barkinvar/sugerCANe/current/hardware/artwork/README.md

# sugarCANe underside artwork

[sugarCANe.svg](sugarCANe.svg) is the original vector master, 52 × 74 mm, viewed from the underside. White artwork spans approximately 45.6 × 43.2 mm between the connector fields. Three jointed pixel stalks and stair-step leaves stand on a floating island with a raised, convex top and a stepped, tapering underside. The large **sugarCANe** name uses bold pixel lettering. There are no corner decorations, borders or additional text on the underside.

The lettering is drawn specifically for this wordmark in [build_brand_artwork.py](../../scripts/build_brand_artwork.py), without an external font. Most stems are two cells thick; the lowercase bodies are seven rows high and CAN is nine rows high. The g has a descending tail, and the final lowercase e has a clear crossbar and an open right side. A 0.616 mm letter grid and 0.924 mm inter-letter spacing keep the shapes separated at PCB scale. No Minecraft texture, logo or font is included. SC12 Rev H remains the hardware identity on the component side and in the engineering files.

Rebuild the vector source with `python scripts/build_brand_artwork.py` from `current/`. The illustration uses a 0.8 mm pixel grid; the original letter patterns are defined directly in the generator. Apply it with `kicad-python scripts/apply_bottom_artwork.py`. The importer mirrors the artwork once into native PCB coordinates and uses KiCad's filled cut-contour polygons to preserve letter and stalk holes without a font dependency or raster image. `finish_markings.py` also reapplies this artwork after refreshing the top labels.

All artwork lives on B.Silkscreen, in the **sugarCANe artwork** group. It changes no copper, solder mask, holes, pads, components or top markings. Refresh the bottom silkscreen Gerber, bottom drawing, interactive BOM and render after editing; check the actual exported mask clearances and final image. Small via holes remain visible through the artwork in the CAD render. Electrical qualification status is unchanged.
