barkinvar/sugerCANe/reports/electrical/capacitor_derating.pdf

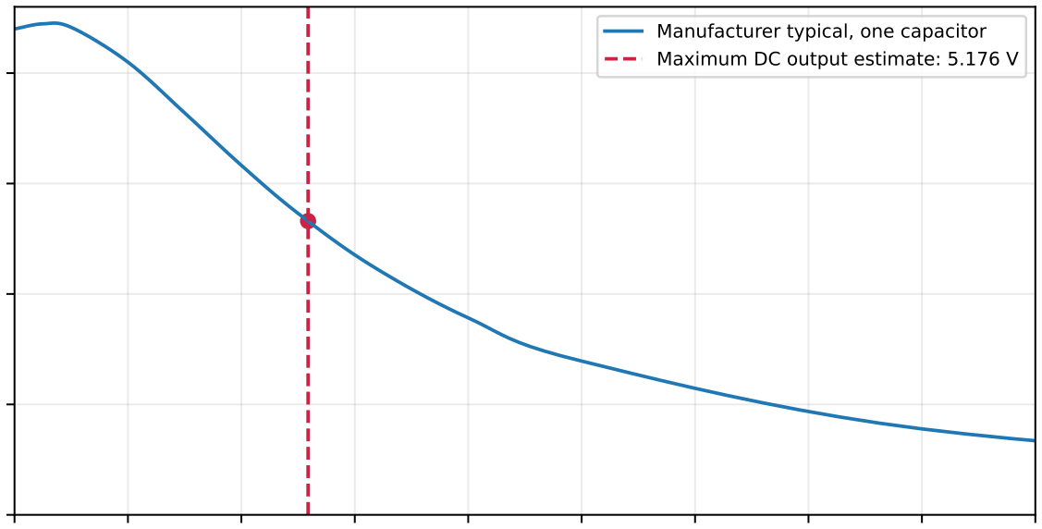
[picture p11: figure]
Manufacturer typical, one capacitor Maximum DC output estimate: 5.176 V

0 | 2 | 4 | 6 | 8 | 10 | 12 | 14 | 16 | 18

### DC bias (V)

0

5

10

15

20

### Typical capacitance (µF)

## 22 µF / 25 V X5R capacitance under DC bias
