barkinvar/sugerCANe/reports/spice/input_filtering.pdf

0 | 2 | 4 | 6 | 8 | 10 | 12
| | | Time (ms)

0.0

0.2

0.4

0.6

0.8

1.0
Normalized level

### logic 3v3

0 | 2 | 4 | 6 | 8 | 10 | 12
| | | Time (ms)

0.0

0.2

0.4

0.6

0.8

1.0
Normalized level

### logic 5v

0 | 2 | 4 | 6 | 8 | 10 | 12
| | | Time (ms)

0.0

0.2

0.4

0.6

0.8

1.0
Normalized level

### industrial 12v

0 | 2 | 4 | 6 | 8 | 10 | 12
| | | Time (ms)

0.0

0.2

0.4

0.6

0.8

1.0
Normalized level

### industrial 30v at 6v battery

0 | 2 | 4 | 6 | 8 | 10 | 12
| | | Time (ms)

0.0

0.2

0.4

0.6

0.8

1.0
Normalized level

### npn 10v 500uA leak

0 | 2 | 4 | 6 | 8 | 10 | 12
| | | Time (ms)

0.0

0.2

0.4

0.6

0.8

1.0
Normalized level

### pnp 12v 500uA leak

0 | 2 | 4 | 6 | 8 | 10 | 12
| | | Time (ms)

0.0

0.2

0.4

0.6

0.8

1.0
Normalized level

### open drain 3v3 50uA leak

Signal / nominal high
Comparator / 3.3 V
Firmware logical state

### Input filtering and 2 ms firmware debounce — simulated, not bench measured
