barkinvar/sugerCANe/reports/spice/inrush.pdf

input_I2t_A2s: Vin=18 V, source=0.02 Ω, wire=0.1 µH, ESR=0.02 Ω

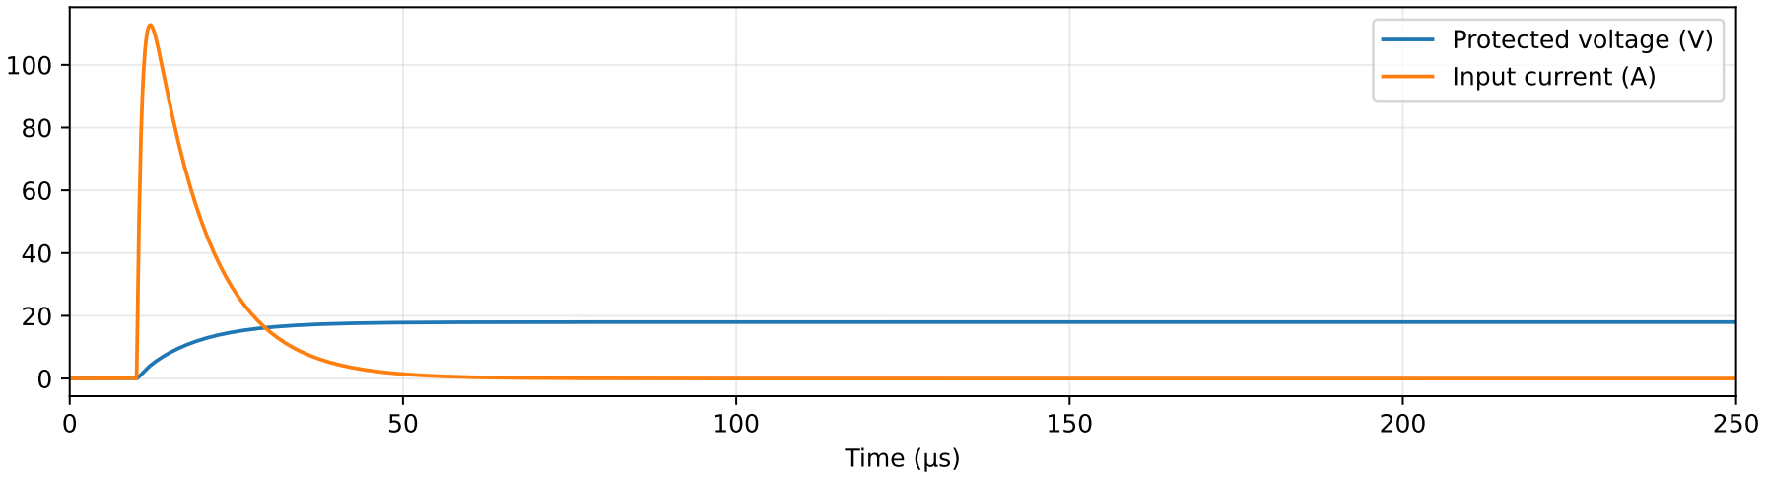
[picture p12: figure]
Time (µs); Protected voltage (V); Input current (A)

peak_protected_V: Vin=18 V, source=0.02 Ω, wire=10 µH, ESR=0.02 Ω

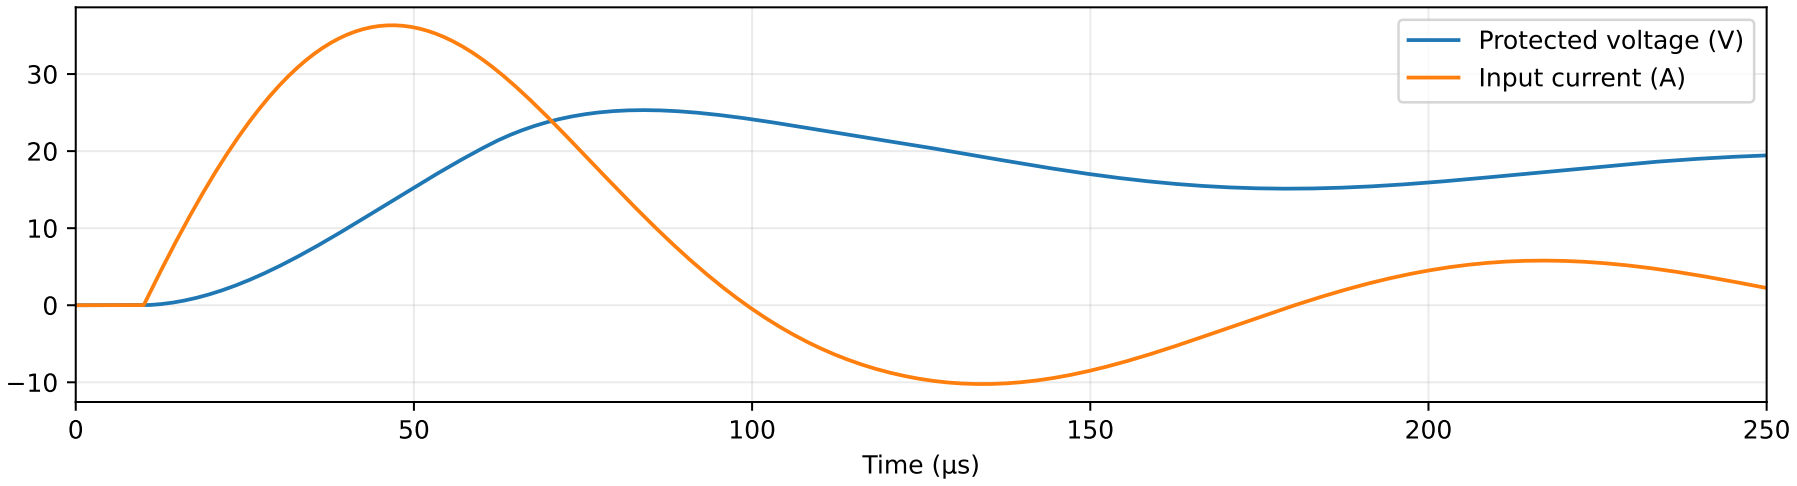
[picture p13: figure]
Time (µs); Protected voltage (V); Input current (A)

peak_input_A: Vin=18 V, source=0.02 Ω, wire=0.1 µH, ESR=0.02 Ω

Input hot-plug sensitivity — passive approximation, not hardware qualification

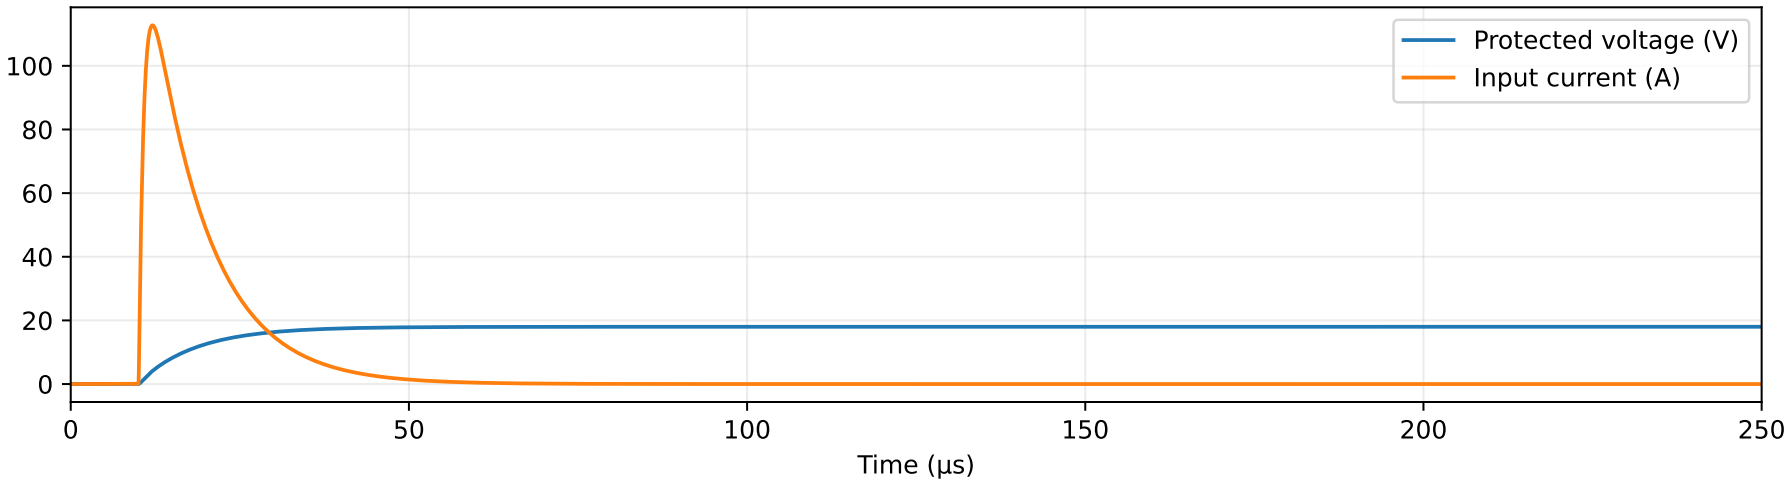
[picture p14: figure]
Time (µs); Protected voltage (V); Input current (A)
