barkinvar/sugerCANe/reports/spice/pulse_response.pdf

## Input pulse width (ms)

logic 3v3 high pulses

logic 3v3 low pulses

logic 5v high pulses

logic 5v low pulses

industrial 12v high pulses

industrial 12v low pulses

industrial 30v at 6v battery high pulses

industrial 30v at 6v battery low pulses

npn 10v 500uA leak high pulses

npn 10v 500uA leak low pulses

pnp 12v 500uA leak high pulses

pnp 12v 500uA leak low pulses

open drain 3v3 50uA leak high pulses

open drain 3v3 50uA leak low pulses

# Debounce 1 ms

## Input pulse width (ms)

# Debounce 2 ms

2 | 4 | 6 | 8 | 10 | 12 | 14

## Input pulse width (ms)

logic 3v3 high pulses

logic 3v3 low pulses

logic 5v high pulses

logic 5v low pulses

industrial 12v high pulses

industrial 12v low pulses

industrial 30v at 6v battery high pulses

industrial 30v at 6v battery low pulses

npn 10v 500uA leak high pulses

npn 10v 500uA leak low pulses

pnp 12v 500uA leak high pulses

pnp 12v 500uA leak low pulses

open drain 3v3 50uA leak high pulses

open drain 3v3 50uA leak low pulses

# Debounce 5 ms

2 | 4 | 6 | 8 | 10 | 12 | 14

## Input pulse width (ms)

# Debounce 10 ms

0.0

0.2

0.4

0.6

0.8

1.0

## Fraction of the 100 tested sample phases capturing one pulse

Simulated pulse capture · 1 kHz sampling · typical analog model, no hardware qualification
