barkinvar/sugerCANe/output/documentation/mounting_template.pdf

# FRC Sensor CAN · mounting template

Print at 100% / actual size. Verify the 50 mm ruler before drilling.

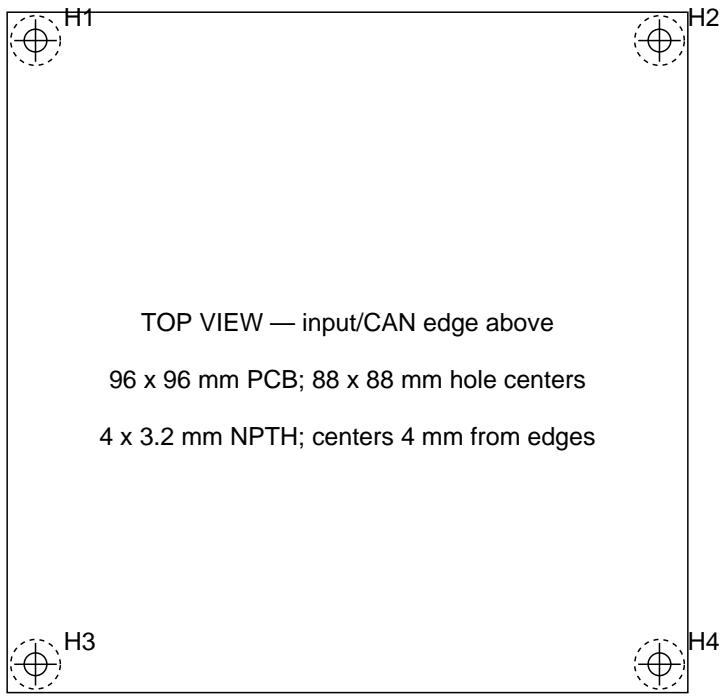
[picture p17: figure]
TOP VIEW — input/CAN edge above; 96 x 96 mm PCB; 88 x 88 mm hole centers

4 x 3.2 mm NPTH; centers 4 mm from edges

This line must measure 50 mm

Use M3 nylon hardware and at least 10 mm standoffs.
Dashed circles show 3.5 mm nominal copper-clearance radius.
Allow room beyond the board for terminal wiring and screwdriver access. Check the actual PCB, hardware and enclosure before making final holes.

Revision A prototype. Nominal geometry; not a measured or certified part.
