barkinvar/sugerCANe/sources/models/lmr51420x_ti/LMR51420X_PSPICE_TRANS/LMR51420X_PSPICETransientModel_FeaturesandLimitations.pdf

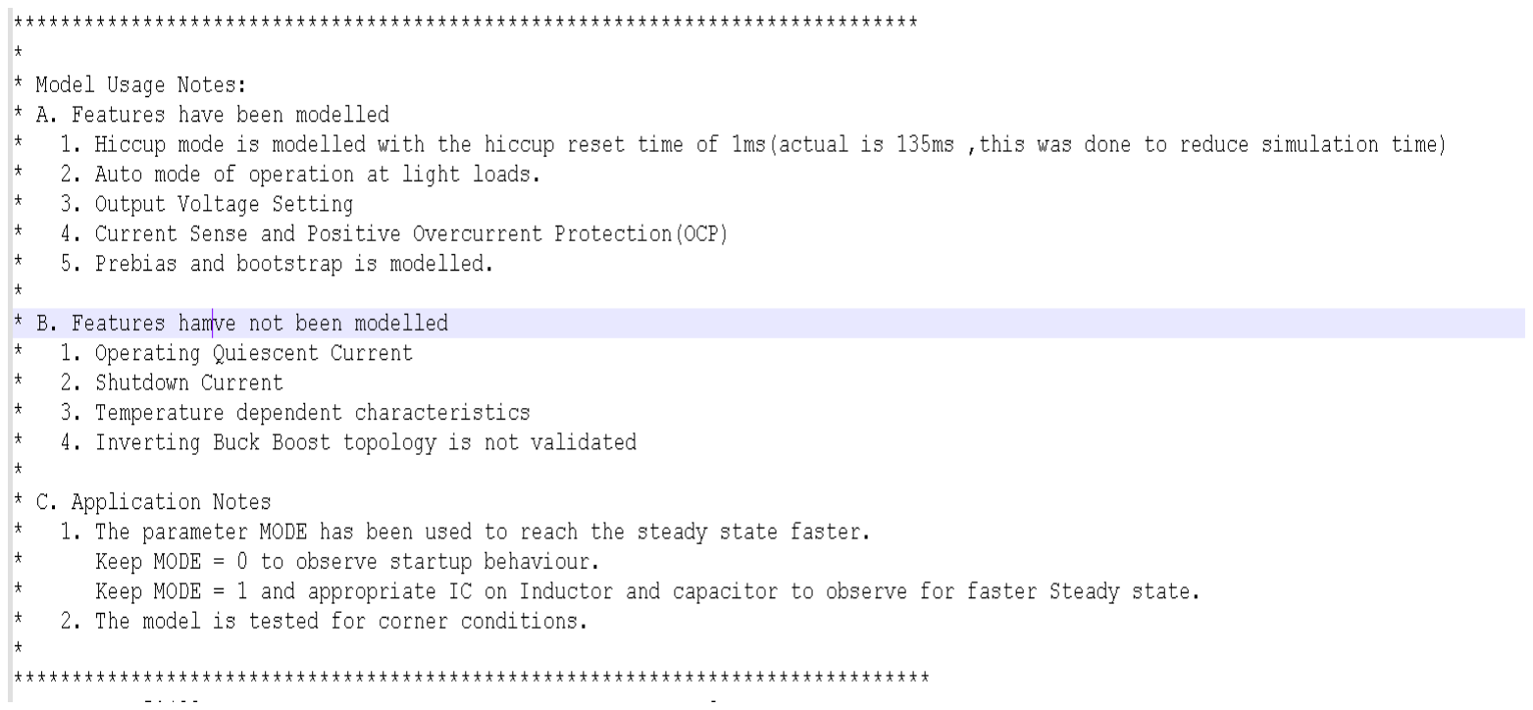
[picture p20: figure]
