barkinvar/sugerCANe/archive/README.md

# Historical packages

Use **[current Rev H](../current/README.md)** for new work. These ZIPs preserve older releases exactly as published; their internal instructions and test records apply only to that revision.

| Revision | Download |
|---|---|
| A | [Source/prototype](release/FRC_Sensor_CAN_RevA_Prototype.zip) · [fabrication](release/FRC_Sensor_CAN_RevA_Fabrication.zip) |
| B, early angled terminals | [Historical prototype](rev_b/history/before_horizontal_connectors/release/FRC_Sensor_CAN_RevB_Prototype.zip) |
| B, horizontal terminals | [Prototype](rev_b/release/FRC_Sensor_CAN_RevB_Prototype.zip) |
| B2 | [Prototype](rev_b2/release/FRC_Sensor_CAN_RevB2_Prototype.zip) · [factory packet](rev_b2/order/RevB2_Factory_Upload.zip) |
| C Lite | [Prototype](rev_c/release/FRC_Sensor_CAN_RevC_Lite_Prototype.zip) · [factory packet](rev_c/order/RevC_Lite_Factory_Upload.zip) |
| D SC12 | [Prototype](rev_d/release/FRC_Sensor_CAN_RevD_SC12_Prototype.zip) · [factory packet](rev_d/order/RevD_SC12_Factory_Upload.zip) |
| D2 SC12 | [Prototype](rev_d2/release/FRC_Sensor_CAN_RevD2_SC12_Prototype.zip) · [factory packet](rev_d2/order/RevD2_SC12_Factory_Upload.zip) |
| E SC12 | [Prototype](rev_e/release/FRC_Sensor_CAN_RevE_SC12_Prototype.zip) · [factory packet](rev_e/order/RevE_SC12_Factory_Upload.zip) |
| F SC12 | [Prototype](rev_f/release/FRC_Sensor_CAN_RevF_SC12_Prototype.zip) · [factory packet](rev_f/order/RevF_SC12_Factory_Upload.zip) |
| G SC12 | [Prototype](rev_g/release/FRC_Sensor_CAN_RevG_SC12_Prototype.zip) · [factory packet](rev_g/order/RevG_SC12_Factory_Upload.zip) |

[Why the revisions differ](../REVISIONS.md). All are unbuilt engineering prototypes. Do not combine firmware, connectors or wiring instructions across packages.

Original SHA-256 files remain alongside their archives. [manifest.json](manifest.json) records original paths, byte sizes and SHA-256 hashes for every preserved release/order archive and checksum. The complete expanded source tree before consolidation is available at [commit 9ccb4b7](https://github.com/barkinvar/candi-clone/tree/9ccb4b7). No Git history was rewritten.
