barkinvar/sugerCANe/rev_d/output/mechanical/mechanical_drawing.pdf

# SC12 - nominal mechanical drawing

Rev D / component-side view / 1:1 at 100% print / dimensions in mm

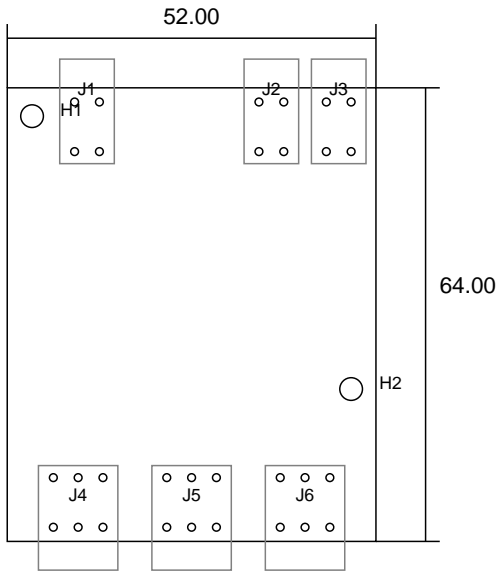
[picture p26: figure]

PCB: 52 x 64 x 1.6 mm. Four layers, nominal 1 oz copper.
Mounts: H1 (3.5, 4.0), H2 (48.5, 42.5); diameter 3.2 NPTH.
Keep hardware contact diameter <=6.4 mm; use insulating supports as needed. Conservative terminal envelope: 52 x 72.1 mm, before wires/button clearance. Terminal height: 8.5 above mounting face; pin tips 3.5 below that face.
On a 1.6 mm PCB, pin tips project nominally 1.9 mm beyond the bottom. Housing geometry is manufacturer nominal CAD. Physical fit untested. Origin: top-left PCB corner. X right; Y down in this drawing.

# Service contacts and solder selectors

Component-side view / enlarged, not 1:1 / no stencil paste on these contacts

### J8: custom TC2050-IDC-NL mapping; use a mapped adapter

1 | 2 | 3 | 4 | 5
10 | 9 | 8 | 7 | 6

1 NRST
2 UART RX
3 UART TX
4 SWCLK
5 SWDIO
6 +3V3 VTref sense only
7 GND
8 GND
9 BOOT0
10 GND

Power through J1; adapter/probe power disconnected. Lower row 1-5; upper row 10-6.

### JP101 POWER

1 | 2 | 3

### JP103 BIAS

1 | 2 | 3
1-2 = 5V; 2-3 = 12V; open = off | 1-2 = NPN; 2-3 = PNP; open = push-pull

### JP201 POWER

1 | 2 | 3

### JP203 BIAS

1 | 2 | 3
1-2 = 5V; 2-3 = 12V; open = off | 1-2 = NPN; 2-3 = PNP; open = push-pull

### JP301 POWER

1 | 2 | 3

### JP303 BIAS

1 | 2 | 3
1-2 = 5V; 2-3 = 12V; open = off | 1-2 = NPN; 2-3 = PNP; open = push-pull

ONE BRIDGE PER SELECTOR. Both power bridges short 12V to 5V.

JP2: bridge for 120 ohm CAN end termination; open at intermediate nodes.

All selectors open by default. Change settings only with input power disconnected.
