barkinvar/sugerCANe/.playwright-cli/page-2026-09-07T21-32-00-759Z.png

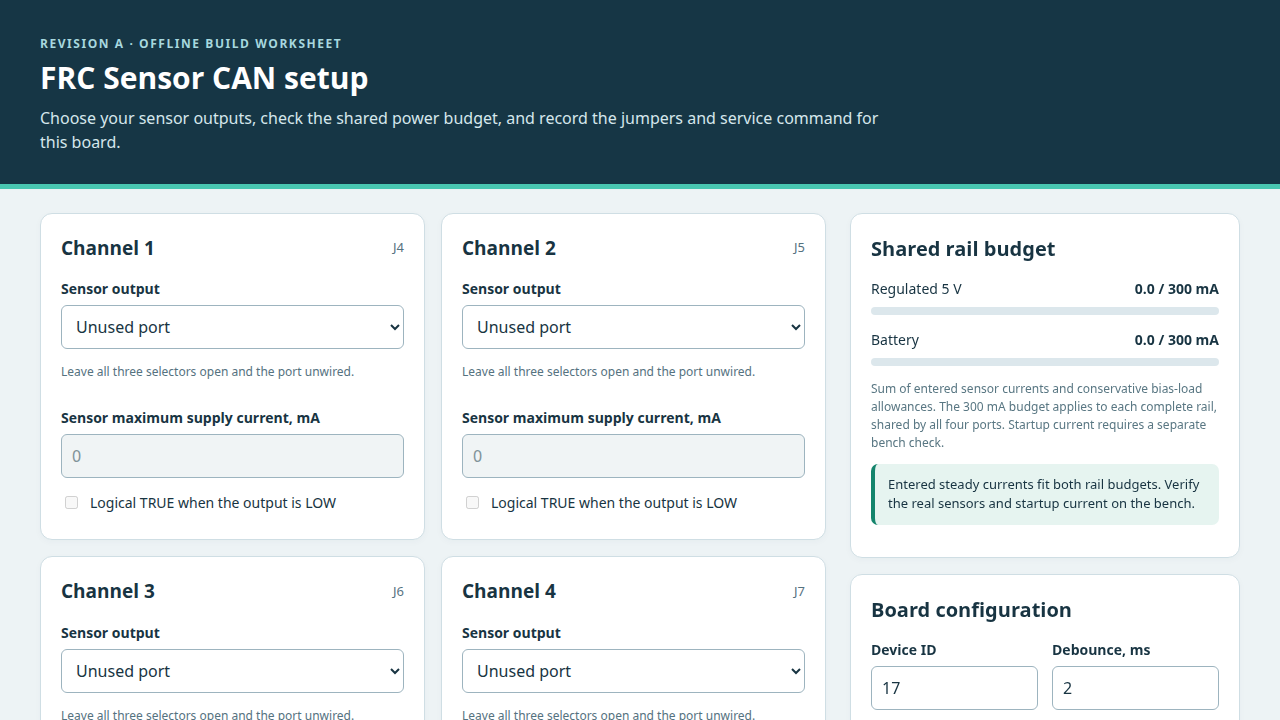
.playwright-cli/page-2026-09-07T21-32-00-759Z.png
