barkinvar/sugerCANe/.playwright-cli/page-2026-09-07T21-32-58-149Z.png

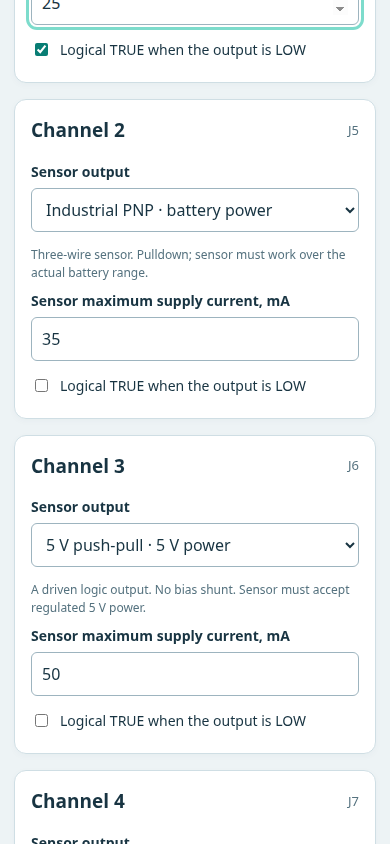
.playwright-cli/page-2026-09-07T21-32-58-149Z.png
