barkinvar/sugerCANe/current/output/review/board_bottom.png

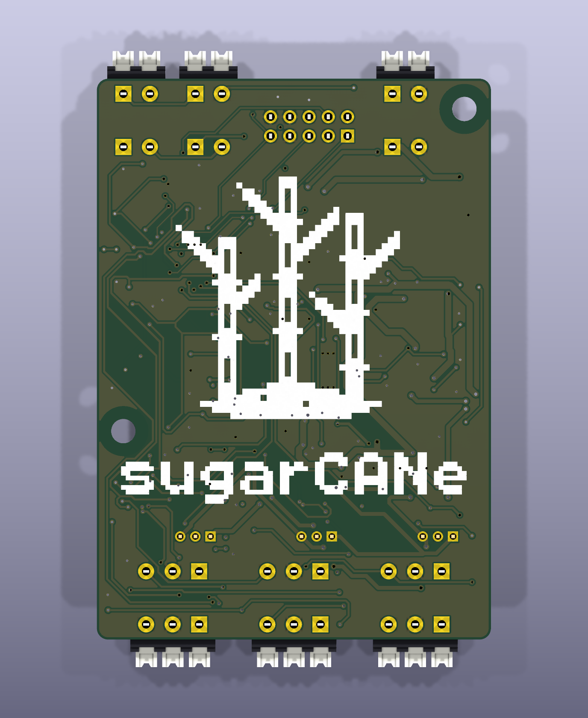
current/output/review/board_bottom.png
