barkinvar/sugerCANe/current/output/review/board_connectors.png

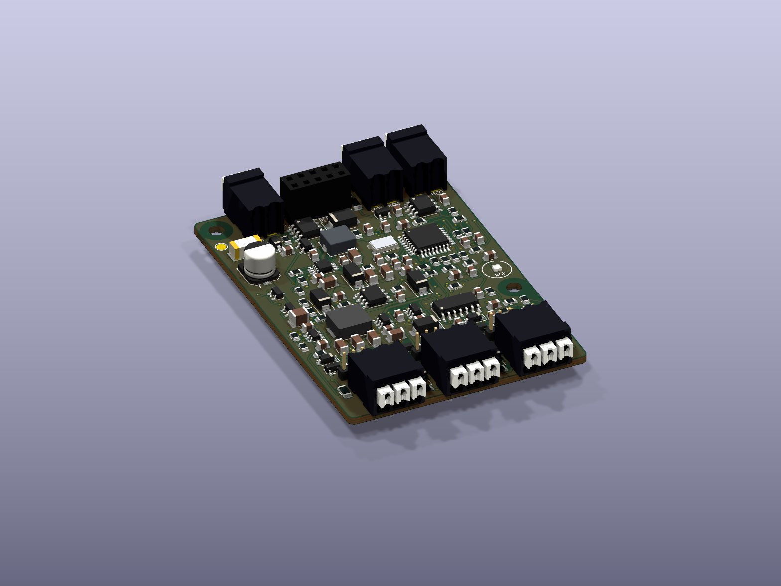
current/output/review/board_connectors.png
