barkinvar/sugerCANe/current/output/review/board_top.png

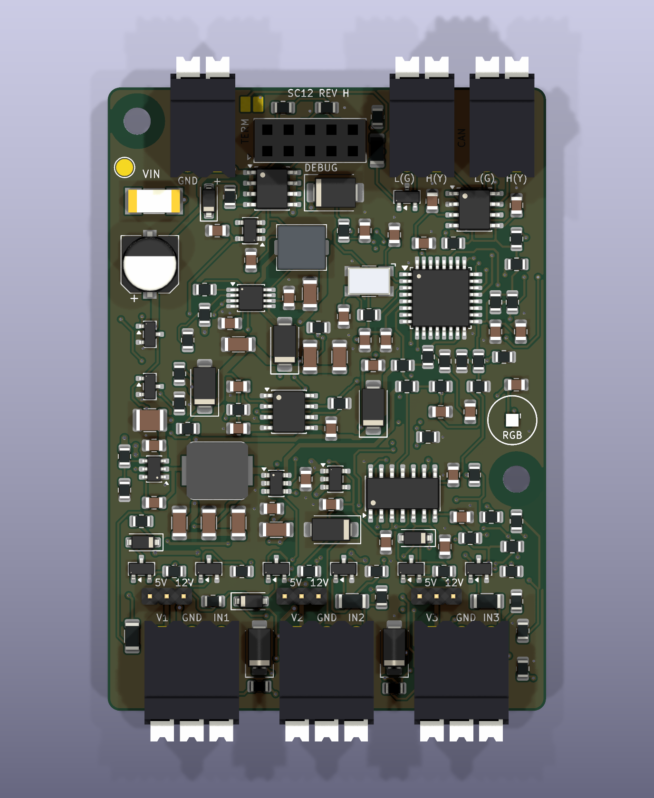
current/output/review/board_top.png
