barkinvar/sugerCANe/current/output/review/gerber_bottom_copper.png

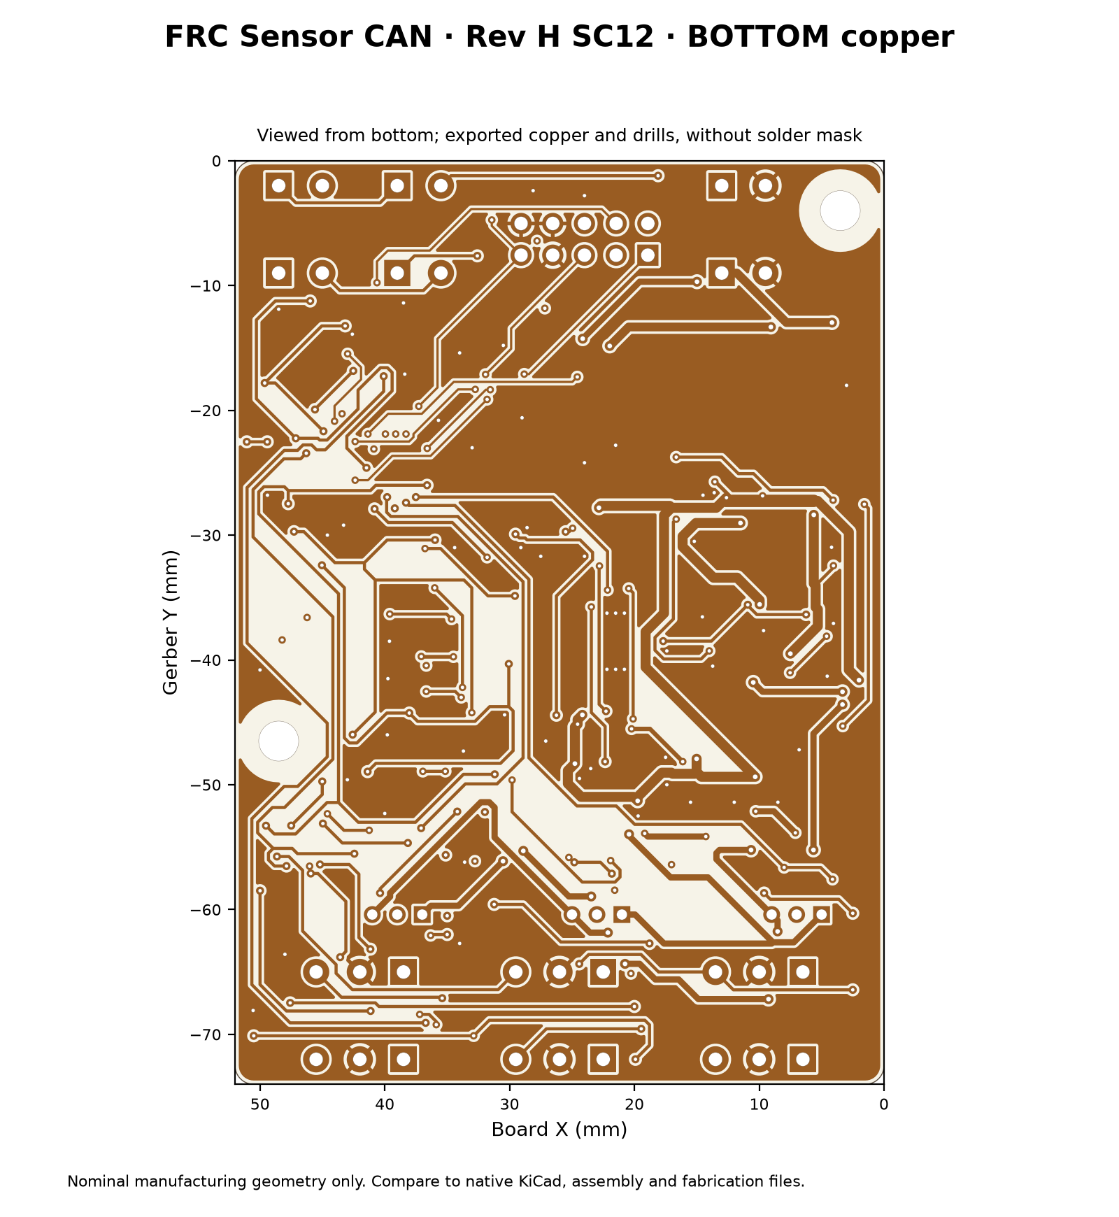
current/output/review/gerber_bottom_copper.png
