barkinvar/sugerCANe/current/output/review/gerber_inner_1_copper.png

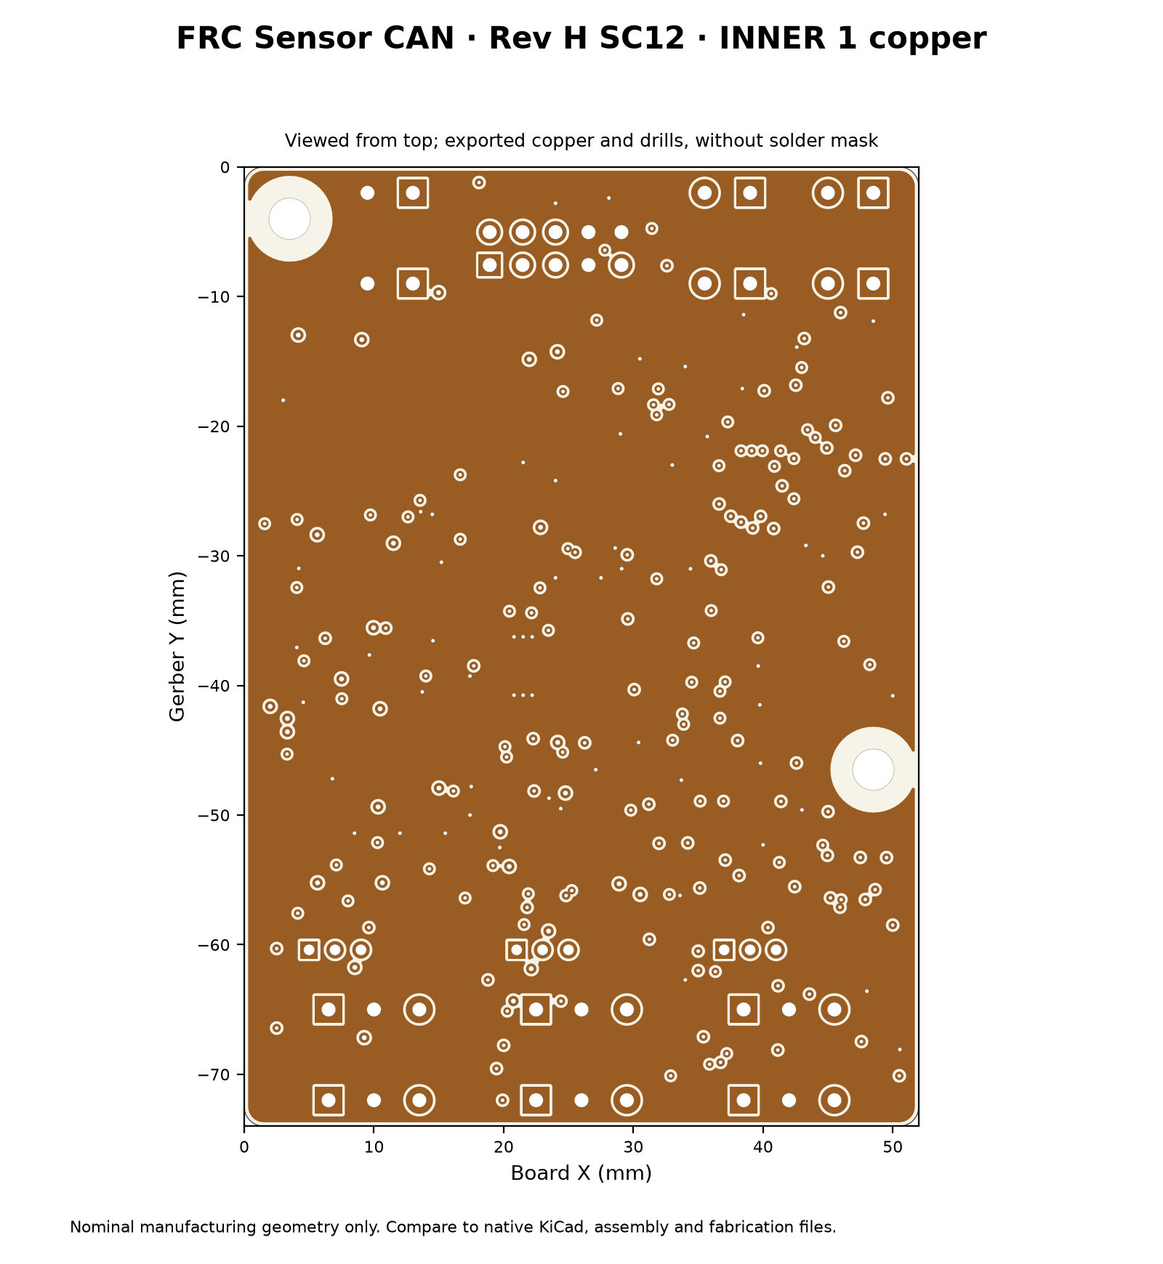
current/output/review/gerber_inner_1_copper.png
