barkinvar/sugerCANe/current/output/review/gerber_inner_2_copper.png

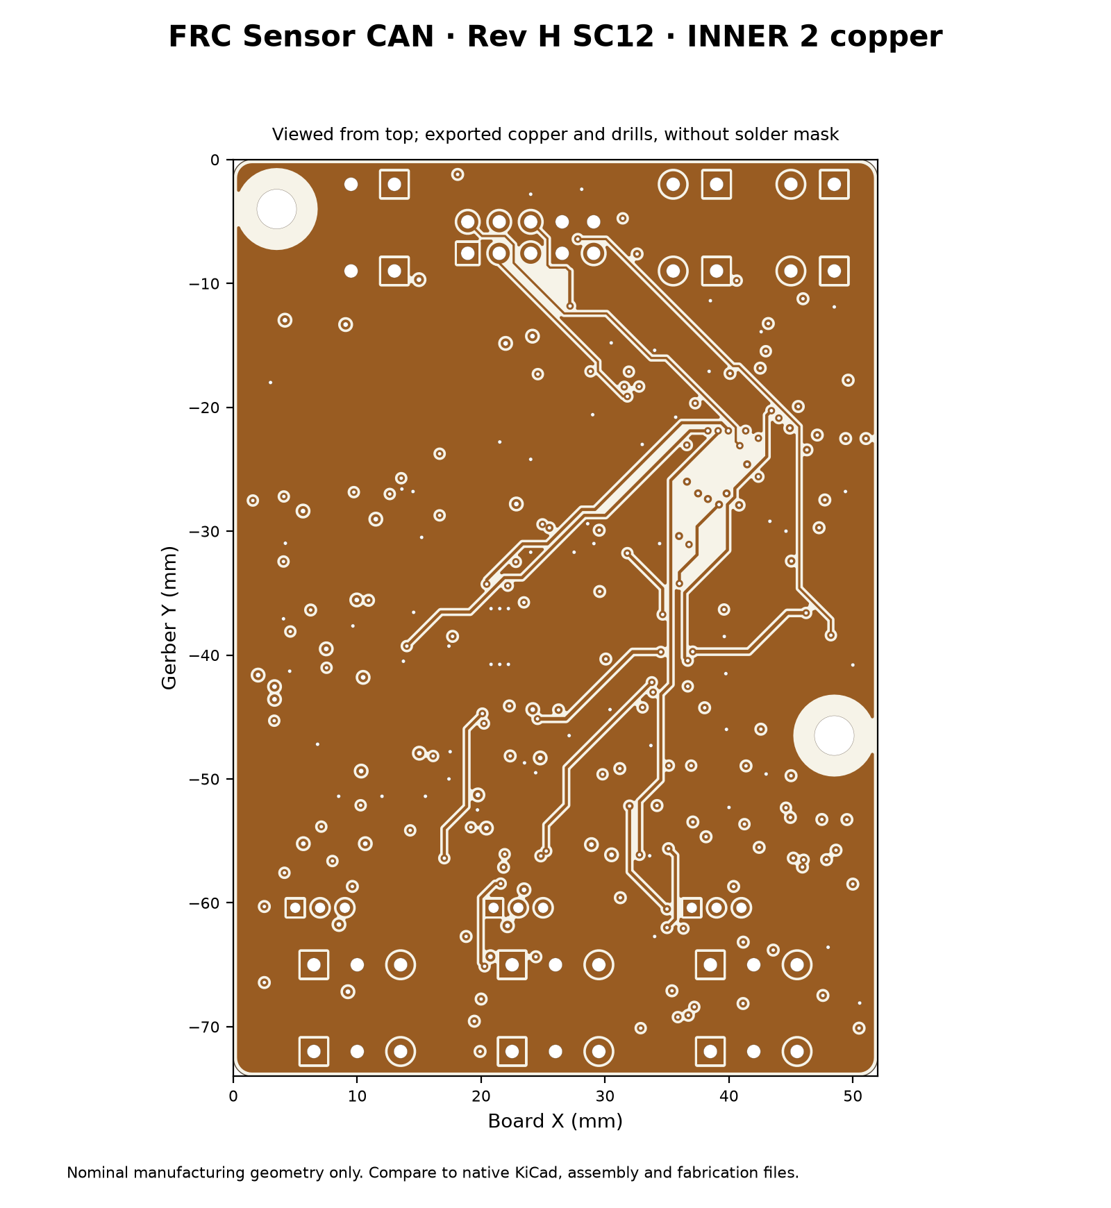
current/output/review/gerber_inner_2_copper.png
