barkinvar/sugerCANe/current/output/review/gerber_top_copper.png

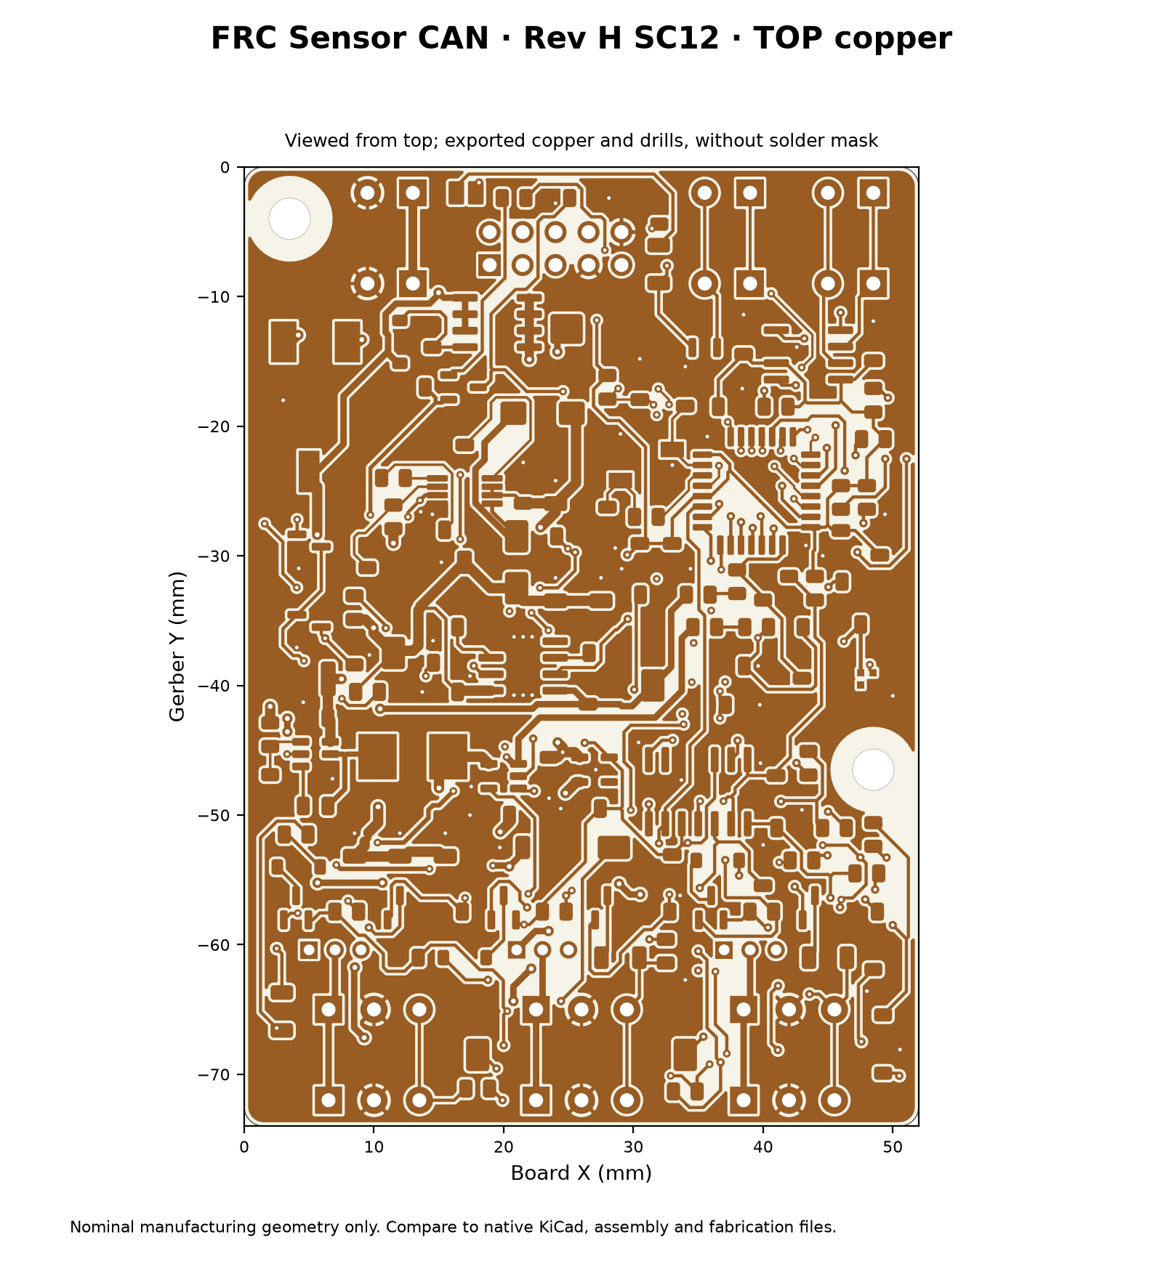
current/output/review/gerber_top_copper.png
