barkinvar/sugerCANe/current/output/review/ground_pours.png

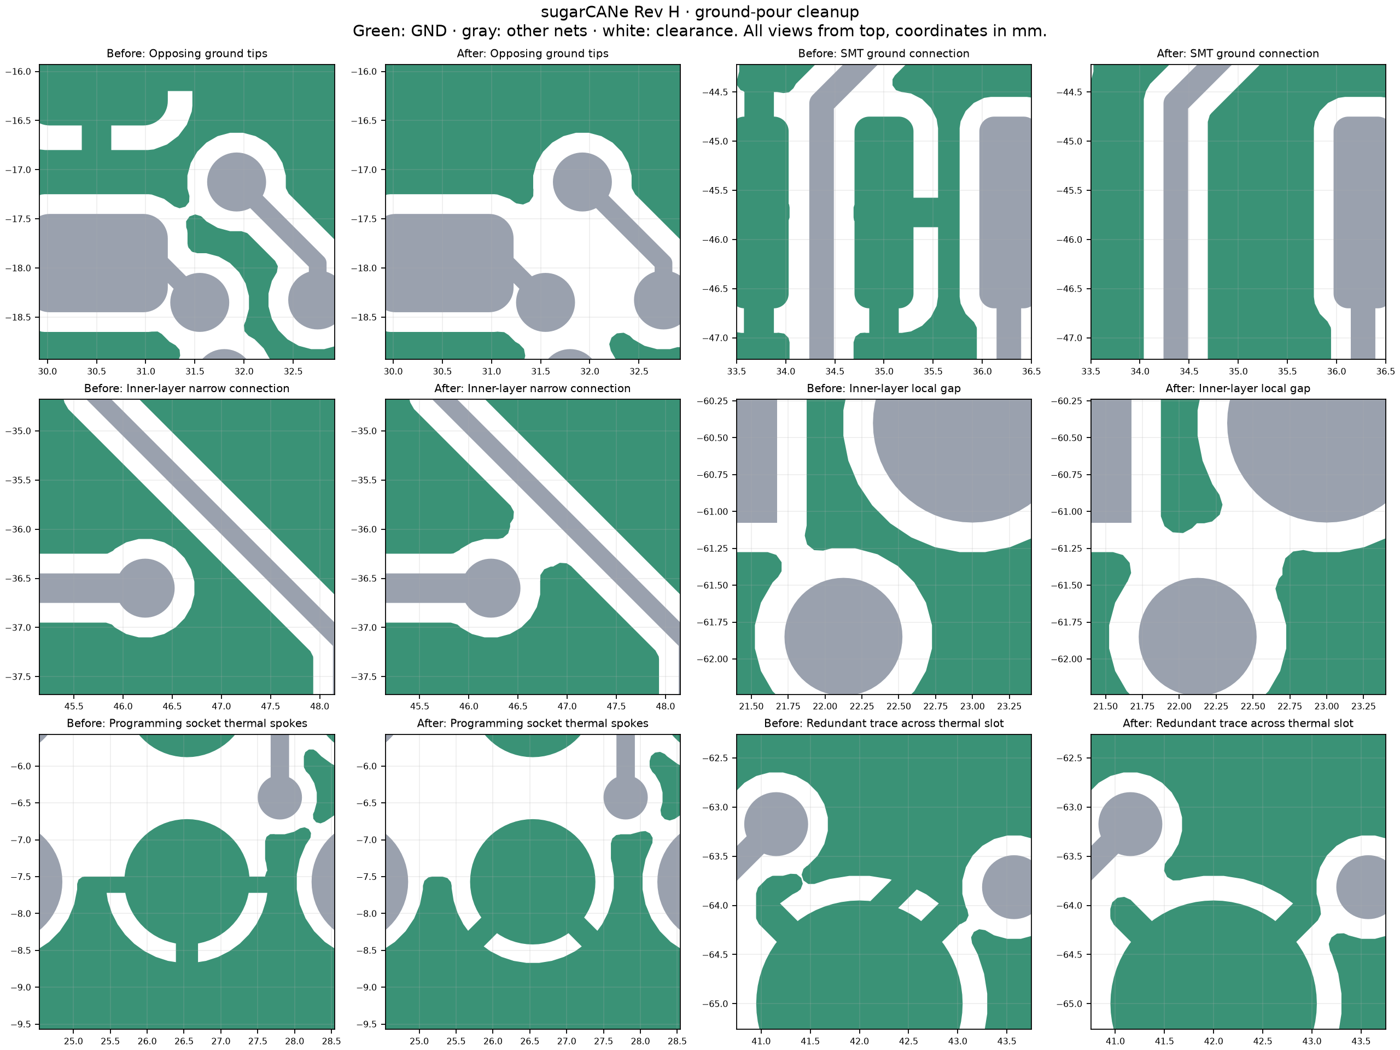
current/output/review/ground_pours.png
