barkinvar/sugerCANe/current/output/review/routing_contacts.png

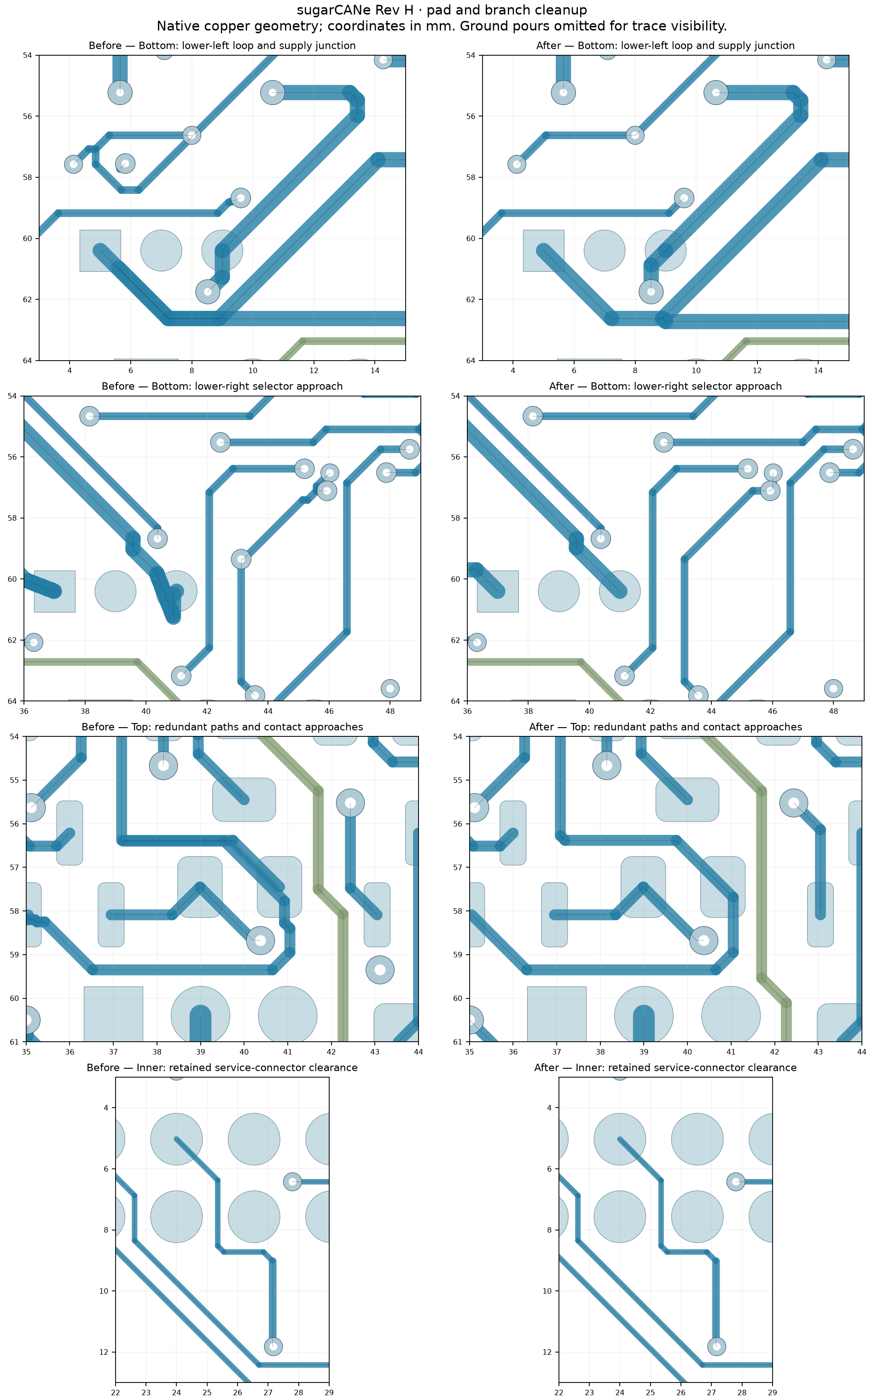
current/output/review/routing_contacts.png
