barkinvar/sugerCANe/current/output/review/routing_junctions.png

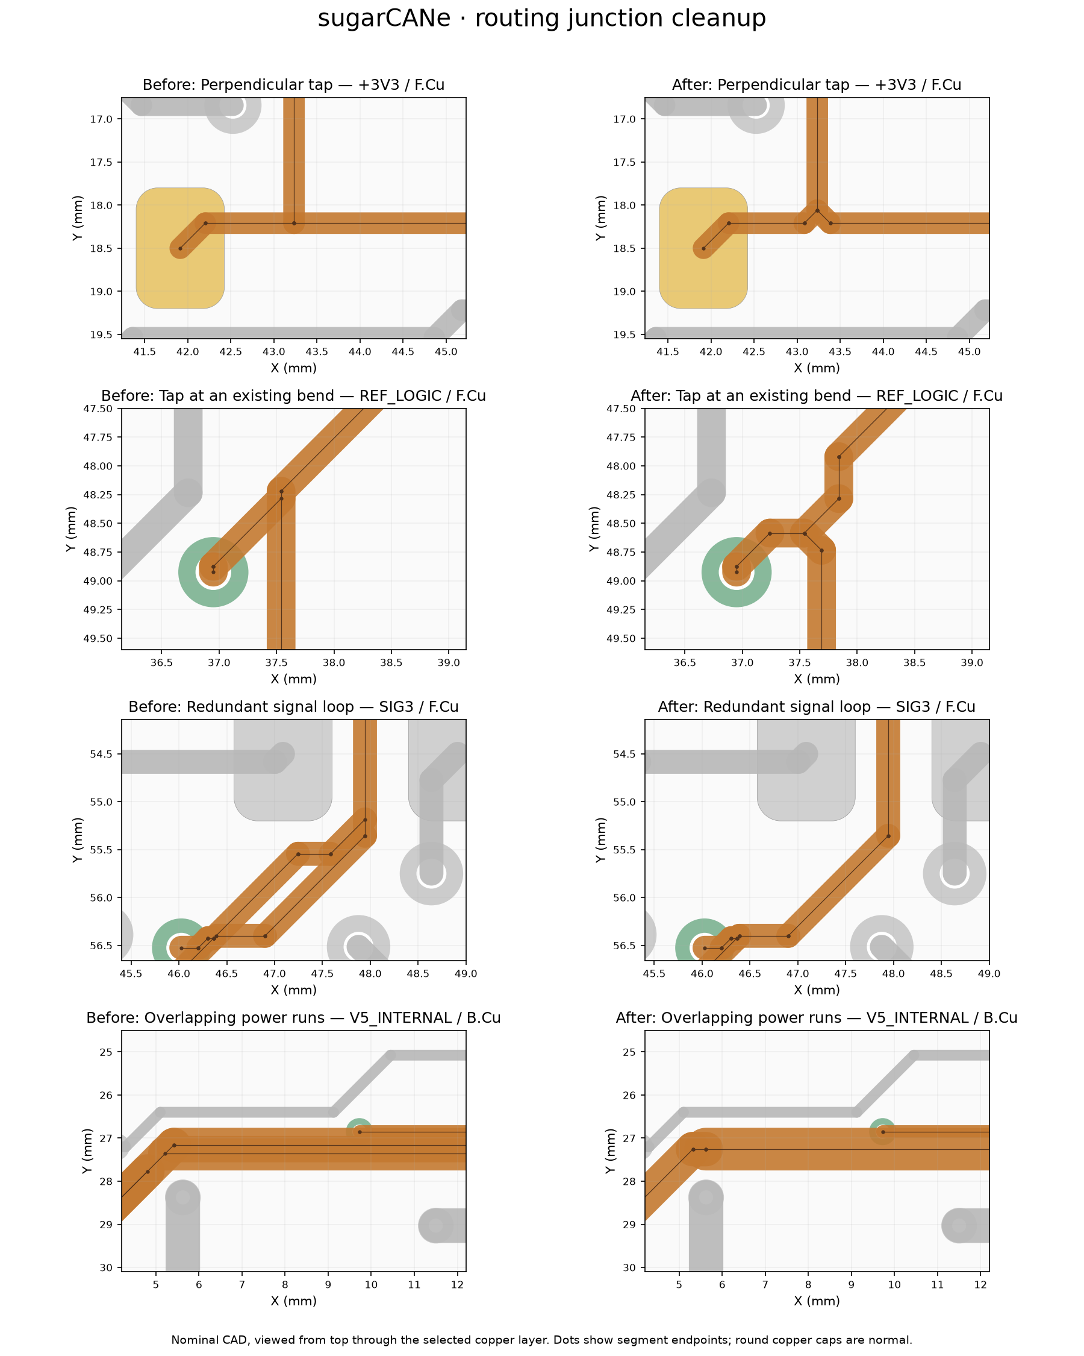
current/output/review/routing_junctions.png
