barkinvar/sugerCANe/current/output/review/routing_widths.png

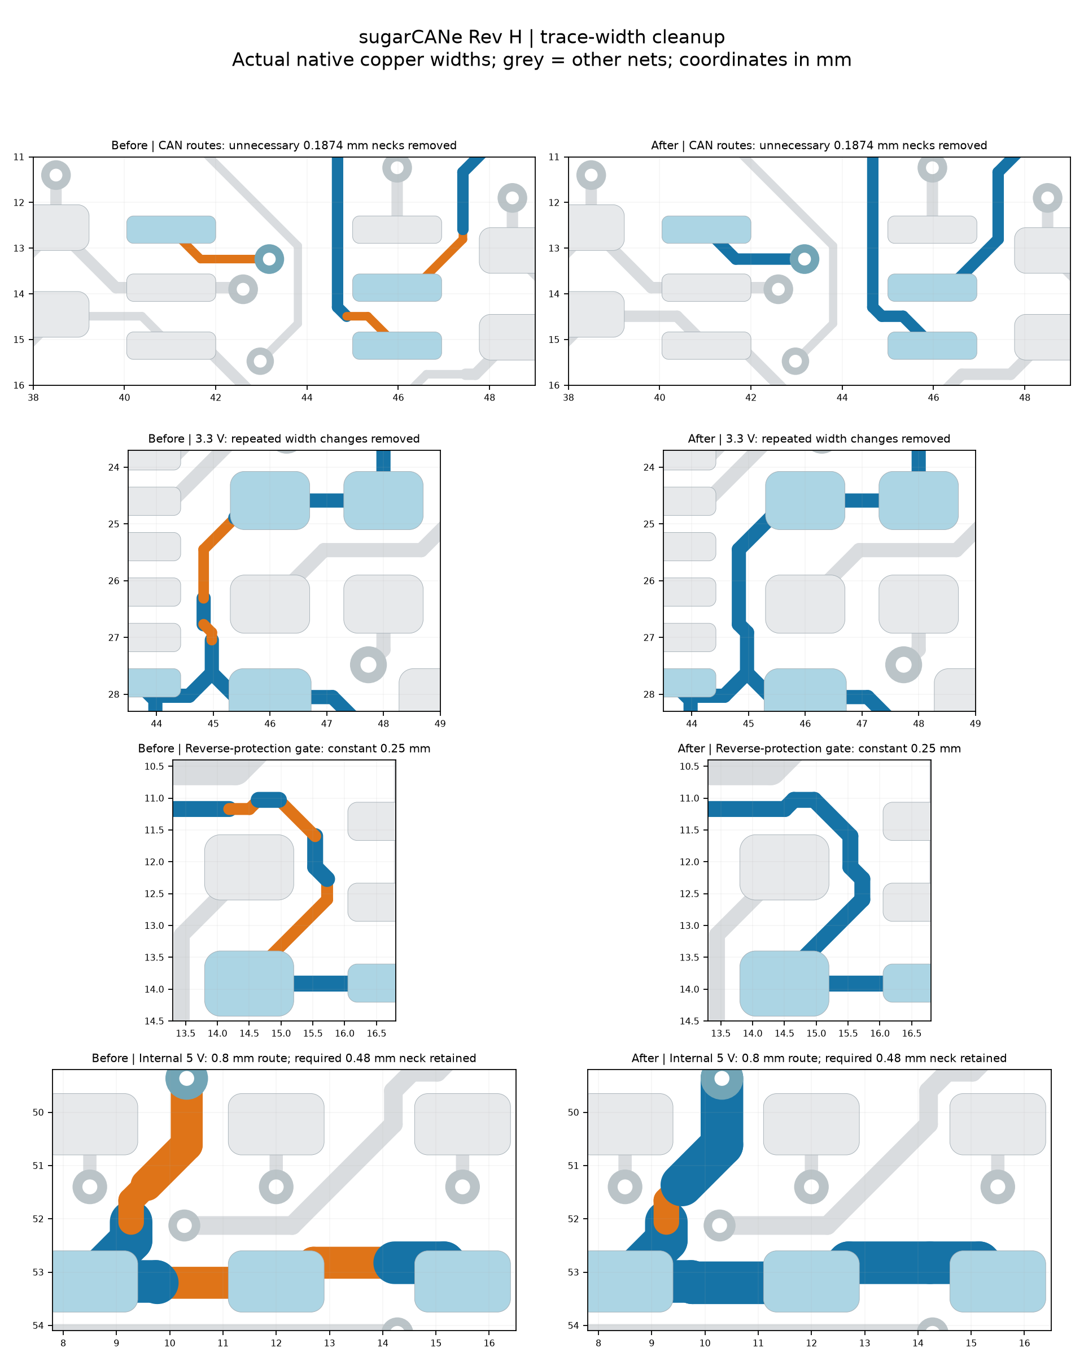
current/output/review/routing_widths.png
