barkinvar/sugerCANe/current/output/review/service_gui.png

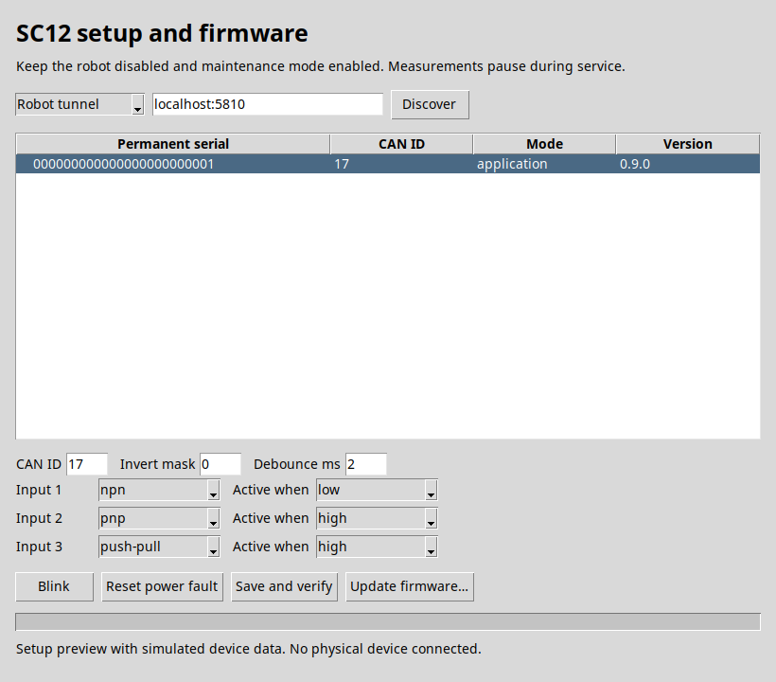
current/output/review/service_gui.png
