barkinvar/sugerCANe/current/reports/electrical/boost_spice.png

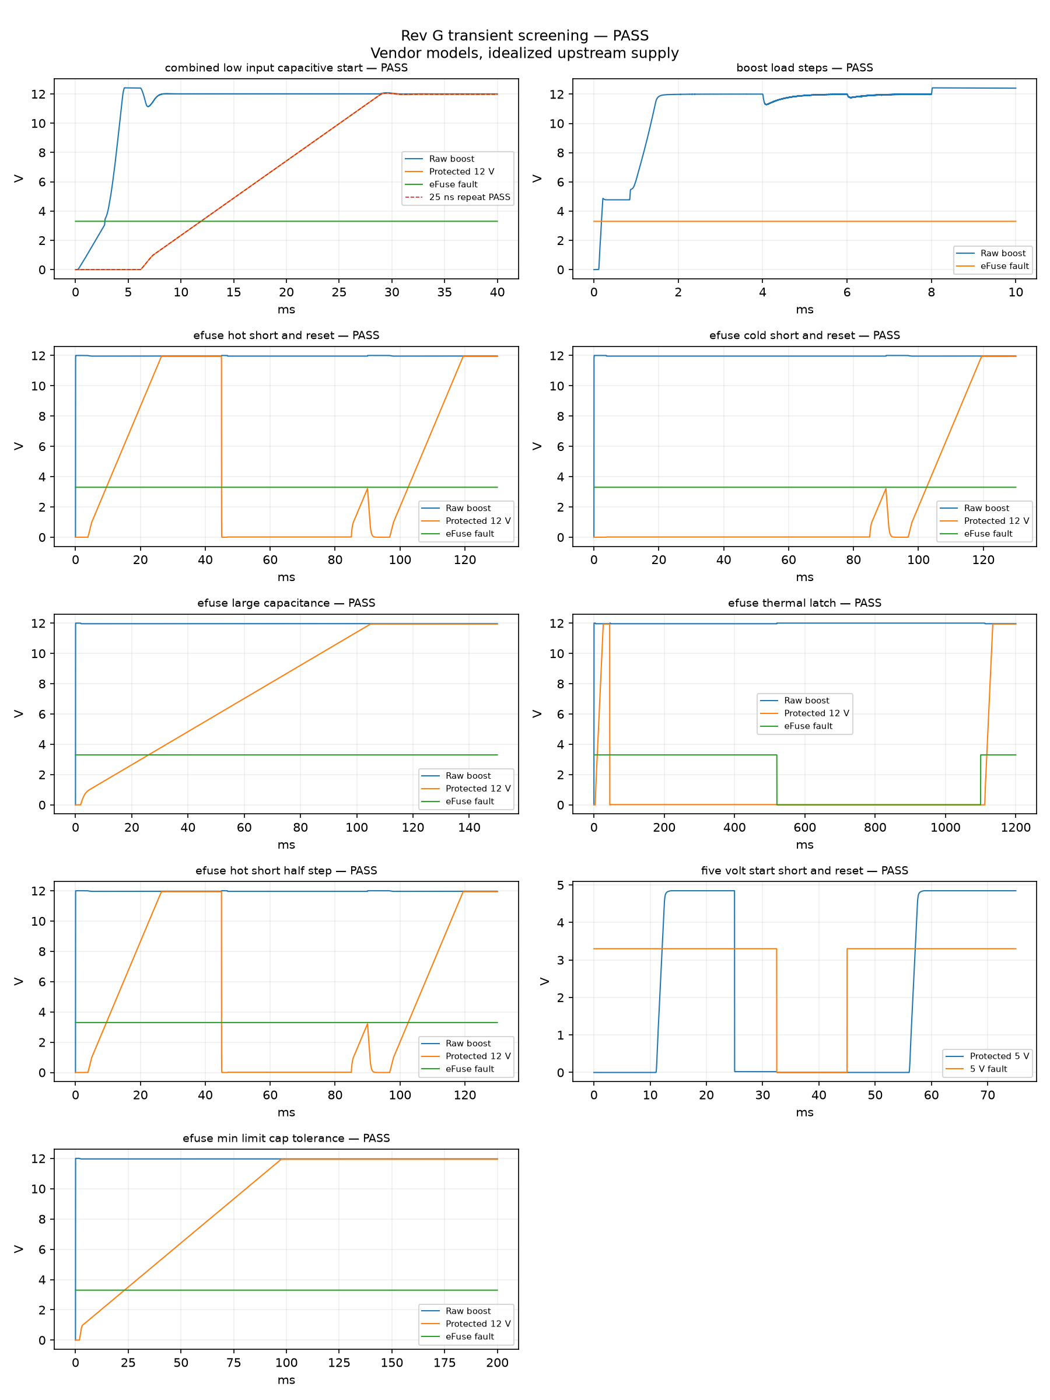
current/reports/electrical/boost_spice.png
