barkinvar/sugerCANe/current/reports/electrical/boost_spice_partial.png

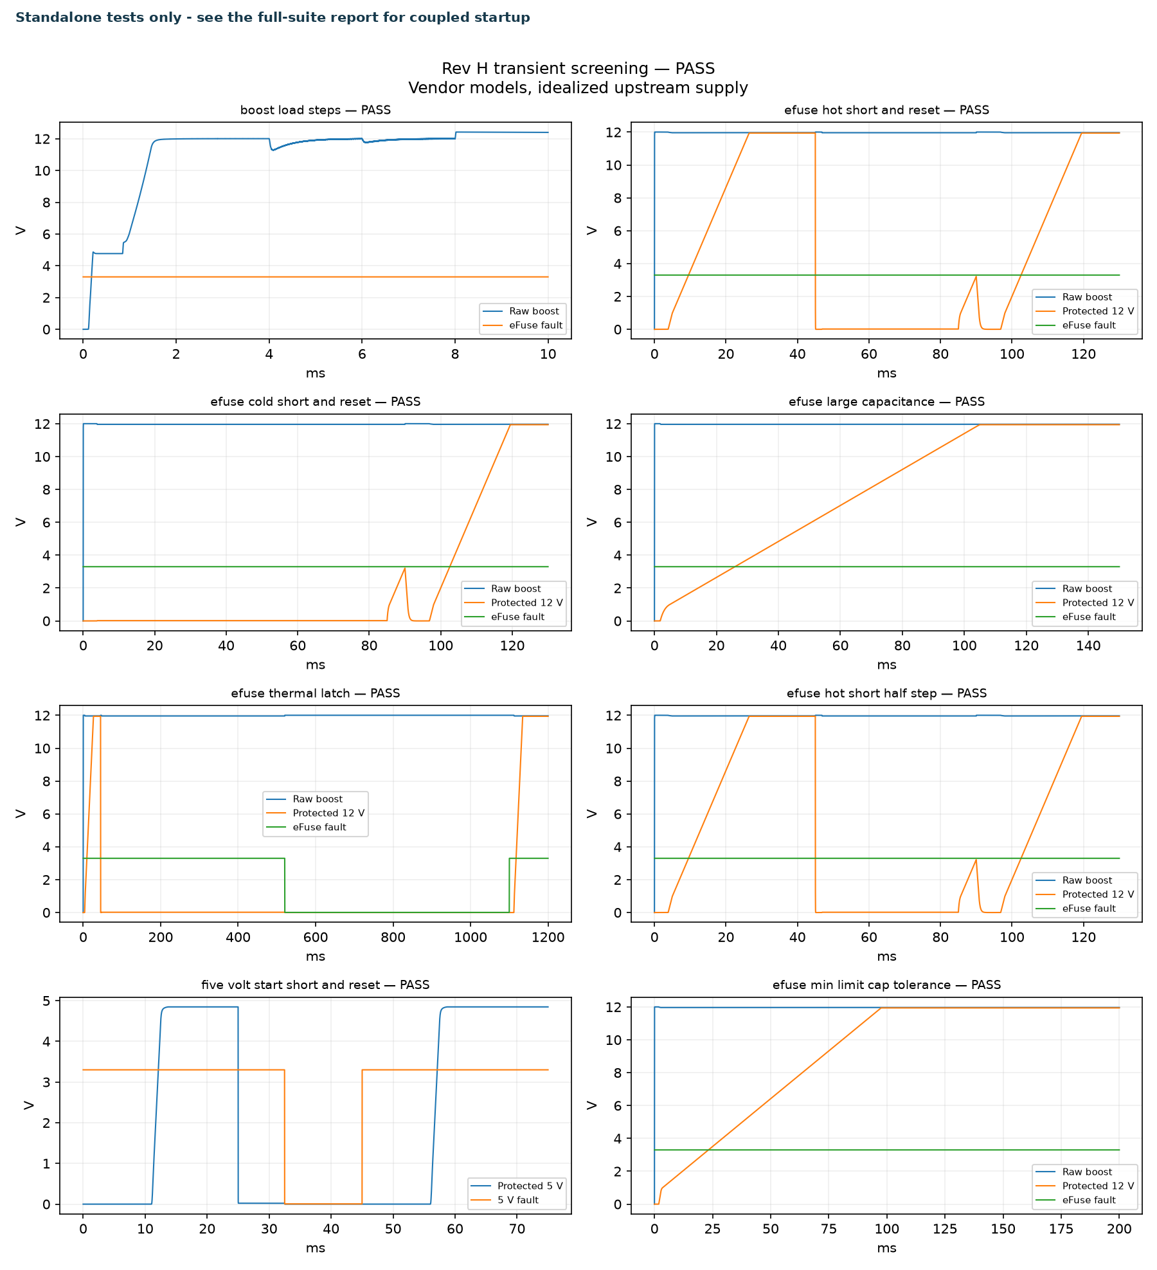
current/reports/electrical/boost_spice_partial.png
