barkinvar/sugerCANe/current/reports/electrical/converter_loop.png

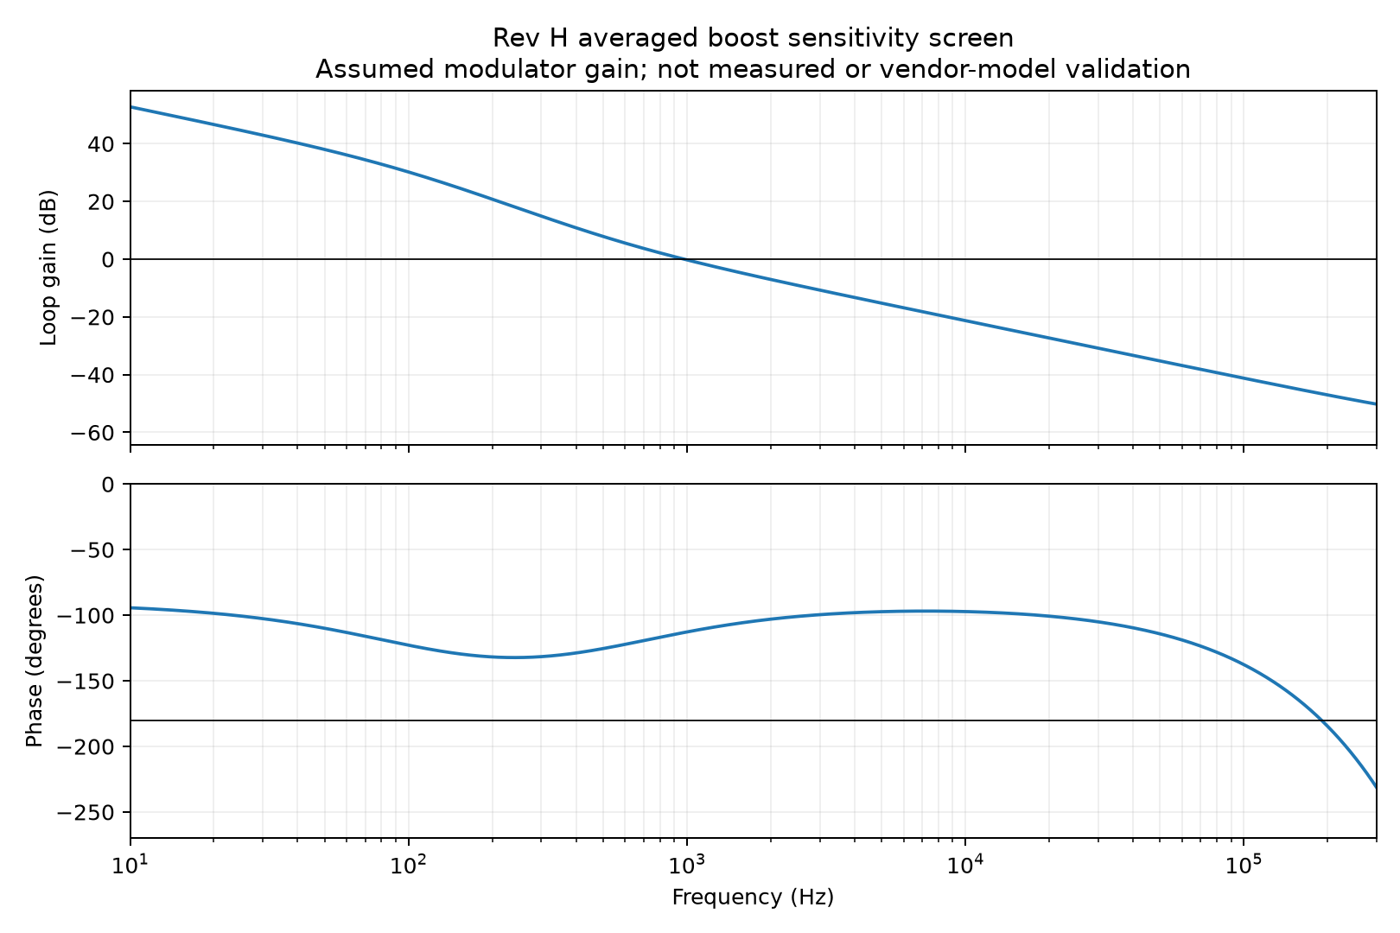
current/reports/electrical/converter_loop.png
