barkinvar/sugerCANe/current/reports/electrical/input_spice.png

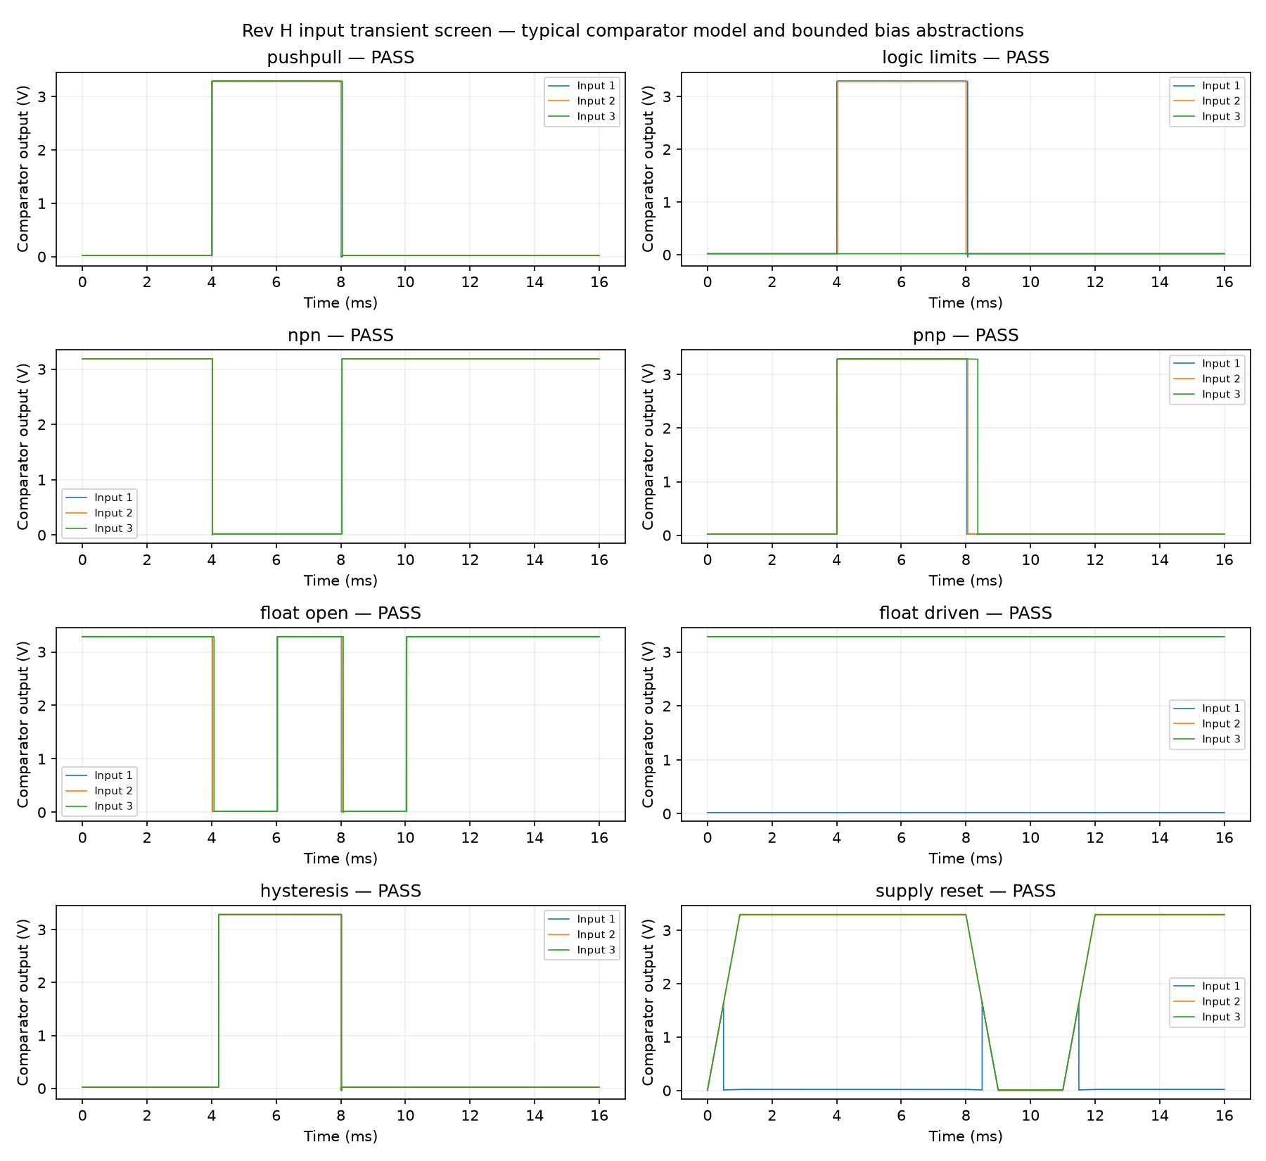
current/reports/electrical/input_spice.png
