barkinvar/sugerCANe/output/documentation/connector_map.png

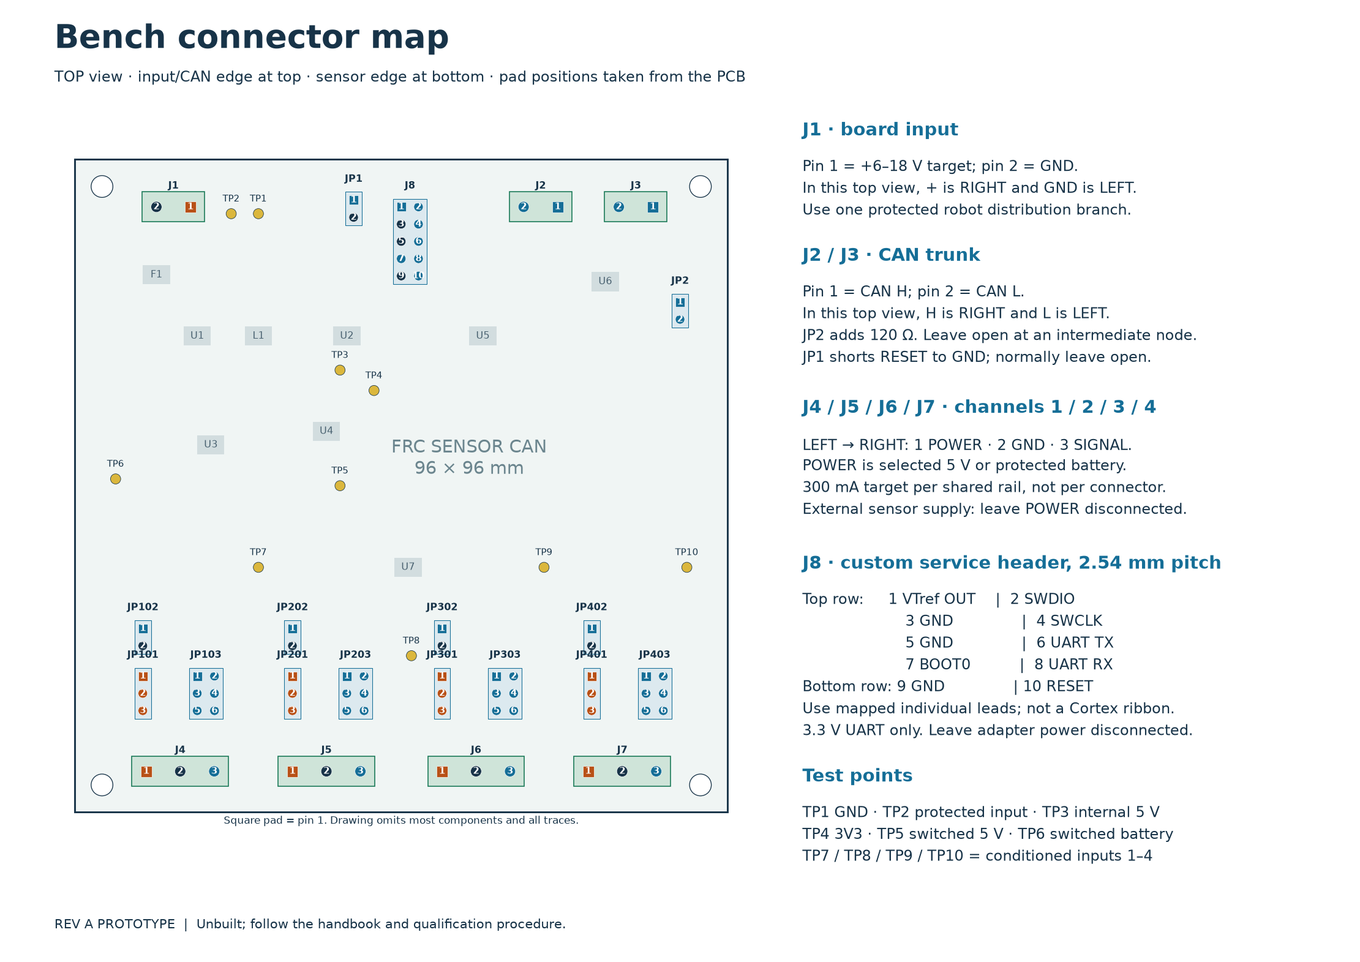
output/documentation/connector_map.png
