barkinvar/sugerCANe/output/documentation/jumper_examples.png

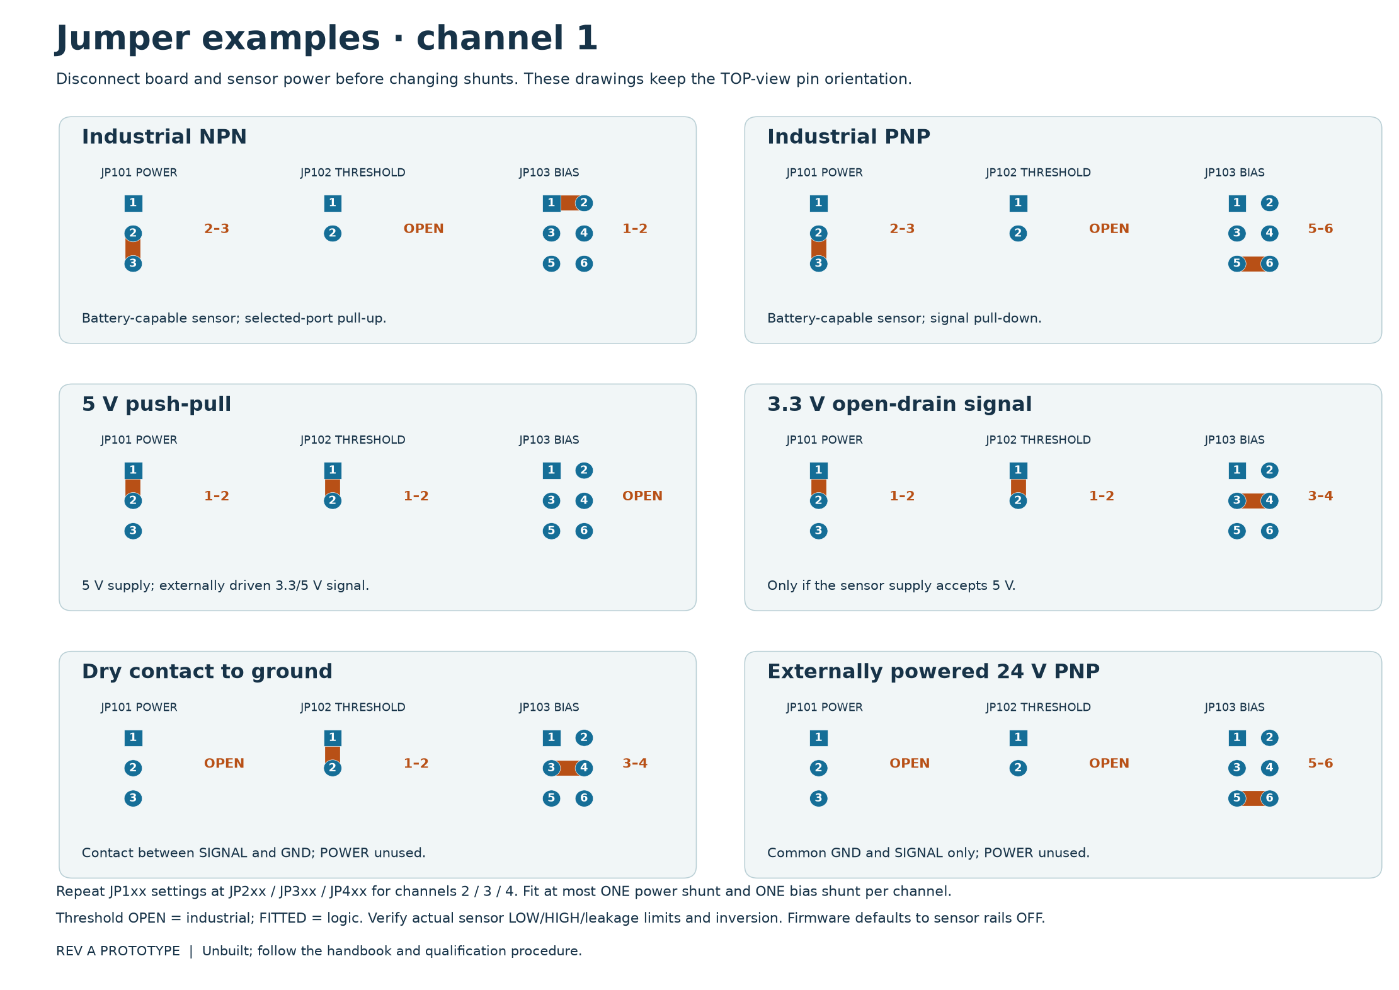
output/documentation/jumper_examples.png
