barkinvar/sugerCANe/output/playwright/worksheet_desktop.png

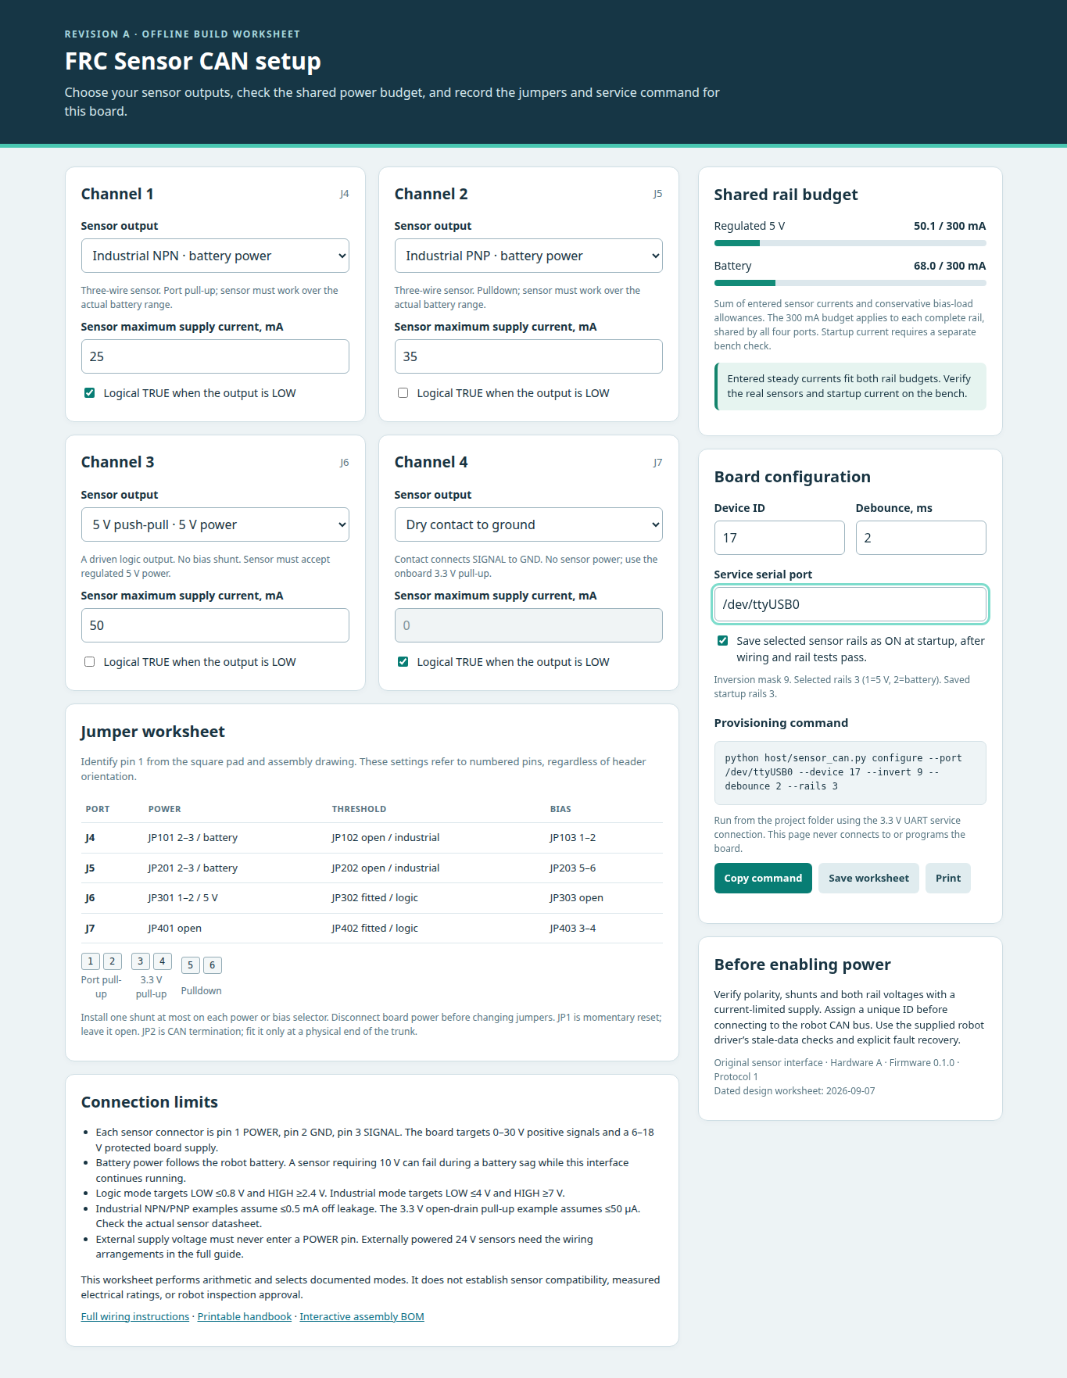
output/playwright/worksheet_desktop.png
