barkinvar/sugerCANe/output/playwright/worksheet_mobile.png

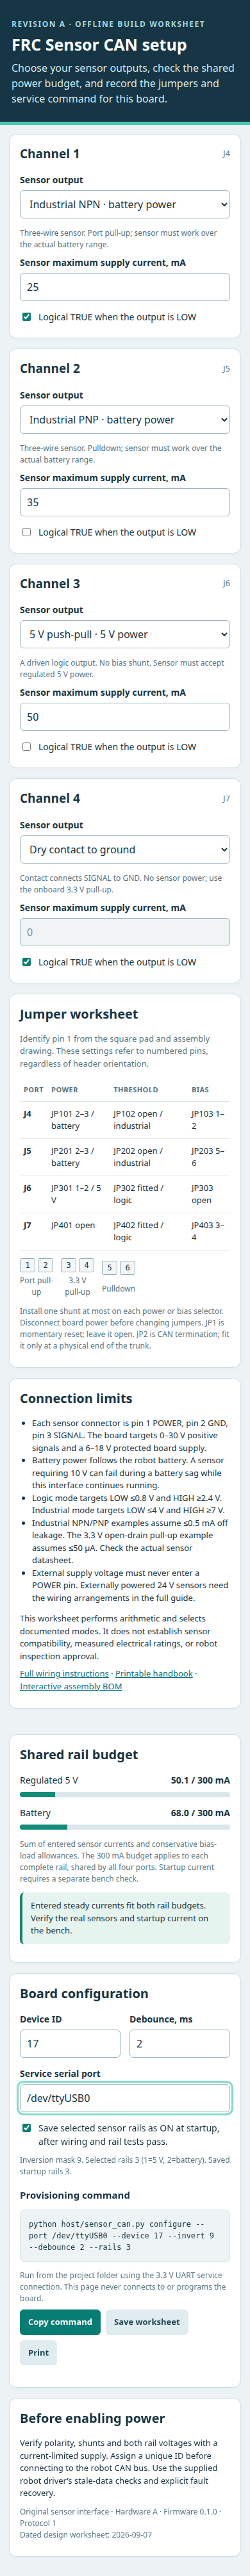
output/playwright/worksheet_mobile.png
