barkinvar/sugerCANe/output/review/abm3b_pin_check.png

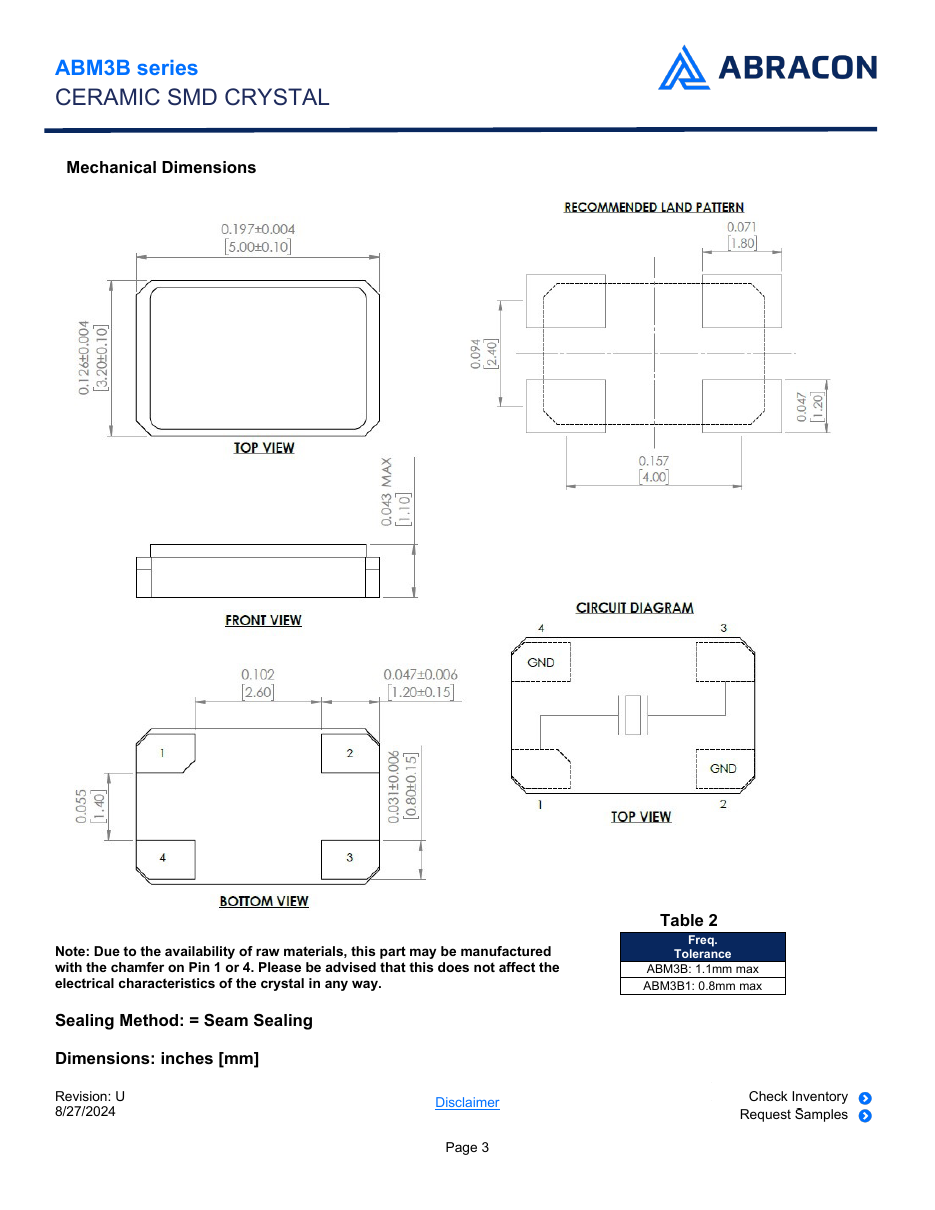
output/review/abm3b_pin_check.png
