barkinvar/sugerCANe/output/review/ao4485_pin_check.png

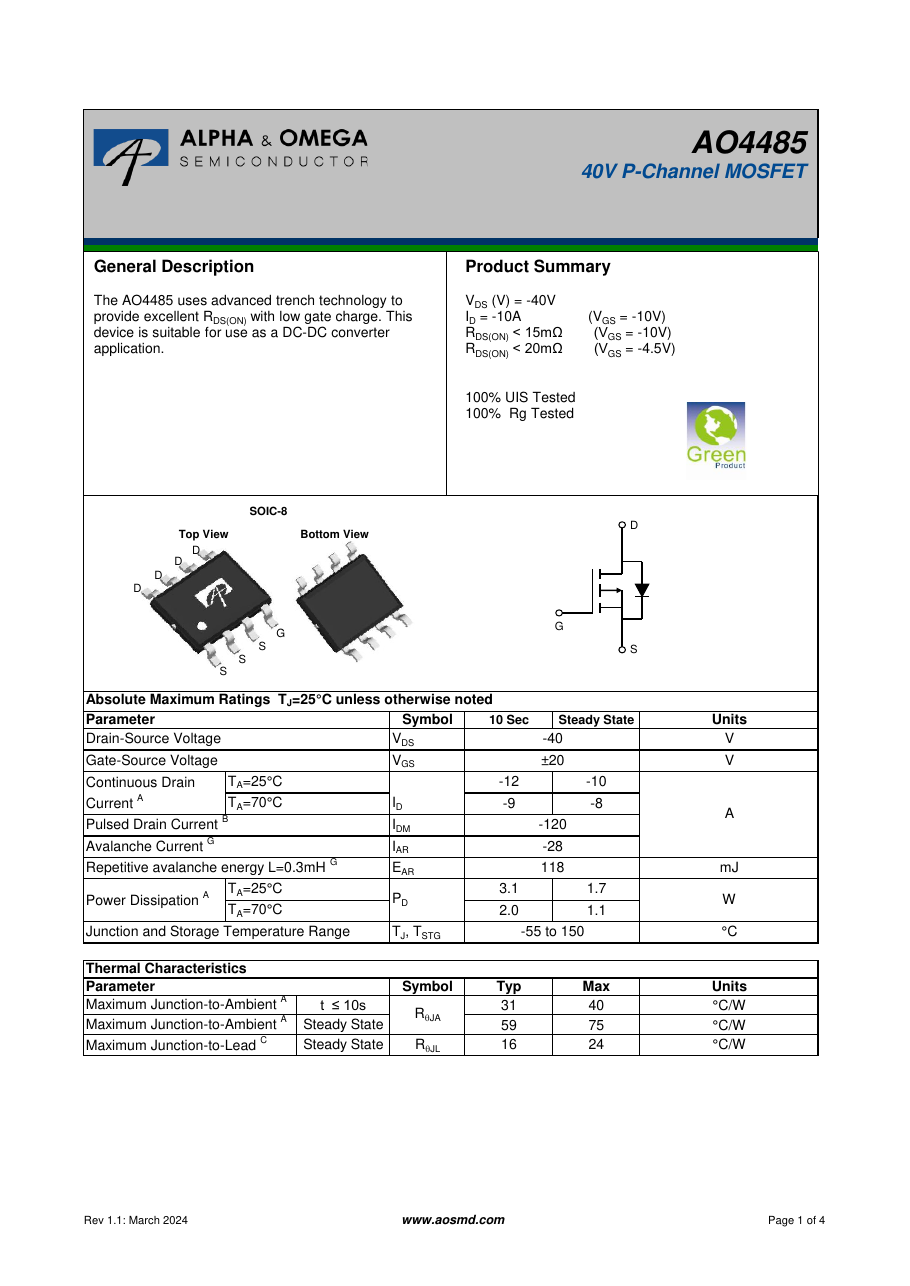
output/review/ao4485_pin_check.png
