barkinvar/sugerCANe/output/review/board_3d_first.png

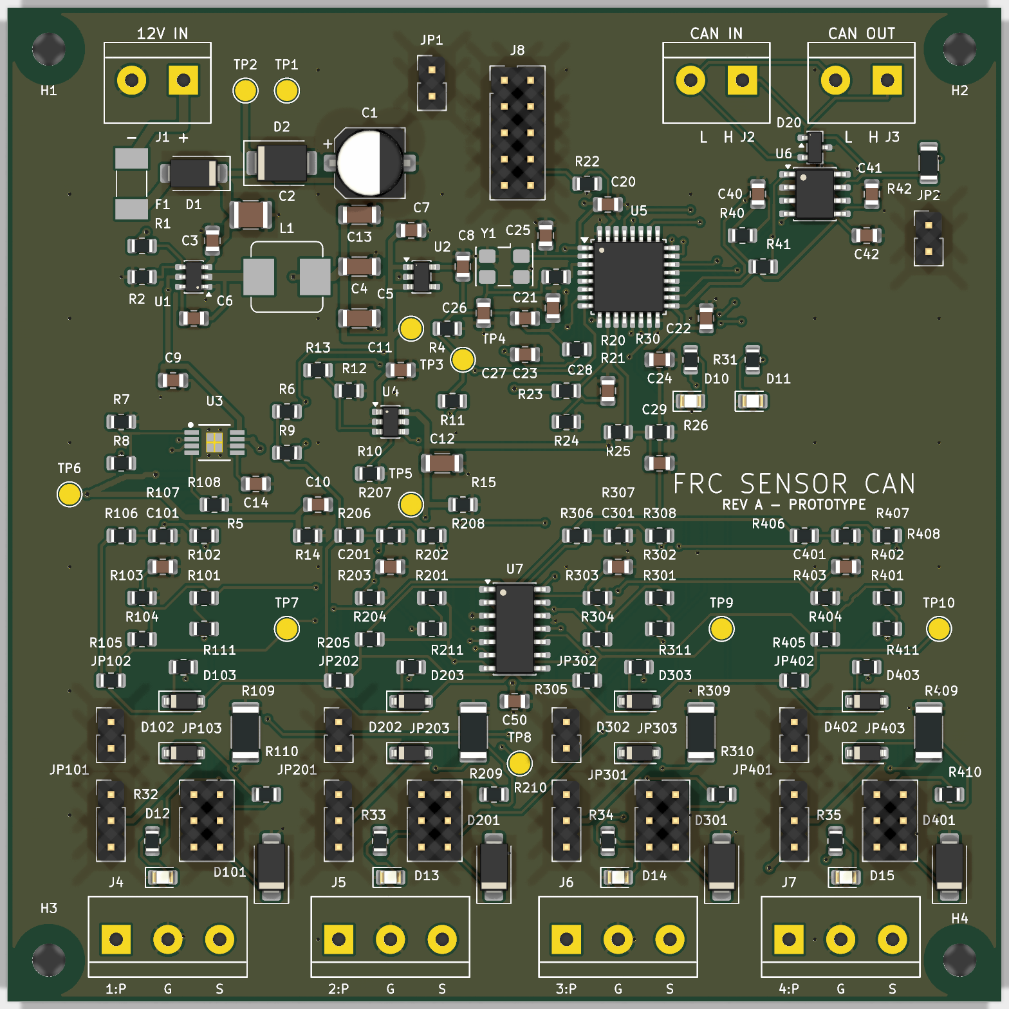
output/review/board_3d_first.png
