barkinvar/sugerCANe/output/review/board_bottom_final.png

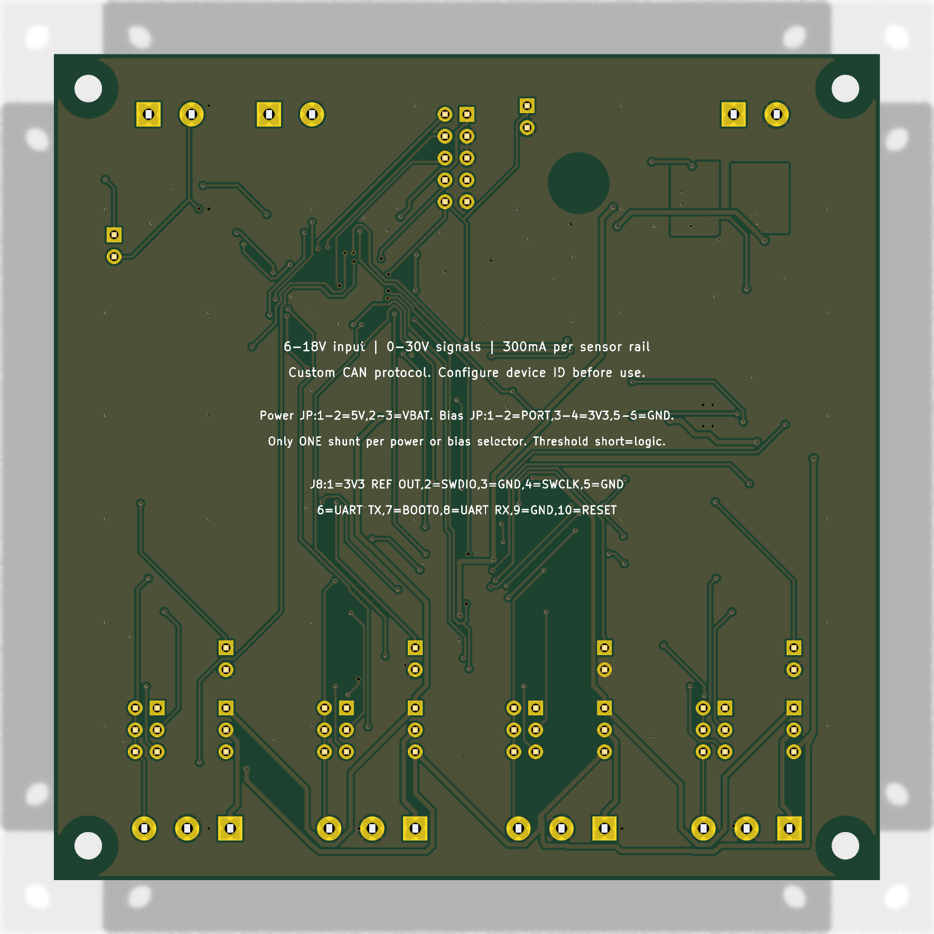
output/review/board_bottom_final.png
