barkinvar/sugerCANe/output/review/controller_final.png

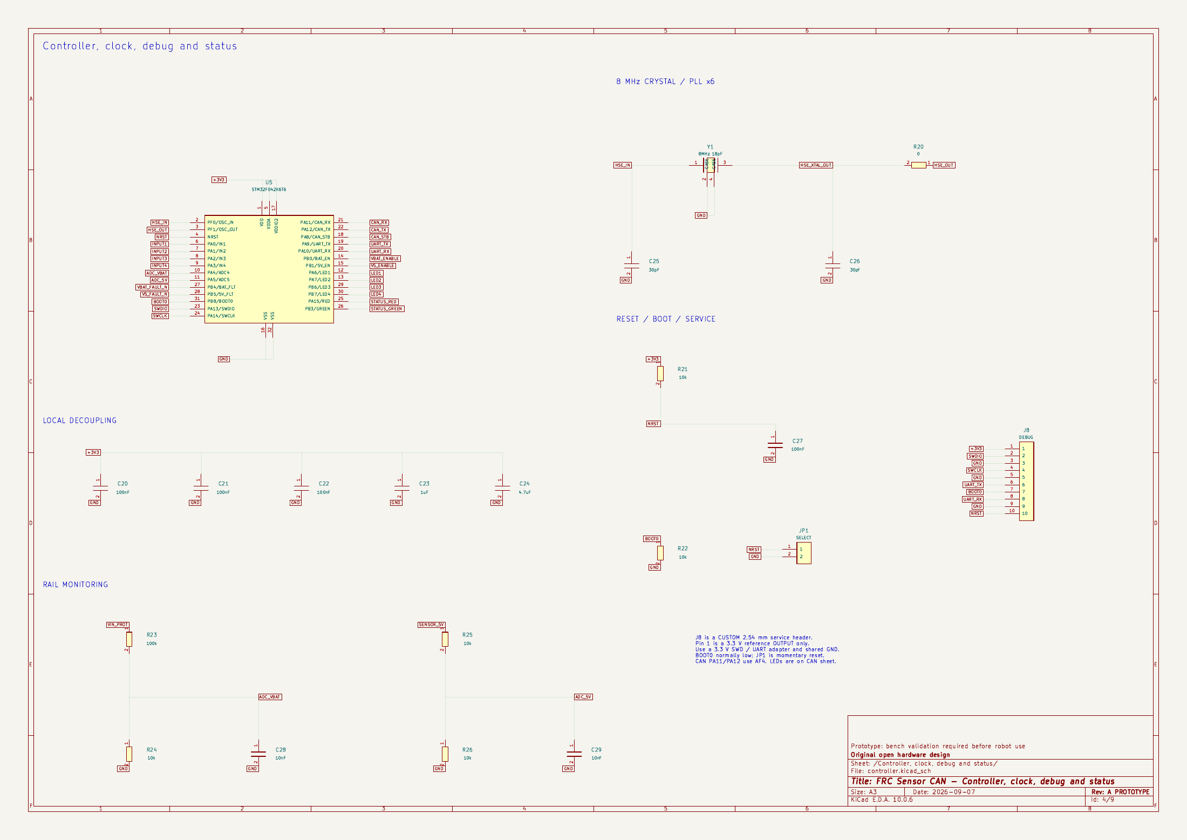
output/review/controller_final.png
