barkinvar/sugerCANe/output/review/current_board.png

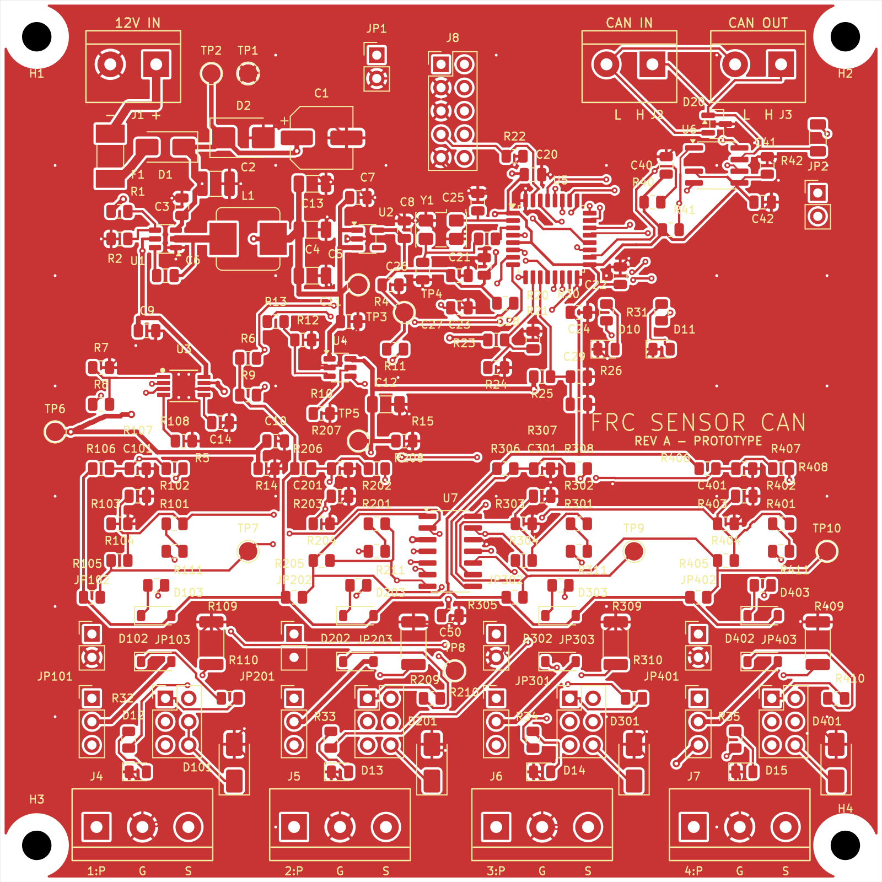
output/review/current_board.png
