barkinvar/sugerCANe/output/review/final_handbook_contact_1.png

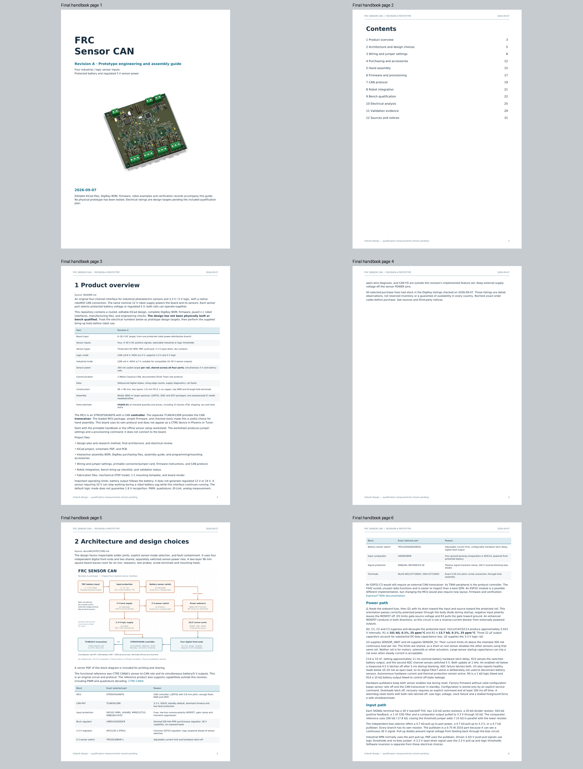
output/review/final_handbook_contact_1.png
