barkinvar/sugerCANe/output/review/final_handbook_contact_3.png

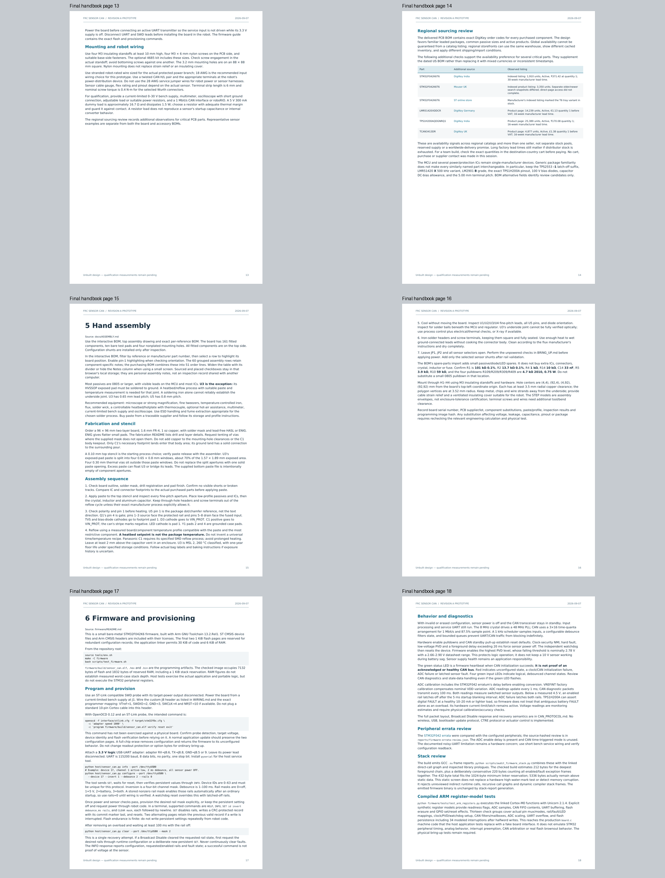
output/review/final_handbook_contact_3.png
