barkinvar/sugerCANe/output/review/final_handbook_contact_6.png

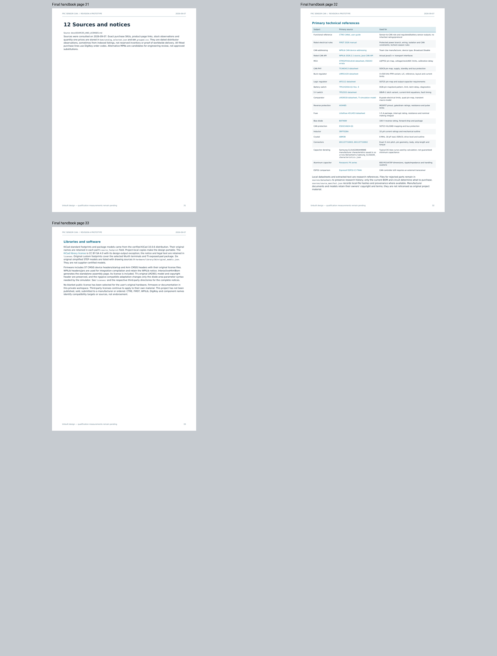
output/review/final_handbook_contact_6.png
