barkinvar/sugerCANe/output/review/final_handbook_page-01.png

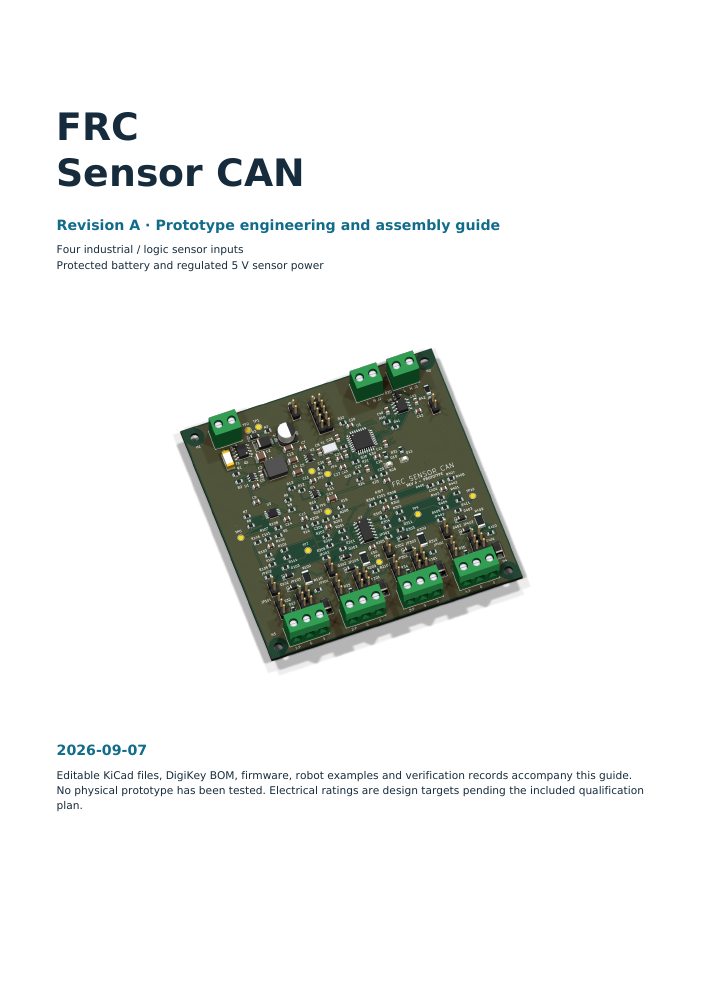
output/review/final_handbook_page-01.png
