barkinvar/sugerCANe/output/review/final_handbook_page-02.png

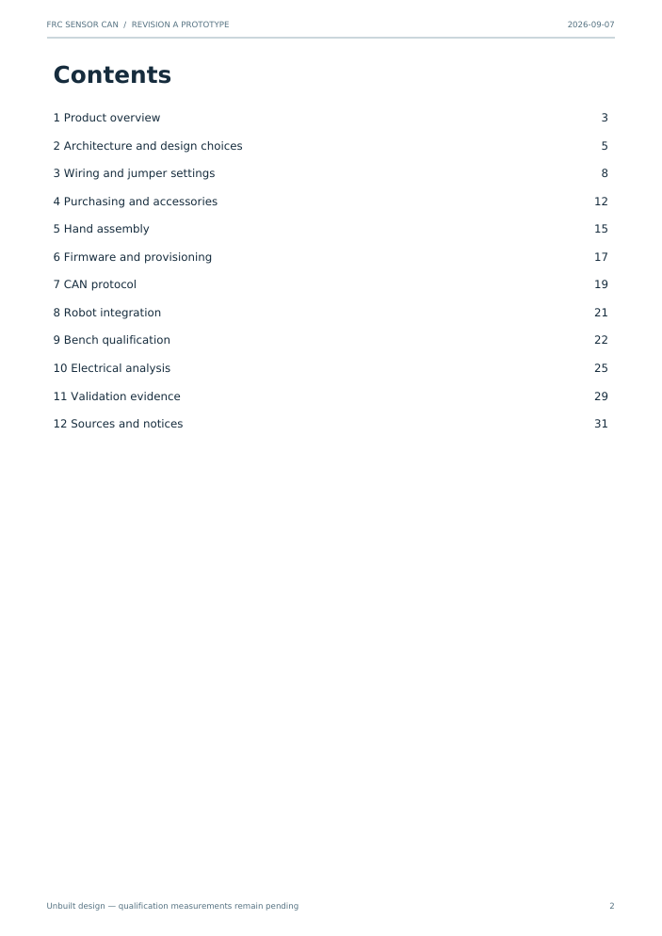
output/review/final_handbook_page-02.png
