barkinvar/sugerCANe/output/review/final_handbook_page-03.png

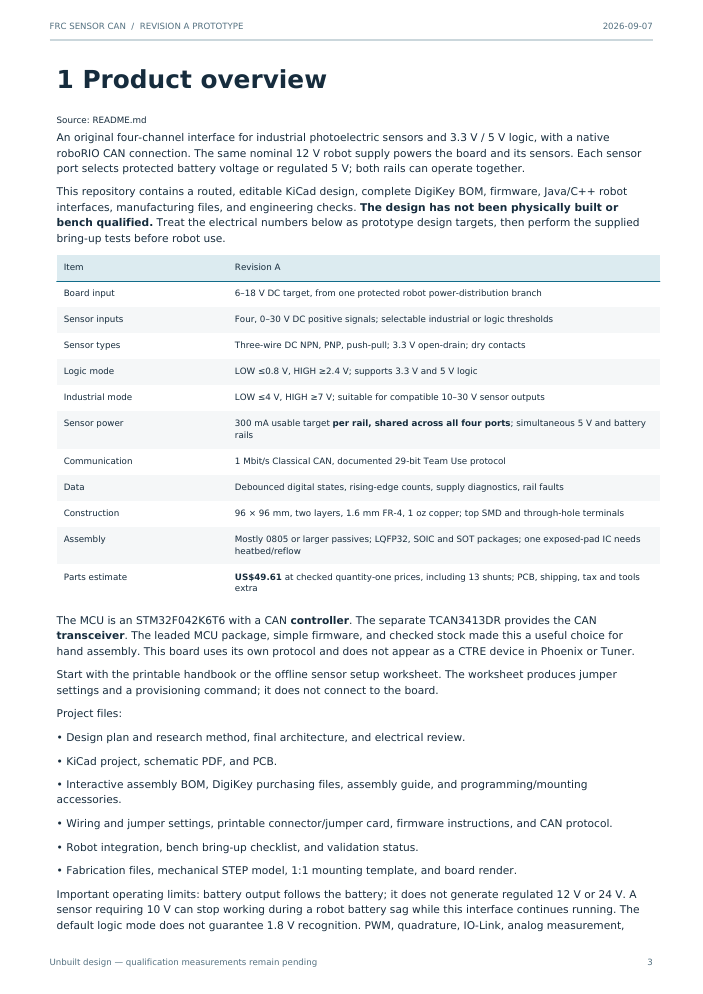
output/review/final_handbook_page-03.png
