barkinvar/sugerCANe/output/review/final_handbook_page-04.png

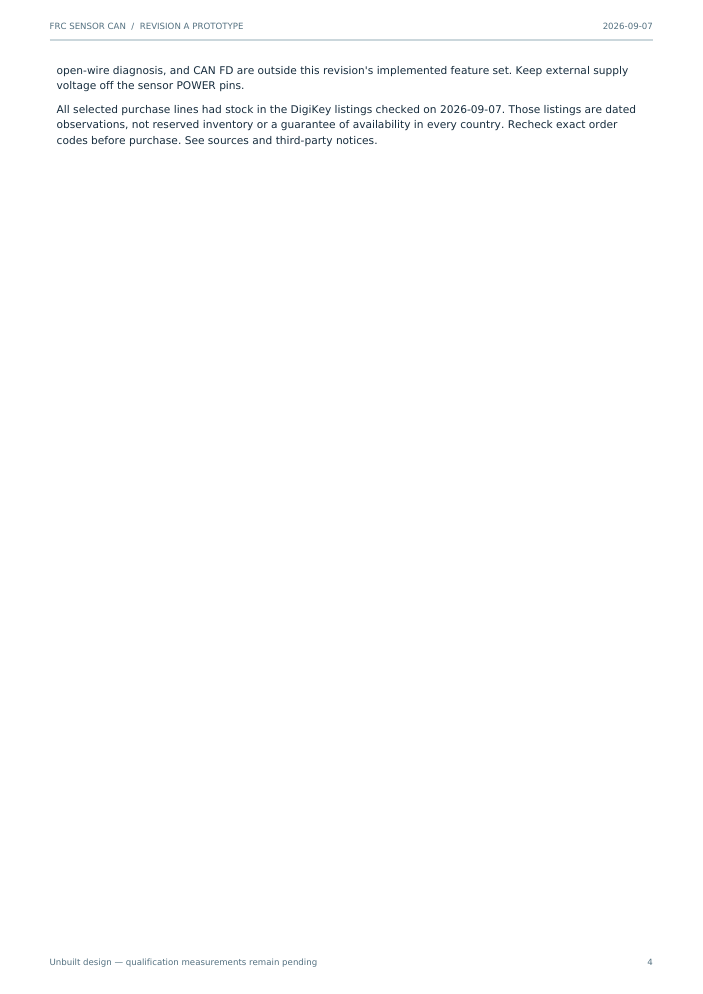
output/review/final_handbook_page-04.png
