barkinvar/sugerCANe/output/review/final_handbook_page-05.png

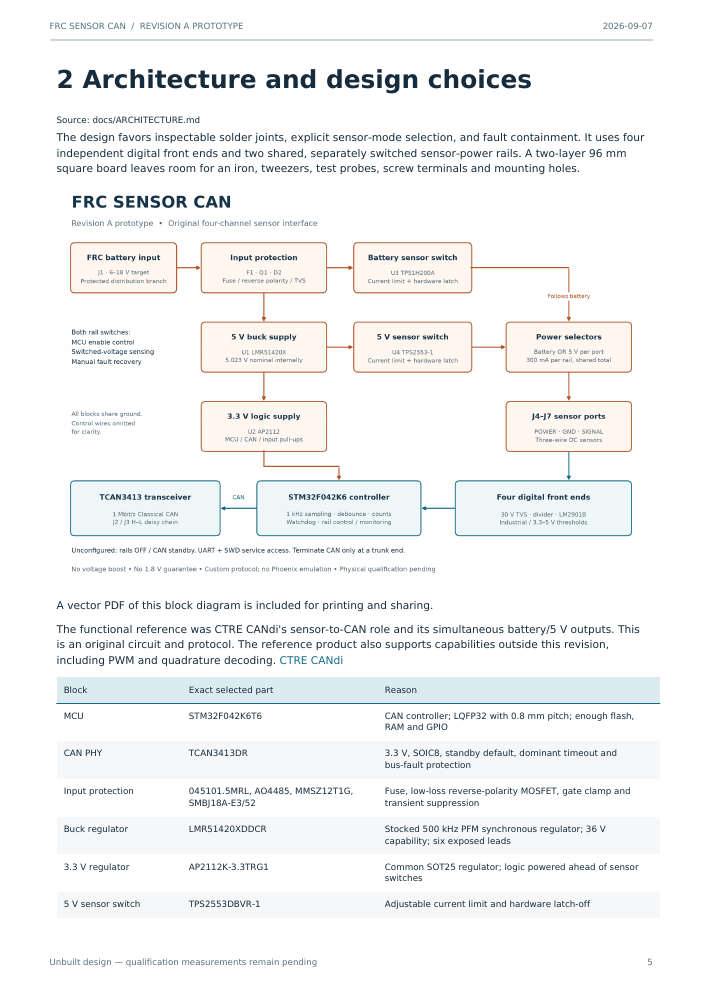
output/review/final_handbook_page-05.png
