barkinvar/sugerCANe/output/review/final_handbook_page-06.png

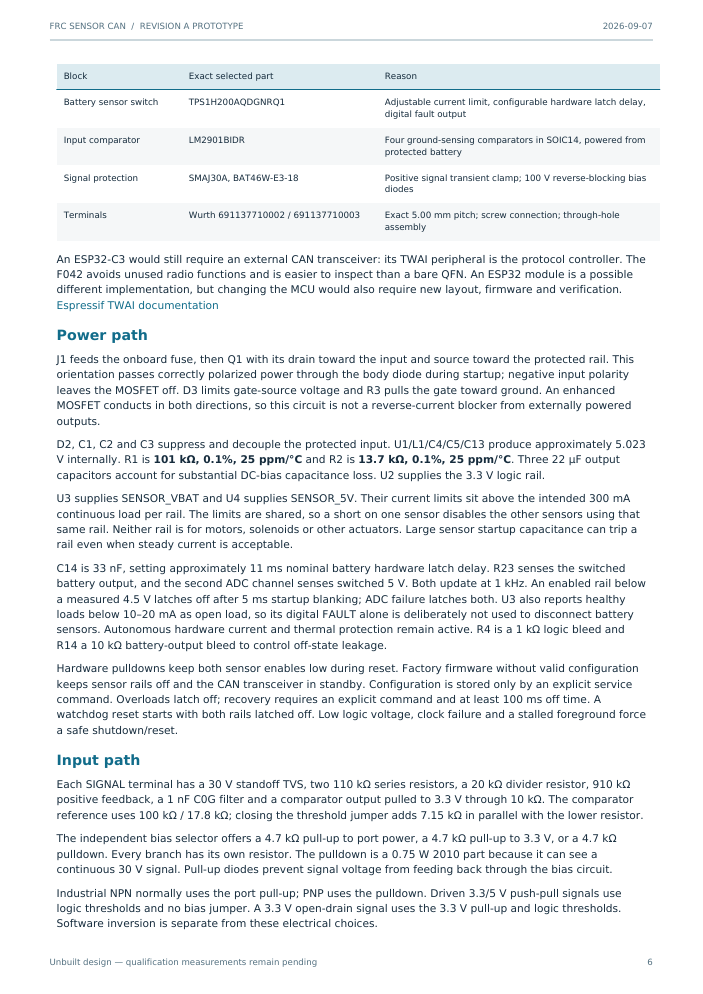
output/review/final_handbook_page-06.png
