barkinvar/sugerCANe/output/review/final_handbook_page-08.png

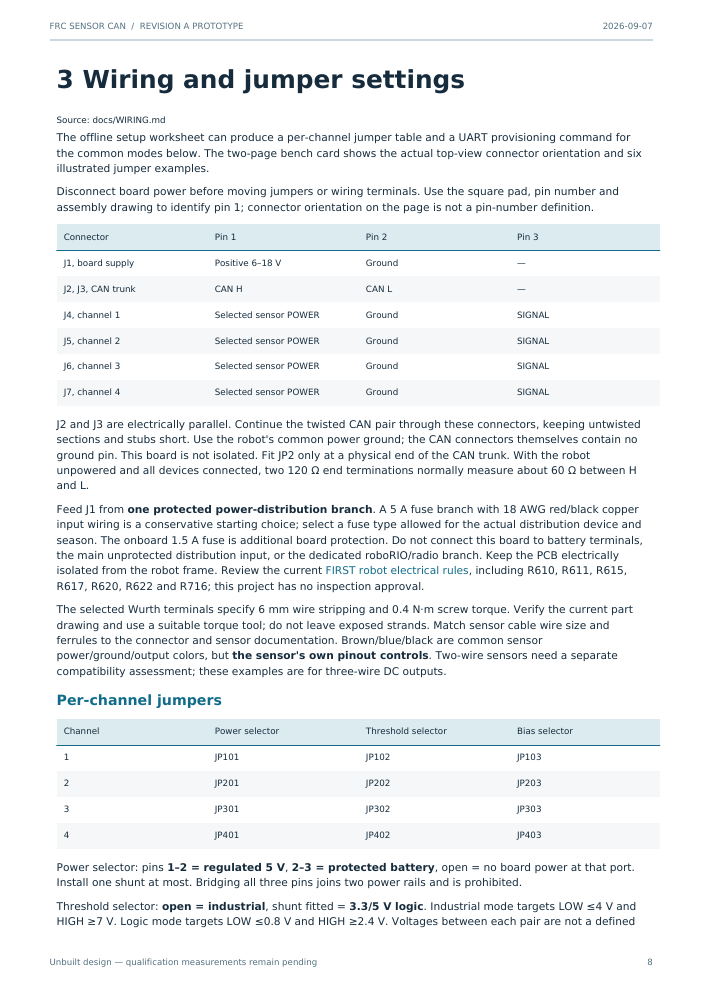
output/review/final_handbook_page-08.png
