barkinvar/sugerCANe/output/review/final_handbook_page-10.png

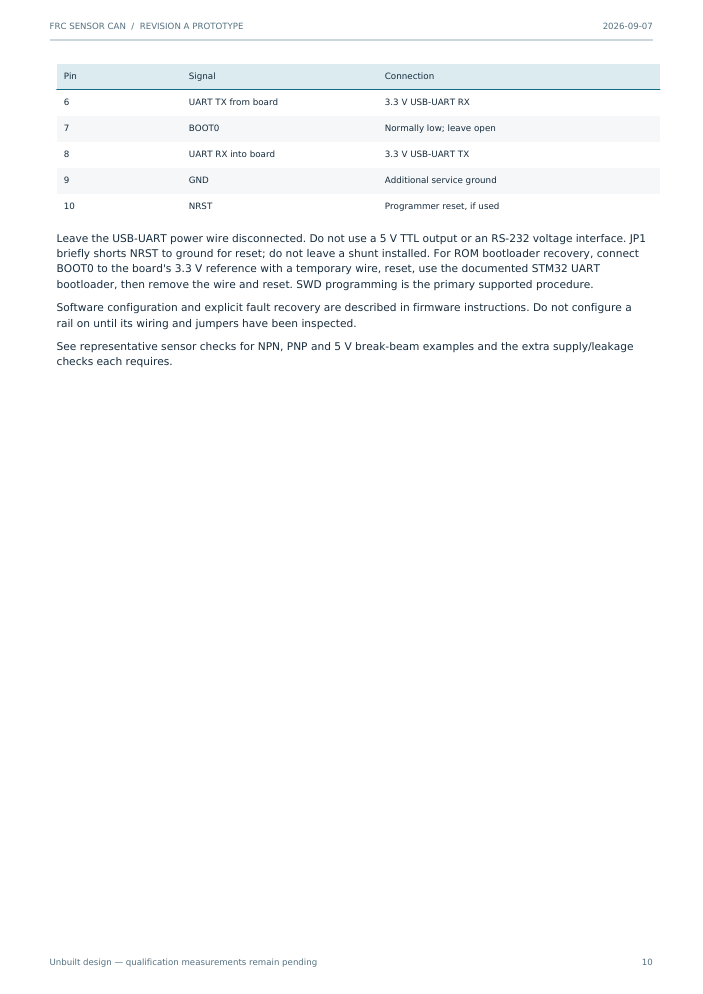
output/review/final_handbook_page-10.png
