barkinvar/sugerCANe/output/review/final_handbook_page-13.png

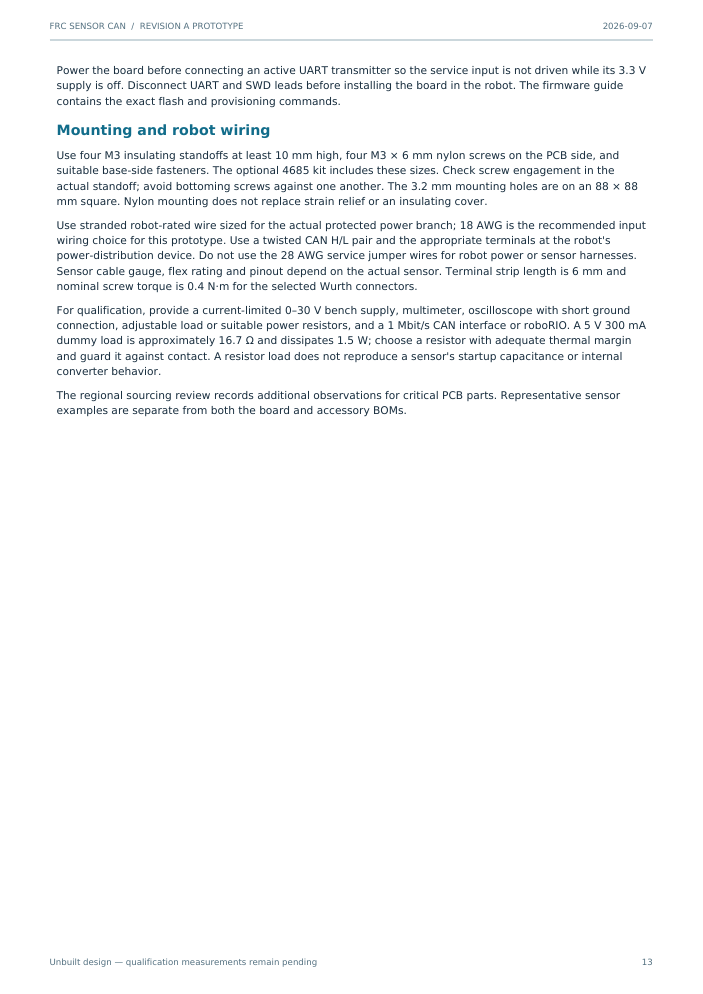
output/review/final_handbook_page-13.png
