barkinvar/sugerCANe/output/review/final_handbook_page-15.png

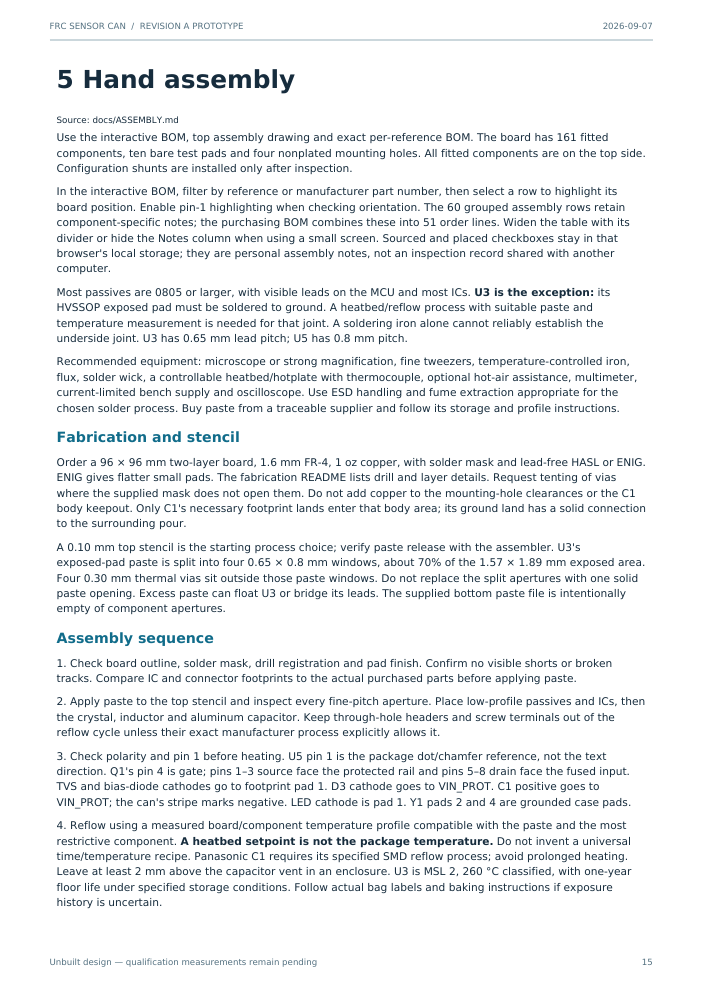
output/review/final_handbook_page-15.png
