barkinvar/sugerCANe/output/review/final_handbook_page-16.png

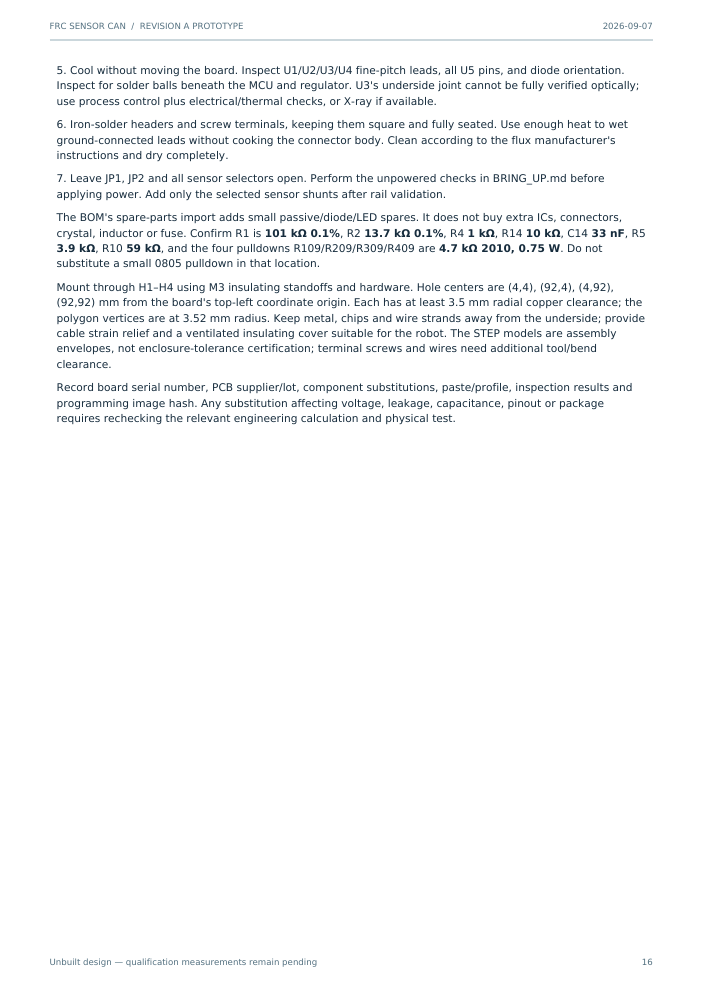
output/review/final_handbook_page-16.png
