barkinvar/sugerCANe/output/review/final_handbook_page-20.png

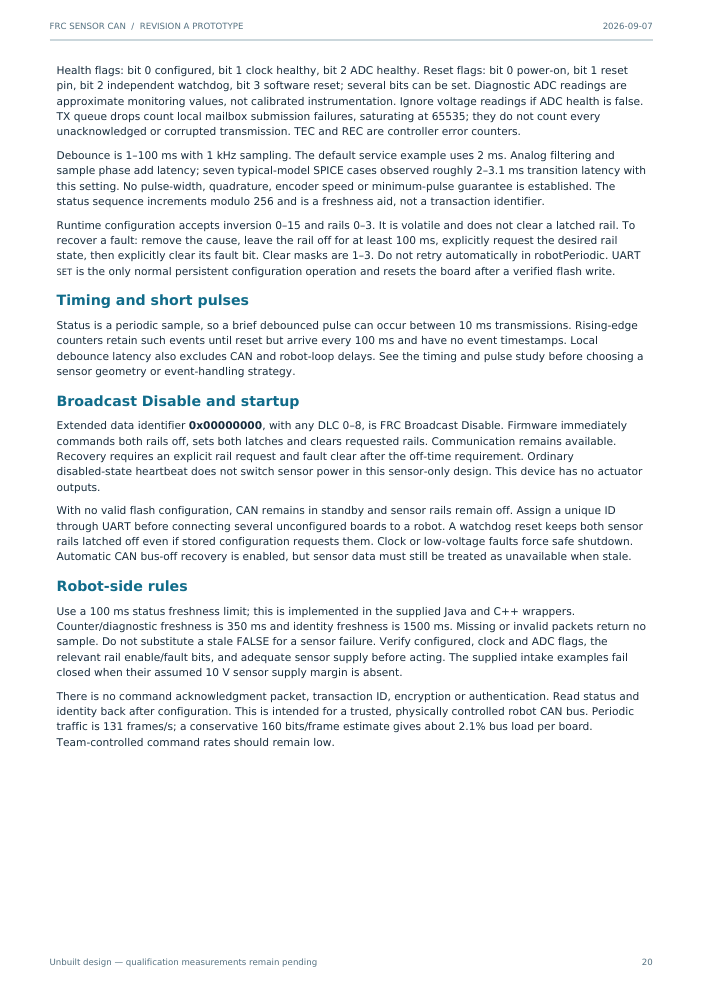
output/review/final_handbook_page-20.png
