barkinvar/sugerCANe/output/review/final_handbook_page-22.png

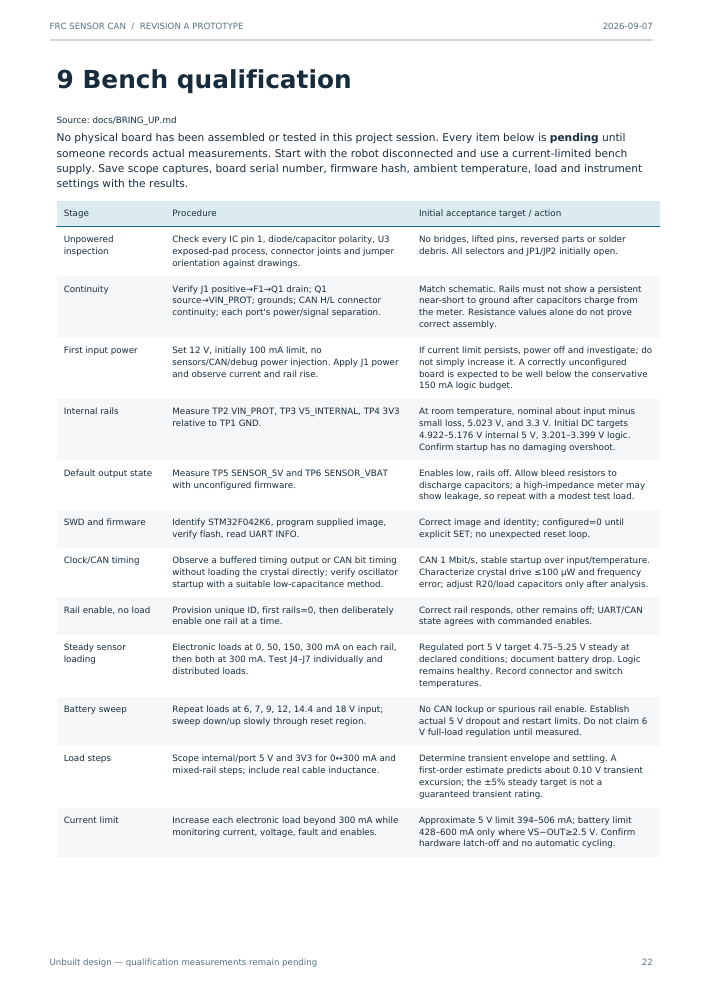
output/review/final_handbook_page-22.png
