barkinvar/sugerCANe/output/review/final_handbook_page-23.png

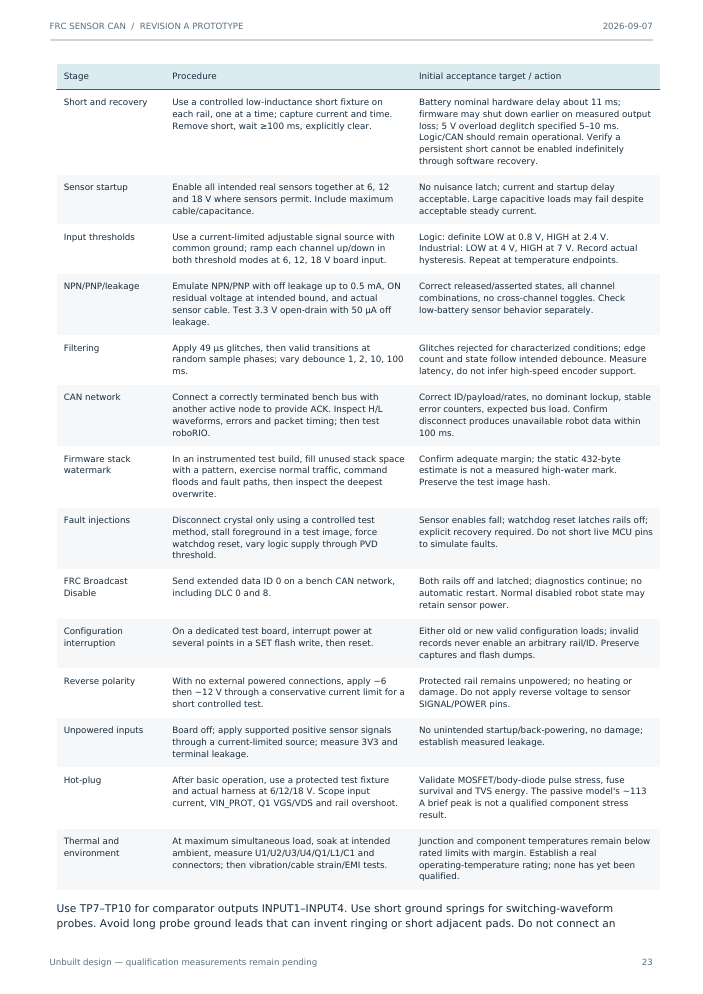
output/review/final_handbook_page-23.png
