barkinvar/sugerCANe/output/review/final_handbook_page-24.png

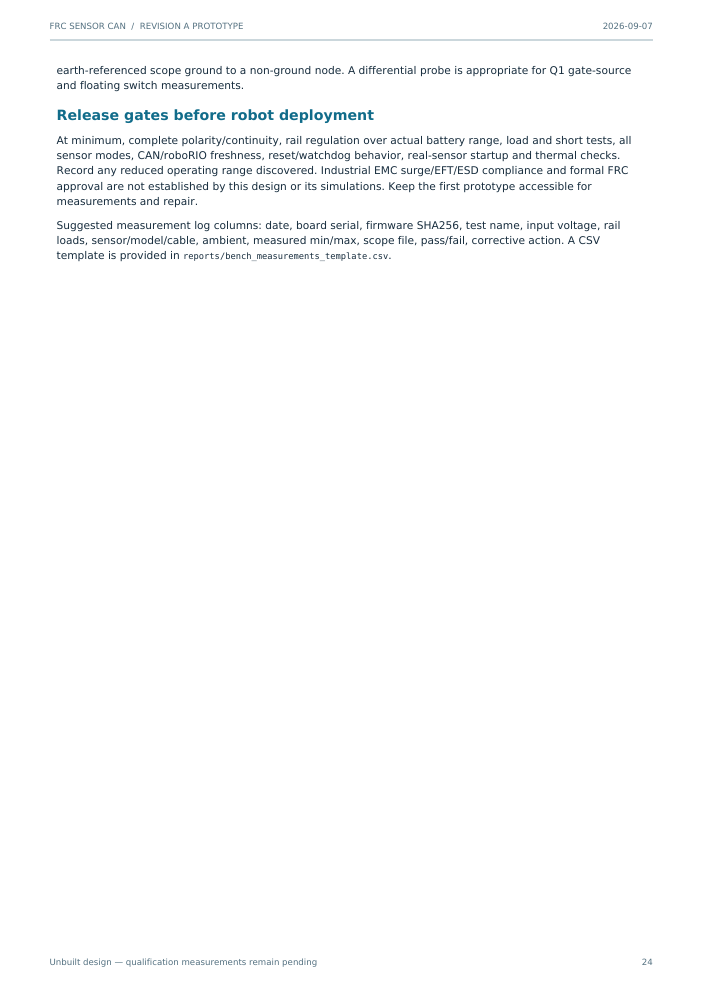
output/review/final_handbook_page-24.png
