barkinvar/sugerCANe/output/review/final_handbook_page-29.png

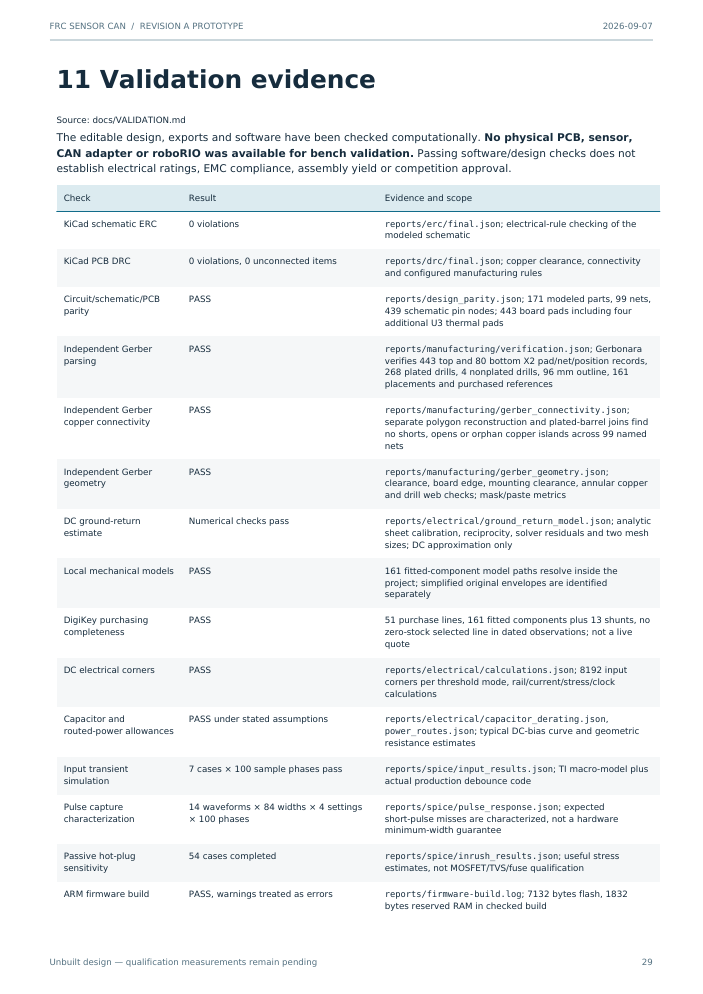
output/review/final_handbook_page-29.png
