barkinvar/sugerCANe/output/review/final_handbook_page-30.png

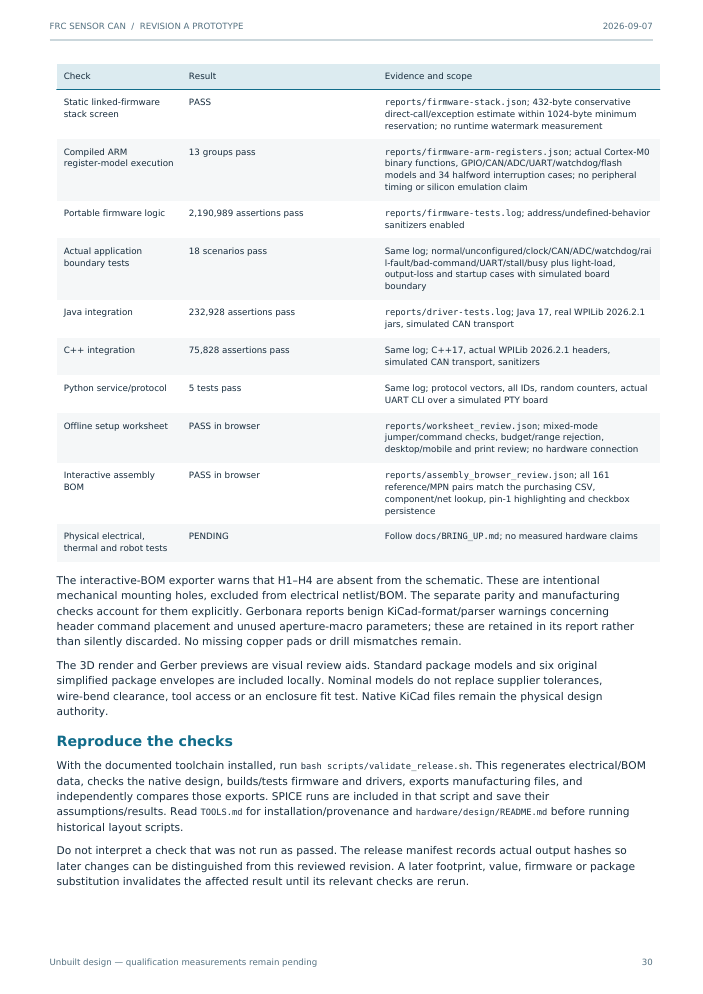
output/review/final_handbook_page-30.png
