barkinvar/sugerCANe/output/review/final_handbook_page-31.png

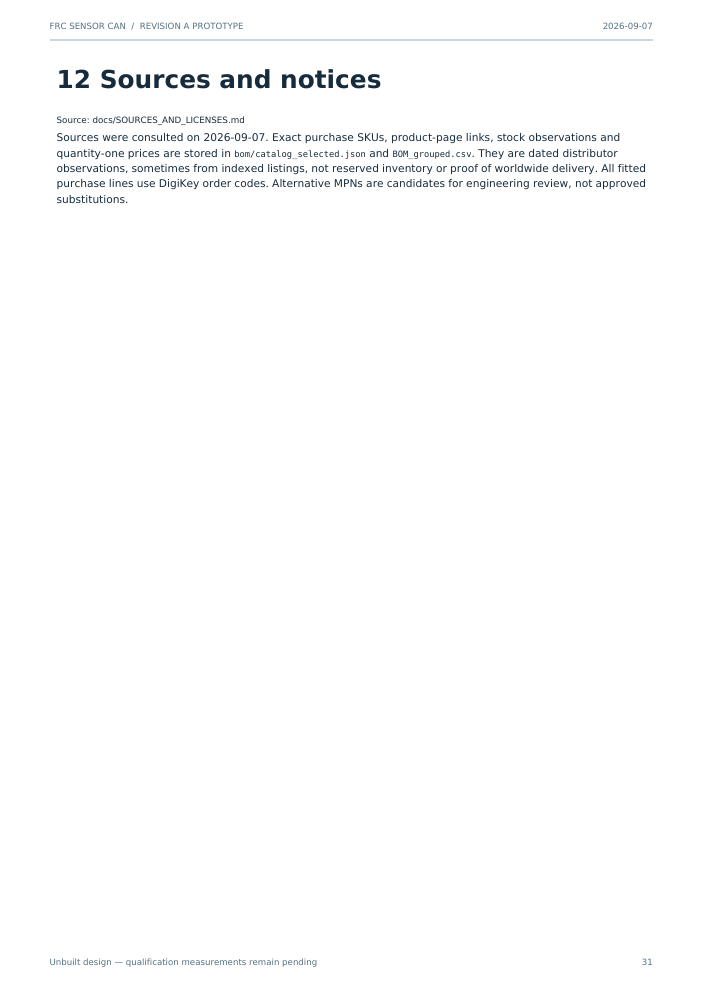
output/review/final_handbook_page-31.png
