barkinvar/sugerCANe/output/review/final_handbook_page-32.png

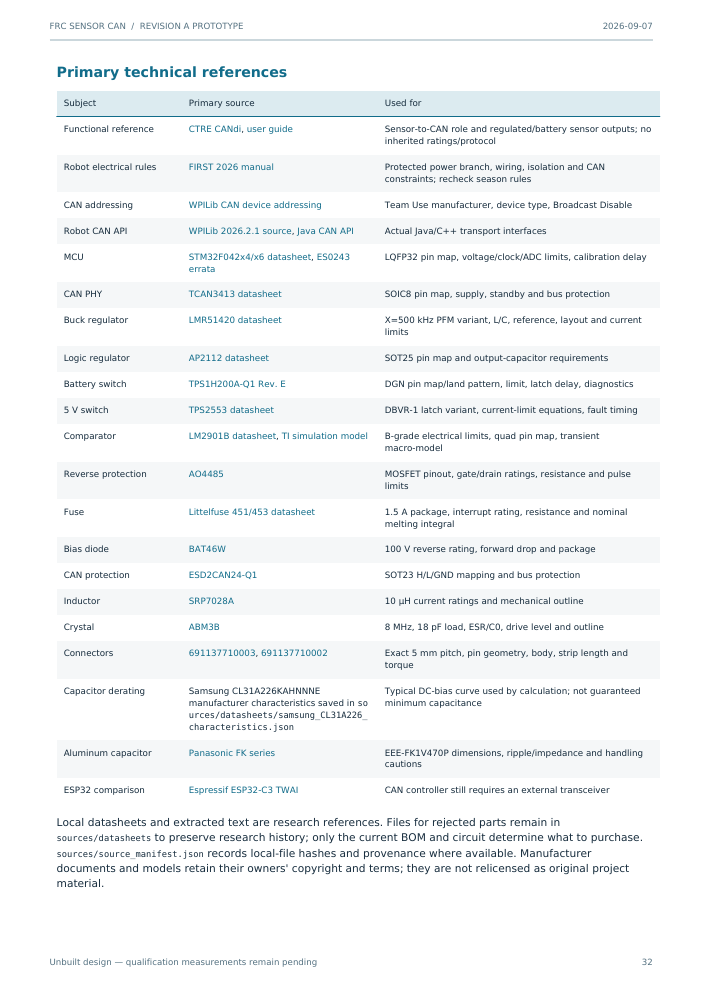
output/review/final_handbook_page-32.png
