barkinvar/sugerCANe/output/review/final_handbook_page-33.png

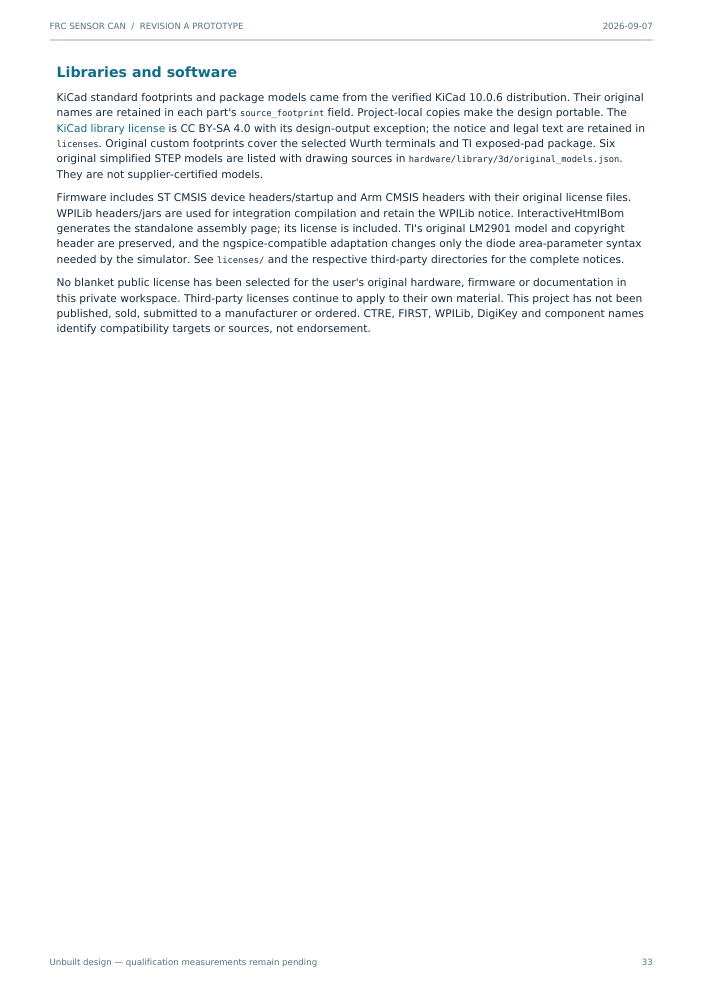
output/review/final_handbook_page-33.png
