barkinvar/sugerCANe/output/review/final_schematic-1.png

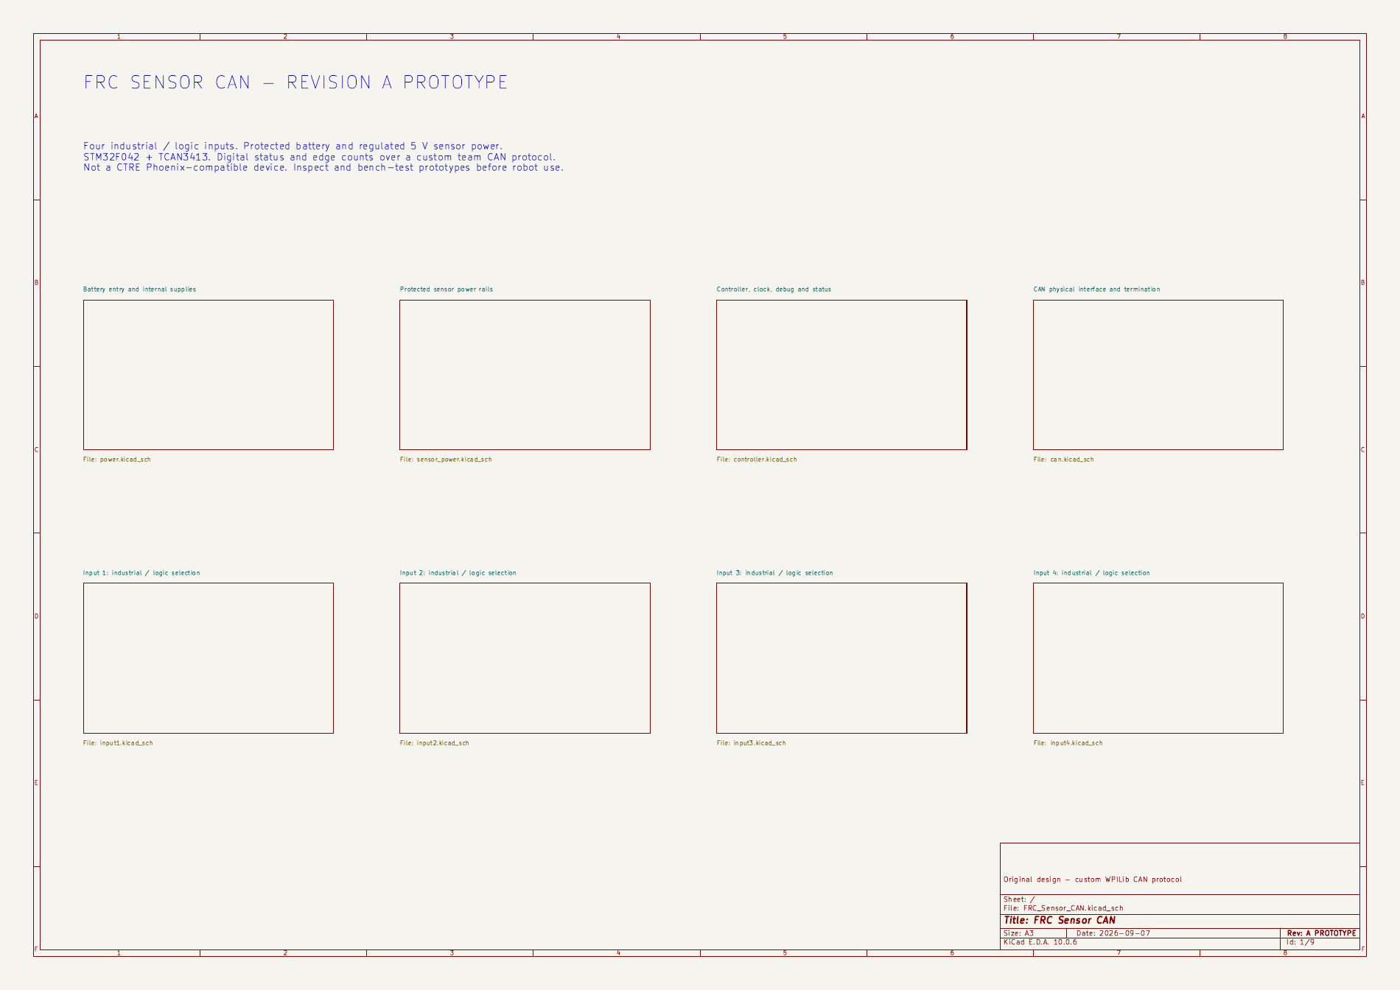
output/review/final_schematic-1.png
