barkinvar/sugerCANe/output/review/final_schematic-2.png

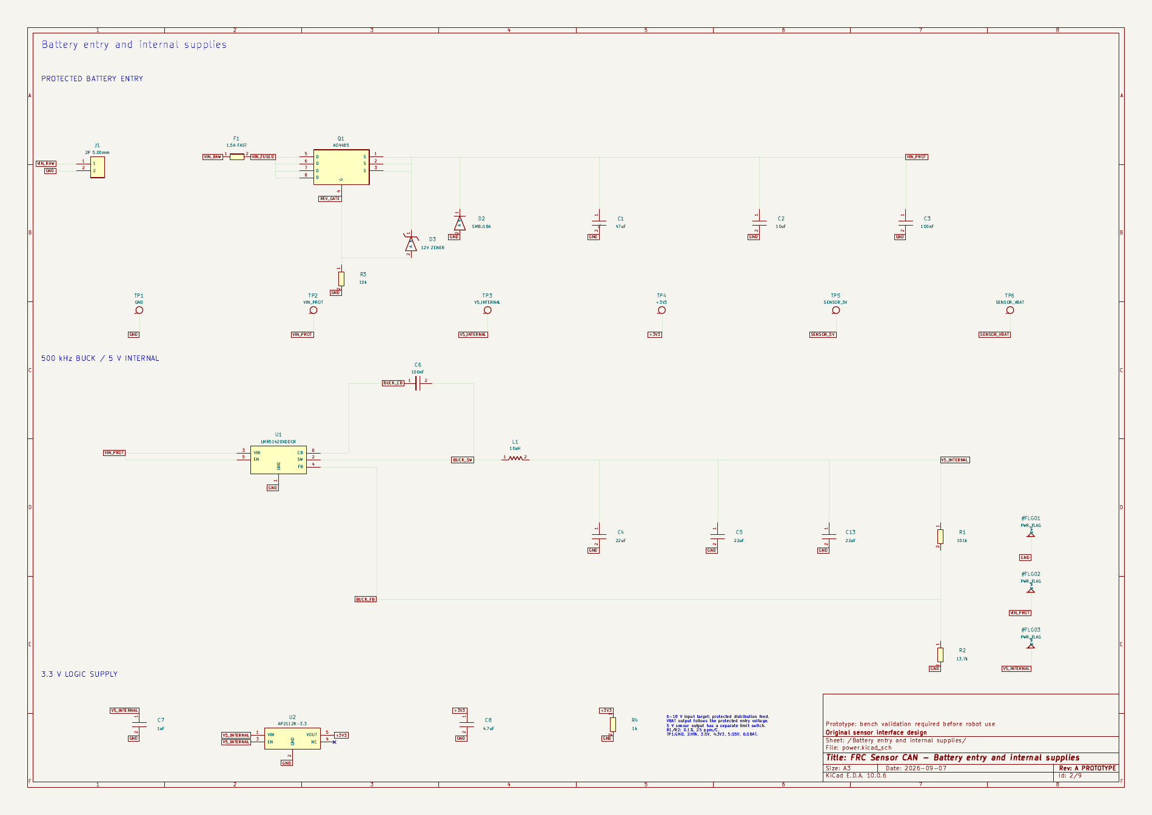
output/review/final_schematic-2.png
