barkinvar/sugerCANe/output/review/final_schematic-3.png

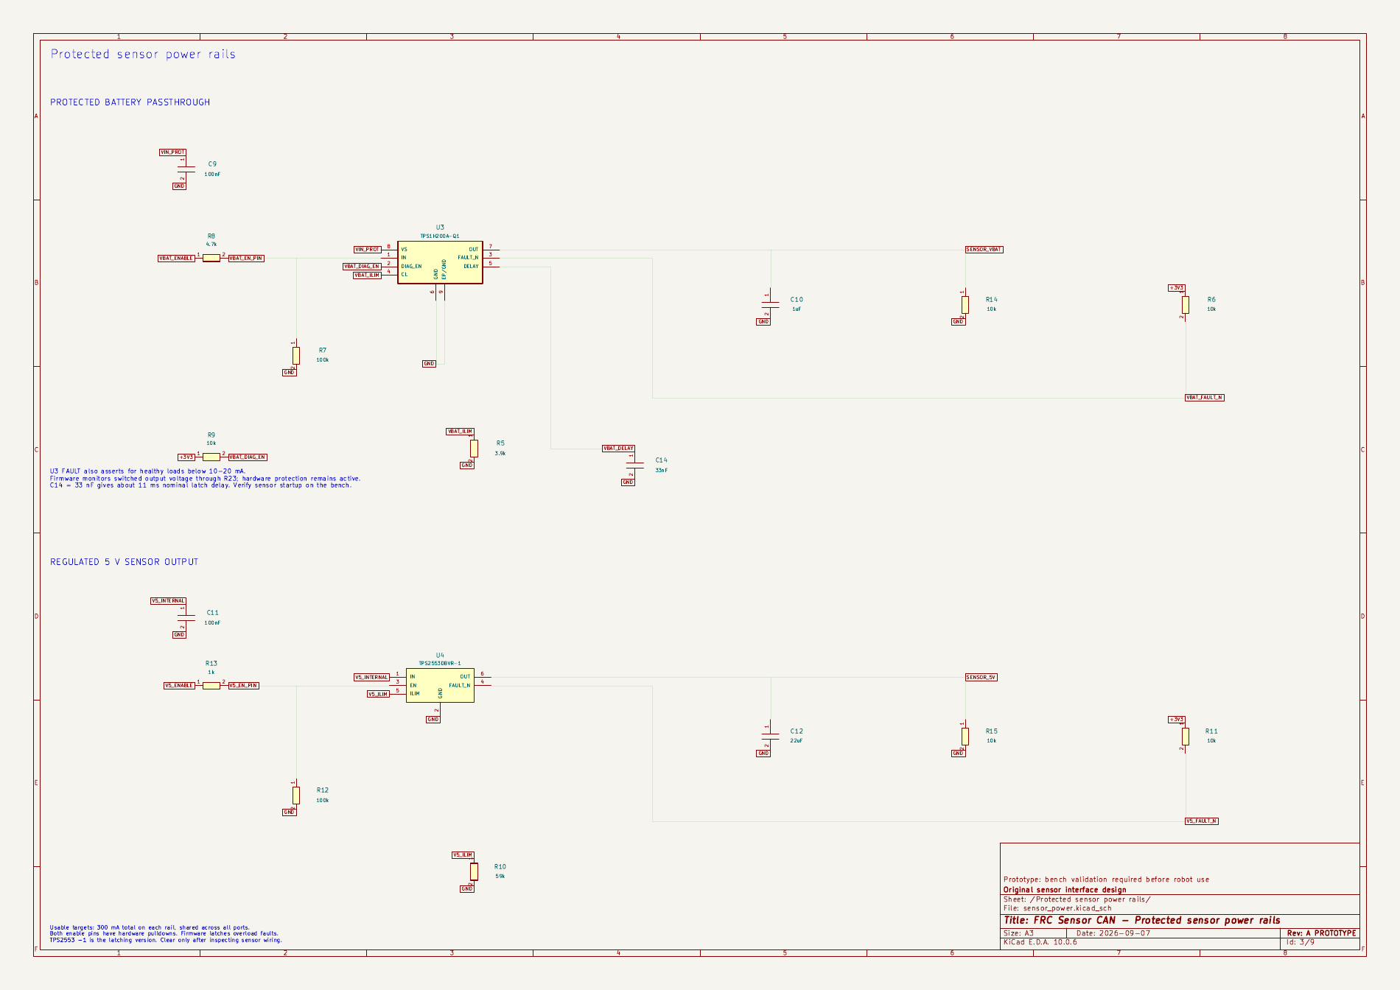
output/review/final_schematic-3.png
