barkinvar/sugerCANe/output/review/final_schematic-5.png

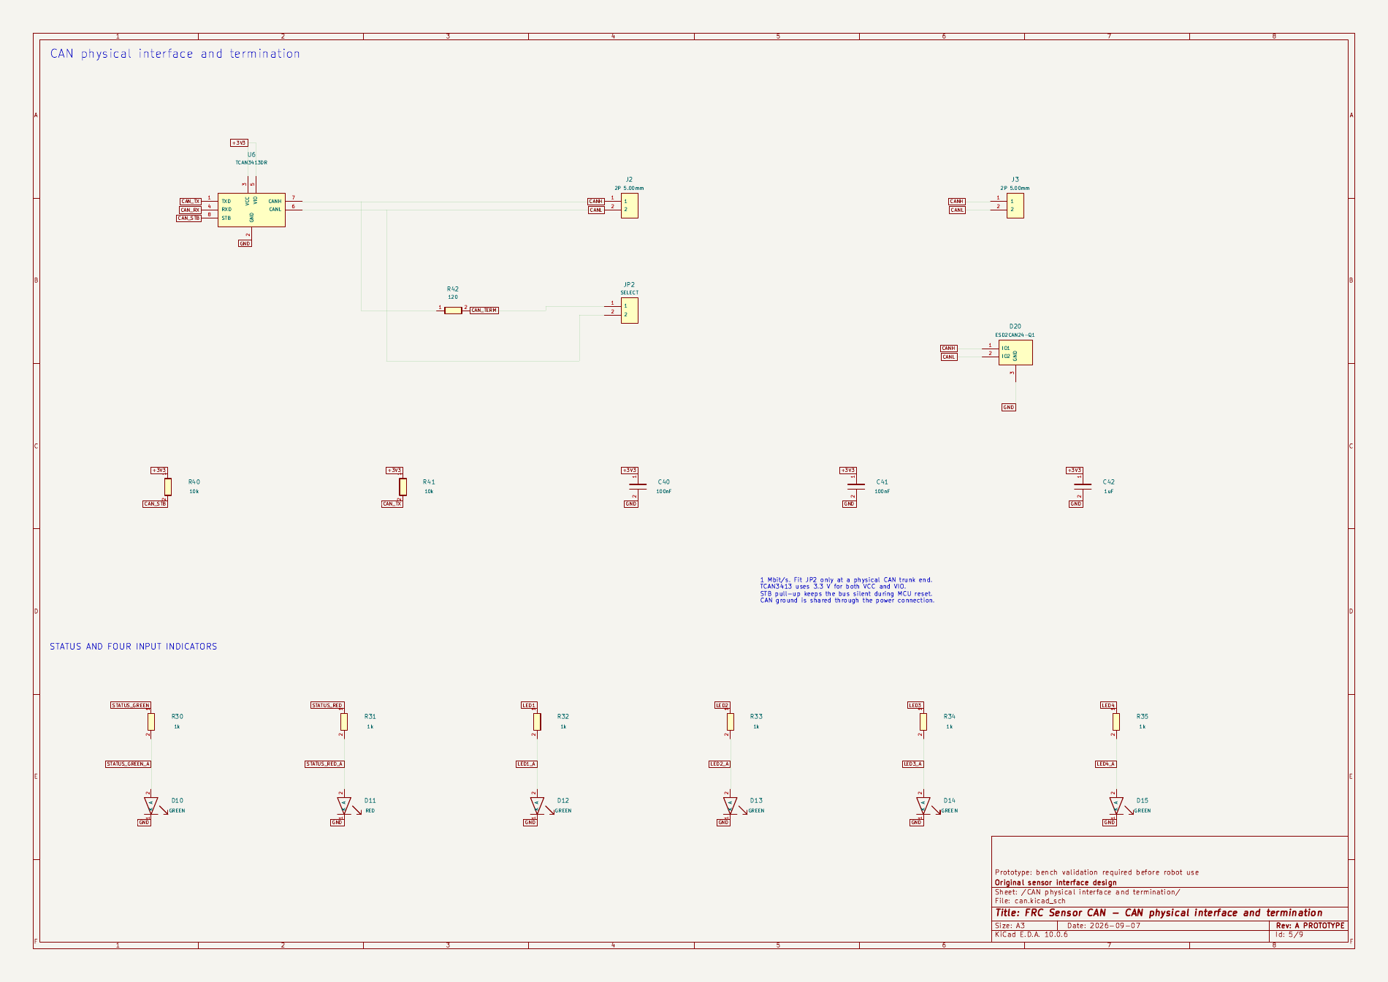
output/review/final_schematic-5.png
