barkinvar/sugerCANe/output/review/final_schematic-6.png

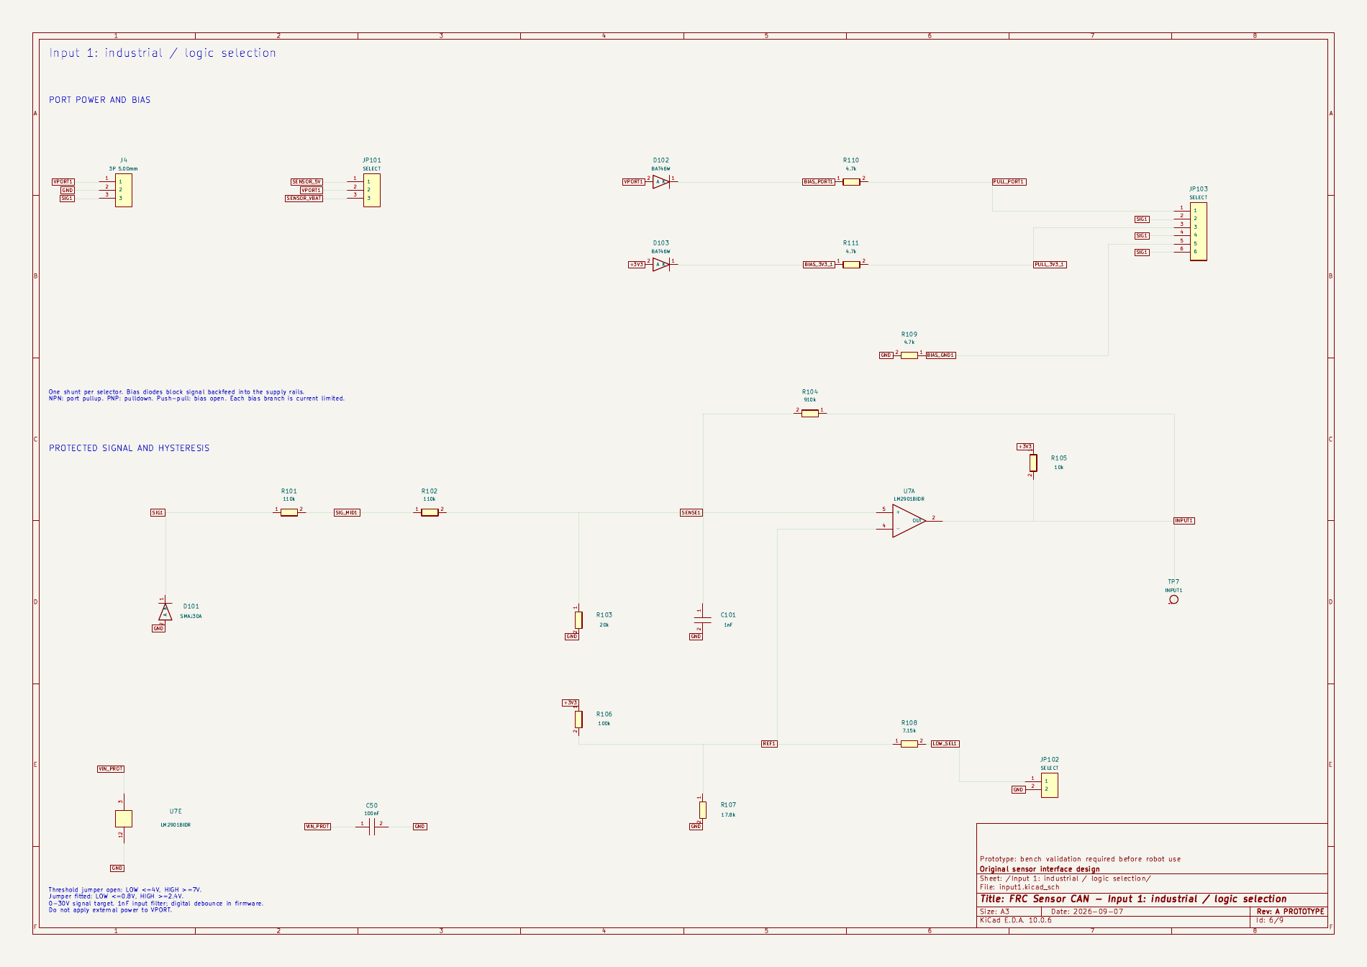
output/review/final_schematic-6.png
