barkinvar/sugerCANe/output/review/gerber_bottom.png

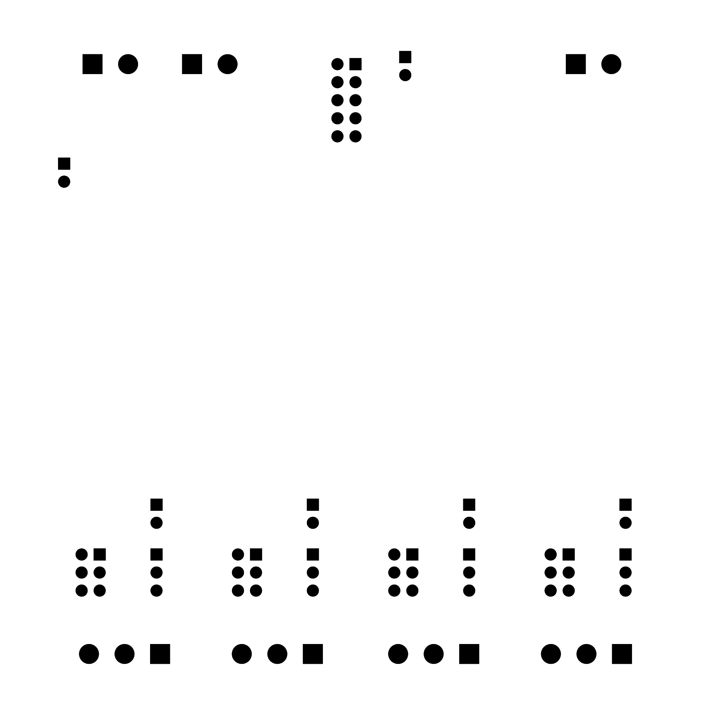
output/review/gerber_bottom.png
