barkinvar/sugerCANe/output/review/gerber_bottom_copper.png

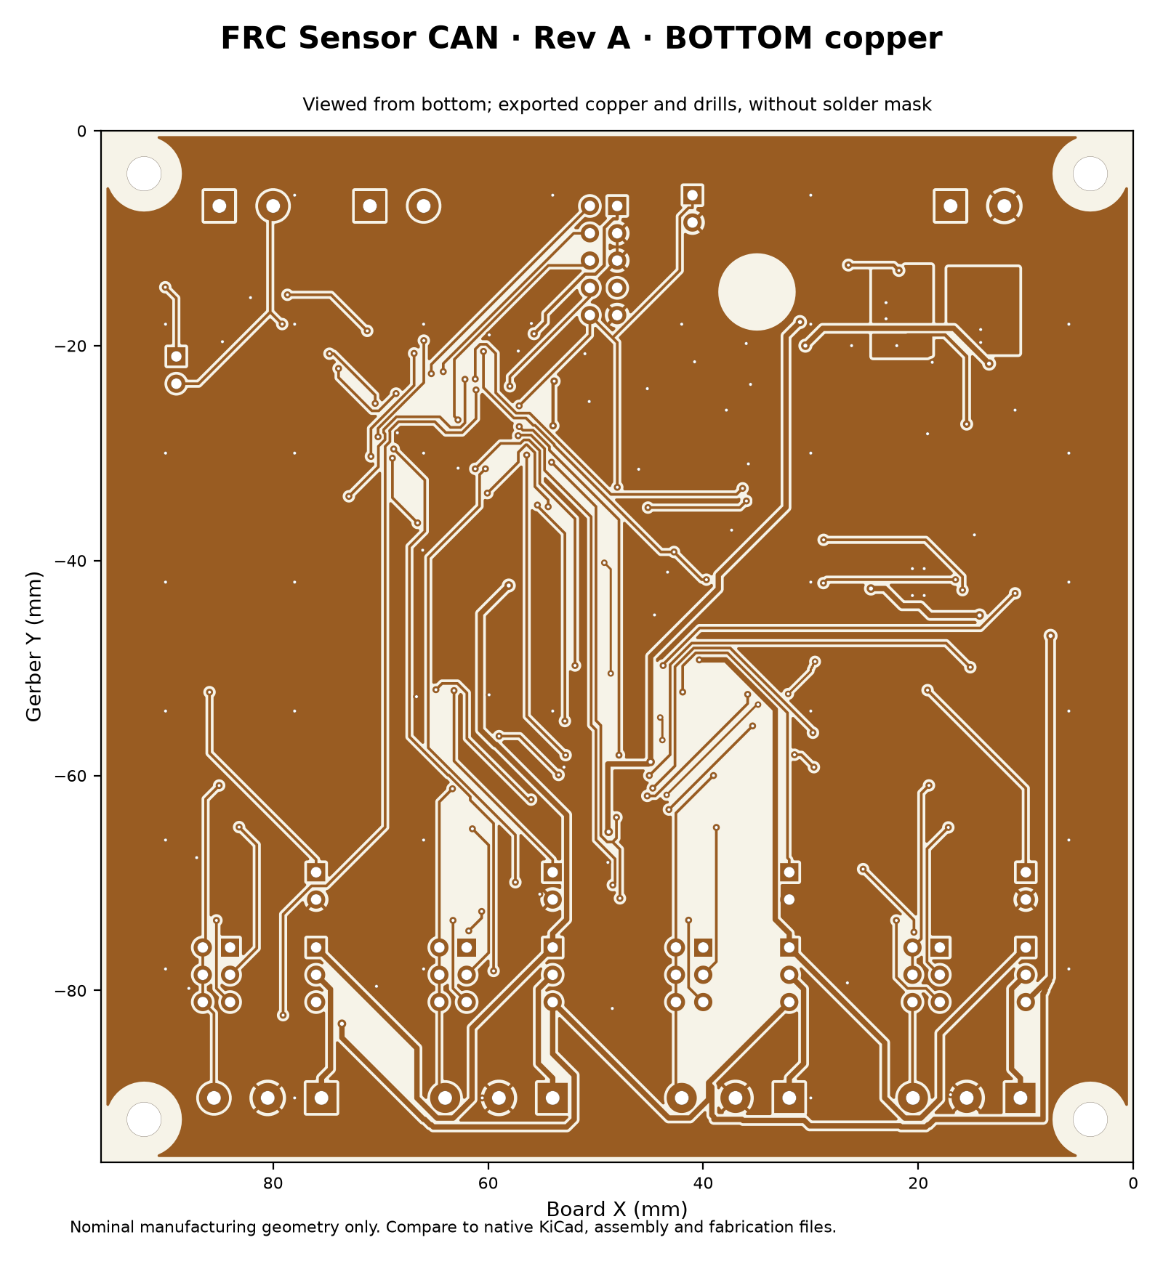
output/review/gerber_bottom_copper.png
