barkinvar/sugerCANe/output/review/gerber_top.png

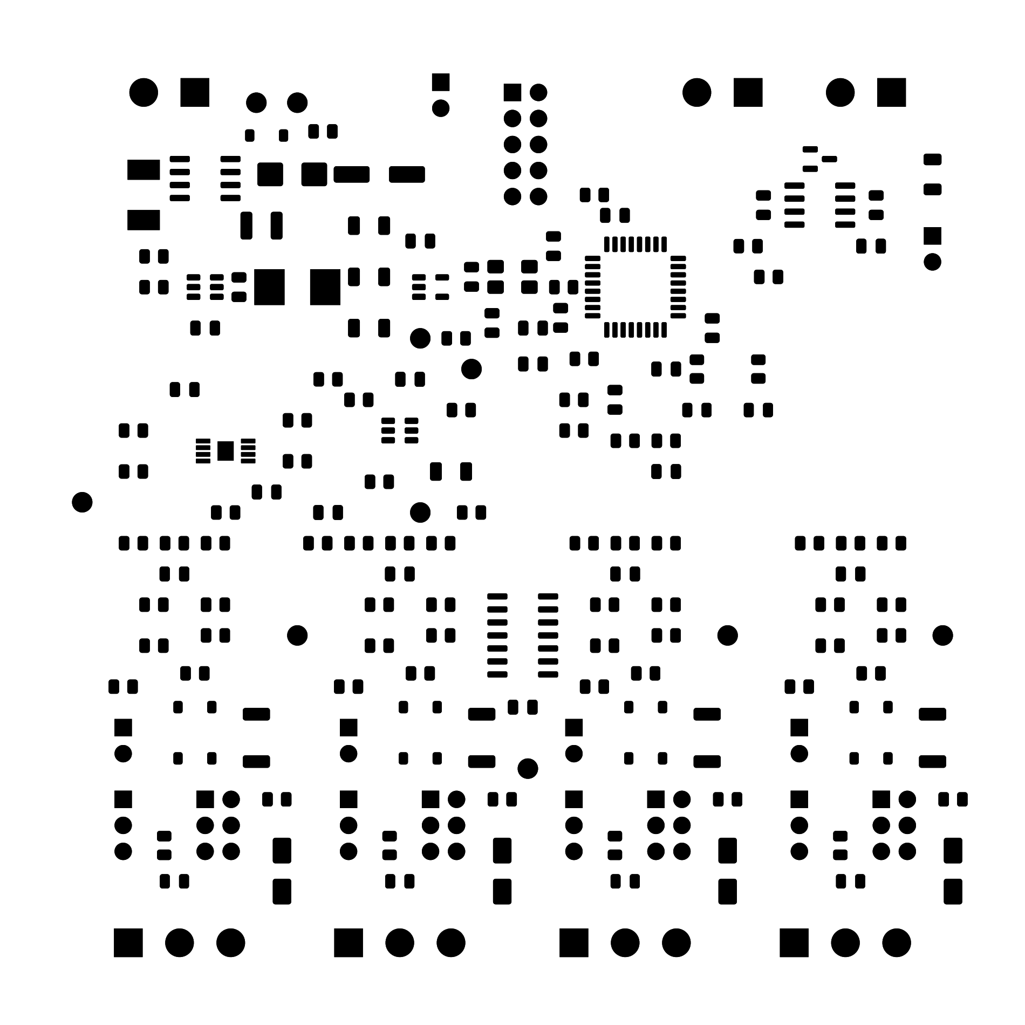
output/review/gerber_top.png
