barkinvar/sugerCANe/output/review/gerber_top_copper.png

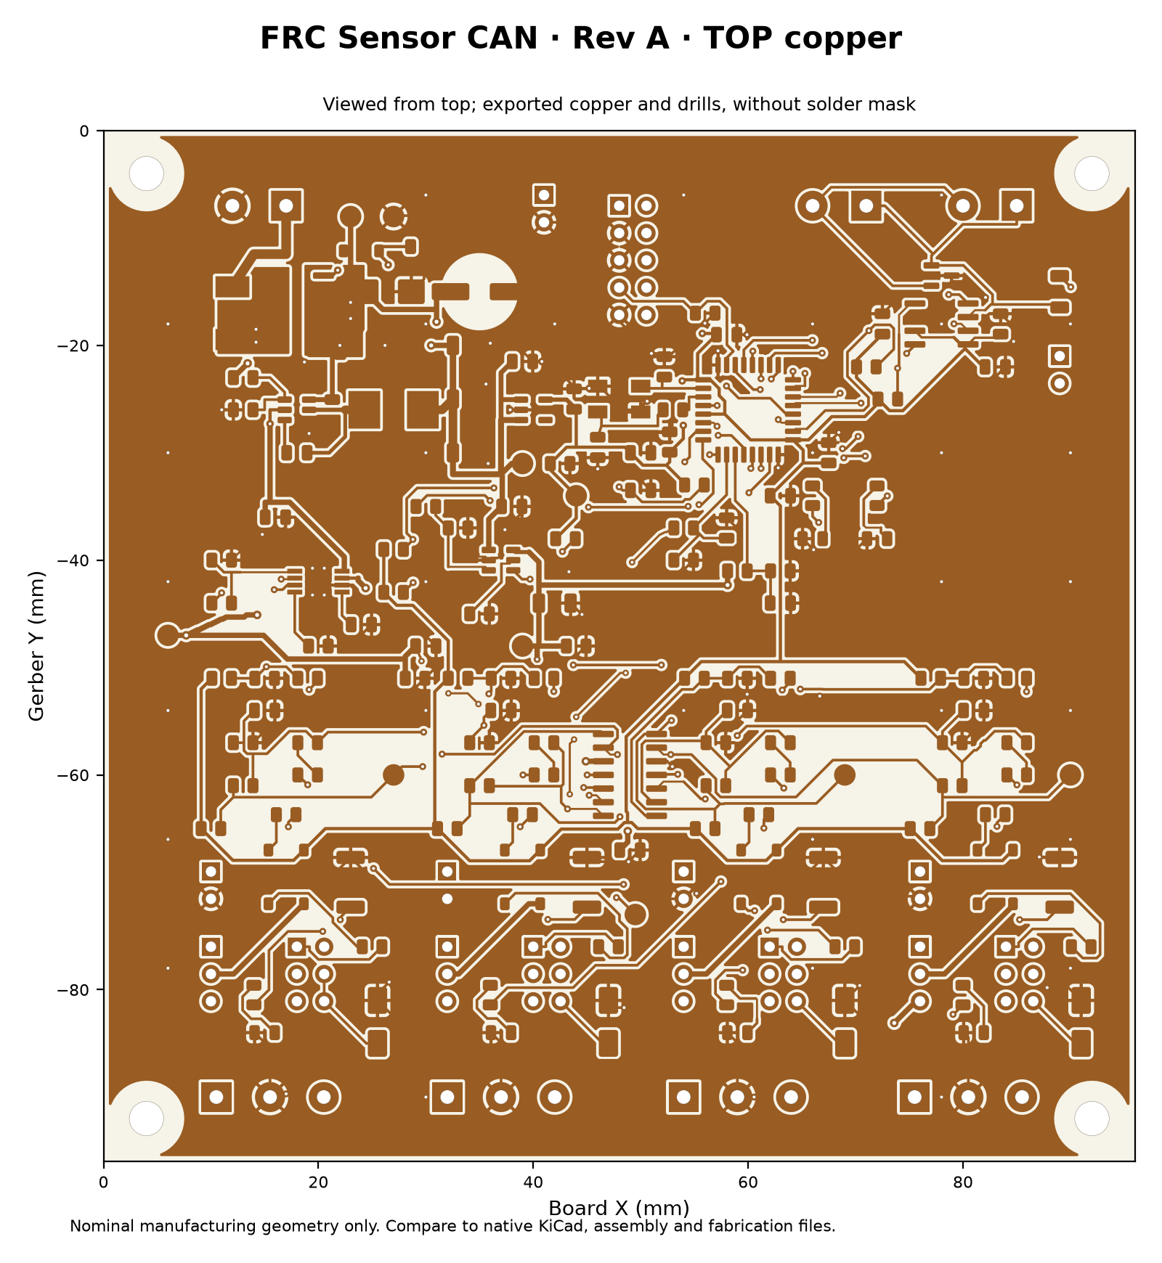
output/review/gerber_top_copper.png
