barkinvar/sugerCANe/output/review/grounded.png

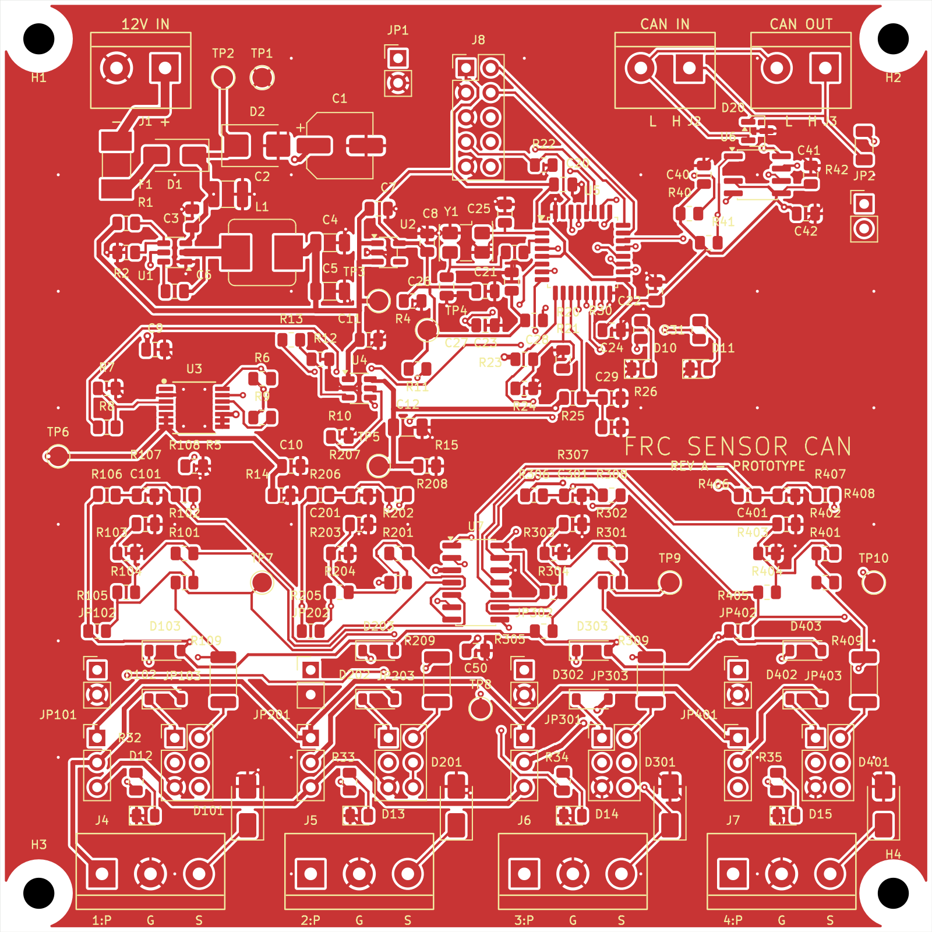
output/review/grounded.png
