barkinvar/sugerCANe/output/review/handbook-01.png

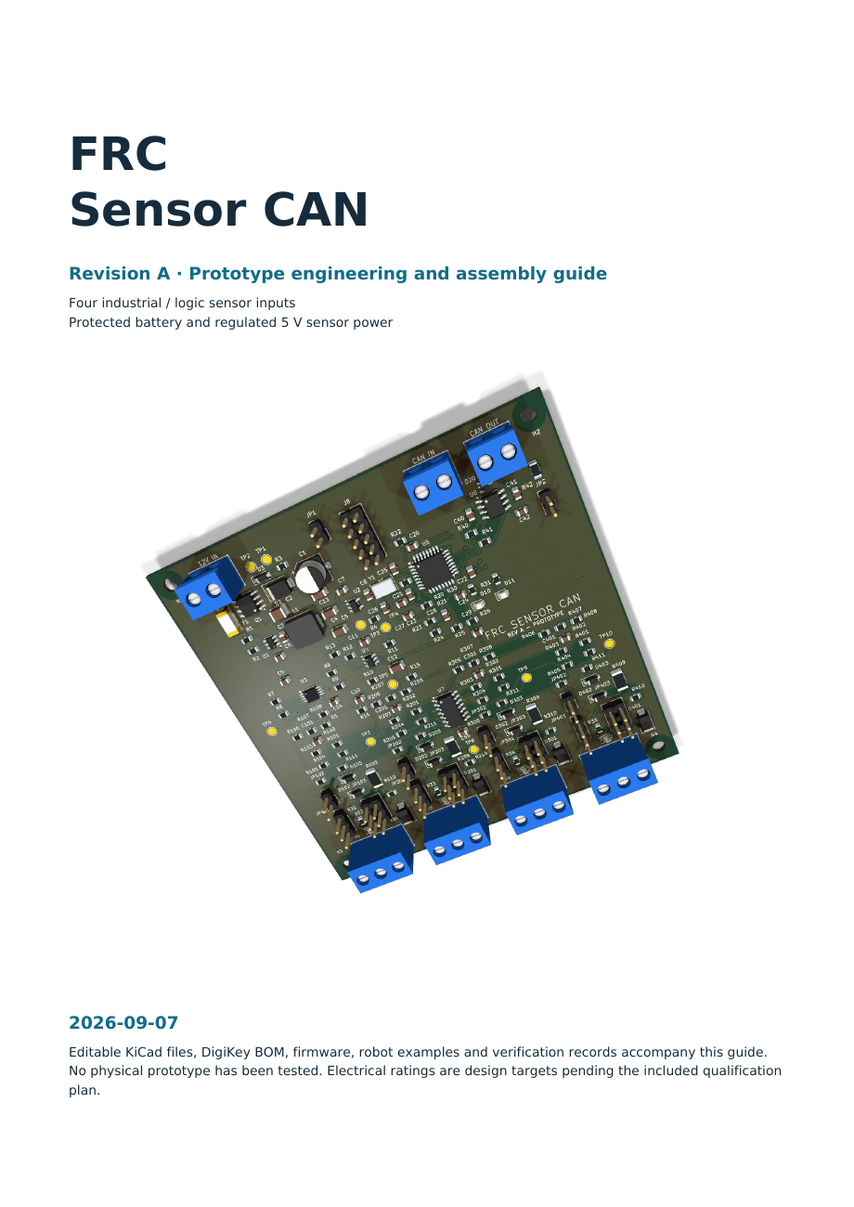
output/review/handbook-01.png
