barkinvar/sugerCANe/output/review/handbook-03.png

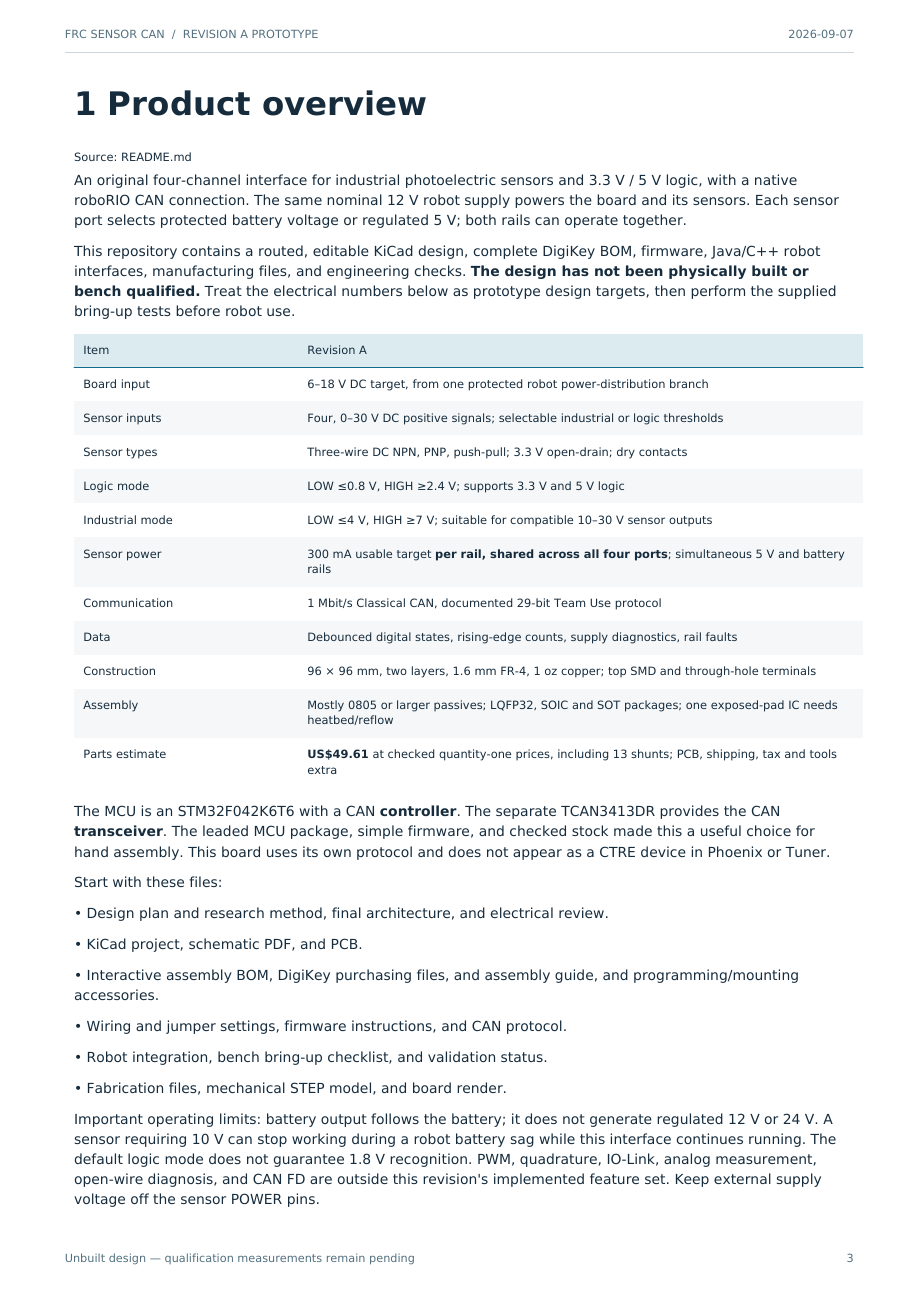
output/review/handbook-03.png
