barkinvar/sugerCANe/output/review/handbook_contact_1.png

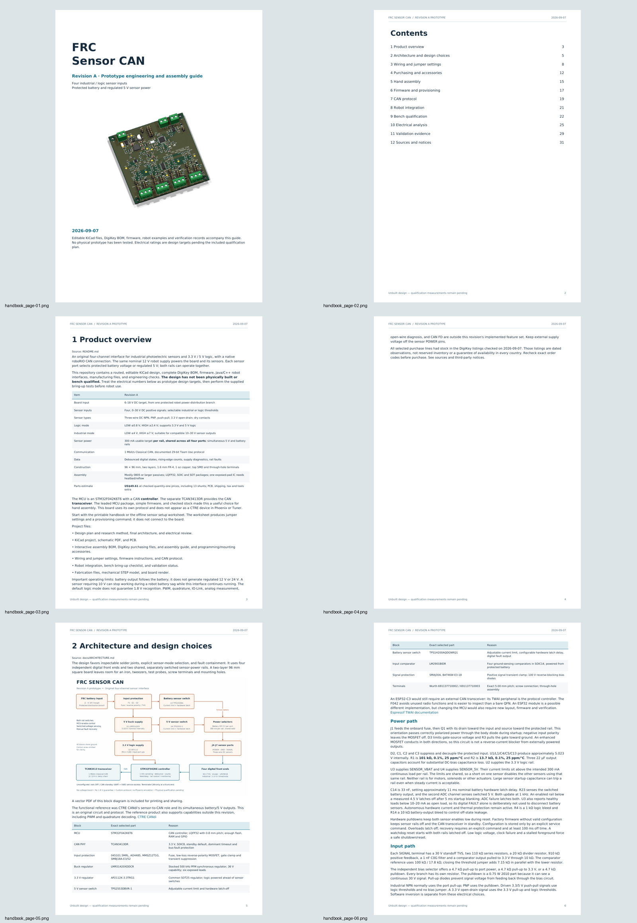
output/review/handbook_contact_1.png
