barkinvar/sugerCANe/output/review/handbook_contact_2.png

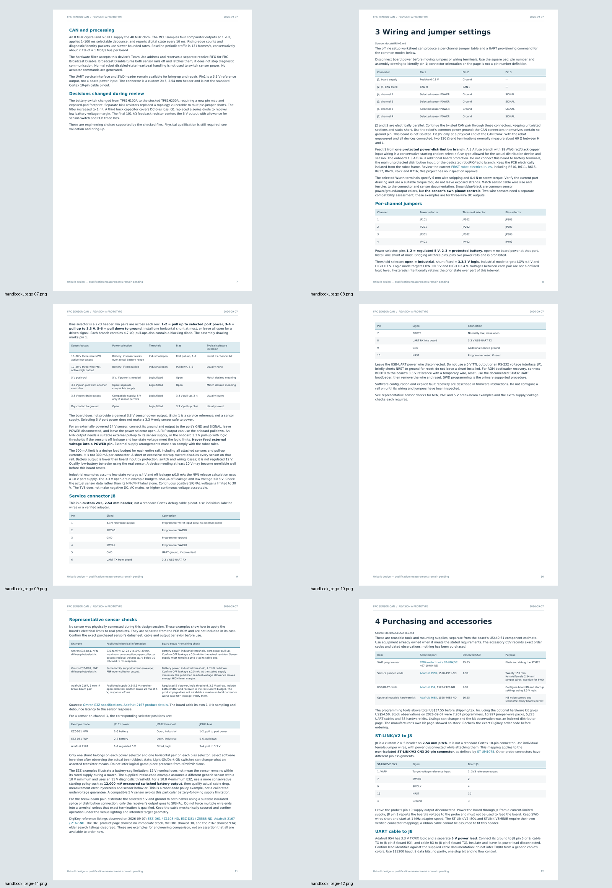
output/review/handbook_contact_2.png
