barkinvar/sugerCANe/output/review/handbook_contact_3.png

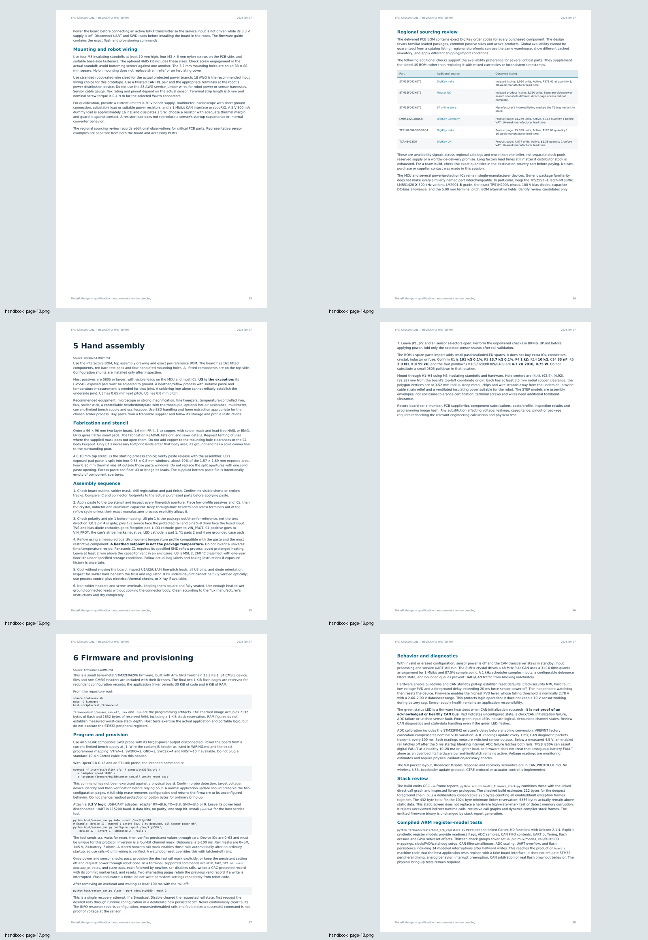
output/review/handbook_contact_3.png
