barkinvar/sugerCANe/output/review/handbook_contact_4.png

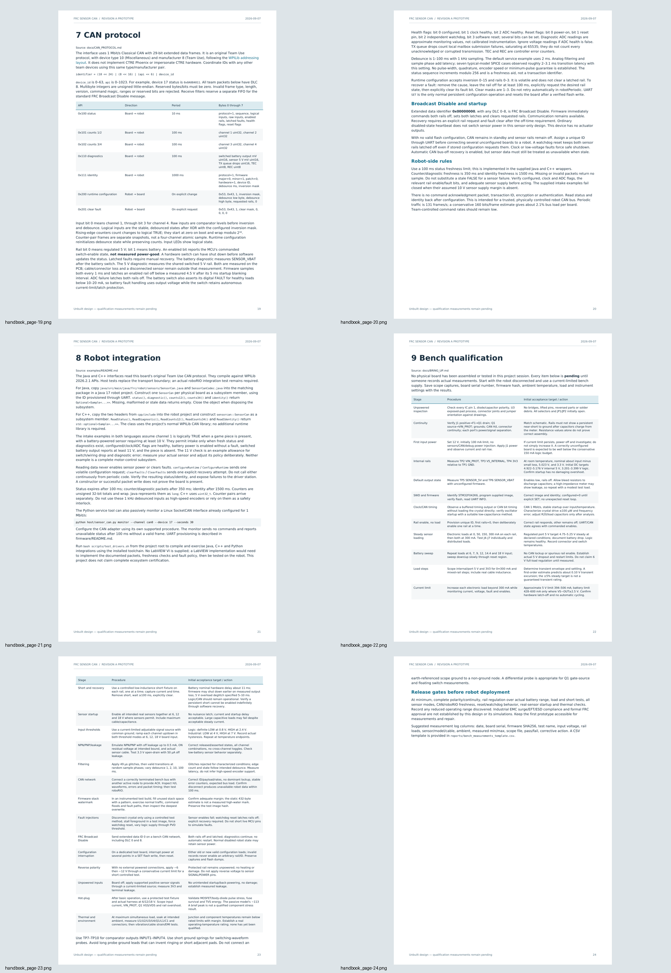
output/review/handbook_contact_4.png
