barkinvar/sugerCANe/output/review/handbook_contact_5.png

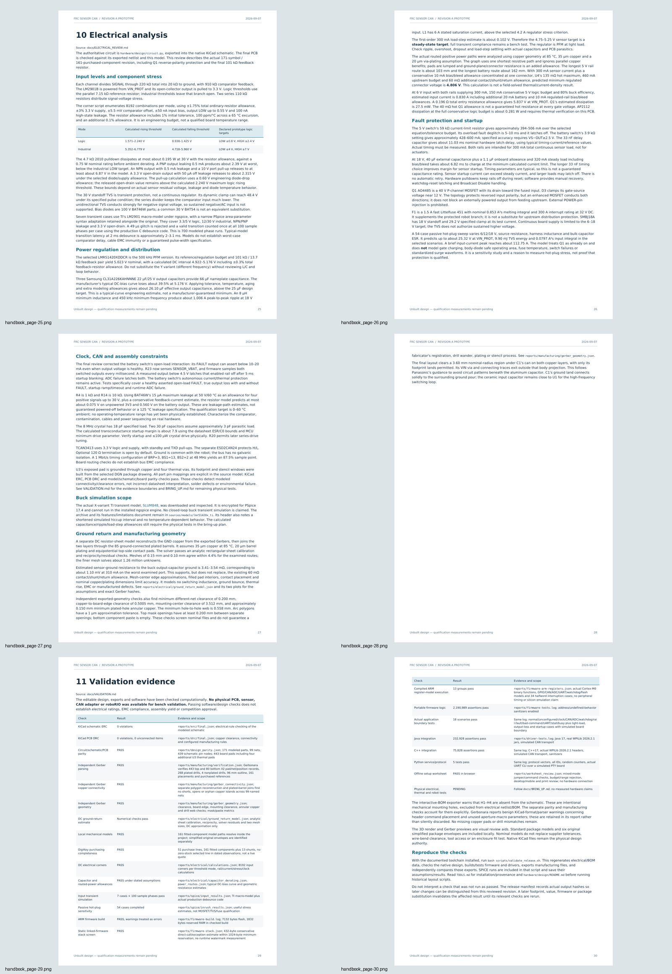
output/review/handbook_contact_5.png
