barkinvar/sugerCANe/output/review/handbook_page-07.png

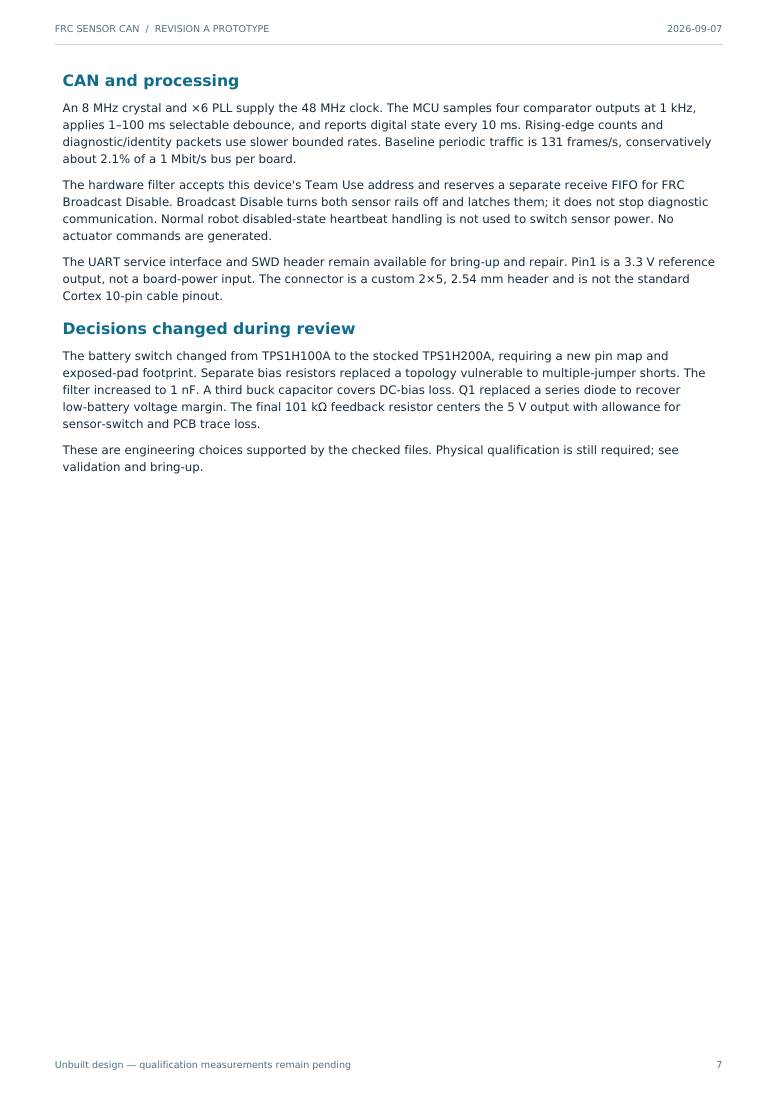
output/review/handbook_page-07.png
