barkinvar/sugerCANe/output/review/handbook_page-09.png

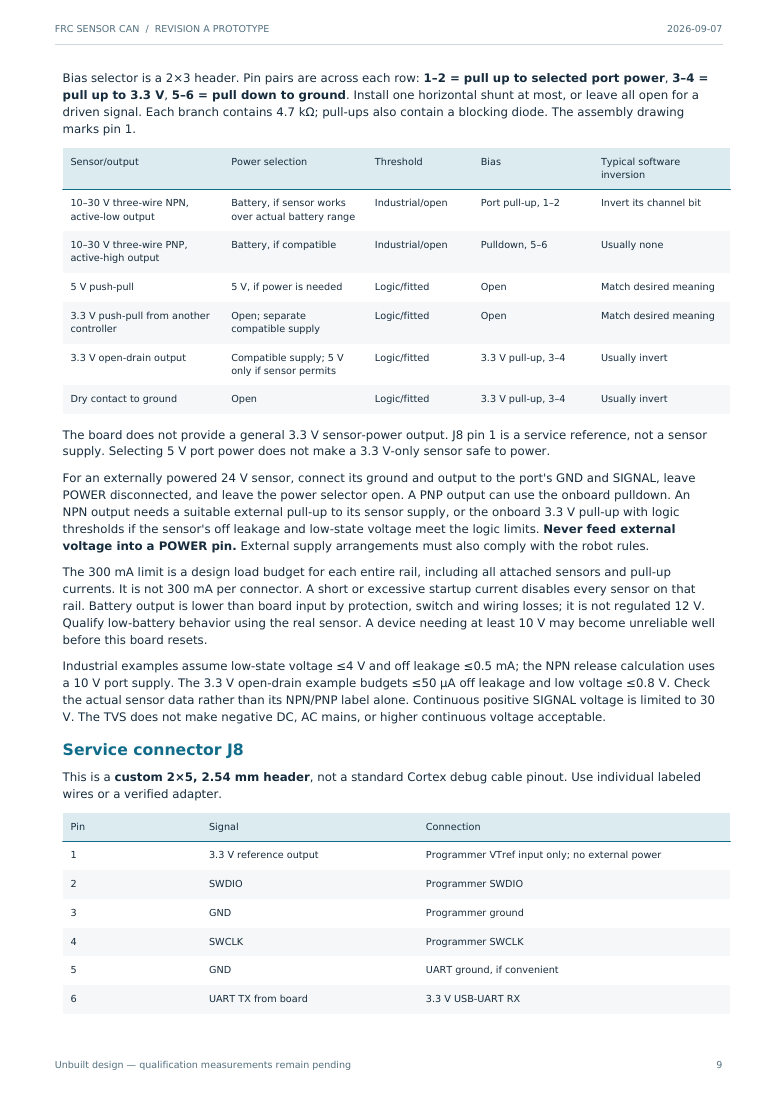
output/review/handbook_page-09.png
