barkinvar/sugerCANe/output/review/handbook_page-11.png

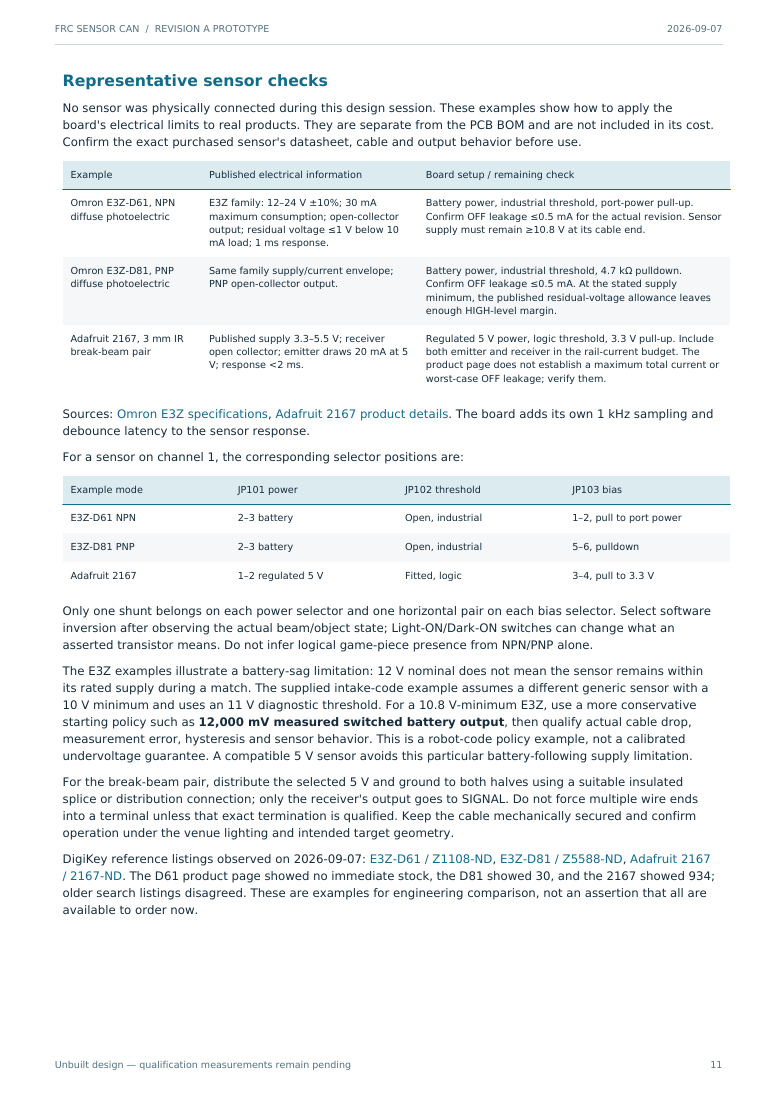
output/review/handbook_page-11.png
