barkinvar/sugerCANe/output/review/handbook_page-12.png

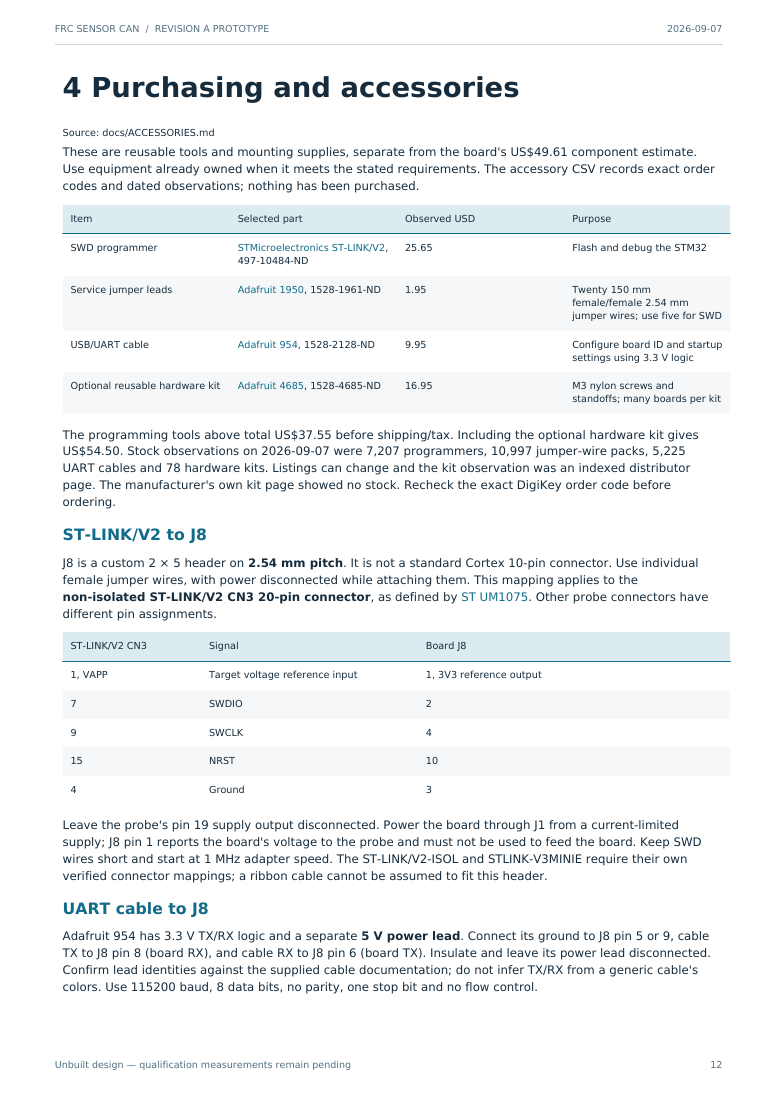
output/review/handbook_page-12.png
