barkinvar/sugerCANe/output/review/handbook_page-14.png

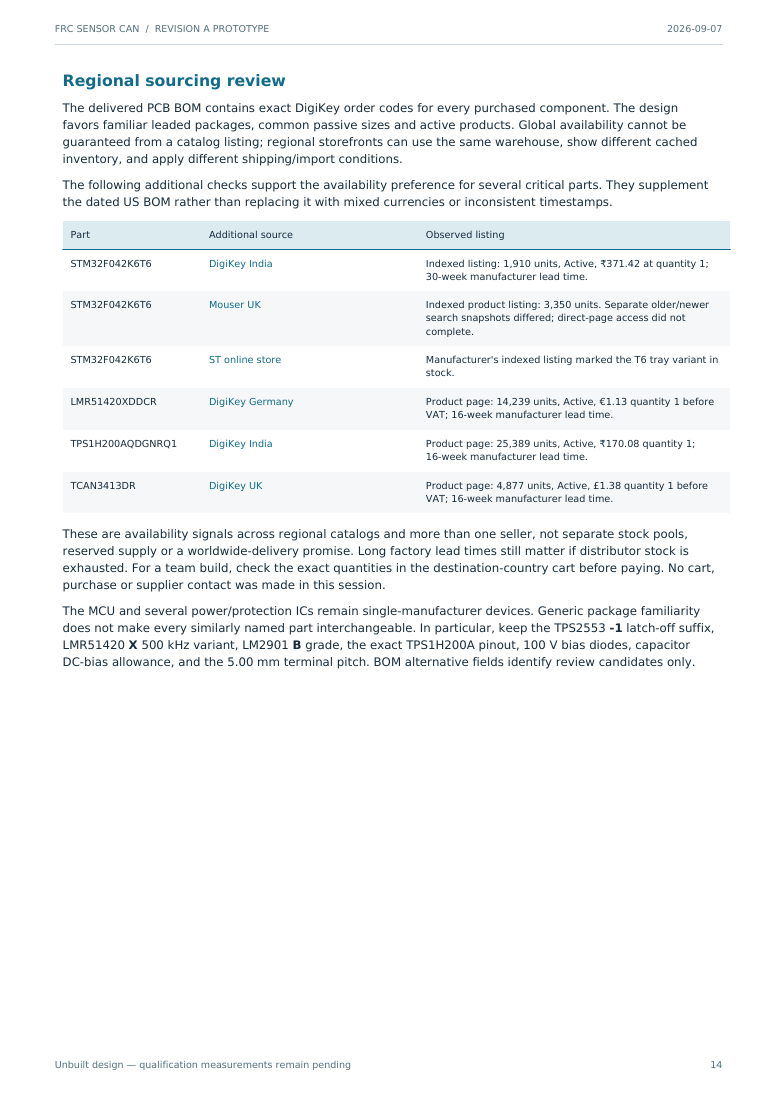
output/review/handbook_page-14.png
