barkinvar/sugerCANe/output/review/handbook_page-15.png

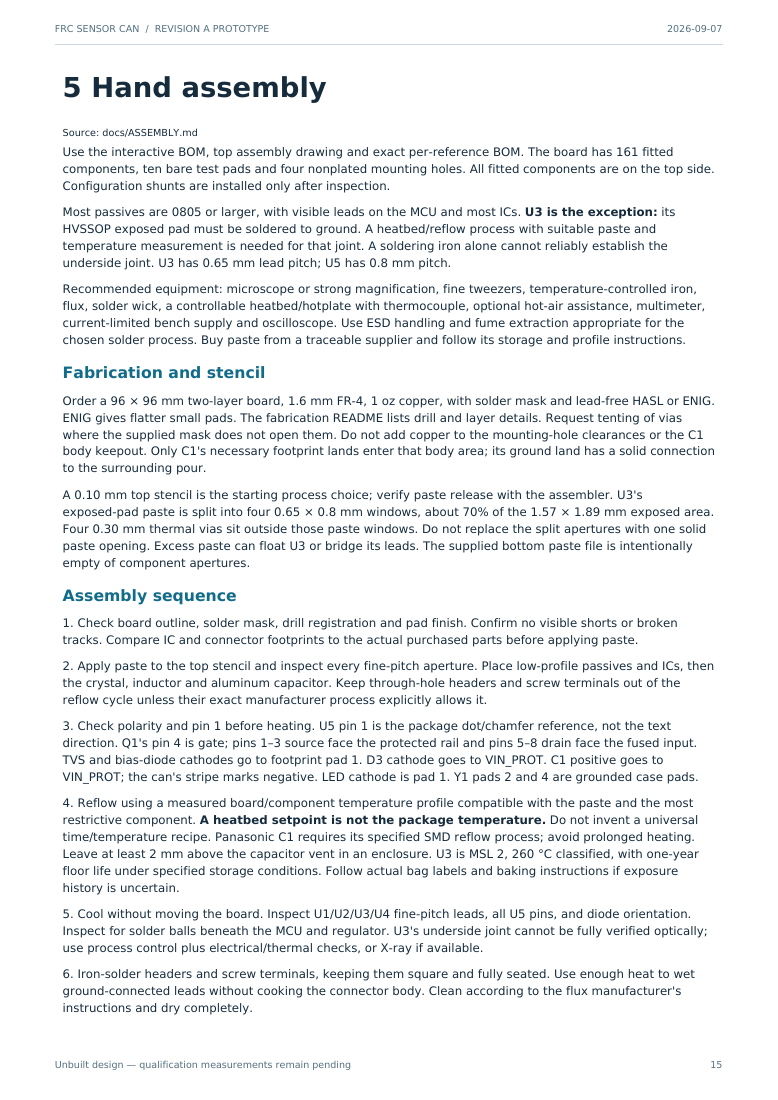
output/review/handbook_page-15.png
