barkinvar/sugerCANe/output/review/handbook_page-16.png

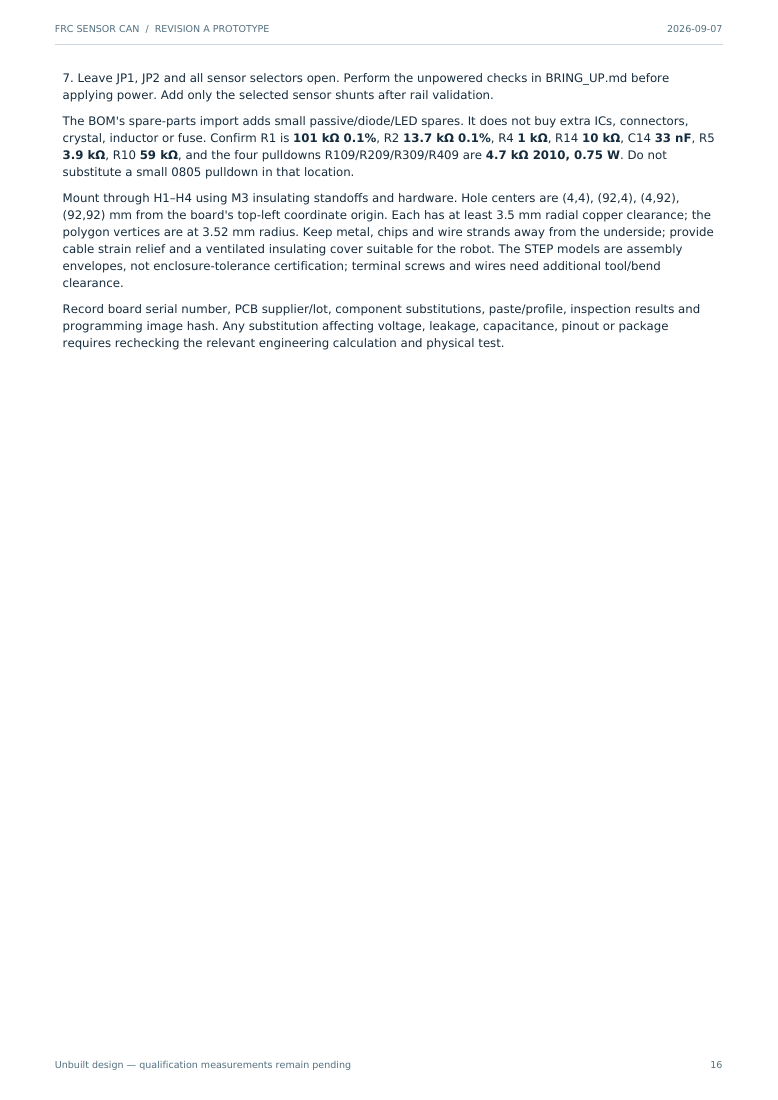
output/review/handbook_page-16.png
