barkinvar/sugerCANe/output/review/handbook_page-17.png

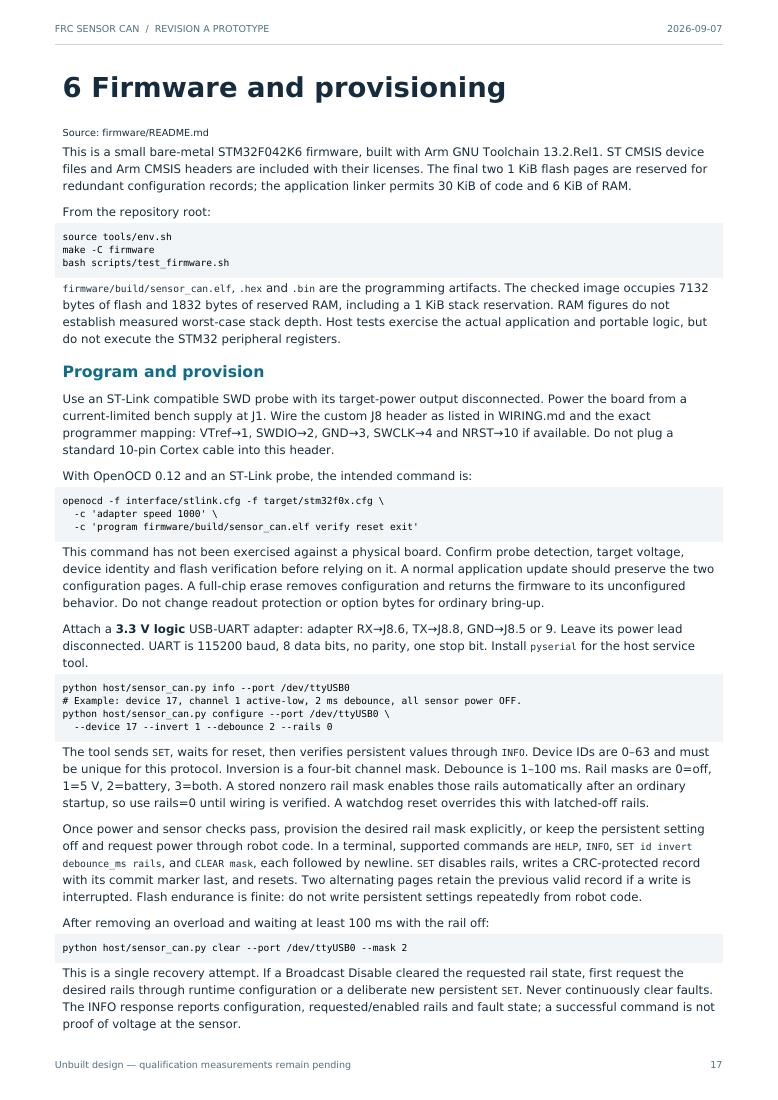
output/review/handbook_page-17.png
