barkinvar/sugerCANe/output/review/handbook_page-18.png

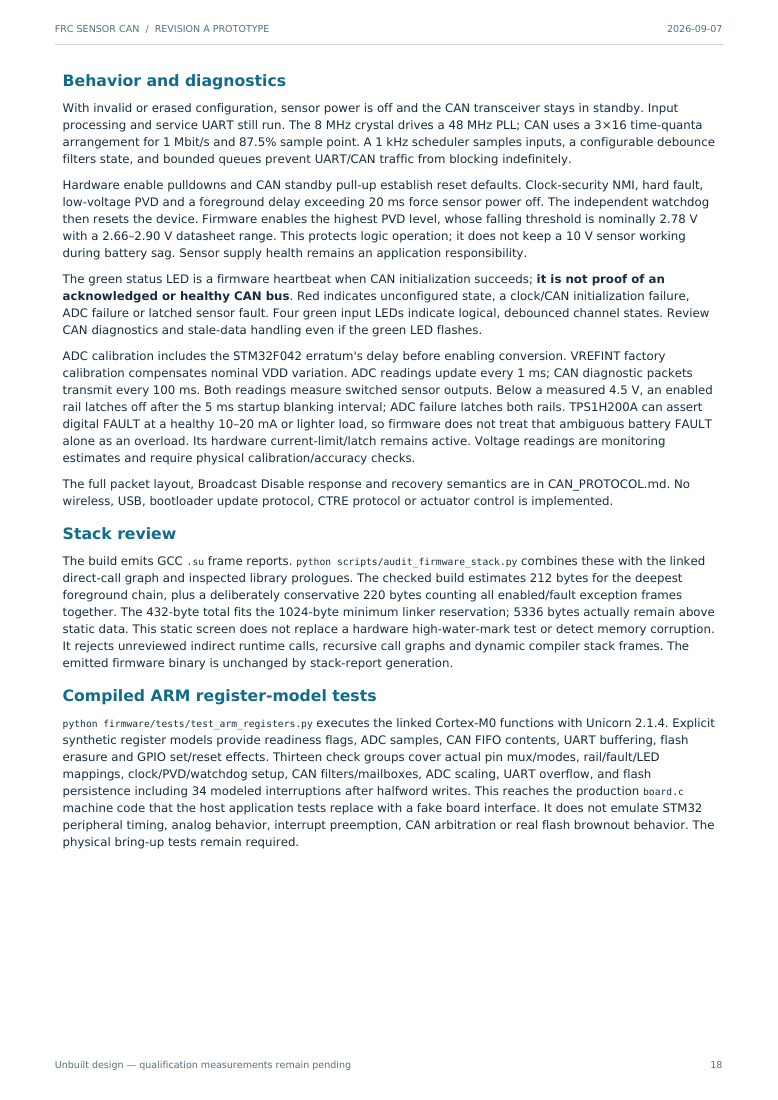
output/review/handbook_page-18.png
