barkinvar/sugerCANe/output/review/handbook_page-19.png

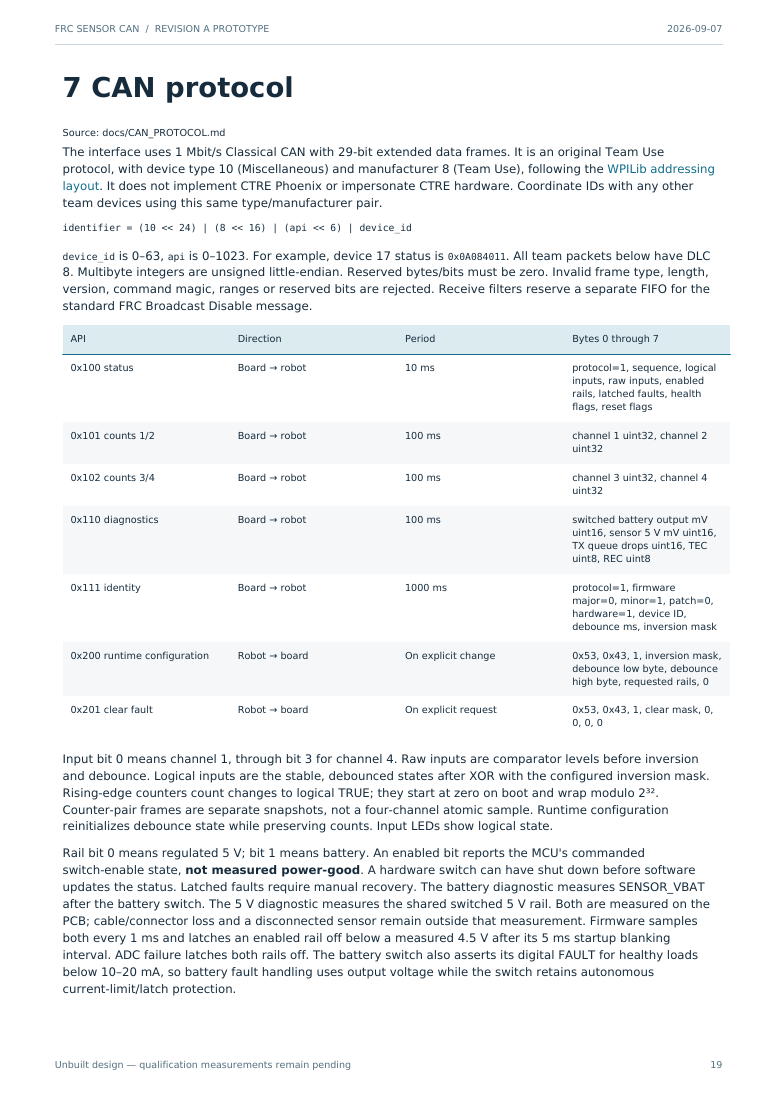
output/review/handbook_page-19.png
