barkinvar/sugerCANe/output/review/handbook_page-20.png

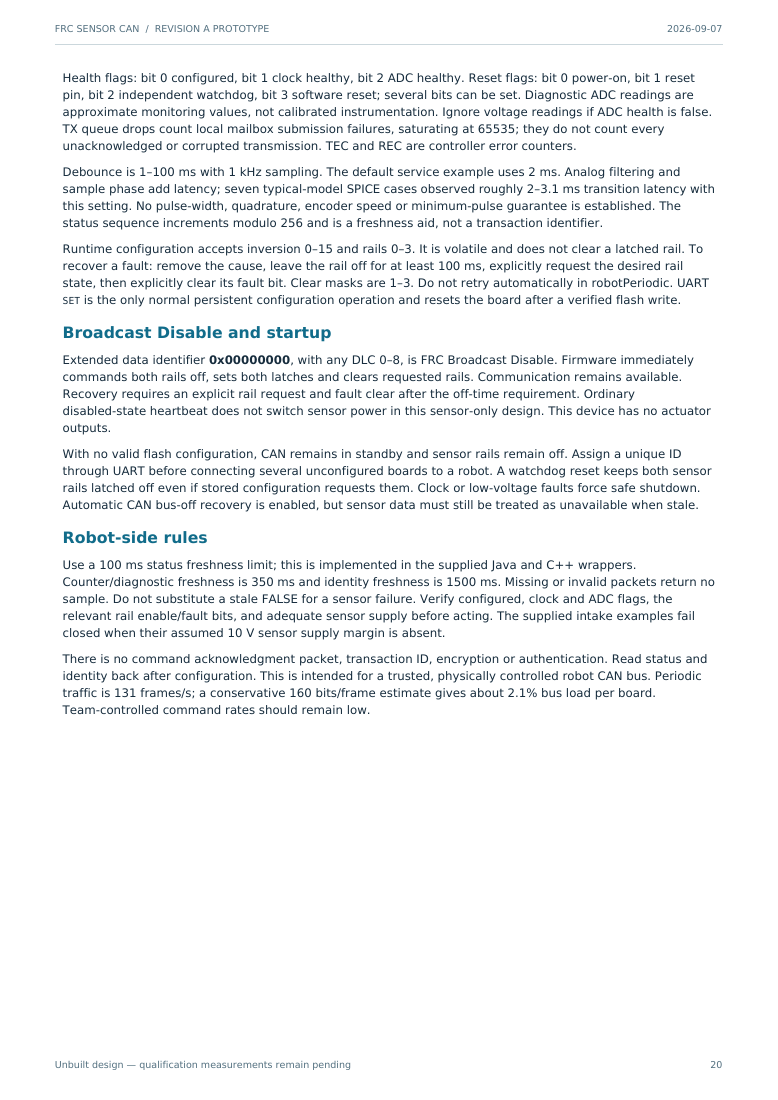
output/review/handbook_page-20.png
