barkinvar/sugerCANe/output/review/handbook_page-21.png

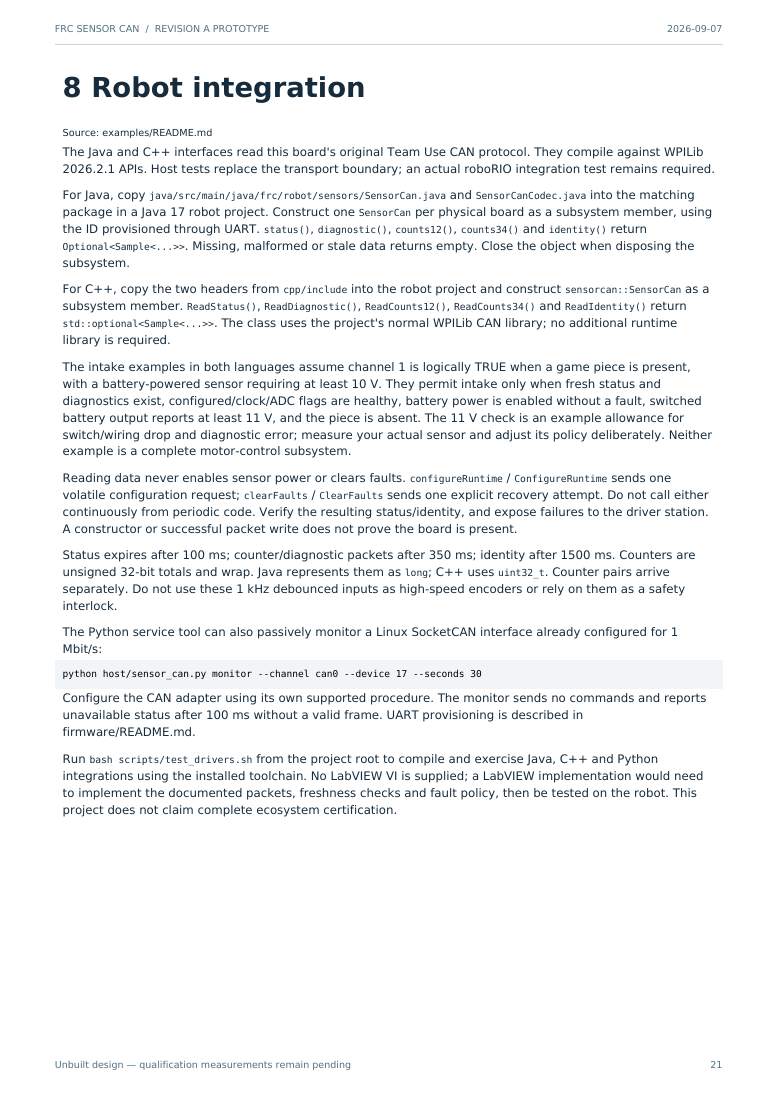
output/review/handbook_page-21.png
