barkinvar/sugerCANe/output/review/handbook_page-25.png

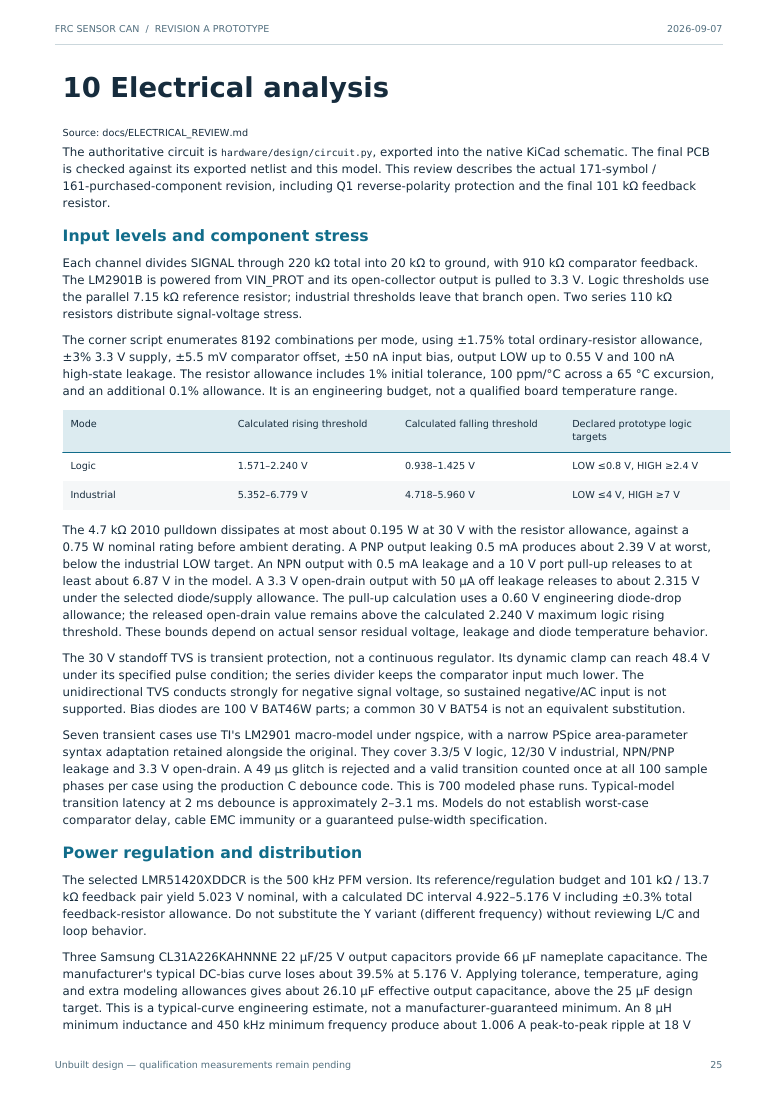
output/review/handbook_page-25.png
