barkinvar/sugerCANe/output/review/handbook_page-26.png

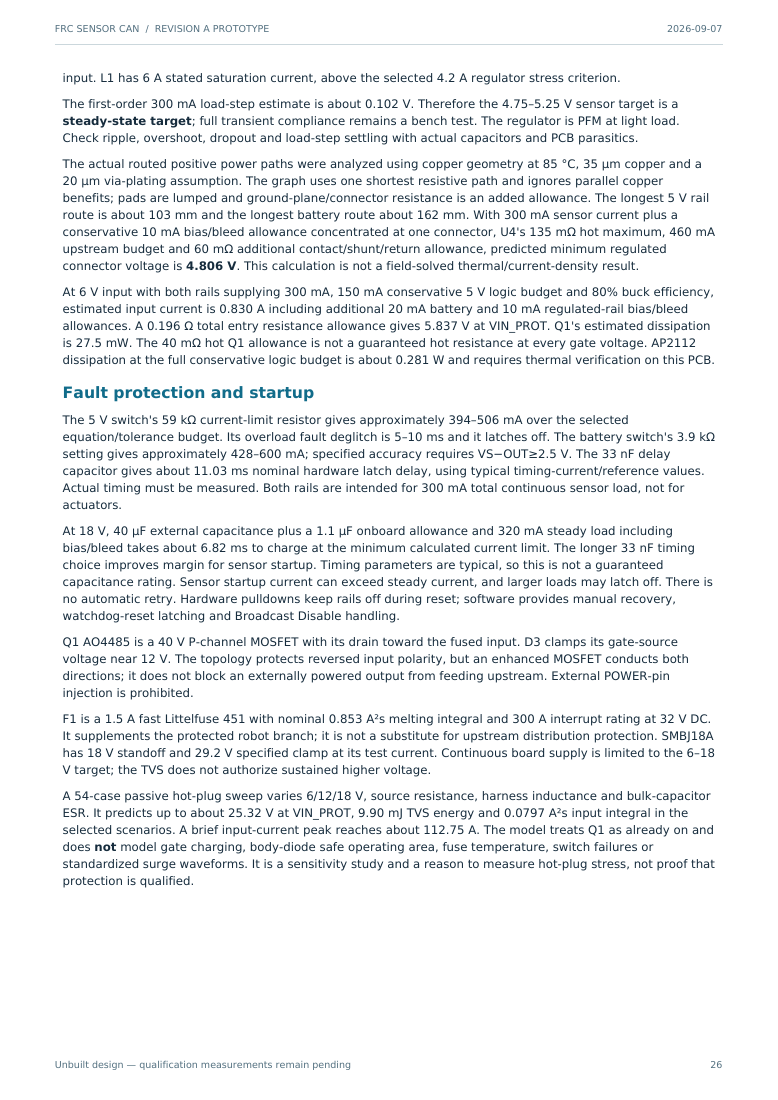
output/review/handbook_page-26.png
