barkinvar/sugerCANe/output/review/handbook_page-27.png

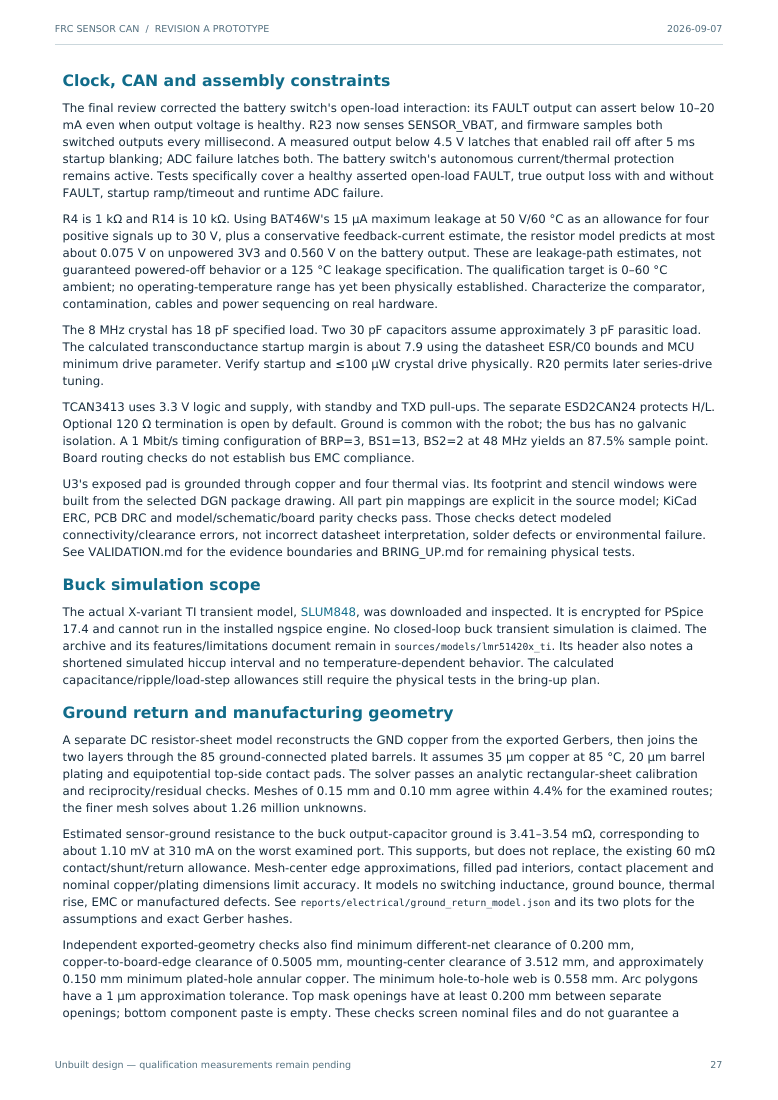
output/review/handbook_page-27.png
