barkinvar/sugerCANe/output/review/handbook_page-28.png

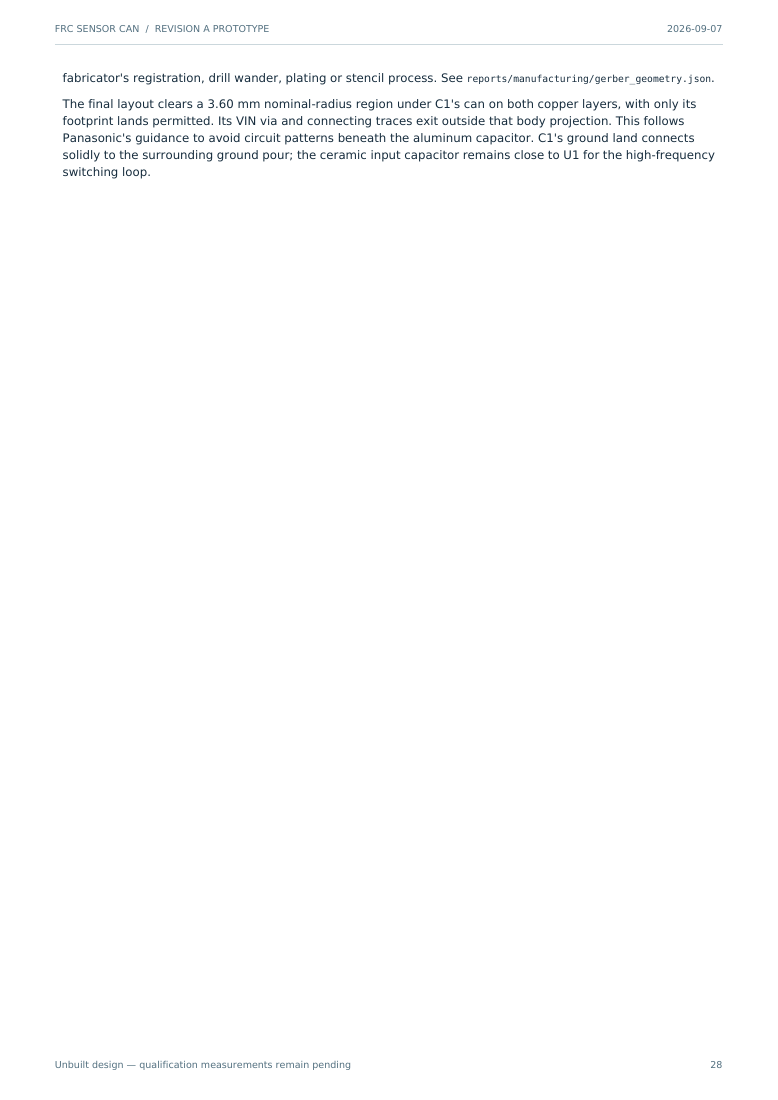
output/review/handbook_page-28.png
