barkinvar/sugerCANe/output/review/handbook_page-29.png

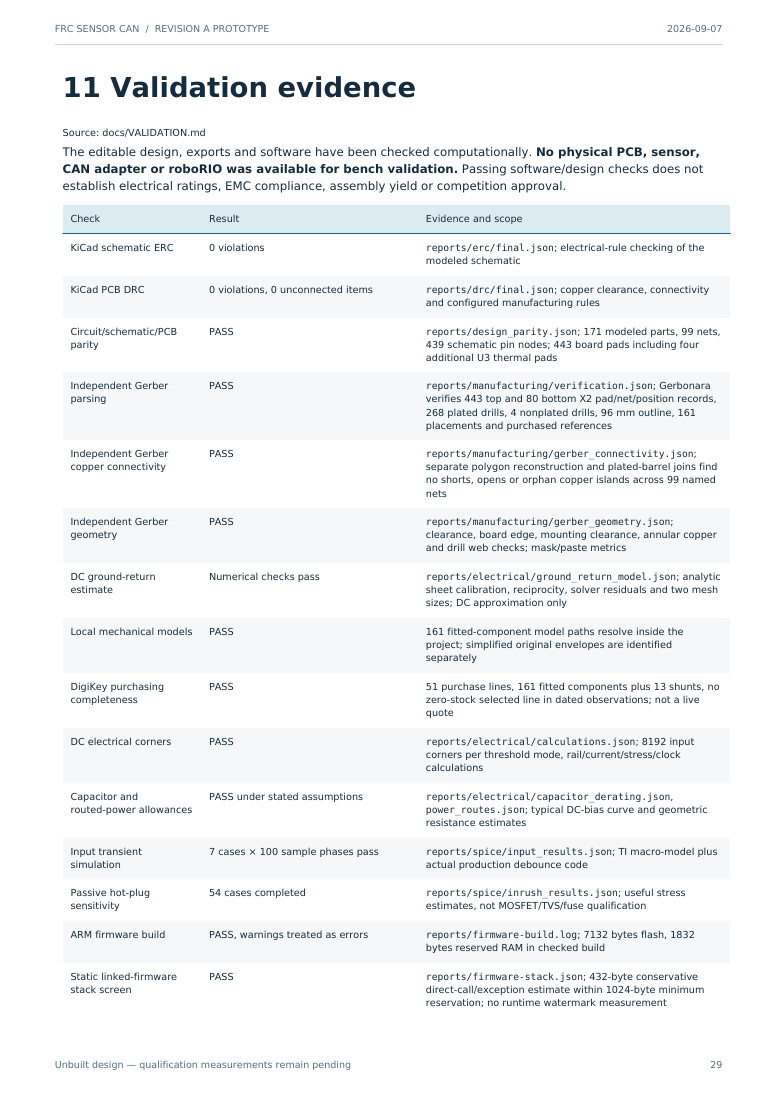
output/review/handbook_page-29.png
