barkinvar/sugerCANe/output/review/handbook_page-30.png

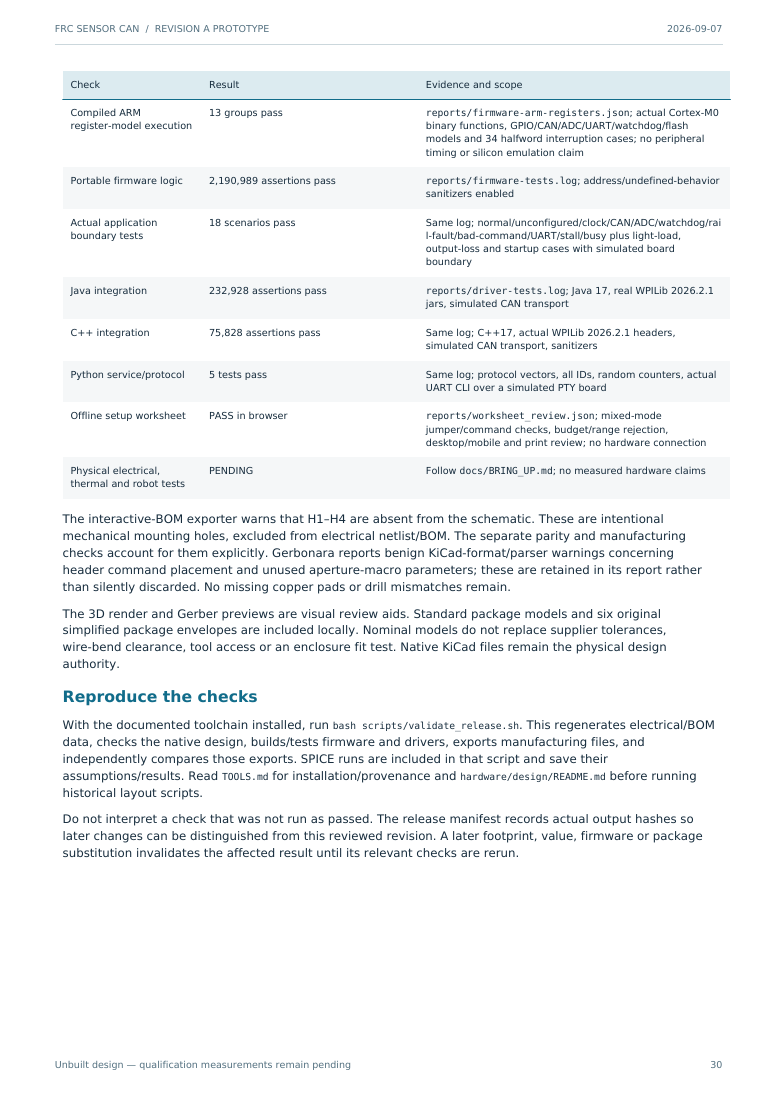
output/review/handbook_page-30.png
