barkinvar/sugerCANe/output/review/input_final.png

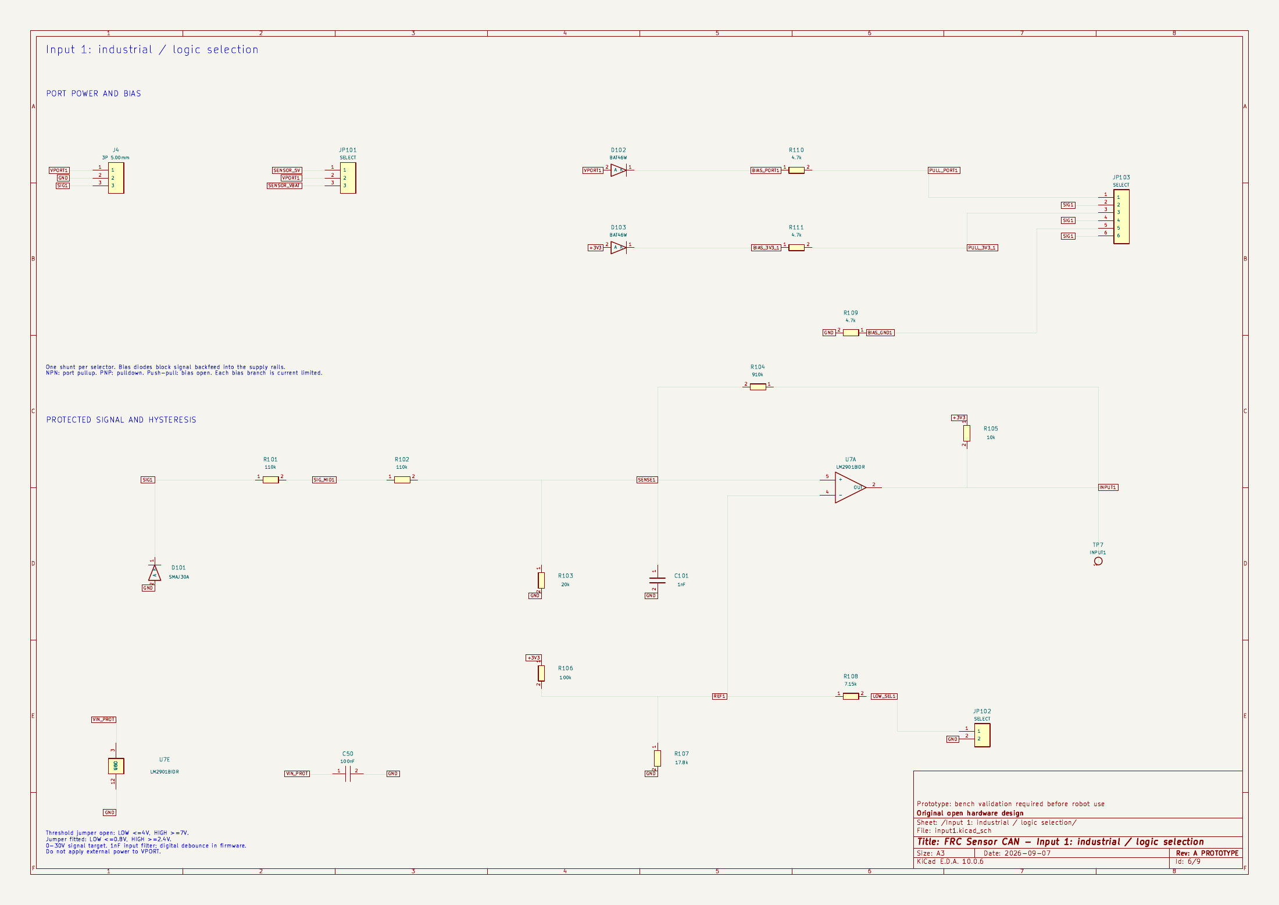
output/review/input_final.png
