barkinvar/sugerCANe/output/review/kicad_gui_initial.png

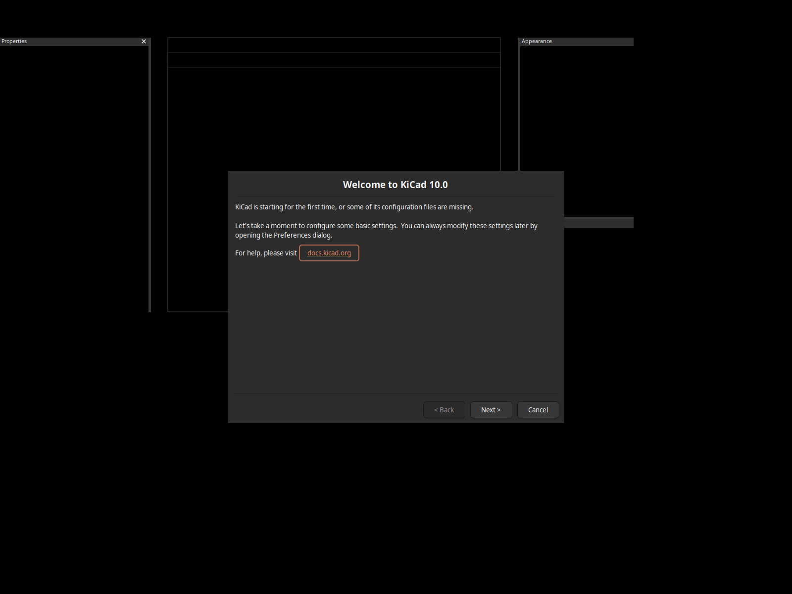
output/review/kicad_gui_initial.png
