barkinvar/sugerCANe/output/review/kicad_gui_open.png

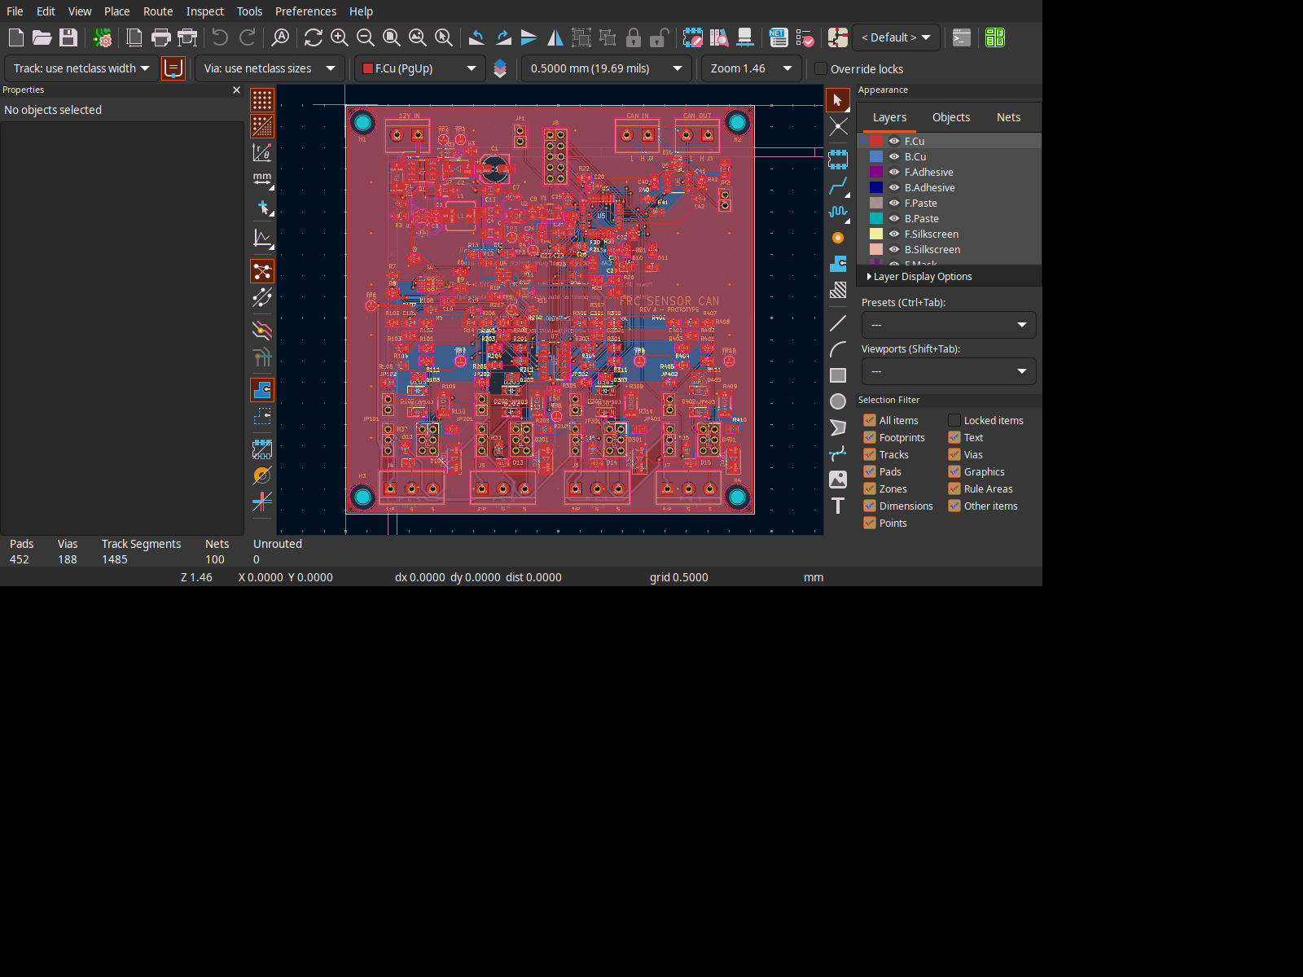
output/review/kicad_gui_open.png
