barkinvar/sugerCANe/output/review/mounting_template.png

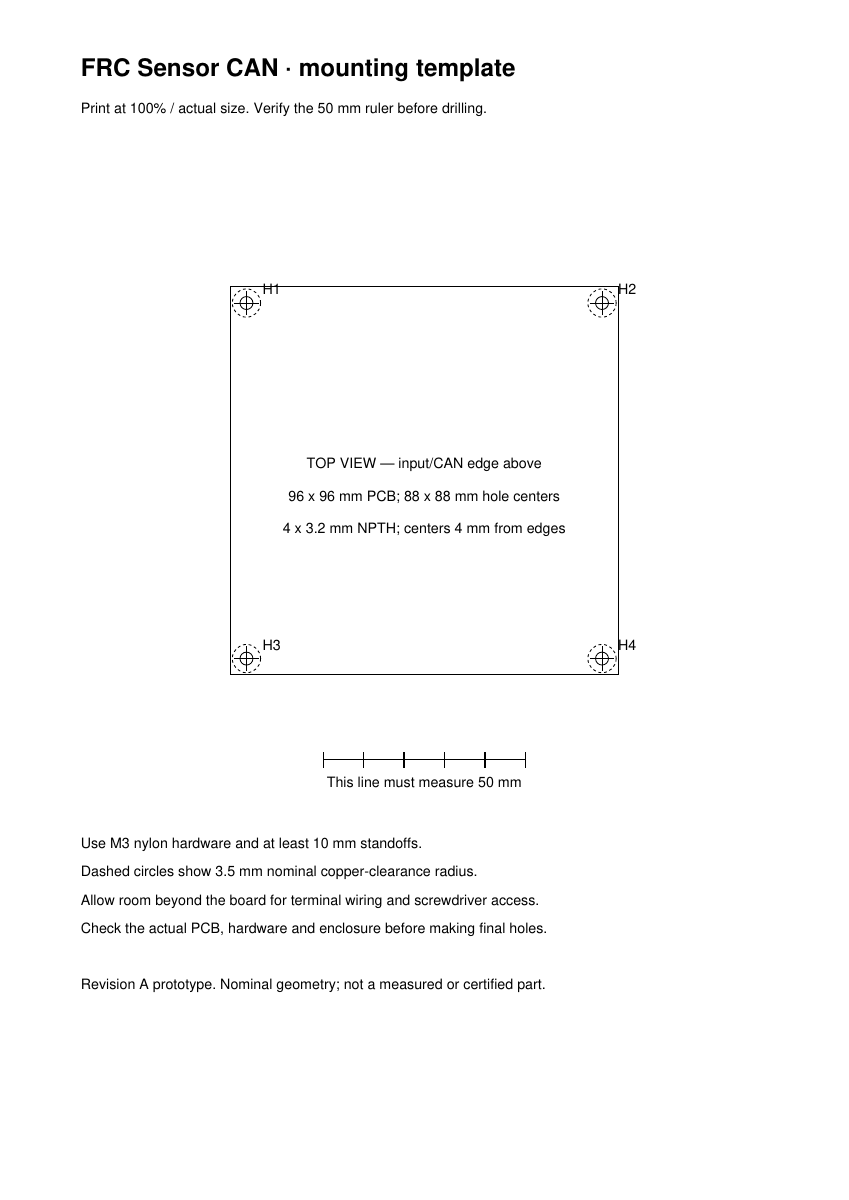
output/review/mounting_template.png
