barkinvar/sugerCANe/output/review/power.png

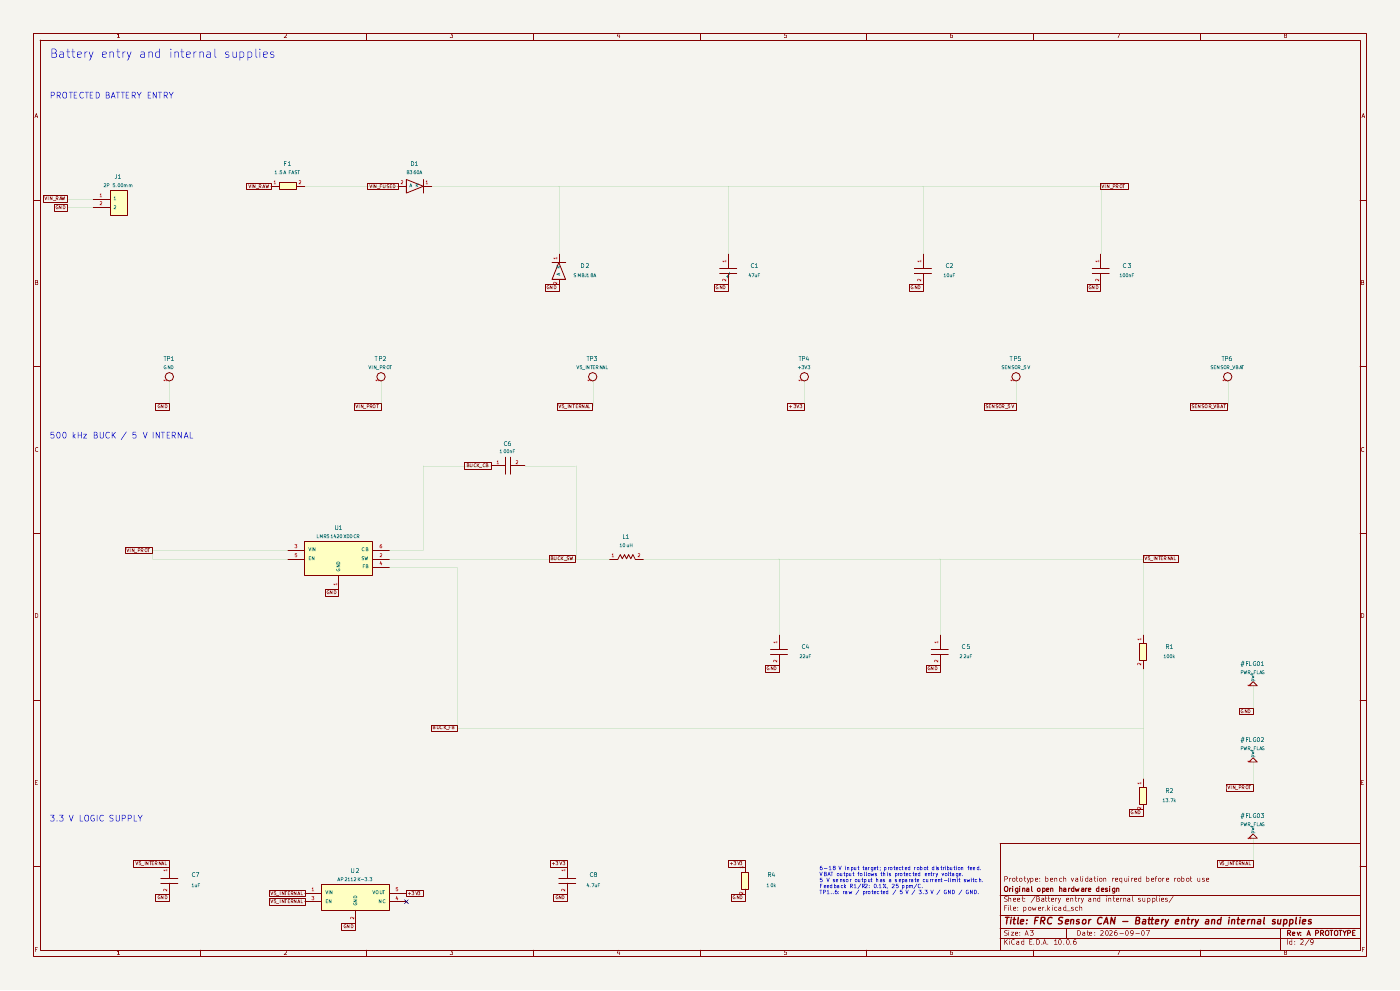
output/review/power.png
