barkinvar/sugerCANe/output/review/release_handbook_contact_3.png

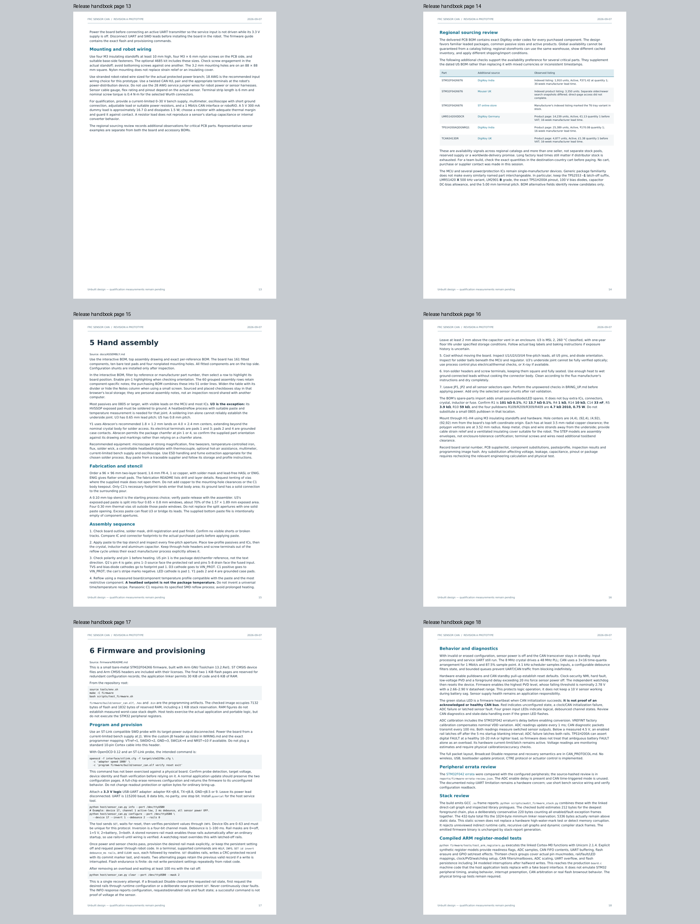
output/review/release_handbook_contact_3.png
