barkinvar/sugerCANe/output/review/release_handbook_contact_6.png

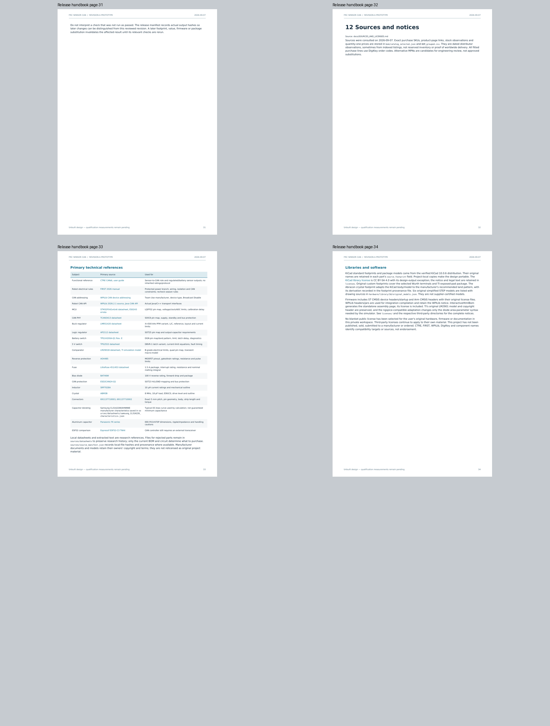
output/review/release_handbook_contact_6.png
