barkinvar/sugerCANe/output/review/release_handbook_page-09.png

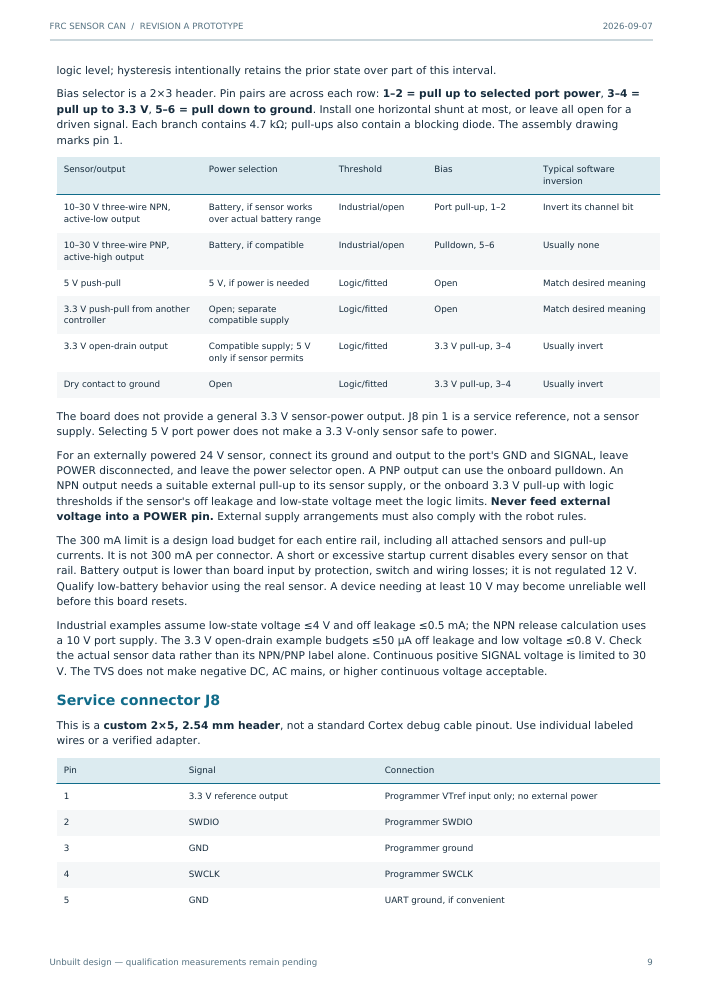
output/review/release_handbook_page-09.png
