barkinvar/sugerCANe/output/review/release_handbook_page-15.png

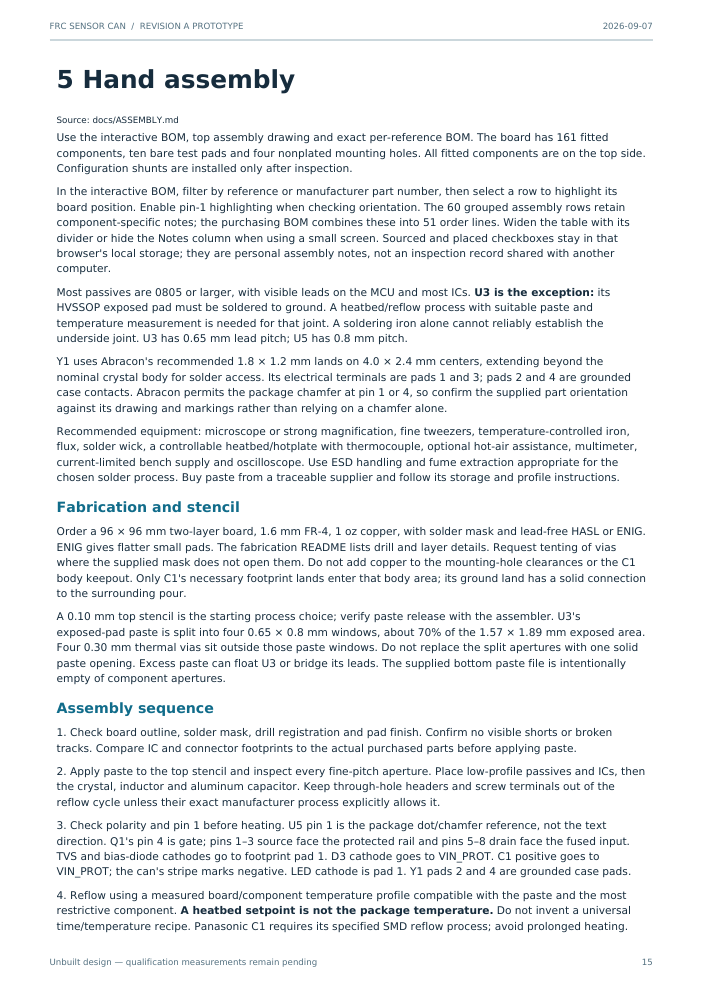
output/review/release_handbook_page-15.png
