barkinvar/sugerCANe/output/review/release_handbook_page-16.png

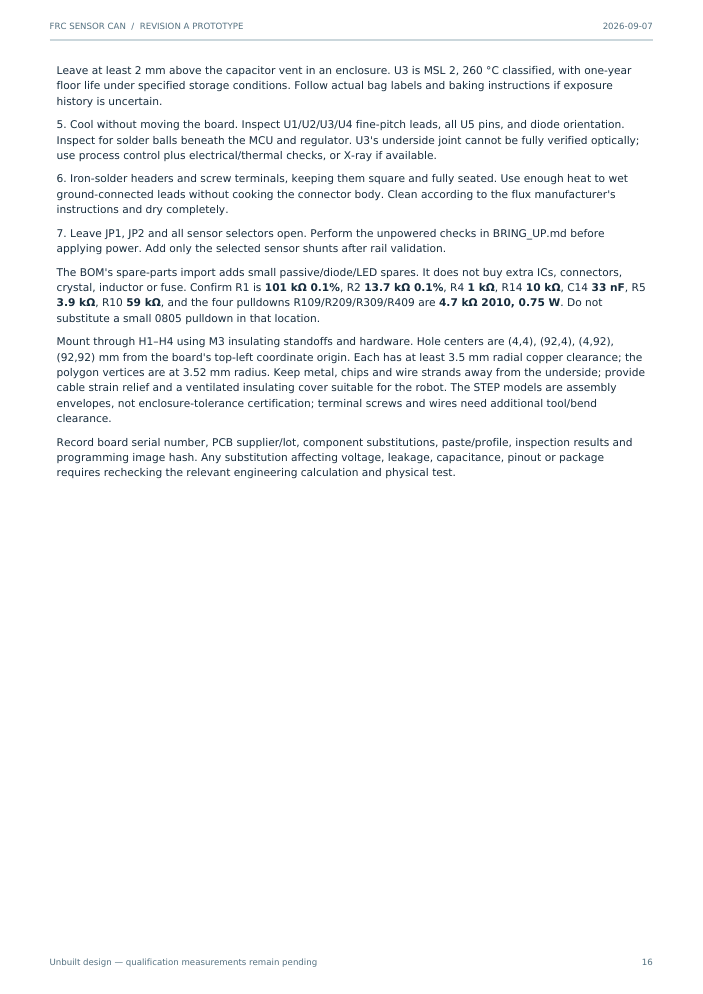
output/review/release_handbook_page-16.png
