barkinvar/sugerCANe/output/review/release_handbook_page-18.png

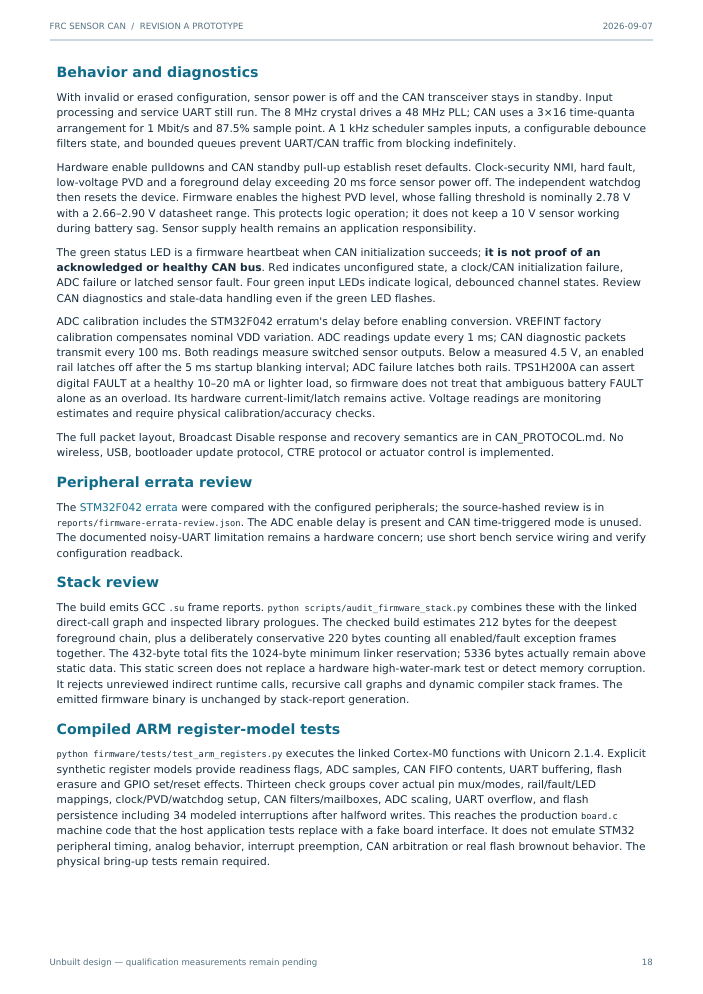
output/review/release_handbook_page-18.png
