barkinvar/sugerCANe/output/review/release_handbook_page-26.png

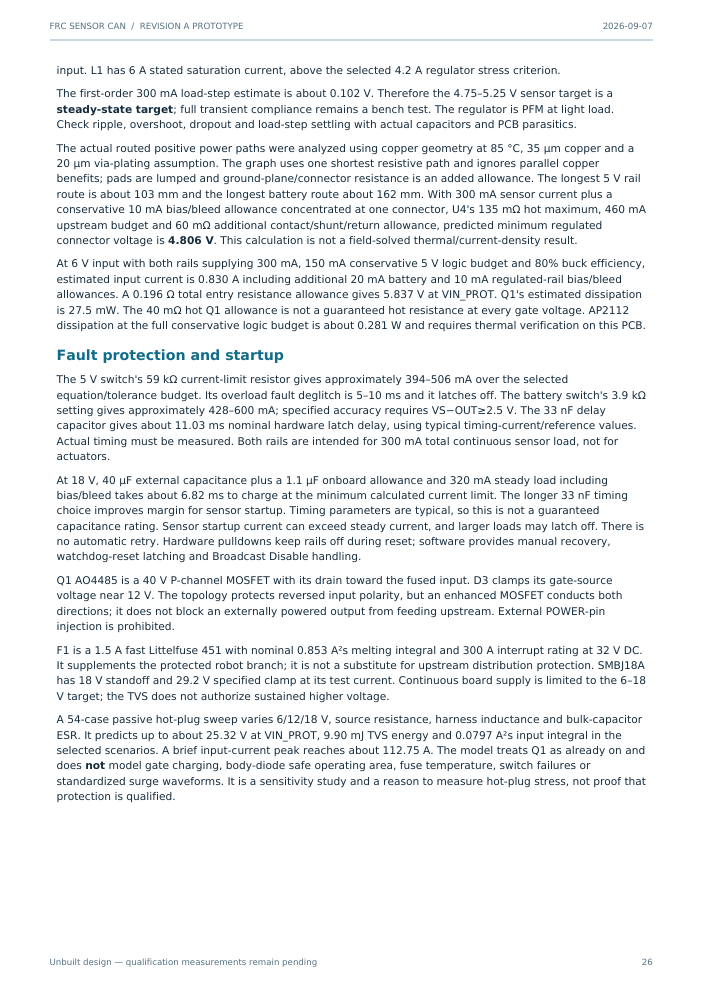
output/review/release_handbook_page-26.png
