barkinvar/sugerCANe/output/review/release_handbook_page-27.png

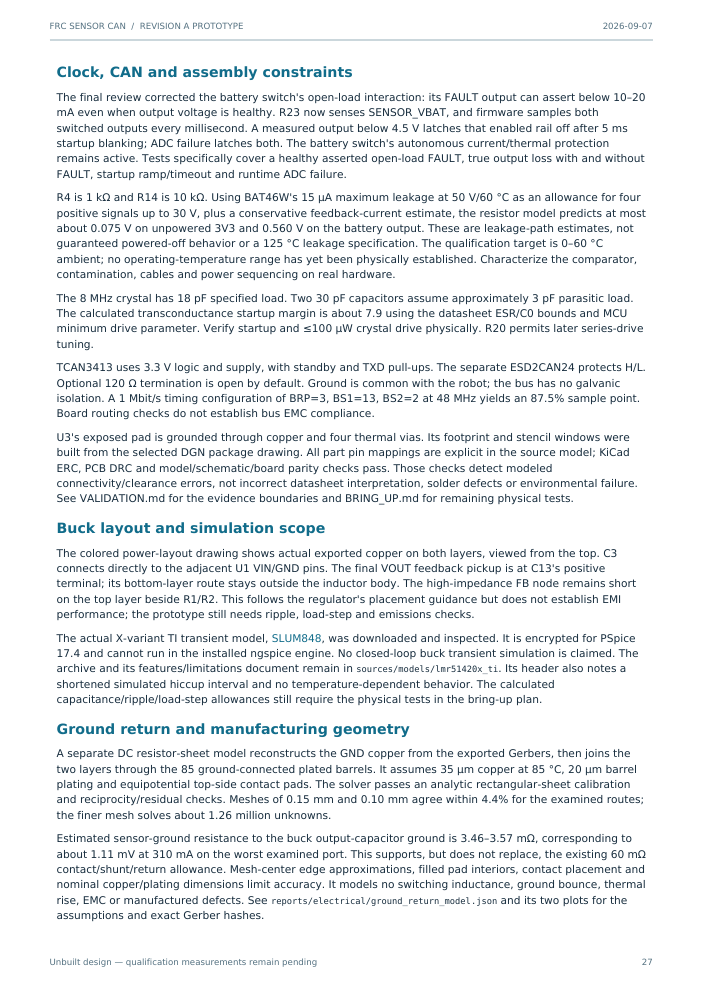
output/review/release_handbook_page-27.png
