barkinvar/sugerCANe/output/review/release_handbook_page-28.png

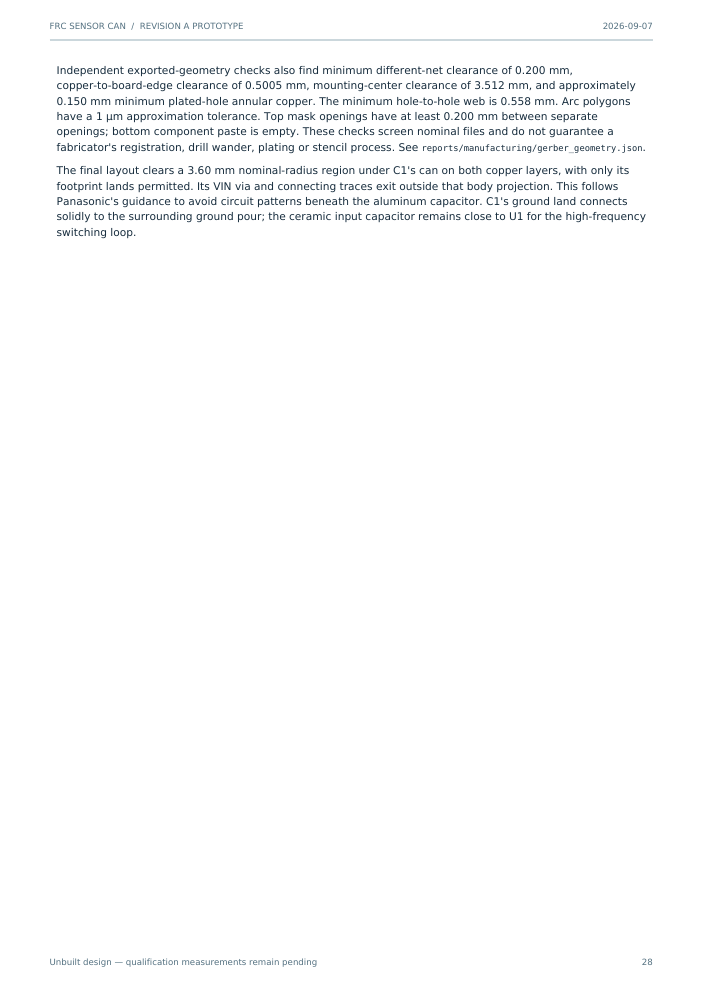
output/review/release_handbook_page-28.png
