barkinvar/sugerCANe/output/review/release_handbook_page-29.png

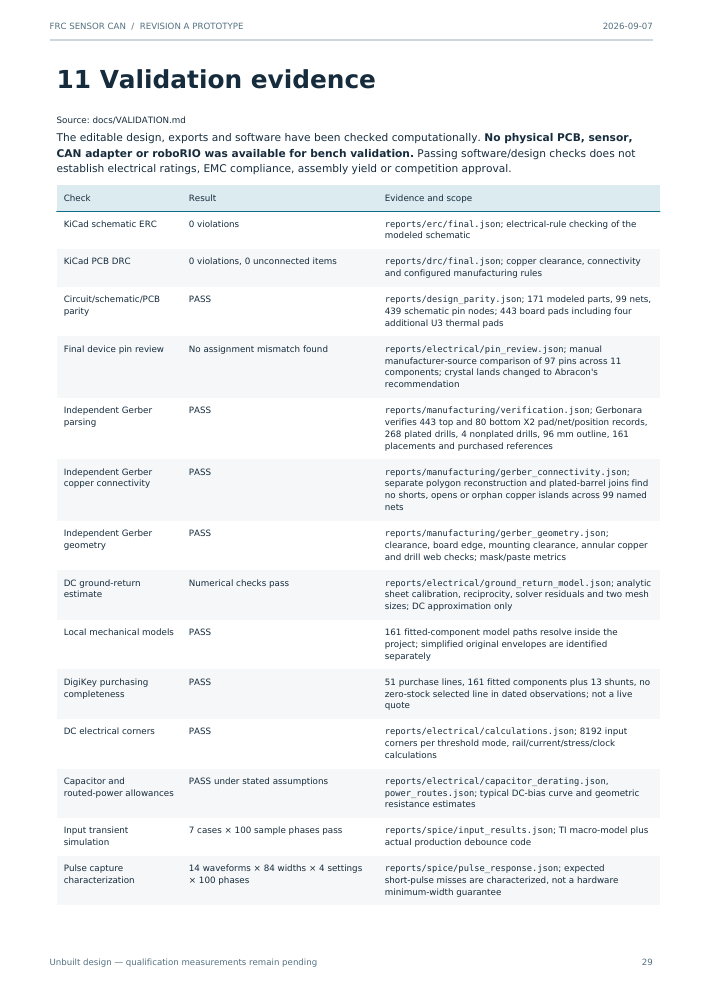
output/review/release_handbook_page-29.png
