barkinvar/sugerCANe/output/review/release_handbook_page-30.png

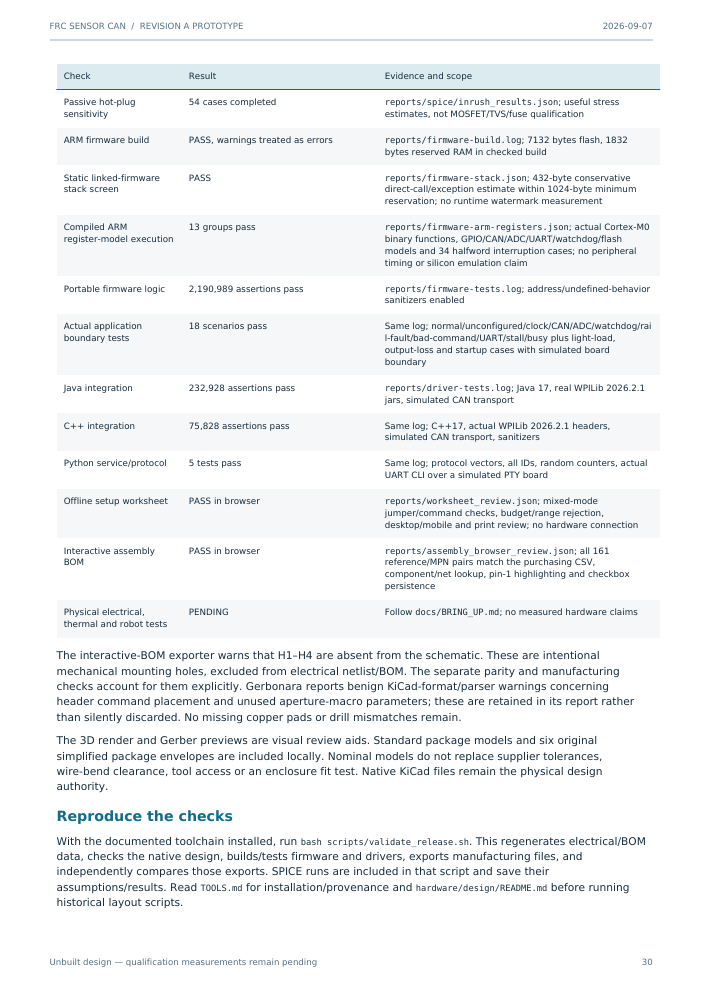
output/review/release_handbook_page-30.png
