barkinvar/sugerCANe/output/review/release_handbook_page-31.png

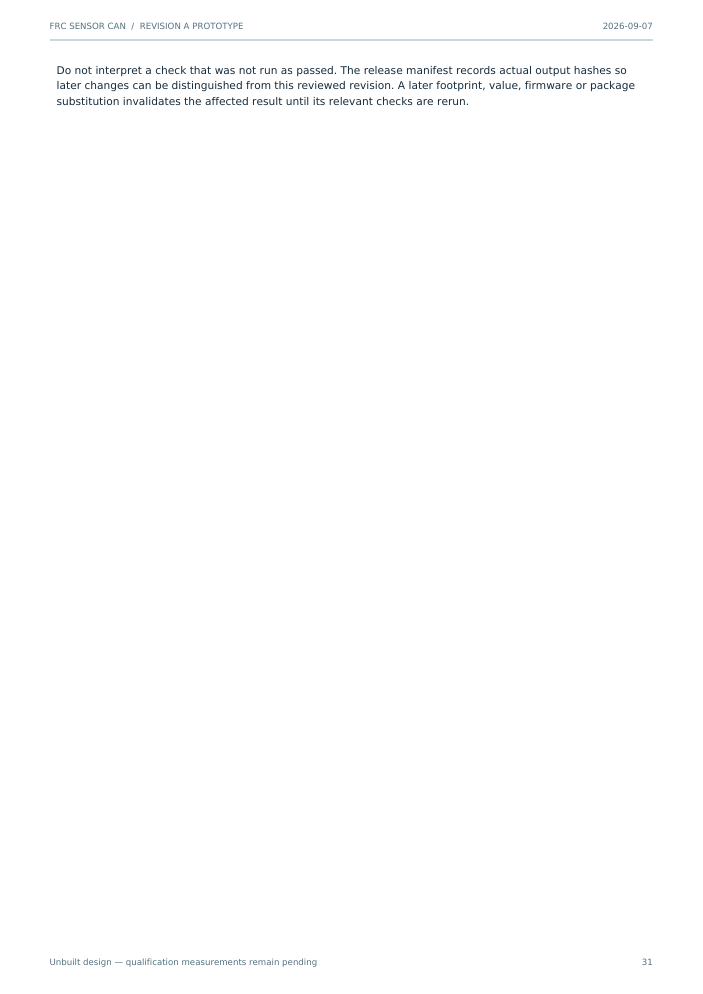
output/review/release_handbook_page-31.png
