barkinvar/sugerCANe/output/review/release_handbook_page-34.png

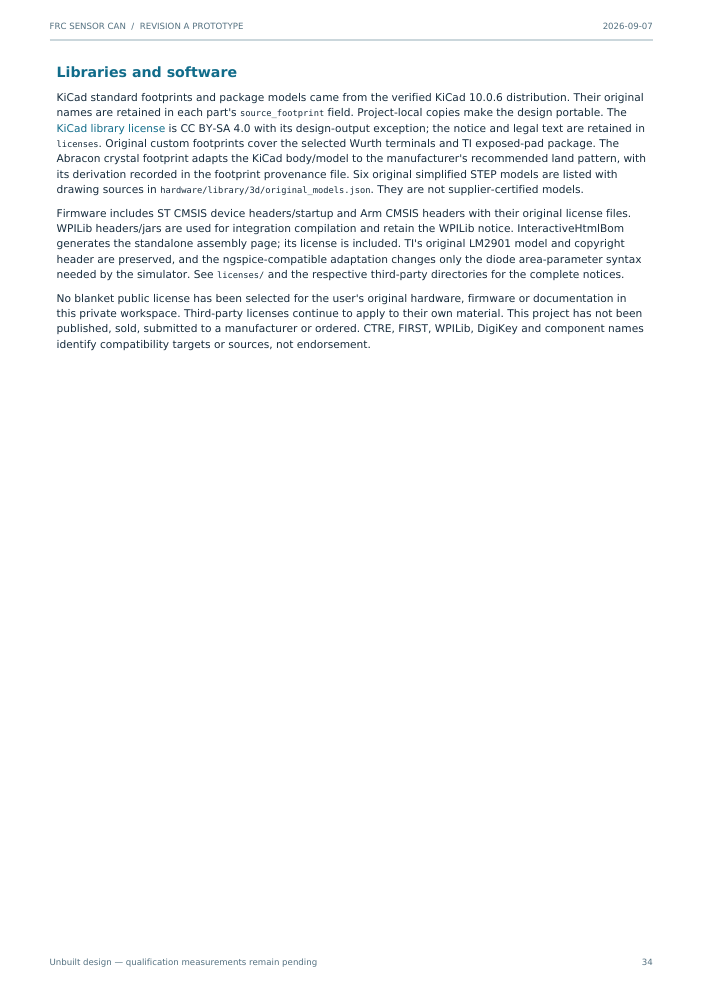
output/review/release_handbook_page-34.png
