barkinvar/sugerCANe/output/review/routed.png

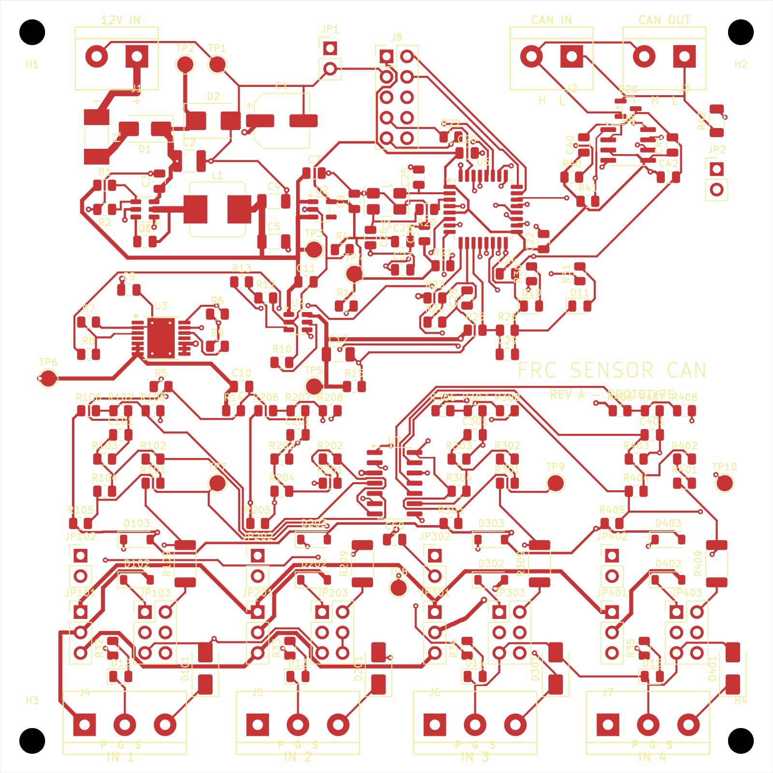
output/review/routed.png
