barkinvar/sugerCANe/output/review/schematic_contact_sheet.png

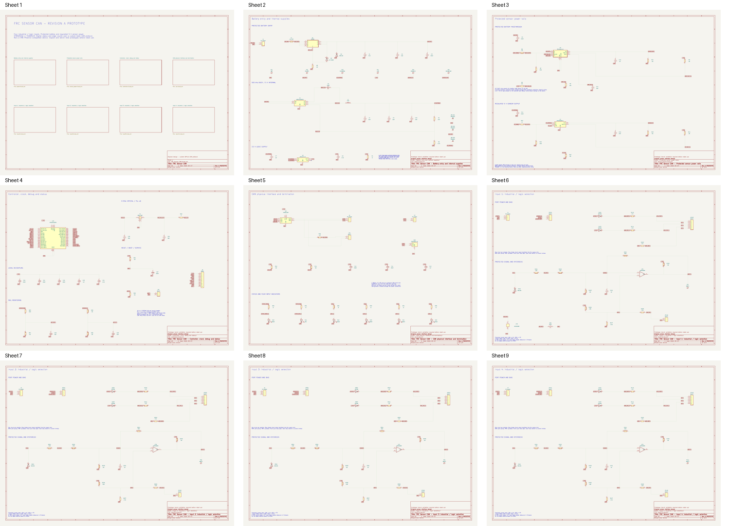
output/review/schematic_contact_sheet.png
