barkinvar/sugerCANe/output/review/schematic_page-7.png

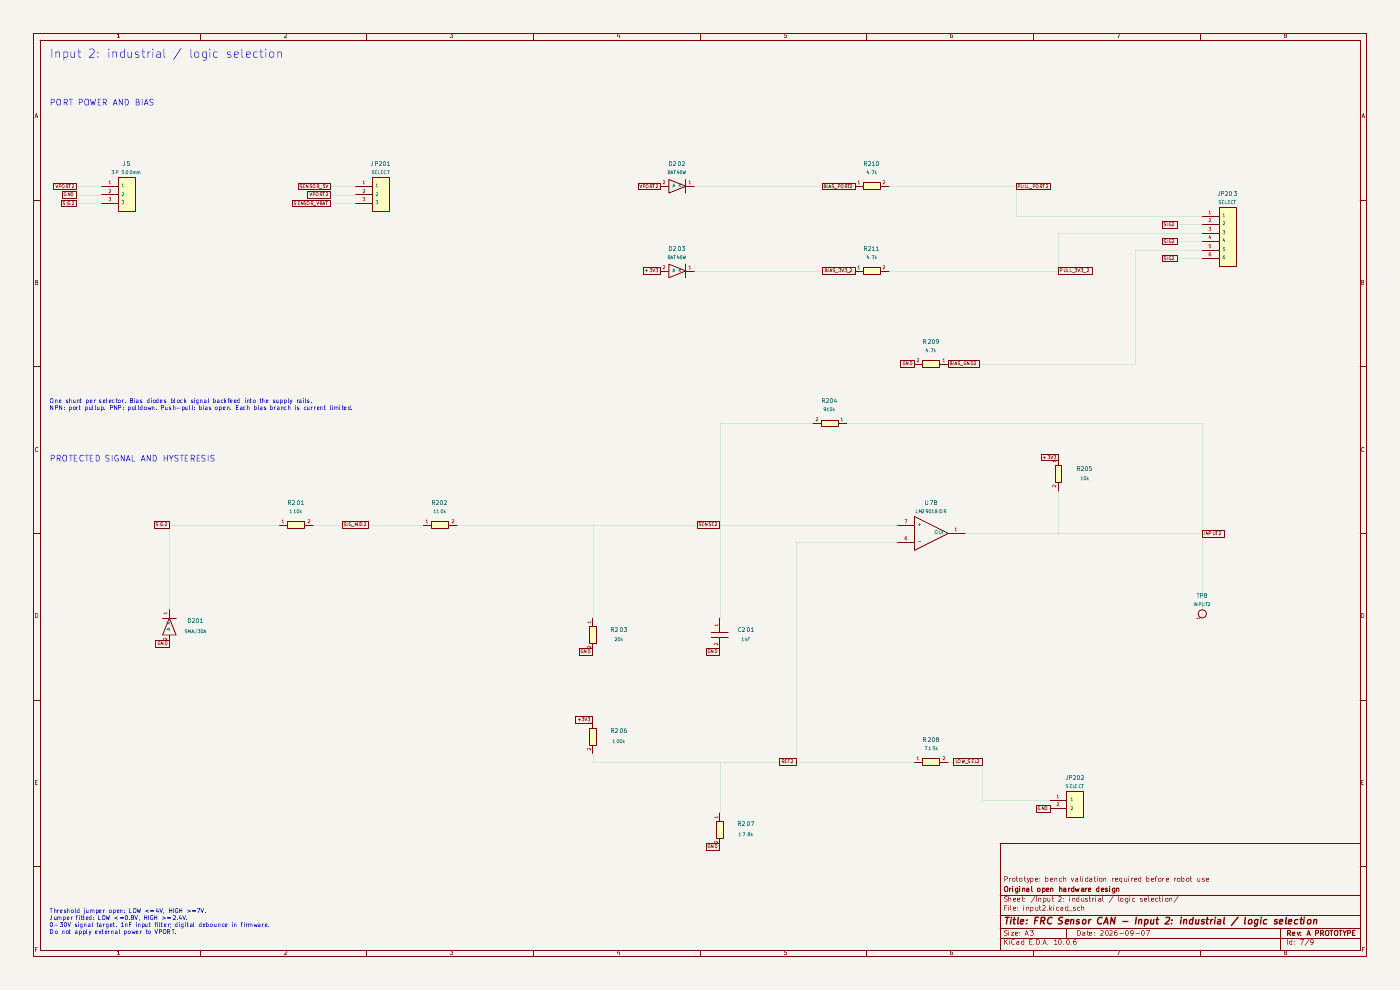
output/review/schematic_page-7.png
