barkinvar/sugerCANe/output/review/sensor_power.png

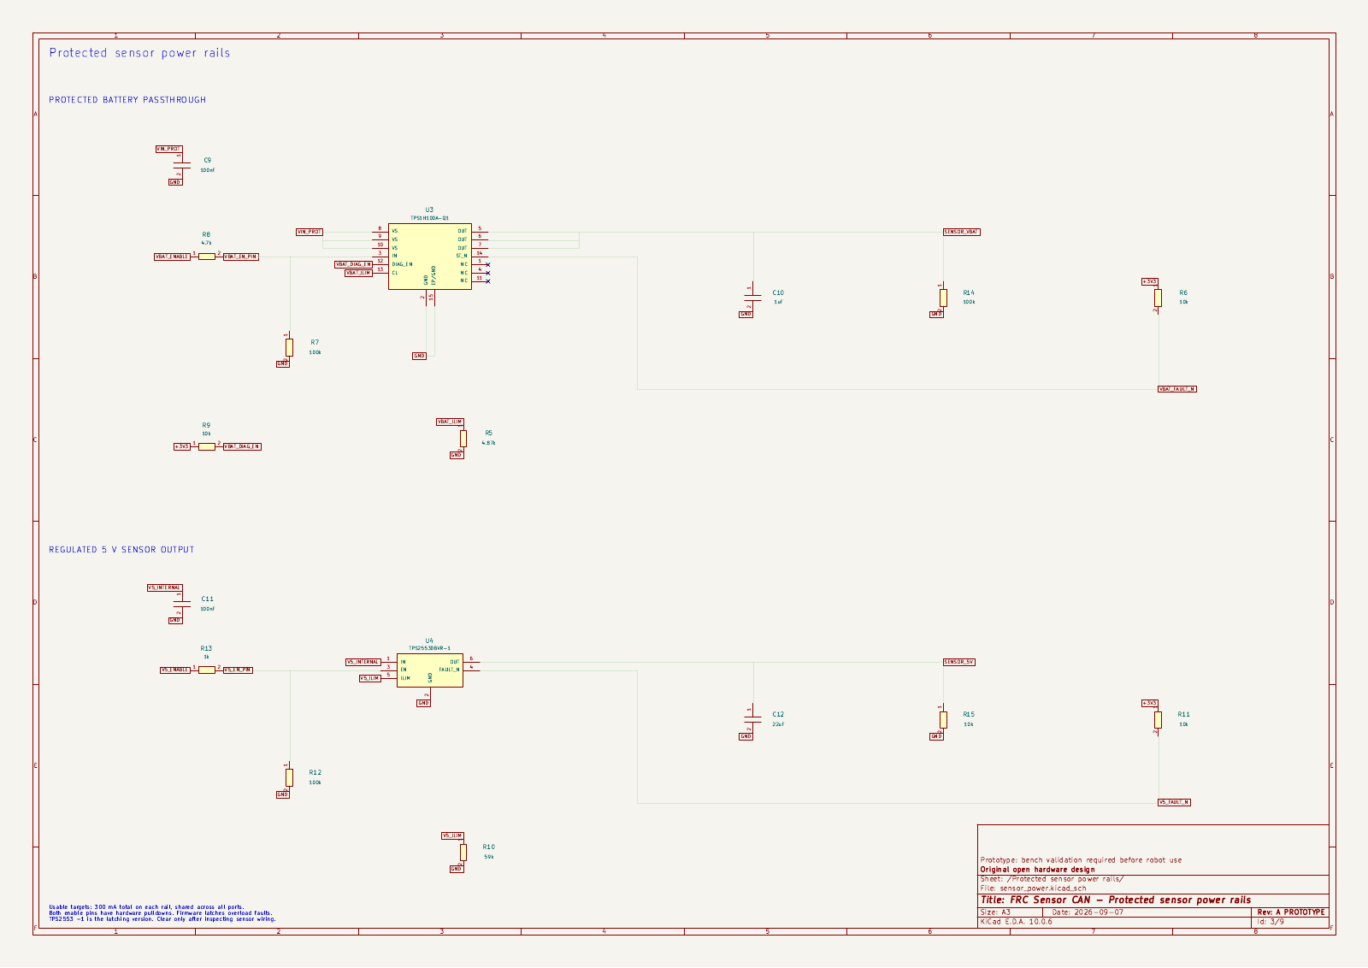
output/review/sensor_power.png
