barkinvar/sugerCANe/output/review/sheet-5.png

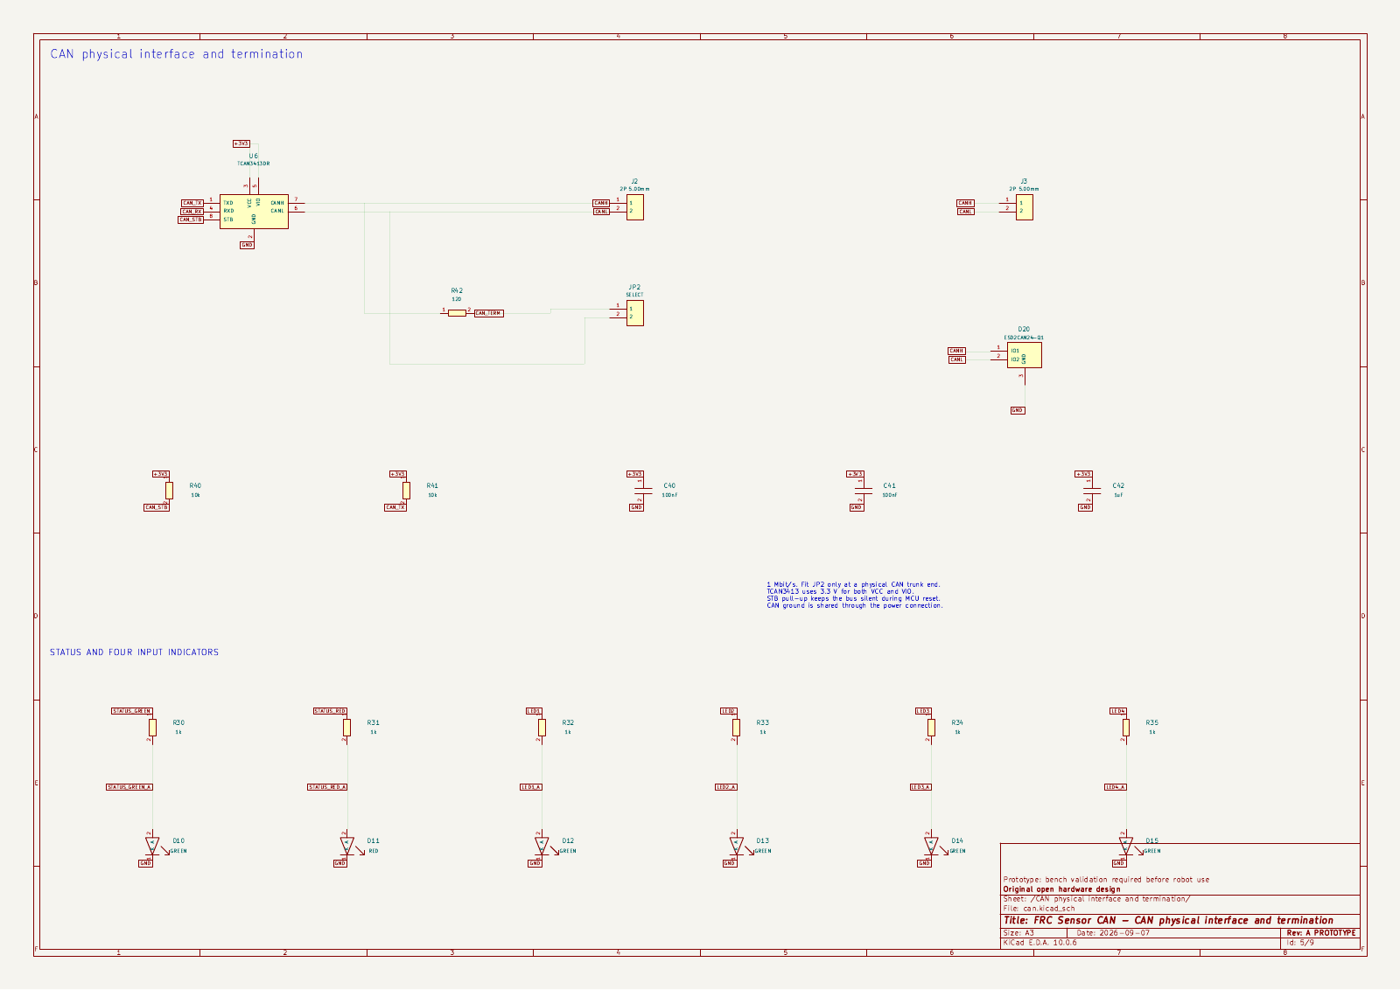
output/review/sheet-5.png
