barkinvar/sugerCANe/output/review/sheet-6.png

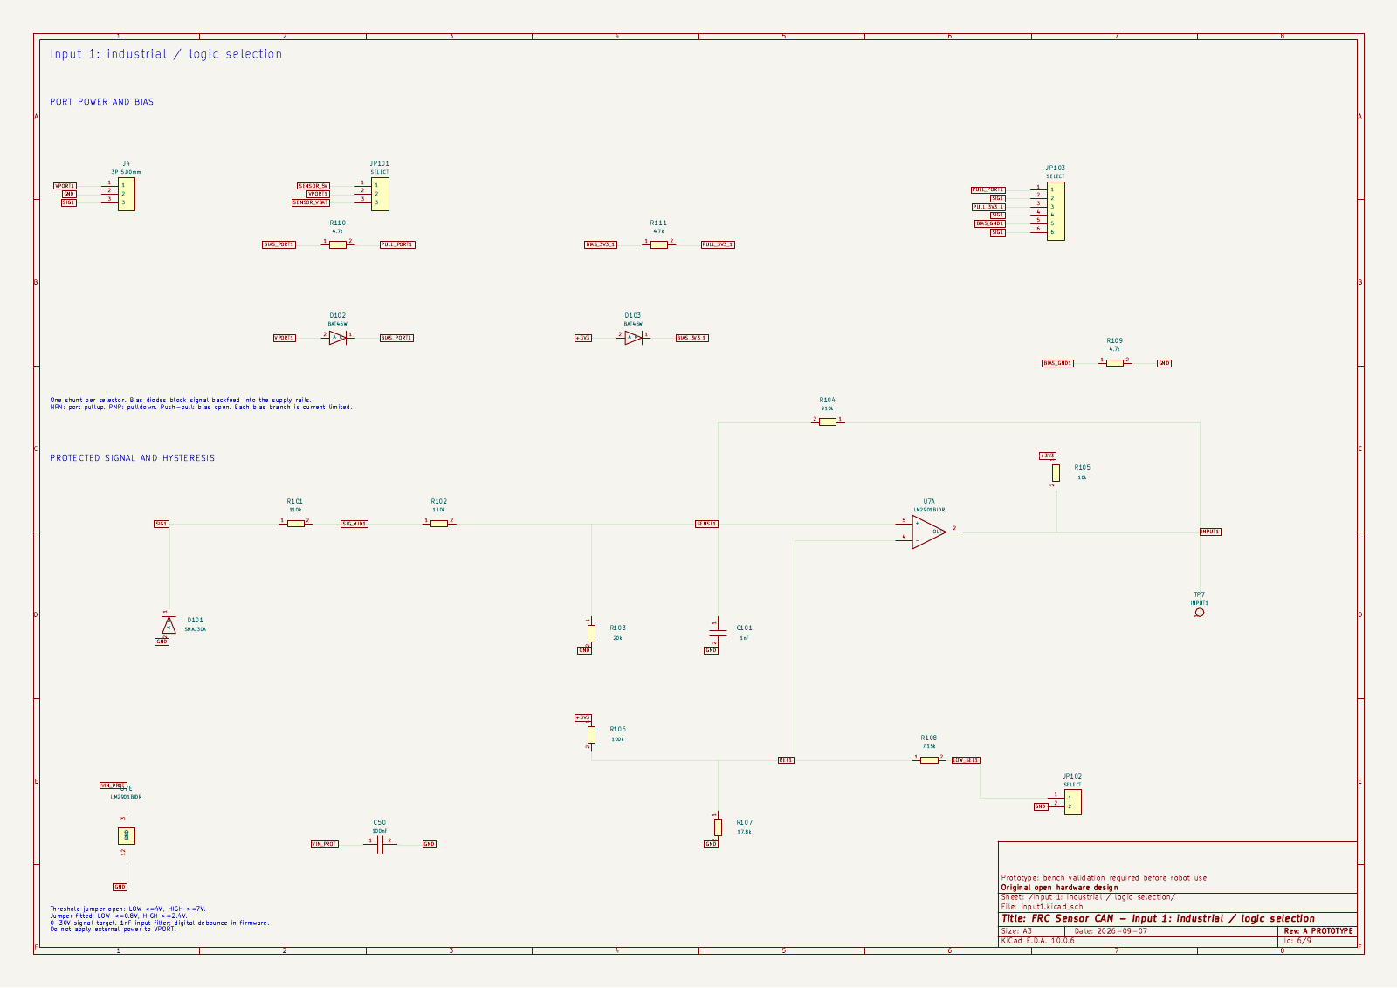
output/review/sheet-6.png
