barkinvar/sugerCANe/reports/electrical/capacitor_derating.png

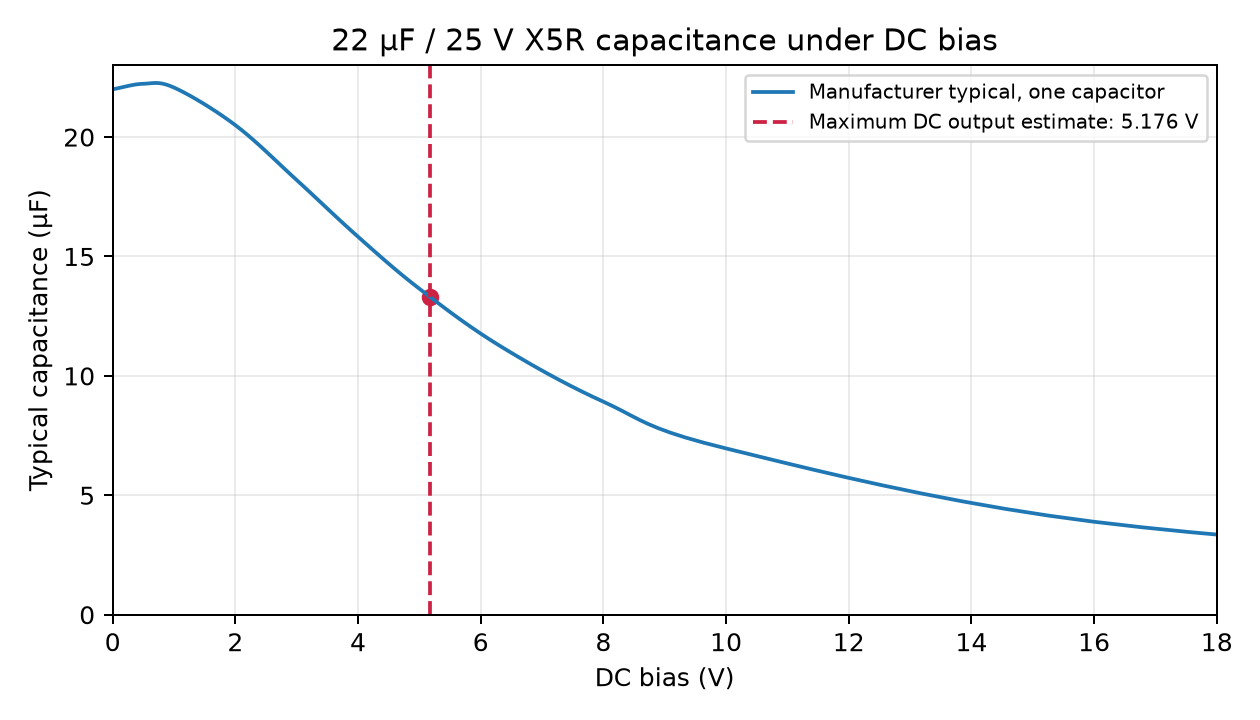
reports/electrical/capacitor_derating.png
