barkinvar/sugerCANe/reports/electrical/ground_return_0.1mm.png

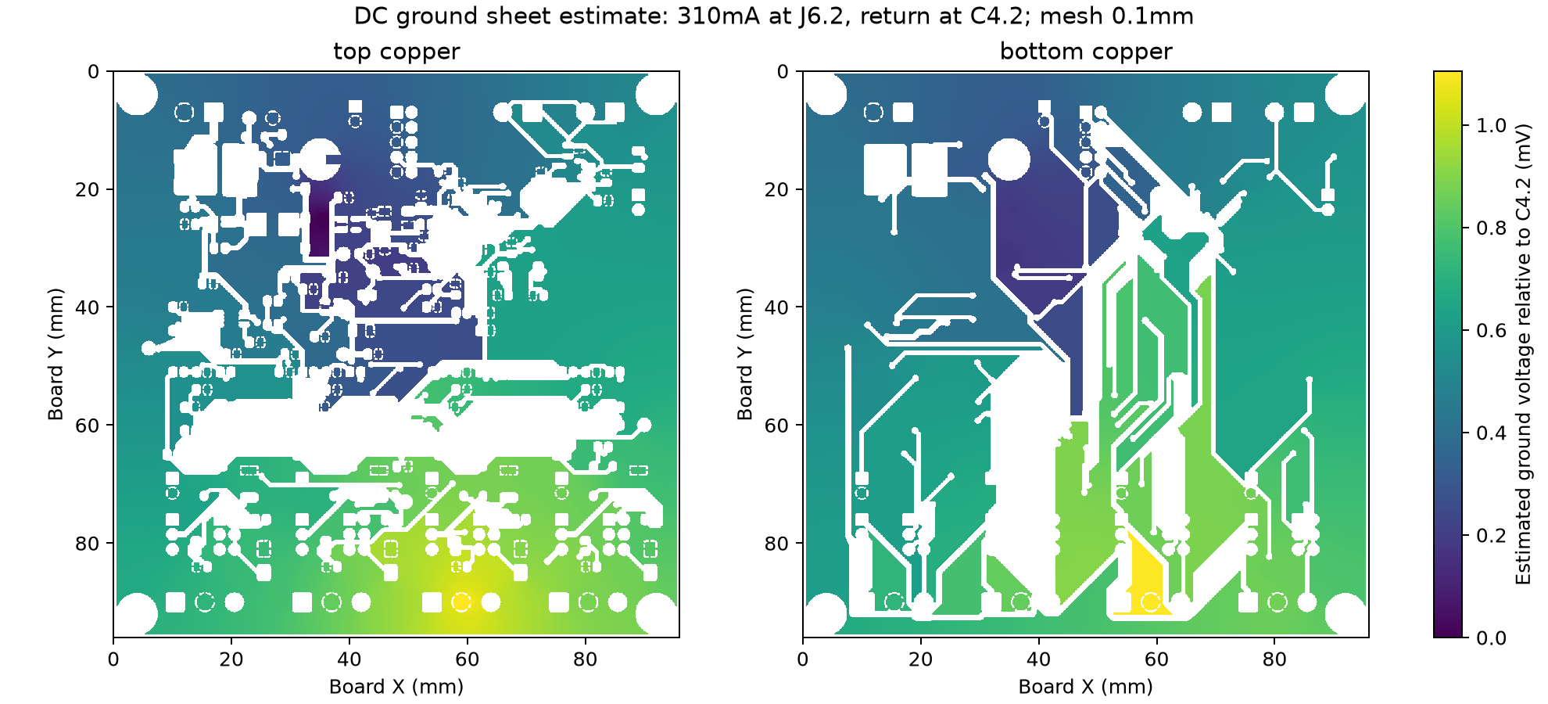
reports/electrical/ground_return_0.1mm.png
