barkinvar/sugerCANe/reports/spice/input_filtering.png

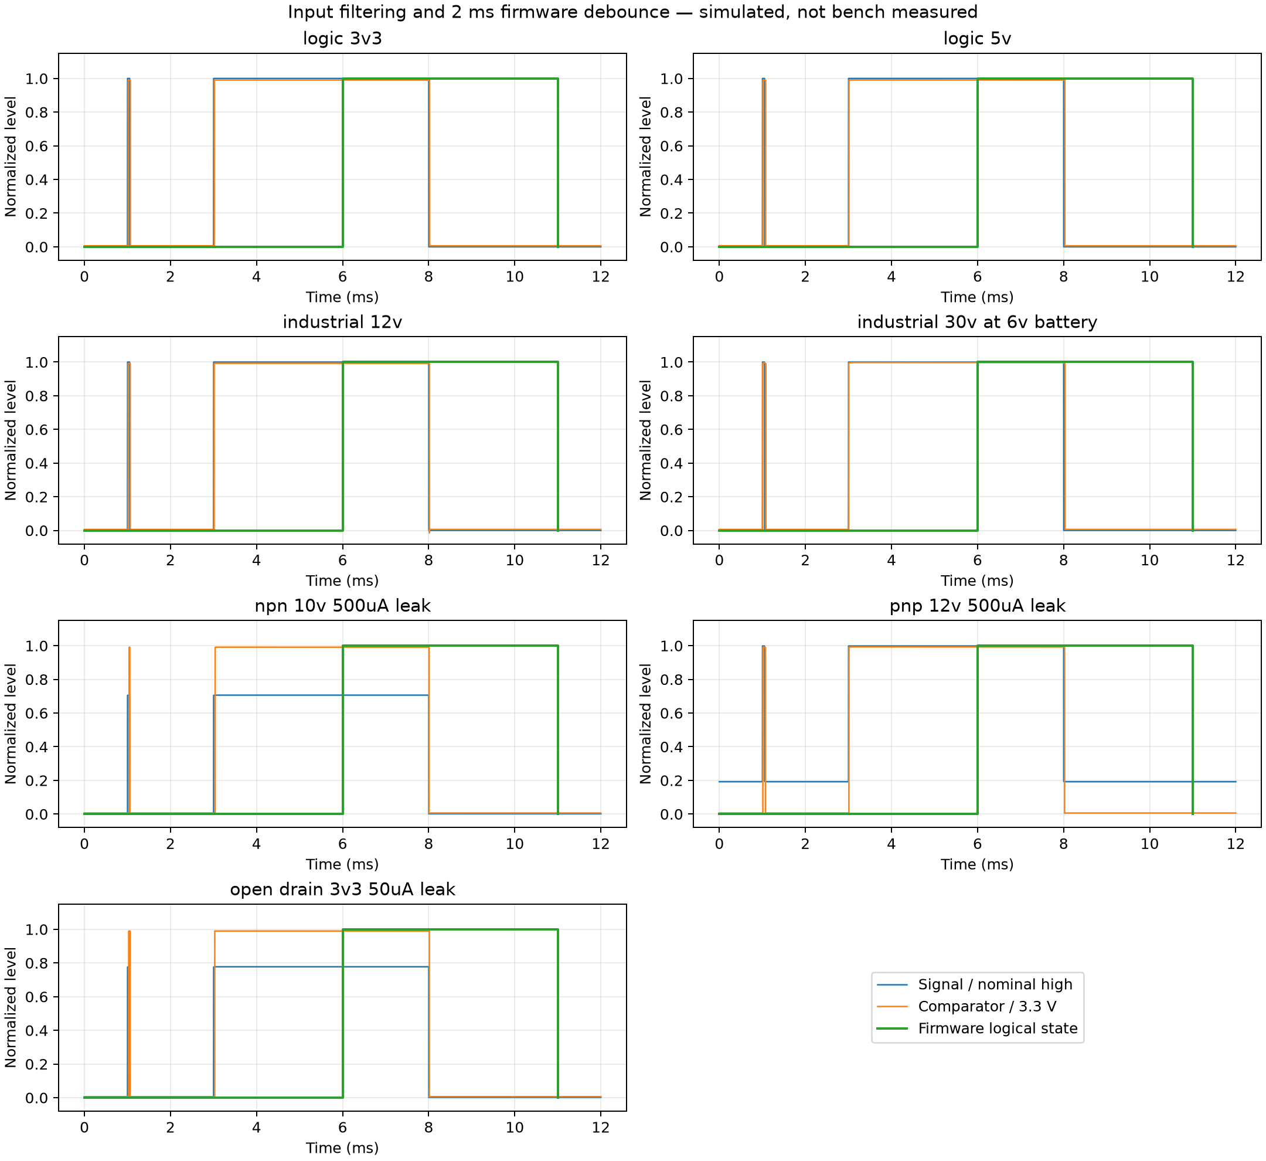
reports/spice/input_filtering.png
