barkinvar/sugerCANe/reports/spice/inrush.png

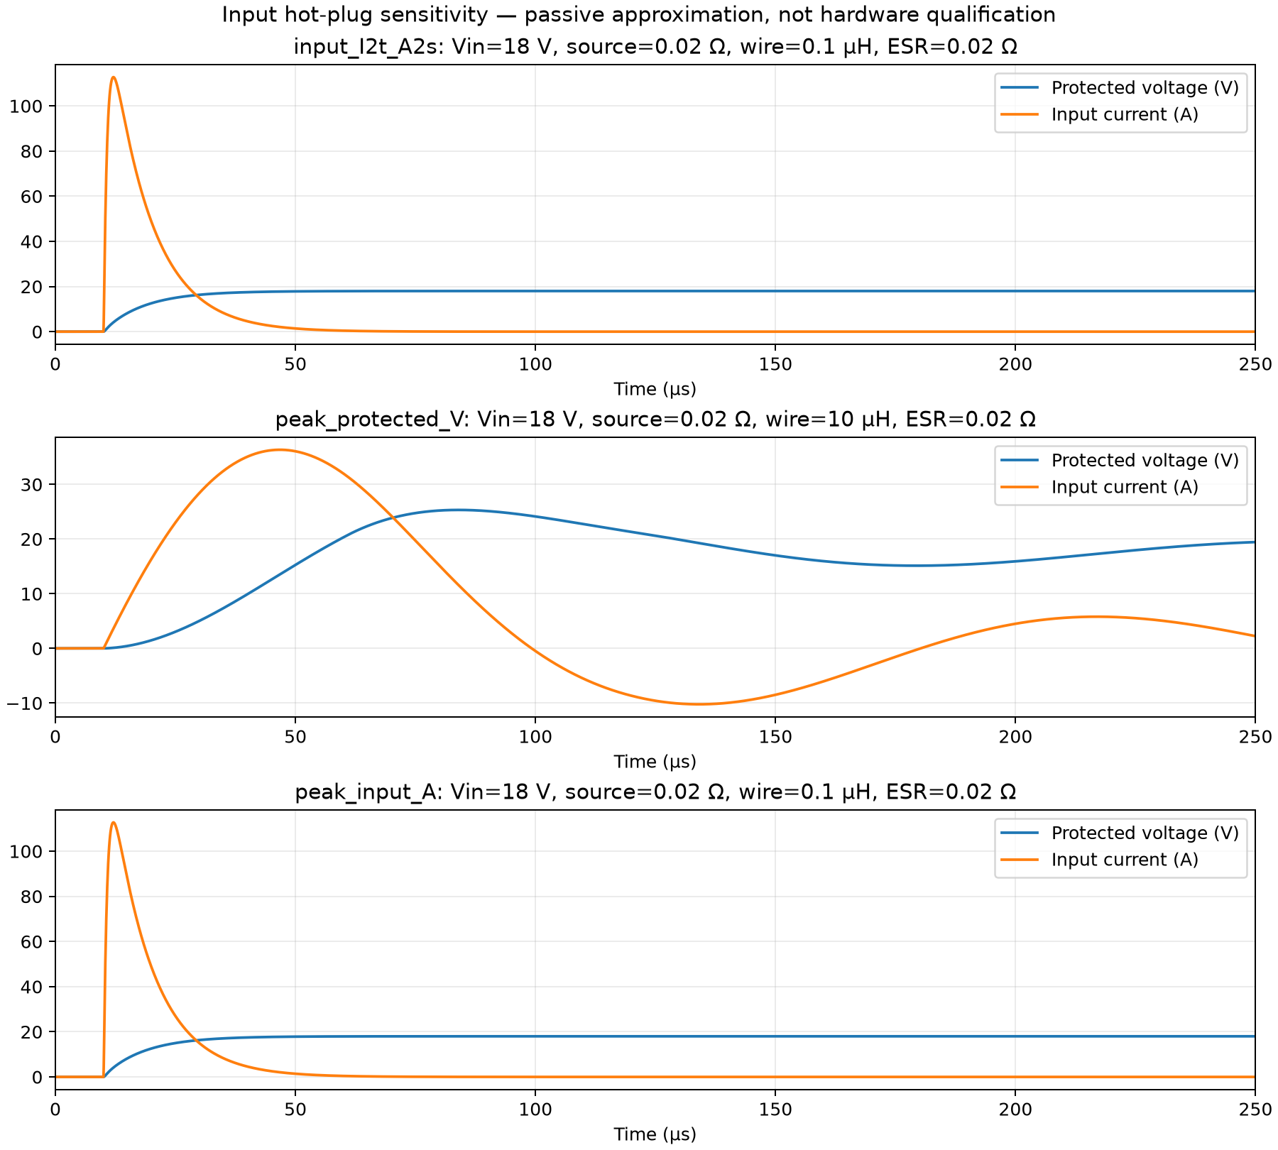
reports/spice/inrush.png
