barkinvar/sugerCANe/reports/spice/pulse_response.png

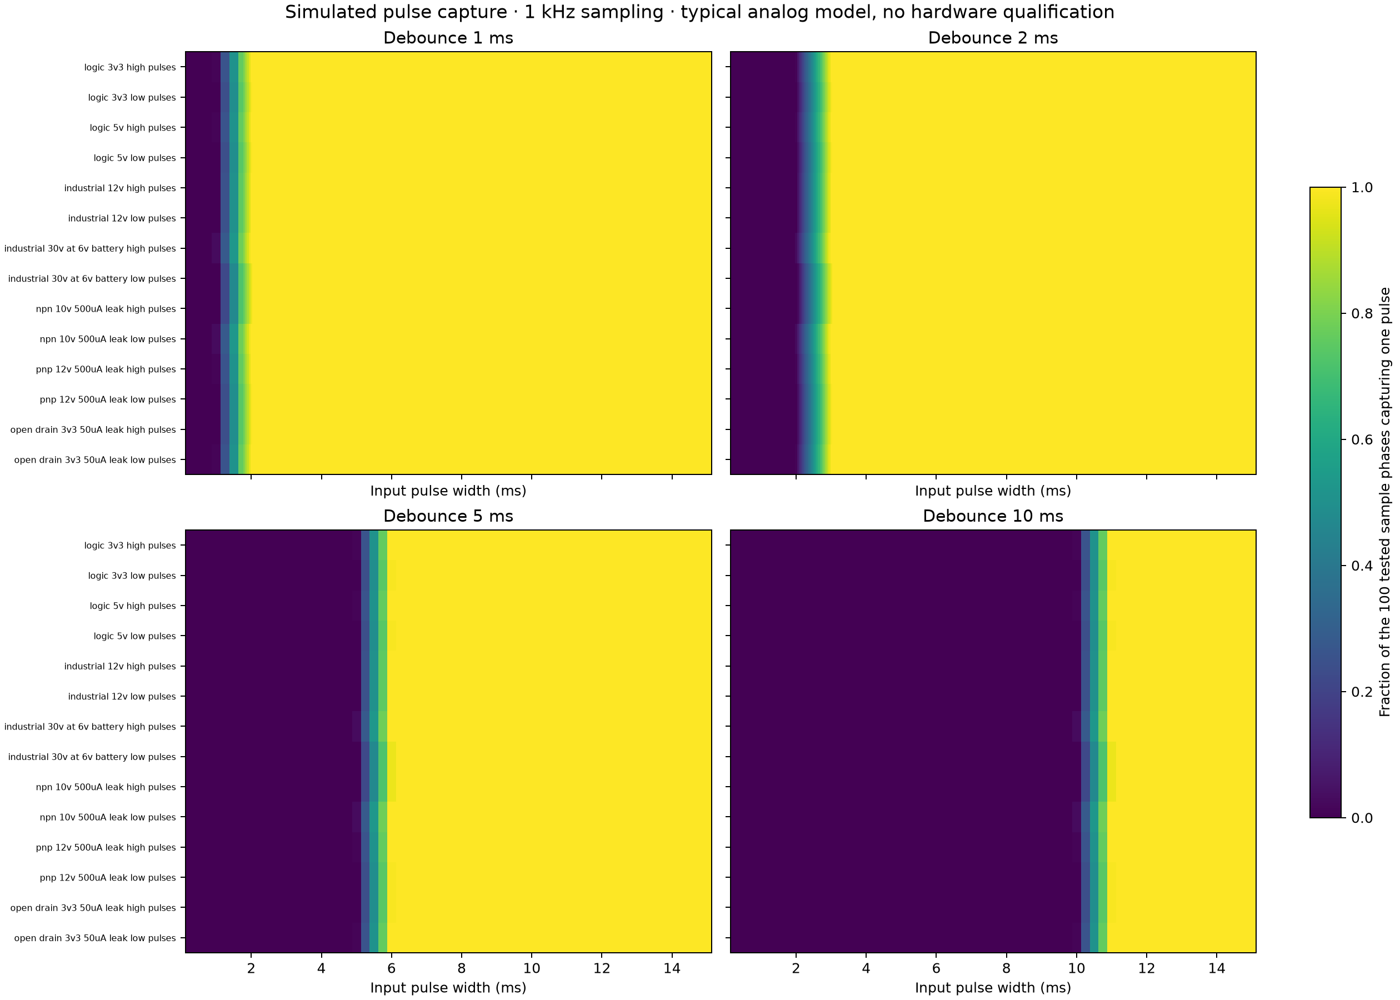
reports/spice/pulse_response.png
