barkinvar/sugerCANe/rev_b2/output/boost_simulation.png

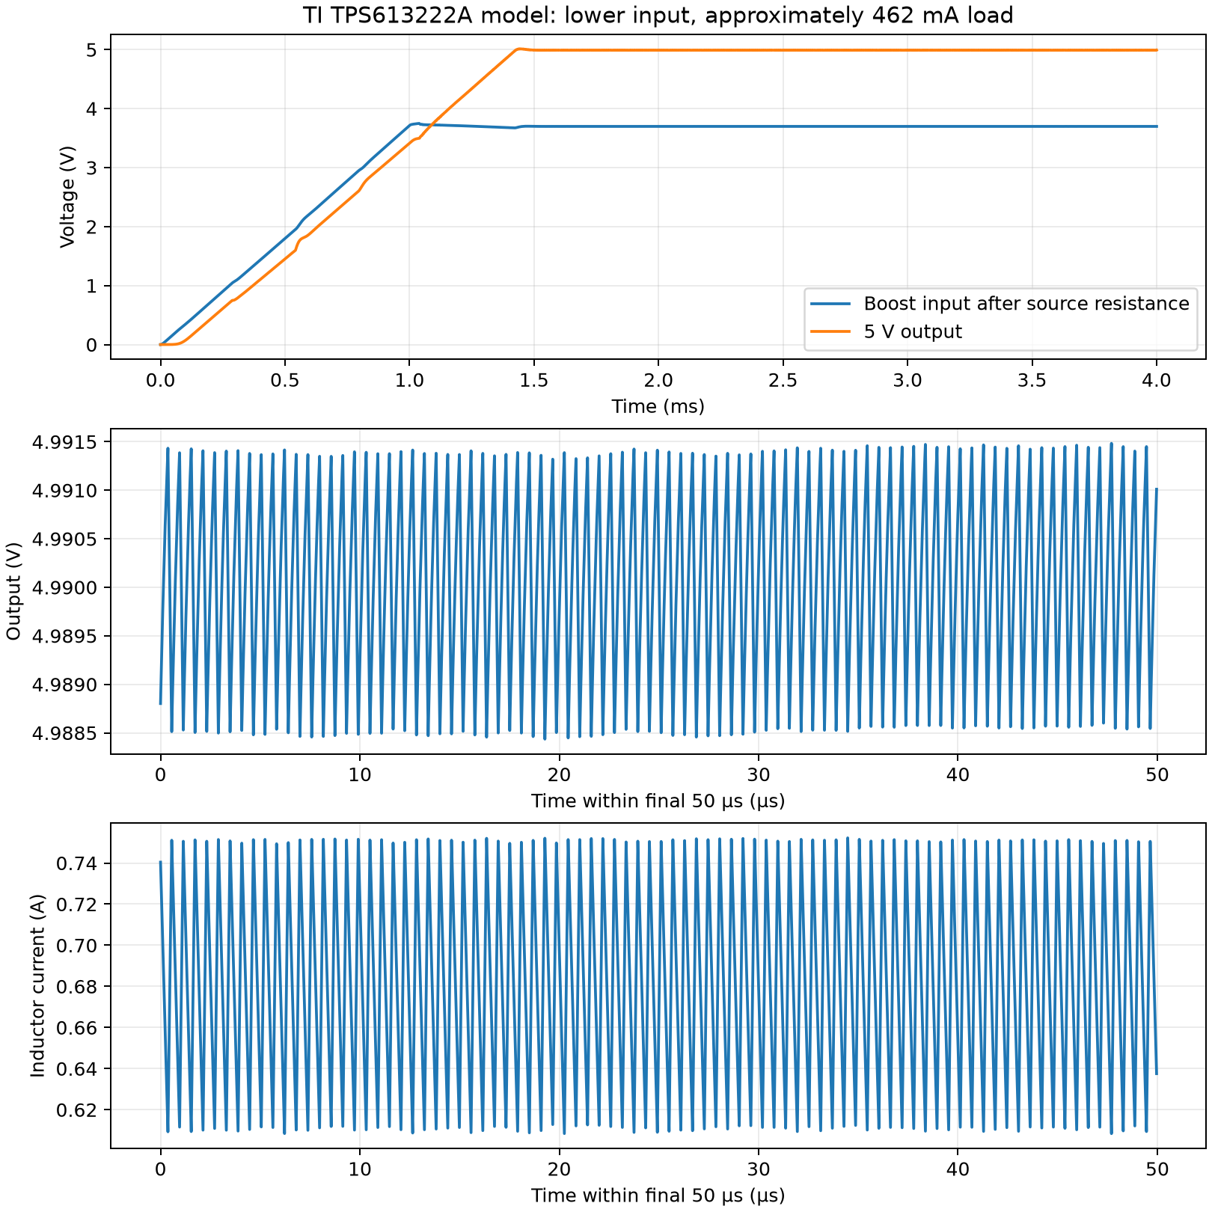
rev_b2/output/boost_simulation.png
