barkinvar/sugerCANe/rev_b2/output/review/size_comparison.png

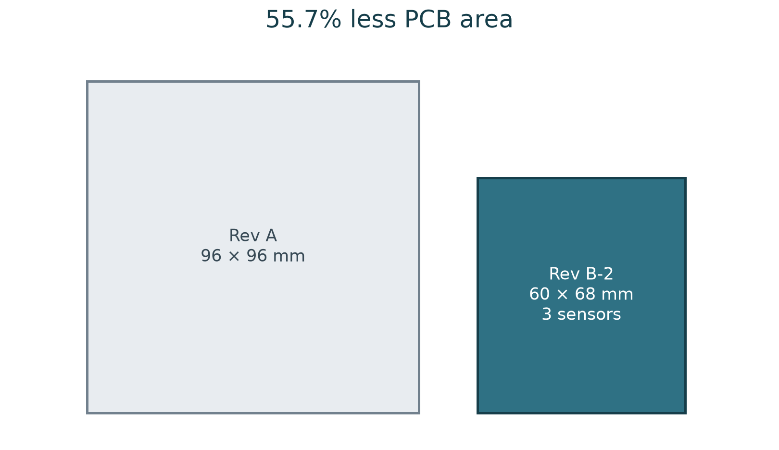
rev_b2/output/review/size_comparison.png
