barkinvar/sugerCANe/rev_b2/reports/electrical/ground_return_0.075mm.png

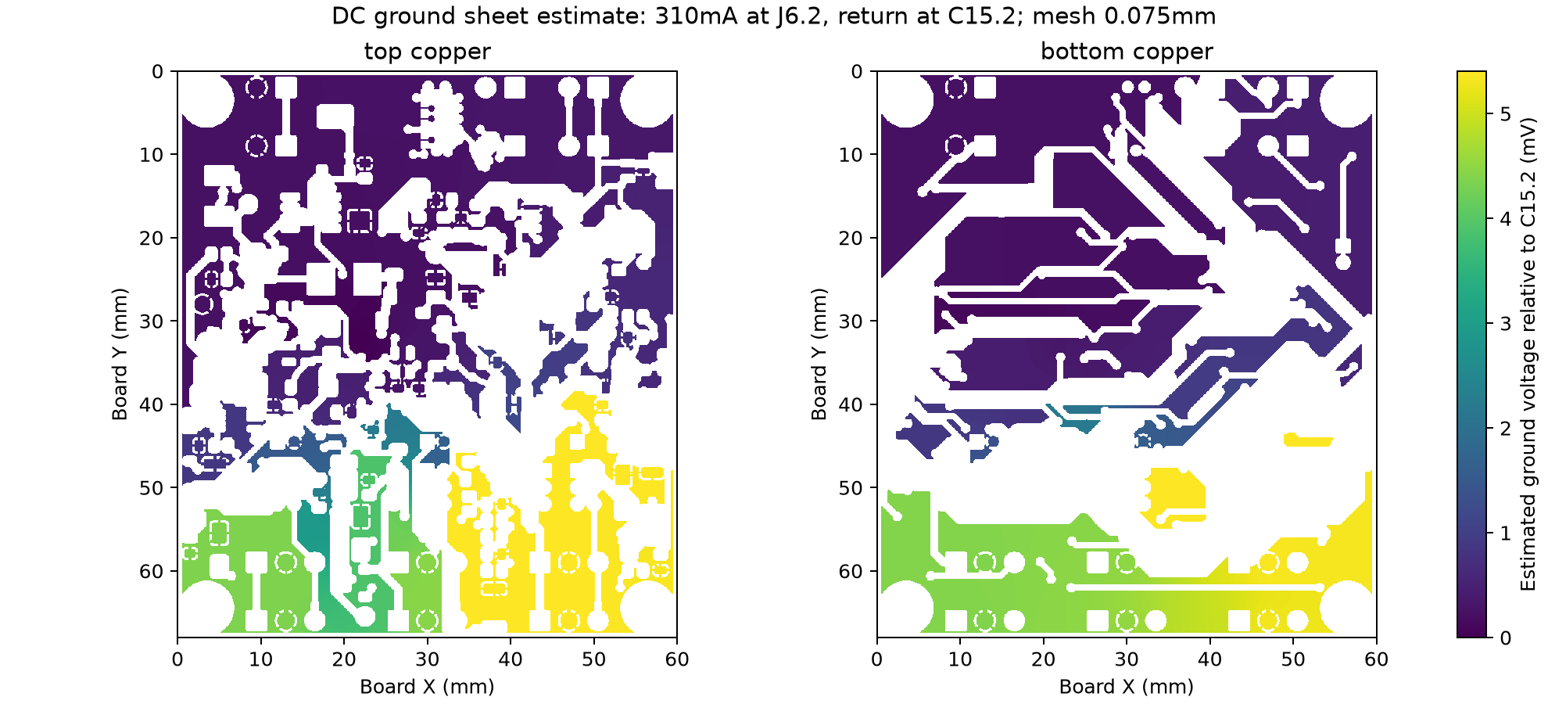
rev_b2/reports/electrical/ground_return_0.075mm.png
