barkinvar/sugerCANe/rev_b2/output/documentation/BOM_RevB2.pdf

Revision B-2 prototype · Reconfirm parts and stock · No physical build qualification | 1

# FRC Sensor CAN · Revision B-2 purchasing BOM

51 order lines · 144 fitted components + 10 shunts · Consumed component estimate US$46.35

Dated observations: 2026-09-07/08. *First observed price tier per consumed part, excluding MOQ leftovers. Full order budgets including fabrication, assembly, procurement and freight are in COST.md and cost_estimate.csv. No stock is reserved; LCSC inventory is not JLCPCB inventory.

Use BOM_turnkey.csv for a full factory quotation. Match every MPN and placement; blank JLCPCB catalog codes require global sourcing. Ten shunts are bagged accessories. See FACTORY_ORDER.md for panelization, reflow, polarity and programming requirements.

References | Qty | Value / rating | Manufacturer part number | Preferred source | Observed stock | Unit USD* | Used USD*
F1 | 1 | 1.5A FAST | 045101.5MRL Littelfuse | DigiKey F2579CT-ND (https://www.digikey.com/en/products/detail/littelfuse-inc/045101-5MRL/700820) | 7,870 | 2.4700 | 2.47

R4, R13, R30, R31, R32, R33,
R34
7 | 1k / 1% / 0.125 W | 0805W8F1001T5E
UNI-ROYAL
LCSC C17513 (https://www.lcsc.com/product-detail/C17513.html) | 26,345,600 | 0.0042 | 0.03

R3, R6, R9, R11, R14, R15, R21, R22, R24, R25, R26,
R40, R41, R105, R205, R305
16 | 10k / 1% / 0.125 W | 0805W8F1002T5E
UNI-ROYAL
LCSC C17414 (https://www.lcsc.com/product-detail/C17414.html) | 47,196,100 | 0.0039 | 0.06

R1, R7, R12, R23, R106,
R206, R306
7 | 100k / 1% / 0.125 W | 0805W8F1003T5E
UNI-ROYAL
LCSC C149504 (https://www.lcsc.com/product-detail/C149504.html) | 3,765,700 | 0.0060 | 0.04

R8, R110, R111, R210, R211, R310, R311

7 | 4.7k / 1% / 0.125 W | 0805W8F4701T5E
UNI-ROYAL
LCSC C17673 (https://www.lcsc.com/product-detail/C17673.html) | 3,907,600 | 0.0051 | 0.04
J1, J2, J3 | 3 | 2P PUSH 3.5mm | 1824420000
Weidmuller
DigiKey 281-2020-ND (https://www.digikey.com/en/products/detail/weidm%C3%BCller/1824420000/1094358) | 12,805 | 1.5400 | 4.62
J4, J5, J6 | 3 | 3P PUSH 3.5mm | 1824430000
Weidmuller
DigiKey 281-2021-ND (https://www.digikey.com/en/products/detail/weidm%C3%BCller/1824430000/1094359) | 1,698 | 2.2100 | 6.63
Y1 | 1 | 8MHz 18pF | ABM3B-8.000MHZ-B2-T
Abracon
DigiKey 535-9720-1-ND (https://www.digikey.com/en/products/detail/abracon-llc/ABM3B-8-000MHZ-B2-T/1873166) | 70,541 | 0.7600 | 0.76
Q1 | 1 | AO4485 | AO4485
Alpha & Omega Semiconductor
LCSC C51499 (https://www.lcsc.com/product-detail/C51499.html) | 88,125 | 0.3171 | 0.32
U2 | 1 | AP2112K-3.3 | AP2112K-3.3TRG1 Diodes Incorporated

DigiKey
AP2112K-3.3TRG1DICT-ND (https://www.digikey.com/en/products/detail/diodes-incorporated/AP2112K-3-3TRG1/4470746)
159,040 | 0.2800 | 0.28

D102, D103, D202, D203,
D302, D303
6 | BAT46W | BAT46W-E3-18
Vishay
LCSC C5557780 (https://www.lcsc.com/product-detail/C5557780.html) | 4,735 | 0.1307 | 0.78
C25, C26 | 2 | 30pF / 50V / 5% | C0805C300J5GACTU KEMET

DigiKey
399-C0805C300J5GACTUCT-ND (https://www.digikey.com/en/products/detail/kemet/C0805C300J5GACTU/2209733)
9,211 | 0.3300 | 0.66

Revision B-2 prototype · Reconfirm parts and stock · No physical build qualification | 2
References | Qty | Value / rating | Manufacturer part number | Preferred source | Observed stock | Unit USD* | Used USD*
C101, C201, C301 | 3 | 1nF / 50V / 5% | CC0805JRNPO9BN102 YAGEO | DigiKey 311-1122-1-ND (https://www.digikey.com/en/products/detail/yageo/CC0805JRNPO9BN102/302856) | 105,431 | 0.1500 | 0.45
C7, C10, C23, C42 | 4 | 1uF / 50V / 10% | CC0805KKX7R9BB105
YAGEO
DigiKey 311-1886-1-ND (https://www.digikey.com/en/products/detail/yageo/CC0805KKX7R9BB105/5195292) | 112,870 | 0.3200 | 1.28
C28, C29 | 2 | 10nF / 50V / 10% | CC0805KRX7R9BB103
YAGEO
DigiKey 311-1136-1-ND (https://www.digikey.com/en/products/detail/yageo/CC0805KRX7R9BB103/302870) | 360,198 | 0.1100 | 0.22
C14 | 1 | 33nF / 50V / 10% | CC0805KRX7R9BB333
YAGEO
DigiKey 311-1374-1-ND (https://www.digikey.com/en/products/detail/yageo/CC0805KRX7R9BB333/2103112) | 24,641 | 0.1400 | 0.14

C3, C6, C9, C11, C20, C21,
C22, C27, C40, C41, C50, C17
12 | 100nF / 100V / 10% | CL21B104KCFNNNE
Samsung Electro-Mechanics
LCSC C28233 (https://www.lcsc.com/product-detail/C28233.html) | 605,350 | 0.0411 | 0.49
C4, C5, C13, C12, C15, C16 | 6 | 22uF / 25V / 10% | CL31A226KAHNNNE
Samsung Electro-Mechanics
LCSC C12891 (https://www.lcsc.com/product-detail/C12891.html) | 211,520 | 0.1709 | 1.03
C2 | 1 | 10uF / 50V / 10% | CL32B106KBJNNWE
Samsung Electro-Mechanics
DigiKey 1276-3388-1-ND (https://www.digikey.com/en/products/detail/samsung-electro-mechanics/CL32B106KBJNNWE/3891474) | 149,003 | 0.6200 | 0.62
C1 | 1 | 47uF / 50V / 20% | EEE-FK1H470P
Panasonic
DigiKey PCE3815CT-ND (https://www.digikey.com/en/products/detail/panasonic-industry/EEE-FK1H470P/765984) | 10,108 | 0.9300 | 0.93
R2, R107, R207, R307 | 4 | 17.8k / 1% / 0.125 W | ERJ-6ENF1782V
Panasonic Industry
DigiKey P17.8KCCT-ND (https://www.digikey.com/en/products/detail/panasonic-industry/ERJ-6ENF1782V/6403) | 33,381 | 0.1200 | 0.48
D20 | 1 | ESD2CAN24-Q1 | ESD2CAN24DBZRQ1 Texas Instruments

DigiKey
296-ESD2CAN24DBZRQ1CT-ND (https://www.digikey.com/en/products/detail/texas-instruments/ESD2CAN24DBZRQ1/16982262)
255,809 | 0.8700 | 0.87
U7 | 1 | LM339LV | LM339LVDR
Texas Instruments
DigiKey 296-LM339LVDRCT-ND (https://www.digikey.com/en/products/detail/texas-instruments/LM339LVDR/21598795) | 1,085 | 0.4200 | 0.42
U1 | 1 | LMR51420XDDCR | LMR51420XDDCR
Texas Instruments
LCSC C5246146 (https://www.lcsc.com/product-detail/C5246146.html) | 109 | 1.0292 | 1.03
D10, D12, D13, D14 | 4 | GREEN | LTST-C170KGKT
Lite-On
DigiKey 160-1414-1-ND (https://www.digikey.com/en/products/detail/lite-on-inc/LTST-C170KGKT/386777) | 498,450 | 0.1900 | 0.76
D11 | 1 | RED | LTST-C170KRKT
Lite-On
DigiKey 160-1415-1-ND (https://www.digikey.com/en/products/detail/lite-on-inc/LTST-C170KRKT/386779) | 489,805 | 0.1800 | 0.18
10 loose configuration shunts | 10 | 2 mm shunt | M22-1900005
Harwin
DigiKey 952-1305-ND (https://www.digikey.com/en/products/detail/harwin-inc/M22-1900005/2264286) | 31,908 | 0.3500 | 3.50
JP2, JP102, JP202, JP302 | 4 | SELECT | M22-2010205
Harwin
DigiKey 952-2273-ND (https://www.digikey.com/en/products/detail/harwin-inc/M22-2010205/3728237) | 7,644 | 0.1600 | 0.64

Revision B-2 prototype · Reconfirm parts and stock · No physical build qualification | 3
JP101, JP201, JP301 | 3 | SELECT | M22-2010305
Harwin
DigiKey 952-2274-ND (https://www.digikey.com/en/products/detail/harwin-inc/M22-2010305/3728238) | 35,632 | 0.2200 | 0.66
JP103, JP203, JP303 | 3 | SELECT | M22-2020305
Harwin
DigiKey 952-2133-ND (https://www.digikey.com/en/products/detail/harwin-inc/M22-2020305/3728097) | 838 | 0.4100 | 1.23
D3 | 1 | 12V ZENER | MMSZ12T1G
onsemi
DigiKey MMSZ12T1GOSCT-ND (https://www.digikey.com/en/products/detail/onsemi/MMSZ12T1G/1139870) | 34,429 | 0.1700 | 0.17

R101, R102, R201, R202,
R301, R302
6 | 110k / 1% / 0.125 W | RC0805FR-07110KL
YAGEO
DigiKey 311-110KCRCT-ND (https://www.digikey.com/en/products/detail/yageo/RC0805FR-07110KL/727560) | 5,943 | 0.1000 | 0.60
R103, R203, R303 | 3 | 20k / 1% / 0.125 W | RC0805FR-0720KL
YAGEO
DigiKey 311-20.0KCRCT-ND (https://www.digikey.com/en/products/detail/yageo/RC0805FR-0720KL/730667) | 27,443 | 0.1000 | 0.30
R5 | 1 | 3.9k / 1% / 0.125 W | RC0805FR-073K9L
YAGEO
DigiKey 311-3.90KCRCT-ND (https://www.digikey.com/en/products/detail/yageo/RC0805FR-073K9L/727838) | 131,203 | 0.1000 | 0.10
R10 | 1 | 59k / 1% / 0.125 W | RC0805FR-0759KL
YAGEO
DigiKey 311-59.0KCRCT-ND (https://www.digikey.com/en/products/detail/yageo/RC0805FR-0759KL/728045) | 29,786 | 0.1000 | 0.10
R108, R208, R308 | 3 | 7.15k / 1% / 0.125 W | RC0805FR-077K15L
YAGEO
DigiKey 311-7.15KCRCT-ND (https://www.digikey.com/en/products/detail/yageo/RC0805FR-077K15L/728110) | 48,097 | 0.1000 | 0.30
R104, R204, R304 | 3 | 910k / 1% / 0.125 W | RC0805FR-07910KL
YAGEO
DigiKey YAG3336CT-ND (https://www.digikey.com/en/products/detail/yageo/RC0805FR-07910KL/5281196) | 58,915 | 0.1000 | 0.30
R20 | 1 | 0 / jumper / 0.125 W | RC0805JR-070RL
YAGEO
DigiKey 311-0.0ARCT-ND (https://www.digikey.com/en/products/detail/yageo/RC0805JR-070RL/728216) | 1,733,368 | 0.1000 | 0.10
R42 | 1 | 120 / 1% / 0.25 W | RC1206FR-07120RL
YAGEO
DigiKey 311-120FRCT-ND (https://www.digikey.com/en/products/detail/yageo/RC1206FR-07120RL/728523) | 126,570 | 0.1000 | 0.10
R109, R209, R309 | 3 | 4.7k / 1% / 0.75 W | RC2010FK-074K7L YAGEO

DigiKey
13-RC2010FK-074K7LCT-ND (https://www.digikey.com/en/products/detail/yageo/RC2010FK-074K7L/5921412)
7,566 | 0.2300 | 0.69
D101, D201, D301 | 3 | SMAJ30A | SMAJ30A
Littelfuse
LCSC C148230 (https://www.lcsc.com/product-detail/C148230.html) | 30,185 | 0.1459 | 0.44
D2 | 1 | SMBJ22A | SMBJ22A-E3/52
Vishay
DigiKey SMBJ22A-E3/52GICT-ND (https://www.digikey.com/en/products/detail/vishay-general-semiconductor-diodes-division/SMBJ22A-E3-52/1119260) | 705 | 0.5600 | 0.56
L2 | 1 | 4.7uH | SRP4020TA-4R7M
Bourns
DigiKey SRP4020TA-4R7MCT-ND (https://www.digikey.com/en/products/detail/bourns-inc/SRP4020TA-4R7M/4901006) | 9,132 | 1.0700 | 1.07
L1 | 1 | 10uH | SRP7028A-100M
Bourns
DigiKey SRP7028A-100MCT-ND (https://www.digikey.com/en/products/detail/bourns-inc/SRP7028A-100M/4876733) | 9,366 | 1.1000 | 1.10

Revision B-2 prototype · Reconfirm parts and stock · No physical build qualification | 4
D4 | 1 | SS14 | SS14-E3/61T
Vishay
DigiKey SS14-E3/61TGICT-ND (https://www.digikey.com/en/products/detail/vishay-general-semiconductor-diodes-division/SS14-E3-61T/1091538) | 99,297 | 0.4700 | 0.47
U5 | 1 | STM32F042K6T6 | STM32F042K6T6
STMicroelectronics
DigiKey 497-14647-ND (https://www.digikey.com/en/products/detail/stmicroelectronics/STM32F042K6T6/4815294) | 3,072 | 4.3400 | 4.34
U6 | 1 | TCAN3413DR | TCAN3413DR
Texas Instruments
LCSC C22433320 (https://www.lcsc.com/product-detail/C22433320.html) | 233 | 1.0227 | 1.02
C8, C24 | 2 | 4.7uF / 25V / 10% | TMK212AB7475KG-T
Taiyo Yuden
DigiKey 587-2990-1-ND (https://www.digikey.com/en/products/detail/taiyo-yuden/TMK212AB7475KG-T/2714168) | 718,393 | 0.2600 | 0.52
U3 | 1 | TPS1H200A-Q1 | TPS1H200AQDGNRQ1
Texas Instruments
DigiKey 296-50416-1-ND (https://www.digikey.com/en/products/detail/texas-instruments/TPS1H200AQDGNRQ1/9593381) | 25,656 | 1.7800 | 1.78
U4 | 1 | TPS2553DBVR-1 | TPS2553DBVR-1
Texas Instruments
LCSC C111738 (https://www.lcsc.com/product-detail/C111738.html) | 12,065 | 0.2978 | 0.30
U8 | 1 | TPS613222A | TPS613222ADBVR
Texas Instruments
LCSC C2071163 (https://www.lcsc.com/product-detail/C2071163.html) | 3,545 | 0.3697 | 0.37
