barkinvar/sugerCANe/bom/BOM_per_reference.csv

reference | value | mpn | digikey_sku | footprint | notes
C1 | 47uF | EEE-FK1V470P | PCE3842CT-ND | FRC_Sensor_CAN:CP_Elec_6.3x5.8
C10 | 1uF | CC0805KKX7R9BB105 | 311-1886-1-ND | FRC_Sensor_CAN:C_0805_2012Metric
C101 | 1nF | CC0805JRNPO9BN102 | 311-1122-1-ND | FRC_Sensor_CAN:C_0805_2012Metric
C11 | 100nF | CC0805KRX7R9BB104 | 311-1140-1-ND | FRC_Sensor_CAN:C_0805_2012Metric
C12 | 22uF | CL31A226KAHNNNE | 1276-3047-1-ND | FRC_Sensor_CAN:C_1206_3216Metric
C13 | 22uF | CL31A226KAHNNNE | 1276-3047-1-ND | FRC_Sensor_CAN:C_1206_3216Metric | Third output capacitor budgets for the manufacturer typical DC-bias loss.
C14 | 33nF | CC0805KRX7R9BB333 | 311-1374-1-ND | FRC_Sensor_CAN:C_0805_2012Metric | Hardware latch-off after ~11ms in current limit; allows sensor inrush; no automatic retry.
C2 | 10uF | CL32B106KBJNNWE | 1276-3388-1-ND | FRC_Sensor_CAN:C_1210_3225Metric
C20 | 100nF | CC0805KRX7R9BB104 | 311-1140-1-ND | FRC_Sensor_CAN:C_0805_2012Metric
C201 | 1nF | CC0805JRNPO9BN102 | 311-1122-1-ND | FRC_Sensor_CAN:C_0805_2012Metric
C21 | 100nF | CC0805KRX7R9BB104 | 311-1140-1-ND | FRC_Sensor_CAN:C_0805_2012Metric
C22 | 100nF | CC0805KRX7R9BB104 | 311-1140-1-ND | FRC_Sensor_CAN:C_0805_2012Metric
C23 | 1uF | CC0805KKX7R9BB105 | 311-1886-1-ND | FRC_Sensor_CAN:C_0805_2012Metric | VDDA local capacitor.
C24 | 4.7uF | TMK212AB7475KG-T | 587-2990-1-ND | FRC_Sensor_CAN:C_0805_2012Metric
C25 | 30pF | C0805C300J5GACTU | 399-C0805C300J5GACTUCT-ND | FRC_Sensor_CAN:C_0805_2012Metric
C26 | 30pF | C0805C300J5GACTU | 399-C0805C300J5GACTUCT-ND | FRC_Sensor_CAN:C_0805_2012Metric
C27 | 100nF | CC0805KRX7R9BB104 | 311-1140-1-ND | FRC_Sensor_CAN:C_0805_2012Metric
C28 | 10nF | CC0805KRX7R9BB103 | 311-1136-1-ND | FRC_Sensor_CAN:C_0805_2012Metric
C29 | 10nF | CC0805KRX7R9BB103 | 311-1136-1-ND | FRC_Sensor_CAN:C_0805_2012Metric
C3 | 100nF | CC0805KRX7R9BB104 | 311-1140-1-ND | FRC_Sensor_CAN:C_0805_2012Metric
C301 | 1nF | CC0805JRNPO9BN102 | 311-1122-1-ND | FRC_Sensor_CAN:C_0805_2012Metric
C4 | 22uF | CL31A226KAHNNNE | 1276-3047-1-ND | FRC_Sensor_CAN:C_1206_3216Metric
C40 | 100nF | CC0805KRX7R9BB104 | 311-1140-1-ND | FRC_Sensor_CAN:C_0805_2012Metric
C401 | 1nF | CC0805JRNPO9BN102 | 311-1122-1-ND | FRC_Sensor_CAN:C_0805_2012Metric
C41 | 100nF | CC0805KRX7R9BB104 | 311-1140-1-ND | FRC_Sensor_CAN:C_0805_2012Metric
C42 | 1uF | CC0805KKX7R9BB105 | 311-1886-1-ND | FRC_Sensor_CAN:C_0805_2012Metric
C5 | 22uF | CL31A226KAHNNNE | 1276-3047-1-ND | FRC_Sensor_CAN:C_1206_3216Metric
C50 | 100nF | CC0805KRX7R9BB104 | 311-1140-1-ND | FRC_Sensor_CAN:C_0805_2012Metric
C6 | 100nF | CC0805KRX7R9BB104 | 311-1140-1-ND | FRC_Sensor_CAN:C_0805_2012Metric
C7 | 1uF | CC0805KKX7R9BB105 | 311-1886-1-ND | FRC_Sensor_CAN:C_0805_2012Metric
C8 | 4.7uF | TMK212AB7475KG-T | 587-2990-1-ND | FRC_Sensor_CAN:C_0805_2012Metric
C9 | 100nF | CC0805KRX7R9BB104 | 311-1140-1-ND | FRC_Sensor_CAN:C_0805_2012Metric
D10 | GREEN | LTST-C170KGKT | 160-1414-1-ND | FRC_Sensor_CAN:LED_0805_2012Metric
D101 | SMAJ30A | SMAJ30A | SMAJ30ALFCT-ND | FRC_Sensor_CAN:D_SMA | 30V working standoff; unidirectional transient clamp.
D102 | BAT46W | BAT46W-E3-18 | BAT46W-E3-18GICT-ND | FRC_Sensor_CAN:D_SOD-123
D103 | BAT46W | BAT46W-E3-18 | BAT46W-E3-18GICT-ND | FRC_Sensor_CAN:D_SOD-123
D11 | RED | LTST-C170KRKT | 160-1415-1-ND | FRC_Sensor_CAN:LED_0805_2012Metric
D12 | GREEN | LTST-C170KGKT | 160-1414-1-ND | FRC_Sensor_CAN:LED_0805_2012Metric
D13 | GREEN | LTST-C170KGKT | 160-1414-1-ND | FRC_Sensor_CAN:LED_0805_2012Metric
D14 | GREEN | LTST-C170KGKT | 160-1414-1-ND | FRC_Sensor_CAN:LED_0805_2012Metric
D15 | GREEN | LTST-C170KGKT | 160-1414-1-ND | FRC_Sensor_CAN:LED_0805_2012Metric
D2 | SMBJ18A | SMBJ18A-E3/52 | SMBJ18A-E3/52GICT-ND | FRC_Sensor_CAN:D_SMB | Transient suppression, not sustained overvoltage regulation.
D20 | ESD2CAN24-Q1 | ESD2CAN24DBZRQ1 | 296-ESD2CAN24DBZRQ1CT-ND | FRC_Sensor_CAN:SOT-23
D201 | SMAJ30A | SMAJ30A | SMAJ30ALFCT-ND | FRC_Sensor_CAN:D_SMA | 30V working standoff; unidirectional transient clamp.
D202 | BAT46W | BAT46W-E3-18 | BAT46W-E3-18GICT-ND | FRC_Sensor_CAN:D_SOD-123
D203 | BAT46W | BAT46W-E3-18 | BAT46W-E3-18GICT-ND | FRC_Sensor_CAN:D_SOD-123
D3 | 12V ZENER | MMSZ12T1G | MMSZ12T1GOSCT-ND | FRC_Sensor_CAN:D_SOD-123 | Cathode to Q1 source, anode to gate; protects +/-20V gate rating.
D301 | SMAJ30A | SMAJ30A | SMAJ30ALFCT-ND | FRC_Sensor_CAN:D_SMA | 30V working standoff; unidirectional transient clamp.
D302 | BAT46W | BAT46W-E3-18 | BAT46W-E3-18GICT-ND | FRC_Sensor_CAN:D_SOD-123
D303 | BAT46W | BAT46W-E3-18 | BAT46W-E3-18GICT-ND | FRC_Sensor_CAN:D_SOD-123
D401 | SMAJ30A | SMAJ30A | SMAJ30ALFCT-ND | FRC_Sensor_CAN:D_SMA | 30V working standoff; unidirectional transient clamp.
D402 | BAT46W | BAT46W-E3-18 | BAT46W-E3-18GICT-ND | FRC_Sensor_CAN:D_SOD-123
D403 | BAT46W | BAT46W-E3-18 | BAT46W-E3-18GICT-ND | FRC_Sensor_CAN:D_SOD-123
F1 | 1.5A FAST | 045101.5MRL | F2579CT-ND | FRC_Sensor_CAN:Fuse_Littelfuse-NANO2-451_453 | Secondary protection; feed only from fused robot distribution.
J1 | 2P 5.00mm | 691137710002 | 732-10955-ND | FRC_Sensor_CAN:Wuerth_691137710002
J2 | 2P 5.00mm | 691137710002 | 732-10955-ND | FRC_Sensor_CAN:Wuerth_691137710002
J3 | 2P 5.00mm | 691137710002 | 732-10955-ND | FRC_Sensor_CAN:Wuerth_691137710002
J4 | 3P 5.00mm | 691137710003 | 732-10956-ND | FRC_Sensor_CAN:Wuerth_691137710003
J5 | 3P 5.00mm | 691137710003 | 732-10956-ND | FRC_Sensor_CAN:Wuerth_691137710003
J6 | 3P 5.00mm | 691137710003 | 732-10956-ND | FRC_Sensor_CAN:Wuerth_691137710003
J7 | 3P 5.00mm | 691137710003 | 732-10956-ND | FRC_Sensor_CAN:Wuerth_691137710003
J8 | DEBUG | M20-9980545 | 952-2380-ND | FRC_Sensor_CAN:PinHeader_2x05_P2.54mm_Vertical | Custom 2.54mm service header, NOT standard Cortex pinout. Pin1 voltage reference only; do not feed external power.
JP1 | SELECT | M20-9990245 | 952-2261-ND | FRC_Sensor_CAN:PinHeader_1x02_P2.54mm_Vertical | Momentary reset by shorting pins; no shunt during normal operation.
JP101 | SELECT | M20-9990345 | 952-2263-ND | FRC_Sensor_CAN:PinHeader_1x03_P2.54mm_Vertical | Fit ONE shunt: 1-2=5V, 2-3=VBAT. Never bridge all pins.
JP102 | SELECT | M20-9990245 | 952-2261-ND | FRC_Sensor_CAN:PinHeader_1x02_P2.54mm_Vertical | Open=industrial thresholds; fitted=3.3/5V logic thresholds.
JP103 | SELECT | M20-9980345 | 952-2120-ND | FRC_Sensor_CAN:PinHeader_2x03_P2.54mm_Vertical | ONE horizontal shunt only:1-2=port pullup,3-4=3V3 pullup,5-6=pulldown. Open=driven input.
JP2 | SELECT | M20-9990245 | 952-2261-ND | FRC_Sensor_CAN:PinHeader_1x02_P2.54mm_Vertical | Optional 120-ohm termination: shipped OPEN.
JP201 | SELECT | M20-9990345 | 952-2263-ND | FRC_Sensor_CAN:PinHeader_1x03_P2.54mm_Vertical | Fit ONE shunt: 1-2=5V, 2-3=VBAT. Never bridge all pins.
JP202 | SELECT | M20-9990245 | 952-2261-ND | FRC_Sensor_CAN:PinHeader_1x02_P2.54mm_Vertical | Open=industrial thresholds; fitted=3.3/5V logic thresholds.
JP203 | SELECT | M20-9980345 | 952-2120-ND | FRC_Sensor_CAN:PinHeader_2x03_P2.54mm_Vertical | ONE horizontal shunt only:1-2=port pullup,3-4=3V3 pullup,5-6=pulldown. Open=driven input.
JP301 | SELECT | M20-9990345 | 952-2263-ND | FRC_Sensor_CAN:PinHeader_1x03_P2.54mm_Vertical | Fit ONE shunt: 1-2=5V, 2-3=VBAT. Never bridge all pins.
JP302 | SELECT | M20-9990245 | 952-2261-ND | FRC_Sensor_CAN:PinHeader_1x02_P2.54mm_Vertical | Open=industrial thresholds; fitted=3.3/5V logic thresholds.
JP303 | SELECT | M20-9980345 | 952-2120-ND | FRC_Sensor_CAN:PinHeader_2x03_P2.54mm_Vertical | ONE horizontal shunt only:1-2=port pullup,3-4=3V3 pullup,5-6=pulldown. Open=driven input.
JP401 | SELECT | M20-9990345 | 952-2263-ND | FRC_Sensor_CAN:PinHeader_1x03_P2.54mm_Vertical | Fit ONE shunt: 1-2=5V, 2-3=VBAT. Never bridge all pins.
JP402 | SELECT | M20-9990245 | 952-2261-ND | FRC_Sensor_CAN:PinHeader_1x02_P2.54mm_Vertical | Open=industrial thresholds; fitted=3.3/5V logic thresholds.
JP403 | SELECT | M20-9980345 | 952-2120-ND | FRC_Sensor_CAN:PinHeader_2x03_P2.54mm_Vertical | ONE horizontal shunt only:1-2=port pullup,3-4=3V3 pullup,5-6=pulldown. Open=driven input.
L1 | 10uH | SRP7028A-100M | SRP7028A-100MCT-ND | FRC_Sensor_CAN:L_Bourns_SRP7028A_7.3x6.6mm | 3.5A RMS, 6A saturation; use specified family, not NRND SRP7030.
Q1 | AO4485 | AO4485 | 785-1551-1-ND | FRC_Sensor_CAN:SOIC-8_3.9x4.9mm_P1.27mm | Reverse-polarity PMOS: drain toward input, source toward load. Not a reverse-current blocker when on.
R1 | 101k | RT0805BRD07101KL | 13-RT0805BRD07101KLCT-ND | FRC_Sensor_CAN:R_0805_2012Metric
R10 | 59k | RC0805FR-0759KL | 311-59.0KCRCT-ND | FRC_Sensor_CAN:R_0805_2012Metric
R101 | 110k | RC0805FR-07110KL | 311-110KCRCT-ND | FRC_Sensor_CAN:R_0805_2012Metric
R102 | 110k | RC0805FR-07110KL | 311-110KCRCT-ND | FRC_Sensor_CAN:R_0805_2012Metric
R103 | 20k | RC0805FR-0720KL | 311-20.0KCRCT-ND | FRC_Sensor_CAN:R_0805_2012Metric
R104 | 910k | RC0805FR-07910KL | YAG3336CT-ND | FRC_Sensor_CAN:R_0805_2012Metric
R105 | 10k | RC0805FR-0710KL | 311-10.0KCRCT-ND | FRC_Sensor_CAN:R_0805_2012Metric
R106 | 100k | RC0805FR-07100KL | 311-100KCRCT-ND | FRC_Sensor_CAN:R_0805_2012Metric
R107 | 17.8k | ERJ-6ENF1782V | P17.8KCCT-ND | FRC_Sensor_CAN:R_0805_2012Metric
R108 | 7.15k | RC0805FR-077K15L | 311-7.15KCRCT-ND | FRC_Sensor_CAN:R_0805_2012Metric
R109 | 4.7k | RC2010FK-074K7L | 13-RC2010FK-074K7LCT-ND | FRC_Sensor_CAN:R_2010_5025Metric | Pulldown: >=0.75W; about0.193W at30V. Each bias branch has its own limiting resistor.
R11 | 10k | RC0805FR-0710KL | 311-10.0KCRCT-ND | FRC_Sensor_CAN:R_0805_2012Metric
R110 | 4.7k | RC0805FR-074K7L | 311-4.70KCRCT-ND | FRC_Sensor_CAN:R_0805_2012Metric | Port pullup. Limits current even with multiple bias shunts fitted.
R111 | 4.7k | RC0805FR-074K7L | 311-4.70KCRCT-ND | FRC_Sensor_CAN:R_0805_2012Metric | Logic pullup. Prevents a bias jumper error from shorting the 3.3V rail.
R12 | 100k | RC0805FR-07100KL | 311-100KCRCT-ND | FRC_Sensor_CAN:R_0805_2012Metric
R13 | 1k | RC0805FR-071KL | 311-1.00KCRCT-ND | FRC_Sensor_CAN:R_0805_2012Metric
R14 | 10k | RC0805FR-0710KL | 311-10.0KCRCT-ND | FRC_Sensor_CAN:R_0805_2012Metric | Discharges output and absorbs bias-diode leakage when off; 1.8mA at18V.
R15 | 10k | RC0805FR-0710KL | 311-10.0KCRCT-ND | FRC_Sensor_CAN:R_0805_2012Metric
R2 | 13.7k | RT0805BRD0713K7L | YAG4829CT-ND | FRC_Sensor_CAN:R_0805_2012Metric
R20 | 0 | RC0805JR-070RL | 311-0.0ARCT-ND | FRC_Sensor_CAN:R_0805_2012Metric | Drive-level/startup measurement position. Tune only after oscillator characterization.
R201 | 110k | RC0805FR-07110KL | 311-110KCRCT-ND | FRC_Sensor_CAN:R_0805_2012Metric
R202 | 110k | RC0805FR-07110KL | 311-110KCRCT-ND | FRC_Sensor_CAN:R_0805_2012Metric
R203 | 20k | RC0805FR-0720KL | 311-20.0KCRCT-ND | FRC_Sensor_CAN:R_0805_2012Metric
R204 | 910k | RC0805FR-07910KL | YAG3336CT-ND | FRC_Sensor_CAN:R_0805_2012Metric
R205 | 10k | RC0805FR-0710KL | 311-10.0KCRCT-ND | FRC_Sensor_CAN:R_0805_2012Metric
R206 | 100k | RC0805FR-07100KL | 311-100KCRCT-ND | FRC_Sensor_CAN:R_0805_2012Metric
R207 | 17.8k | ERJ-6ENF1782V | P17.8KCCT-ND | FRC_Sensor_CAN:R_0805_2012Metric
R208 | 7.15k | RC0805FR-077K15L | 311-7.15KCRCT-ND | FRC_Sensor_CAN:R_0805_2012Metric
R209 | 4.7k | RC2010FK-074K7L | 13-RC2010FK-074K7LCT-ND | FRC_Sensor_CAN:R_2010_5025Metric | Pulldown: >=0.75W; about0.193W at30V. Each bias branch has its own limiting resistor.
R21 | 10k | RC0805FR-0710KL | 311-10.0KCRCT-ND | FRC_Sensor_CAN:R_0805_2012Metric
R210 | 4.7k | RC0805FR-074K7L | 311-4.70KCRCT-ND | FRC_Sensor_CAN:R_0805_2012Metric | Port pullup. Limits current even with multiple bias shunts fitted.
R211 | 4.7k | RC0805FR-074K7L | 311-4.70KCRCT-ND | FRC_Sensor_CAN:R_0805_2012Metric | Logic pullup. Prevents a bias jumper error from shorting the 3.3V rail.
R22 | 10k | RC0805FR-0710KL | 311-10.0KCRCT-ND | FRC_Sensor_CAN:R_0805_2012Metric
R23 | 100k | RC0805FR-07100KL | 311-100KCRCT-ND | FRC_Sensor_CAN:R_0805_2012Metric | Measures switched battery output; firmware distinguishes healthy light-load output from U3 open-load FAULT.
R24 | 10k | RC0805FR-0710KL | 311-10.0KCRCT-ND | FRC_Sensor_CAN:R_0805_2012Metric
R25 | 10k | RC0805FR-0710KL | 311-10.0KCRCT-ND | FRC_Sensor_CAN:R_0805_2012Metric
R26 | 10k | RC0805FR-0710KL | 311-10.0KCRCT-ND | FRC_Sensor_CAN:R_0805_2012Metric
R3 | 10k | RC0805FR-0710KL | 311-10.0KCRCT-ND | FRC_Sensor_CAN:R_0805_2012Metric | Q1 gate pull-down; about0.6mA through zener at18V input.
R30 | 1k | RC0805FR-071KL | 311-1.00KCRCT-ND | FRC_Sensor_CAN:R_0805_2012Metric
R301 | 110k | RC0805FR-07110KL | 311-110KCRCT-ND | FRC_Sensor_CAN:R_0805_2012Metric
R302 | 110k | RC0805FR-07110KL | 311-110KCRCT-ND | FRC_Sensor_CAN:R_0805_2012Metric
R303 | 20k | RC0805FR-0720KL | 311-20.0KCRCT-ND | FRC_Sensor_CAN:R_0805_2012Metric
R304 | 910k | RC0805FR-07910KL | YAG3336CT-ND | FRC_Sensor_CAN:R_0805_2012Metric
R305 | 10k | RC0805FR-0710KL | 311-10.0KCRCT-ND | FRC_Sensor_CAN:R_0805_2012Metric
R306 | 100k | RC0805FR-07100KL | 311-100KCRCT-ND | FRC_Sensor_CAN:R_0805_2012Metric
R307 | 17.8k | ERJ-6ENF1782V | P17.8KCCT-ND | FRC_Sensor_CAN:R_0805_2012Metric
R308 | 7.15k | RC0805FR-077K15L | 311-7.15KCRCT-ND | FRC_Sensor_CAN:R_0805_2012Metric
R309 | 4.7k | RC2010FK-074K7L | 13-RC2010FK-074K7LCT-ND | FRC_Sensor_CAN:R_2010_5025Metric | Pulldown: >=0.75W; about0.193W at30V. Each bias branch has its own limiting resistor.
R31 | 1k | RC0805FR-071KL | 311-1.00KCRCT-ND | FRC_Sensor_CAN:R_0805_2012Metric
R310 | 4.7k | RC0805FR-074K7L | 311-4.70KCRCT-ND | FRC_Sensor_CAN:R_0805_2012Metric | Port pullup. Limits current even with multiple bias shunts fitted.
R311 | 4.7k | RC0805FR-074K7L | 311-4.70KCRCT-ND | FRC_Sensor_CAN:R_0805_2012Metric | Logic pullup. Prevents a bias jumper error from shorting the 3.3V rail.
R32 | 1k | RC0805FR-071KL | 311-1.00KCRCT-ND | FRC_Sensor_CAN:R_0805_2012Metric
R33 | 1k | RC0805FR-071KL | 311-1.00KCRCT-ND | FRC_Sensor_CAN:R_0805_2012Metric
R34 | 1k | RC0805FR-071KL | 311-1.00KCRCT-ND | FRC_Sensor_CAN:R_0805_2012Metric
R35 | 1k | RC0805FR-071KL | 311-1.00KCRCT-ND | FRC_Sensor_CAN:R_0805_2012Metric
R4 | 1k | RC0805FR-071KL | 311-1.00KCRCT-ND | FRC_Sensor_CAN:R_0805_2012Metric | Defined bleed for hot bias-diode leakage and input feedback with board supply off; 3.3mA normal load.
R40 | 10k | RC0805FR-0710KL | 311-10.0KCRCT-ND | FRC_Sensor_CAN:R_0805_2012Metric
R401 | 110k | RC0805FR-07110KL | 311-110KCRCT-ND | FRC_Sensor_CAN:R_0805_2012Metric
R402 | 110k | RC0805FR-07110KL | 311-110KCRCT-ND | FRC_Sensor_CAN:R_0805_2012Metric
R403 | 20k | RC0805FR-0720KL | 311-20.0KCRCT-ND | FRC_Sensor_CAN:R_0805_2012Metric
R404 | 910k | RC0805FR-07910KL | YAG3336CT-ND | FRC_Sensor_CAN:R_0805_2012Metric
R405 | 10k | RC0805FR-0710KL | 311-10.0KCRCT-ND | FRC_Sensor_CAN:R_0805_2012Metric
R406 | 100k | RC0805FR-07100KL | 311-100KCRCT-ND | FRC_Sensor_CAN:R_0805_2012Metric
R407 | 17.8k | ERJ-6ENF1782V | P17.8KCCT-ND | FRC_Sensor_CAN:R_0805_2012Metric
R408 | 7.15k | RC0805FR-077K15L | 311-7.15KCRCT-ND | FRC_Sensor_CAN:R_0805_2012Metric
R409 | 4.7k | RC2010FK-074K7L | 13-RC2010FK-074K7LCT-ND | FRC_Sensor_CAN:R_2010_5025Metric | Pulldown: >=0.75W; about0.193W at30V. Each bias branch has its own limiting resistor.
R41 | 10k | RC0805FR-0710KL | 311-10.0KCRCT-ND | FRC_Sensor_CAN:R_0805_2012Metric
R410 | 4.7k | RC0805FR-074K7L | 311-4.70KCRCT-ND | FRC_Sensor_CAN:R_0805_2012Metric | Port pullup. Limits current even with multiple bias shunts fitted.
R411 | 4.7k | RC0805FR-074K7L | 311-4.70KCRCT-ND | FRC_Sensor_CAN:R_0805_2012Metric | Logic pullup. Prevents a bias jumper error from shorting the 3.3V rail.
R42 | 120 | RC1206FR-07120RL | 311-120FRCT-ND | FRC_Sensor_CAN:R_1206_3216Metric | Use termination only if board is the physical end of the CAN trunk.
R5 | 3.9k | RC0805FR-073K9L | 311-3.90KCRCT-ND | FRC_Sensor_CAN:R_0805_2012Metric
R6 | 10k | RC0805FR-0710KL | 311-10.0KCRCT-ND | FRC_Sensor_CAN:R_0805_2012Metric
R7 | 100k | RC0805FR-07100KL | 311-100KCRCT-ND | FRC_Sensor_CAN:R_0805_2012Metric
R8 | 4.7k | RC0805FR-074K7L | 311-4.70KCRCT-ND | FRC_Sensor_CAN:R_0805_2012Metric
R9 | 10k | RC0805FR-0710KL | 311-10.0KCRCT-ND | FRC_Sensor_CAN:R_0805_2012Metric
U1 | LMR51420XDDCR | LMR51420XDDCR | 296-LMR51420XDDCRCT-ND | FRC_Sensor_CAN:TSOT-23-6
U2 | AP2112K-3.3 | AP2112K-3.3TRG1 | AP2112K-3.3TRG1DICT-ND | FRC_Sensor_CAN:SOT-23-5
U3 | TPS1H200A-Q1 | TPS1H200AQDGNRQ1 | 296-50416-1-ND | FRC_Sensor_CAN:TI_DGN0008K_HVSSOP8_EP
U4 | TPS2553DBVR-1 | TPS2553DBVR-1 | 296-39380-1-ND | FRC_Sensor_CAN:SOT-23-6
U5 | STM32F042K6T6 | STM32F042K6T6 | 497-14647-ND | FRC_Sensor_CAN:LQFP-32_7x7mm_P0.8mm
U6 | TCAN3413DR | TCAN3413DR | 296-TCAN3413DRCT-ND | FRC_Sensor_CAN:SOIC-8_3.9x4.9mm_P1.27mm
U7 | LM2901BIDR | LM2901BIDR | 296-LM2901BIDRCT-ND | FRC_Sensor_CAN:SOIC-14_3.9x8.7mm_P1.27mm
Y1 | 8MHz 18pF | ABM3B-8.000MHZ-B2-T | 535-9720-1-ND | FRC_Sensor_CAN:Abracon_ABM3B_5.0x3.2mm | Abracon recommended land pattern: 1.8x1.2mm pads on 4.0x2.4mm centers; pads 2/4 ground.
