barkinvar/sugerCANe/current/bom/BOM_grouped.csv

MPN | Manufacturer | Quantity | References | Value | Footprint | Voltage | Tolerance | Power_W | Dielectric | Assembly | Supplier | Supplier_part | LCSC_part | MOQ | Multiple | Unit_USD_first_tier | Extended_USD_first_tier | Observed_stock | Checked_date | Supplier_URL | DigiKey_SKU | Factory_stock_status | Component_notes
0451003.MRL | Littelfuse | 1 | F1 | 3A FAST | FRC_Sensor_CAN:Fuse_Littelfuse-NANO2-451_453 |  |  |  |  | Factory SMT | JLCPCB | C13982 | C13982 | 1 | 1 | 0.2556 | 0.2556 | 45148 | 2026-09-10 | https://jlcpcb.com/partdetail/C13982 | F2583CT-ND | Public JLC stock sufficient for 10 boards plus allowance; not reserved | Secondary 3 A fast fuse. Feed only from a protected FRC distribution branch; board fuse does not replace the branch fuse.
0805W8F1001T5E | UNI-ROYAL | 4 | R4, R110, R210, R310 | 1k | FRC_Sensor_CAN:R_0805_2012Metric |  | 1% | 0.125 |  | Factory SMT | JLCPCB | C17513 | C17513 | 1 | 1 | 0.0042 | 0.0168 | 29728751 | 2026-09-10 | https://jlcpcb.com/partdetail/C17513 |  | Public JLC stock sufficient for 10 boards plus allowance; not reserved | 3V3 bleed retained for conservative powered-off leakage budget; 3.3 mA load.
0805W8F1002T5E | UNI-ROYAL | 12 | R3, R21, R22, R40, R41, R105, R205, R305, R52, R71, R75, R31 | 10k | FRC_Sensor_CAN:R_0805_2012Metric |  | 1% | 0.125 |  | Factory SMT | JLCPCB | C17414 | C17414 | 1 | 1 | 0.0039 | 0.0468 | 52860584 | 2026-09-10 | https://jlcpcb.com/partdetail/C17414 |  | Public JLC stock sufficient for 10 boards plus allowance; not reserved | Gate pull-down; maximum 1 mA nominal zener current at 22 V input.
0805W8F1003T5E | UNI-ROYAL | 8 | R50, R111, R112, R211, R212, R311, R312, R70 | 100k | FRC_Sensor_CAN:R_0805_2012Metric |  | 1% | 0.125 |  | Factory SMT | JLCPCB | C149504 | C149504 | 1 | 1 | 0.0059 | 0.0472 | 4745764 | 2026-09-10 | https://jlcpcb.com/partdetail/C149504 |  | Public JLC stock sufficient for 10 boards plus allowance; not reserved
0805W8F1152T5E | UNI-ROYAL | 1 | R61 | 11.5k | FRC_Sensor_CAN:R_0805_2012Metric |  | 1% | 0.125 |  | Factory SMT | JLCPCB | C17418 | C17418 | 1 | 1 | 0.0041 | 0.0041 | 3238 | 2026-09-10 | https://jlcpcb.com/partdetail/C17418 |  | Public JLC stock sufficient for 10 boards plus allowance; not reserved | Feedback lower arm, 1%. 12.003V nominal with 1.238V reference.
0805W8F2203T5E | UNI-ROYAL | 3 | R101, R201, R301 | 220k | FRC_Sensor_CAN:R_0805_2012Metric |  | 1% | 0.125 |  | Factory SMT | JLCPCB | C17556 | C17556 | 1 | 1 | 0.005 | 0.015 | 289378 | 2026-09-10 | https://jlcpcb.com/partdetail/C17556 |  | Public JLC stock sufficient for 10 boards plus allowance; not reserved | One series resistor; loses Rev B single-resistor-short tolerance. 150 V working rating; input 0-30 V target.
0805W8F3300T5E | UNI-ROYAL | 1 | R30 | 330 | FRC_Sensor_CAN:R_0805_2012Metric |  | 1% | 0.125 |  | Factory SMT | JLCPCB | C17630 | C17630 | 1 | 1 | 0.0054 | 0.0054 | 2316763 | 2026-09-10 | https://jlcpcb.com/partdetail/C17630 |  | Public JLC stock sufficient for 10 boards plus allowance; not reserved | 330 ohm LED data series resistor; short local route after level buffer.
0805W8F5231T5E | UNI-ROYAL | 1 | R51 | 5.23k | FRC_Sensor_CAN:R_0805_2012Metric |  | 1% | 0.125 |  | Factory SMT | JLCPCB | C17739 | C17739 | 1 | 1 | 0.0023 | 0.0023 | 2225 | 2026-09-10 | https://jlcpcb.com/partdetail/C17739 |  | Public JLC stock sufficient for 10 boards plus allowance; not reserved
0805W8F5902T5E | UNI-ROYAL | 1 | R10 | 59k | FRC_Sensor_CAN:R_0805_2012Metric |  | 1% | 0.125 |  | Factory SMT | JLCPCB | C17763 | C17763 | 1 | 1 | 0.0023 | 0.0023 | 6289 | 2026-09-10 | https://jlcpcb.com/partdetail/C17763 |  | Public JLC stock sufficient for 10 boards plus allowance; not reserved
1206W4F1200T5E | UNI-ROYAL | 1 | R42 | 120 | FRC_Sensor_CAN:R_1206_3216Metric |  | 1% | 0.25 |  | Factory SMT | JLCPCB | C17909 | C17909 | 1 | 1 | 0.0074 | 0.0074 | 706352 | 2026-09-10 | https://jlcpcb.com/partdetail/C17909 |  | Public JLC stock sufficient for 10 boards plus allowance; not reserved | Use termination only if board is the physical end of the CAN trunk.
1824420000 | Weidmuller | 3 | J1, J2, J3 | 2P PUSH 3.5mm | FRC_Sensor_CAN:Weidmuller_LSF_90_2P |  |  |  |  | Hand solder | DigiKey | 281-2020-ND |  | 1 | 1 | 1.63 | 4.89 | 12775 | 2026-09-10 | https://www.digikey.com/en/products/detail/weidm%C3%BCller/1824420000/1094358 | 281-2020-ND | External procurement candidate; JLCPCB stock not confirmed | Horizontal /90 push-in; 8 mm strip, 7 mm pin-row spacing, two solder pins per pole.
1824430000 | Weidmuller | 3 | J4, J5, J6 | 3P PUSH 3.5mm | FRC_Sensor_CAN:Weidmuller_LSF_90_3P |  |  |  |  | Hand solder | DigiKey | 281-2021-ND |  | 1 | 1 | 2.21 | 6.63 | 1698 | 2026-09-10 | https://www.digikey.com/en/products/detail/weidm%C3%BCller/1824430000/1094359 | 281-2021-ND | External procurement candidate; JLCPCB stock not confirmed | Horizontal /90 push-in; 8 mm strip, 7 mm pin-row spacing, two solder pins per pole.
ABM3B-8.000MHZ-B2-T | Abracon | 1 | Y1 | 8MHz 18pF | FRC_Sensor_CAN:Abracon_ABM3B_5.0x3.2mm |  |  |  |  | Factory SMT | JLCPCB | C83312 | C83312 | 1 | 1 | 0.5892 | 0.5892 | 6741 | 2026-09-10 | https://jlcpcb.com/partdetail/C83312 | 535-9720-1-ND | Public JLC stock sufficient for 10 boards plus allowance; not reserved | Abracon recommended land pattern: 1.8x1.2mm pads on 4.0x2.4mm centers; pads 2/4 ground.
AO3401A | Alpha & Omega Semiconductor | 3 | Q101, Q201, Q301 | AO3401A | FRC_Sensor_CAN:SOT-23 |  |  |  |  | Factory SMT | JLCPCB | C15127 | C15127 | 1 | 1 | 0.0943 | 0.2829 | 519549 | 2026-09-10 | https://jlcpcb.com/partdetail/C15127 |  | Public JLC stock sufficient for 10 boards plus allowance; not reserved | 3.3 V bias source, active-low gate. BAT46W isolates positive field voltage.
AO4485 | Alpha & Omega Semiconductor | 1 | Q1 | AO4485 | FRC_Sensor_CAN:SOIC-8_3.9x4.9mm_P1.27mm |  |  |  |  | Factory SMT | JLCPCB | C51499 | C51499 | 1 | 1 | 0.2951 | 0.2951 | 72841 | 2026-09-10 | https://jlcpcb.com/partdetail/C51499 | 785-1551-1-ND | Public JLC stock sufficient for 10 boards plus allowance; not reserved | Reverse-polarity PMOS: drain toward input, source toward load. Not a reverse-current blocker when on.
AP2112K-3.3TRG1 | Diodes Incorporated | 1 | U2 | AP2112K-3.3 | FRC_Sensor_CAN:SOT-23-5 |  |  |  |  | Factory SMT | JLCPCB | C51118 | C51118 | 1 | 1 | 0.1712 | 0.1712 | 60472 | 2026-09-10 | https://jlcpcb.com/partdetail/C51118 | AP2112K-3.3TRG1DICT-ND | Public JLC stock sufficient for 10 boards plus allowance; not reserved
B240A-13-F | Diodes Incorporated | 2 | D4, D5 | B240A | FRC_Sensor_CAN:D_SMA |  |  |  |  | Factory SMT | JLCPCB | C92506 | C92506 | 1 | 1 | 0.0951 | 0.1902 | 163590 | 2026-09-10 | https://jlcpcb.com/partdetail/C92506 |  | Public JLC stock sufficient for 10 boards plus allowance; not reserved | 2A 40V Schottky rectifier; cathode on BOOST_12V, before U9 output protection.
BAT46W-E3-18 | Vishay | 3 | D102, D202, D302 | BAT46W | FRC_Sensor_CAN:D_SOD-123 |  |  |  |  | Factory SMT | JLCPCB | C5557780 | C5557780 | 1 | 1 | 0.1309 | 0.3927 | 4733 | 2026-09-10 | https://jlcpcb.com/partdetail/C5557780 | BAT46W-E3-18GICT-ND | Public JLC stock sufficient for 10 boards plus allowance; not reserved
BSS138BK,215 | Nexperia | 5 | Q102, Q202, Q302, Q2, Q3 | BSS138BK | FRC_Sensor_CAN:SOT-23 |  |  |  |  | Factory SMT | JLCPCB | C282529 | C282529 | 1 | 1 | 0.0669 | 0.3345 | 70842 | 2026-09-10 | https://jlcpcb.com/partdetail/C282529 |  | Public JLC stock sufficient for 10 boards plus allowance; not reserved | 60 V bias sink, active-high gate; 6.5 ohm max at VGS=2.5 V, 25 C.
CC0805JRNPO9BN102 | YAGEO | 3 | C101, C201, C301 | 1nF | FRC_Sensor_CAN:C_0805_2012Metric | 50V | 5% |  | C0G | Factory SMT | JLCPCB | C62774 | C62774 | 1 | 1 | 0.0137 | 0.0411 | 1141135 | 2026-09-10 | https://jlcpcb.com/partdetail/C62774 |  | Public JLC stock sufficient for 10 boards plus allowance; not reserved
CC0805JRNPO9BN200 | YAGEO | 2 | C25, C26 | 20pF | FRC_Sensor_CAN:C_0805_2012Metric | 50V | 5% |  | C0G | Factory SMT | JLCPCB | C105173 | C105173 | 1 | 1 | 0.0114 | 0.0228 | 534289 | 2026-09-10 | https://jlcpcb.com/partdetail/C105173 |  | Public JLC stock sufficient for 10 boards plus allowance; not reserved
CC0805KRX7R9BB333 | YAGEO | 1 | C69 | 33nF | FRC_Sensor_CAN:C_0805_2012Metric | 50V | 10% |  | X7R | Factory SMT | JLCPCB | C107150 | C107150 | 1 | 1 | 0.012 | 0.012 | 1799721 | 2026-09-10 | https://jlcpcb.com/partdetail/C107150 | 311-1374-1-ND | Public JLC stock sufficient for 10 boards plus allowance; not reserved | 13k/33nF Type-II compensation; low crossover analytical screen, physical loop qualification required.
CL21B103KBANNNC | Samsung Electro-Mechanics | 2 | C72, C73 | 10nF | FRC_Sensor_CAN:C_0805_2012Metric | 50V | 5% |  | X7R | Factory SMT | JLCPCB | C1710 | C1710 | 1 | 1 | 0.013 | 0.026 | 2603295 | 2026-09-10 | https://jlcpcb.com/partdetail/C1710 |  | Public JLC stock sufficient for 10 boards plus allowance; not reserved | ADC anti-noise filter. Use long ADC acquisition time; firmware also measures internal VREFINT.
CL21B104KCFNNNE | Samsung Electro-Mechanics | 14 | C3, C6, C11, C20, C21, C22, C27, C40, C41, C50, C51, C66, C74, C75 | 100nF | FRC_Sensor_CAN:C_0805_2012Metric | 100V | 10% |  | X7R | Factory SMT | JLCPCB | C28233 | C28233 | 1 | 1 | 0.0407 | 0.5698 | 1386629 | 2026-09-10 | https://jlcpcb.com/partdetail/C28233 |  | Public JLC stock sufficient for 10 boards plus allowance; not reserved
CL21B105KBFNNNE | Samsung Electro-Mechanics | 5 | C7, C23, C61, C65, C71 | 1uF | FRC_Sensor_CAN:C_0805_2012Metric | 50V | 10% |  | X7R | Factory SMT | JLCPCB | C28323 | C28323 | 1 | 1 | 0.0399 | 0.1995 | 3074976 | 2026-09-10 | https://jlcpcb.com/partdetail/C28323 |  | Public JLC stock sufficient for 10 boards plus allowance; not reserved | Retained sourcing substitution: value, dielectric, voltage, tolerance and footprint retained; assess effective capacitance.
CL21B473KBCNNNC | Samsung Electro-Mechanics | 1 | C70 | 47nF | FRC_Sensor_CAN:C_0805_2012Metric | 50V | 10% |  | X7R | Factory SMT | JLCPCB | C53134 | C53134 | 1 | 1 | 0.0173 | 0.0173 | 215438 | 2026-09-10 | https://jlcpcb.com/partdetail/C53134 |  | Public JLC stock sufficient for 10 boards plus allowance; not reserved | Separate sensor output ramp; approximately 13ms ideal ramp, longer if current limited.
CL21B475KAFNNNE | Samsung Electro-Mechanics | 2 | C8, C24 | 4.7uF | FRC_Sensor_CAN:C_0805_2012Metric | 25V | 10% |  | X7R | Factory SMT | JLCPCB | C98195 | C98195 | 1 | 1 | 0.0608 | 0.1216 | 197514 | 2026-09-10 | https://jlcpcb.com/partdetail/C98195 |  | Public JLC stock sufficient for 10 boards plus allowance; not reserved | Retained sourcing substitution: value, dielectric, voltage, tolerance and footprint retained; assess effective capacitance.
CL31A226KAHNNNE | Samsung Electro-Mechanics | 8 | C4, C5, C13, C12, C60, C62, C63, C64 | 22uF | FRC_Sensor_CAN:C_1206_3216Metric | 25V | 10% |  | X5R | Factory SMT | JLCPCB | C12891 | C12891 | 1 | 1 | 0.1694 | 1.3552 | 775325 | 2026-09-10 | https://jlcpcb.com/partdetail/C12891 | 1276-3047-1-ND | Public JLC stock sufficient for 10 boards plus allowance; not reserved | Three-part 5 V buck output bank; verify effective capacitance, ripple and load transient on prototype.
CL32B106KBJNNWE | Samsung Electro-Mechanics | 1 | C2 | 10uF | FRC_Sensor_CAN:C_1210_3225Metric | 50V | 10% |  | X7R | Factory SMT | JLCPCB | C3844168 | C3844168 | 1 | 1 | 0.7145 | 0.7145 | 626 | 2026-09-10 | https://jlcpcb.com/partdetail/C3844168 | 1276-3388-1-ND | Public JLC stock sufficient for 10 boards plus allowance; not reserved
EEEFT1H470AP | Panasonic | 1 | C1 | 47uF | FRC_Sensor_CAN:CP_Panasonic_FT_6.3x5.8 | 50V | 20% |  |  | Factory SMT | JLCPCB | C92059 | C92059 | 1 | 1 | 0.3573 | 0.3573 | 1695 | 2026-09-10 | https://jlcpcb.com/partdetail/C92059 |  | Public JLC stock sufficient for 10 boards plus allowance; not reserved | Factory fitted. 47uF 50V 20%; 195mA ripple, 0.68ohm max ESR. Panasonic profile (5); respect dwell limits.
ESD2CAN24DBZRQ1 | Texas Instruments | 1 | D20 | ESD2CAN24-Q1 | FRC_Sensor_CAN:SOT-23 |  |  |  |  | Factory SMT | JLCPCB | C5736151 | C5736151 | 1 | 1 | 0.3486 | 0.3486 | 2427 | 2026-09-10 | https://jlcpcb.com/partdetail/C5736151 | 296-ESD2CAN24DBZRQ1CT-ND | Public JLC stock sufficient for 10 boards plus allowance; not reserved
LM339LVDR | Texas Instruments | 1 | U7 | LM339LV | FRC_Sensor_CAN:SOIC-14_3.9x8.7mm_P1.27mm |  |  |  |  | Factory SMT | JLCPCB | C22427665 | C22427665 | 1 | 1 | 0.5859 | 0.5859 | 110 | 2026-09-10 | https://jlcpcb.com/partdetail/C22427665 | 296-LM339LVDRCT-ND | Public JLC stock sufficient for 10 boards plus allowance; not reserved | Three input comparators retained. Fourth comparator inputs tied to defined rails and output unconnected; rail measurements now use MCU ADC.
LMR51430XDDCR | Texas Instruments | 1 | U1 | LMR51430XDDCR | FRC_Sensor_CAN:TSOT-23-6 |  |  |  |  | Factory SMT | JLCPCB | C5185863 | C5185863 | 1 | 1 | 0.8479 | 0.8479 | 8835 | 2026-09-10 | https://jlcpcb.com/partdetail/C5185863 |  | Public JLC stock sufficient for 10 boards plus allowance; not reserved
M22-2010305 | Harwin | 3 | JP101, JP201, JP301 | 5V / 12V | FRC_Sensor_CAN:PinHeader_1x03_P2.00mm_Vertical |  |  |  |  | Hand solder | DigiKey | 952-2274-ND |  | 1 | 1 | 0.22 | 0.66 | 35632 | 2026-09-10 | https://www.digikey.com/en/products/detail/harwin-inc/M22-2010305/3728238 | 952-2274-ND | Hand solder; do not include in SMT BOM | Hand-fit 2 mm header. One removable SPN02SVEN-RC shunt: 1-2=5 V, 2-3=12 V, absent=off. Change only with power off. Ship shunts loose.
MMSZ12T1G | onsemi | 1 | D3 | 12V ZENER | FRC_Sensor_CAN:D_SOD-123 |  |  |  |  | Factory SMT | JLCPCB | C72599 | C72599 | 1 | 1 | 0.0723 | 0.0723 | 6517 | 2026-09-10 | https://jlcpcb.com/partdetail/C72599 | MMSZ12T1GOSCT-ND | Public JLC stock sufficient for 10 boards plus allowance; not reserved | Cathode to Q1 source, anode to gate; protects +/-20V gate rating.
PM254V-12-10P-H85 | XFCN | 1 | J8 | 2x5 SERVICE SOCKET 2.54mm | FRC_Sensor_CAN:Service_2x05_P2.54mm |  |  |  |  | Hand solder | LCSC | C492399 | C492399 | 5 | 5 | 0.1158 | 0.1158 | 34965 | 2026-09-10 | https://www.lcsc.com/product-detail/C492399.html |  | LCSC stock observed; user hand-solders socket. Undiscounted price; not a factory allocation. | Hand-solder recessed female 2x5 2.54mm socket. CUSTOM pinout; see wiring drawing. Pin6 is target VTref sense only, never power from probe. 1.10mm finished holes.
RC0805FR-0713KL | YAGEO | 1 | R63 | 13k | FRC_Sensor_CAN:R_0805_2012Metric |  | 1% | 0.125 |  | Factory SMT | JLCPCB | C137592 | C137592 | 1 | 1 | 0.0055 | 0.0055 | 13478 | 2026-09-10 | https://jlcpcb.com/partdetail/C137592 | 311-13.0KCRCT-ND | Public JLC stock sufficient for 10 boards plus allowance; not reserved | 13k compensation resistor; 33nF lowers compensation zero for derated output bank.
RC0805FR-0720KL | YAGEO | 3 | R103, R203, R303 | 20k | FRC_Sensor_CAN:R_0805_2012Metric |  | 1% | 0.125 |  | Factory SMT | JLCPCB | C114566 | C114566 | 1 | 1 | 0.0079 | 0.0237 | 1908886 | 2026-09-10 | https://jlcpcb.com/partdetail/C114566 | 311-20.0KCRCT-ND | Public JLC stock sufficient for 10 boards plus allowance; not reserved
RC0805FR-072K61L | YAGEO | 1 | R62 | 2.61k | FRC_Sensor_CAN:R_0805_2012Metric |  | 1% | 0.125 |  | Factory SMT | JLCPCB | C273965 | C273965 | 1 | 1 | 0.0075 | 0.0075 | 2680 | 2026-09-10 | https://jlcpcb.com/partdetail/C273965 |  | Public JLC stock sufficient for 10 boards plus allowance; not reserved | Nominal output current limit about 357mA; user load rating remains 300mA shared on 12V.
RC0805FR-072M2L | YAGEO | 3 | R104, R204, R304 | 2.2M | FRC_Sensor_CAN:R_0805_2012Metric |  | 1% | 0.125 |  | Factory SMT | JLCPCB | C137552 | C137552 | 1 | 1 | 0.0073 | 0.0219 | 6844 | 2026-09-10 | https://jlcpcb.com/partdetail/C137552 | 311-2.20MCRCT-ND | Public JLC stock sufficient for 10 boards plus allowance; not reserved | Positive feedback; fixed Schmitt thresholds with shared reference.
RC0805JR-070RL | YAGEO | 1 | R20 | 0 | FRC_Sensor_CAN:R_0805_2012Metric |  | jumper | 0.125 |  | Factory SMT | JLCPCB | C96345 | C96345 | 1 | 1 | 0.0066 | 0.0066 | 2038660 | 2026-09-10 | https://jlcpcb.com/partdetail/C96345 | 311-0.0ARCT-ND | Public JLC stock sufficient for 10 boards plus allowance; not reserved | Drive-level/startup measurement position. Tune only after oscillator characterization.
RC1206FR-0710KL | YAGEO | 3 | R109, R209, R309 | 10k | FRC_Sensor_CAN:R_1206_3216Metric |  | 1% | 0.25 |  | Factory SMT | JLCPCB | C132649 | C132649 | 1 | 1 | 0.0111 | 0.0333 | 1934977 | 2026-09-10 | https://jlcpcb.com/partdetail/C132649 | 311-10.0KFRCT-ND | Public JLC stock sufficient for 10 boards plus allowance; not reserved | Electronically switched 10k pulldown; 0.09 W worst at 30 V, 1206 0.25 W.
RT0805BRD07100KL | YAGEO | 6 | R60, R65, R66, R68, R72, R73 | 100k | FRC_Sensor_CAN:R_0805_2012Metric |  | 0.1% | 0.125 |  | Factory SMT | JLCPCB | C122537 | C122537 | 1 | 1 | 0.0437 | 0.2622 | 533083 | 2026-09-10 | https://jlcpcb.com/partdetail/C122537 | YAG1759CT-ND | Public JLC stock sufficient for 10 boards plus allowance; not reserved | Feedback upper arm, retained 0.1% 100k.
RT0805BRD07102KL | YAGEO | 1 | R1 | 102k | FRC_Sensor_CAN:R_0805_2012Metric |  | 0.1% | 0.125 |  | Factory SMT | JLCPCB | C865126 | C865126 | 1 | 1 | 0.0471 | 0.0471 | 9215 | 2026-09-10 | https://jlcpcb.com/partdetail/C865126 | YAG4817CT-ND | Public JLC stock sufficient for 10 boards plus allowance; not reserved | Precision feedback top resistor; 5.067 V nominal internal rail.
RT0805BRD0712K1L | YAGEO | 1 | R69 | 12.1k | FRC_Sensor_CAN:R_0805_2012Metric |  | 0.1% | 0.125 |  | Factory SMT | JLCPCB | C865169 | C865169 | 1 | 1 | 0.0533 | 0.0533 | 6666 | 2026-09-10 | https://jlcpcb.com/partdetail/C865169 |  | Public JLC stock sufficient for 10 boards plus allowance; not reserved
RT0805BRD0713K7L | YAGEO | 1 | R2 | 13.7k | FRC_Sensor_CAN:R_0805_2012Metric |  | 0.1% | 0.125 |  | Factory SMT | JLCPCB | C865183 | C865183 | 1 | 1 | 0.0468 | 0.0468 | 89 | 2026-09-10 | https://jlcpcb.com/partdetail/C865183 | YAG4829CT-ND | Public JLC stock sufficient for 10 boards plus allowance; not reserved | Precision feedback bottom resistor; sets 5.067 V with R1=102k.
RT0805BRD0720KL | YAGEO | 2 | R67, R74 | 20k | FRC_Sensor_CAN:R_0805_2012Metric |  | 0.1% | 0.125 |  | Factory SMT | JLCPCB | C469660 | C469660 | 1 | 1 | 0.0743 | 0.1486 | 26705 | 2026-09-10 | https://jlcpcb.com/partdetail/C469660 |  | Public JLC stock sufficient for 10 boards plus allowance; not reserved
SK6805-EC15 | OPSCO Optoelectronics | 1 | D10 | SK6805-EC15 | FRC_Sensor_CAN:LED_SK6805_EC15 |  |  |  |  | Factory SMT | JLCPCB | C2890035 | C2890035 | 1 | 1 | 0.0995 | 0.0995 | 233469 | 2026-09-10 | https://jlcpcb.com/partdetail/C2890035 |  | Public JLC stock sufficient for 10 boards plus allowance; not reserved | Single addressable RGB indicator; internal 5V, independent of protected sensor rails. OPSCO A/1 pinout and GRB data. No generic WS2812 substitution; future light pipe clearance above D10.
SMAJ13A-13-F | Diodes Incorporated | 1 | D6 | SMAJ13A | FRC_Sensor_CAN:D_SMA |  |  |  |  | Factory SMT | JLCPCB | C110519 | C110519 | 1 | 1 | 0.1241 | 0.1241 | 12888 | 2026-09-10 | https://jlcpcb.com/partdetail/C110519 |  | Public JLC stock sufficient for 10 boards plus allowance; not reserved | Local eFuse input transient clamp. Review source energy; not a sustained overvoltage regulator.
SMAJ30A | Littelfuse | 3 | D101, D201, D301 | SMAJ30A | FRC_Sensor_CAN:D_SMA |  |  |  |  | Factory SMT | JLCPCB | C148230 | C148230 | 1 | 1 | 0.1454 | 0.4362 | 29233 | 2026-09-10 | https://jlcpcb.com/partdetail/C148230 | SMAJ30ALFCT-ND | Public JLC stock sufficient for 10 boards plus allowance; not reserved | 30V working standoff; unidirectional transient clamp.
SMBJ22A-E3/52 | Vishay | 1 | D2 | SMBJ22A | FRC_Sensor_CAN:D_SMB |  |  |  |  | Factory SMT | JLCPCB | C3698580 | C3698580 | 1 | 1 | 0.4671 | 0.4671 | 177 | 2026-09-10 | https://jlcpcb.com/partdetail/C3698580 | SMBJ22A-E3/52GICT-ND | Public JLC stock sufficient for 10 boards plus allowance; not reserved | 22 V continuous standoff; 35.5 V specified pulse clamp. Bench-check overshoot. Not sustained overvoltage regulation.
SN74AHCT1G125DBVR | Texas Instruments | 1 | U10 | SN74AHCT1G125 | FRC_Sensor_CAN:SOT-23-5 |  |  |  |  | Factory SMT | JLCPCB | C7484 | C7484 | 1 | 1 | 0.1001 | 0.1001 | 16208 | 2026-09-10 | https://jlcpcb.com/partdetail/C7484 |  | Public JLC stock sufficient for 10 boards plus allowance; not reserved | 5V AHCT buffer accepts 3.3V MCU data. OE_N grounded. R31 holds input LOW while MCU reset; LED is a software indicator, not an independent power-good signal.
SRP5030TA-3R3M | Bourns | 1 | L2 | 3.3uH | FRC_Sensor_CAN:L_Bourns_SRP5030T |  |  |  |  | Factory SMT | JLCPCB | C2042118 | C2042118 | 1 | 1 | 2.3956 | 2.3956 | 39 | 2026-09-10 | https://jlcpcb.com/partdetail/C2042118 | SRP5030TA-3R3MCT-ND | Public JLC stock sufficient for 10 boards plus allowance; not reserved | 3.3uH; 5A RMS and 8A at 20% inductance loss. Output eFuse prevents a sensor short directly discharging through this inductor.
SRP7028A-8R2M | BOURNS | 1 | L1 | 8.2uH | FRC_Sensor_CAN:L_Bourns_SRP7028A_7.3x6.6mm |  |  |  |  | Factory SMT | JLCPCB | C2041815 | C2041815 | 1 | 1 | 1.8407 | 1.8407 | 111 | 2026-09-10 | https://jlcpcb.com/partdetail/C2041815 |  | Public JLC stock sufficient for 10 boards plus allowance; not reserved | 4A RMS, 7.5A saturation; paired with 3A LMR51430. Use specified SRP7028A family.
STM32F042K6T6 | STMicroelectronics | 1 | U5 | STM32F042K6T6 | FRC_Sensor_CAN:LQFP-32_7x7mm_P0.8mm |  |  |  |  | Hand solder | DigiKey | 497-14647-ND | C69216 | 1 | 1 | 4.34 | 4.34 | 3071 | 2026-09-10 | https://www.digikey.com/en/products/detail/stmicroelectronics/STM32F042K6T6/4815294 | 497-14647-ND | User buys from DigiKey and hand solders U5; excluded from factory BOM, CPL and paste. Stock is not reserved. | PA0/1/2 digital sensors; PA5/6/7 pull-up gates; PB5/PB6/PB4 pull-down gates. PB0/PB1 measure sensor rails. PA15 enables 5V, PB7 high disables 12V. SWD/UART/CAN retained.
TCAN3413DR | Texas Instruments | 1 | U6 | TCAN3413DR | FRC_Sensor_CAN:SOIC-8_3.9x4.9mm_P1.27mm |  |  |  |  | Factory SMT | JLCPCB | C22433320 | C22433320 | 1 | 1 | 1.1539 | 1.1539 | 2400 | 2026-09-10 | https://jlcpcb.com/partdetail/C22433320 | 296-TCAN3413DRCT-ND | Public JLC stock sufficient for 10 boards plus allowance; not reserved
TPS2553DBVR-1 | Texas Instruments | 1 | U4 | TPS2553DBVR-1 | FRC_Sensor_CAN:SOT-23-6 |  |  |  |  | Factory SMT | JLCPCB | C111738 | C111738 | 1 | 1 | 0.2912 | 0.2912 | 13060 | 2026-09-10 | https://jlcpcb.com/partdetail/C111738 | 296-39380-1-ND | Public JLC stock sufficient for 10 boards plus allowance; not reserved | Independent 5 V hardware current limit; EN is MCU controlled with an external default-off pull-down. Exact TPS2553-1 latch-off variant.
TPS259620DDAR | Texas Instruments | 1 | U9 | TPS259620DDAR | FRC_Sensor_CAN:TPS2596_DDA8 |  |  |  |  | Factory SMT | JLCPCB | C2155773 | C2155773 | 1 | 1 | 0.8154 | 0.8154 | 25 | 2026-09-10 | https://jlcpcb.com/partdetail/C2155773 |  | Public JLC stock sufficient for 10 boards plus allowance; not reserved | Output-side eFuse. Exact latch-off TPS259620; 2.61k current setting, 47nF output slew. OVCSEL intentionally open for 13.8V-class fault clamp. MCU Q2 can disable/reset; no automatic retries or reverse-power support.
TPS61085DGKR | Texas Instruments | 1 | U8 | TPS61085DGKR | FRC_Sensor_CAN:VSSOP-8_3x3mm_P0.65mm |  |  |  |  | Factory SMT | JLCPCB | C113659 | C113659 | 1 | 1 | 0.6006 | 0.6006 | 2041 | 2026-09-10 | https://jlcpcb.com/partdetail/C113659 |  | Public JLC stock sufficient for 10 boards plus allowance; not reserved | 5 V-fed boost, 1.2 MHz. Its output reservoir is isolated from sensor shorts and inrush by U9. No input-side sensor limiter.
