barkinvar/sugerCANe/current/bom/DigiKey_10_boards.csv

Part | Quantity | Reference
281-2020-ND | 30 | J1, J2, J3
281-2021-ND | 30 | J4, J5, J6
952-2274-ND | 30 | JP101, JP201, JP301
497-14647-ND | 12 | U5 + 2 spare MCUs
S9340-ND | 30 | Loose closed-top voltage caps
