barkinvar/sugerCANe/current/bom/DigiKey_5_boards.csv

Part | Quantity | Reference
281-2020-ND | 15 | J1, J2, J3
281-2021-ND | 15 | J4, J5, J6
952-2274-ND | 15 | JP101, JP201, JP301
497-14647-ND | 7 | U5 + 2 spare MCUs
S9340-ND | 15 | Loose closed-top voltage caps
