barkinvar/sugerCANe/rev_e/bom/ACCESSORIES.csv

MPN | Manufacturer | Quantity | References | Value | Supplier | Supplier_part | Supplier_URL | Unit_USD_first_tier
SPN02SVEN-RC | Sullins Connector Solutions | 3 | Three loose voltage-selection caps | Closed-top 2 mm shunt | DigiKey | S9340-ND | https://www.digikey.com/en/products/detail/sullins-connector-solutions/SPN02SVEN-RC/2618265 | 0.1
