barkinvar/sugerCANe/rev_b2/bom/ACCESSORIES.csv

MPN | Manufacturer | Quantity | References | Value | Footprint | Assembly | Side | Voltage | Tolerance | Power_W | Dielectric | Component_notes | Preferred_supplier | Supplier_part | LCSC | DigiKey_SKU | DigiKey_URL | Supplier_URL | Observed_stock | Checked_date | Supplier_MOQ | Supplier_multiple | Unit_USD_first_tier | Extended_USD_consumed | Factory_stock_status
M22-1900005 | Harwin | 10 | 10 loose configuration shunts | 2 mm shunt | Bagged accessory | ACCESSORY | BAG |  |  |  |  |  | DigiKey | 952-1305-ND |  | 952-1305-ND | https://www.digikey.com/en/products/detail/harwin-inc/M22-1900005/2264286 | https://www.digikey.com/en/products/detail/harwin-inc/M22-1900005/2264286 | 31908 | 2026-09-08 | 1 | 1 | 0.35 | 3.5 | Not checked; turnkey procurement required
