barkinvar/sugerCANe/rev_b2/bom/capacitor_audit.csv

reference | value | role | decision | reason | source
C1 | 47uF | Battery/input filtering | Keep | Bulk input energy and local high-frequency input bypass; the remote bulk capacitor does not replace the bypass at U1. | LMR51420 datasheet sections 9.2.2.6, 10 and 11
C2 | 10uF | Battery/input filtering | Keep | Bulk input energy and local high-frequency input bypass; the remote bulk capacitor does not replace the bypass at U1. | LMR51420 datasheet sections 9.2.2.6, 10 and 11
C3 | 100nF | Battery/input filtering | Keep | Bulk input energy and local high-frequency input bypass; the remote bulk capacitor does not replace the bypass at U1. | LMR51420 datasheet sections 9.2.2.6, 10 and 11
C4 | 22uF | Buck output reservoir | Keep; C13 is a bench optimization candidate | Three 22uF capacitors compensate for effective capacitance loss. The nominal 66uF is not a claim of 66uF effective capacitance. Removing C13 requires DC-bias, load-transient and cascaded-regulator stability verification. | LMR51420 datasheet Table 9-1 and section 9.2.2.5
C5 | 22uF | Buck output reservoir | Keep; C13 is a bench optimization candidate | Three 22uF capacitors compensate for effective capacitance loss. The nominal 66uF is not a claim of 66uF effective capacitance. Removing C13 requires DC-bias, load-transient and cascaded-regulator stability verification. | LMR51420 datasheet Table 9-1 and section 9.2.2.5
C13 | 22uF | Buck output reservoir | Keep; C13 is a bench optimization candidate | Three 22uF capacitors compensate for effective capacitance loss. The nominal 66uF is not a claim of 66uF effective capacitance. Removing C13 requires DC-bias, load-transient and cascaded-regulator stability verification. | LMR51420 datasheet Table 9-1 and section 9.2.2.5
C6 | 100nF | Buck bootstrap | Keep | Provides the high-side MOSFET gate-drive supply; it is not an extra rail decoupler. | LMR51420 sections 8.3 and 9.2.2.7
C7 | 1uF | 3.3V regulator input/output | Keep | Local input bypass and output capacitance support the LDO and its transient response. | AP2112 recommended input/output application capacitors
C8 | 4.7uF | 3.3V regulator input/output | Keep | Local input bypass and output capacitance support the LDO and its transient response. | AP2112 recommended input/output application capacitors
C9 | 100nF | Battery sensor switch bypass/output | Keep | Local switch input bypass and controlled sensor-rail output capacitance; included in the inrush budget. | TPS1H200A-Q1 application guidance and Rev B-2 startup budget
C10 | 1uF | Battery sensor switch bypass/output | Keep | Local switch input bypass and controlled sensor-rail output capacitance; included in the inrush budget. | TPS1H200A-Q1 application guidance and Rev B-2 startup budget
C11 | 100nF | 5V sensor switch bypass/output | Keep | Input bypass and output charge reservoir reduce disturbances as sensor loads change. | TPS2553 sections on input/output capacitance and layout
C12 | 22uF | 5V sensor switch bypass/output | Keep | Input bypass and output charge reservoir reduce disturbances as sensor loads change. | TPS2553 sections on input/output capacitance and layout
C14 | 33nF | Hardware fault timing | Keep | Sets the battery-switch current-limit latch delay; deleting it changes fault behavior. | TPS1H200A-Q1 latch-off mode
C15 | 22uF | Boost output reservoir/bypass | Keep | The two 22uF capacitors supply the modeled boost output capacitance; 100nF provides local high-frequency bypass. | TPS61322 output-capacitor selection and supplied startup decks
C16 | 22uF | Boost output reservoir/bypass | Keep | The two 22uF capacitors supply the modeled boost output capacitance; 100nF provides local high-frequency bypass. | TPS61322 output-capacitor selection and supplied startup decks
C17 | 100nF | Boost output reservoir/bypass | Keep | The two 22uF capacitors supply the modeled boost output capacitance; 100nF provides local high-frequency bypass. | TPS61322 output-capacitor selection and supplied startup decks
C20 | 100nF | Microcontroller supply bypass | Keep | Separate local bypass at digital, I/O and analog supply connections. Shared net names do not make physically separated decouplers redundant. | STM32F042 power-supply scheme
C21 | 100nF | Microcontroller supply bypass | Keep | Separate local bypass at digital, I/O and analog supply connections. Shared net names do not make physically separated decouplers redundant. | STM32F042 power-supply scheme
C22 | 100nF | Microcontroller supply bypass | Keep | Separate local bypass at digital, I/O and analog supply connections. Shared net names do not make physically separated decouplers redundant. | STM32F042 power-supply scheme
C23 | 1uF | Microcontroller supply bypass | Keep | Separate local bypass at digital, I/O and analog supply connections. Shared net names do not make physically separated decouplers redundant. | STM32F042 power-supply scheme
C24 | 4.7uF | Microcontroller local bulk | Keep; bench optimization candidate | Provides a local charge reservoir beyond the three small supply bypass capacitors. Possible reduction depends on measured rail transients and layout impedance. | STM32F042 power-supply scheme and board layout
C25 | 30pF | Crystal load | Keep | Set the external crystal load capacitance and affect oscillator startup/frequency. | Abracon ABM3B 18pF load and STM32 oscillator design
C26 | 30pF | Crystal load | Keep | Set the external crystal load capacitance and affect oscillator startup/frequency. | Abracon ABM3B 18pF load and STM32 oscillator design
C27 | 100nF | Reset filtering | Keep | Suppresses short reset-pin disturbances; removal needs reset/noise qualification. | STM32F042 reset application circuit
C28 | 10nF | Supply measurement filtering | Keep | Together with ADC resistor dividers, filter switched-rail measurements used for fault decisions. | Rev B-2 rail diagnostics and ADC sampling implementation
C29 | 10nF | Supply measurement filtering | Keep | Together with ADC resistor dividers, filter switched-rail measurements used for fault decisions. | Rev B-2 rail diagnostics and ADC sampling implementation
C40 | 100nF | CAN supply bypass | Keep | U6 has separate VCC and VIO supply pins. TI calls for local bypass at both even when both use 3.3V. | TCAN3413 datasheet section 8.4
C41 | 100nF | CAN supply bypass | Keep | U6 has separate VCC and VIO supply pins. TI calls for local bypass at both even when both use 3.3V. | TCAN3413 datasheet section 8.4
C42 | 1uF | CAN local bulk | Keep; bench optimization candidate | Extra local energy reservoir. It is not a substitute for C40/C41 and is not independently proven necessary by DC checks. | TCAN3413 power supply/layout guidance
C50 | 100nF | Comparator supply bypass | Keep | Prevents supply disturbances causing false sensor transitions. | LM339LV power-supply recommendations
C101 | 1nF | Sensor input filtering | Keep | Each capacitor filters its own divided input; reducing it changes noise rejection and pulse response. | Rev B-2 front-end timing and hysteresis model
C201 | 1nF | Sensor input filtering | Keep | Each capacitor filters its own divided input; reducing it changes noise rejection and pulse response. | Rev B-2 front-end timing and hysteresis model
C301 | 1nF | Sensor input filtering | Keep | Each capacitor filters its own divided input; reducing it changes noise rejection and pulse response. | Rev B-2 front-end timing and hysteresis model
