barkinvar/sugerCANe/rev_b2/bom/procurement_quantities.csv

boards | MPN | supplier | required | purchased_with_moq | unused | unit_usd | line_usd
1 | 045101.5MRL | DigiKey | 1 | 1 | 0 | 2.47 | 2.47
1 | 0805W8F1001T5E | LCSC | 7 | 100 | 93 | 0.0042 | 0.42
1 | 0805W8F1002T5E | LCSC | 16 | 100 | 84 | 0.0039 | 0.39
1 | 0805W8F1003T5E | LCSC | 7 | 100 | 93 | 0.006 | 0.6
1 | 0805W8F4701T5E | LCSC | 7 | 100 | 93 | 0.0051 | 0.51
1 | 1824420000 | DigiKey | 3 | 3 | 0 | 1.54 | 4.62
1 | 1824430000 | DigiKey | 3 | 3 | 0 | 2.21 | 6.63
1 | ABM3B-8.000MHZ-B2-T | DigiKey | 1 | 1 | 0 | 0.76 | 0.76
1 | AO4485 | LCSC | 1 | 5 | 4 | 0.3171 | 1.5855
1 | AP2112K-3.3TRG1 | DigiKey | 1 | 1 | 0 | 0.28 | 0.28
1 | BAT46W-E3-18 | LCSC | 6 | 10 | 4 | 0.1307 | 1.307
1 | C0805C300J5GACTU | DigiKey | 2 | 2 | 0 | 0.33 | 0.66
1 | CC0805JRNPO9BN102 | DigiKey | 3 | 3 | 0 | 0.15 | 0.45
1 | CC0805KKX7R9BB105 | DigiKey | 4 | 4 | 0 | 0.32 | 1.28
1 | CC0805KRX7R9BB103 | DigiKey | 2 | 2 | 0 | 0.11 | 0.22
1 | CC0805KRX7R9BB333 | DigiKey | 1 | 1 | 0 | 0.14 | 0.14
1 | CL21B104KCFNNNE | LCSC | 12 | 50 | 38 | 0.0411 | 2.055
1 | CL31A226KAHNNNE | LCSC | 6 | 20 | 14 | 0.1709 | 3.418
1 | CL32B106KBJNNWE | DigiKey | 1 | 1 | 0 | 0.62 | 0.62
1 | EEE-FK1H470P | DigiKey | 1 | 1 | 0 | 0.93 | 0.93
1 | ERJ-6ENF1782V | DigiKey | 4 | 4 | 0 | 0.12 | 0.48
1 | ESD2CAN24DBZRQ1 | DigiKey | 1 | 1 | 0 | 0.87 | 0.87
1 | LM339LVDR | DigiKey | 1 | 1 | 0 | 0.42 | 0.42
1 | LMR51420XDDCR | LCSC | 1 | 1 | 0 | 1.0292 | 1.0292
1 | LTST-C170KGKT | DigiKey | 4 | 4 | 0 | 0.19 | 0.76
1 | LTST-C170KRKT | DigiKey | 1 | 1 | 0 | 0.18 | 0.18
1 | M22-1900005 | DigiKey | 10 | 10 | 0 | 0.293 | 2.93
1 | M22-2010205 | DigiKey | 4 | 4 | 0 | 0.16 | 0.64
1 | M22-2010305 | DigiKey | 3 | 3 | 0 | 0.22 | 0.66
1 | M22-2020305 | DigiKey | 3 | 3 | 0 | 0.41 | 1.23
1 | MMSZ12T1G | DigiKey | 1 | 1 | 0 | 0.17 | 0.17
1 | RC0805FR-07110KL | DigiKey | 6 | 6 | 0 | 0.1 | 0.6
1 | RC0805FR-0720KL | DigiKey | 3 | 3 | 0 | 0.1 | 0.3
1 | RC0805FR-073K9L | DigiKey | 1 | 1 | 0 | 0.1 | 0.1
1 | RC0805FR-0759KL | DigiKey | 1 | 1 | 0 | 0.1 | 0.1
1 | RC0805FR-077K15L | DigiKey | 3 | 3 | 0 | 0.1 | 0.3
1 | RC0805FR-07910KL | DigiKey | 3 | 3 | 0 | 0.1 | 0.3
1 | RC0805JR-070RL | DigiKey | 1 | 1 | 0 | 0.1 | 0.1
1 | RC1206FR-07120RL | DigiKey | 1 | 1 | 0 | 0.1 | 0.1
1 | RC2010FK-074K7L | DigiKey | 3 | 3 | 0 | 0.23 | 0.69
1 | SMAJ30A | LCSC | 3 | 5 | 2 | 0.1459 | 0.7295
1 | SMBJ22A-E3/52 | DigiKey | 1 | 1 | 0 | 0.56 | 0.56
1 | SRP4020TA-4R7M | DigiKey | 1 | 1 | 0 | 1.07 | 1.07
1 | SRP7028A-100M | DigiKey | 1 | 1 | 0 | 1.1 | 1.1
1 | SS14-E3/61T | DigiKey | 1 | 1 | 0 | 0.47 | 0.47
1 | STM32F042K6T6 | DigiKey | 1 | 1 | 0 | 4.34 | 4.34
1 | TCAN3413DR | LCSC | 1 | 1 | 0 | 1.0227 | 1.0227
1 | TMK212AB7475KG-T | DigiKey | 2 | 2 | 0 | 0.26 | 0.52
1 | TPS1H200AQDGNRQ1 | DigiKey | 1 | 1 | 0 | 1.78 | 1.78
1 | TPS2553DBVR-1 | LCSC | 1 | 5 | 4 | 0.2978 | 1.489
1 | TPS613222ADBVR | LCSC | 1 | 5 | 4 | 0.3697 | 1.8485
2 | 045101.5MRL | DigiKey | 2 | 2 | 0 | 2.47 | 4.94
2 | 0805W8F1001T5E | LCSC | 14 | 100 | 86 | 0.0042 | 0.42
2 | 0805W8F1002T5E | LCSC | 32 | 100 | 68 | 0.0039 | 0.39
2 | 0805W8F1003T5E | LCSC | 14 | 100 | 86 | 0.006 | 0.6
2 | 0805W8F4701T5E | LCSC | 14 | 100 | 86 | 0.0051 | 0.51
2 | 1824420000 | DigiKey | 6 | 6 | 0 | 1.54 | 9.24
2 | 1824430000 | DigiKey | 6 | 6 | 0 | 2.21 | 13.26
2 | ABM3B-8.000MHZ-B2-T | DigiKey | 2 | 2 | 0 | 0.76 | 1.52
2 | AO4485 | LCSC | 2 | 5 | 3 | 0.3171 | 1.5855
2 | AP2112K-3.3TRG1 | DigiKey | 2 | 2 | 0 | 0.28 | 0.56
2 | BAT46W-E3-18 | LCSC | 12 | 15 | 3 | 0.1307 | 1.9605
2 | C0805C300J5GACTU | DigiKey | 4 | 4 | 0 | 0.33 | 1.32
2 | CC0805JRNPO9BN102 | DigiKey | 6 | 6 | 0 | 0.15 | 0.9
2 | CC0805KKX7R9BB105 | DigiKey | 8 | 8 | 0 | 0.32 | 2.56
2 | CC0805KRX7R9BB103 | DigiKey | 4 | 4 | 0 | 0.11 | 0.44
2 | CC0805KRX7R9BB333 | DigiKey | 2 | 2 | 0 | 0.14 | 0.28
2 | CL21B104KCFNNNE | LCSC | 24 | 50 | 26 | 0.0411 | 2.055
2 | CL31A226KAHNNNE | LCSC | 12 | 20 | 8 | 0.1709 | 3.418
2 | CL32B106KBJNNWE | DigiKey | 2 | 2 | 0 | 0.62 | 1.24
2 | EEE-FK1H470P | DigiKey | 2 | 2 | 0 | 0.93 | 1.86
2 | ERJ-6ENF1782V | DigiKey | 8 | 8 | 0 | 0.12 | 0.96
2 | ESD2CAN24DBZRQ1 | DigiKey | 2 | 2 | 0 | 0.87 | 1.74
2 | LM339LVDR | DigiKey | 2 | 2 | 0 | 0.42 | 0.84
2 | LMR51420XDDCR | LCSC | 2 | 2 | 0 | 1.0292 | 2.0584
2 | LTST-C170KGKT | DigiKey | 8 | 8 | 0 | 0.19 | 1.52
2 | LTST-C170KRKT | DigiKey | 2 | 2 | 0 | 0.18 | 0.36
2 | M22-1900005 | DigiKey | 20 | 20 | 0 | 0.293 | 5.86
2 | M22-2010205 | DigiKey | 8 | 8 | 0 | 0.16 | 1.28
2 | M22-2010305 | DigiKey | 6 | 6 | 0 | 0.22 | 1.32
2 | M22-2020305 | DigiKey | 6 | 6 | 0 | 0.41 | 2.46
2 | MMSZ12T1G | DigiKey | 2 | 2 | 0 | 0.17 | 0.34
2 | RC0805FR-07110KL | DigiKey | 12 | 12 | 0 | 0.1 | 1.2
2 | RC0805FR-0720KL | DigiKey | 6 | 6 | 0 | 0.1 | 0.6
2 | RC0805FR-073K9L | DigiKey | 2 | 2 | 0 | 0.1 | 0.2
2 | RC0805FR-0759KL | DigiKey | 2 | 2 | 0 | 0.1 | 0.2
2 | RC0805FR-077K15L | DigiKey | 6 | 6 | 0 | 0.1 | 0.6
2 | RC0805FR-07910KL | DigiKey | 6 | 6 | 0 | 0.1 | 0.6
2 | RC0805JR-070RL | DigiKey | 2 | 2 | 0 | 0.1 | 0.2
2 | RC1206FR-07120RL | DigiKey | 2 | 2 | 0 | 0.1 | 0.2
2 | RC2010FK-074K7L | DigiKey | 6 | 6 | 0 | 0.23 | 1.38
2 | SMAJ30A | LCSC | 6 | 10 | 4 | 0.1459 | 1.459
2 | SMBJ22A-E3/52 | DigiKey | 2 | 2 | 0 | 0.56 | 1.12
2 | SRP4020TA-4R7M | DigiKey | 2 | 2 | 0 | 1.07 | 2.14
2 | SRP7028A-100M | DigiKey | 2 | 2 | 0 | 1.1 | 2.2
2 | SS14-E3/61T | DigiKey | 2 | 2 | 0 | 0.47 | 0.94
2 | STM32F042K6T6 | DigiKey | 2 | 2 | 0 | 4.34 | 8.68
2 | TCAN3413DR | LCSC | 2 | 2 | 0 | 1.0227 | 2.0454
2 | TMK212AB7475KG-T | DigiKey | 4 | 4 | 0 | 0.26 | 1.04
2 | TPS1H200AQDGNRQ1 | DigiKey | 2 | 2 | 0 | 1.78 | 3.56
2 | TPS2553DBVR-1 | LCSC | 2 | 5 | 3 | 0.2978 | 1.489
2 | TPS613222ADBVR | LCSC | 2 | 5 | 3 | 0.3697 | 1.8485
5 | 045101.5MRL | DigiKey | 5 | 5 | 0 | 2.47 | 12.35
5 | 0805W8F1001T5E | LCSC | 35 | 100 | 65 | 0.0042 | 0.42
5 | 0805W8F1002T5E | LCSC | 80 | 100 | 20 | 0.0039 | 0.39
5 | 0805W8F1003T5E | LCSC | 35 | 100 | 65 | 0.006 | 0.6
5 | 0805W8F4701T5E | LCSC | 35 | 100 | 65 | 0.0051 | 0.51
5 | 1824420000 | DigiKey | 15 | 15 | 0 | 1.113 | 16.695
5 | 1824430000 | DigiKey | 15 | 15 | 0 | 1.591 | 23.865
5 | ABM3B-8.000MHZ-B2-T | DigiKey | 5 | 5 | 0 | 0.76 | 3.8
5 | AO4485 | LCSC | 5 | 5 | 0 | 0.3171 | 1.5855
5 | AP2112K-3.3TRG1 | DigiKey | 5 | 5 | 0 | 0.28 | 1.4
5 | BAT46W-E3-18 | LCSC | 30 | 30 | 0 | 0.1307 | 3.921
5 | C0805C300J5GACTU | DigiKey | 10 | 10 | 0 | 0.33 | 3.3
5 | CC0805JRNPO9BN102 | DigiKey | 15 | 15 | 0 | 0.15 | 2.25
5 | CC0805KKX7R9BB105 | DigiKey | 20 | 20 | 0 | 0.32 | 6.4
5 | CC0805KRX7R9BB103 | DigiKey | 10 | 10 | 0 | 0.11 | 1.1
5 | CC0805KRX7R9BB333 | DigiKey | 5 | 5 | 0 | 0.14 | 0.7
5 | CL21B104KCFNNNE | LCSC | 60 | 100 | 40 | 0.0411 | 4.11
5 | CL31A226KAHNNNE | LCSC | 30 | 40 | 10 | 0.1709 | 6.836
5 | CL32B106KBJNNWE | DigiKey | 5 | 5 | 0 | 0.62 | 3.1
5 | EEE-FK1H470P | DigiKey | 5 | 5 | 0 | 0.93 | 4.65
5 | ERJ-6ENF1782V | DigiKey | 20 | 20 | 0 | 0.12 | 2.4
5 | ESD2CAN24DBZRQ1 | DigiKey | 5 | 5 | 0 | 0.87 | 4.35
5 | LM339LVDR | DigiKey | 5 | 5 | 0 | 0.42 | 2.1
5 | LMR51420XDDCR | LCSC | 5 | 5 | 0 | 1.0292 | 5.146
5 | LTST-C170KGKT | DigiKey | 20 | 20 | 0 | 0.19 | 3.8
5 | LTST-C170KRKT | DigiKey | 5 | 5 | 0 | 0.18 | 0.9
5 | M22-1900005 | DigiKey | 50 | 50 | 0 | 0.293 | 14.65
5 | M22-2010205 | DigiKey | 20 | 20 | 0 | 0.134 | 2.68
5 | M22-2010305 | DigiKey | 15 | 15 | 0 | 0.188 | 2.82
5 | M22-2020305 | DigiKey | 15 | 15 | 0 | 0.35 | 5.25
5 | MMSZ12T1G | DigiKey | 5 | 5 | 0 | 0.17 | 0.85
5 | RC0805FR-07110KL | DigiKey | 30 | 30 | 0 | 0.1 | 3.0
5 | RC0805FR-0720KL | DigiKey | 15 | 15 | 0 | 0.1 | 1.5
5 | RC0805FR-073K9L | DigiKey | 5 | 5 | 0 | 0.1 | 0.5
5 | RC0805FR-0759KL | DigiKey | 5 | 5 | 0 | 0.1 | 0.5
5 | RC0805FR-077K15L | DigiKey | 15 | 15 | 0 | 0.1 | 1.5
5 | RC0805FR-07910KL | DigiKey | 15 | 15 | 0 | 0.1 | 1.5
5 | RC0805JR-070RL | DigiKey | 5 | 5 | 0 | 0.1 | 0.5
5 | RC1206FR-07120RL | DigiKey | 5 | 5 | 0 | 0.1 | 0.5
5 | RC2010FK-074K7L | DigiKey | 15 | 15 | 0 | 0.23 | 3.45
5 | SMAJ30A | LCSC | 15 | 15 | 0 | 0.1459 | 2.1885
5 | SMBJ22A-E3/52 | DigiKey | 5 | 5 | 0 | 0.56 | 2.8
5 | SRP4020TA-4R7M | DigiKey | 5 | 5 | 0 | 1.07 | 5.35
5 | SRP7028A-100M | DigiKey | 5 | 5 | 0 | 1.1 | 5.5
5 | SS14-E3/61T | DigiKey | 5 | 5 | 0 | 0.47 | 2.35
5 | STM32F042K6T6 | DigiKey | 5 | 5 | 0 | 4.34 | 21.7
5 | TCAN3413DR | LCSC | 5 | 5 | 0 | 1.0227 | 5.1135
5 | TMK212AB7475KG-T | DigiKey | 10 | 10 | 0 | 0.26 | 2.6
5 | TPS1H200AQDGNRQ1 | DigiKey | 5 | 5 | 0 | 1.78 | 8.9
5 | TPS2553DBVR-1 | LCSC | 5 | 5 | 0 | 0.2978 | 1.489
5 | TPS613222ADBVR | LCSC | 5 | 5 | 0 | 0.3697 | 1.8485
10 | 045101.5MRL | DigiKey | 10 | 10 | 0 | 2.47 | 24.7
10 | 0805W8F1001T5E | LCSC | 70 | 100 | 30 | 0.0042 | 0.42
10 | 0805W8F1002T5E | LCSC | 160 | 200 | 40 | 0.0039 | 0.78
10 | 0805W8F1003T5E | LCSC | 70 | 100 | 30 | 0.006 | 0.6
10 | 0805W8F4701T5E | LCSC | 70 | 100 | 30 | 0.0051 | 0.51
10 | 1824420000 | DigiKey | 30 | 30 | 0 | 1.113 | 33.39
10 | 1824430000 | DigiKey | 30 | 30 | 0 | 1.591 | 47.73
10 | ABM3B-8.000MHZ-B2-T | DigiKey | 10 | 10 | 0 | 0.76 | 7.6
10 | AO4485 | LCSC | 10 | 10 | 0 | 0.3171 | 3.171
10 | AP2112K-3.3TRG1 | DigiKey | 10 | 10 | 0 | 0.28 | 2.8
10 | BAT46W-E3-18 | LCSC | 60 | 60 | 0 | 0.1084 | 6.504
10 | C0805C300J5GACTU | DigiKey | 20 | 20 | 0 | 0.33 | 6.6
10 | CC0805JRNPO9BN102 | DigiKey | 30 | 30 | 0 | 0.15 | 4.5
10 | CC0805KKX7R9BB105 | DigiKey | 40 | 40 | 0 | 0.32 | 12.8
10 | CC0805KRX7R9BB103 | DigiKey | 20 | 20 | 0 | 0.11 | 2.2
10 | CC0805KRX7R9BB333 | DigiKey | 10 | 10 | 0 | 0.078 | 0.78
10 | CL21B104KCFNNNE | LCSC | 120 | 150 | 30 | 0.0411 | 6.165
10 | CL31A226KAHNNNE | LCSC | 60 | 60 | 0 | 0.1709 | 10.254
10 | CL32B106KBJNNWE | DigiKey | 10 | 10 | 0 | 0.62 | 6.2
10 | EEE-FK1H470P | DigiKey | 10 | 10 | 0 | 0.589 | 5.89
10 | ERJ-6ENF1782V | DigiKey | 40 | 40 | 0 | 0.12 | 4.8
10 | ESD2CAN24DBZRQ1 | DigiKey | 10 | 10 | 0 | 0.87 | 8.7
10 | LM339LVDR | DigiKey | 10 | 10 | 0 | 0.293 | 2.93
10 | LMR51420XDDCR | LCSC | 10 | 10 | 0 | 0.8604 | 8.604
10 | LTST-C170KGKT | DigiKey | 40 | 40 | 0 | 0.19 | 7.6
10 | LTST-C170KRKT | DigiKey | 10 | 10 | 0 | 0.18 | 1.8
10 | M22-1900005 | DigiKey | 100 | 100 | 0 | 0.293 | 29.3
10 | M22-2010205 | DigiKey | 40 | 40 | 0 | 0.134 | 5.36
10 | M22-2010305 | DigiKey | 30 | 30 | 0 | 0.188 | 5.64
10 | M22-2020305 | DigiKey | 30 | 30 | 0 | 0.35 | 10.5
10 | MMSZ12T1G | DigiKey | 10 | 10 | 0 | 0.102 | 1.02
10 | RC0805FR-07110KL | DigiKey | 60 | 60 | 0 | 0.1 | 6.0
10 | RC0805FR-0720KL | DigiKey | 30 | 30 | 0 | 0.1 | 3.0
10 | RC0805FR-073K9L | DigiKey | 10 | 10 | 0 | 0.1 | 1.0
10 | RC0805FR-0759KL | DigiKey | 10 | 10 | 0 | 0.1 | 1.0
10 | RC0805FR-077K15L | DigiKey | 30 | 30 | 0 | 0.1 | 3.0
10 | RC0805FR-07910KL | DigiKey | 30 | 30 | 0 | 0.1 | 3.0
10 | RC0805JR-070RL | DigiKey | 10 | 10 | 0 | 0.1 | 1.0
10 | RC1206FR-07120RL | DigiKey | 10 | 10 | 0 | 0.1 | 1.0
10 | RC2010FK-074K7L | DigiKey | 30 | 30 | 0 | 0.23 | 6.9
10 | SMAJ30A | LCSC | 30 | 30 | 0 | 0.1459 | 4.377
10 | SMBJ22A-E3/52 | DigiKey | 10 | 10 | 0 | 0.348 | 3.48
10 | SRP4020TA-4R7M | DigiKey | 10 | 10 | 0 | 0.88 | 8.8
10 | SRP7028A-100M | DigiKey | 10 | 10 | 0 | 1.1 | 11.0
10 | SS14-E3/61T | DigiKey | 10 | 10 | 0 | 0.286 | 2.86
10 | STM32F042K6T6 | DigiKey | 10 | 10 | 0 | 4.34 | 43.4
10 | TCAN3413DR | LCSC | 10 | 10 | 0 | 0.8391 | 8.391
10 | TMK212AB7475KG-T | DigiKey | 20 | 20 | 0 | 0.26 | 5.2
10 | TPS1H200AQDGNRQ1 | DigiKey | 10 | 10 | 0 | 1.78 | 17.8
10 | TPS2553DBVR-1 | LCSC | 10 | 10 | 0 | 0.2978 | 2.978
10 | TPS613222ADBVR | LCSC | 10 | 10 | 0 | 0.3697 | 3.697
25 | 045101.5MRL | DigiKey | 25 | 25 | 0 | 2.47 | 61.75
25 | 0805W8F1001T5E | LCSC | 175 | 200 | 25 | 0.0042 | 0.84
25 | 0805W8F1002T5E | LCSC | 400 | 400 | 0 | 0.0039 | 1.56
25 | 0805W8F1003T5E | LCSC | 175 | 200 | 25 | 0.006 | 1.2
25 | 0805W8F4701T5E | LCSC | 175 | 200 | 25 | 0.0051 | 1.02
25 | 1824420000 | DigiKey | 75 | 75 | 0 | 1.113 | 83.475
25 | 1824430000 | DigiKey | 75 | 75 | 0 | 1.591 | 119.325
25 | ABM3B-8.000MHZ-B2-T | DigiKey | 25 | 25 | 0 | 0.76 | 19.0
25 | AO4485 | LCSC | 25 | 25 | 0 | 0.3171 | 7.9275
25 | AP2112K-3.3TRG1 | DigiKey | 25 | 25 | 0 | 0.28 | 7.0
25 | BAT46W-E3-18 | LCSC | 150 | 150 | 0 | 0.0973 | 14.595
25 | C0805C300J5GACTU | DigiKey | 50 | 50 | 0 | 0.33 | 16.5
25 | CC0805JRNPO9BN102 | DigiKey | 75 | 75 | 0 | 0.15 | 11.25
25 | CC0805KKX7R9BB105 | DigiKey | 100 | 100 | 0 | 0.32 | 32.0
25 | CC0805KRX7R9BB103 | DigiKey | 50 | 50 | 0 | 0.11 | 5.5
25 | CC0805KRX7R9BB333 | DigiKey | 25 | 25 | 0 | 0.078 | 1.95
25 | CL21B104KCFNNNE | LCSC | 300 | 300 | 0 | 0.0411 | 12.33
25 | CL31A226KAHNNNE | LCSC | 150 | 160 | 10 | 0.1709 | 27.344
25 | CL32B106KBJNNWE | DigiKey | 25 | 25 | 0 | 0.62 | 15.5
25 | EEE-FK1H470P | DigiKey | 25 | 25 | 0 | 0.589 | 14.725
25 | ERJ-6ENF1782V | DigiKey | 100 | 100 | 0 | 0.12 | 12.0
25 | ESD2CAN24DBZRQ1 | DigiKey | 25 | 25 | 0 | 0.87 | 21.75
25 | LM339LVDR | DigiKey | 25 | 25 | 0 | 0.293 | 7.325
25 | LMR51420XDDCR | LCSC | 25 | 25 | 0 | 0.8604 | 21.51
25 | LTST-C170KGKT | DigiKey | 100 | 100 | 0 | 0.19 | 19.0
25 | LTST-C170KRKT | DigiKey | 25 | 25 | 0 | 0.18 | 4.5
25 | M22-1900005 | DigiKey | 250 | 250 | 0 | 0.293 | 73.25
25 | M22-2010205 | DigiKey | 100 | 100 | 0 | 0.134 | 13.4
25 | M22-2010305 | DigiKey | 75 | 75 | 0 | 0.188 | 14.1
25 | M22-2020305 | DigiKey | 75 | 75 | 0 | 0.35 | 26.25
25 | MMSZ12T1G | DigiKey | 25 | 25 | 0 | 0.102 | 2.55
25 | RC0805FR-07110KL | DigiKey | 150 | 150 | 0 | 0.1 | 15.0
25 | RC0805FR-0720KL | DigiKey | 75 | 75 | 0 | 0.1 | 7.5
25 | RC0805FR-073K9L | DigiKey | 25 | 25 | 0 | 0.1 | 2.5
25 | RC0805FR-0759KL | DigiKey | 25 | 25 | 0 | 0.1 | 2.5
25 | RC0805FR-077K15L | DigiKey | 75 | 75 | 0 | 0.1 | 7.5
25 | RC0805FR-07910KL | DigiKey | 75 | 75 | 0 | 0.1 | 7.5
25 | RC0805JR-070RL | DigiKey | 25 | 25 | 0 | 0.1 | 2.5
25 | RC1206FR-07120RL | DigiKey | 25 | 25 | 0 | 0.1 | 2.5
25 | RC2010FK-074K7L | DigiKey | 75 | 75 | 0 | 0.23 | 17.25
25 | SMAJ30A | LCSC | 75 | 75 | 0 | 0.1169 | 8.7675
25 | SMBJ22A-E3/52 | DigiKey | 25 | 25 | 0 | 0.348 | 8.7
25 | SRP4020TA-4R7M | DigiKey | 25 | 25 | 0 | 0.88 | 22.0
25 | SRP7028A-100M | DigiKey | 25 | 25 | 0 | 1.1 | 27.5
25 | SS14-E3/61T | DigiKey | 25 | 25 | 0 | 0.286 | 7.15
25 | STM32F042K6T6 | DigiKey | 25 | 25 | 0 | 4.34 | 108.5
25 | TCAN3413DR | LCSC | 25 | 25 | 0 | 0.8391 | 20.9775
25 | TMK212AB7475KG-T | DigiKey | 50 | 50 | 0 | 0.26 | 13.0
25 | TPS1H200AQDGNRQ1 | DigiKey | 25 | 25 | 0 | 1.78 | 44.5
25 | TPS2553DBVR-1 | LCSC | 25 | 25 | 0 | 0.2978 | 7.445
25 | TPS613222ADBVR | LCSC | 25 | 25 | 0 | 0.3697 | 9.2425
