barkinvar/sugerCANe/rev_c/output/documentation/BOM_RevC_Lite.pdf

# SC Lite - Revision C purchasing BOM

89 fitted parts / 42 MPNs / dated qty-one estimate $43.90. Unbuilt prototype. Reprice before ordering; PCB, assembly, attrition, freight and tax excluded.

Qty | MPN / DigiKey | References | Value / package | USD ext.
1 | 045101.5MRL / F2579CT-ND | F1 | 1.5A FAST / Fuse_Littelfuse-NANO2-451_453 | 2.47
3 | 1824420000 / 281-2020-ND | J1, J2, J3 | 2P PUSH 3.5mm / Weidmuller_LSF_90_2P | 4.62
3 | 1824430000 / 281-2021-ND | J4, J5, J6 | 3P PUSH 3.5mm / Weidmuller_LSF_90_3P | 6.63
1 | ABM3B-8.000MHZ-B2-T / 535-9720-1-ND | Y1 | 8MHz 18pF / Abracon_ABM3B_5.0x3.2mm | 0.76
1 | AO4485 / 785-1551-1-ND | Q1 | AO4485 / SOIC-8_3.9x4.9mm_P1.27mm | 1.51
1 | AP2112K-3.3TRG1 / AP2112K-3.3TRG1DICT-ND | U2 | AP2112K-3.3 / SOT-23-5 | 0.28
3 | BAT46W-E3-18 / BAT46W-E3-18GICT-ND | D102, D202, D302 | BAT46W / D_SOD-123 | 1.56
2 | C0805C300J5GACTU / 399-C0805C300J5GACTUCT-ND | C25, C26 | 30pF / C_0805_2012Metric | 0.66
3 | CC0805JRNPO9BN102 / 311-1122-1-ND | C101, C201, C301 | 1nF / C_0805_2012Metric | 0.45
3 | CC0805KKX7R9BB105 / 311-1886-1-ND | C7, C10, C23 | 1uF / C_0805_2012Metric | 0.96
12 | CC0805KRX7R9BB104 / 311-1140-1-ND | C3, C6, C9, C11, C20, C21, C22, C27, C40, C41, C50, C51 | 100nF / C_0805_2012Metric | 1.32
1 | CC0805KRX7R9BB333 / 311-1374-1-ND | C14 | 33nF / C_0805_2012Metric | 0.14
4 | CL31A226KAHNNNE / 1276-3047-1-ND | C4, C5, C13, C12 | 22uF / C_1206_3216Metric | 1.92
1 | CL32B106KBJNNWE / 1276-3388-1-ND | C2 | 10uF / C_1210_3225Metric | 0.62
1 | EEE-FK1H470P / PCE3815CT-ND | C1 | 47uF / CP_Elec_8x6.5 | 0.93
1 | ESD2CAN24DBZRQ1 / 296-ESD2CAN24DBZRQ1CT-ND | D20 | ESD2CAN24-Q1 / SOT-23 | 0.87
1 | LM339LVDR / 296-LM339LVDRCT-ND | U7 | LM339LV / SOIC-14_3.9x8.7mm_P1.27mm | 0.42
1 | LMR51420XDDCR / 296-LMR51420XDDCRCT-ND | U1 | LMR51420XDDCR / TSOT-23-6 | 1.32
1 | LTST-C170KGKT / 160-1414-1-ND | D10 | GREEN / LED_0805_2012Metric | 0.19
1 | MMSZ12T1G / MMSZ12T1GOSCT-ND | D3 | 12V ZENER / D_SOD-123 | 0.17

Qty | MPN / DigiKey | References | Value / package | USD ext.
1 | RC0805FR-07100KL / 311-100KCRCT-ND | R50 | 100k / R_0805_2012Metric | 0.11
11 | RC0805FR-0710KL / 311-10.0KCRCT-ND | R3, R21, R22, R40, R41, R105, R110, R205, R210, R305, R310 | 10k / R_0805_2012Metric | 1.1
2 | RC0805FR-071KL / 311-1.00KCRCT-ND | R4, R30 | 1k / R_0805_2012Metric | 0.2
3 | RC0805FR-0720KL / 311-20.0KCRCT-ND | R103, R203, R303 | 20k / R_0805_2012Metric | 0.3
3 | RC0805FR-07220KL / 311-220KCRCT-ND | R101, R201, R301 | 220k / R_0805_2012Metric | 0.33
3 | RC0805FR-072M2L / 311-2.20MCRCT-ND | R104, R204, R304 | 2.2M / R_0805_2012Metric | 0.3
1 | RC0805FR-073K9L / 311-3.90KCRCT-ND | R5 | 3.9k / R_0805_2012Metric | 0.1
1 | RC0805FR-0759KL / 311-59.0KCRCT-ND | R10 | 59k / R_0805_2012Metric | 0.1
1 | RC0805FR-075K23L / 311-5.23KCRCT-ND | R51 | 5.23k / R_0805_2012Metric | 0.1
1 | RC0805JR-070RL / 311-0.0ARCT-ND | R20 | 0 / R_0805_2012Metric | 0.1
3 | RC1206FR-0710KL / 311-10.0KFRCT-ND | R109, R209, R309 | 10k / R_1206_3216Metric | 0.33
1 | RC1206FR-07120RL / 311-120FRCT-ND | R42 | 120 / R_1206_3216Metric | 0.1
1 | RT0805BRD07102KL / YAG4817CT-ND | R1 | 102k / R_0805_2012Metric | 0.1
1 | RT0805BRD0713K7L / YAG4829CT-ND | R2 | 13.7k / R_0805_2012Metric | 0.1
3 | SMAJ30A / SMAJ30ALFCT-ND | D101, D201, D301 | SMAJ30A / D_SMA | 1.5
1 | SMBJ22A-E3/52 / SMBJ22A-E3/52GICT-ND | D2 | SMBJ22A / D_SMB | 0.56
1 | SRP7028A-100M / SRP7028A-100MCT-ND | L1 | 10uH / L_Bourns_SRP7028A_7.3x6.6mm | 1.1
1 | STM32F042K6T6 / 497-14647-ND | U5 | STM32F042K6T6 / LQFP-32_7x7mm_P0.8mm | 4.34
1 | TCAN3413DR / 296-TCAN3413DRCT-ND | U6 | TCAN3413DR / SOIC-8_3.9x4.9mm_P1.27mm | 1.87
2 | TMK212AB7475KG-T / 587-2990-1-ND | C8, C24 | 4.7uF / C_0805_2012Metric | 0.52
1 | TPS1H200AQDGNRQ1 / 296-50416-1-ND | U3 | TPS1H200A-Q1 / TI_DGN0008K_HVSSOP8_EP | 1.78
1 | TPS2553DBVR-1 / 296-39380-1-ND | U4 | TPS2553DBVR-1 / SOT-23-6 | 1.06
