barkinvar/sugerCANe/output/playwright/assembly_bom_overview.png

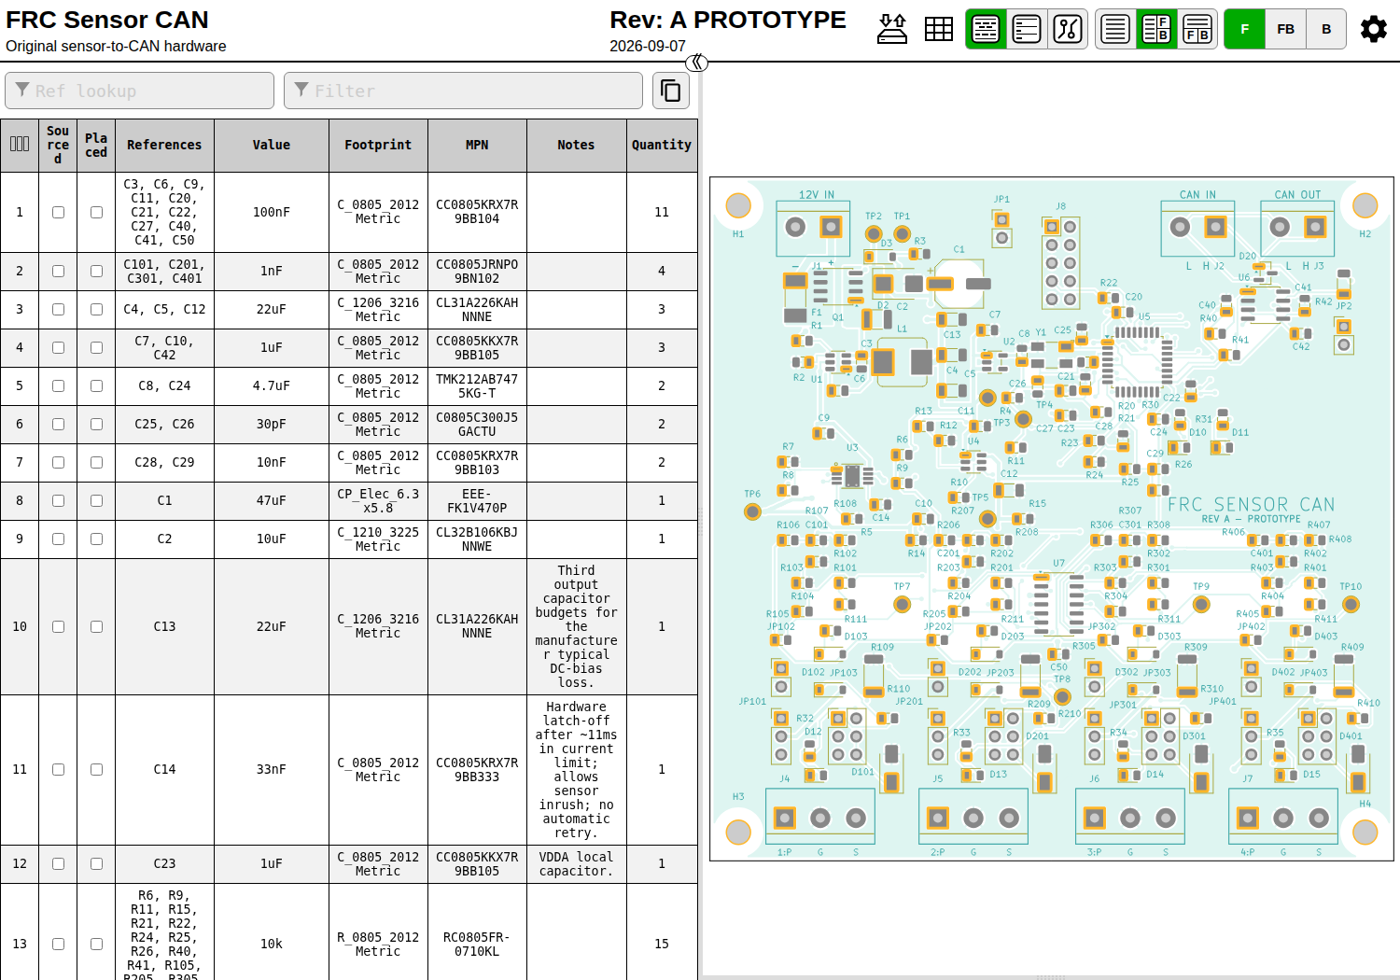
output/playwright/assembly_bom_overview.png
