barkinvar/sugerCANe/output/review/bom_page-1.png

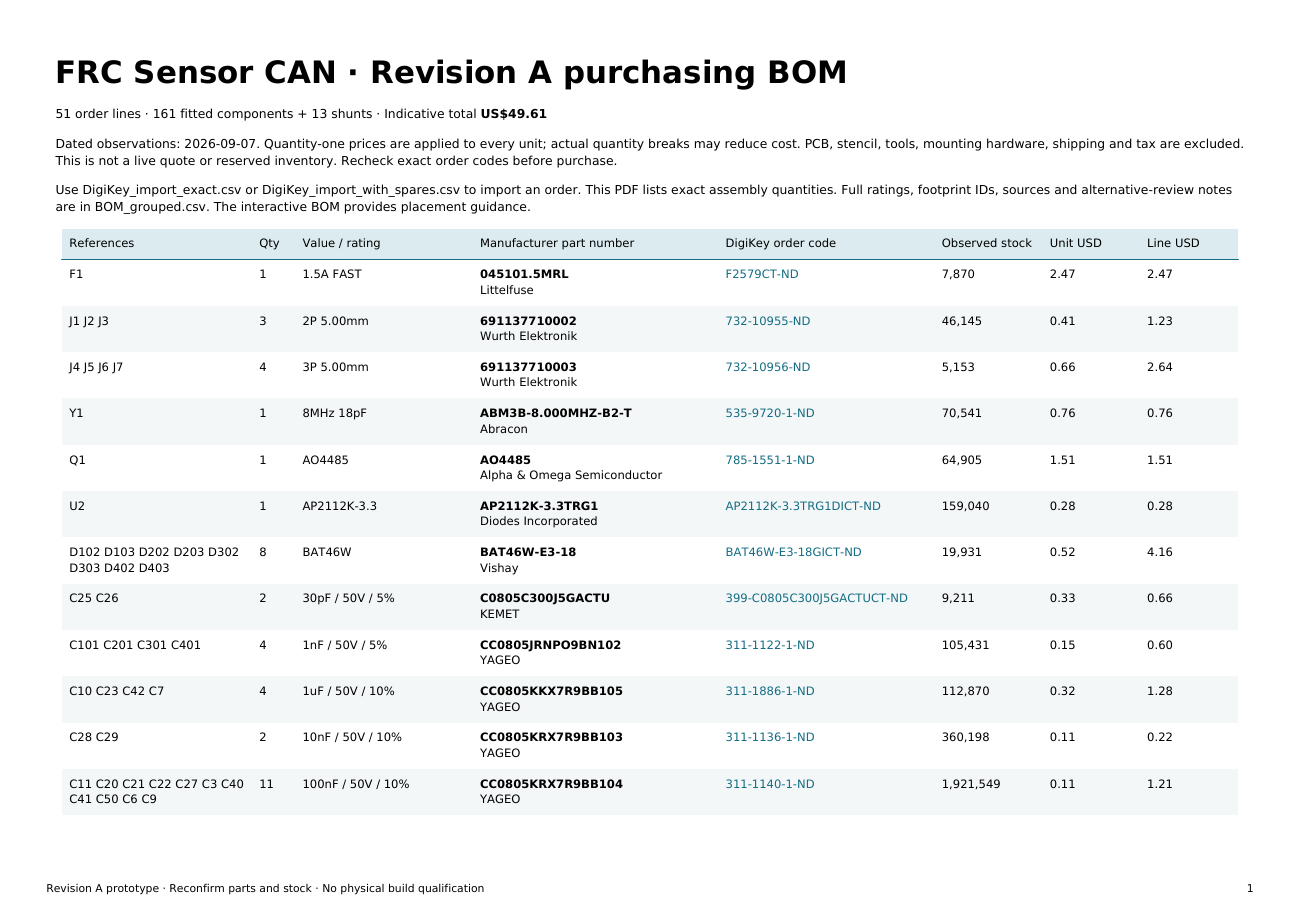
output/review/bom_page-1.png
