barkinvar/sugerCANe/output/review/bom_page-2.png

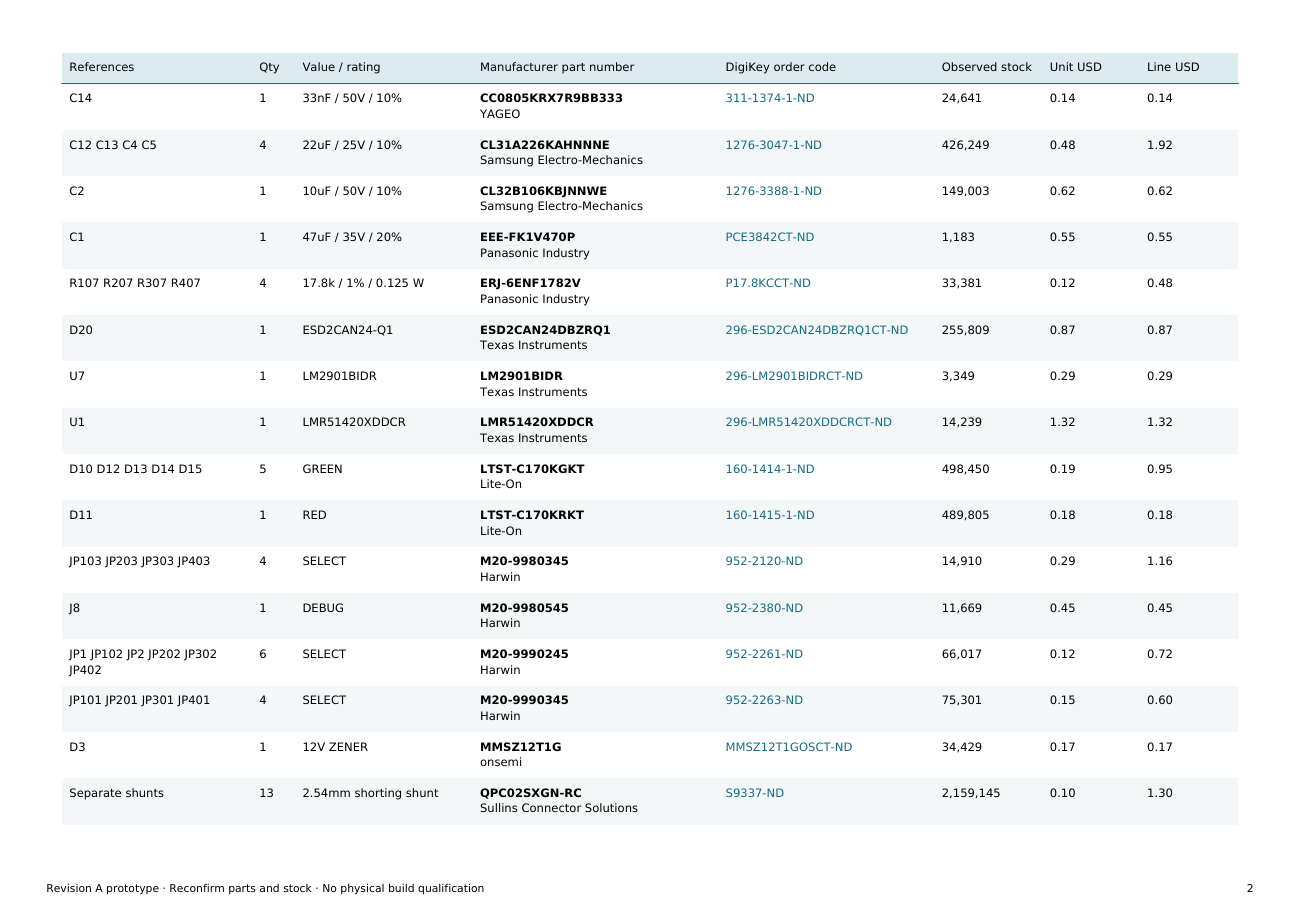
output/review/bom_page-2.png
