barkinvar/sugerCANe/output/review/bom_page-3.png

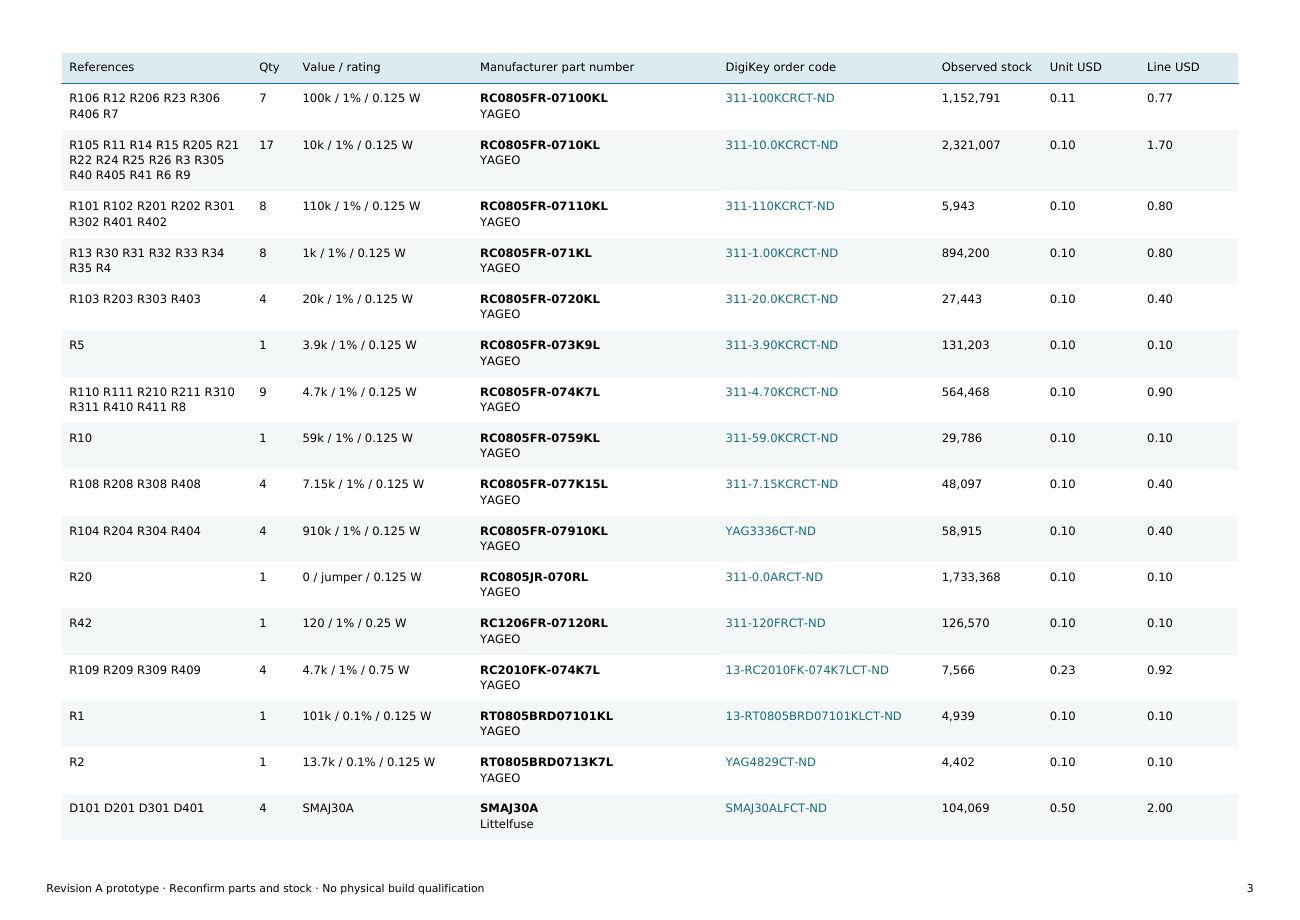
output/review/bom_page-3.png
