barkinvar/sugerCANe/output/review/bom_page-4.png

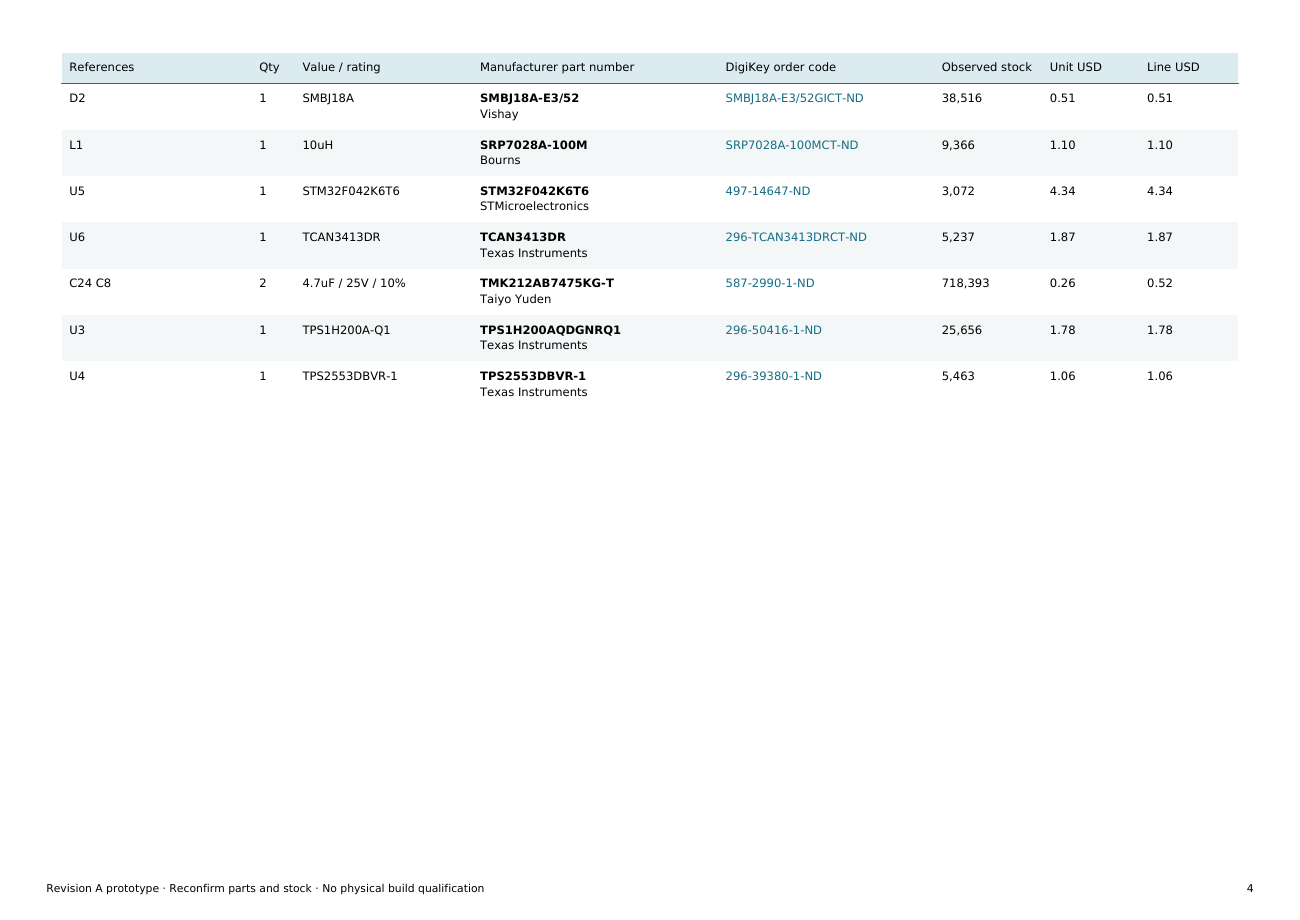
output/review/bom_page-4.png
