barkinvar/sugerCANe/output/review/release_bom_contact.png

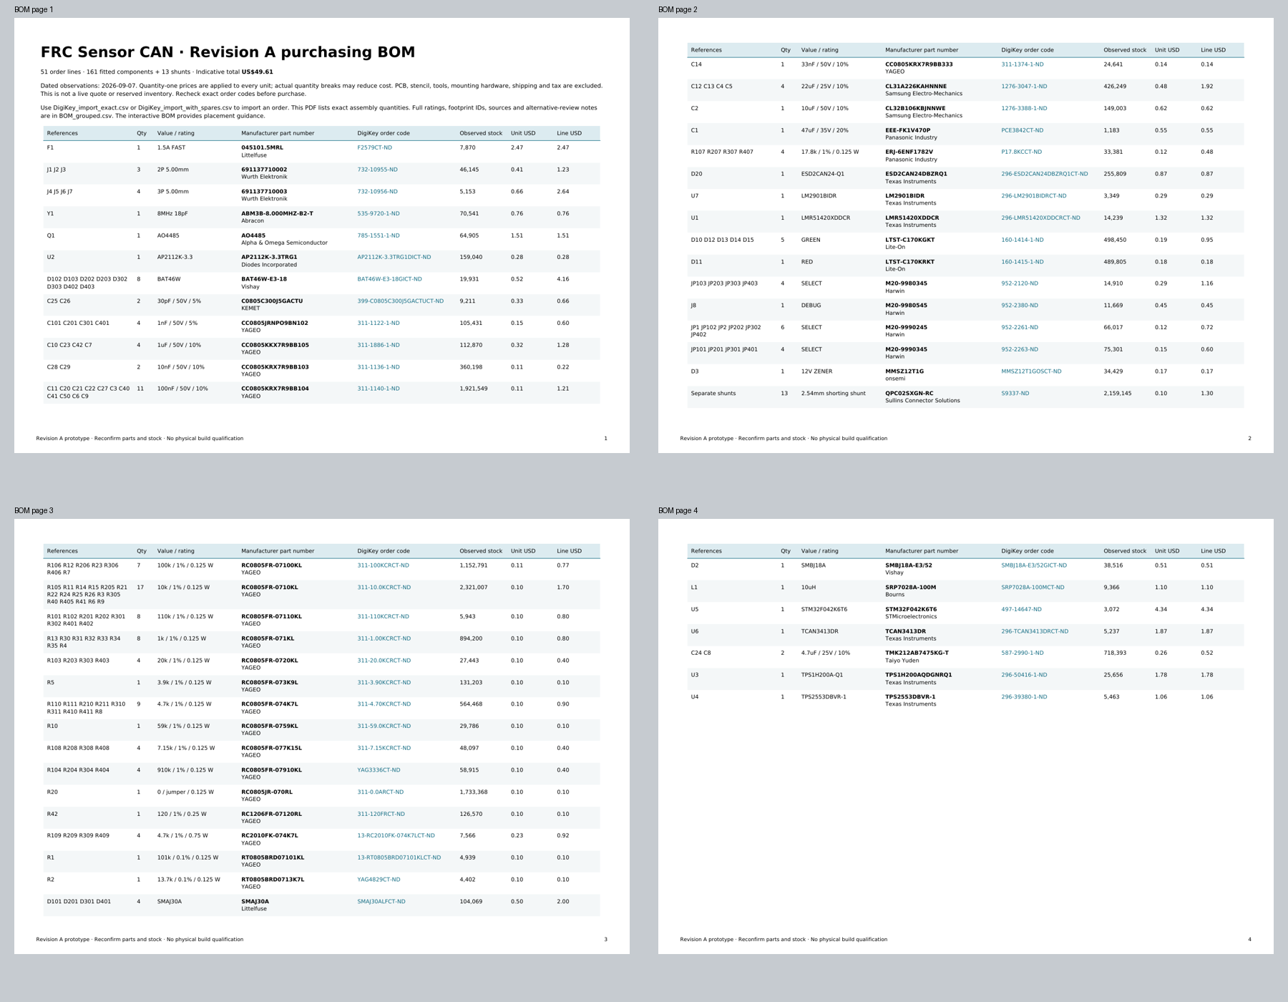
output/review/release_bom_contact.png
