barkinvar/sugerCANe/current/output/mechanical/FRC_Sensor_CAN.step

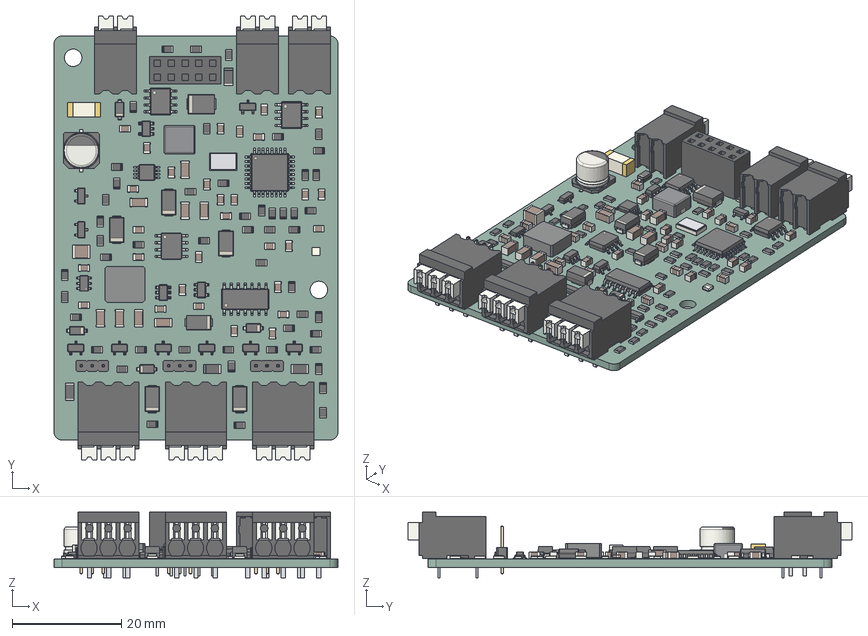
[picture p151: CAD file, 2026-09-10]
current/output/mechanical/FRC_Sensor_CAN.step
52.0 x 81.3 x 12.0 mm
C_0805_2012Metric x 30
SOIC-14_3.9x8.7mm_P1.27mm
R_0805_2012Metric x 51
C_1206_3216Metric x 8
SOT-23 x 9
ceramic x 2
cap_0
cap_1
D_SOD-123 x 4
SOT-23-5 x 2
D_SMA x 6
SOIC-8_3.9x4.9mm_P1.27mm x 2
housing_0 x 6
button_1 x 6
button_2 x 6
pin_3 x 3
pin_4 x 6
pin_5 x 6
pin_6 x 6
TSOT-23-6
SOT-23-6
LQFP-32_7x7mm_P0.8mm
CP_Elec_63x58
lid
L_Bourns_SRP5030T
VSSOP-8_3x3mm_P0.65mm
button_3 x 3
pin_7 x 3
pin_8 x 3
pin_9 x 3
shielded_core
terminal_0
terminal_1
substrate
optical_encapsulation
SOIC-8-1EP_3.9x4.9mm_P1.27mm_EP2.29x3mm
PinHeader_1x03_P200mm_Vertical x 3
R_1206_3216Metric x 4
tail_0_0
tail_0_1
tail_1_0
tail_1_1
tail_2_0
tail_2_1
tail_3_0
tail_3_1
tail_4_0
tail_4_1
insulator
D_SMB
C_1210_3225Metric
FRC_Sensor_CAN_PCB
