barkinvar/sugerCANe/output/mechanical/FRC_Sensor_CAN.step

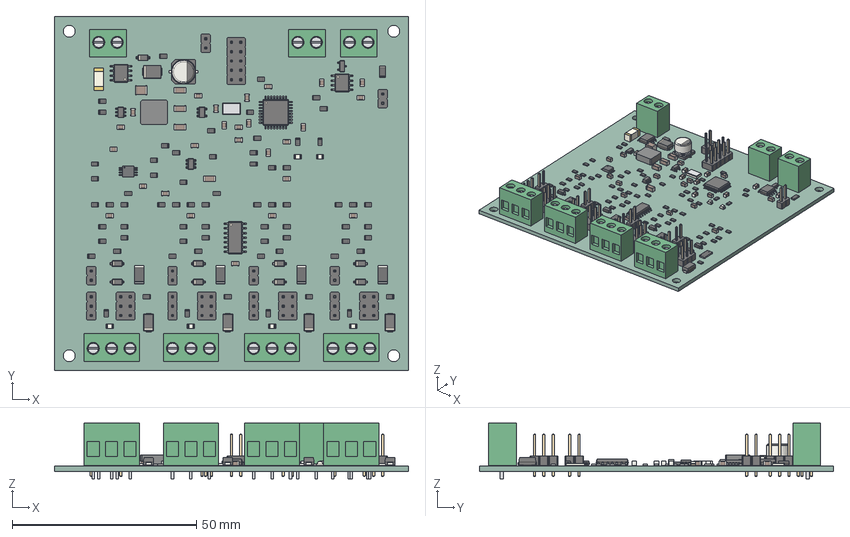
[picture p152: CAD file, 2026-09-08]
output/mechanical/FRC_Sensor_CAN.step
96.0 x 96.0 x 15.1 mm
CP_Elec_63x58
PinHeader_1x02_P254mm_Vertical x 6
R_0805_2012Metric x 70
LQFP-32_7x7mm_P0.8mm
C_1206_3216Metric x 4
R_1206_3216Metric
PinHeader_1x03_P254mm_Vertical x 4
C_0805_2012Metric x 26
shielded_core
terminal_0
terminal_1
D_SOD-123 x 9
D_SMB
PinHeader_2x03_P254mm_Vertical x 4
insulator x 7
pin_1 x 7
screw_1 x 7
pin_2 x 7
screw_2 x 7
D_SMA x 4
R_2010_5025Metric x 4
SOIC-8_3.9x4.9mm_P1.27mm x 2
ceramic x 2
cap_0
cap_1
LED_0805_2012Metric x 6
pin_3 x 4
screw_3 x 4
SOT-23
TSOT-23-6
C_1210_3225Metric
PinHeader_2x05_P254mm_Vertical
lid
SOIC-14_3.9x8.7mm_P1.27mm
lead_-1_0
lead_1_0
lead_-1_1
lead_1_1
lead_-1_2
lead_1_2
lead_-1_3
lead_1_3
exposed_pad
pin_one_dot
SOT-23-6
SOT-23-5
FRC_Sensor_CAN_PCB
