barkinvar/sugerCANe/rev_b2/output/mechanical/FRC_Sensor_CAN.step

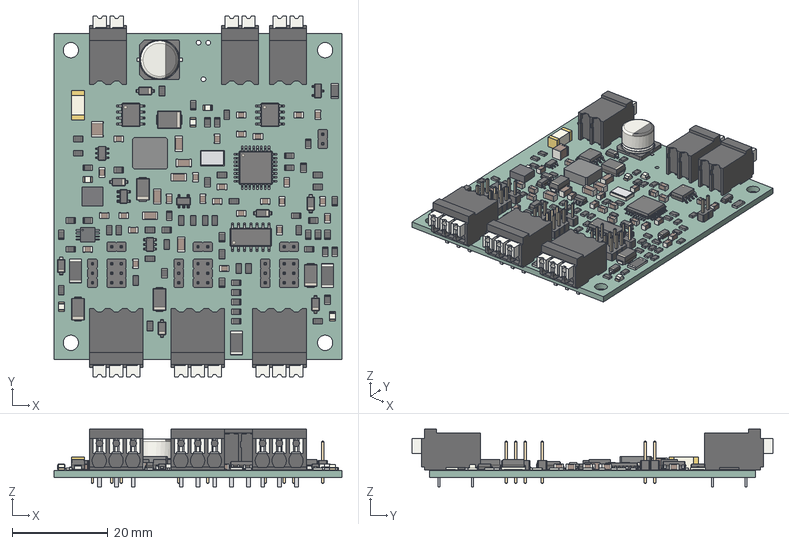
[picture p153: CAD file, 2026-09-08]
rev_b2/output/mechanical/FRC_Sensor_CAN.step
60.0 x 75.3 x 12.0 mm
R_0805_2012Metric x 59
C_1206_3216Metric x 6
TSOT-23-6
LED_0805_2012Metric x 5
D_SOD-123 x 7
C_0805_2012Metric x 26
SOT-23-5 x 2
shielded_core
terminal_0 x 2
terminal_1 x 2
D_SMA x 4
housing_0 x 6
button_1 x 6
button_2 x 6
pin_3 x 3
pin_4 x 6
pin_5 x 6
pin_6 x 6
PinHeader_1x02_P200mm_Vertical x 4
ceramic x 2
lid
SOT-23
PinHeader_1x03_P200mm_Vertical x 3
lead_-1_0
lead_1_0
lead_-1_1
lead_1_1
lead_-1_2
lead_1_2
lead_-1_3
lead_1_3
exposed_pad
pin_one_dot
button_3 x 3
pin_7 x 3
pin_8 x 3
pin_9 x 3
PinHeader_2x03_P200mm_Vertical x 3
R_2010_5025Metric x 3
cap_0
cap_1
SOT-23-6
SOIC-8_3.9x4.9mm_P1.27mm x 2
D_SMB
R_1206_3216Metric
C_1210_3225Metric
CP_Elec_8x65
LQFP-32_7x7mm_P0.8mm
SOIC-14_3.9x8.7mm_P1.27mm
FRC_Sensor_CAN_PCB
