barkinvar/sugerCANe/rev_c/output/mechanical/FRC_Sensor_CAN.step

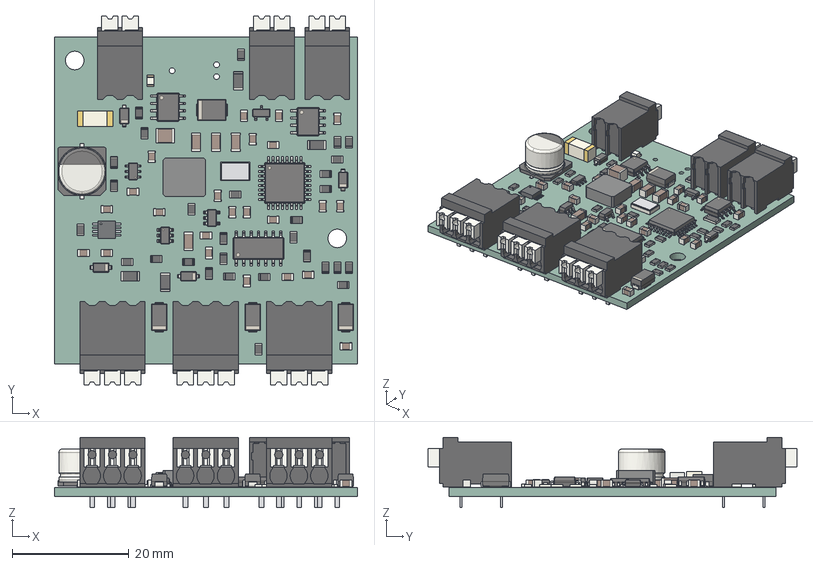
[picture p154: CAD file, 2026-09-08, an earlier design]
rev_c/output/mechanical/FRC_Sensor_CAN.step
52.0 x 63.3 x 12.0 mm
R_0805_2012Metric x 29
C_0805_2012Metric x 23
LED_0805_2012Metric
R_1206_3216Metric x 4
D_SMB
housing_0 x 6
button_1 x 6
button_2 x 6
pin_3 x 3
pin_4 x 6
pin_5 x 6
pin_6 x 6
LQFP-32_7x7mm_P0.8mm
lead_-1_0
lead_1_0
lead_-1_1
lead_1_1
lead_-1_2
lead_1_2
lead_-1_3
lead_1_3
exposed_pad
pin_one_dot
button_3 x 3
pin_7 x 3
pin_8 x 3
pin_9 x 3
C_1206_3216Metric x 4
C_1210_3225Metric
SOT-23-6
D_SMA x 3
TSOT-23-6
ceramic x 2
cap_0
cap_1
D_SOD-123 x 4
lid
SOIC-14_3.9x8.7mm_P1.27mm
SOIC-8_3.9x4.9mm_P1.27mm x 2
SOT-23
CP_Elec_8x65
shielded_core
terminal_0
terminal_1
SOT-23-5
FRC_Sensor_CAN_PCB
