barkinvar/sugerCANe/rev_d/output/mechanical/FRC_Sensor_CAN.step

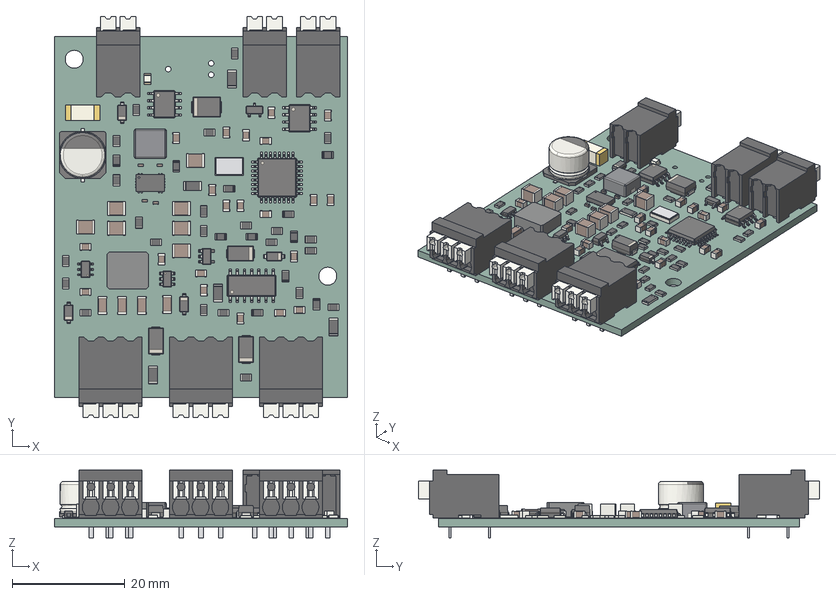
[picture p155: CAD file, 2026-09-08, an earlier design]
rev_d/output/mechanical/FRC_Sensor_CAN.step
52.0 x 71.3 x 12.0 mm
R_0805_2012Metric x 34
shielded_core
terminal_0
terminal_1
C_0805_2012Metric x 21
SOIC-8_3.9x4.9mm_P1.27mm x 2
C_1206_3216Metric x 4
D_SMA x 3
housing_0 x 6
button_1 x 6
button_2 x 6
pin_3 x 4
pin_4 x 7
pin_5 x 7
pin_6 x 7
D_SOD-123 x 4
C_1210_3225Metric x 7
SOT-23-6
button_3 x 3
pin_7 x 4
pin_8 x 4
pin_9 x 4
C_0402_1005Metric x 4
R_1206_3216Metric x 5
SOT-23-5
CP_Elec_8x65
D_SMB
TSOT-23-6
LQFP-32_7x7mm_P0.8mm
SOT-23
L_Bourns_SRP5030T
ceramic x 2
cap_0
cap_1
SOIC-14_3.9x8.7mm_P1.27mm
lid
mold
pin_1
pin_2
pin_14
pin_15
pin_16
pin_17
pin_12
pin_13
pin_18
pin_19
pin_20
pin_21
pin_10
pin_11
pin1mark
LED_0805_2012Metric
FRC_Sensor_CAN_PCB
