barkinvar/sugerCANe/(list of files, cad)

Other CAD files:
rev_b/output/mechanical/FRC_Sensor_CAN.step
rev_d2/output/mechanical/FRC_Sensor_CAN.step
