barkinvar/sugerCANe/reports/firmware-disassembly.txt

/home/neuro/candi-clone/firmware/build/sensor_can.elf:     file format elf32-littlearm

Disassembly of section .text:

080000c0 <parse_numbers>:
 80000c0:	b5f0      	push	{r4, r5, r6, r7, lr}
 80000c2:	250a      	movs	r5, #10
 80000c4:	0092      	lsls	r2, r2, #2
 80000c6:	4c12      	ldr	r4, [pc, #72]	@ (8000110 <parse_numbers+0x50>)
 80000c8:	188a      	adds	r2, r1, r2
 80000ca:	7803      	ldrb	r3, [r0, #0]
 80000cc:	2b20      	cmp	r3, #32
 80000ce:	d012      	beq.n	80000f6 <parse_numbers+0x36>
 80000d0:	3b30      	subs	r3, #48	@ 0x30
 80000d2:	2b09      	cmp	r3, #9
 80000d4:	d81a      	bhi.n	800010c <parse_numbers+0x4c>
 80000d6:	2300      	movs	r3, #0
 80000d8:	7806      	ldrb	r6, [r0, #0]
 80000da:	0037      	movs	r7, r6
 80000dc:	3f30      	subs	r7, #48	@ 0x30
 80000de:	2f09      	cmp	r7, #9
 80000e0:	d90b      	bls.n	80000fa <parse_numbers+0x3a>
 80000e2:	c108      	stmia	r1!, {r3}
 80000e4:	4291      	cmp	r1, r2
 80000e6:	d1f0      	bne.n	80000ca <parse_numbers+0xa>
 80000e8:	7803      	ldrb	r3, [r0, #0]
 80000ea:	2b20      	cmp	r3, #32
 80000ec:	d00c      	beq.n	8000108 <parse_numbers+0x48>
 80000ee:	425a      	negs	r2, r3
 80000f0:	4153      	adcs	r3, r2
 80000f2:	b2d8      	uxtb	r0, r3
 80000f4:	bdf0      	pop	{r4, r5, r6, r7, pc}
 80000f6:	3001      	adds	r0, #1
 80000f8:	e7e7      	b.n	80000ca <parse_numbers+0xa>
 80000fa:	42a3      	cmp	r3, r4
 80000fc:	d806      	bhi.n	800010c <parse_numbers+0x4c>
 80000fe:	436b      	muls	r3, r5
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
 8001bb8:	00205241 	.word	0x00205241
 8001bbc:	20544553 	.word	0x20544553
 8001bc0:	52524500 	.word	0x52524500
 8001bc4:	4548203a 	.word	0x4548203a
 8001bc8:	6620504c 	.word	0x6620504c
 8001bcc:	7320726f 	.word	0x7320726f
 8001bd0:	61746e79 	.word	0x61746e79
 8001bd4:	000a0d78 	.word	0x000a0d78
