barkinvar/sugerCANe/output/documentation/setup_worksheet.html

REVISION A · OFFLINE BUILD WORKSHEET

# FRC Sensor CAN setup

Choose your sensor outputs, check the shared power budget, and record the jumpers and service command for this board.

## Jumper worksheet

Identify pin 1 from the square pad and assembly drawing. These settings refer to numbered pins, regardless of header orientation.

Port | Power | Threshold | Bias

12Port pull-up

343.3 V pull-up

56Pulldown

Install one shunt at most on each power or bias selector. Disconnect board power before changing jumpers. JP1 is momentary reset; leave it open. JP2 is CAN termination; fit it only at a physical end of the trunk.

## Connection limits

- Each sensor connector is pin 1 POWER, pin 2 GND, pin 3 SIGNAL. The board targets 0–30 V positive signals and a 6–18 V protected board supply.
- Battery power follows the robot battery. A sensor requiring 10 V can fail during a battery sag while this interface continues running.
- Logic mode targets LOW ≤0.8 V and HIGH ≥2.4 V. Industrial mode targets LOW ≤4 V and HIGH ≥7 V.
- Industrial NPN/PNP examples assume ≤0.5 mA off leakage. The 3.3 V open-drain pull-up example assumes ≤50 µA. Check the actual sensor datasheet.
- External supply voltage must never enter a POWER pin. Externally powered 24 V sensors need the wiring arrangements in the full guide.

This worksheet performs arithmetic and selects documented modes. It does not establish sensor compatibility, measured electrical ratings, or robot inspection approval.

Full wiring instructions · Printable handbook · Interactive assembly BOM

## Shared rail budget

Regulated 5 V0 / 300 mA

Battery0 / 300 mA

Sum of entered sensor currents and conservative bias-load allowances. The 300 mA budget applies to each complete rail, shared by all four ports. Startup current requires a separate bench check.

## Board configuration

Device ID

Debounce, ms

Service serial port

Save selected sensor rails as ON at startup, after wiring and rail tests pass.

### Provisioning command

Run from the project folder using the 3.3 V UART service connection. This page never connects to or programs the board.

Copy commandSave worksheetPrint

## Before enabling power

Verify polarity, shunts and both rail voltages with a current-limited supply. Assign a unique ID before connecting to the robot CAN bus. Use the supplied robot driver’s stale-data checks and explicit fault recovery.

Original sensor interface · Hardware A · Firmware 0.1.0 · Protocol 1
Dated design worksheet: 2026-09-07
