barkinvar/sugerCANe/output/assembly/crystal_land_review.pdf

Y1 · Abracon ABM3B recommended lands

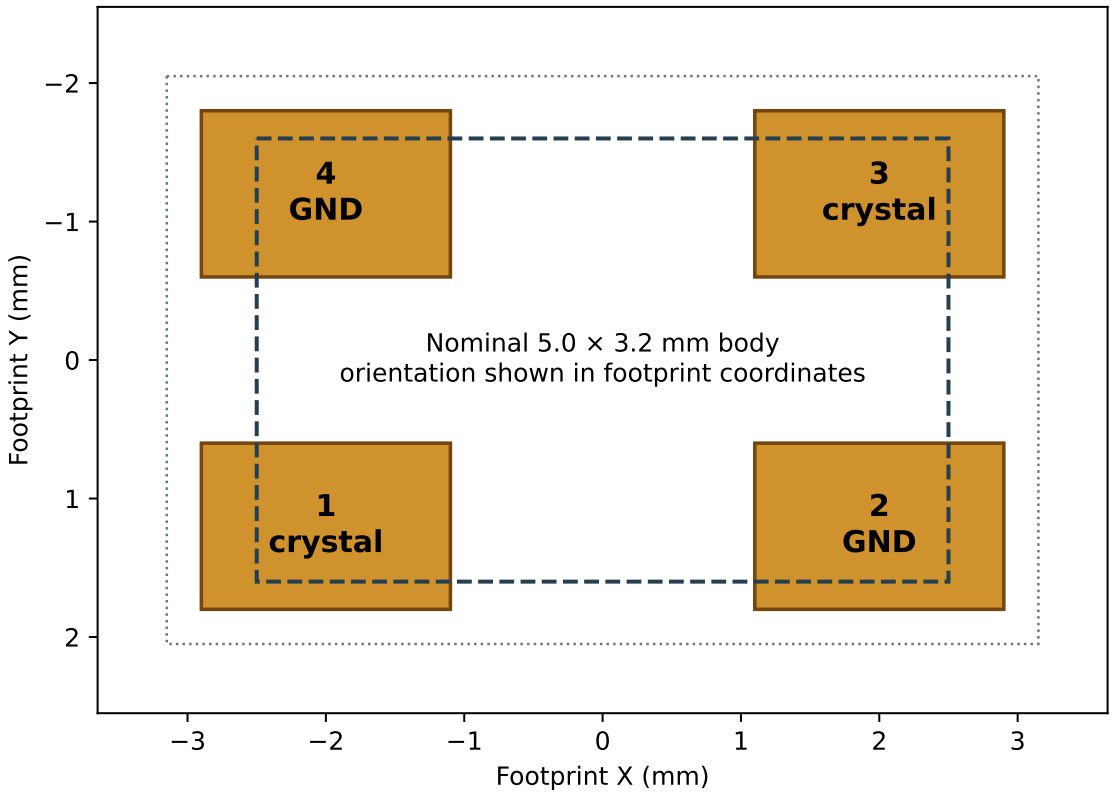
[picture p157: figure]
Footprint X (mm); Footprint Y (mm); 1 crystal; 2 GND; 3 crystal; 4 GND; Nominal 5.0 × 3.2 mm body orientation shown in footprint coordinates

Copper: 1.8 × 1.2 mm pads · center spacing 4.0 × 2.4 mm Dashed: nominal body · dotted: courtyard · PCB placement rotates this footprint 180°
