barkinvar/sugerCANe/current/output/documentation/MCU_hand_solder_map.pdf

# U5: hand-solder the original MCU

STM32F042K6T6 / LQFP32 / DigiKey 497-14647-ND Component-side view. Board top edge is up. Do not mirror this diagram.

U5
7 x 7 mm body

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
9 | 10 | 11 | 12 | 13 | 14 | 15 | 16

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
32 | 31 | 30 | 29 | 28 | 27 | 26 | 25

## PIN 1 - match the package pin-one mark

1. Leave the board unpowered. Install U5 before tall terminals and headers.
2. Align the pin-one mark and all four rows. Tack two opposite corner leads.
3. Recheck alignment, add flux and solder the remaining leads with an iron.
4. Wick bridges, clean as specified for the flux, and inspect all 32 leads.
5. Check supply shorts and adjacent leads against the schematic before power. No central exposed pad: all solder joints are on visible perimeter leads. Factory U5 pads must arrive unpasted. A QFN / K6U6TR will not fit.
Use the full ordering guide for current-limited bring-up and SWD programming.

U5 center: X=39.5, Y=25 mm from board top-left.
Pad 1 center: X=35.325, Y=22.2 mm from board top-left.

Pad centers and numbering from the native board manifest; drawing is enlarged, not 1:1.
