barkinvar/sugerCANe/output/assembly/crystal_land_review.png

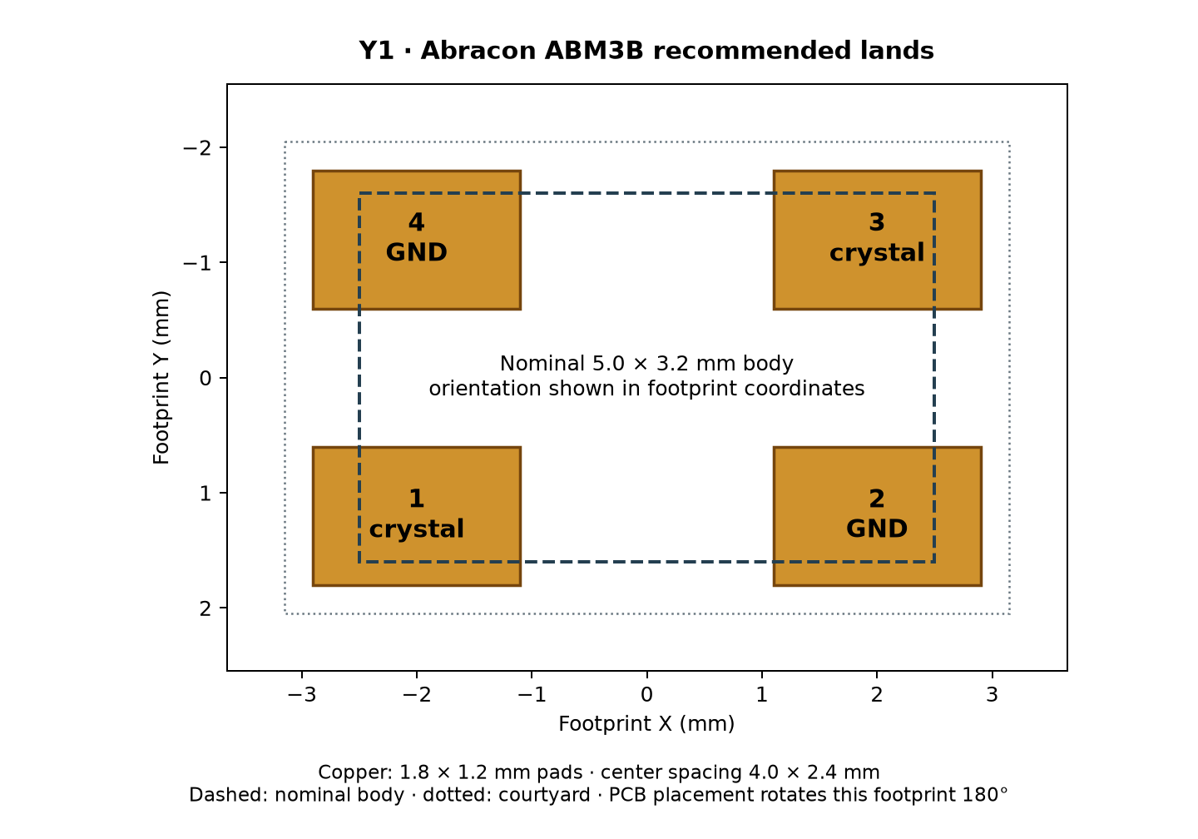
output/assembly/crystal_land_review.png
