barkinvar/sugerCANe/output/playwright/assembly_u3_highlight.png

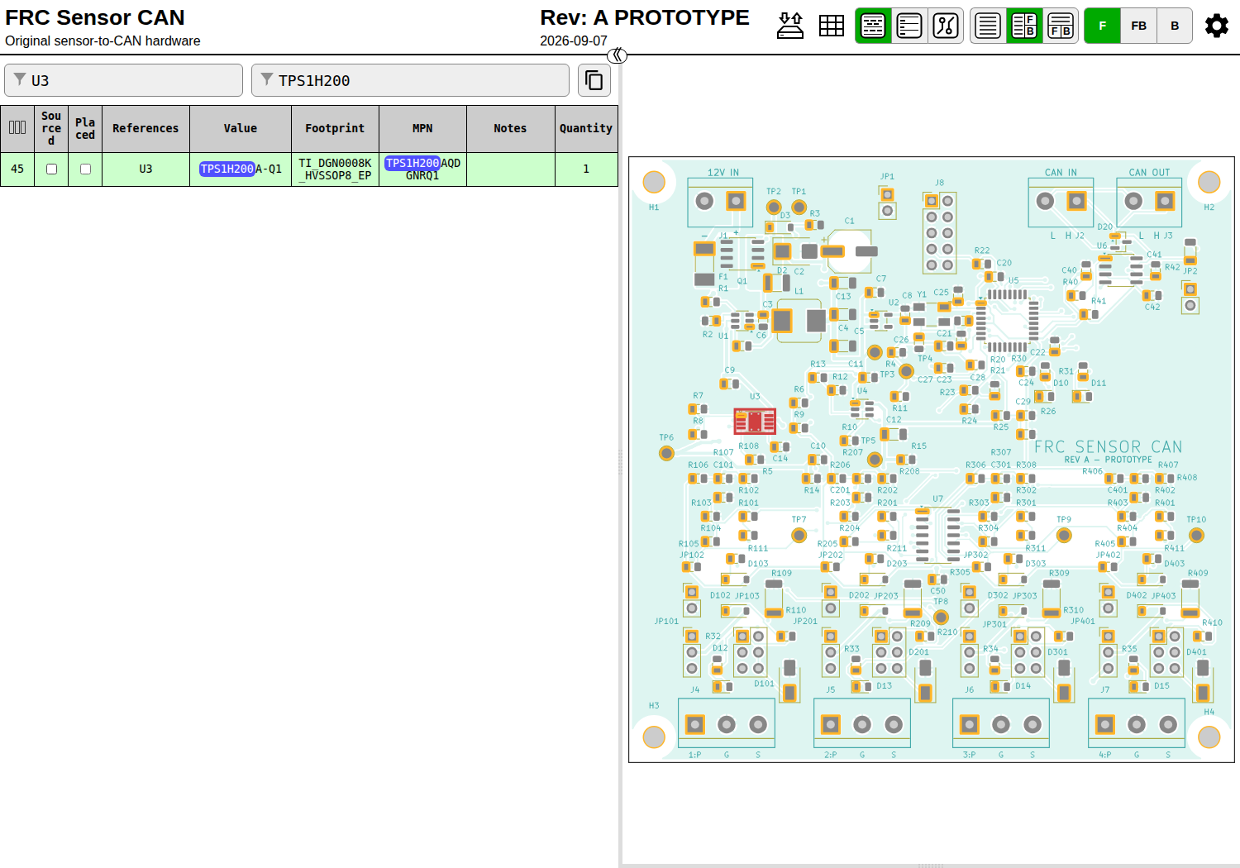
output/playwright/assembly_u3_highlight.png
