barkinvar/sugerCANe/output/playwright/worksheet_print_page1.png

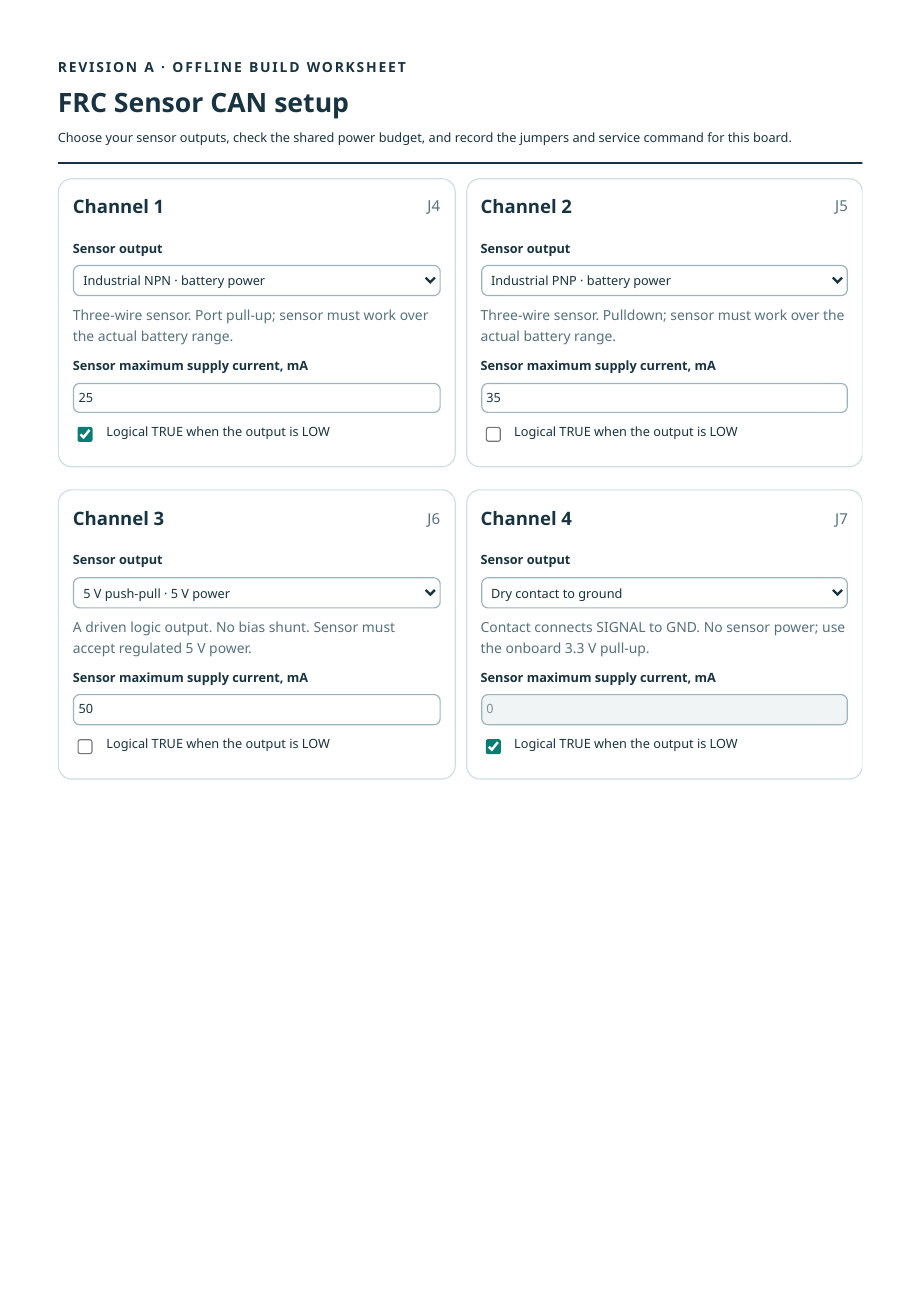
output/playwright/worksheet_print_page1.png
