barkinvar/sugerCANe/output/review/board_3d_assembled.png

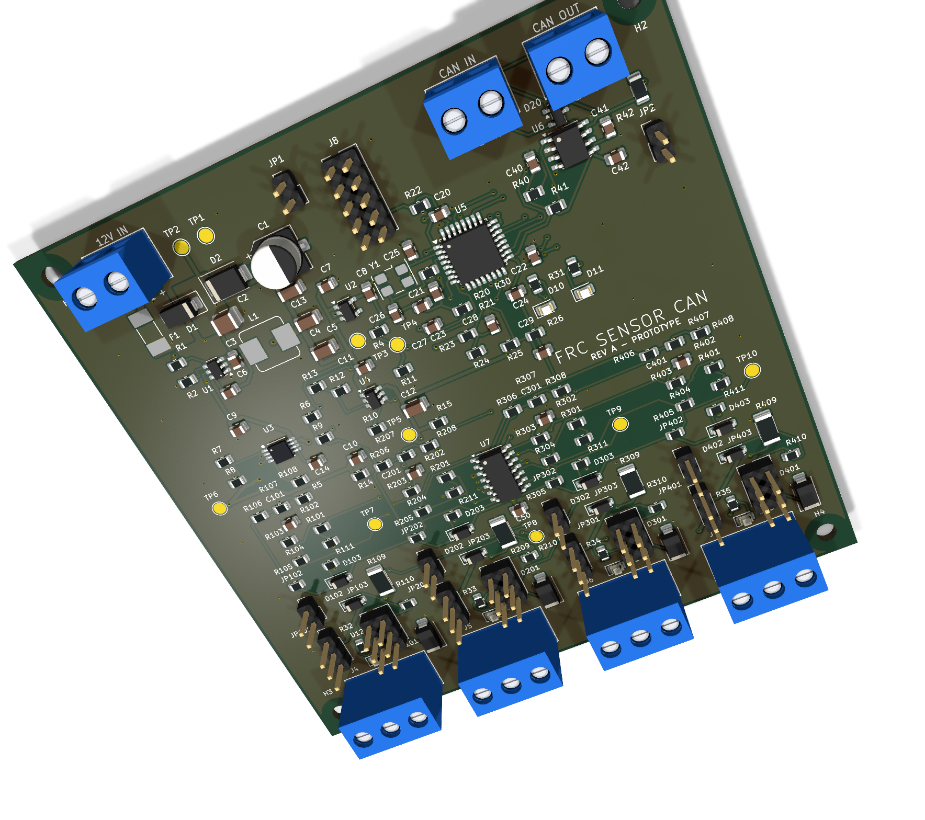
output/review/board_3d_assembled.png
