barkinvar/sugerCANe/output/review/top_assembly.png

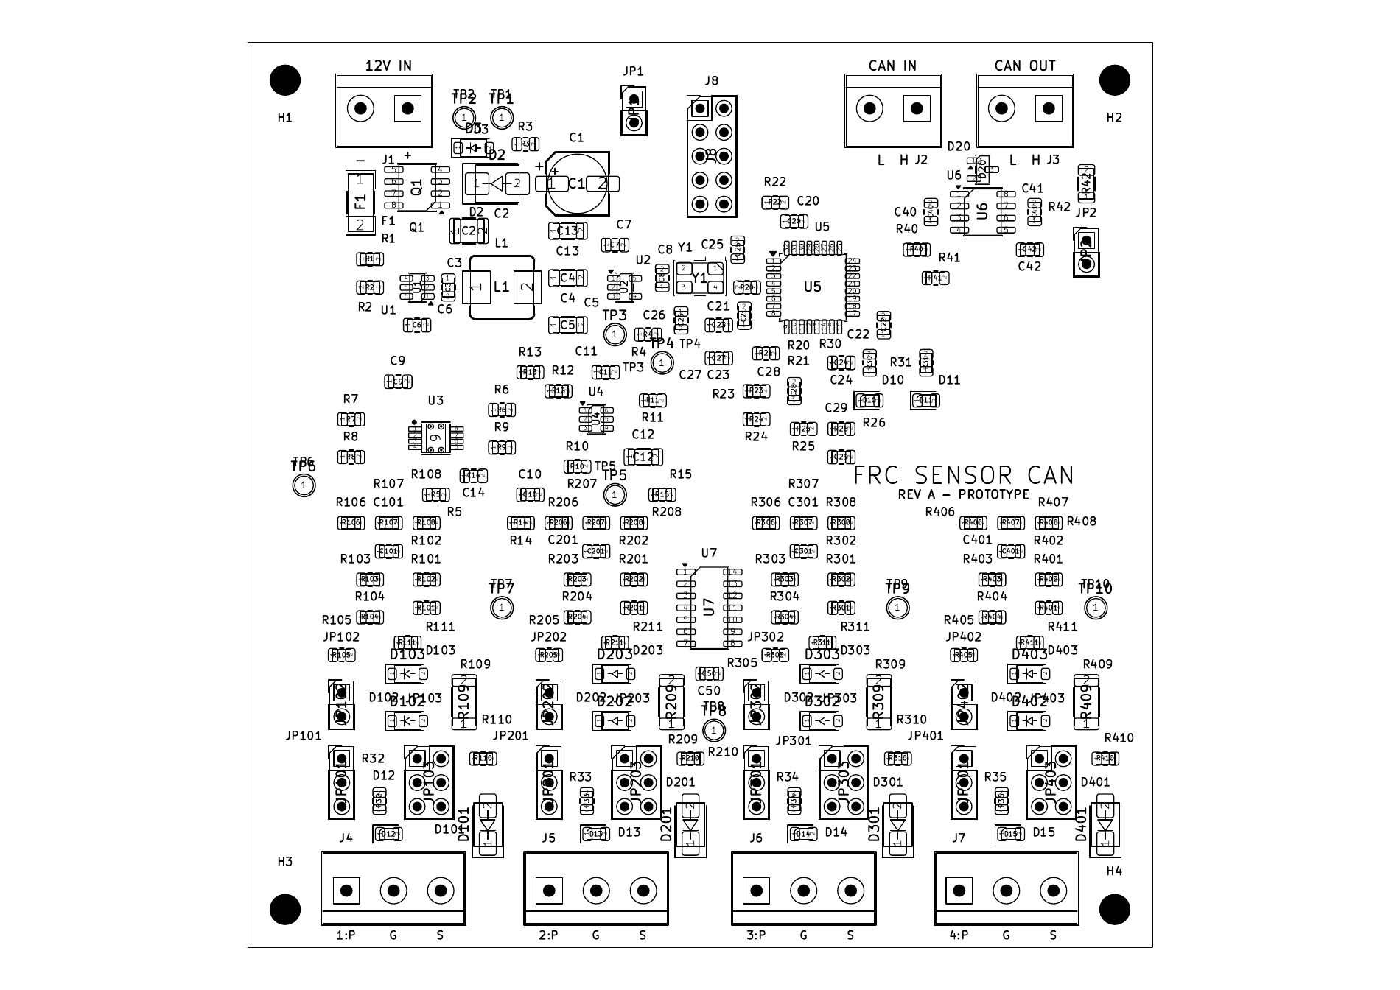
output/review/top_assembly.png
