barkinvar/sugerCANe/current/reports/electrical/boost_spice_experiments.png

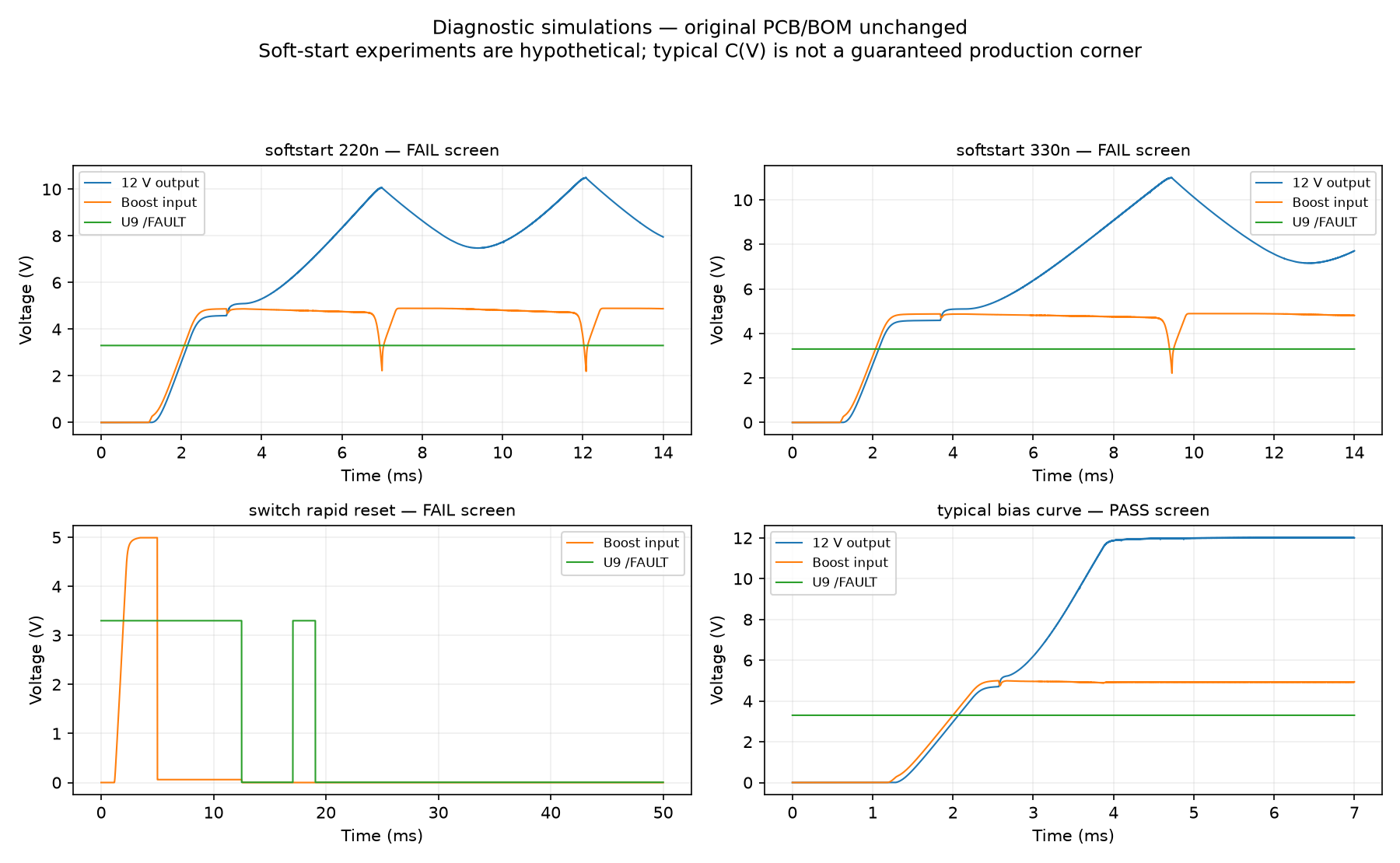
current/reports/electrical/boost_spice_experiments.png
