barkinvar/sugerCANe/output/assembly/power_layout_review.pdf

## Buck regulator layout review · actual Gerber copper

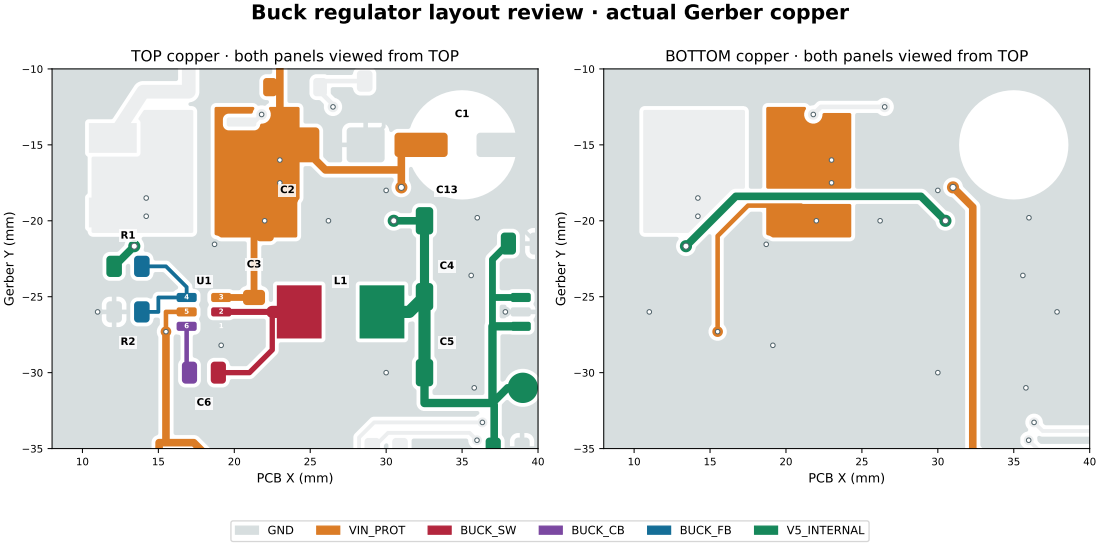
[picture p165: page 1]

TOP copper · both panels viewed from TOP

BOTTOM copper · both panels viewed from TOP
