barkinvar/sugerCANe/output/documentation/architecture.pdf

# FRC SENSOR CAN

## Revision A prototype • Original four-channel sensor interface

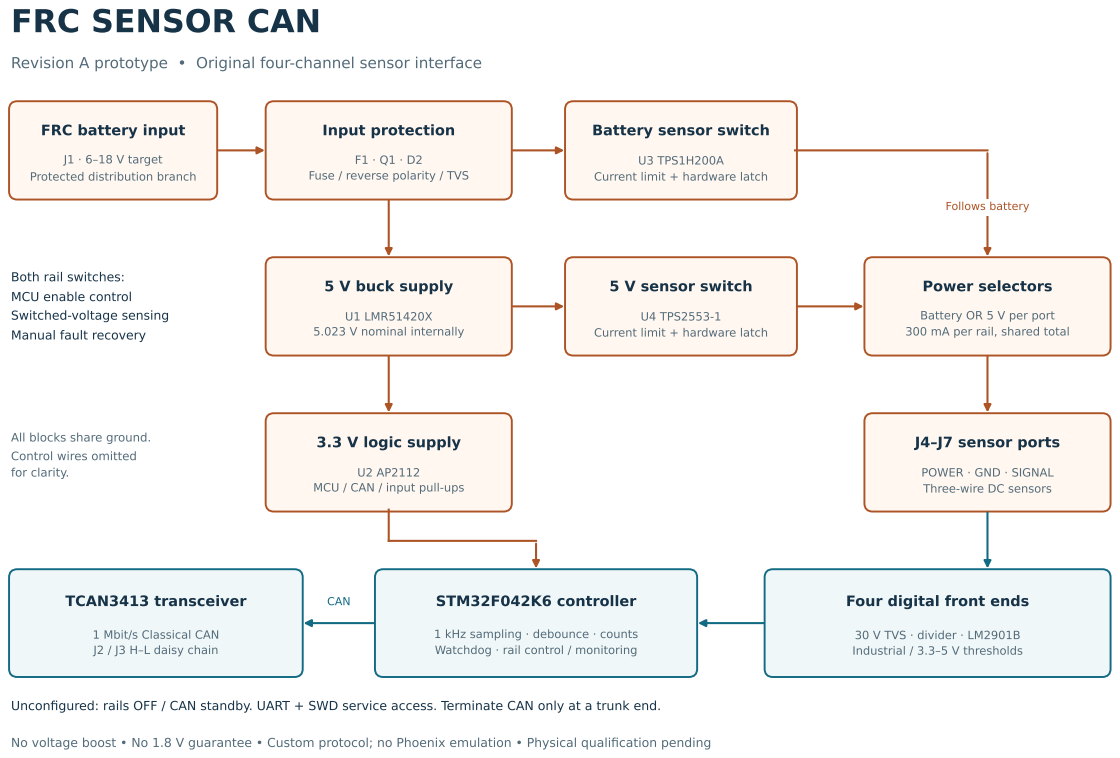
[picture p166: page 1]

Fuse / reverse polarity / TVS

Current limit + hardware latch

Battery OR 5 V per port
300 mA per rail, shared total

All blocks share ground.
Control wires omitted
for clarity.

POWER · GND · SIGNAL
Three-wire DC sensors

MCU / CAN / input pull-ups

Four digital front ends

1 kHz sampling · debounce · counts
Watchdog · rail control / monitoring

Unconfigured: rails OFF / CAN standby. UART + SWD service access. Terminate CAN only at a trunk end.

No voltage boost • No 1.8 V guarantee • Custom protocol; no Phoenix emulation • Physical qualification pending
