barkinvar/sugerCANe/output/documentation/wiring_card.pdf

# Bench connector map

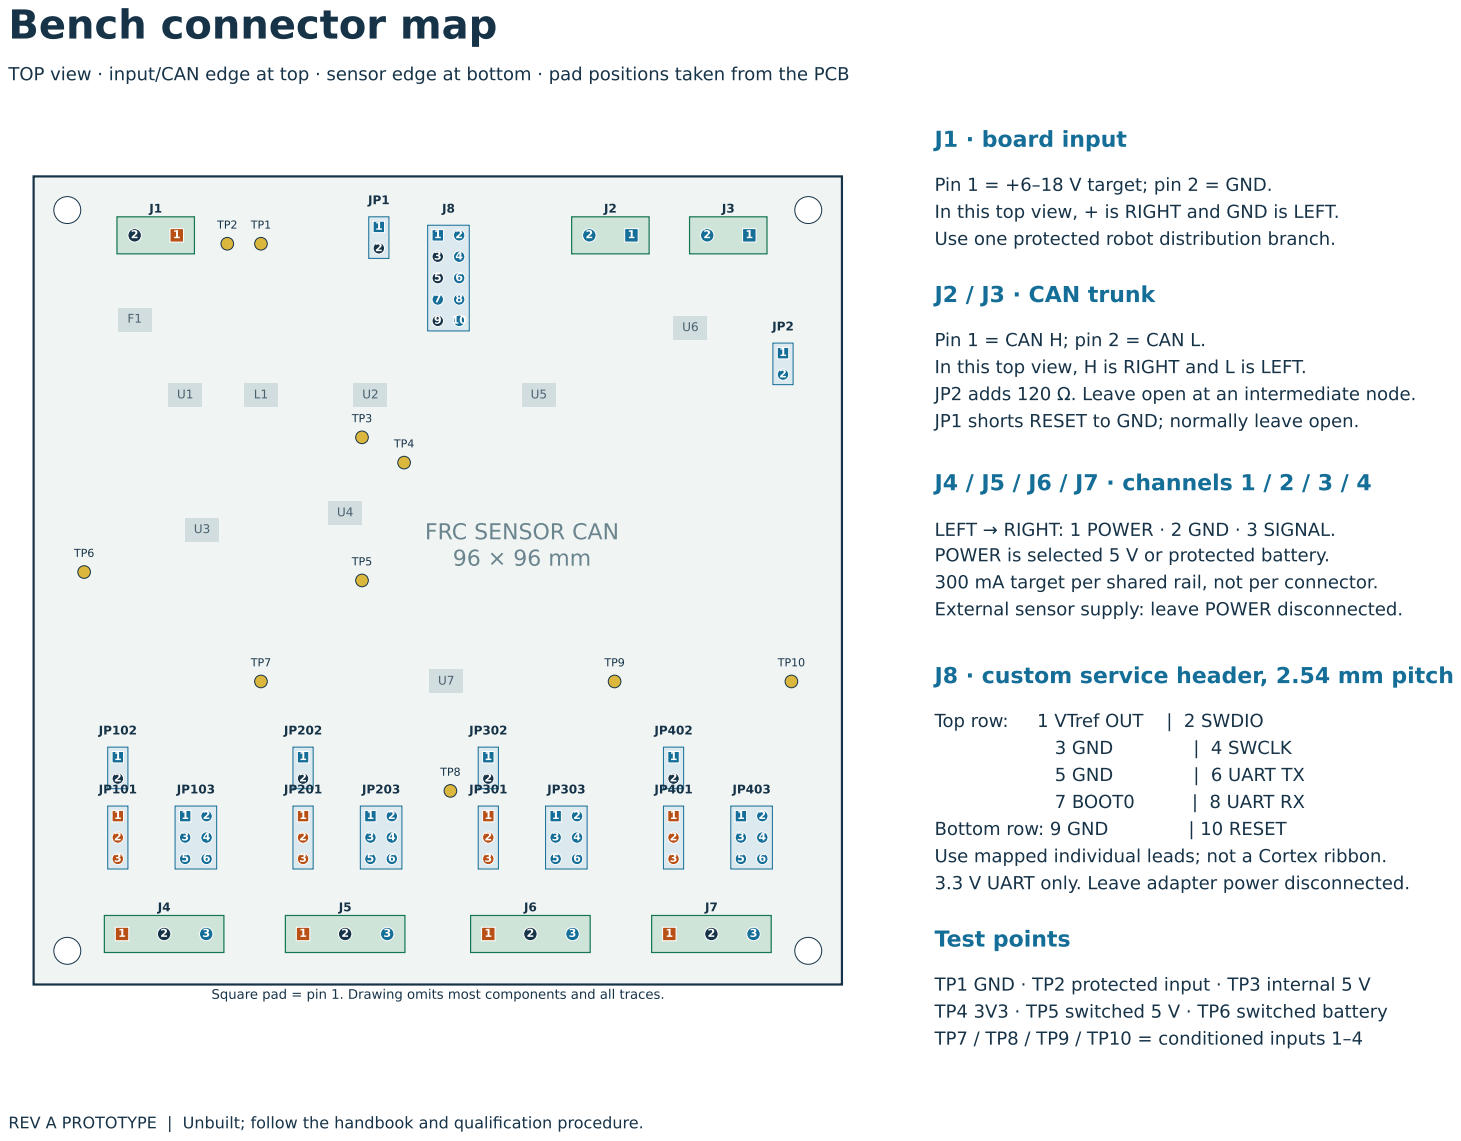
[picture p167: page 1]

TOP view · input/CAN edge at top · sensor edge at bottom · pad positions taken from the PCB

Pin 1 = +6–18 V target; pin 2 = GND.

In this top view, + is RIGHT and GND is LEFT.
Use one protected robot distribution branch.

Pin 1 = CAN H; pin 2 = CAN L.
In this top view, H is RIGHT and L is LEFT.
JP2 adds 120 Ω. Leave open at an intermediate node.

JP1 shorts RESET to GND; normally leave open.

LEFT → RIGHT: 1 POWER · 2 GND · 3 SIGNAL.

POWER is selected 5 V or protected battery.
300 mA target per shared rail, not per connector.
External sensor supply: leave POWER disconnected.

J8 · custom service header, 2.54 mm pitch

Use mapped individual leads; not a Cortex ribbon.
3.3 V UART only. Leave adapter power disconnected.

TP1 GND · TP2 protected input · TP3 internal 5 V
TP4 3V3 · TP5 switched 5 V · TP6 switched battery
TP7 / TP8 / TP9 / TP10 = conditioned inputs 1–4

Square pad = pin 1. Drawing omits most components and all traces.

REV A PROTOTYPE | Unbuilt; follow the handbook and qualification procedure.

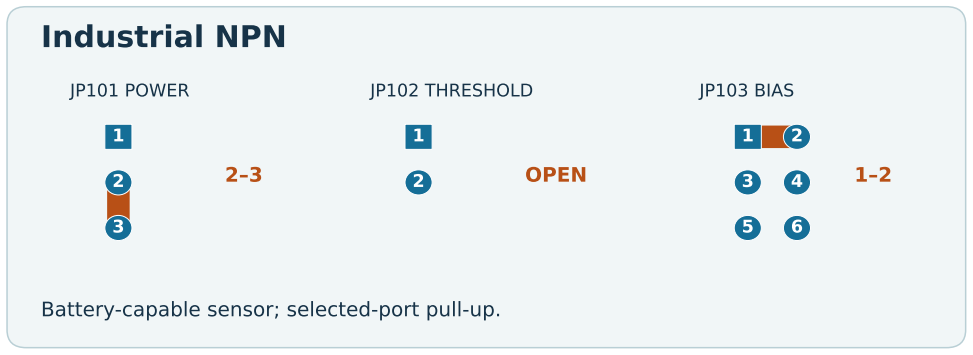
[picture p168: figure]
Industrial NPN; JP101 POWER; JP102 THRESHOLD; OPEN; JP103 BIAS; Battery-capable sensor; selected-port pull-up.
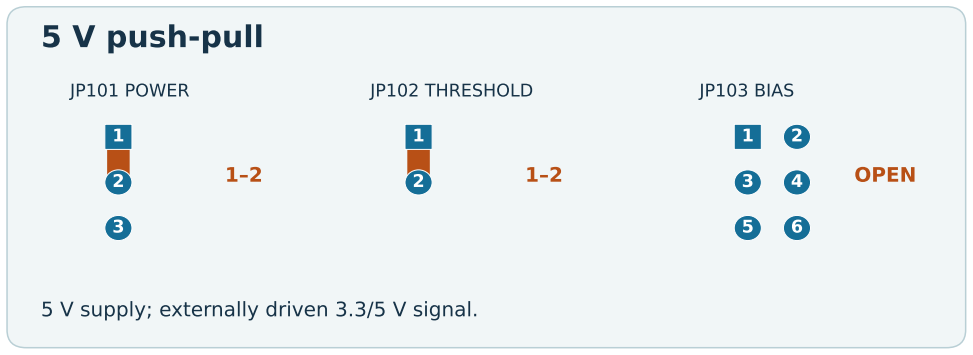
[picture p169: figure]
5 V push-pull; JP101 POWER; JP102 THRESHOLD; JP103 BIAS; OPEN
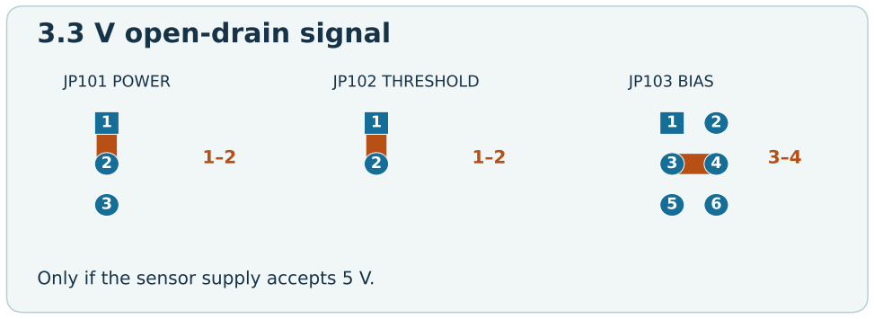
[picture p170: figure]
3.3 V open-drain signal; JP101 POWER; JP102 THRESHOLD; JP103 BIAS; Only if the sensor supply accepts 5 V.

5 V supply; externally driven 3.3/5 V signal.

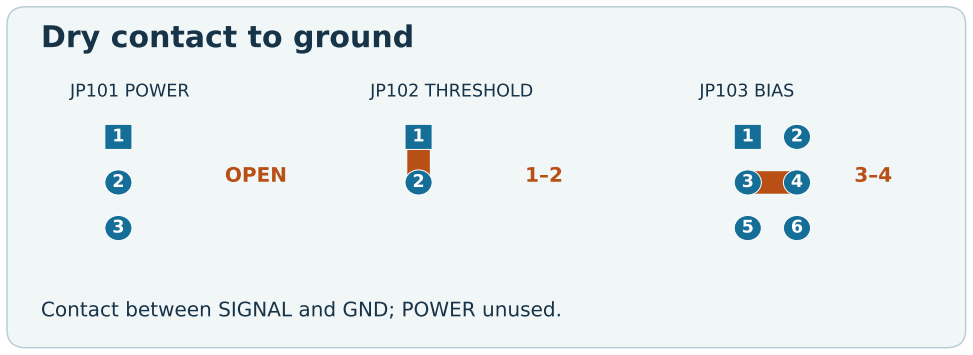
[picture p171: figure]
Dry contact to ground; JP101 POWER; OPEN; JP102 THRESHOLD; JP103 BIAS

Contact between SIGNAL and GND; POWER unused.

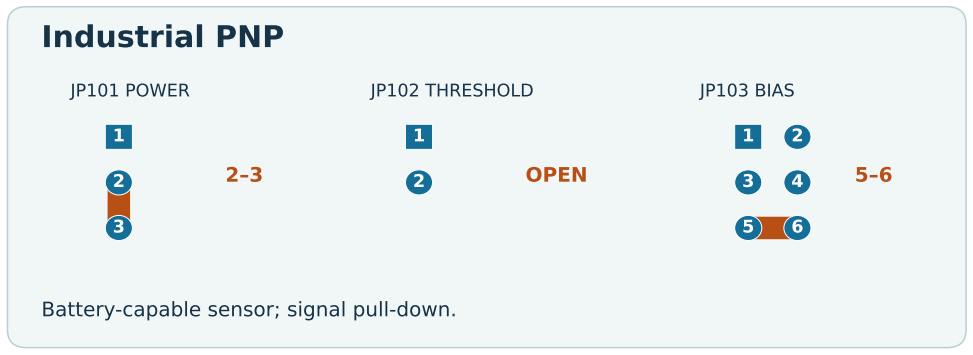
[picture p172: figure]
Industrial PNP; JP101 POWER; JP102 THRESHOLD; OPEN; JP103 BIAS; Battery-capable sensor; signal pull-down.
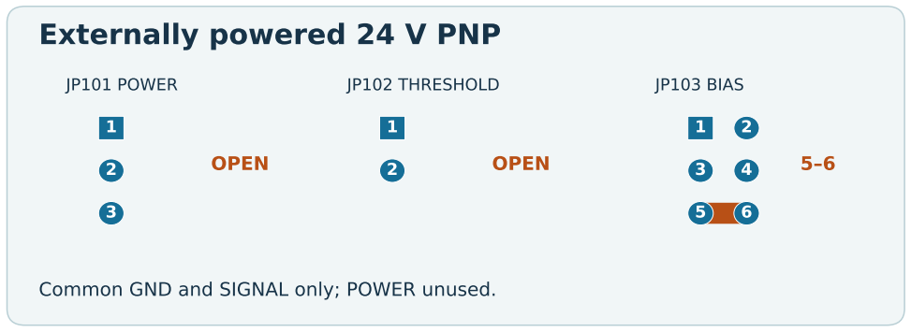
[picture p173: figure]
Externally powered 24 V PNP; JP101 POWER; OPEN; JP102 THRESHOLD; JP103 BIAS

Common GND and SIGNAL only; POWER unused.

# Jumper examples · channel 1

Disconnect board and sensor power before changing shunts. These drawings keep the TOP-view pin orientation.

REV A PROTOTYPE | Unbuilt; follow the handbook and qualification procedure.

Repeat JP1xx settings at JP2xx / JP3xx / JP4xx for channels 2 / 3 / 4. Fit at most ONE power shunt and ONE bias shunt per channel.

Threshold OPEN = industrial; FITTED = logic. Verify actual sensor LOW/HIGH/leakage limits and inversion. Firmware defaults to sensor rails OFF.
