barkinvar/sugerCANe/output/review/schematic.pdf

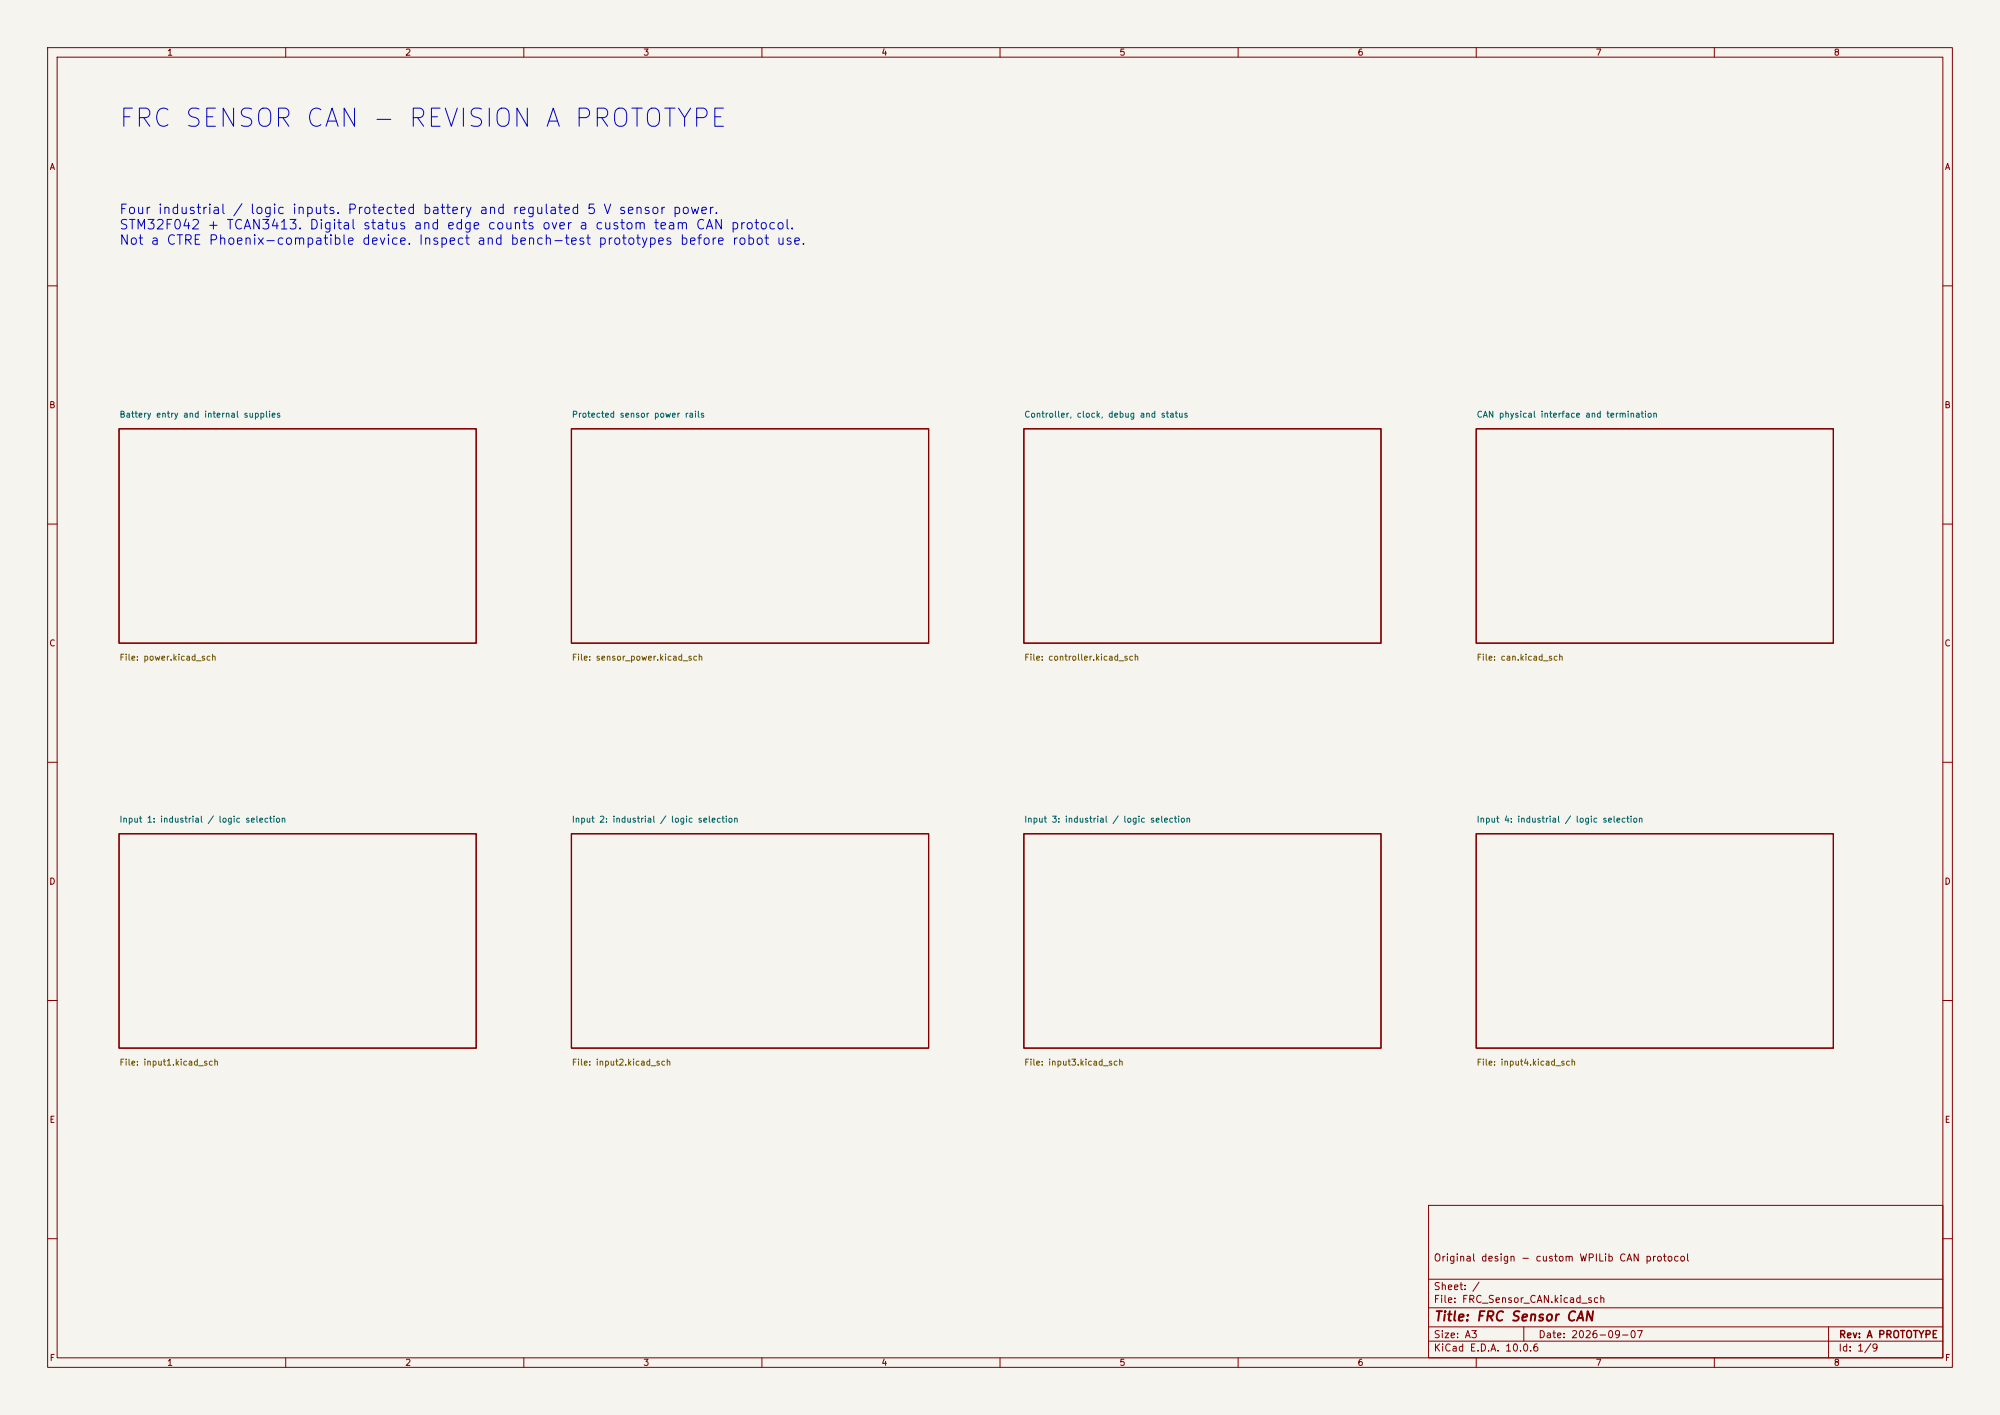
[picture p174: page 1]

FRC SENSOR CAN - REVISION A PROTOTYPE

Four industrial / logic inputs. Protected battery and regulated 5 V sensor power.
STM32F042 + TCAN3413. Digital status and edge counts over a custom team CAN protocol.
Not a CTRE Phoenix-compatible device. Inspect and bench-test prototypes before robot use.

Input 1: industrial / logic selection

Input 2: industrial / logic selection

Input 3: industrial / logic selection

Input 4: industrial / logic selection

Original design - custom WPILib CAN protocol

Sheet: /
File: FRC_Sensor_CAN.kicad_sch
Title: FRC Sensor CAN

Size: A3 | Rev: A PROTOTYPE | F Date: 2026-09-07
KiCad E.D.A. 10.0.6 | Id: 1/9

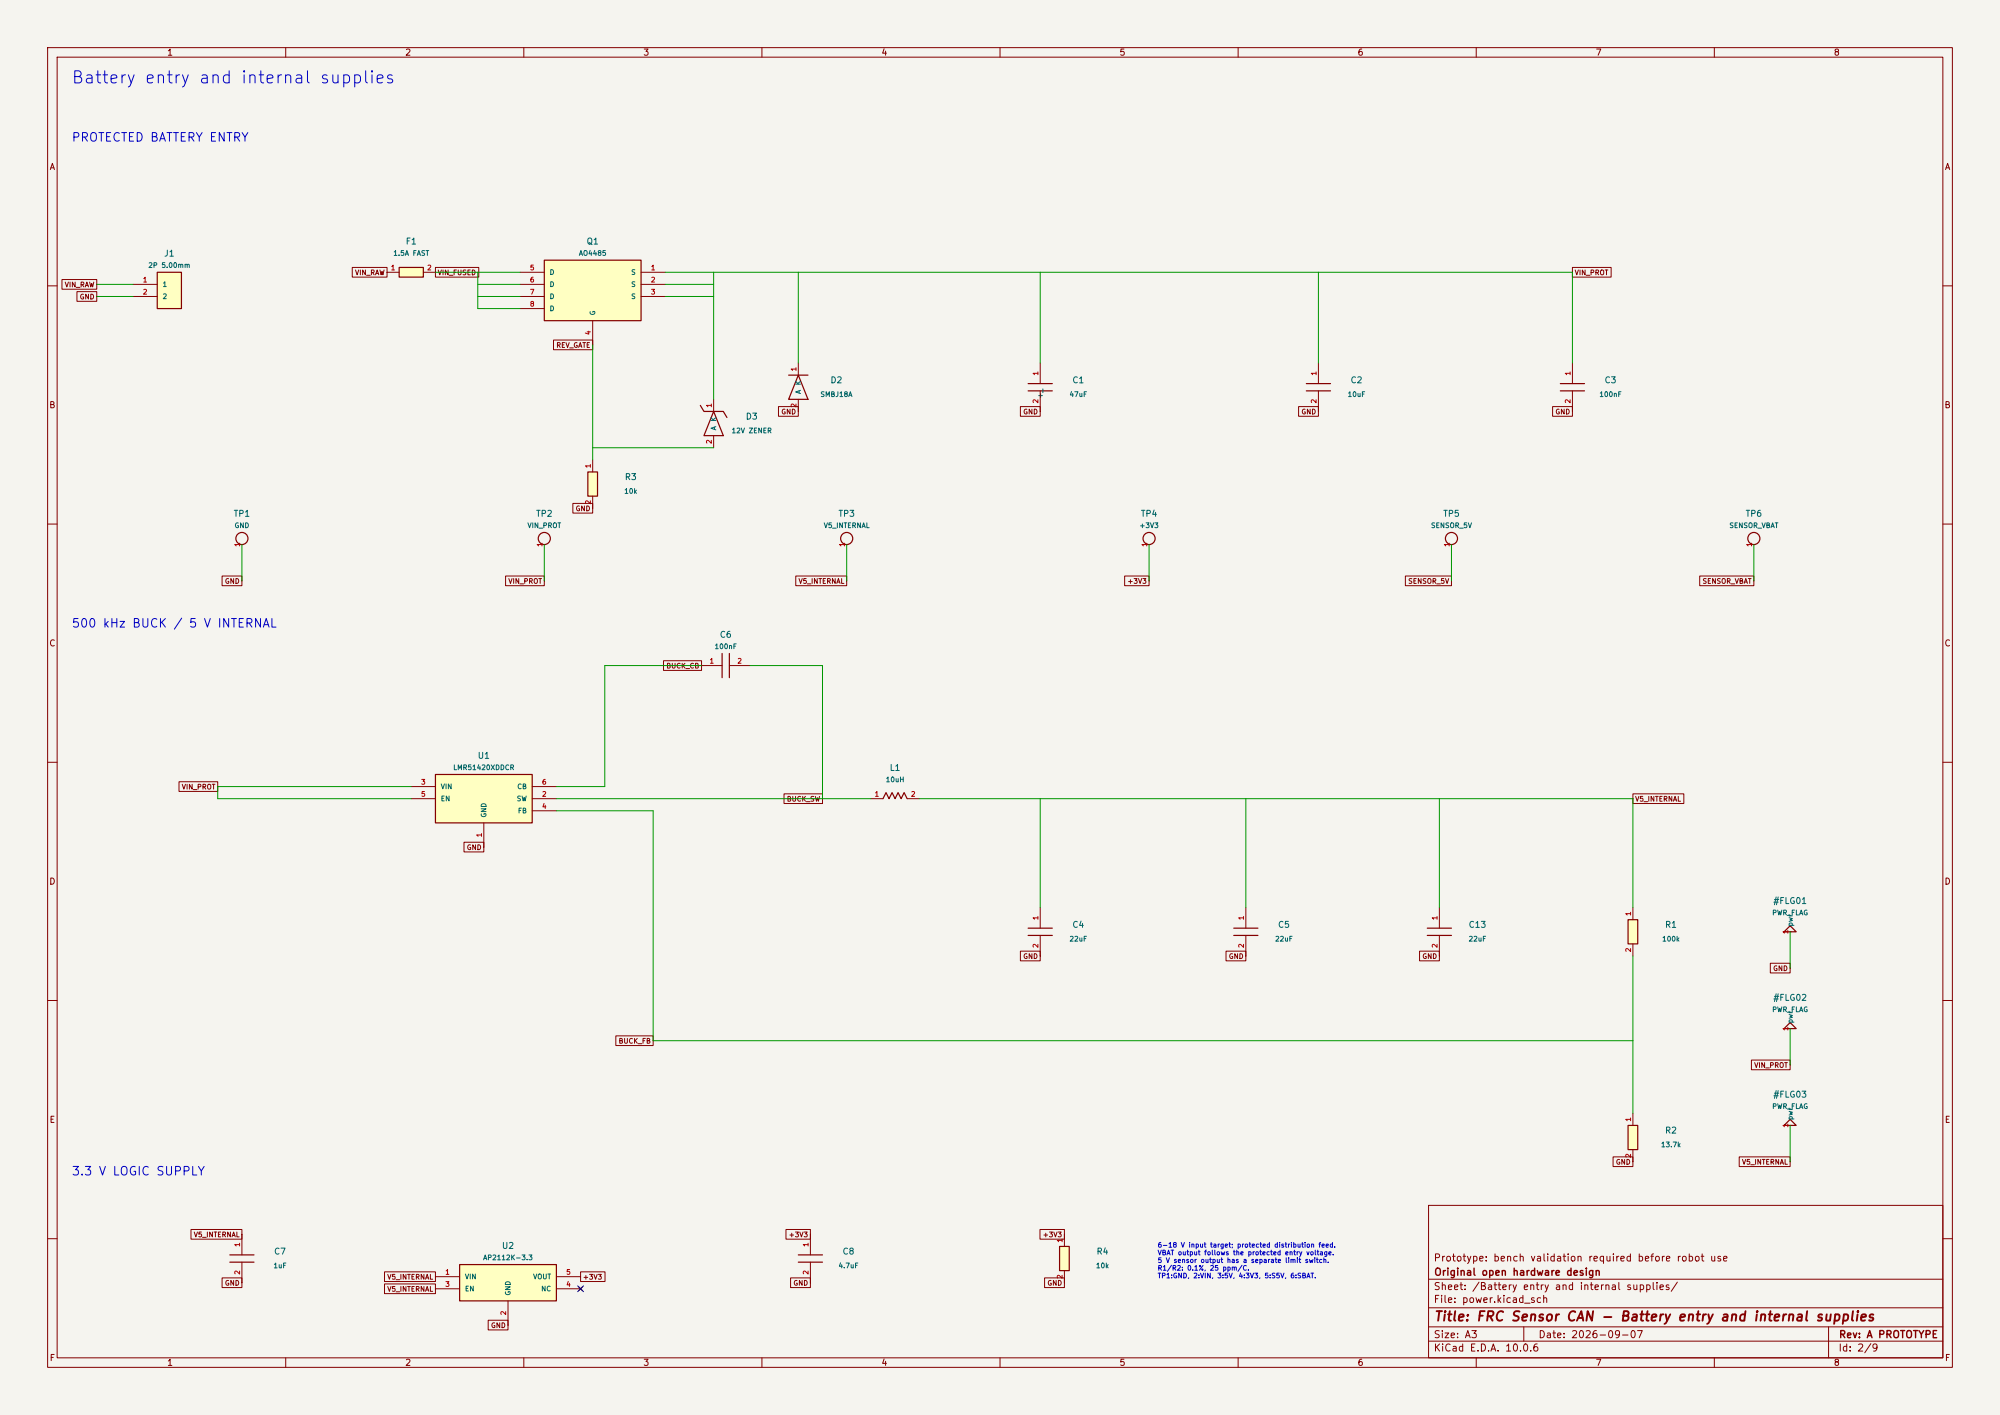
[picture p175: page 2]

GND Battery entry and internal supplies

6-18 V input target; protected distribution feed. VBAT output follows the protected entry voltage. 5 V sensor output has a separate limit switch. R1/R2: 0.1%, 25 ppm/C. TP1:GND, 2:VIN, 3:5V, 4:3V3, 5:S5V, 6:SBAT.

Prototype: bench validation required before robot use
Original open hardware design
Sheet: /Battery entry and internal supplies/
File: power.kicad_sch
Title: FRC Sensor CAN - Battery entry and internal supplies

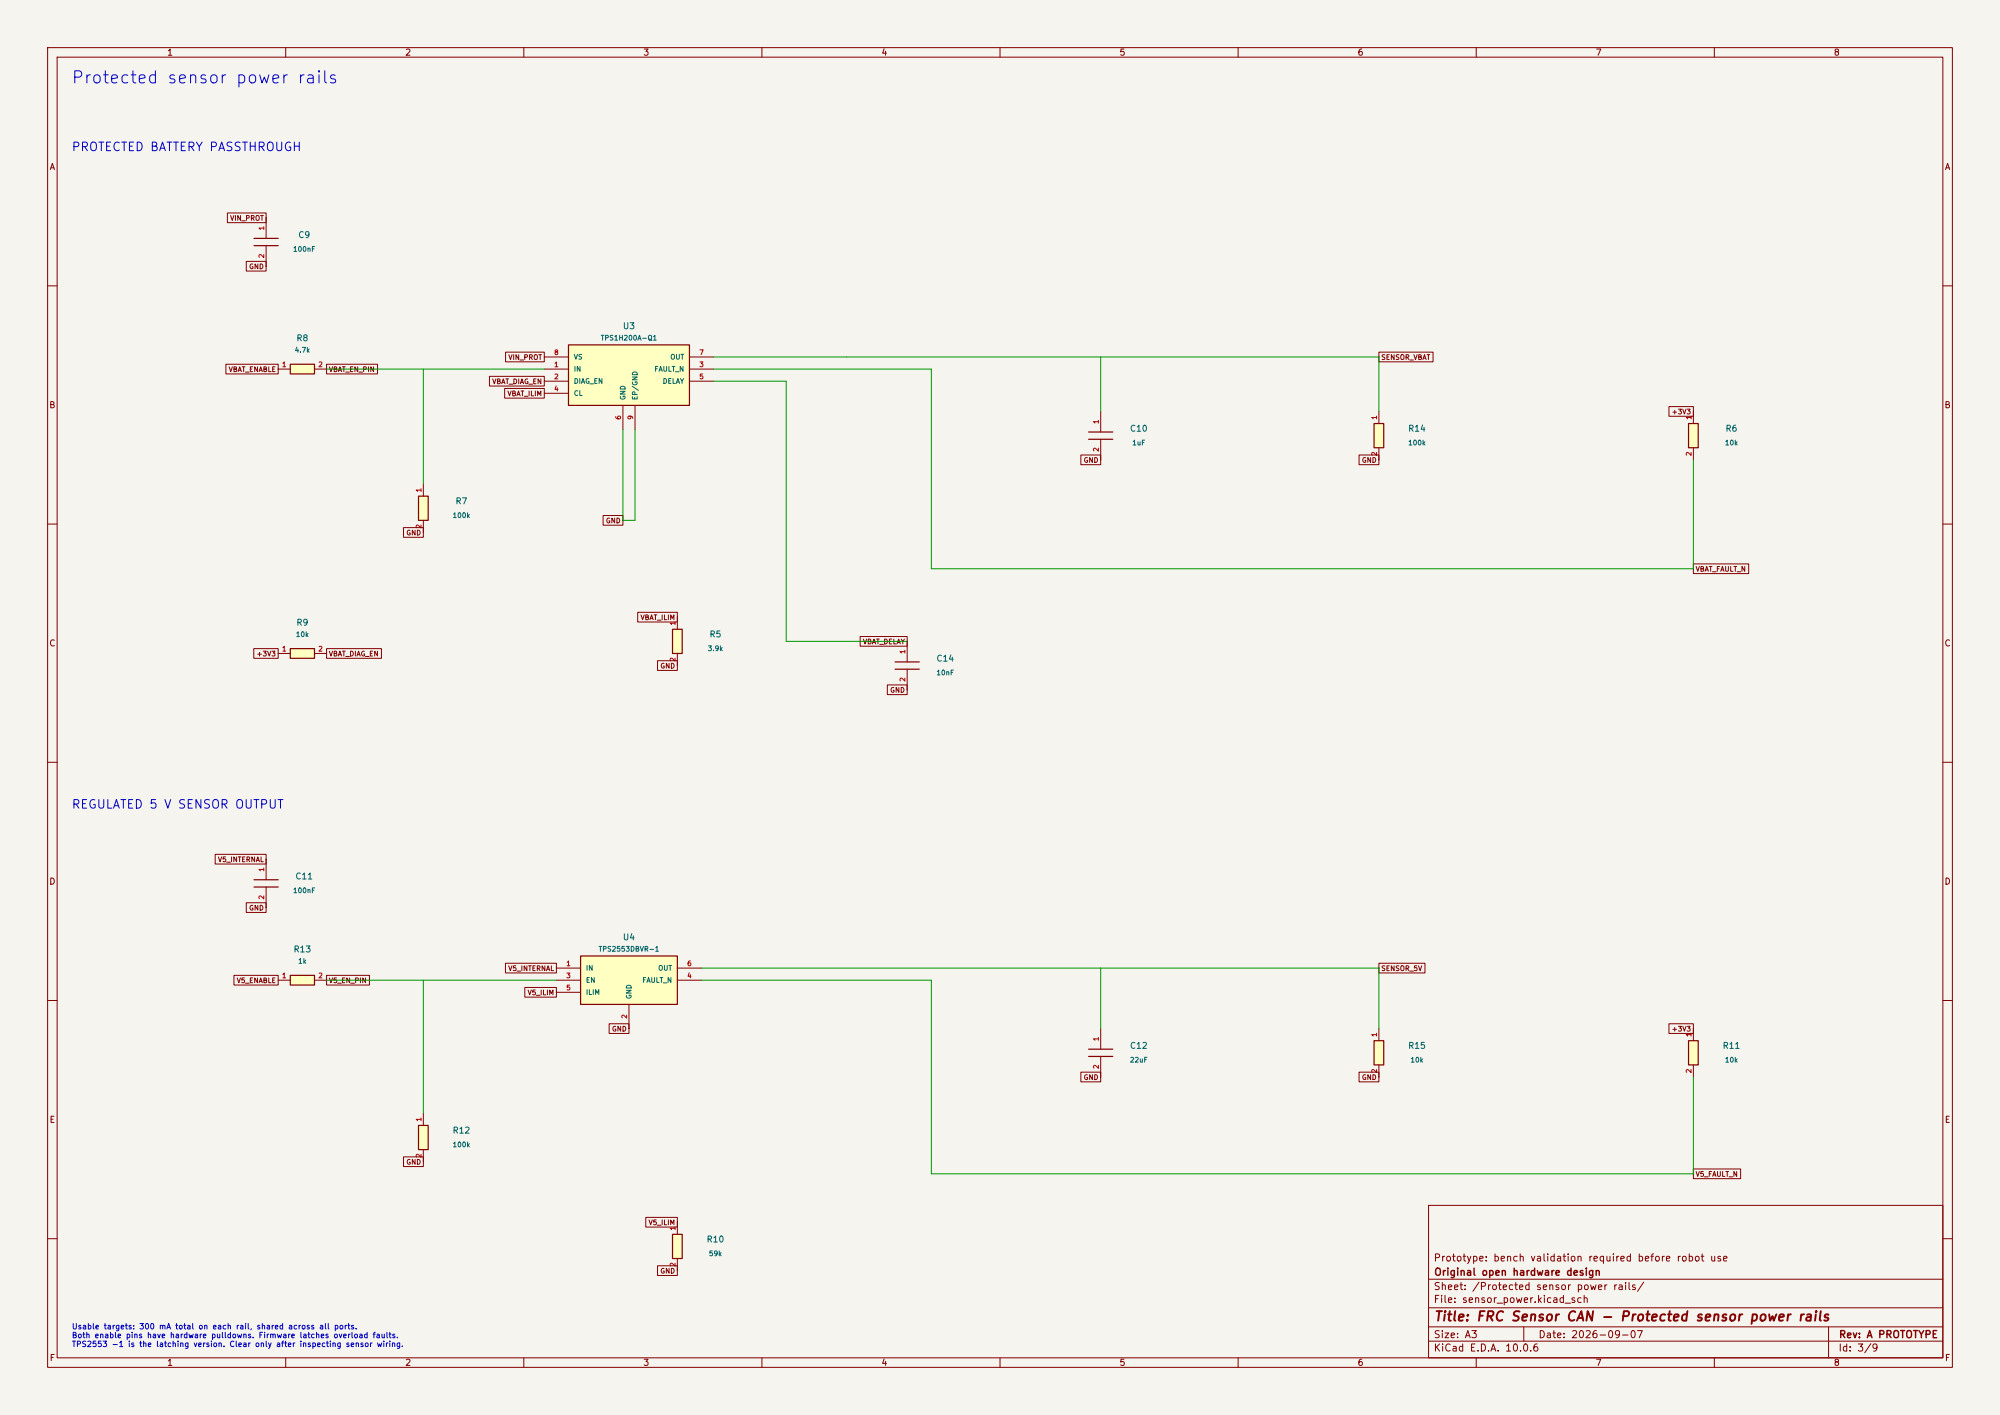
[picture p176: page 3]

V5_INTERNAL +3V3 Protected sensor power rails

Prototype: bench validation required before robot use
Original open hardware design
Sheet: /Protected sensor power rails/
File: sensor_power.kicad_sch
Title: FRC Sensor CAN - Protected sensor power rails

Usable targets: 300 mA total on each rail, shared across all ports. Both enable pins have hardware pulldowns. Firmware latches overload faults. TPS2553 -1 is the latching version. Clear only after inspecting sensor wiring.

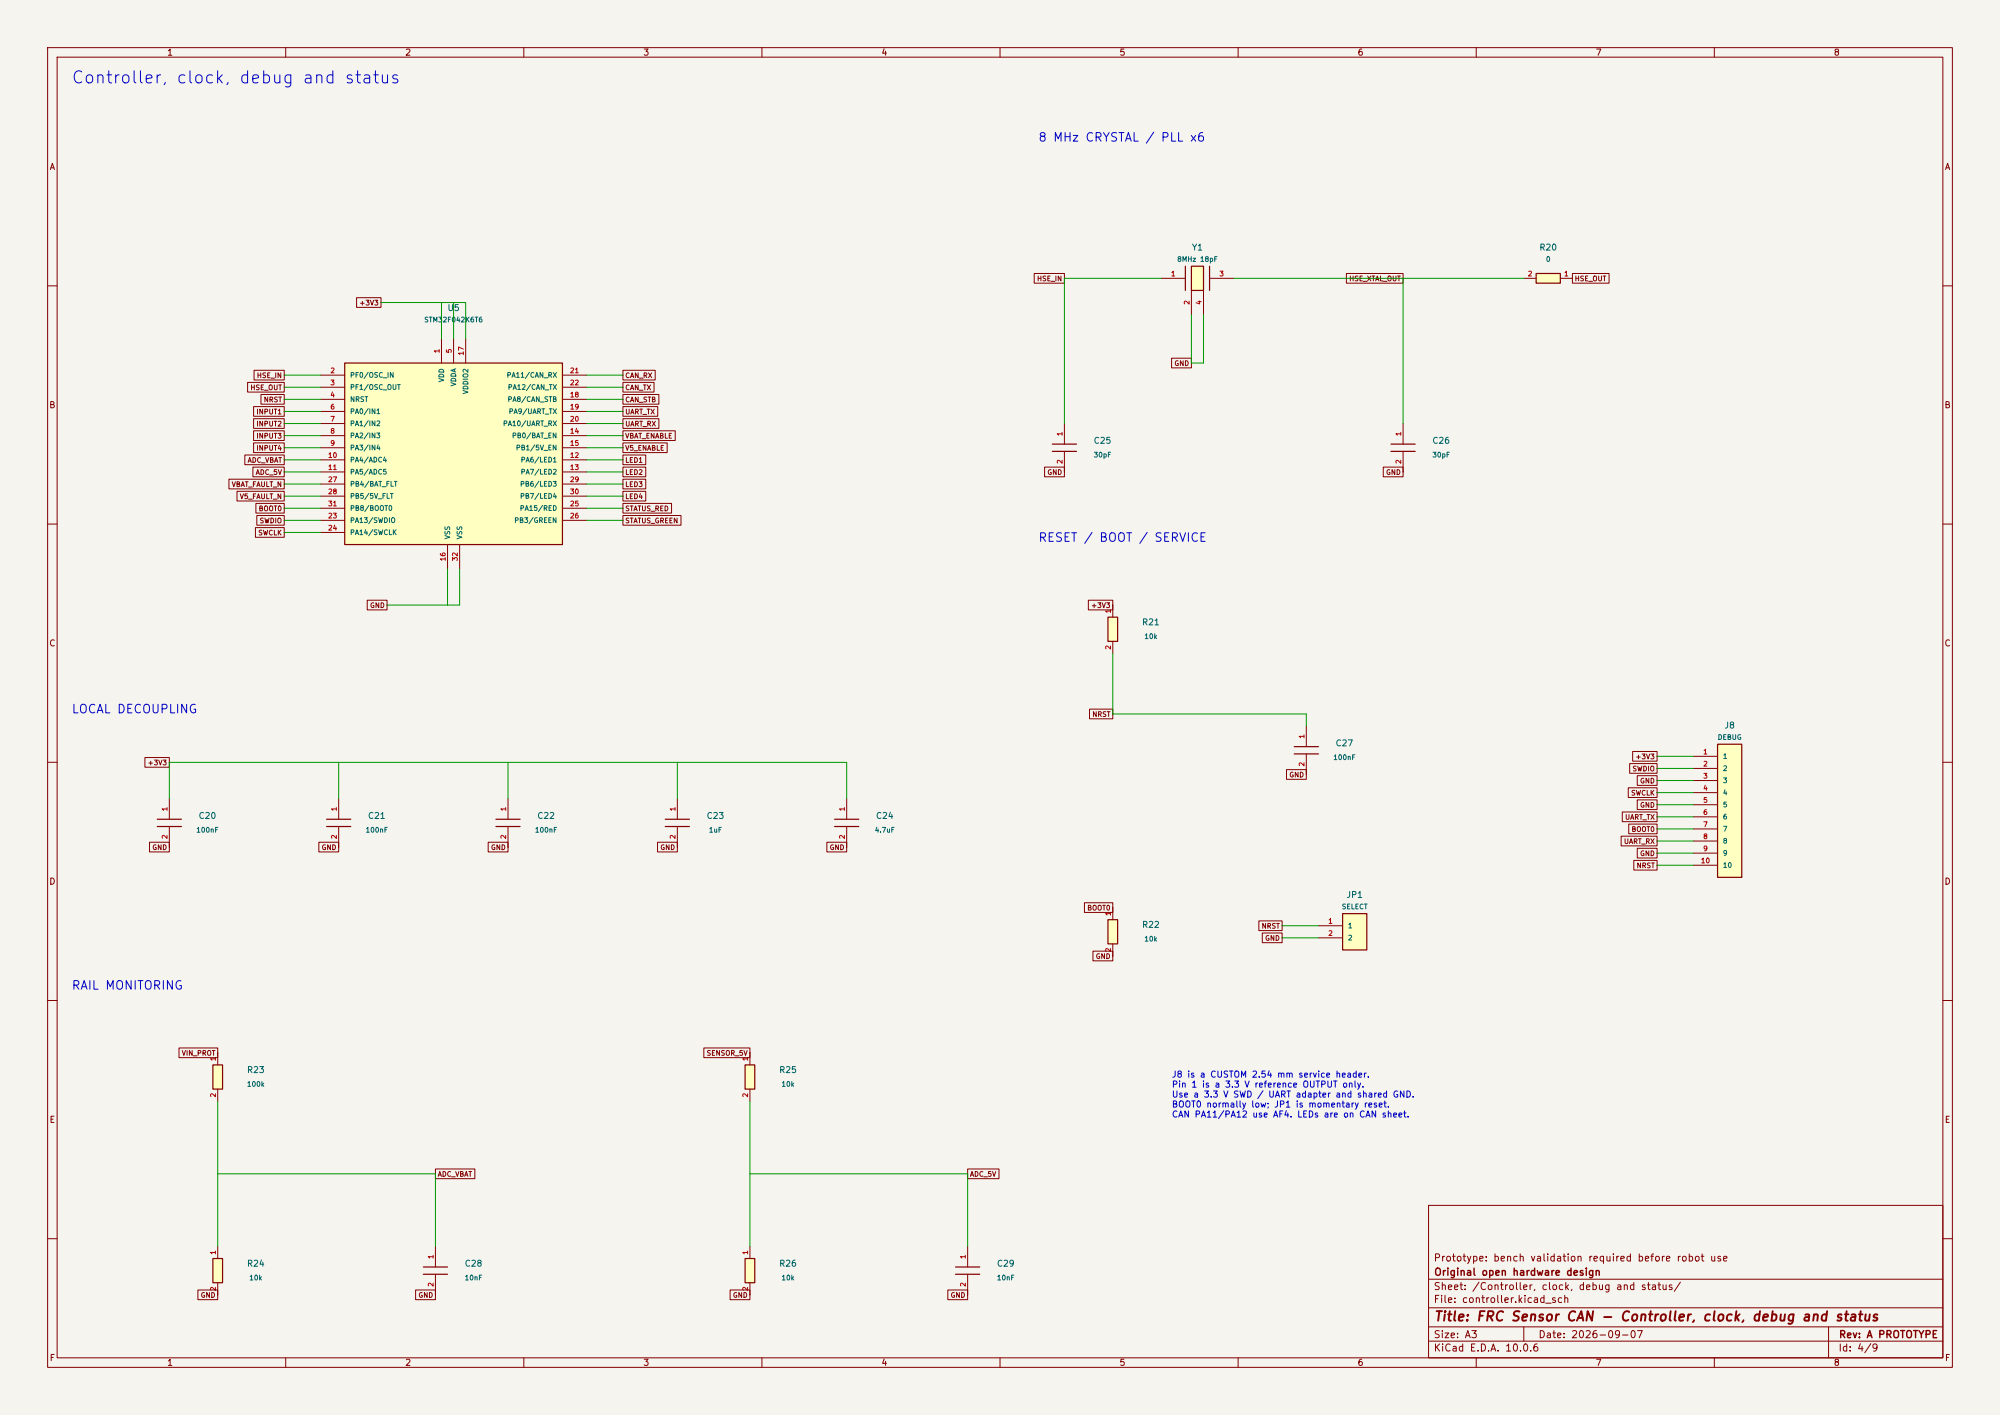
[picture p177: page 4]

Controller, clock, debug and status
HSE_IN
INPUT2 HSE_OUT GND +3V3

1 PF0/OSC_IN 2 PF1/OSC_OUT 3 NRST 4 VDDA 5 PA0/IN1 6 PA1/IN2 7 PA2/IN3 8 PA3/IN4 9 PA4/ADC4 10 PA5/ADC5 11 PA6/LED1 12 PA7/LED2 13 PB0/BAT_EN 14 PB1/5V_EN 15 VSS 16 VDDIO2 17 PA8/CAN_STB 18 PA9/UART_TX 19 PA10/UART_RX 20 PA11/CAN_RX 21 PA12/CAN_TX 22 PA13/SWDIO 23 PA14/SWCLK 24 PA15/RED 25 PB3/GREEN 26 PB4/BAT_FLT 27 PB5/5V_FLT 28 PB6/LED3 29 PB7/LED4 30 PB8/BOOT0 31 VSS 32 U5

J8 is a CUSTOM 2.54 mm service header. Pin 1 is a 3.3 V reference OUTPUT only. Use a 3.3 V SWD / UART adapter and shared GND. BOOT0 normally low; JP1 is momentary reset. CAN PA11/PA12 use AF4. LEDs are on CAN sheet.

Prototype: bench validation required before robot use
Original open hardware design
Sheet: /Controller, clock, debug and status/
File: controller.kicad_sch
Title: FRC Sensor CAN - Controller, clock, debug and status

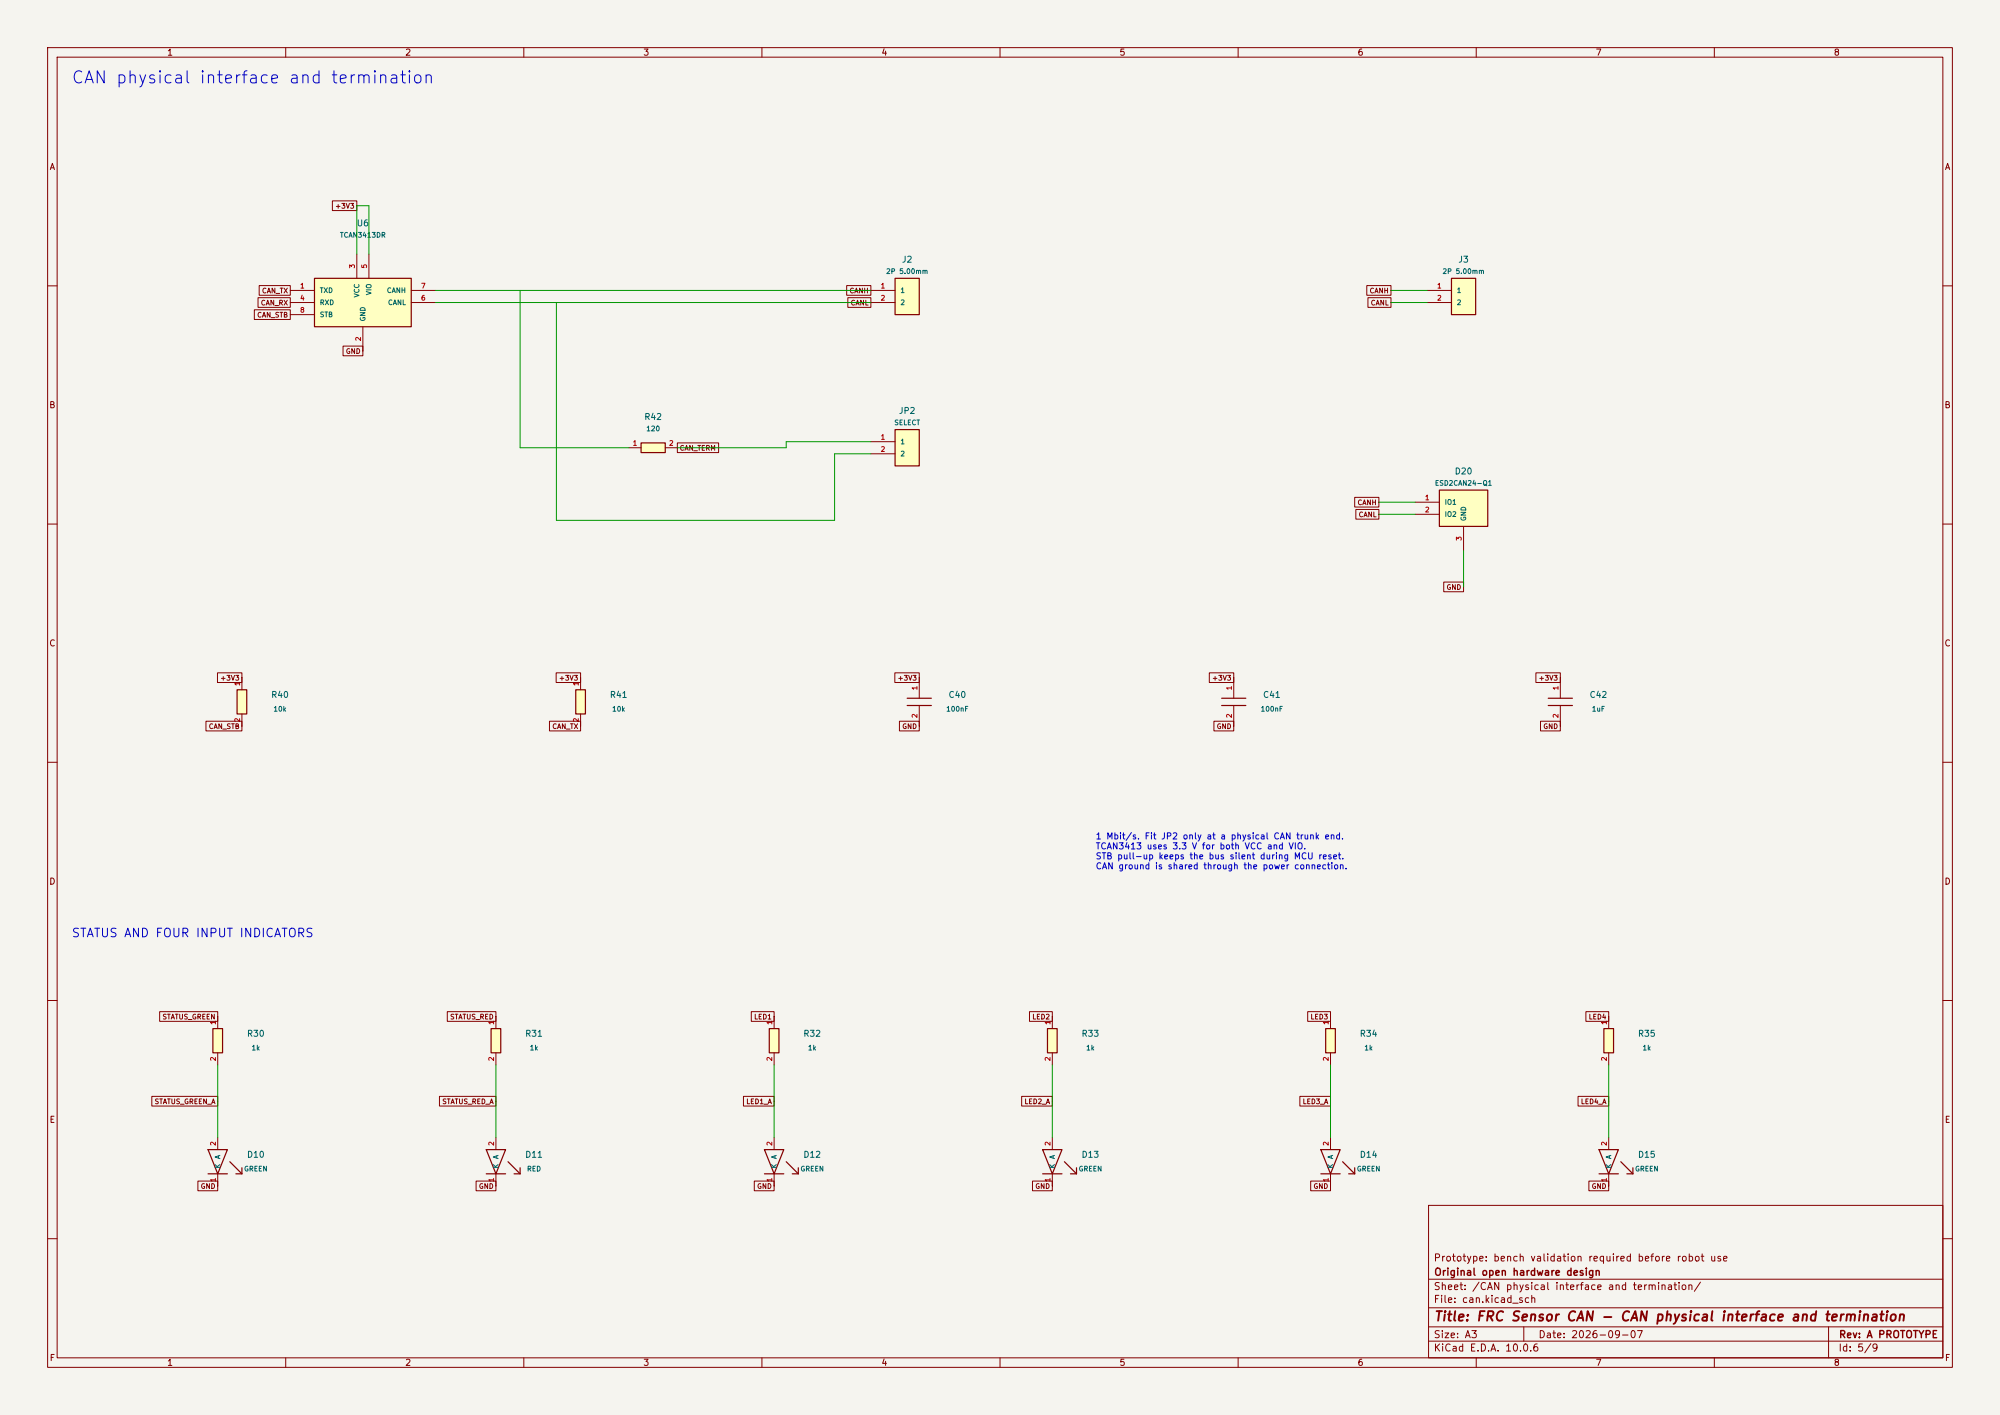
[picture p178: page 5]

1 Mbit/s. Fit JP2 only at a physical CAN trunk end. TCAN3413 uses 3.3 V for both VCC and VIO. STB pull-up keeps the bus silent during MCU reset. CAN ground is shared through the power connection. CAN physical interface and termination

LED2_A STATUS AND FOUR INPUT INDICATORS

Prototype: bench validation required before robot use
Original open hardware design
Sheet: /CAN physical interface and termination/
File: can.kicad_sch
Title: FRC Sensor CAN - CAN physical interface and termination

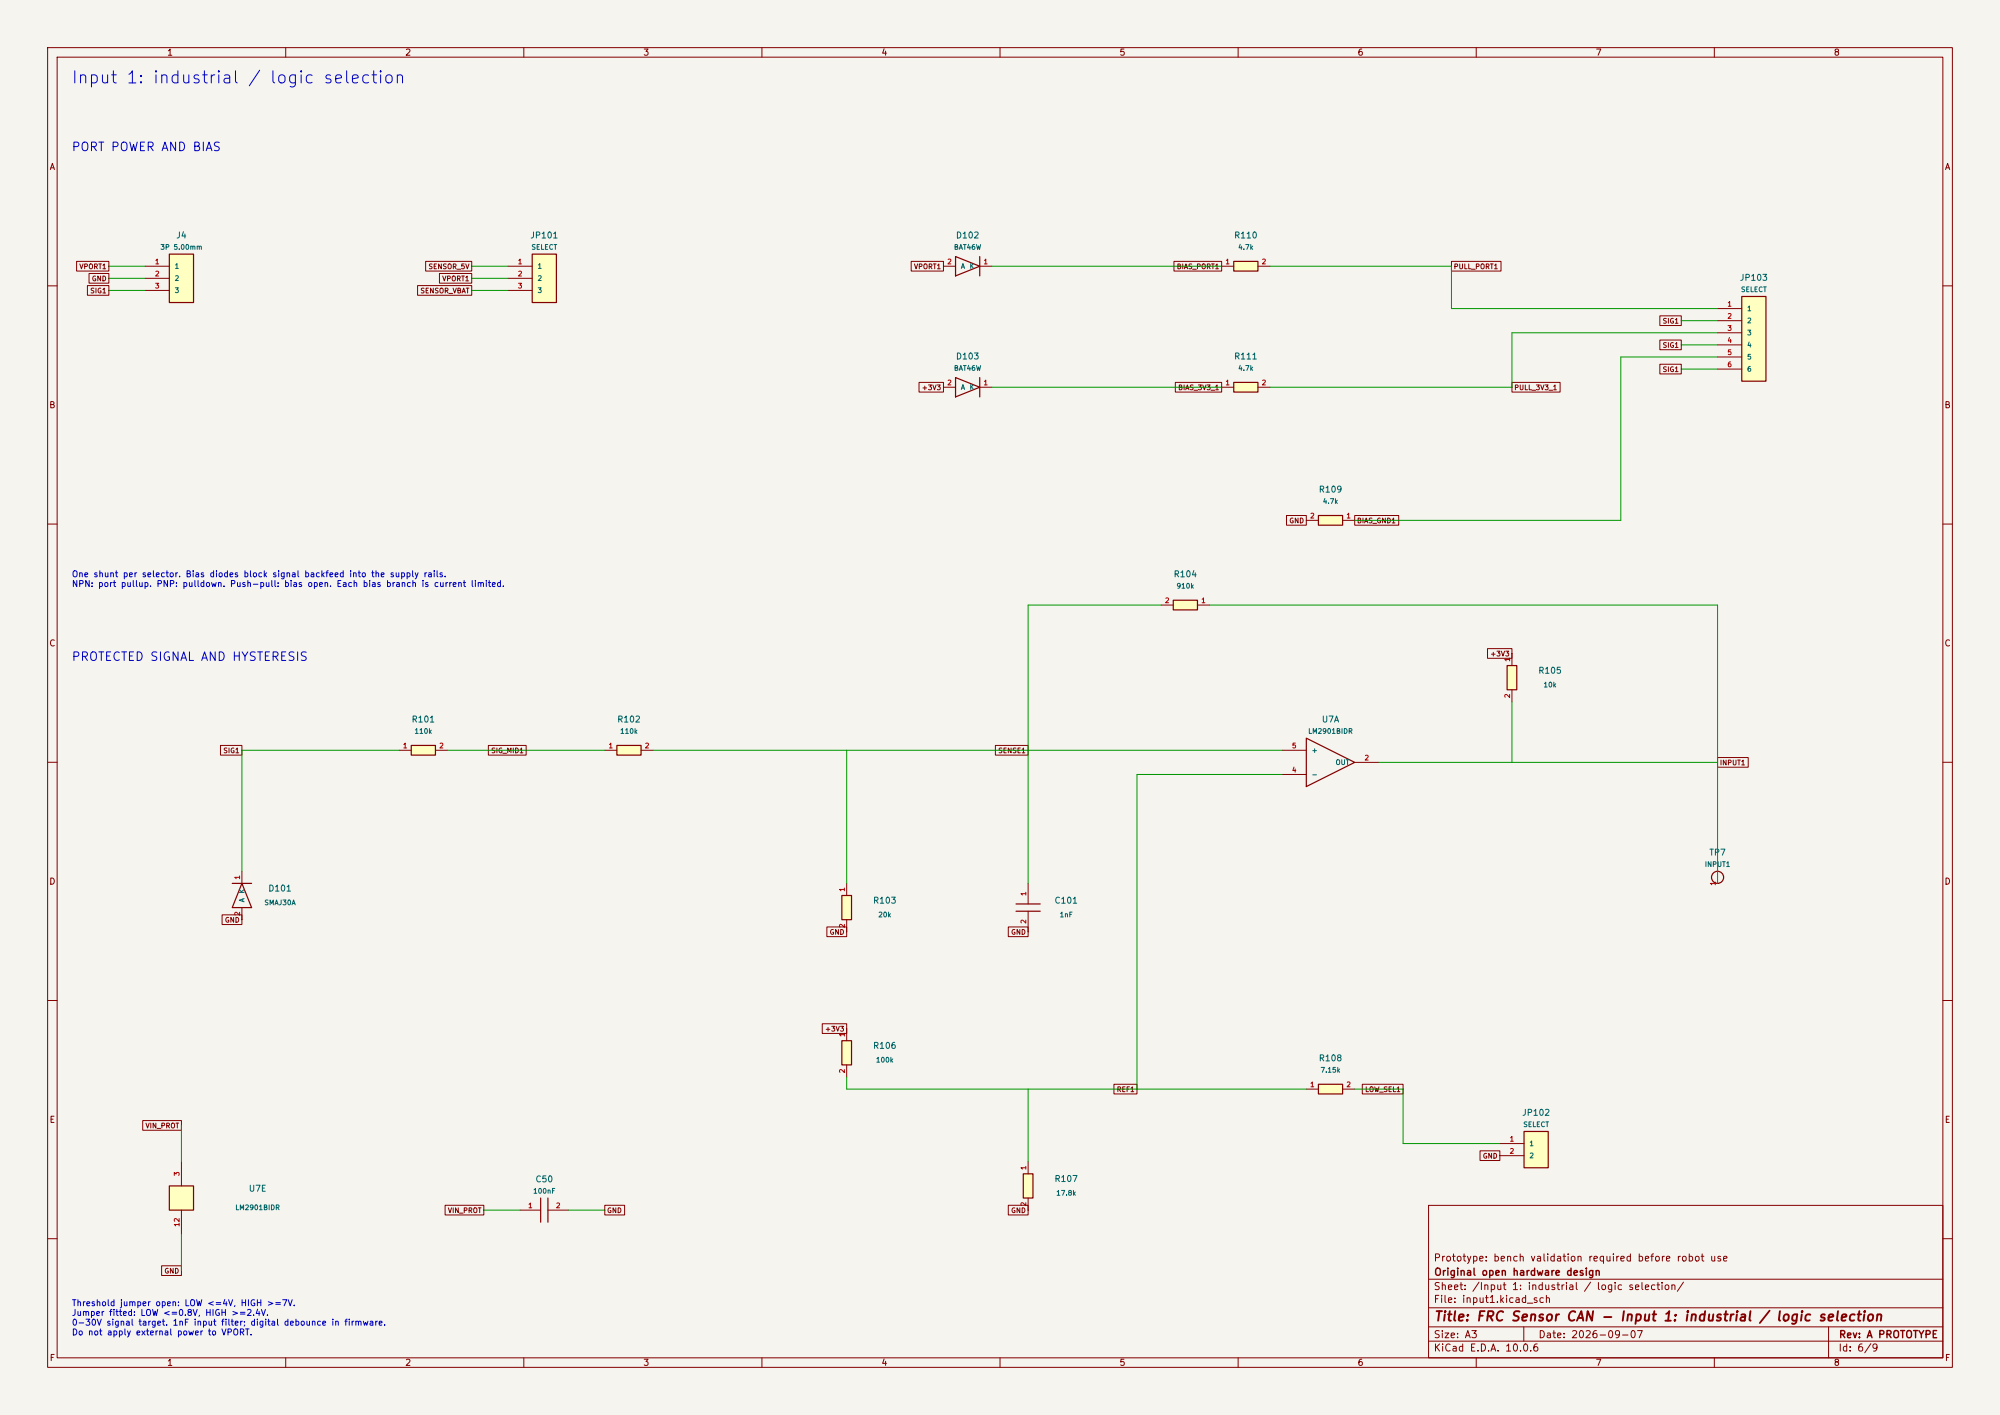
[picture p179: page 6]

Input 1: industrial / logic selection

One shunt per selector. Bias diodes block signal backfeed into the supply rails. NPN: port pullup. PNP: pulldown. Push-pull: bias open. Each bias branch is current limited. PORT POWER AND BIAS

PROTECTED SIGNAL AND HYSTERESIS

VIN_PROT Threshold jumper open: LOW <=4V, HIGH >=7V. Jumper fitted: LOW <=0.8V, HIGH >=2.4V. 0-30V signal target. 1nF input filter; digital debounce in firmware. Do not apply external power to VPORT.

Prototype: bench validation required before robot use
Original open hardware design
Sheet: /Input 1: industrial / logic selection/
File: input1.kicad_sch
Title: FRC Sensor CAN - Input 1: industrial / logic selection

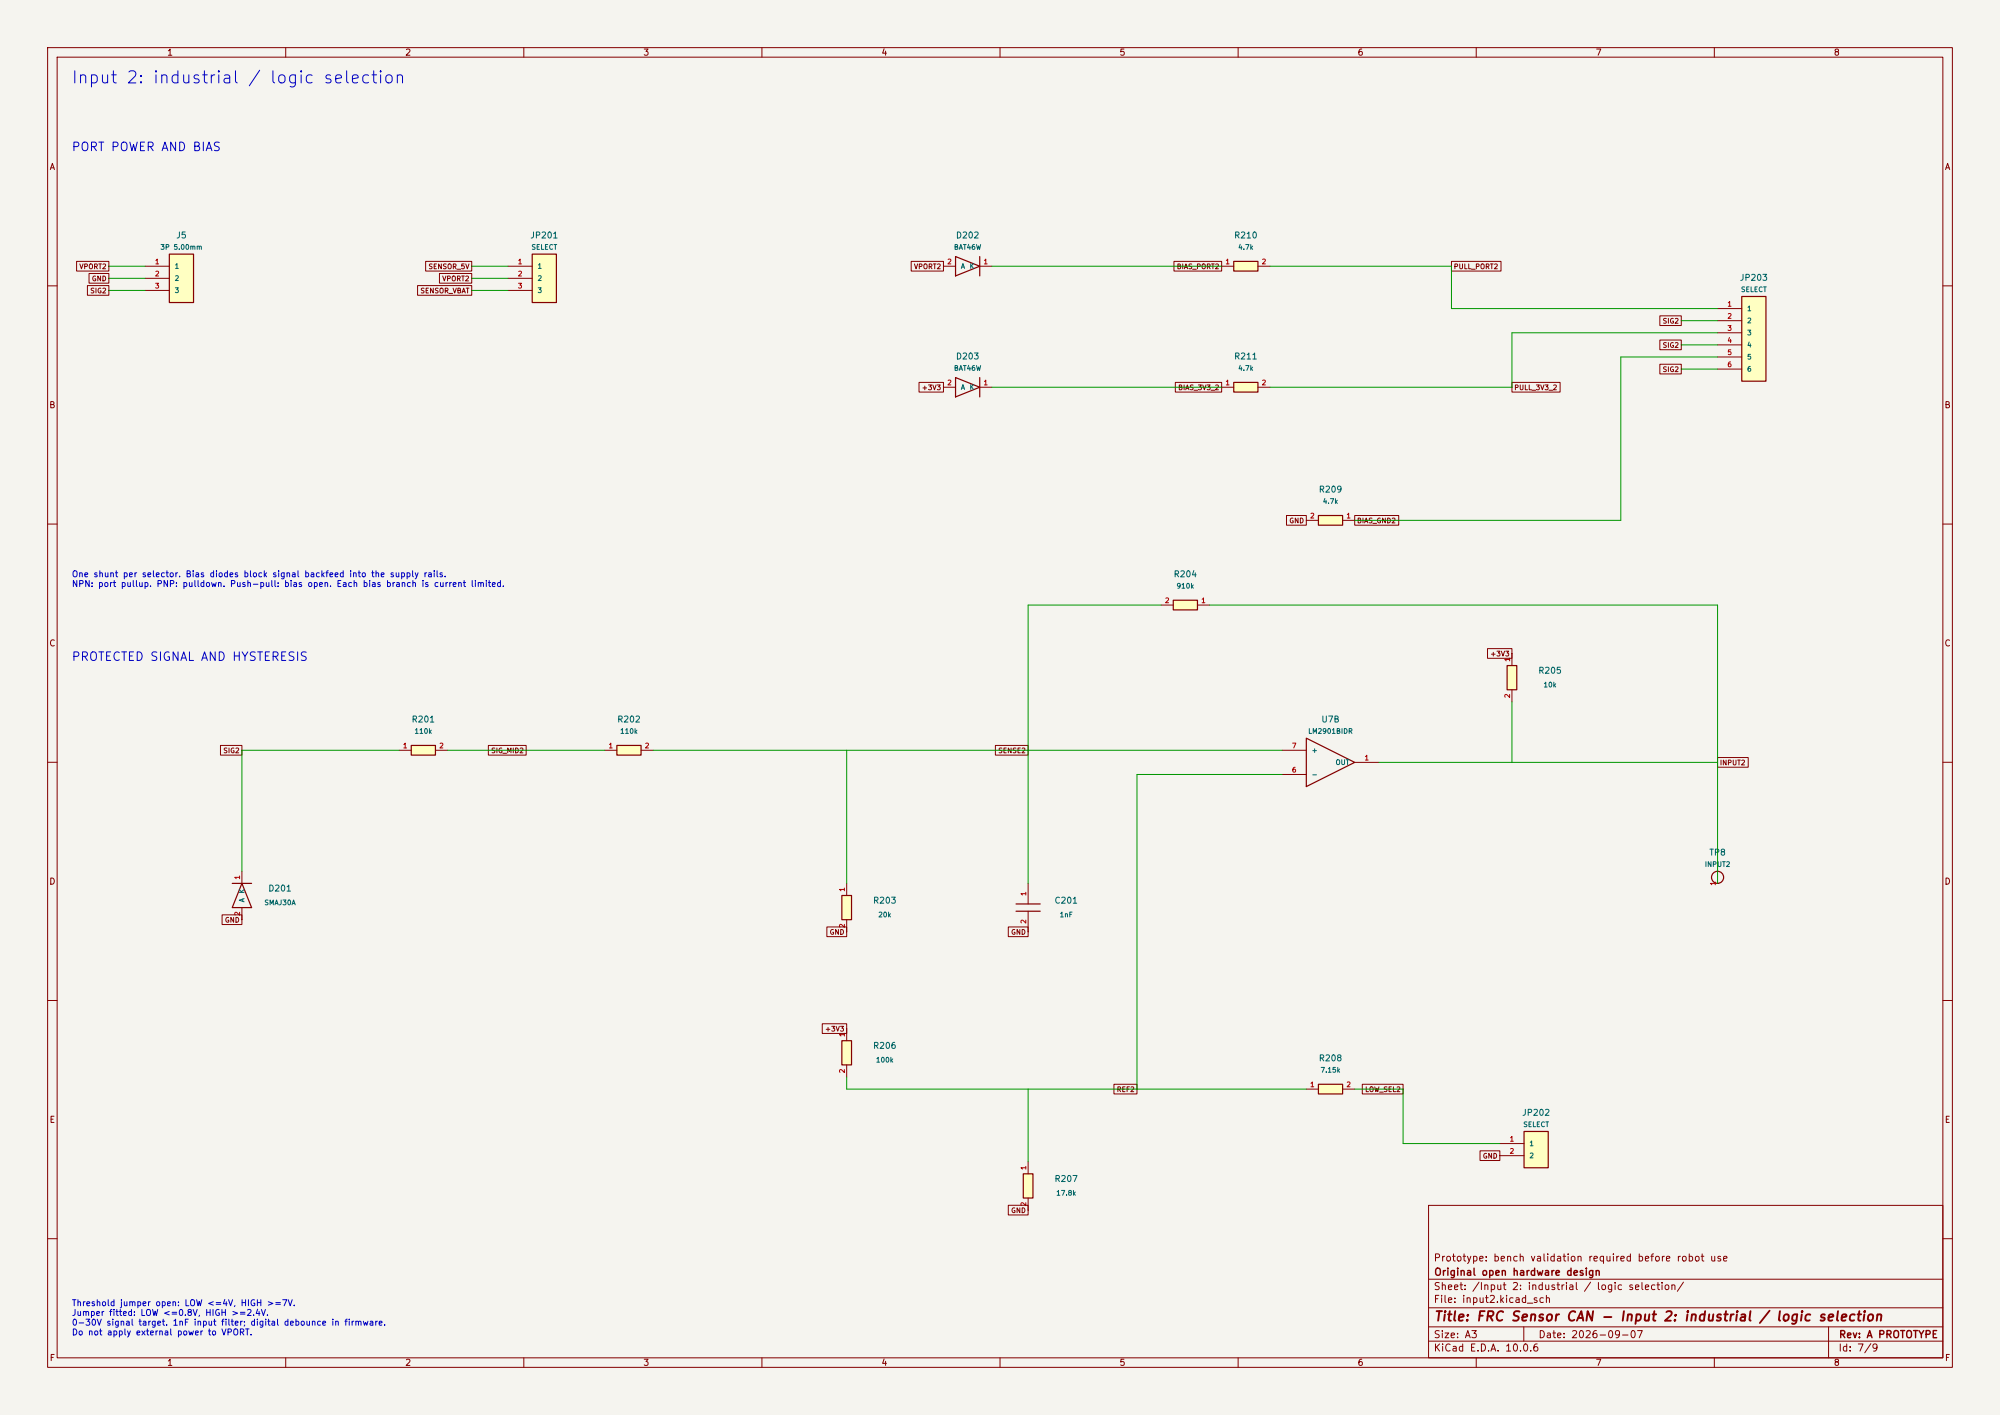
[picture p180: page 7]

Input 2: industrial / logic selection

One shunt per selector. Bias diodes block signal backfeed into the supply rails. NPN: port pullup. PNP: pulldown. Push-pull: bias open. Each bias branch is current limited. PROTECTED SIGNAL AND HYSTERESIS

Prototype: bench validation required before robot use
Original open hardware design
Sheet: /Input 2: industrial / logic selection/
File: input2.kicad_sch
Title: FRC Sensor CAN - Input 2: industrial / logic selection

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

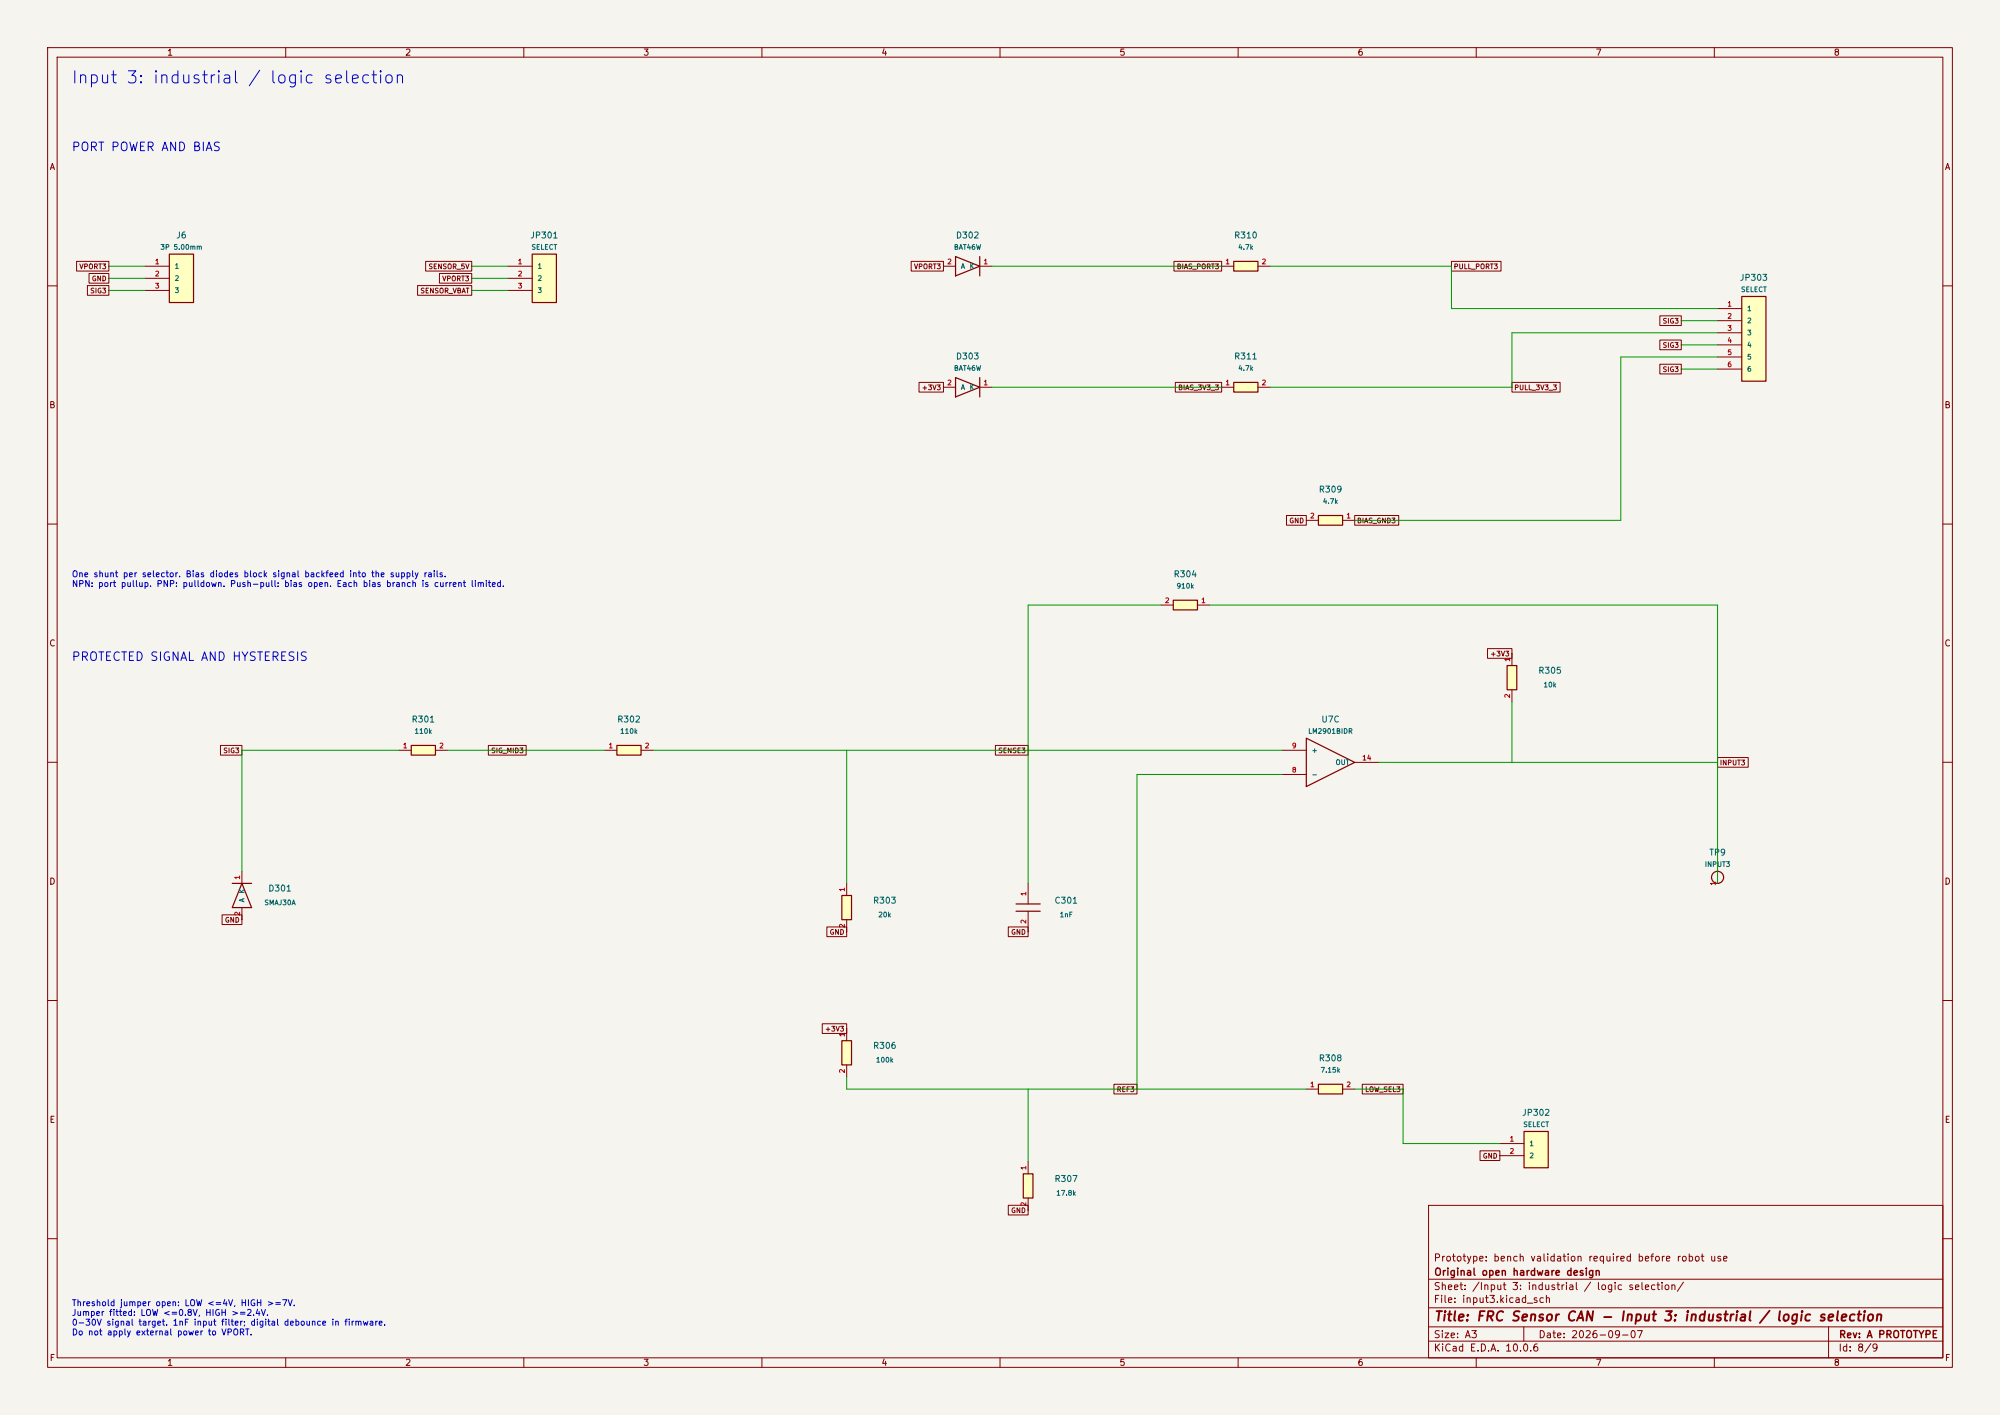
[picture p181: page 8]

Input 3: industrial / logic selection

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

Prototype: bench validation required before robot use
Original open hardware design
Sheet: /Input 3: industrial / logic selection/
File: input3.kicad_sch
Title: FRC Sensor CAN - Input 3: industrial / logic selection

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

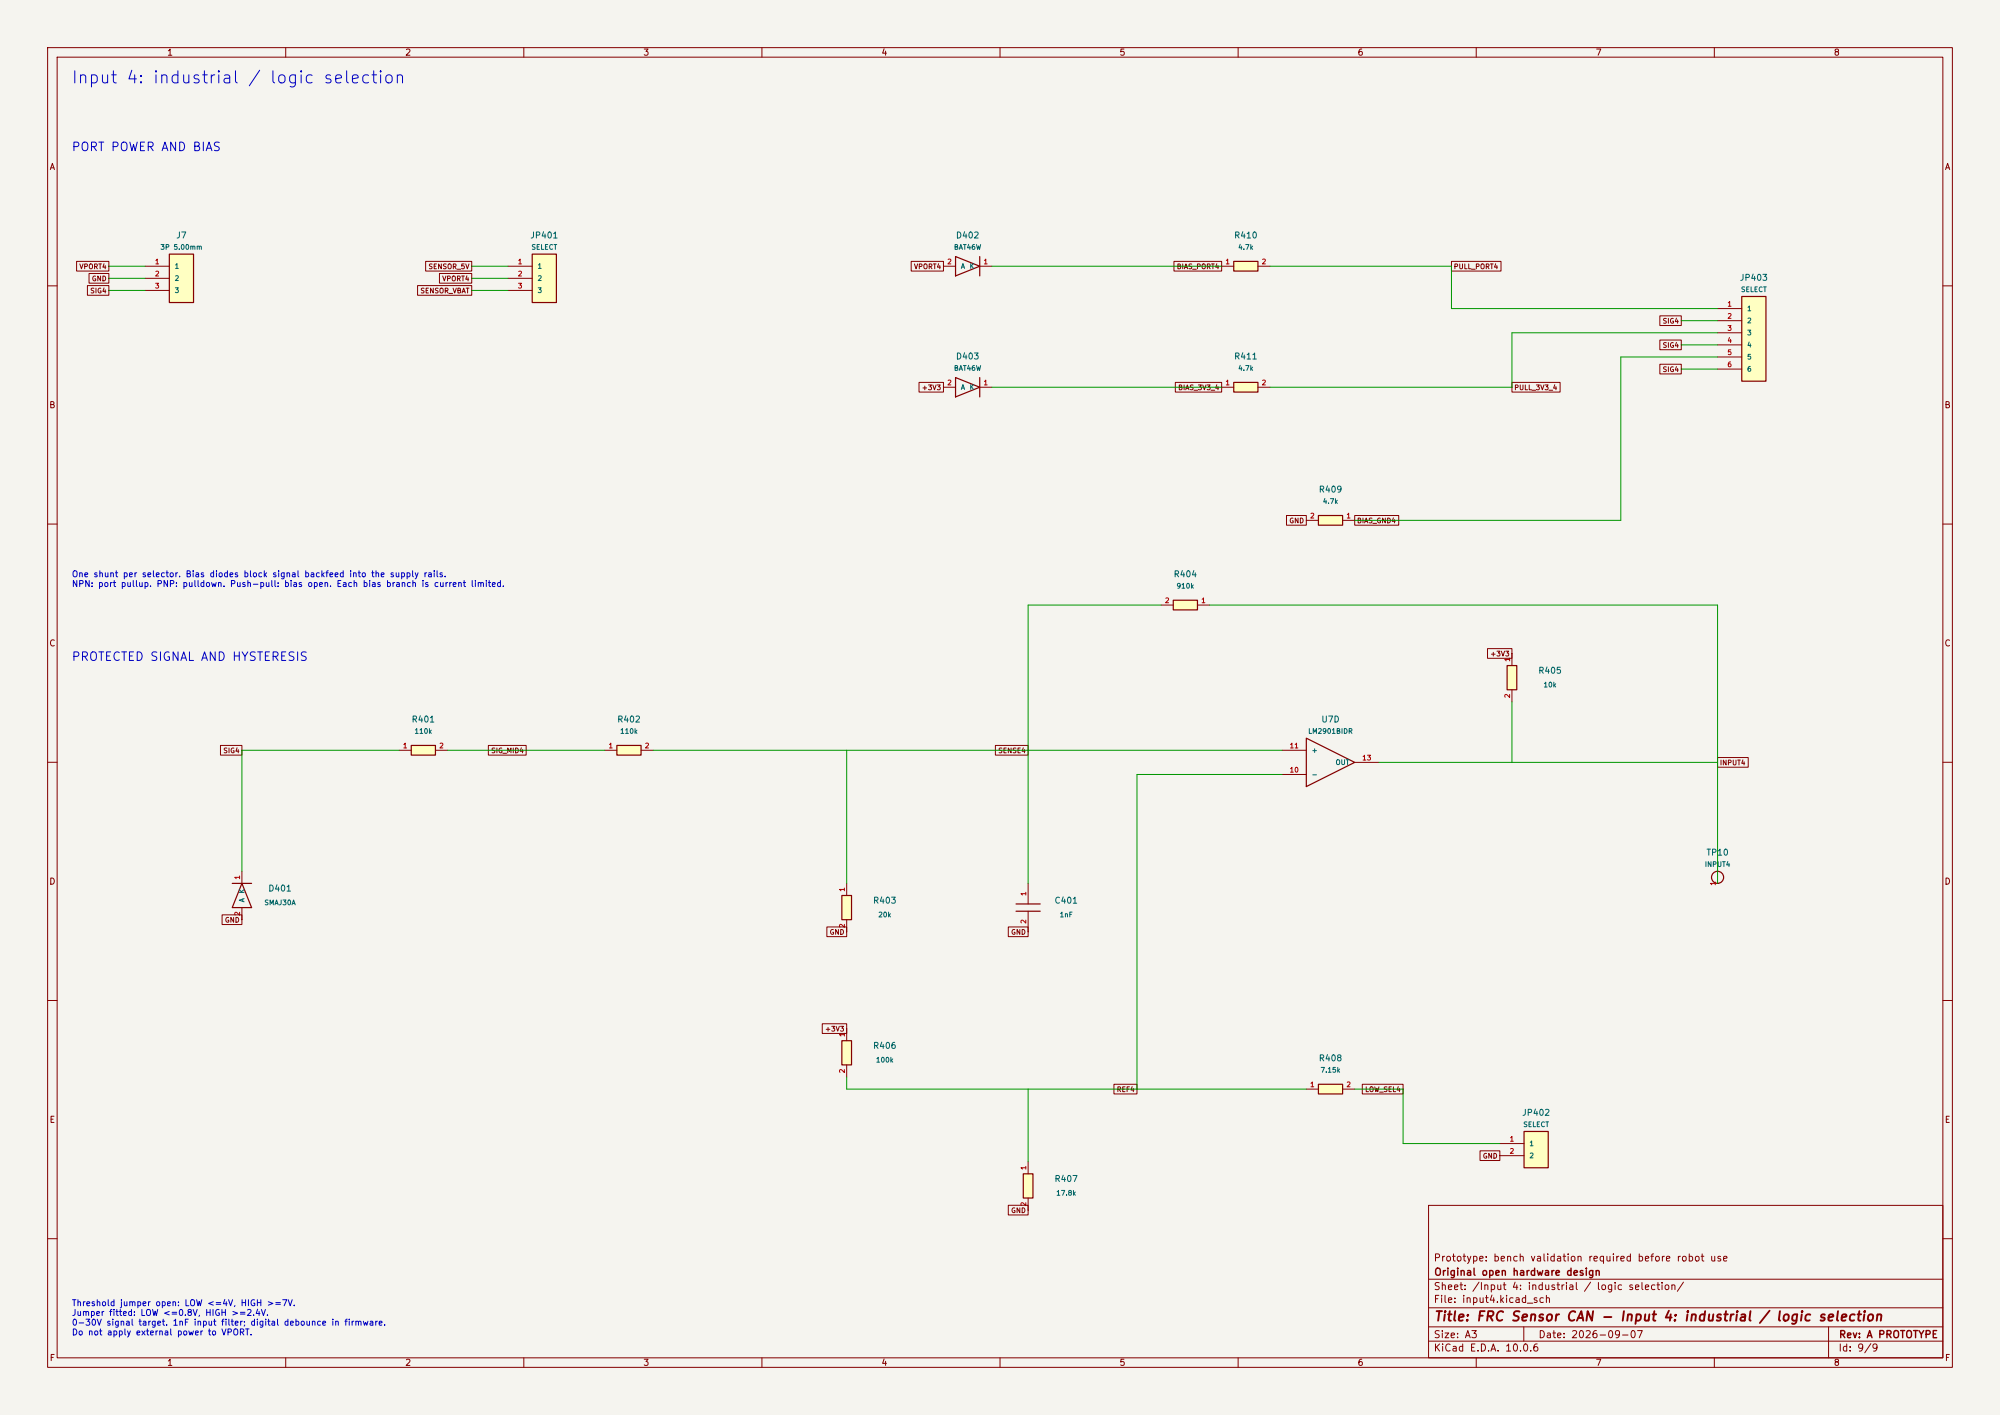
[picture p182: page 9]

Input 4: industrial / logic selection

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

Prototype: bench validation required before robot use
Original open hardware design
Sheet: /Input 4: industrial / logic selection/
File: input4.kicad_sch
Title: FRC Sensor CAN - Input 4: industrial / logic selection

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
