barkinvar/sugerCANe/current/output/assembly/gerber_copper_review.pdf

## FRC Sensor CAN · Rev H SC12 · TOP copper

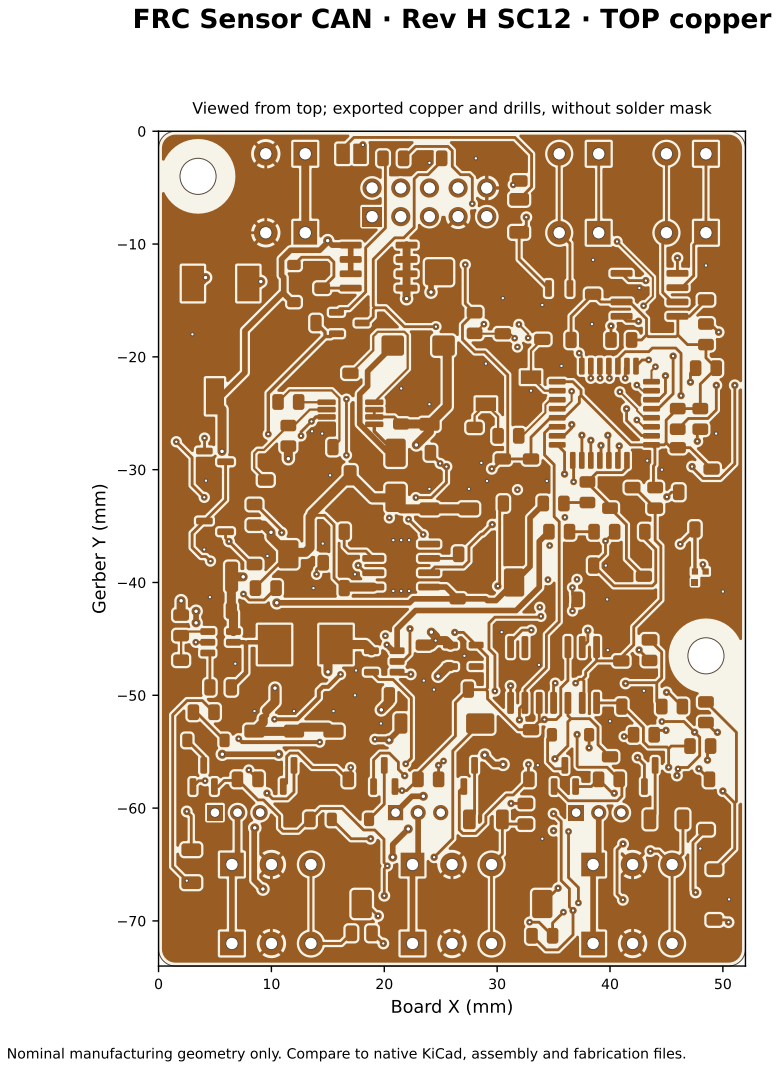
[picture p183: page 1]
Board X (mm); Gerber Y (mm)

Viewed from top; exported copper and drills, without solder mask

Nominal manufacturing geometry only. Compare to native KiCad, assembly and fabrication files.

## FRC Sensor CAN · Rev H SC12 · INNER 1 copper

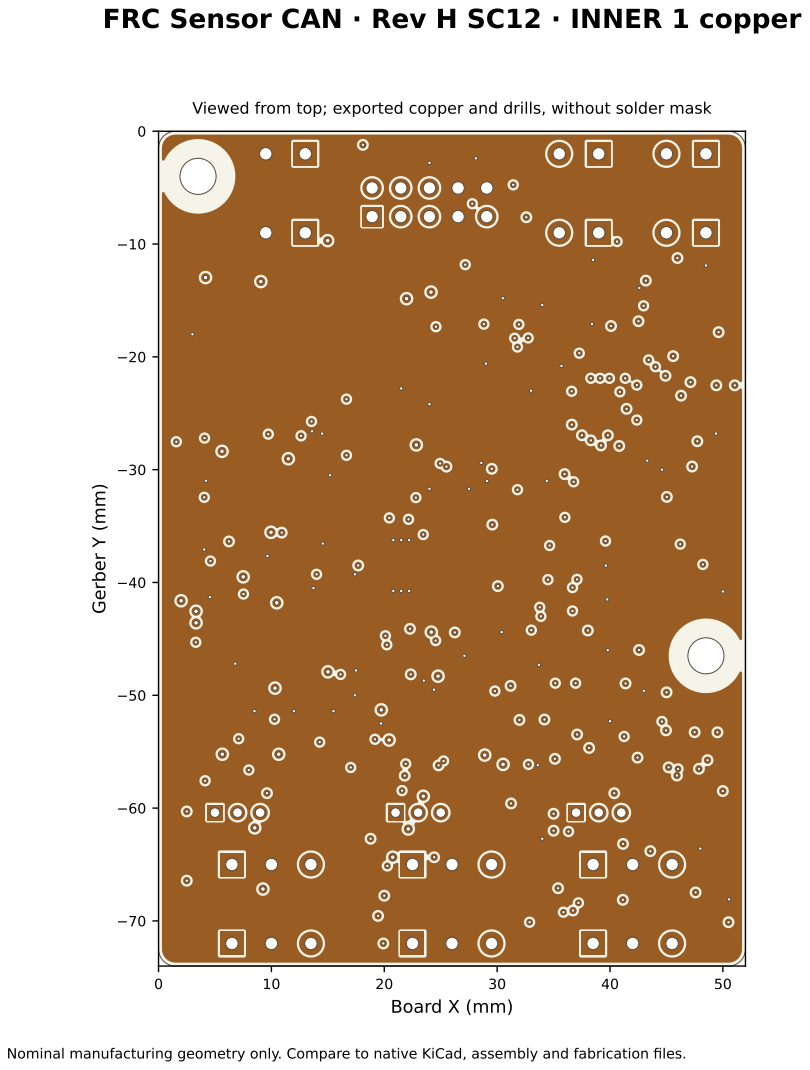
[picture p184: page 2]
Gerber Y (mm)

Viewed from top; exported copper and drills, without solder mask

## FRC Sensor CAN · Rev H SC12 · INNER 2 copper

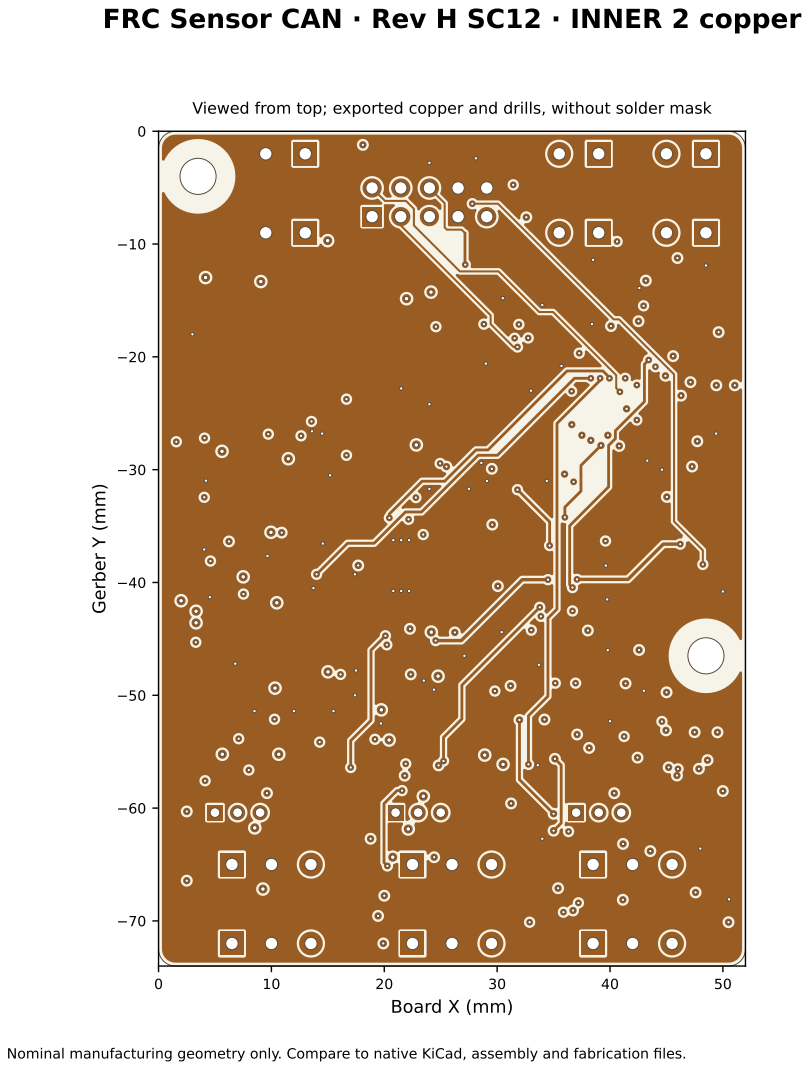
[picture p185: page 3]
Gerber Y (mm)

Viewed from top; exported copper and drills, without solder mask

## FRC Sensor CAN · Rev H SC12 · BOTTOM copper

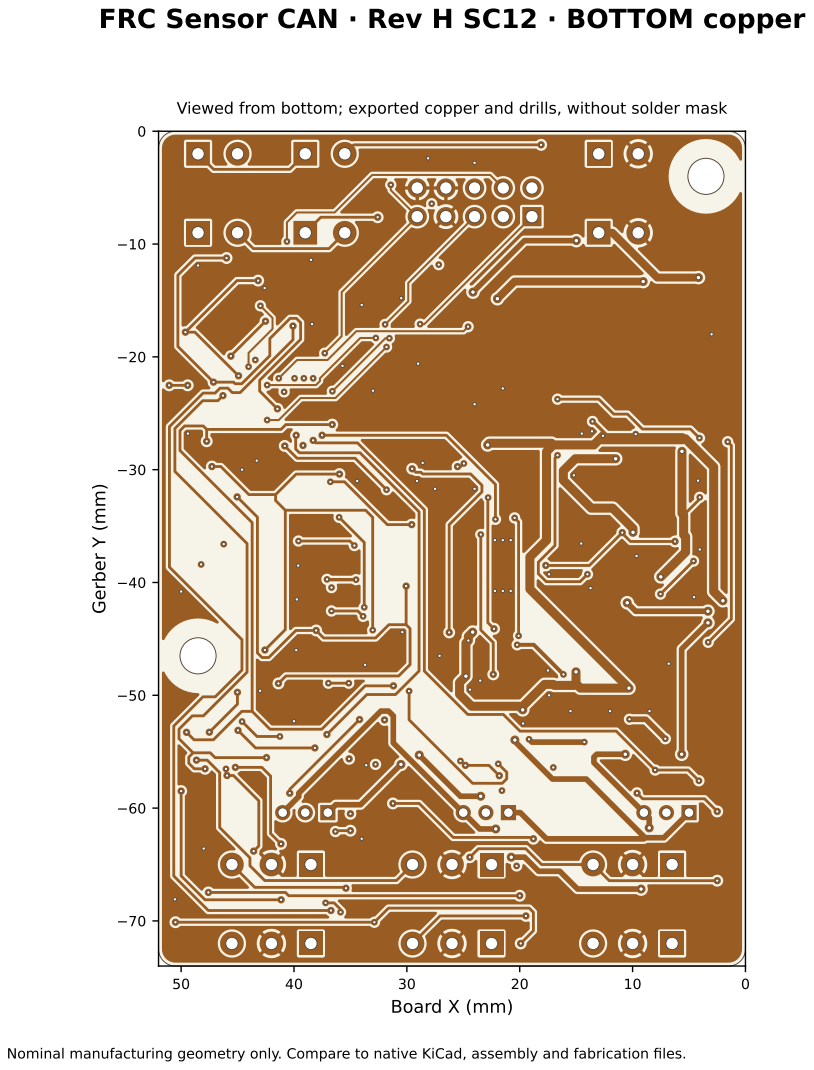
[picture p186: page 4]
Gerber Y (mm)

Viewed from bottom; exported copper and drills, without solder mask
