barkinvar/sugerCANe/current/output/assembly/schematic.pdf

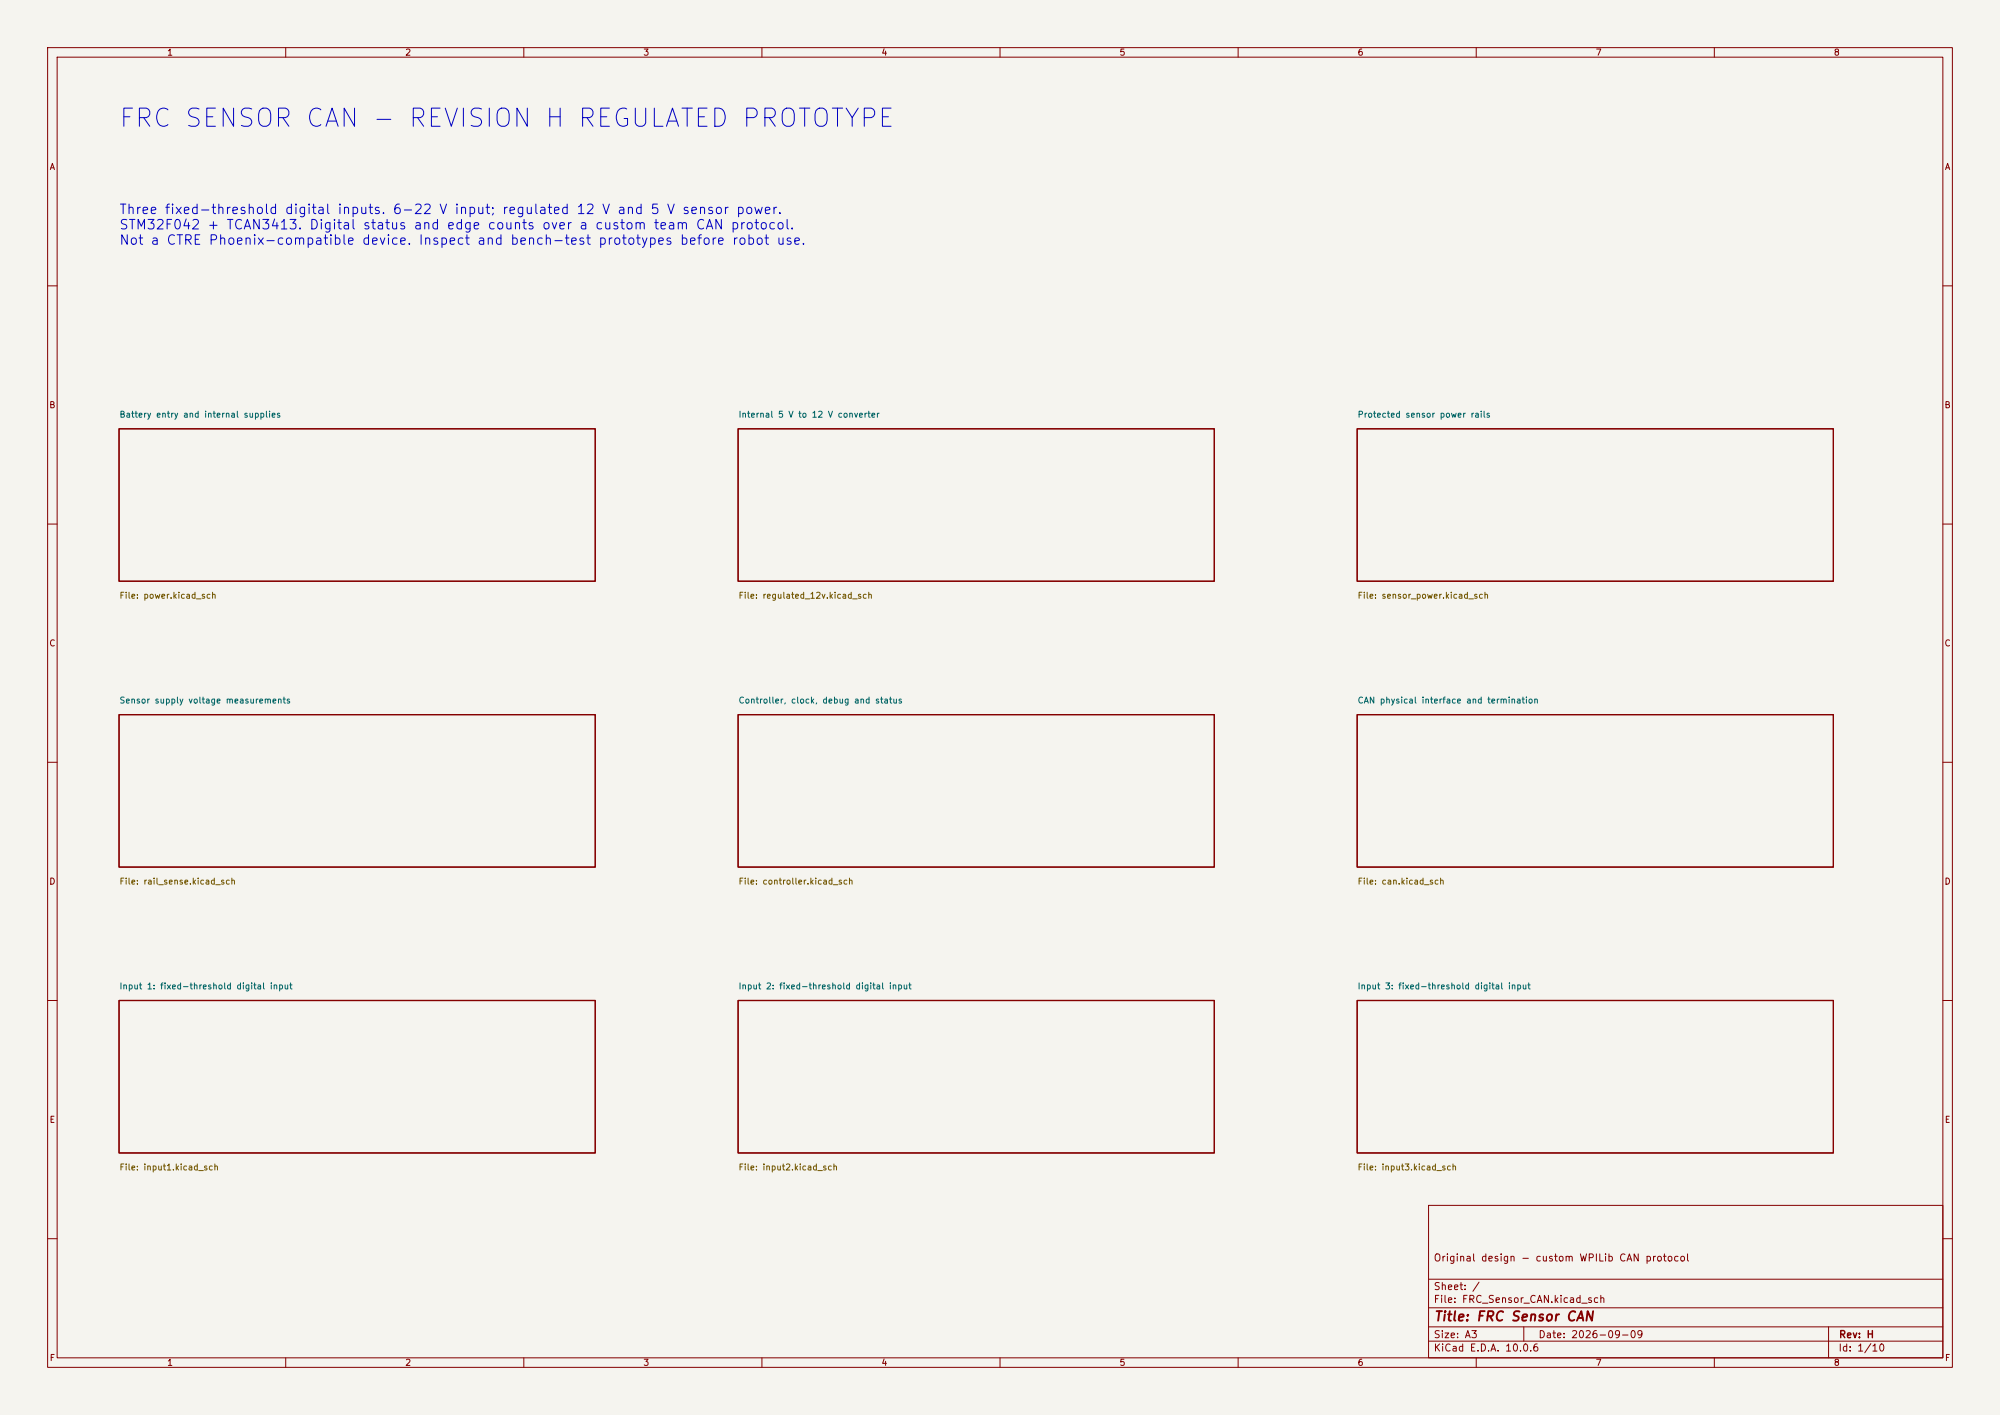
[picture p187: page 1]

FRC SENSOR CAN - REVISION H REGULATED PROTOTYPE
Battery entry and internal supplies File: power.kicad_sch Sensor supply voltage measurements File: rail_sense.kicad_sch

Three fixed-threshold digital inputs. 6-22 V input; regulated 12 V and 5 V sensor power.
STM32F042 + TCAN3413. Digital status and edge counts over a custom team CAN protocol.
Not a CTRE Phoenix-compatible device. Inspect and bench-test prototypes before robot use.

Input 1: fixed-threshold digital input File: input1.kicad_sch

Input 2: fixed-threshold digital input File: input2.kicad_sch

Input 3: fixed-threshold digital input File: input3.kicad_sch

Original design - custom WPILib CAN protocol

Sheet: /
File: FRC_Sensor_CAN.kicad_sch
Title: FRC Sensor CAN

Size: A3 | Rev: H | F Date: 2026-09-09
KiCad E.D.A. 10.0.6 | Id: 1/10

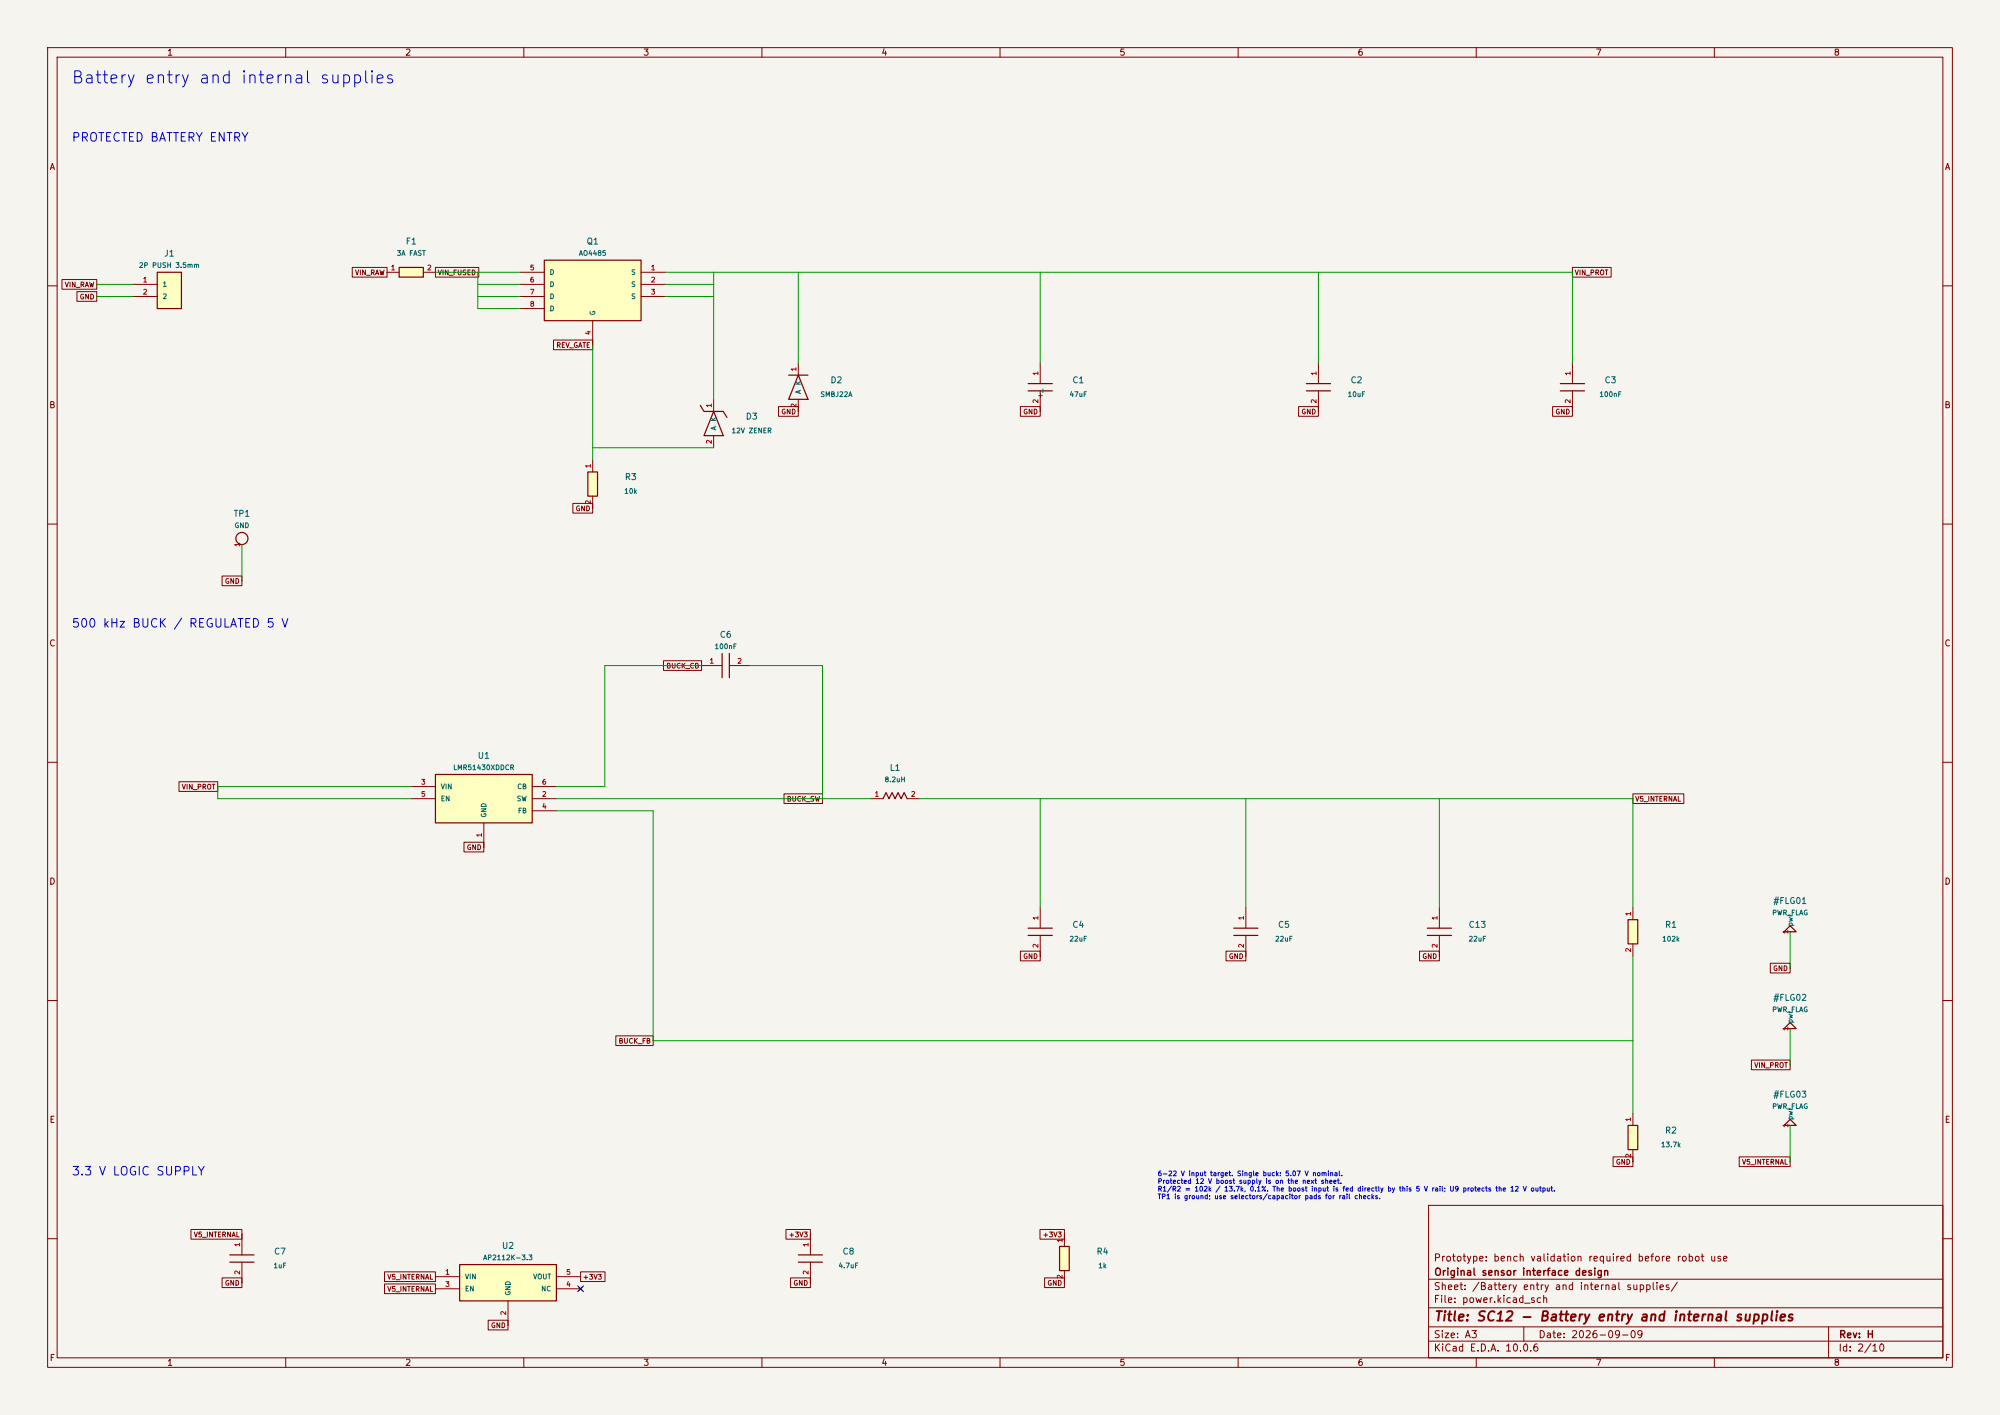
[picture p188: page 2]

Battery entry and internal supplies

6-22 V input target. Single buck: 5.07 V nominal. Protected 12 V boost supply is on the next sheet. R1/R2 = 102k / 13.7k, 0.1%. The boost input is fed directly by this 5 V rail; U9 protects the 12 V output. TP1 is ground; use selectors/capacitor pads for rail checks.

Original sensor interface design
Sheet: /Battery entry and internal supplies/
File: power.kicad_sch
Title: SC12 - Battery entry and internal supplies

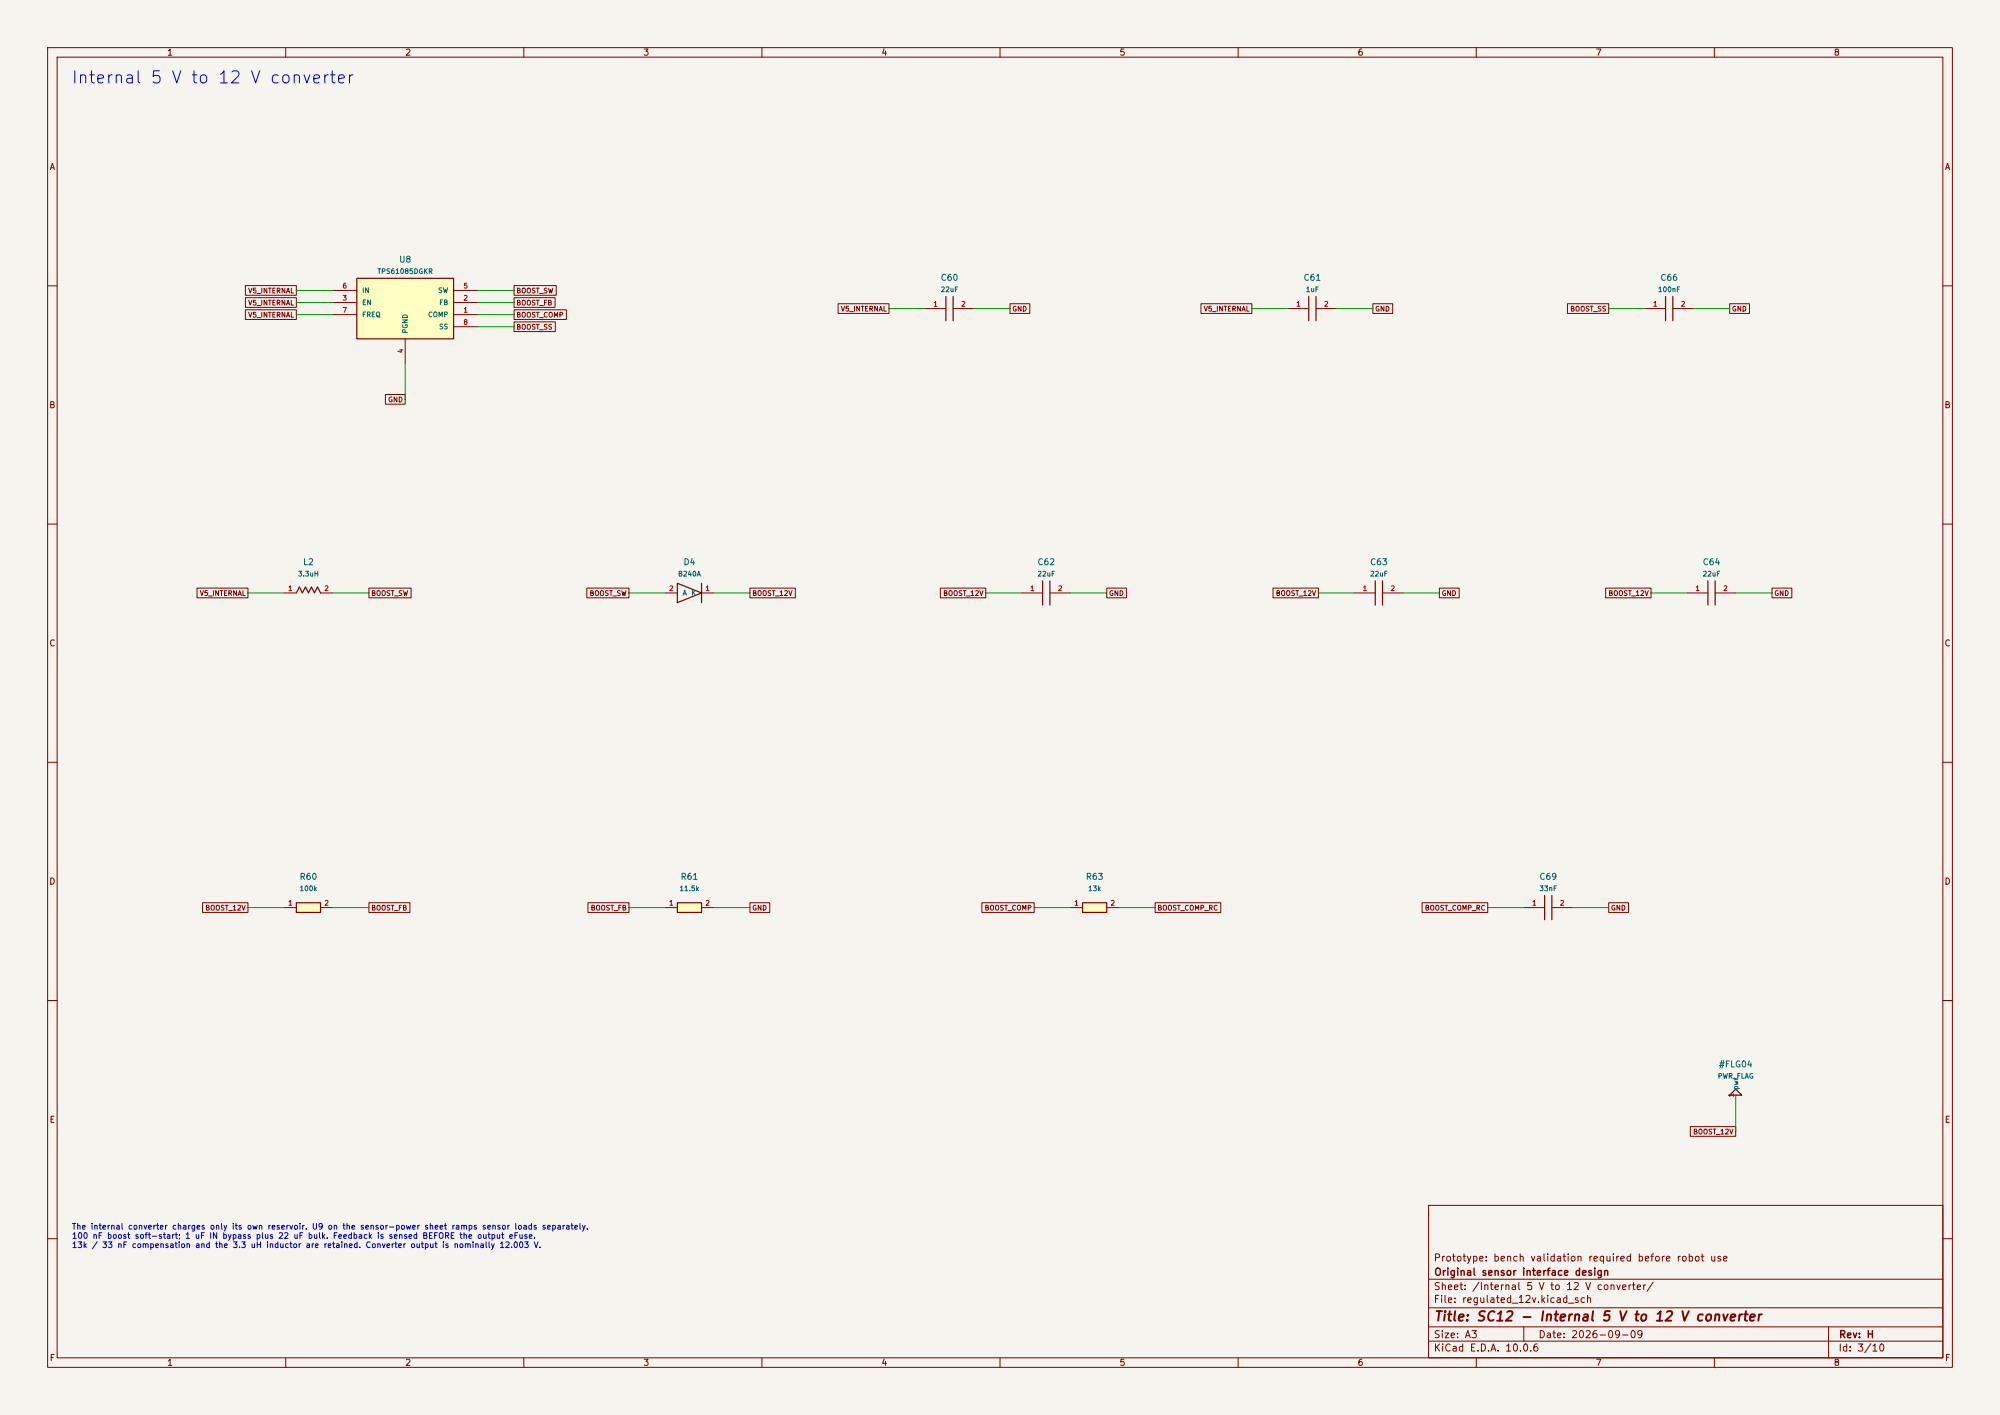
[picture p189: page 3]

The internal converter charges only its own reservoir. U9 on the sensor-power sheet ramps sensor loads separately. 100 nF boost soft-start; 1 uF IN bypass plus 22 uF bulk. Feedback is sensed BEFORE the output eFuse. 13k / 33 nF compensation and the 3.3 uH inductor are retained. Converter output is nominally 12.003 V.

Prototype: bench validation required before robot use
Original sensor interface design
Sheet: /Internal 5 V to 12 V converter/
File: regulated_12v.kicad_sch
Title: SC12 - Internal 5 V to 12 V converter

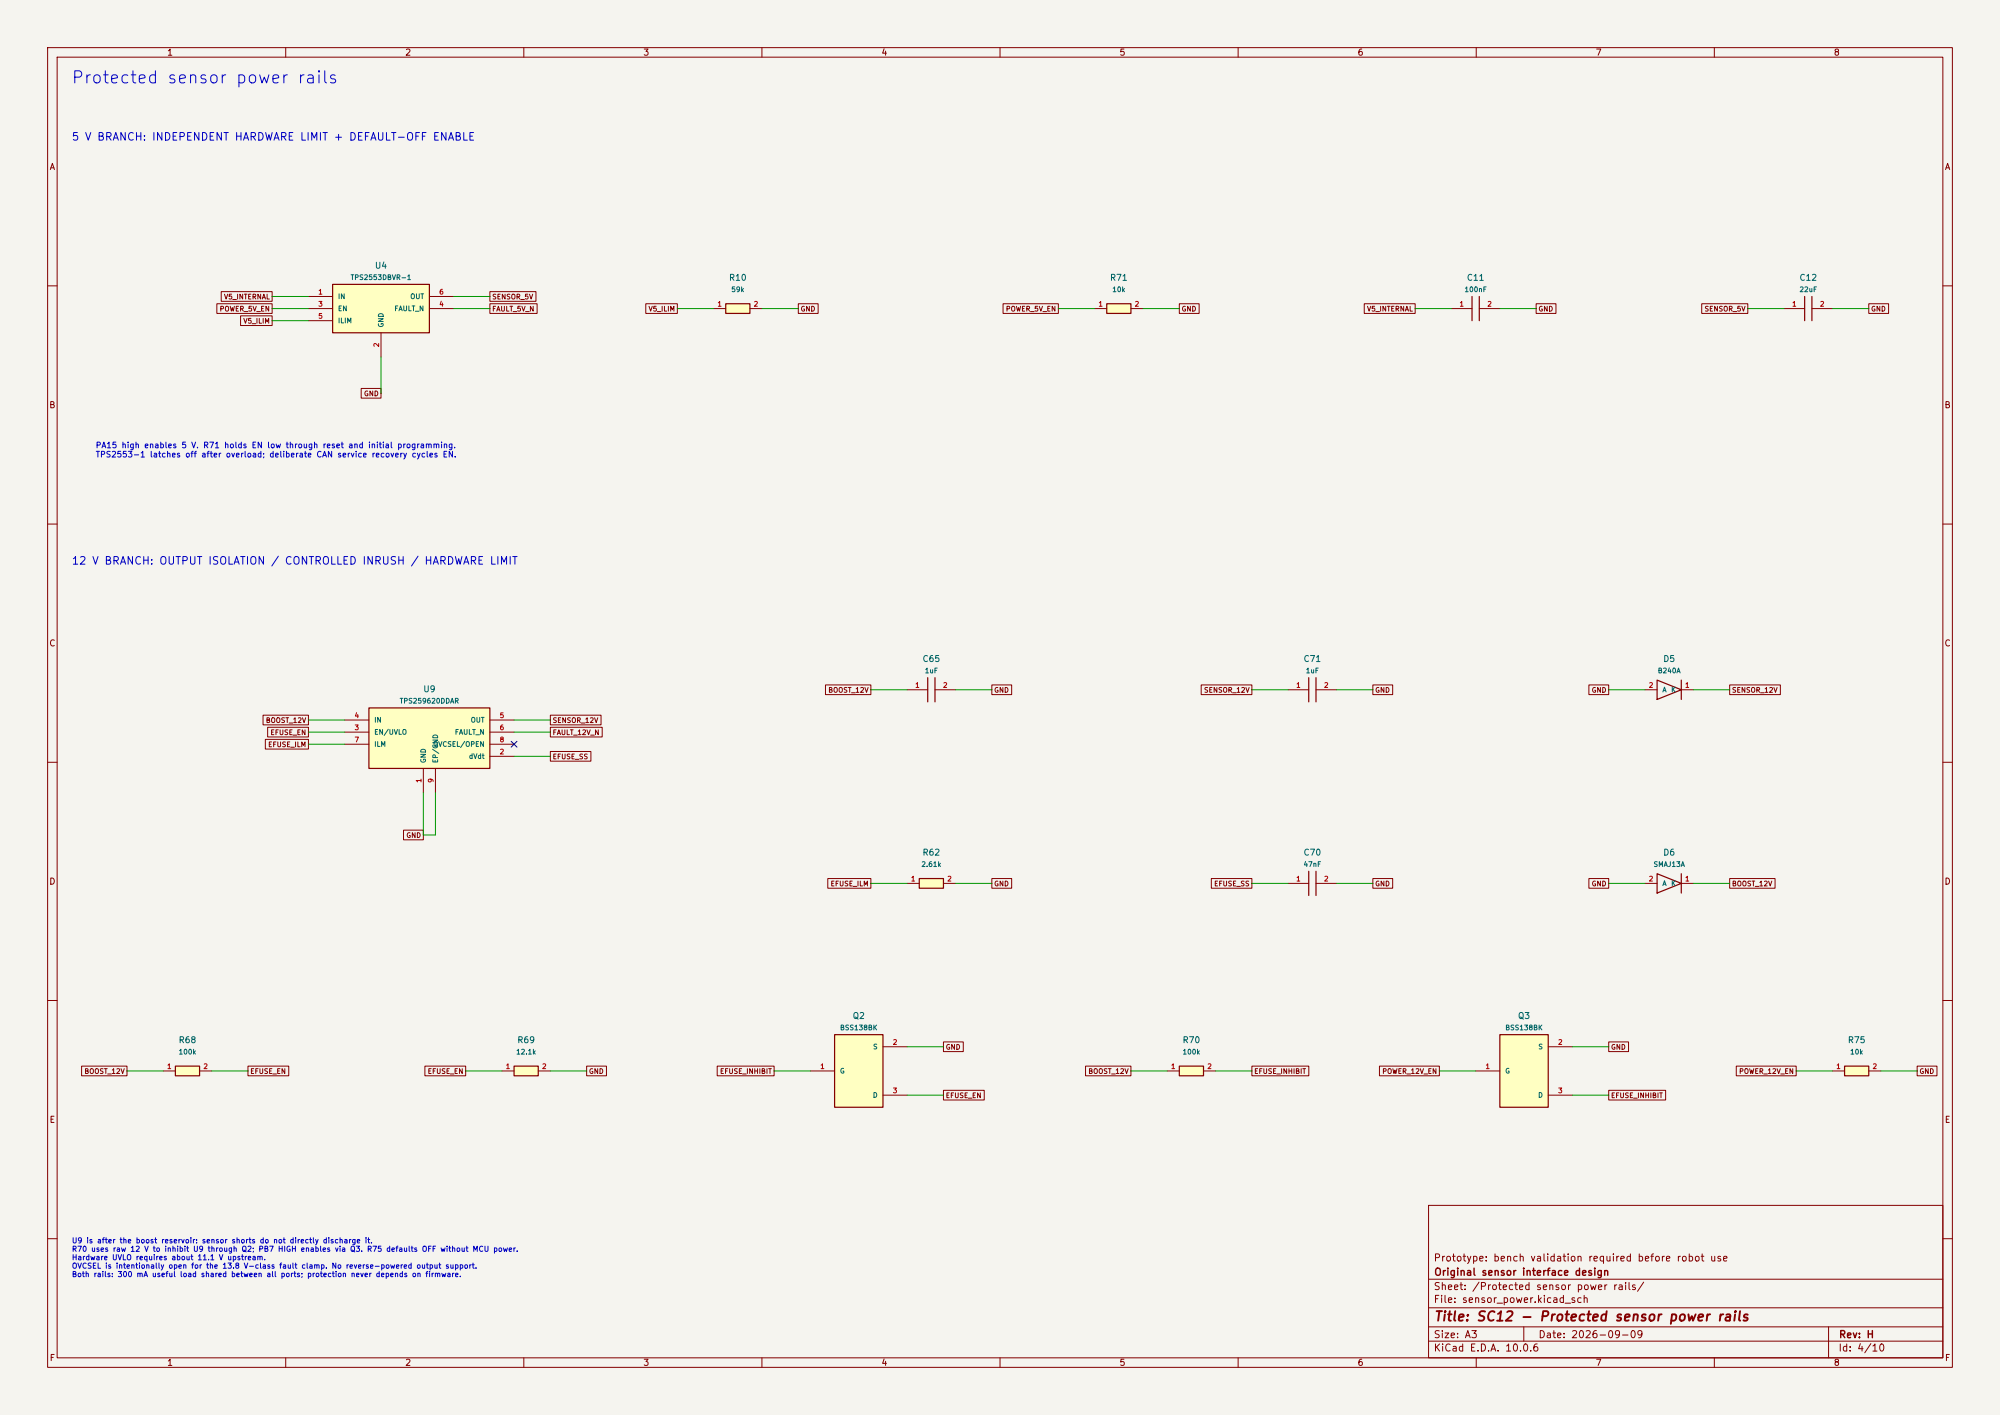
[picture p190: page 4]

Protected sensor power rails

PA15 high enables 5 V. R71 holds EN low through reset and initial programming. TPS2553-1 latches off after overload; deliberate CAN service recovery cycles EN. 5 V BRANCH: INDEPENDENT HARDWARE LIMIT + DEFAULT-OFF ENABLE

12 V BRANCH: OUTPUT ISOLATION / CONTROLLED INRUSH / HARDWARE LIMIT

U9 is after the boost reservoir: sensor shorts do not directly discharge it. R70 uses raw 12 V to inhibit U9 through Q2; PB7 HIGH enables via Q3. R75 defaults OFF without MCU power. Hardware UVLO requires about 11.1 V upstream. OVCSEL is intentionally open for the 13.8 V-class fault clamp. No reverse-powered output support. Both rails: 300 mA useful load shared between all ports; protection never depends on firmware.

Prototype: bench validation required before robot use
Original sensor interface design
Sheet: /Protected sensor power rails/
File: sensor_power.kicad_sch
Title: SC12 - Protected sensor power rails

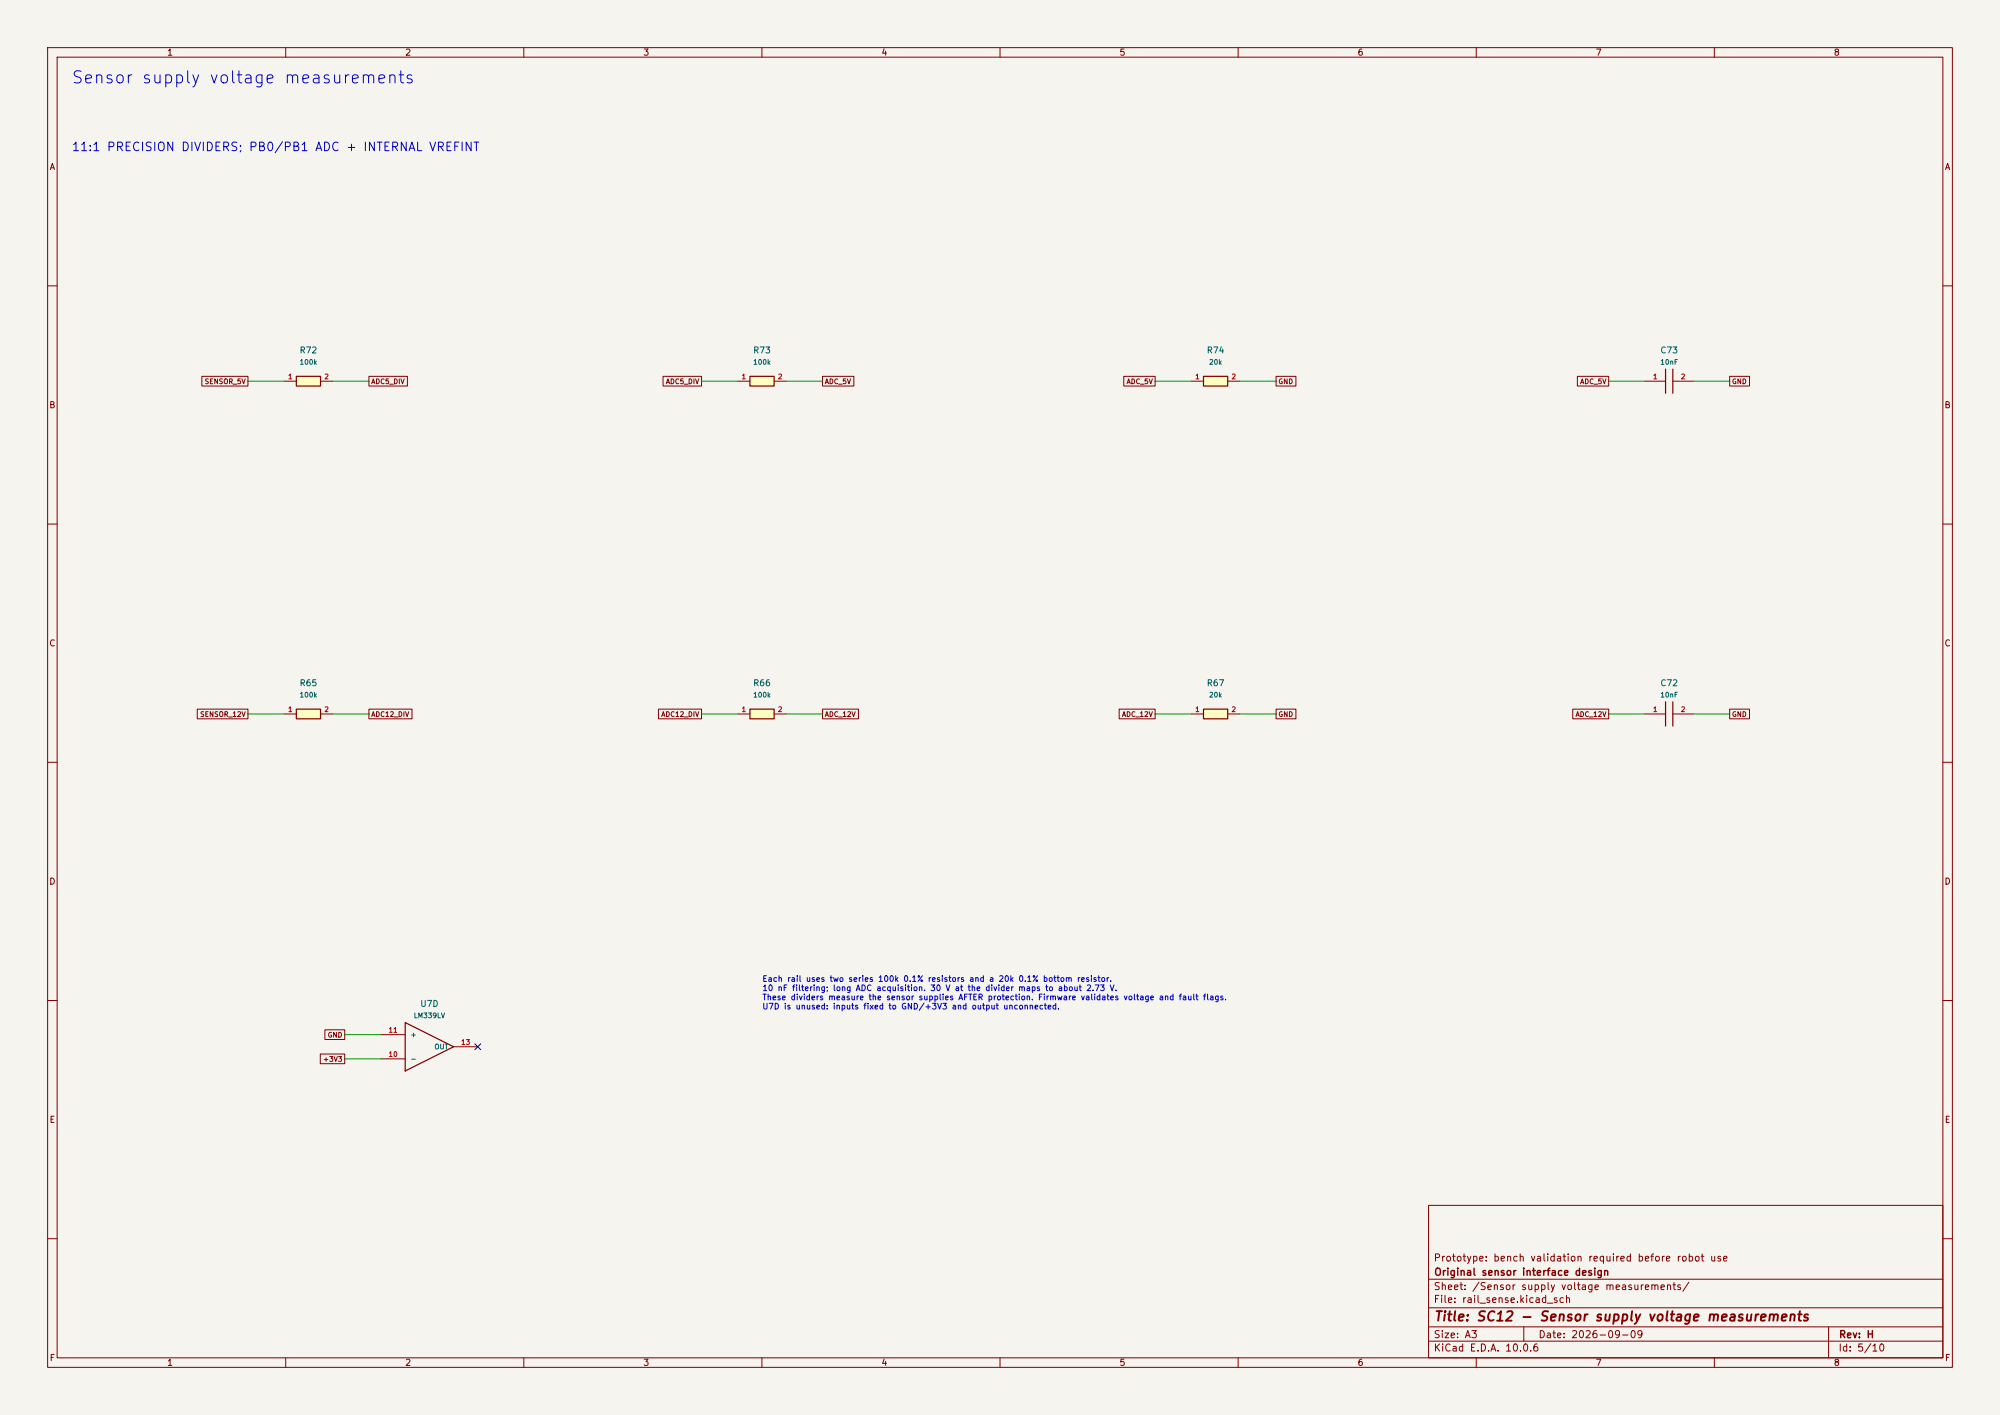
[picture p191: page 5]

Sensor supply voltage measurements

11:1 PRECISION DIVIDERS; PB0/PB1 ADC + INTERNAL VREFINT

Prototype: bench validation required before robot use
Original sensor interface design
Sheet: /Sensor supply voltage measurements/
File: rail_sense.kicad_sch
Title: SC12 - Sensor supply voltage measurements

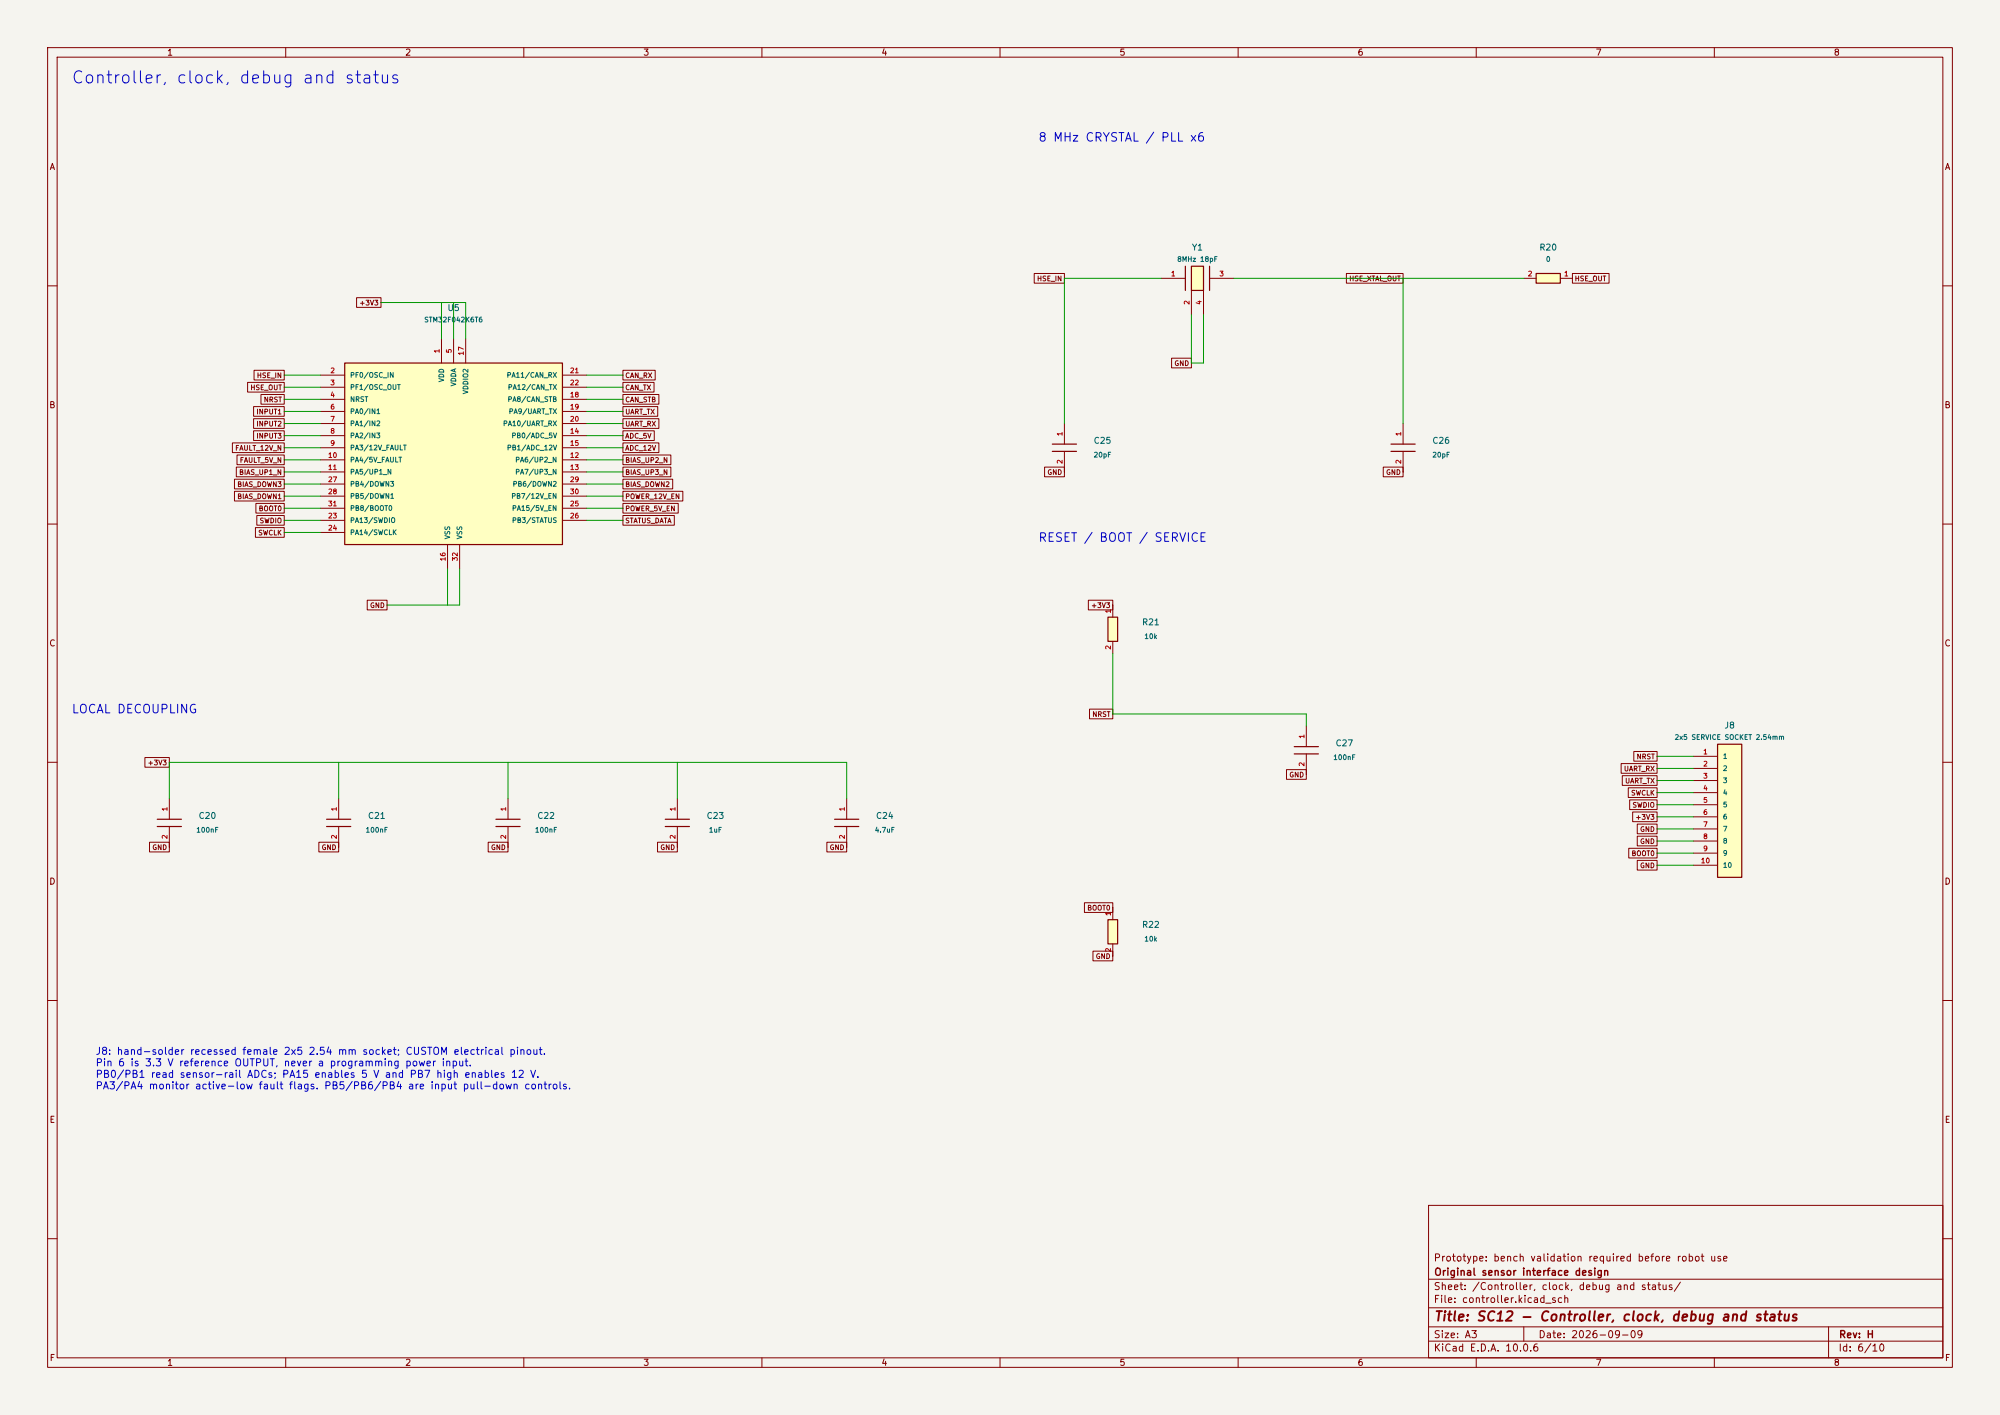
[picture p192: page 6]

INPUT1 Controller, clock, debug and status

1 PF0/OSC_IN 2 PF1/OSC_OUT 3 NRST 4 VDDA 5 PA0/IN1 6 PA1/IN2 7 PA2/IN3 8 PA3/12V_FAULT 9 PA4/5V_FAULT 10 PA5/UP1_N 11 PA6/UP2_N 12 PA7/UP3_N 13 PB0/ADC_5V 14 PB1/ADC_12V 15 VSS 16 VDDIO2 17 PA8/CAN_STB 18 PA9/UART_TX 19 PA10/UART_RX 20 PA11/CAN_RX 21 PA12/CAN_TX 22 PA13/SWDIO 23 PA14/SWCLK 24 PA15/5V_EN 25 PB3/STATUS 26 PB4/DOWN3 27 PB5/DOWN1 28 PB6/DOWN2 29 PB7/12V_EN 30 PB8/BOOT0 31 VSS 32 U5

J8: hand-solder recessed female 2x5 2.54 mm socket; CUSTOM electrical pinout.
Pin 6 is 3.3 V reference OUTPUT, never a programming power input.
PB0/PB1 read sensor-rail ADCs; PA15 enables 5 V and PB7 high enables 12 V.
PA3/PA4 monitor active-low fault flags. PB5/PB6/PB4 are input pull-down controls.

Prototype: bench validation required before robot use
Original sensor interface design
Sheet: /Controller, clock, debug and status/
File: controller.kicad_sch
Title: SC12 - Controller, clock, debug and status

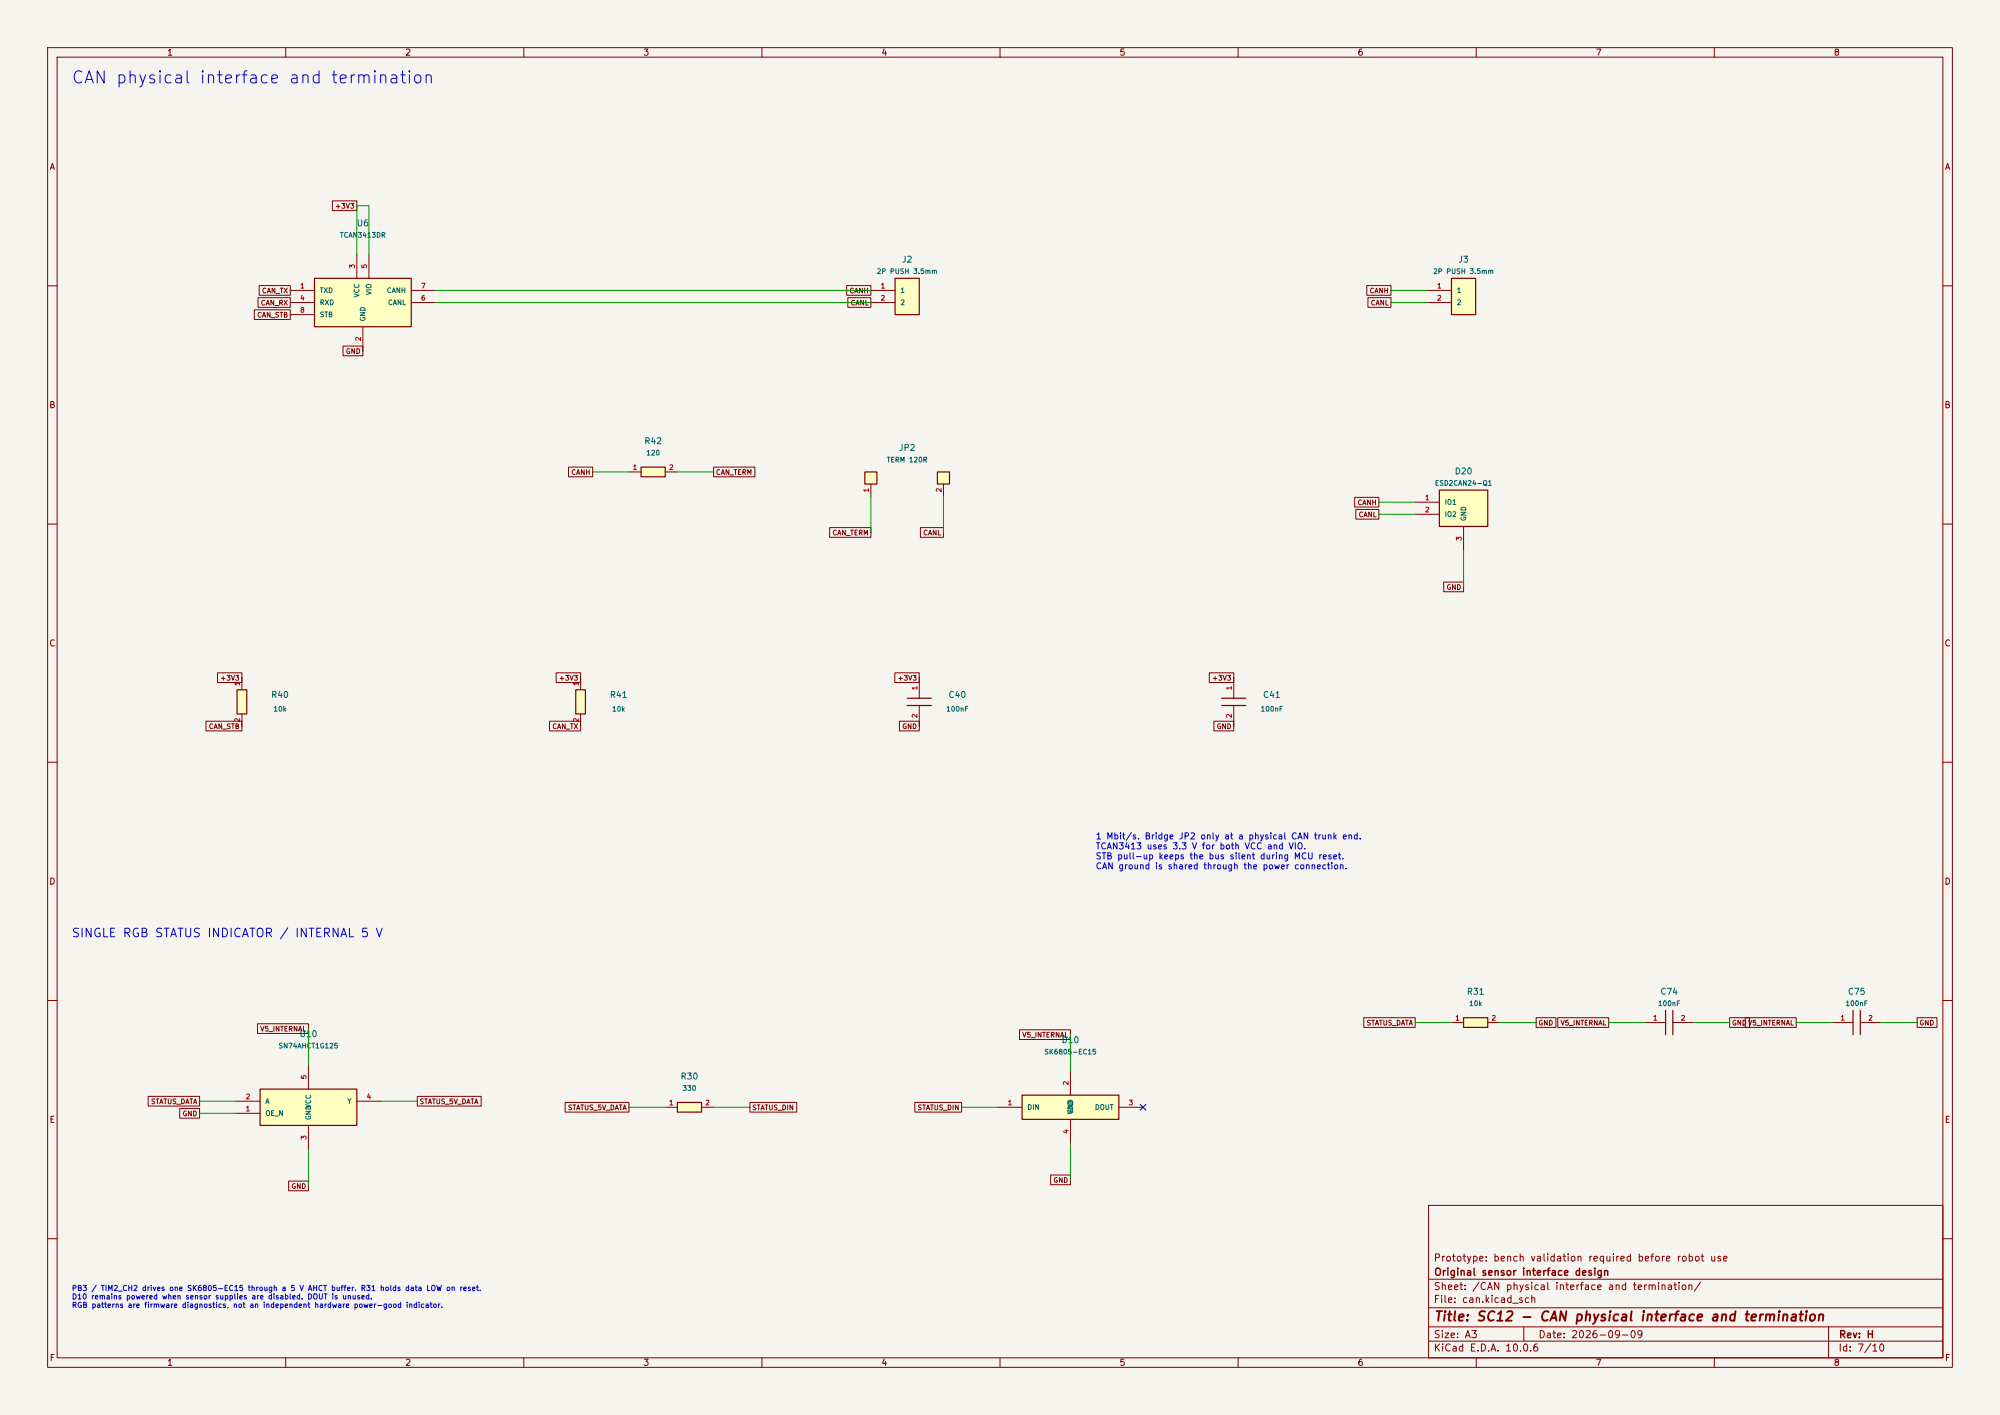
[picture p193: page 7]

SINGLE RGB STATUS INDICATOR / INTERNAL 5 V

Prototype: bench validation required before robot use
Original sensor interface design
Sheet: /CAN physical interface and termination/
File: can.kicad_sch
Title: SC12 - CAN physical interface and termination

PB3 / TIM2_CH2 drives one SK6805-EC15 through a 5 V AHCT buffer. R31 holds data LOW on reset. D10 remains powered when sensor supplies are disabled. DOUT is unused. RGB patterns are firmware diagnostics, not an independent hardware power-good indicator.

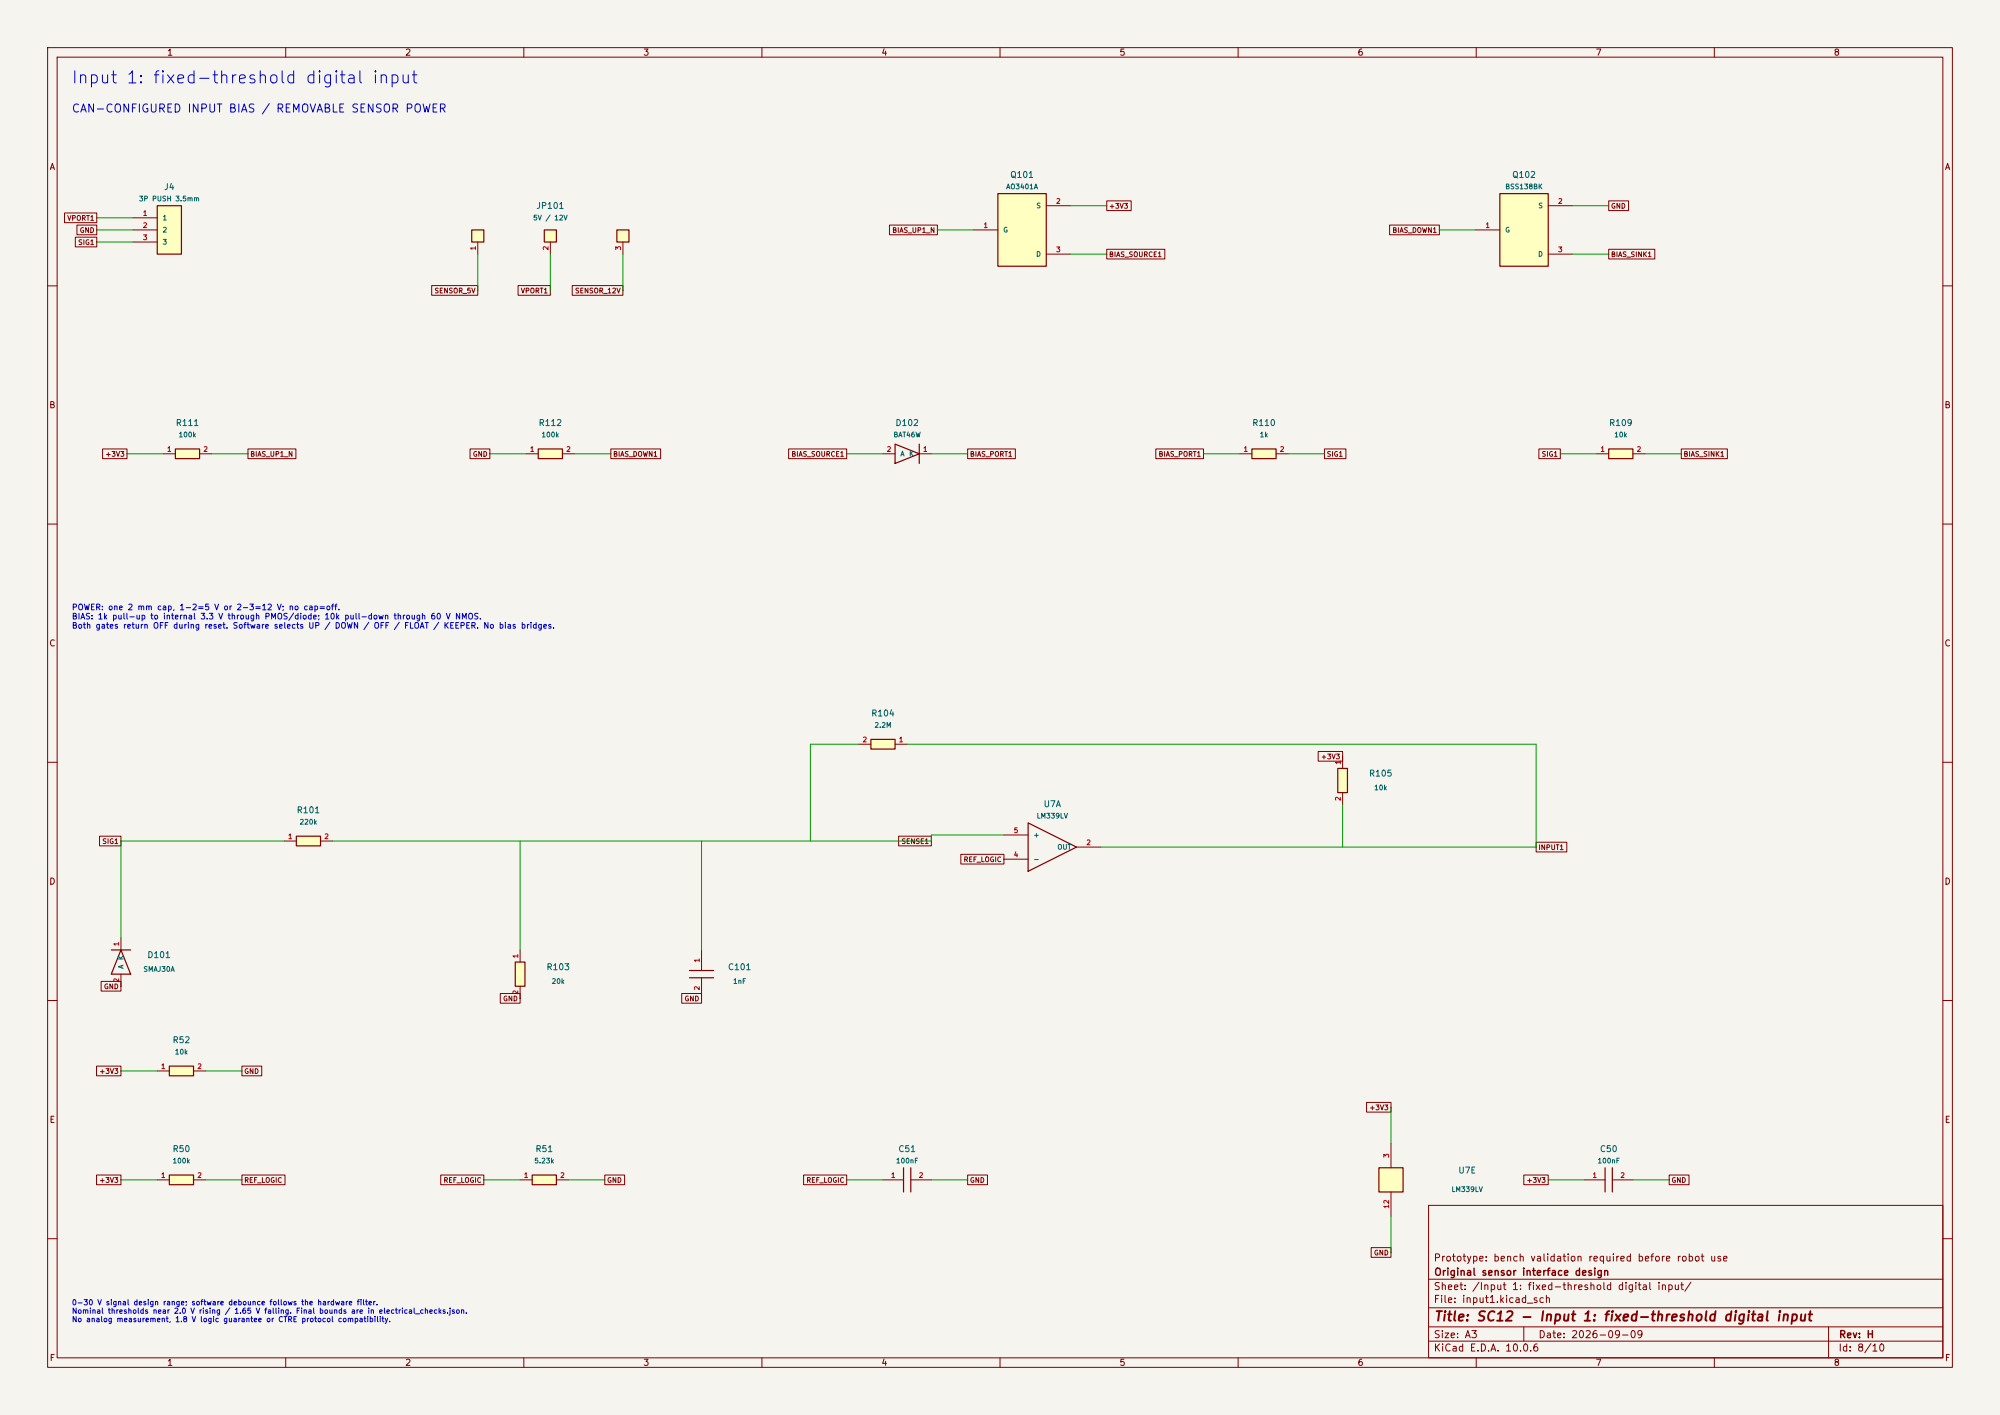
[picture p194: page 8]

VPORT1 Input 1: fixed-threshold digital input

CAN-CONFIGURED INPUT BIAS / REMOVABLE SENSOR POWER

POWER: one 2 mm cap, 1-2=5 V or 2-3=12 V; no cap=off. BIAS: 1k pull-up to internal 3.3 V through PMOS/diode; 10k pull-down through 60 V NMOS. Both gates return OFF during reset. Software selects UP / DOWN / OFF / FLOAT / KEEPER. No bias bridges.

Prototype: bench validation required before robot use
Original sensor interface design
Sheet: /Input 1: fixed-threshold digital input/
File: input1.kicad_sch
Title: SC12 - Input 1: fixed-threshold digital input

0-30 V signal design range; software debounce follows the hardware filter. Nominal thresholds near 2.0 V rising / 1.65 V falling. Final bounds are in electrical_checks.json. No analog measurement, 1.8 V logic guarantee or CTRE protocol compatibility.

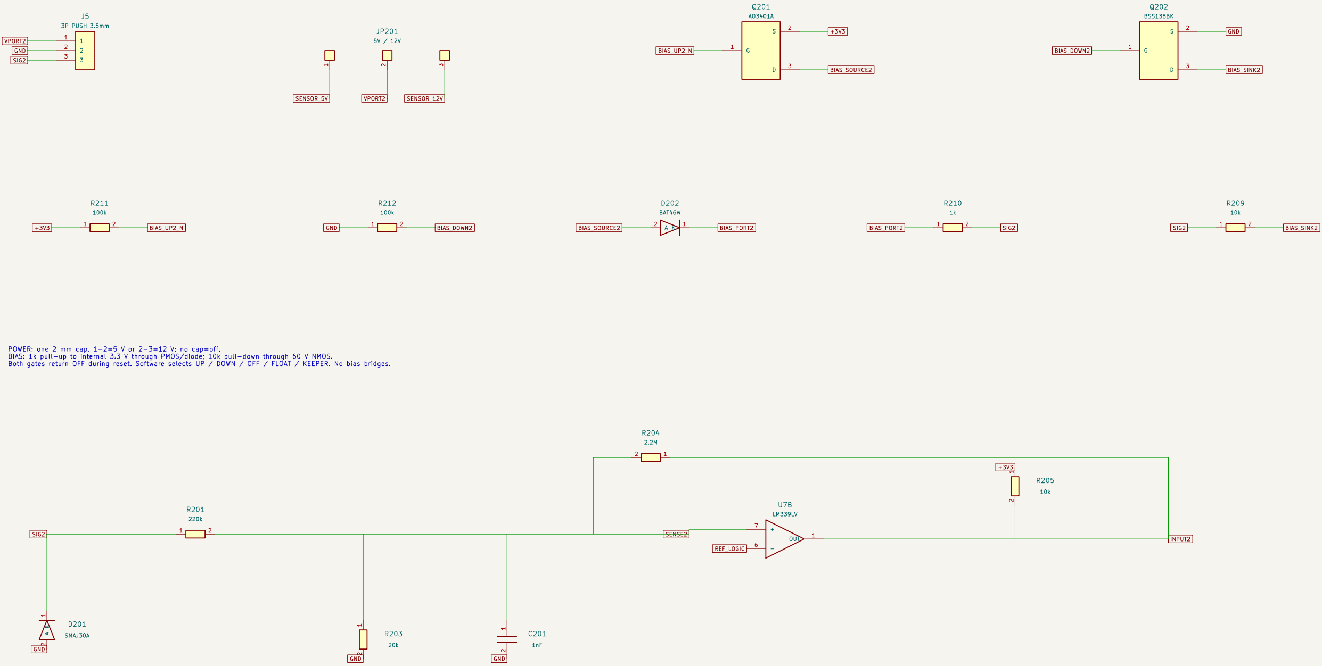
[picture p195: figure]
BSS138BK; SMAJ30A; BAT46W; OUT; 3P PUSH 3.5mm; BIAS_UP2_N; VPORT2; BIAS_SOURCE2; BIAS_SINK2; GND; SIG2; REF_LOGIC; SIG2 +3V3; BIAS_SINK2 GND; SENSE2 +3V3; +3V3 BIAS_UP2_N; INPUT2; BIAS_DOWN2; BIAS_PORT2

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
# Title: SC12 - Input 2: fixed-threshold digital input

## File: input2.kicad_sch

## Sheet: /Input 2: fixed-threshold digital input/

## Original sensor interface design

## Prototype: bench validation required before robot use

SENSOR_5V | SENSOR_12V | BIAS_SOURCE2 | BIAS_PORT2 POWER: one 2 mm cap, 1-2=5 V or 2-3=12 V; no cap=off. BIAS: 1k pull-up to internal 3.3 V through PMOS/diode; 10k pull-down through 60 V NMOS. Both gates return OFF during reset. Software selects UP / DOWN / OFF / FLOAT / KEEPER. No bias bridges.

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

The reference divider/filter and comparator power connections are on input1.
One fixed logic-compatible threshold for all three channels; no industrial threshold selector.

# Input 2: fixed-threshold digital input

## CAN-CONFIGURED INPUT BIAS / REMOVABLE SENSOR POWER

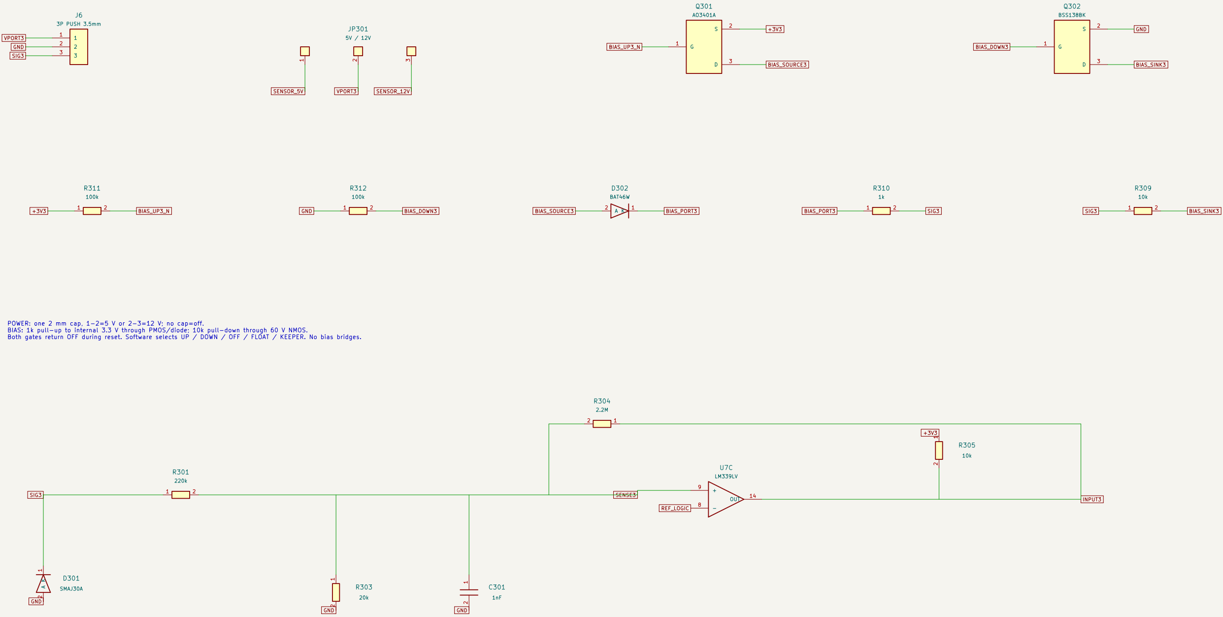
[picture p196: figure]
BSS138BK; SMAJ30A; BAT46W; OUT; 3P PUSH 3.5mm; BIAS_UP3_N; VPORT3; BIAS_SOURCE3; BIAS_SINK3; GND; SIG3; REF_LOGIC; SIG3 +3V3; BIAS_SINK3 GND; SENSE3 +3V3; +3V3 BIAS_UP3_N; INPUT3; BIAS_DOWN3; BIAS_PORT3

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
# Title: SC12 - Input 3: fixed-threshold digital input

## File: input3.kicad_sch

## Sheet: /Input 3: fixed-threshold digital input/

## Original sensor interface design

## Prototype: bench validation required before robot use

SENSOR_5V | SENSOR_12V | BIAS_SOURCE3 | BIAS_PORT3 POWER: one 2 mm cap, 1-2=5 V or 2-3=12 V; no cap=off. BIAS: 1k pull-up to internal 3.3 V through PMOS/diode; 10k pull-down through 60 V NMOS. Both gates return OFF during reset. Software selects UP / DOWN / OFF / FLOAT / KEEPER. No bias bridges.

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

# Input 3: fixed-threshold digital input

## CAN-CONFIGURED INPUT BIAS / REMOVABLE SENSOR POWER
