barkinvar/sugerCANe/rev_b2/output/documentation/Mechanical_RevB2_1to1.pdf

# Sensor CAN — Rev B-2 mounting template

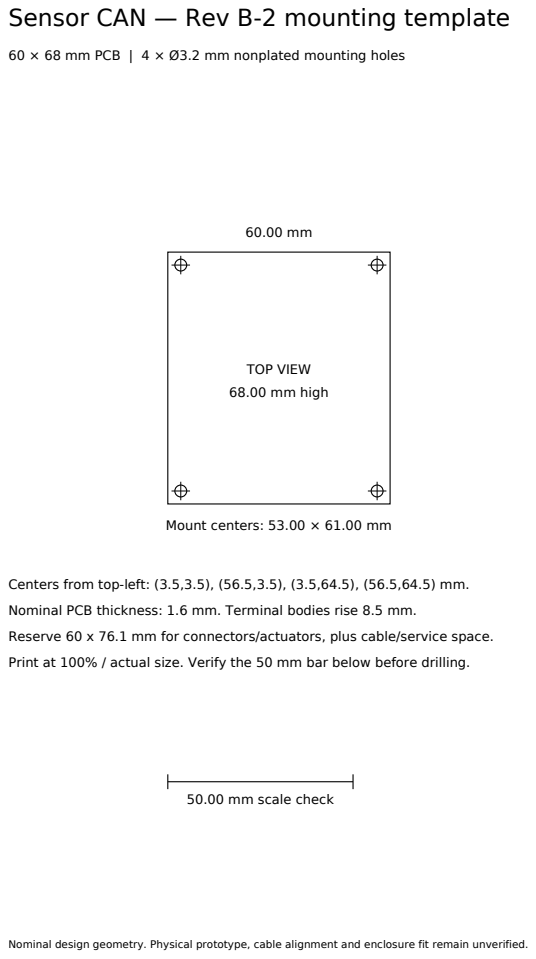
[picture p197: page 1]
TOP VIEW; 68.00 mm high

60 × 68 mm PCB | 4 × Ø3.2 mm nonplated mounting holes

Mount centers: 53.00 × 61.00 mm

Centers from top-left: (3.5,3.5), (56.5,3.5), (3.5,64.5), (56.5,64.5) mm.

Nominal PCB thickness: 1.6 mm. Terminal bodies rise 8.5 mm.

Reserve 60 x 76.1 mm for connectors/actuators, plus cable/service space.

Print at 100% / actual size. Verify the 50 mm bar below before drilling.

50.00 mm scale check

Nominal design geometry. Physical prototype, cable alignment and enclosure fit remain unverified.
