barkinvar/sugerCANe/output/review/crystal_assembly_check.pdf

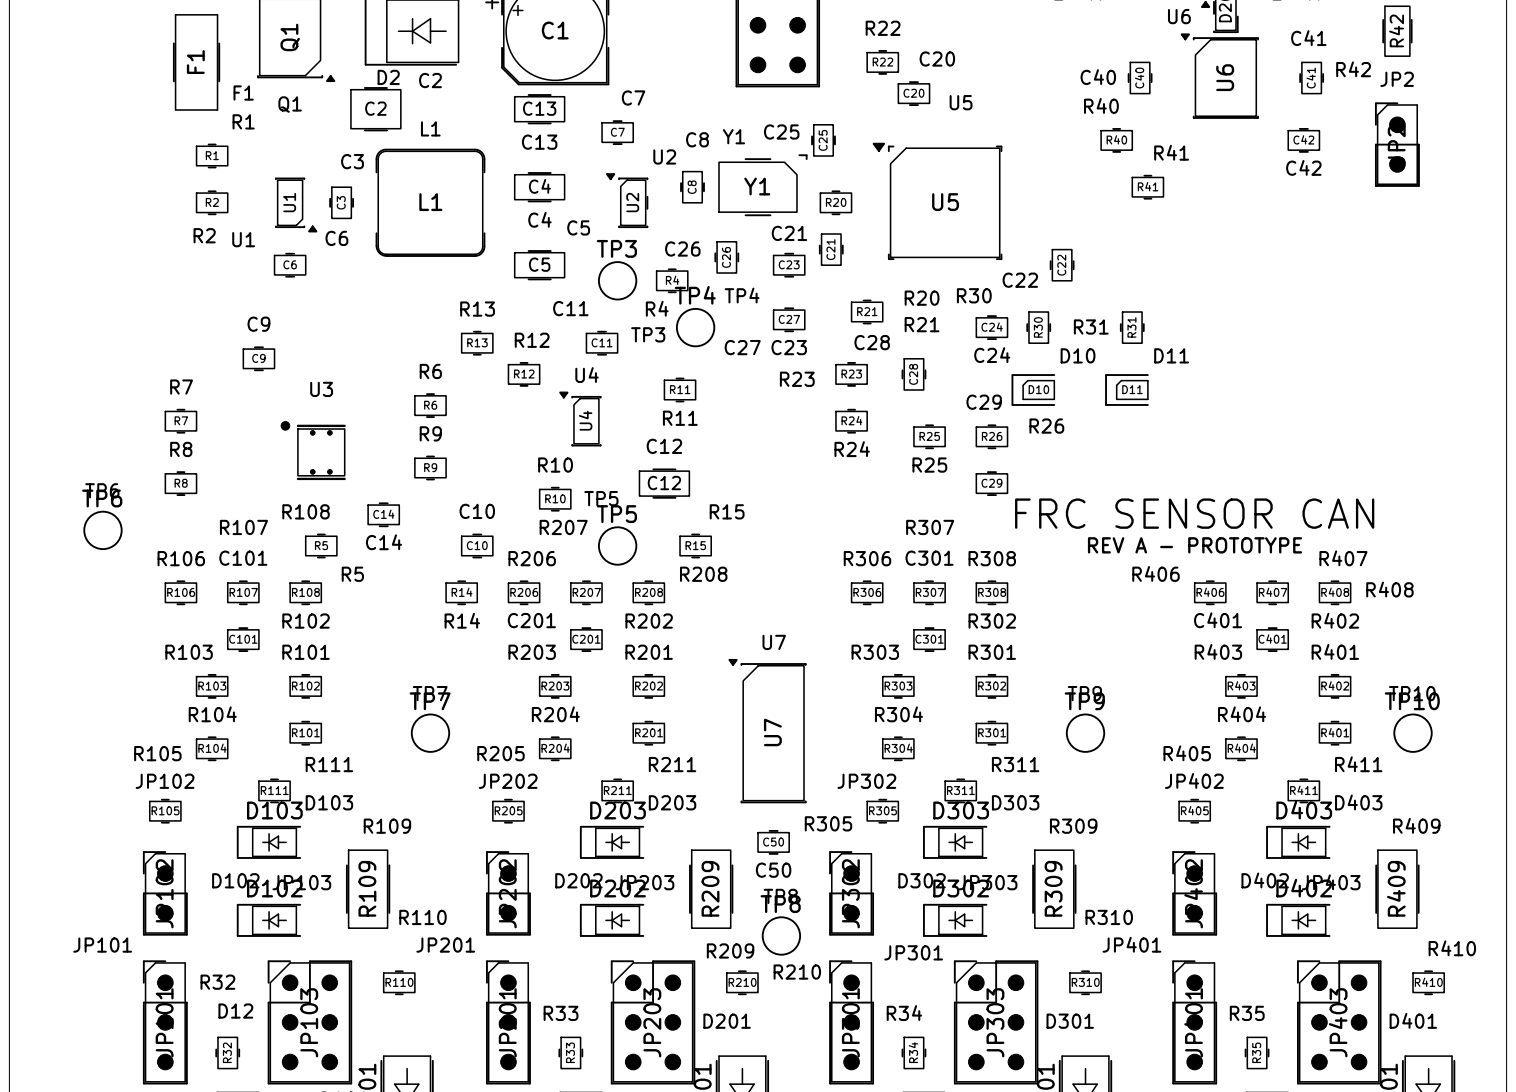
[picture p198: page 1]
