barkinvar/sugerCANe/current/output/assembly/bottom_markings.pdf

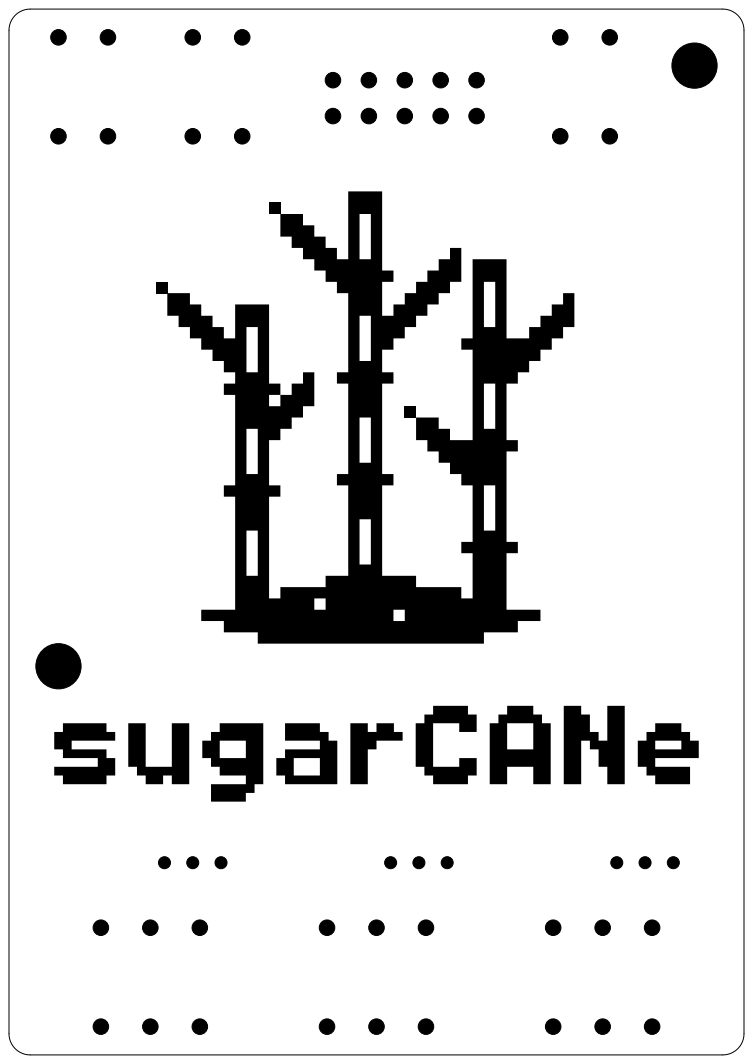
[picture p199: page 1]
