barkinvar/sugerCANe/current/output/assembly/top_assembly.pdf

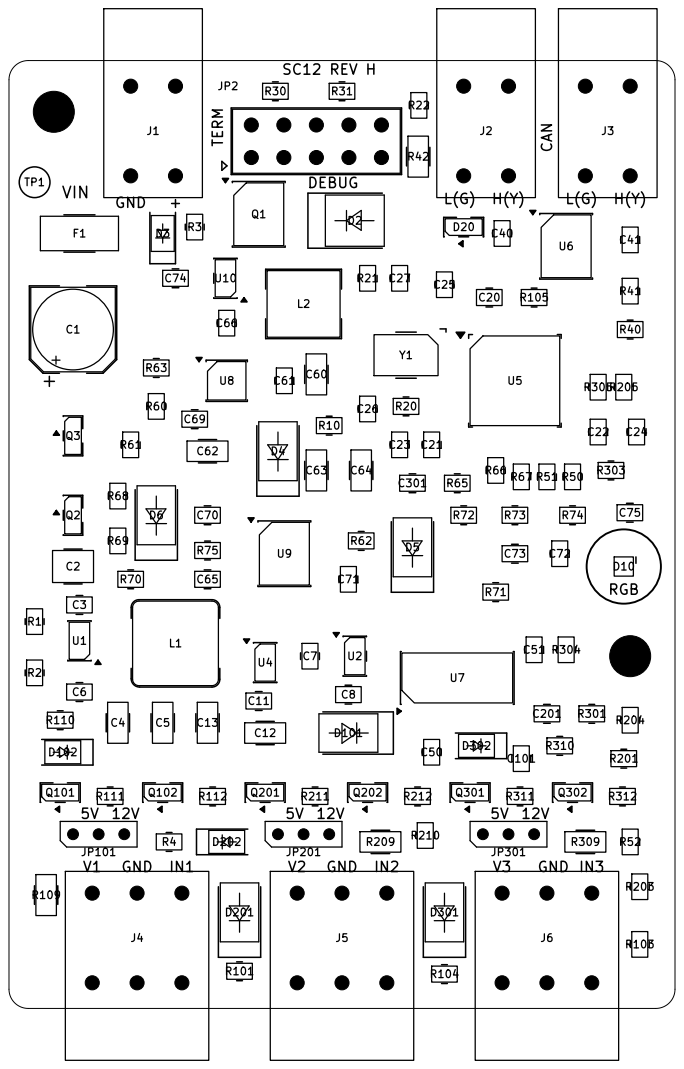
[picture p200: page 1]
