barkinvar/sugerCANe/output/assembly/bottom_markings.pdf

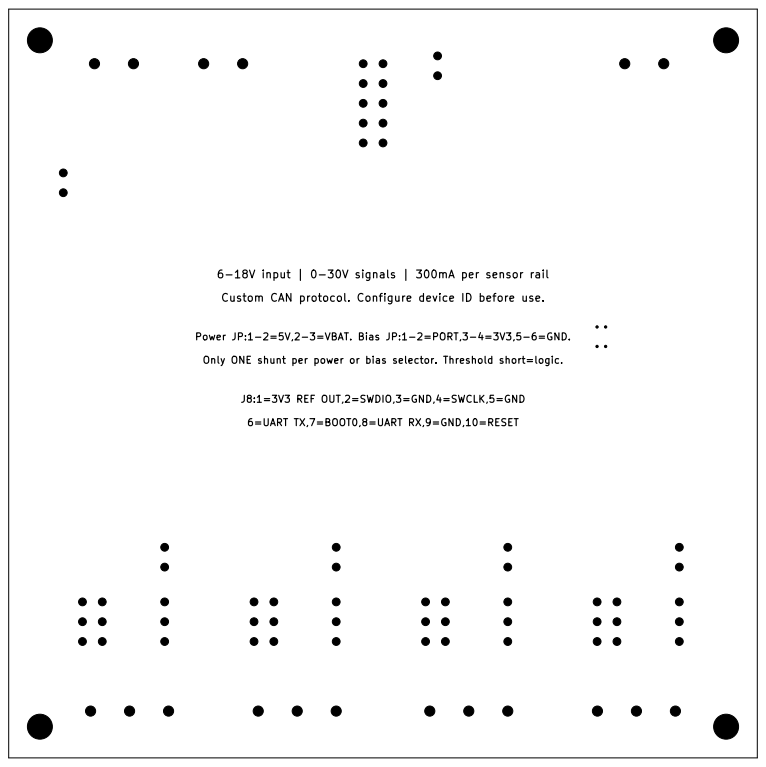
[picture p201: page 1]

6-18V input | 0-30V signals | 300mA per sensor rail
Custom CAN protocol. Configure device ID before use.

Power JP:1-2=5V,2-3=VBAT. Bias JP:1-2=PORT,3-4=3V3,5-6=GND.

Only ONE shunt per power or bias selector. Threshold short=logic.

J8:1=3V3 REF OUT,2=SWDIO,3=GND,4=SWCLK,5=GND

6=UART TX,7=BOOT0,8=UART RX,9=GND,10=RESET
