barkinvar/sugerCANe/output/assembly/gerber_copper_review.pdf

## FRC Sensor CAN · Rev A · TOP copper

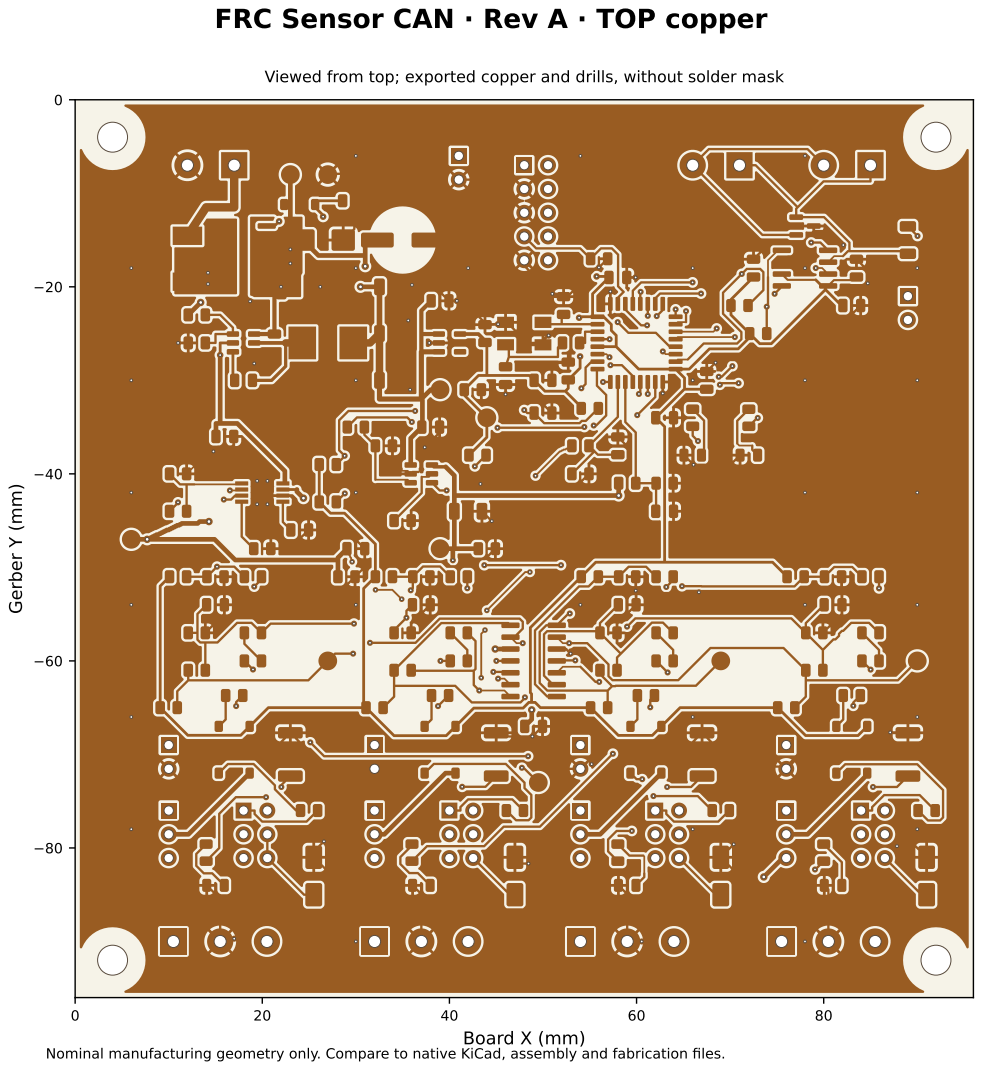
[picture p202: page 1]
Board X (mm); Gerber Y (mm)

Viewed from top; exported copper and drills, without solder mask

Nominal manufacturing geometry only. Compare to native KiCad, assembly and fabrication files.

## FRC Sensor CAN · Rev A · BOTTOM copper

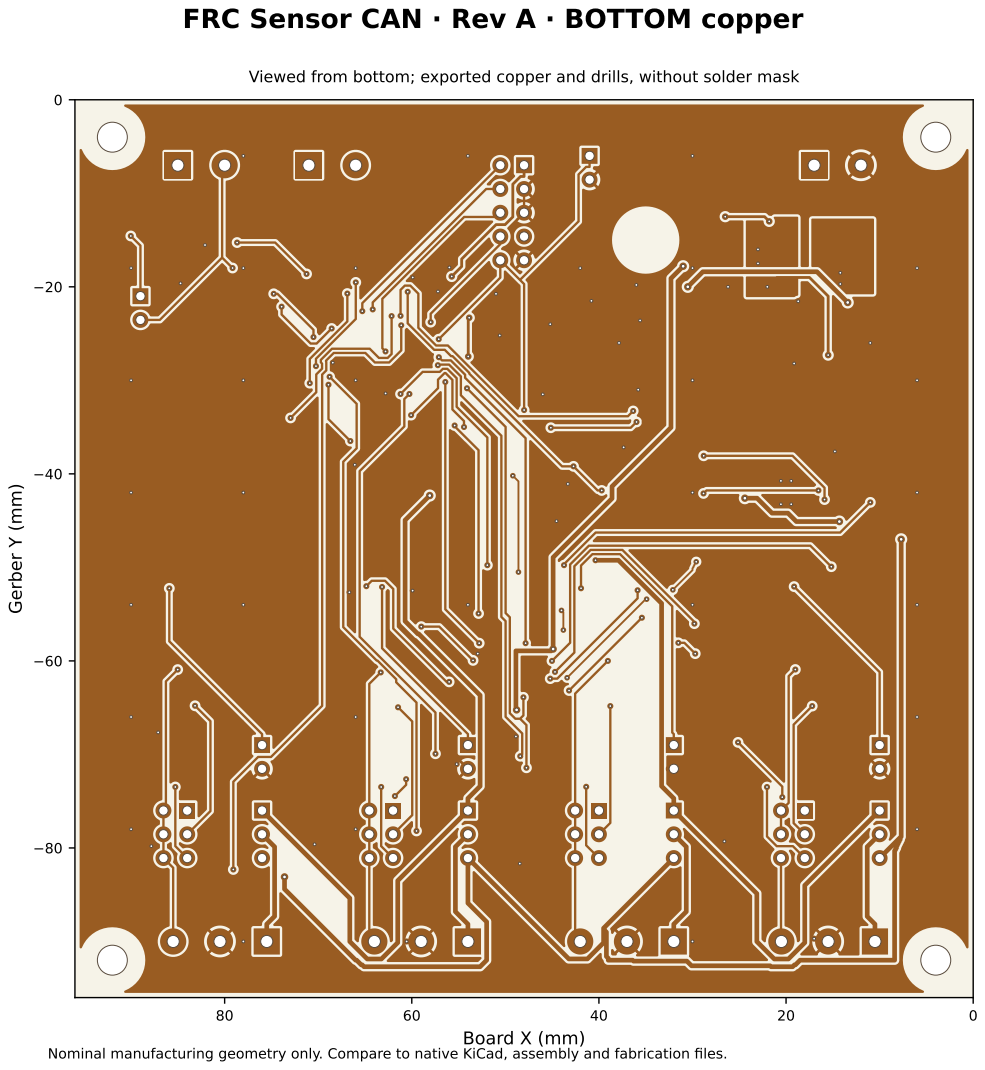
[picture p203: page 2]
Board X (mm); Gerber Y (mm)

Viewed from bottom; exported copper and drills, without solder mask

Nominal manufacturing geometry only. Compare to native KiCad, assembly and fabrication files.
