barkinvar/sugerCANe/rev_e/output/assembly/bottom_markings.pdf

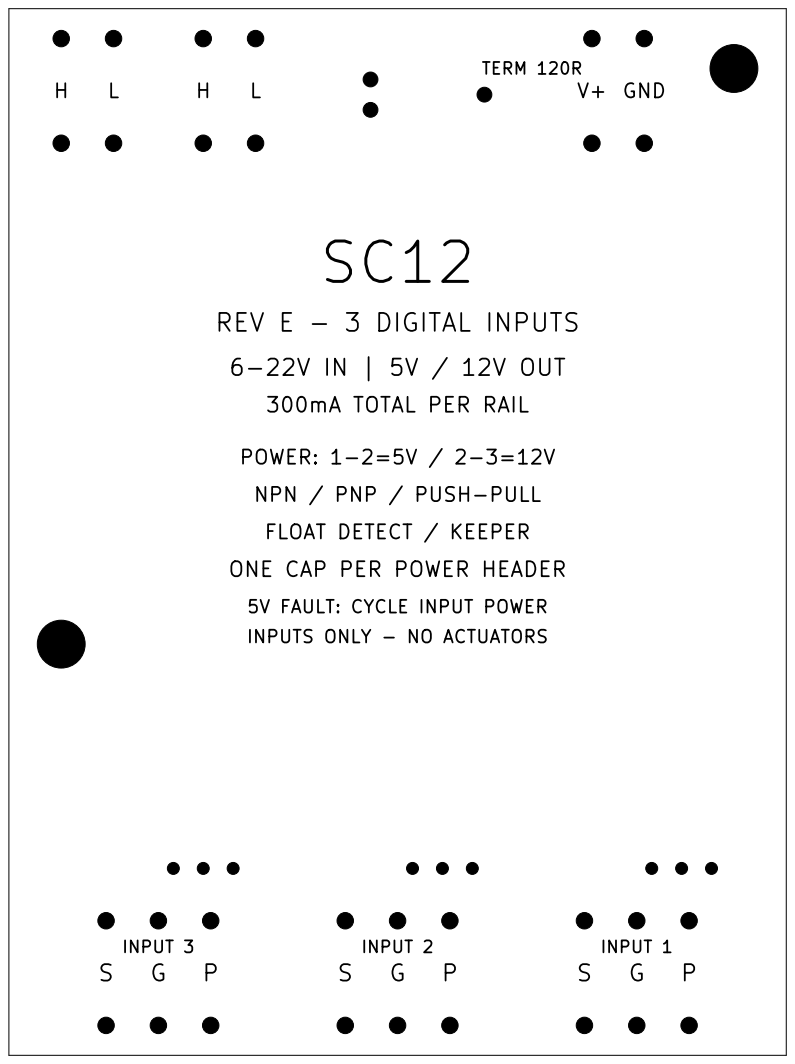
[picture p212: page 1]

POWER: 1-2=5V / 2-3=12V
NPN / PNP / PUSH-PULL
FLOAT DETECT / KEEPER

ONE CAP PER POWER HEADER

5V FAULT: CYCLE INPUT POWER
INPUTS ONLY - NO ACTUATORS
