barkinvar/sugerCANe/rev_e/output/assembly/gerber_copper_review.pdf

## FRC Sensor CAN · Rev E SC12 · TOP copper

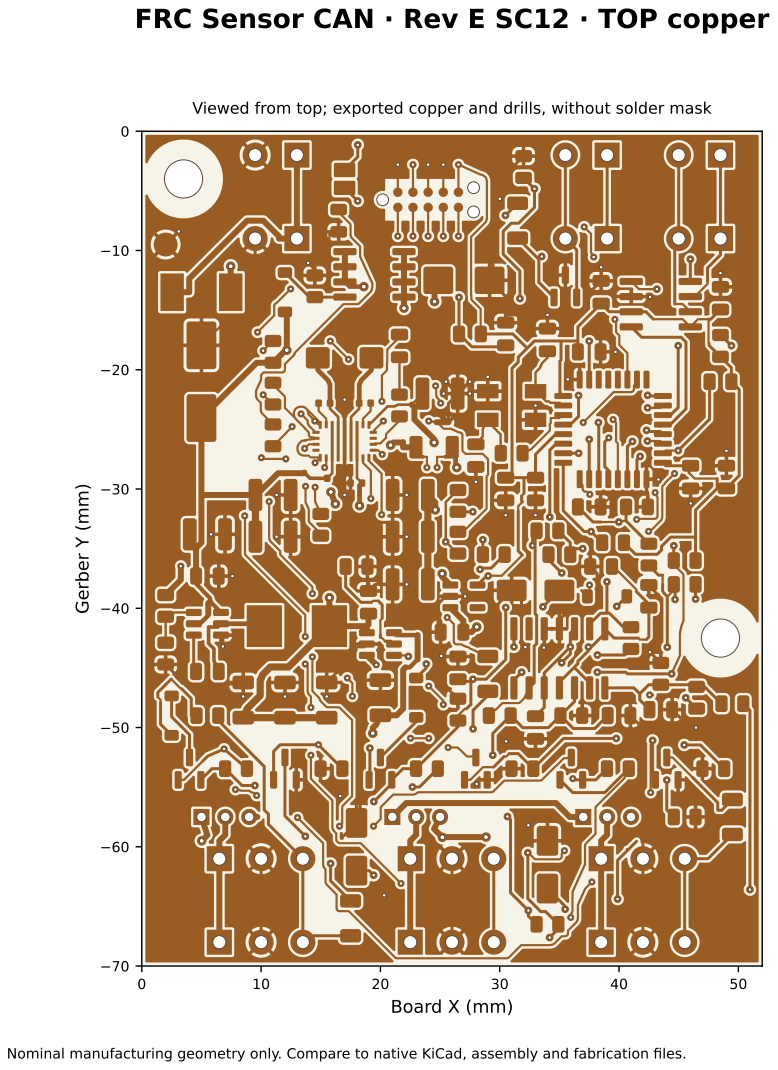
[picture p213: page 1]
Board X (mm); Gerber Y (mm)

Viewed from top; exported copper and drills, without solder mask

Nominal manufacturing geometry only. Compare to native KiCad, assembly and fabrication files.

## FRC Sensor CAN · Rev E SC12 · BOTTOM copper

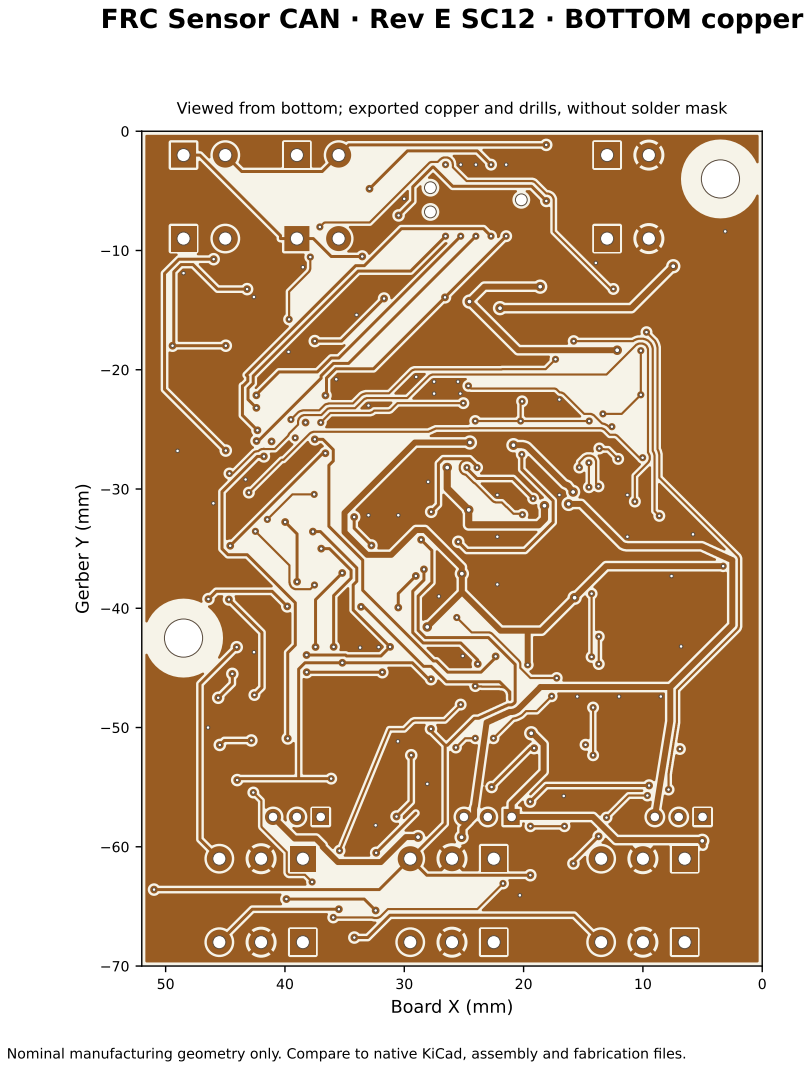
[picture p214: page 2]
Board X (mm); Gerber Y (mm)

Viewed from bottom; exported copper and drills, without solder mask

Nominal manufacturing geometry only. Compare to native KiCad, assembly and fabrication files.
