barkinvar/sugerCANe/rev_e/output/assembly/schematic.pdf

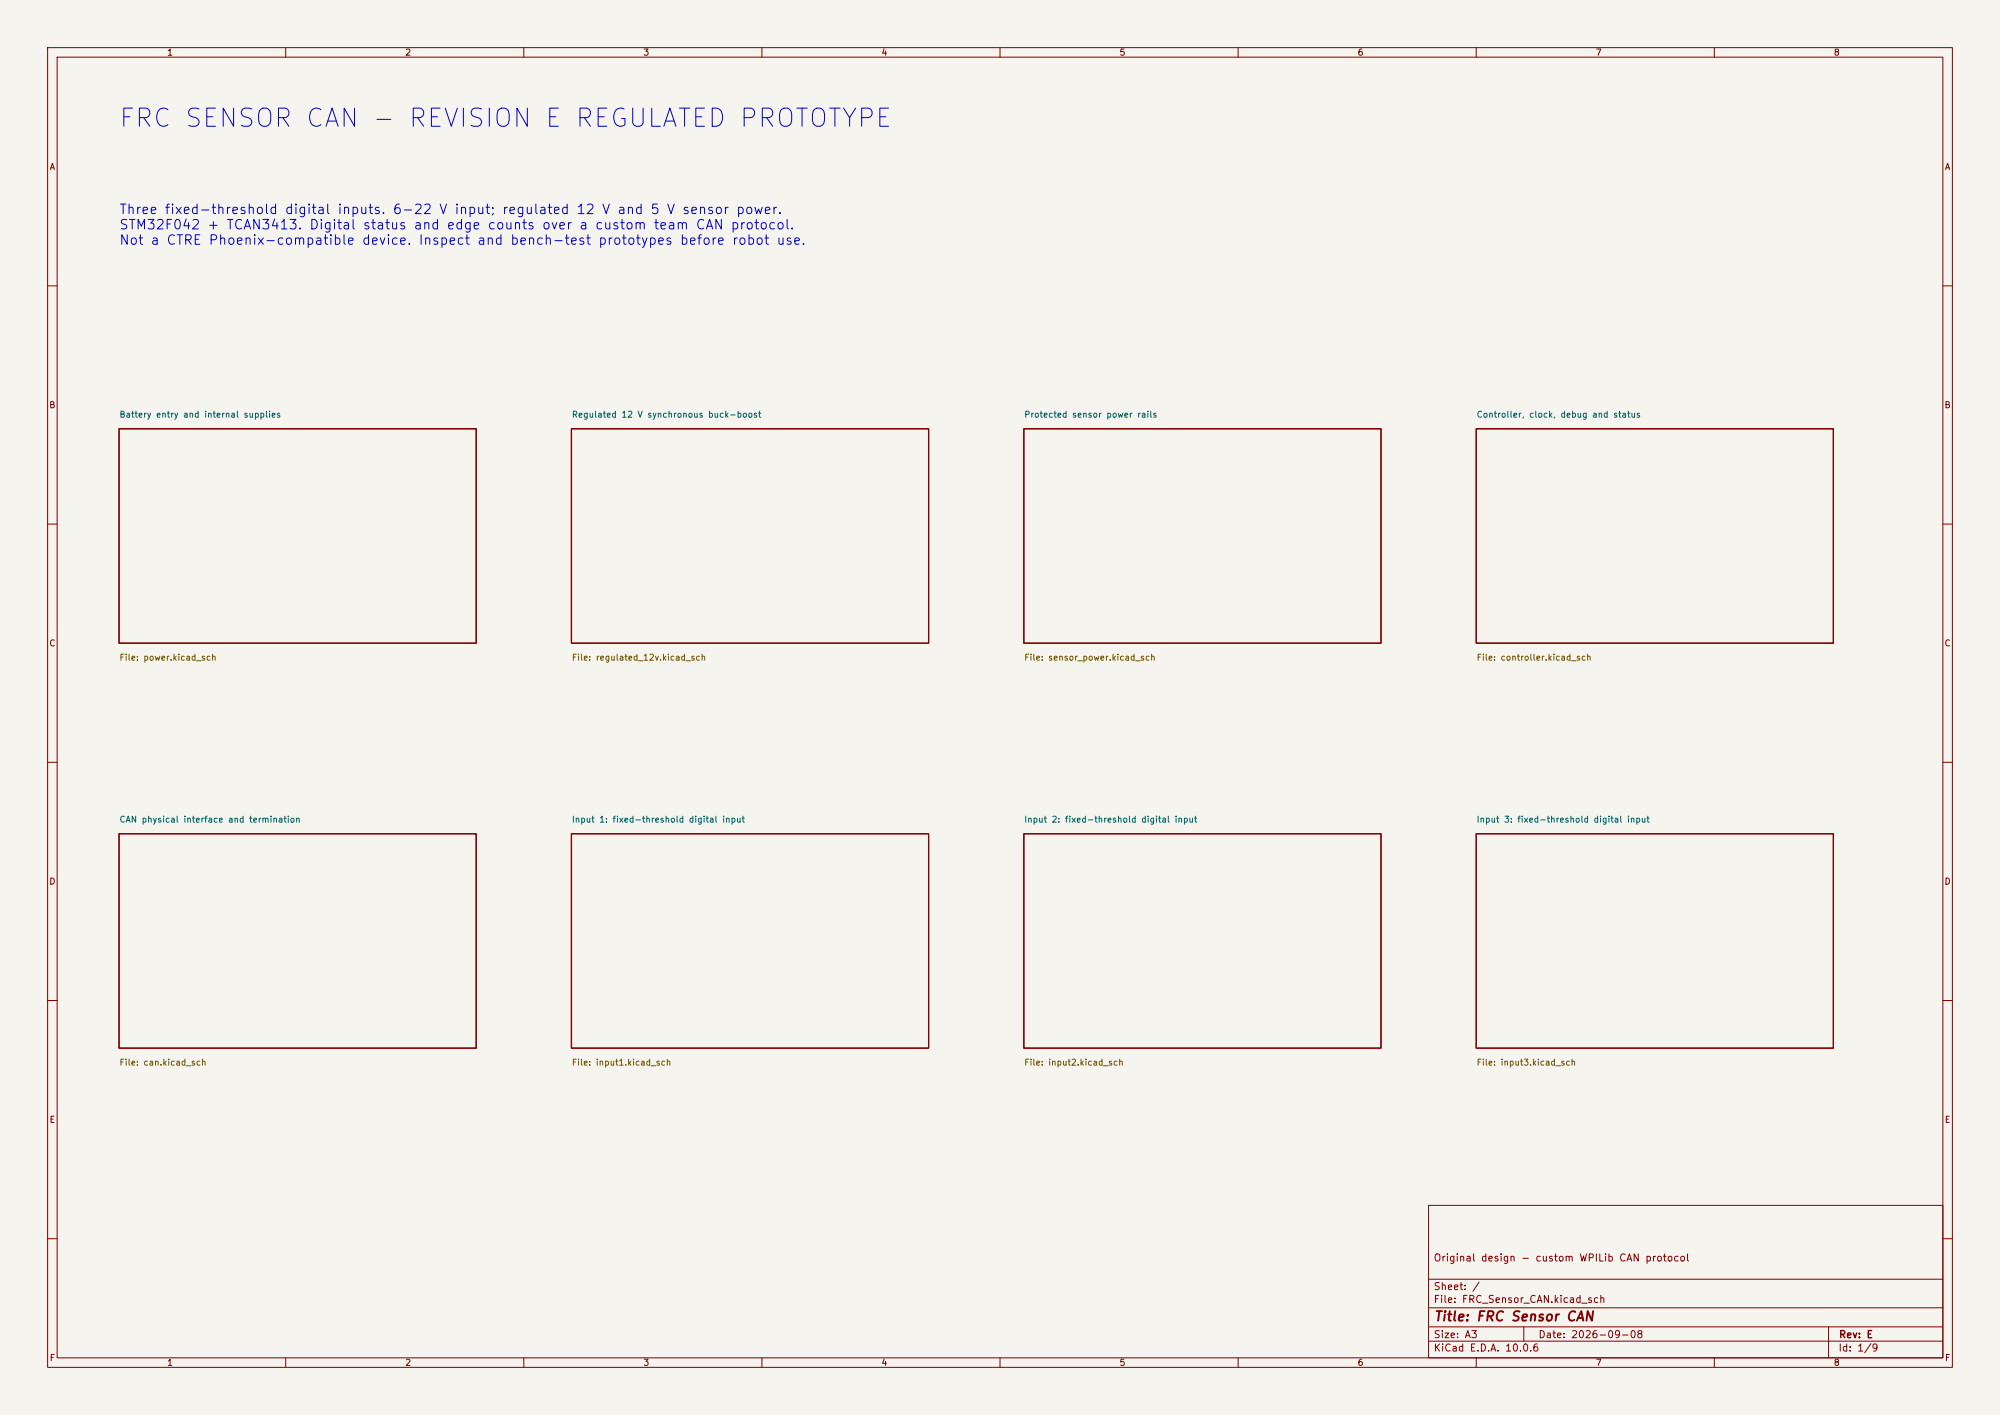
[picture p215: page 1]

FRC SENSOR CAN - REVISION E REGULATED PROTOTYPE

Three fixed-threshold digital inputs. 6-22 V input; regulated 12 V and 5 V sensor power.
STM32F042 + TCAN3413. Digital status and edge counts over a custom team CAN protocol.
Not a CTRE Phoenix-compatible device. Inspect and bench-test prototypes before robot use.

Battery entry and internal supplies File: power.kicad_sch

Regulated 12 V synchronous buck-boost File: regulated_12v.kicad_sch CAN physical interface and termination

Protected sensor power rails File: sensor_power.kicad_sch

Controller, clock, debug and status File: controller.kicad_sch

Input 1: fixed-threshold digital input File: input1.kicad_sch

Input 2: fixed-threshold digital input File: input2.kicad_sch

Input 3: fixed-threshold digital input File: input3.kicad_sch

Original design - custom WPILib CAN protocol

Sheet: /
File: FRC_Sensor_CAN.kicad_sch
Title: FRC Sensor CAN

Size: A3 | Rev: E | F Date: 2026-09-08
KiCad E.D.A. 10.0.6 | Id: 1/9

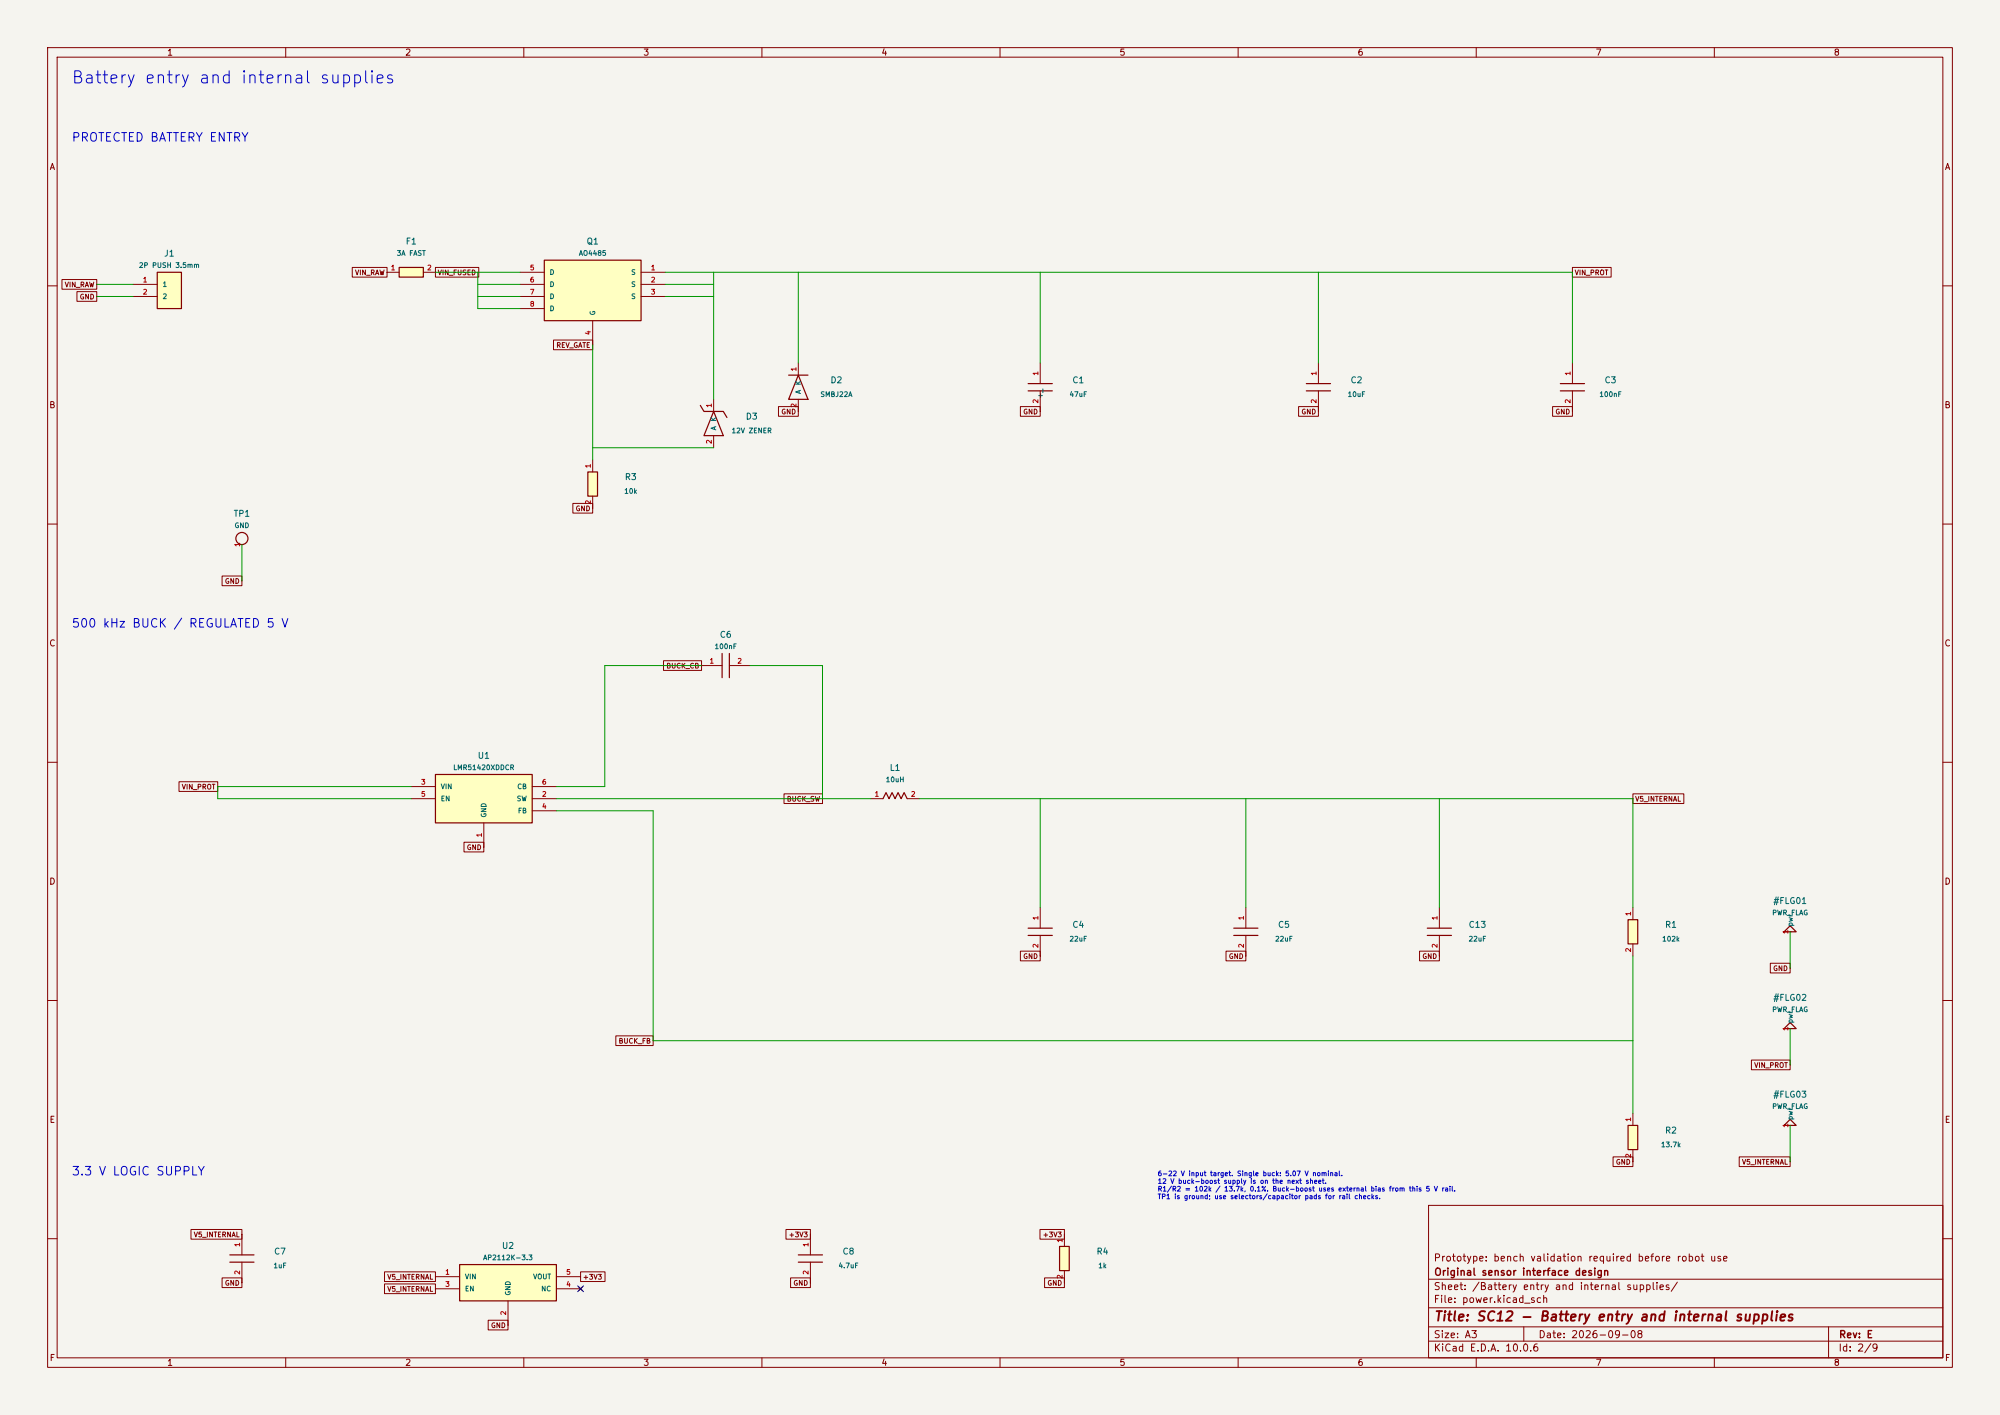
[picture p216: page 2]

Battery entry and internal supplies

6-22 V input target. Single buck: 5.07 V nominal. 12 V buck-boost supply is on the next sheet. R1/R2 = 102k / 13.7k, 0.1%. Buck-boost uses external bias from this 5 V rail. TP1 is ground; use selectors/capacitor pads for rail checks.

Original sensor interface design
Sheet: /Battery entry and internal supplies/
File: power.kicad_sch
Title: SC12 - Battery entry and internal supplies

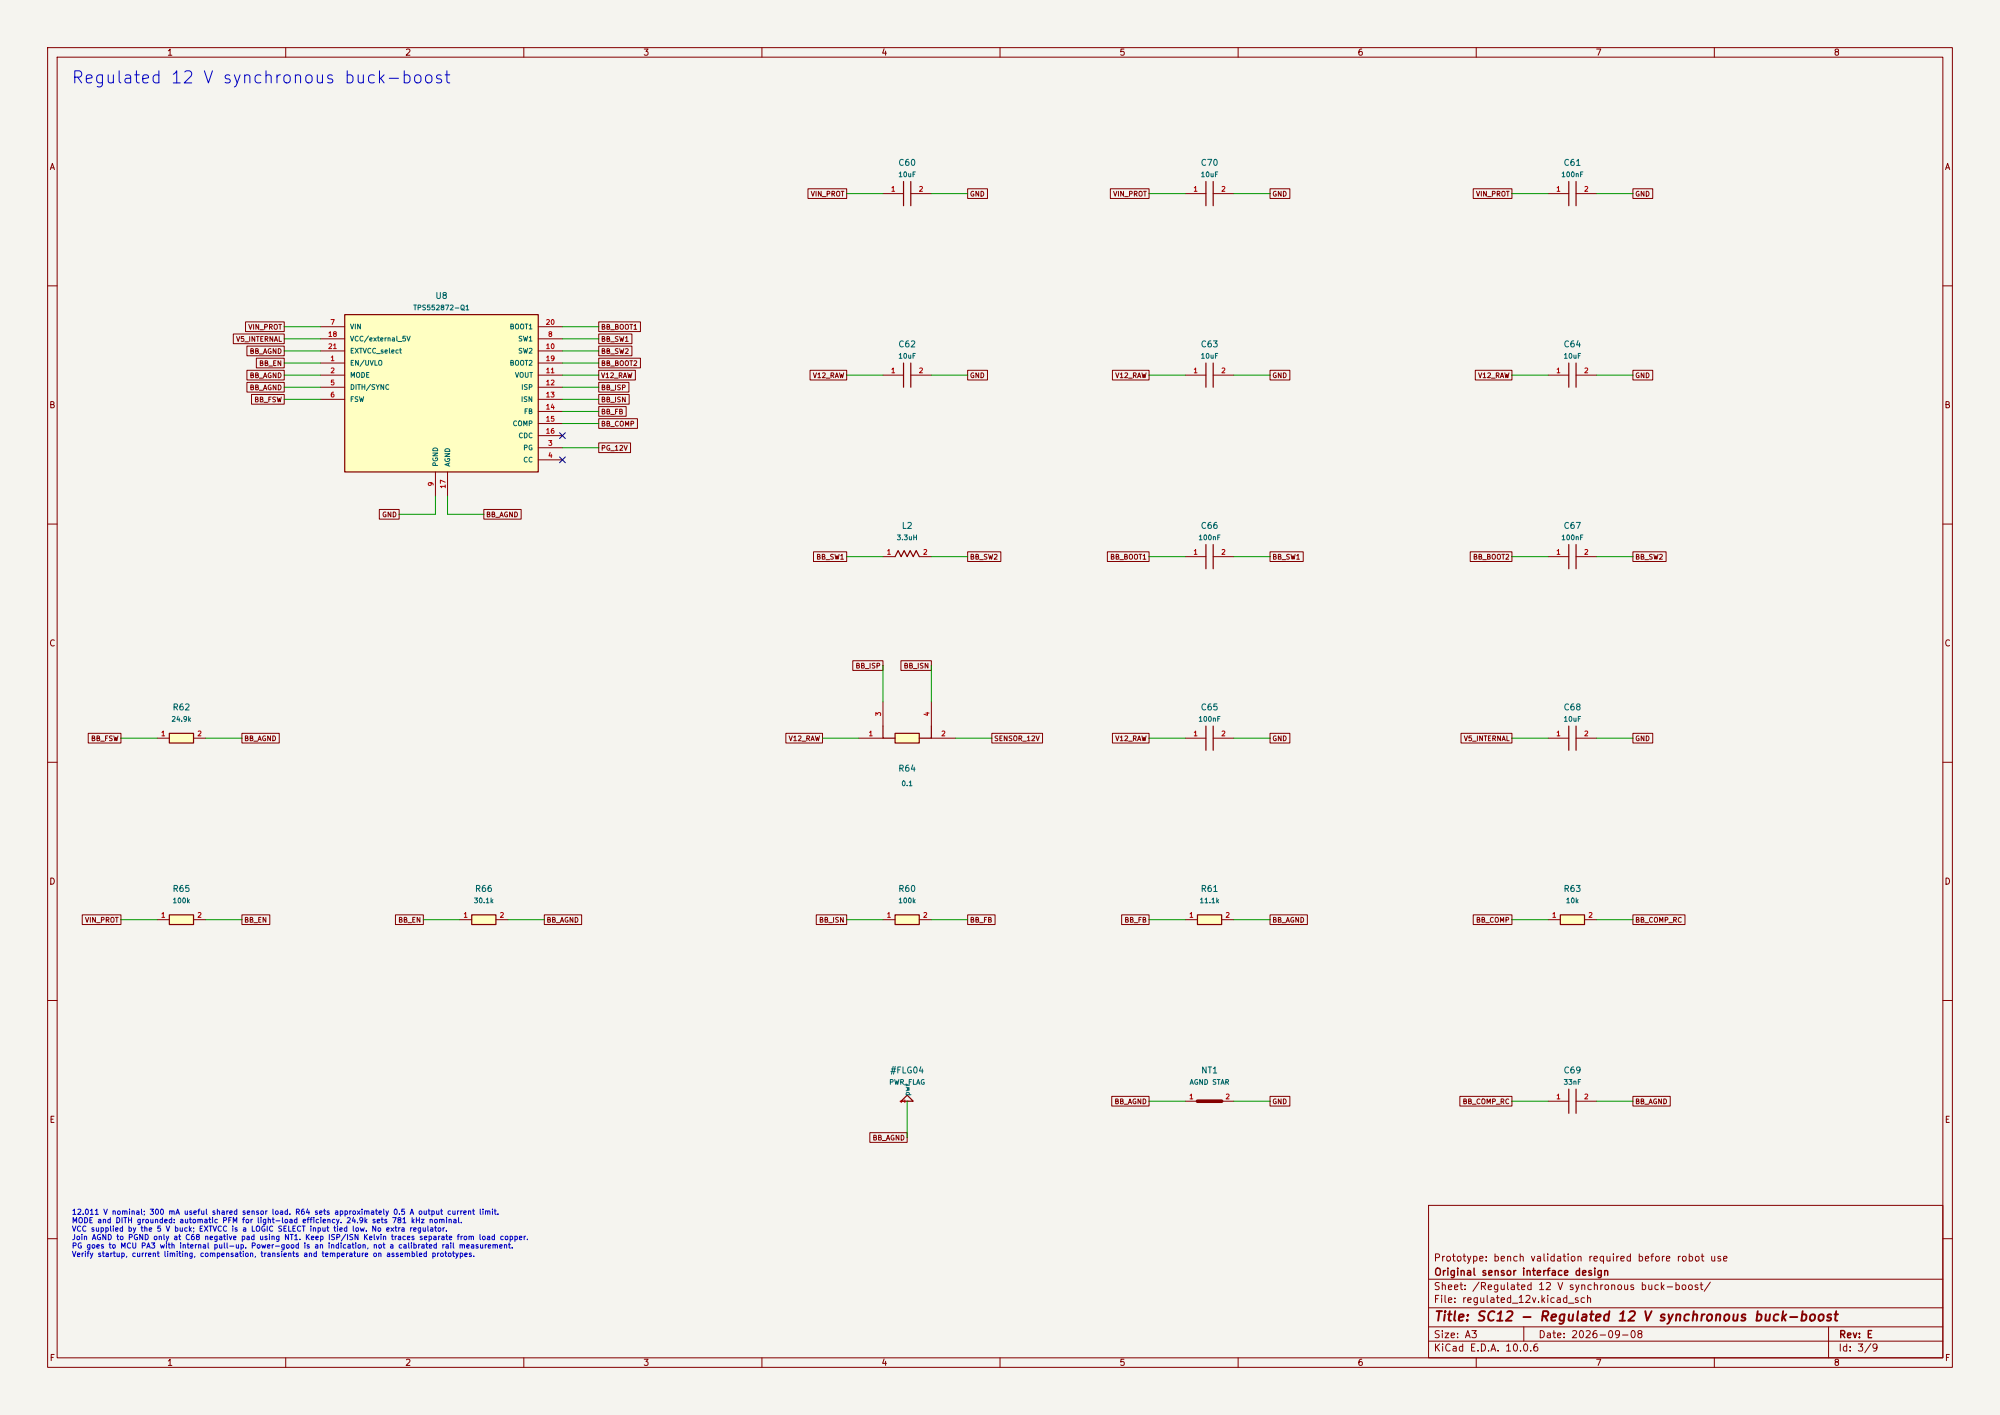
[picture p217: page 3]

BB_ISP Regulated 12 V synchronous buck-boost

12.011 V nominal; 300 mA useful shared sensor load. R64 sets approximately 0.5 A output current limit. MODE and DITH grounded: automatic PFM for light-load efficiency. 24.9k sets 781 kHz nominal. VCC supplied by the 5 V buck; EXTVCC is a LOGIC SELECT input tied low. No extra regulator. Join AGND to PGND only at C68 negative pad using NT1. Keep ISP/ISN Kelvin traces separate from load copper. PG goes to MCU PA3 with internal pull-up. Power-good is an indication, not a calibrated rail measurement. Verify startup, current limiting, compensation, transients and temperature on assembled prototypes.

Prototype: bench validation required before robot use
Original sensor interface design
Sheet: /Regulated 12 V synchronous buck-boost/
File: regulated_12v.kicad_sch
Title: SC12 - Regulated 12 V synchronous buck-boost

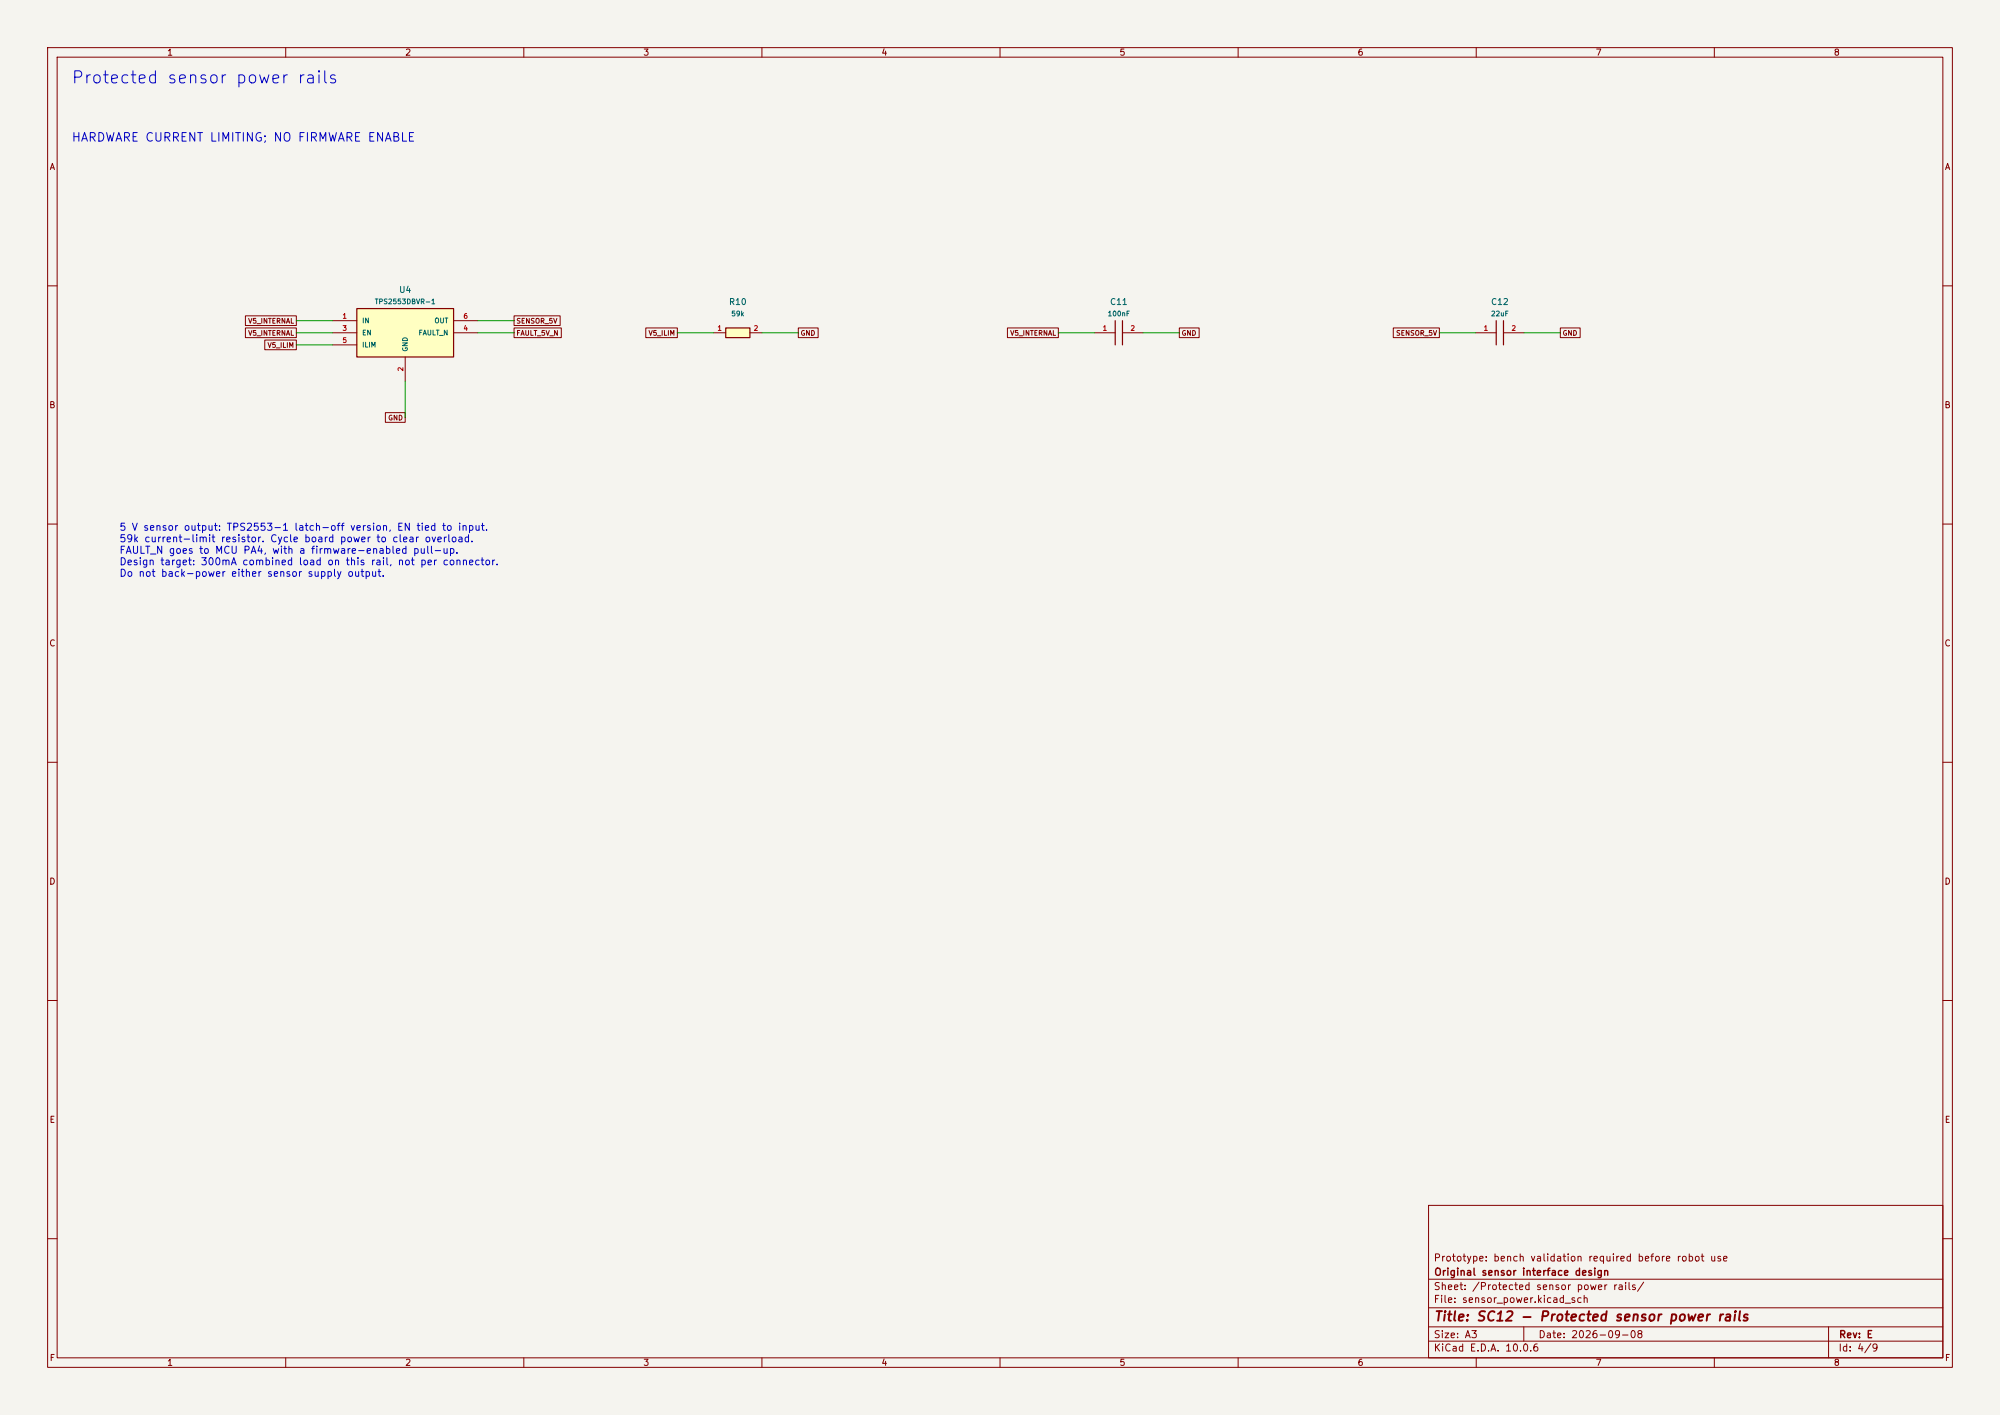
[picture p218: page 4]

Protected sensor power rails

HARDWARE CURRENT LIMITING; NO FIRMWARE ENABLE

V5_ILIM 5 V sensor output: TPS2553-1 latch-off version, EN tied to input.

59k current-limit resistor. Cycle board power to clear overload.
FAULT_N goes to MCU PA4, with a firmware-enabled pull-up.
Design target: 300mA combined load on this rail, not per connector.
Do not back-power either sensor supply output.

Prototype: bench validation required before robot use
Original sensor interface design
Sheet: /Protected sensor power rails/
File: sensor_power.kicad_sch
Title: SC12 - Protected sensor power rails

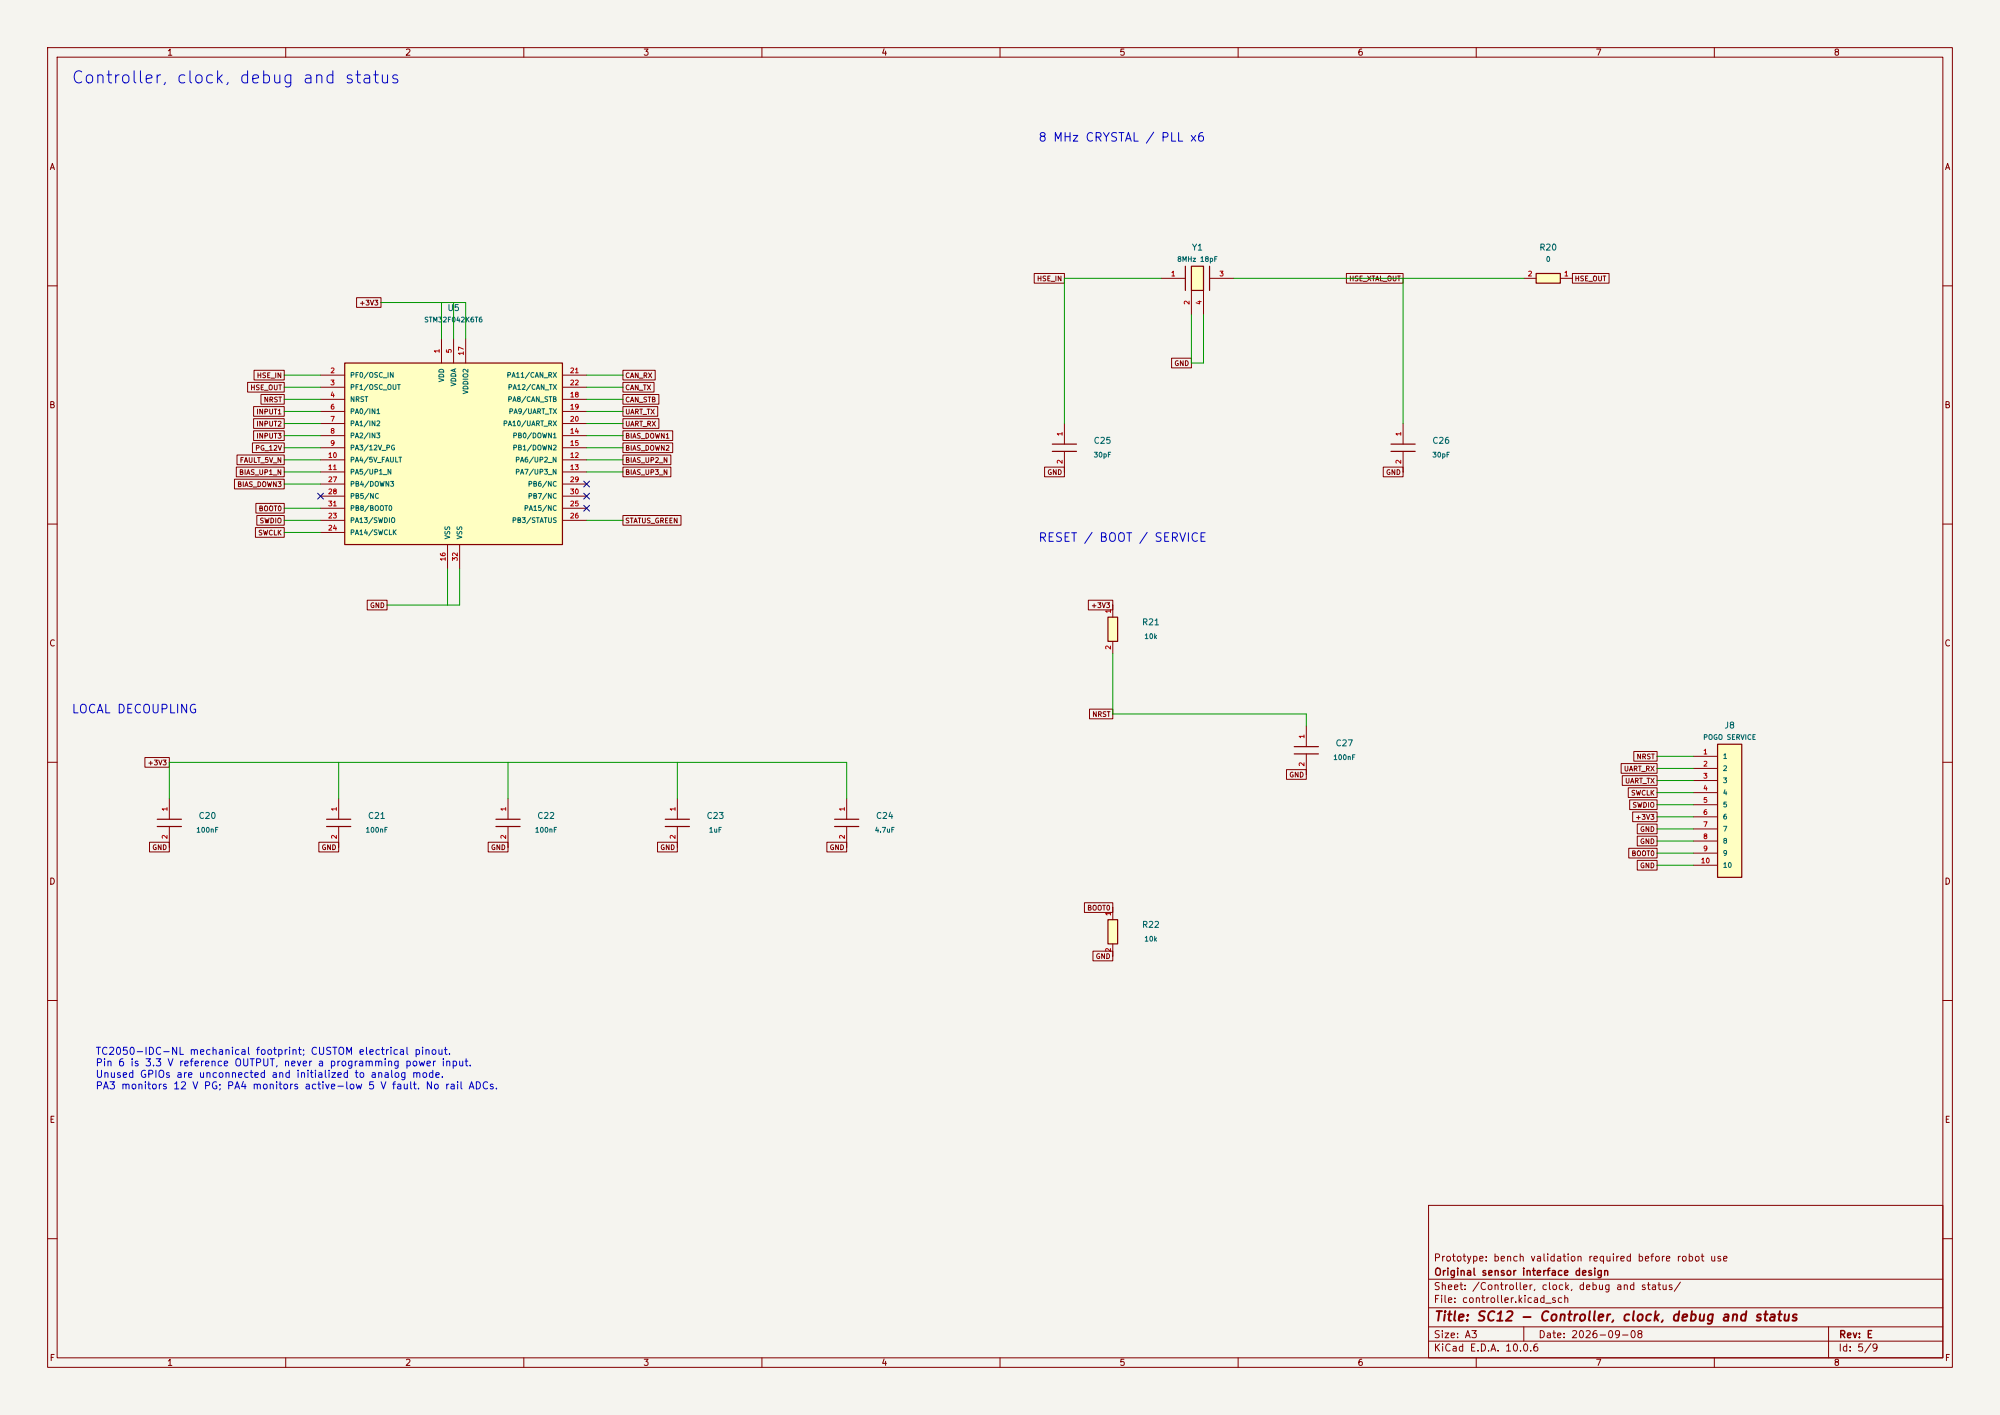
[picture p219: page 5]

Controller, clock, debug and status

1 PF0/OSC_IN 2 PF1/OSC_OUT 3 NRST 4 VDDA 5 PA0/IN1 6 PA1/IN2 7 PA2/IN3 8 PA3/12V_PG 9 PA4/5V_FAULT 10 PA5/UP1_N 11 PA6/UP2_N 12 PA7/UP3_N 13 PB0/DOWN1 14 PB1/DOWN2 15 VSS 16 VDDIO2 17 PA8/CAN_STB 18 PA9/UART_TX 19 PA10/UART_RX 20 PA11/CAN_RX 21 PA12/CAN_TX 22 PA13/SWDIO 23 PA14/SWCLK 24 PA15/NC 25 PB3/STATUS 26 PB4/DOWN3 27 PB5/NC 28 PB6/NC 29 PB7/NC 30 PB8/BOOT0 31 VSS 32 U5

HSE_IN +3V3 TC2050-IDC-NL mechanical footprint; CUSTOM electrical pinout.

Pin 6 is 3.3 V reference OUTPUT, never a programming power input.
Unused GPIOs are unconnected and initialized to analog mode.
PA3 monitors 12 V PG; PA4 monitors active-low 5 V fault. No rail ADCs.

Prototype: bench validation required before robot use
Original sensor interface design
Sheet: /Controller, clock, debug and status/
File: controller.kicad_sch
Title: SC12 - Controller, clock, debug and status

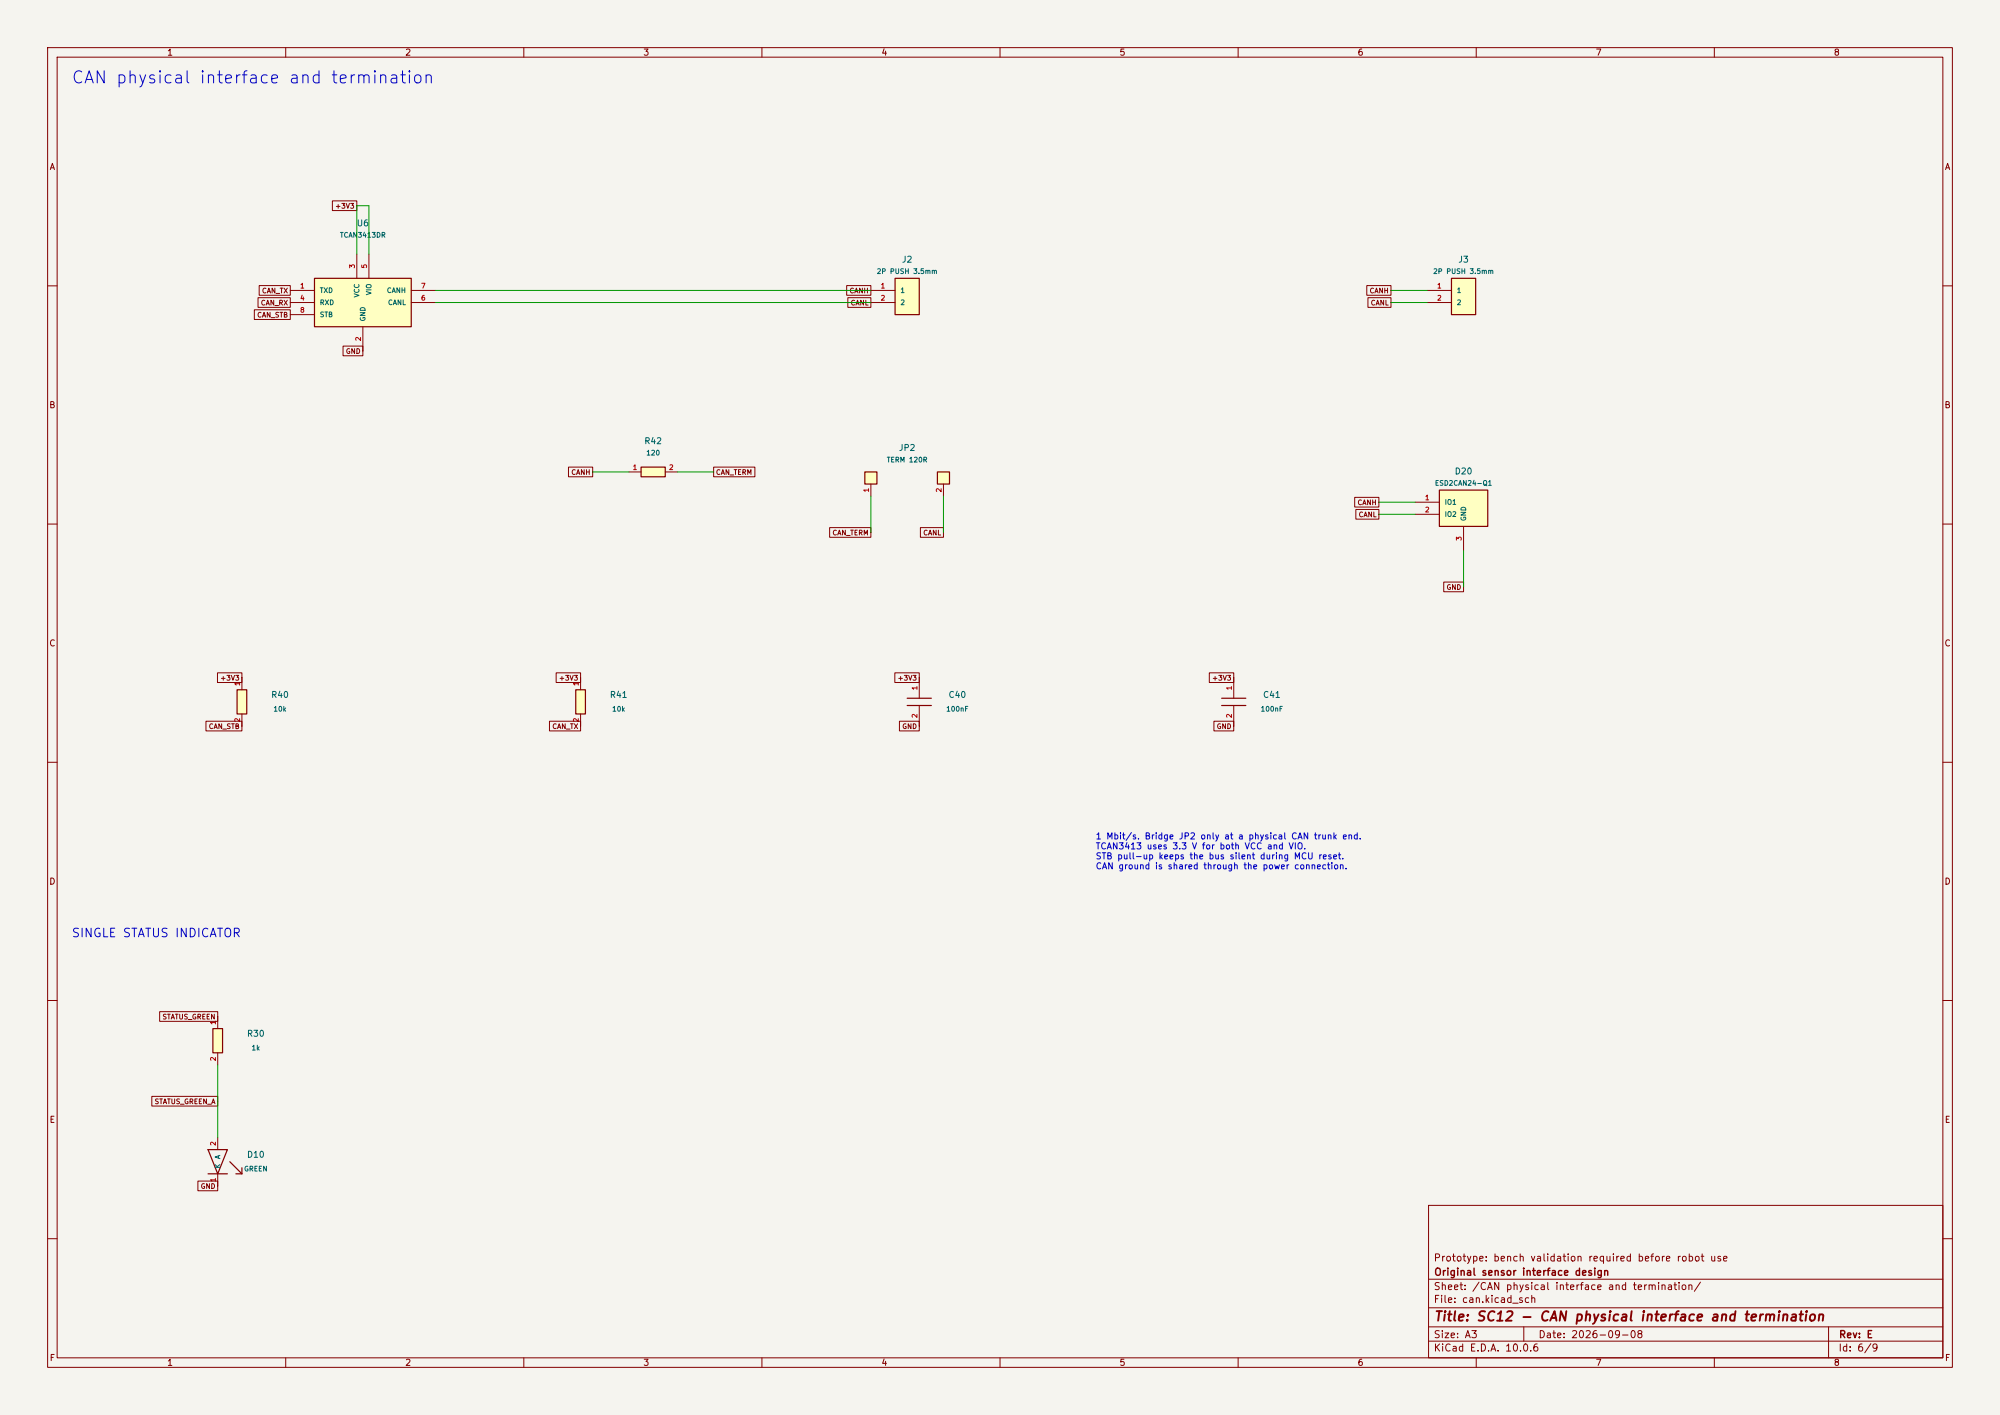
[picture p220: page 6]

Prototype: bench validation required before robot use
Original sensor interface design
Sheet: /CAN physical interface and termination/
File: can.kicad_sch
Title: SC12 - CAN physical interface and termination

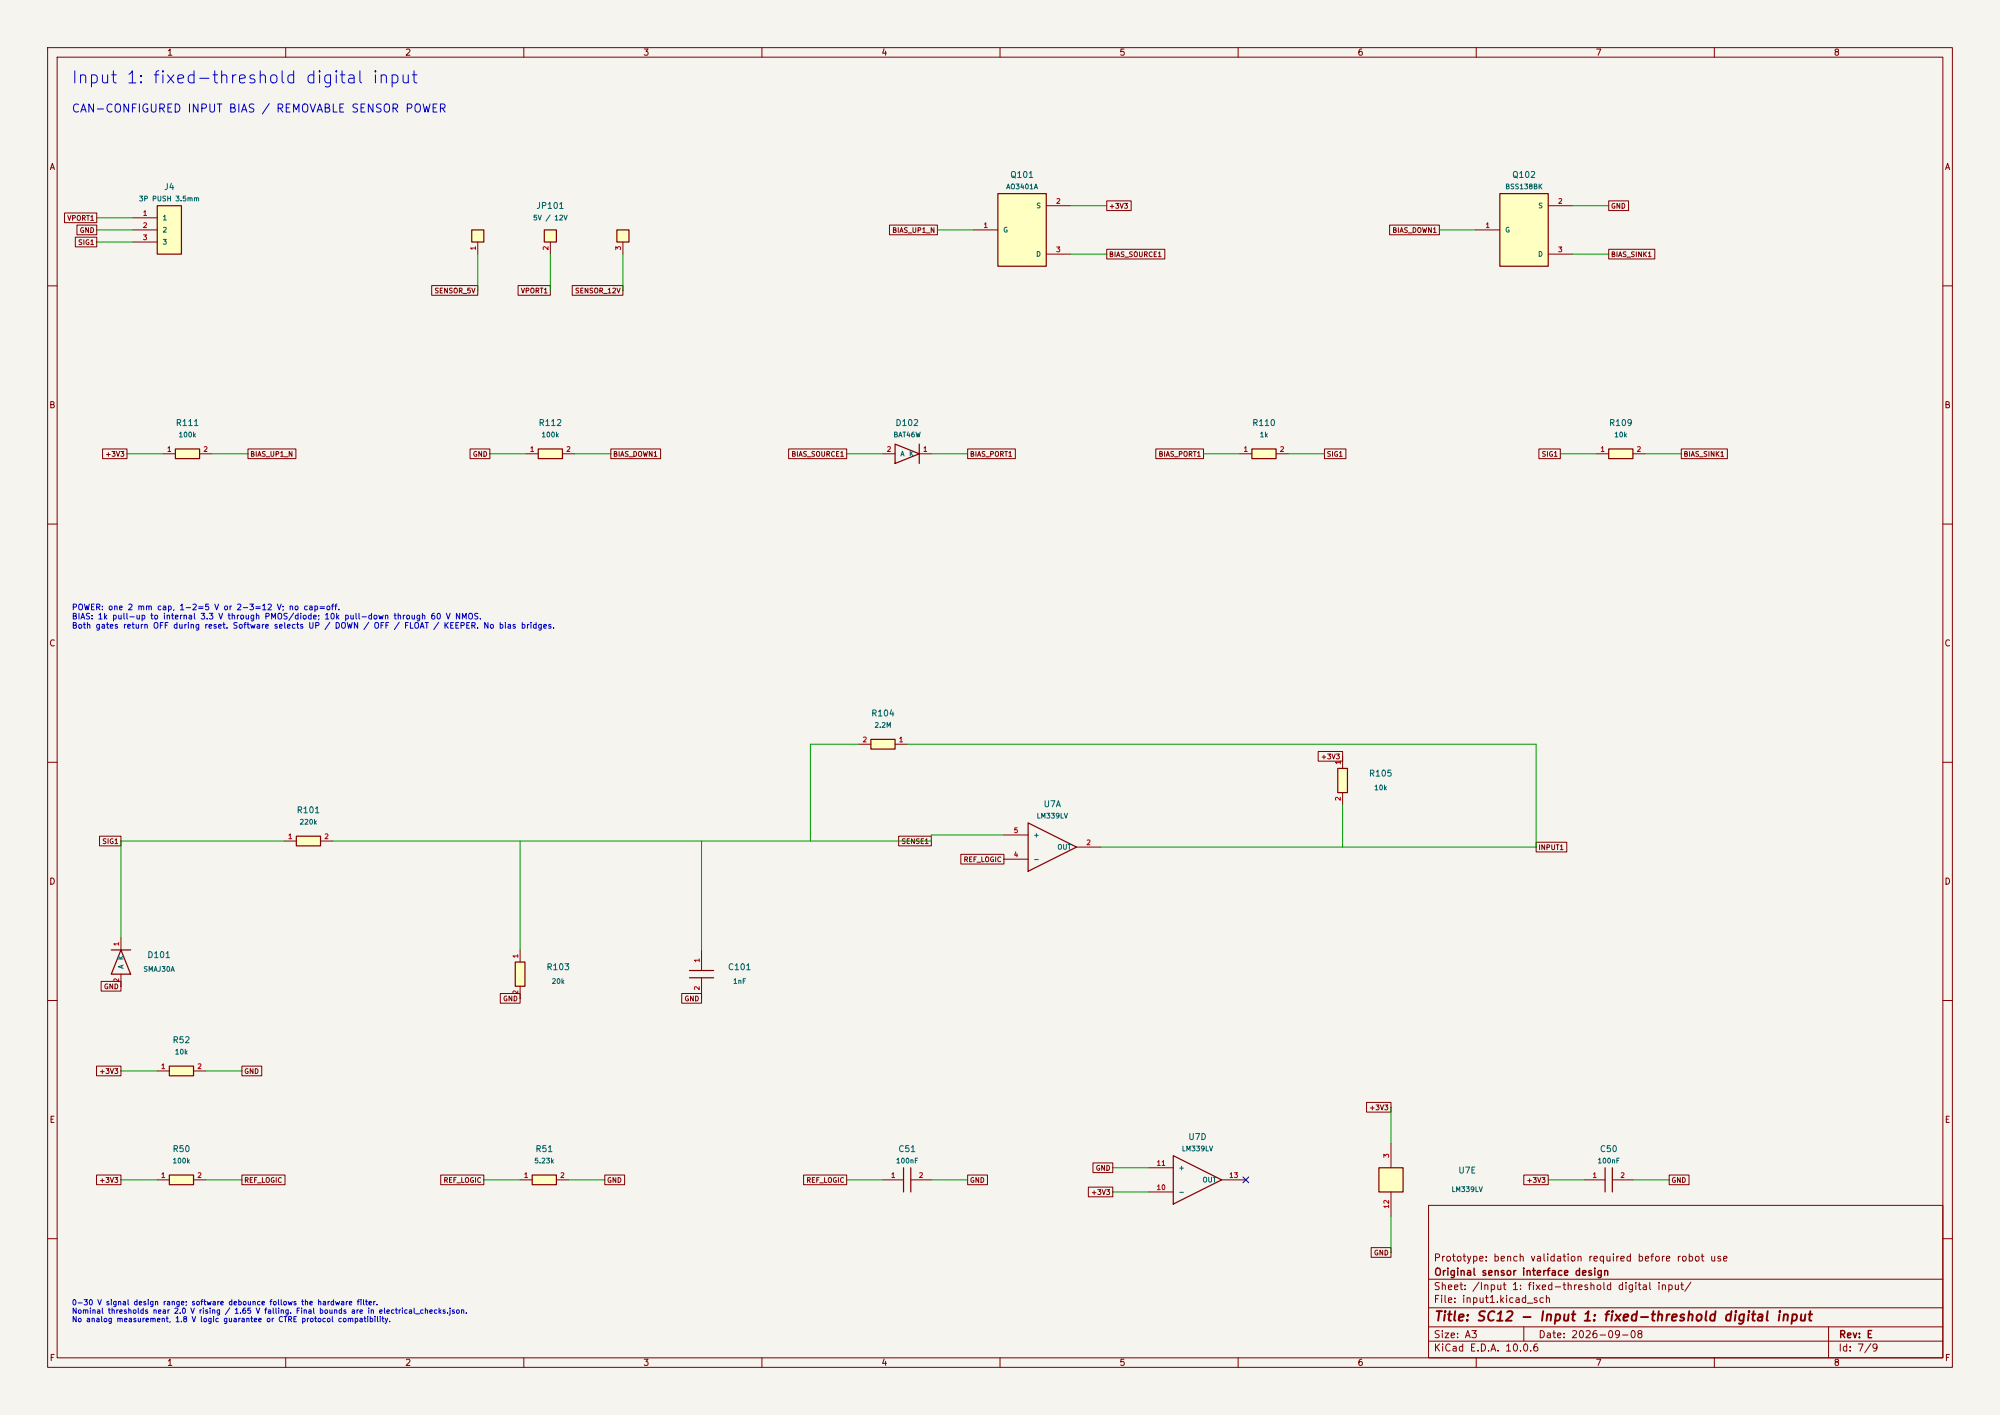
[picture p221: page 7]

Input 1: fixed-threshold digital input

BIAS_PORT1 CAN-CONFIGURED INPUT BIAS / REMOVABLE SENSOR POWER

POWER: one 2 mm cap, 1-2=5 V or 2-3=12 V; no cap=off. BIAS: 1k pull-up to internal 3.3 V through PMOS/diode; 10k pull-down through 60 V NMOS. Both gates return OFF during reset. Software selects UP / DOWN / OFF / FLOAT / KEEPER. No bias bridges.

Prototype: bench validation required before robot use
Original sensor interface design
Sheet: /Input 1: fixed-threshold digital input/
File: input1.kicad_sch
Title: SC12 - Input 1: fixed-threshold digital input

0-30 V signal design range; software debounce follows the hardware filter. Nominal thresholds near 2.0 V rising / 1.65 V falling. Final bounds are in electrical_checks.json. No analog measurement, 1.8 V logic guarantee or CTRE protocol compatibility.

BSS138BK; SMAJ30A; BAT46W; OUT; 3P PUSH 3.5mm; BIAS_UP2_N; VPORT2; BIAS_SOURCE2; BIAS_SINK2; GND; SIG2; REF_LOGIC; SIG2 +3V3; BIAS_SINK2 GND; SENSE2 +3V3; +3V3 BIAS_UP2_N; INPUT2; BIAS_DOWN2; BIAS_PORT2

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
# Title: SC12 - Input 2: fixed-threshold digital input

## File: input2.kicad_sch

## Sheet: /Input 2: fixed-threshold digital input/

## Original sensor interface design

## Prototype: bench validation required before robot use

SENSOR_5V | SENSOR_12V | BIAS_SOURCE2 | BIAS_PORT2 POWER: one 2 mm cap, 1-2=5 V or 2-3=12 V; no cap=off. BIAS: 1k pull-up to internal 3.3 V through PMOS/diode; 10k pull-down through 60 V NMOS. Both gates return OFF during reset. Software selects UP / DOWN / OFF / FLOAT / KEEPER. No bias bridges.

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

The reference divider/filter and comparator power connections are on input1.
One fixed logic-compatible threshold for all three channels; no industrial threshold selector.

# Input 2: fixed-threshold digital input

## CAN-CONFIGURED INPUT BIAS / REMOVABLE SENSOR POWER

BSS138BK; SMAJ30A; BAT46W; OUT; 3P PUSH 3.5mm; BIAS_UP3_N; VPORT3; BIAS_SOURCE3; BIAS_SINK3; GND; SIG3; REF_LOGIC; SIG3 +3V3; BIAS_SINK3 GND; SENSE3 +3V3; +3V3 BIAS_UP3_N; INPUT3; BIAS_DOWN3; BIAS_PORT3

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
# Title: SC12 - Input 3: fixed-threshold digital input

## File: input3.kicad_sch

## Sheet: /Input 3: fixed-threshold digital input/

## Original sensor interface design

## Prototype: bench validation required before robot use

SENSOR_5V | SENSOR_12V | BIAS_SOURCE3 | BIAS_PORT3 POWER: one 2 mm cap, 1-2=5 V or 2-3=12 V; no cap=off. BIAS: 1k pull-up to internal 3.3 V through PMOS/diode; 10k pull-down through 60 V NMOS. Both gates return OFF during reset. Software selects UP / DOWN / OFF / FLOAT / KEEPER. No bias bridges.

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

# Input 3: fixed-threshold digital input

## CAN-CONFIGURED INPUT BIAS / REMOVABLE SENSOR POWER
