barkinvar/sugerCANe/rev_d2/output/assembly/bottom_markings.pdf

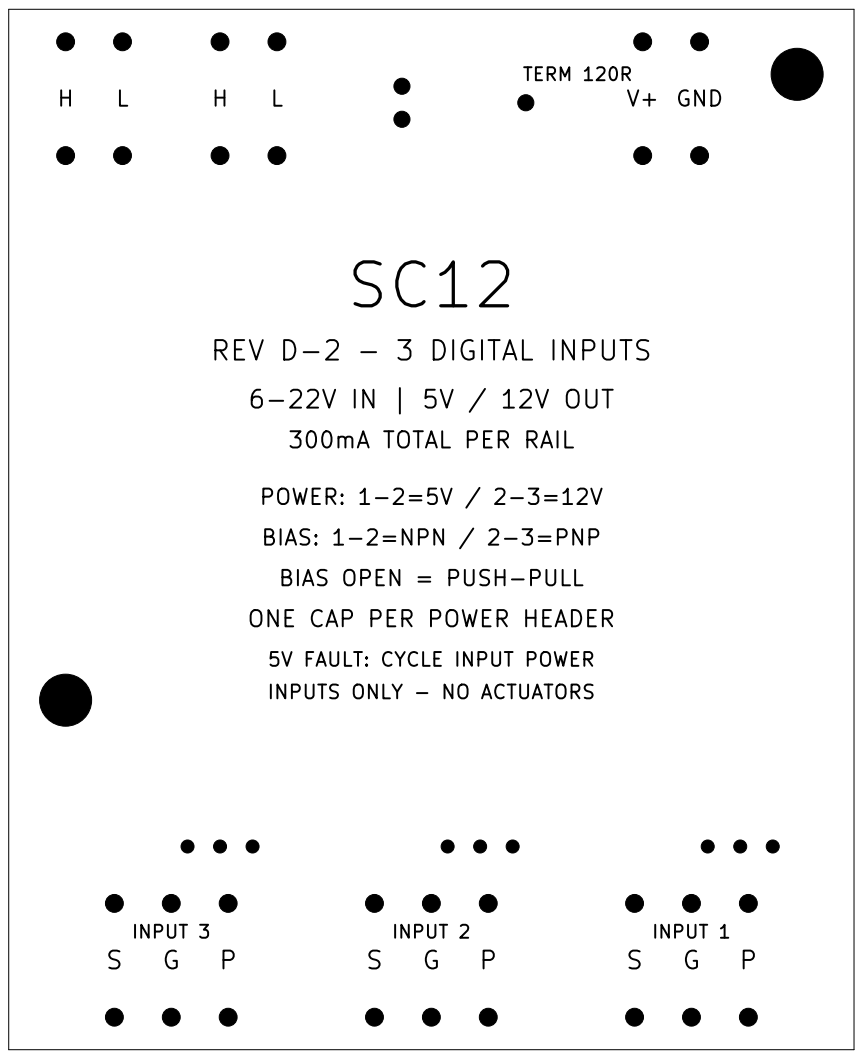
[picture p222: page 1]

POWER: 1-2=5V / 2-3=12V
BIAS: 1-2=NPN / 2-3=PNP
BIAS OPEN = PUSH-PULL

ONE CAP PER POWER HEADER

5V FAULT: CYCLE INPUT POWER
INPUTS ONLY - NO ACTUATORS
