barkinvar/sugerCANe/rev_d2/output/assembly/gerber_copper_review.pdf

## FRC Sensor CAN · Rev D-2 SC12 · TOP copper

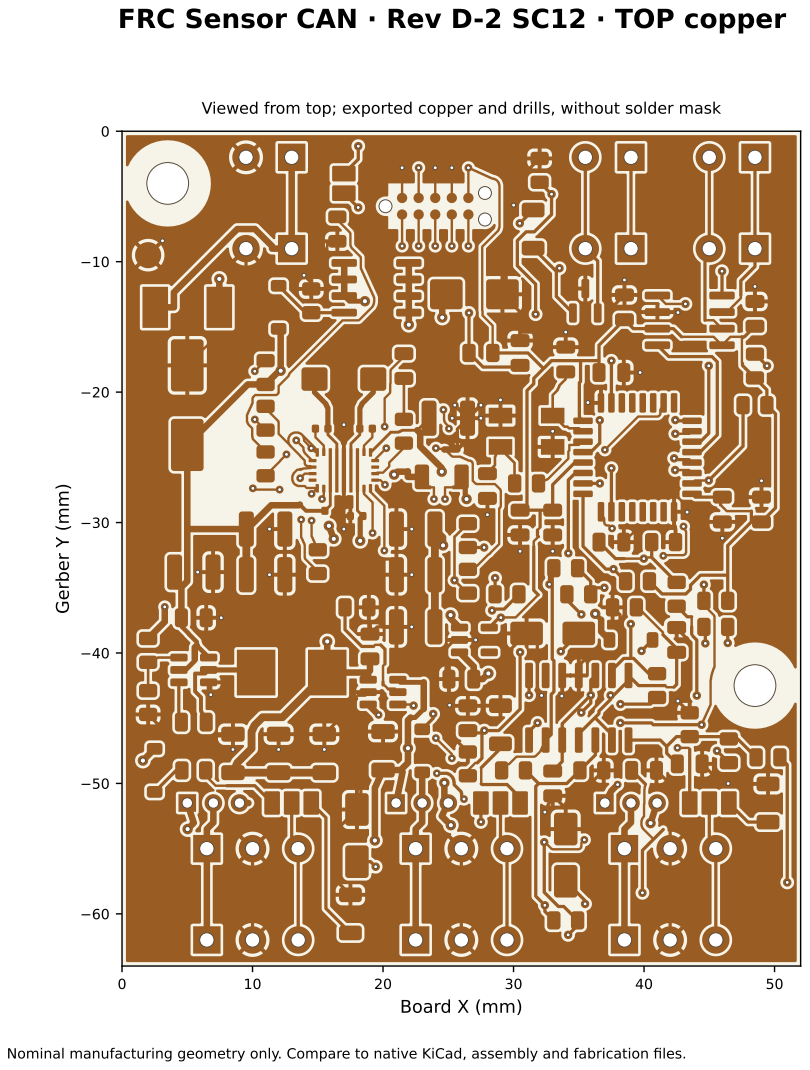
[picture p223: page 1]
Board X (mm); Gerber Y (mm)

Viewed from top; exported copper and drills, without solder mask

Nominal manufacturing geometry only. Compare to native KiCad, assembly and fabrication files.

## FRC Sensor CAN · Rev D-2 SC12 · BOTTOM copper

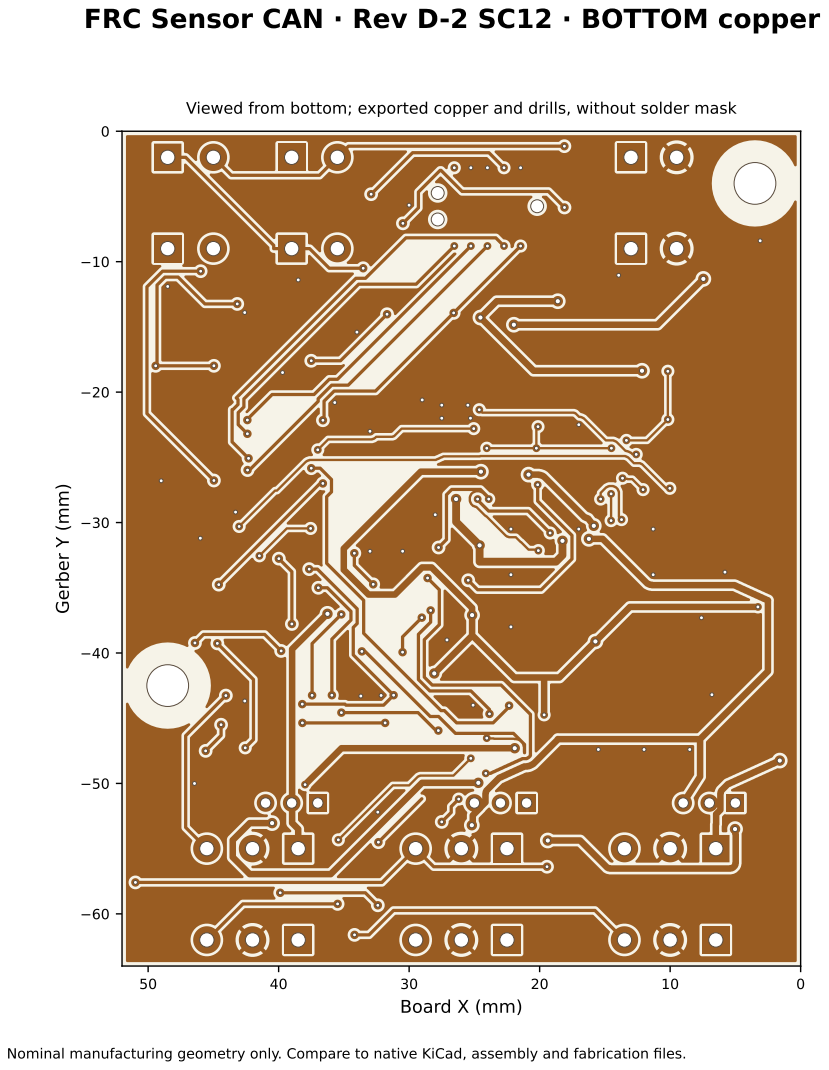
[picture p224: page 2]
Board X (mm); Gerber Y (mm)

Viewed from bottom; exported copper and drills, without solder mask

Nominal manufacturing geometry only. Compare to native KiCad, assembly and fabrication files.
