barkinvar/sugerCANe/rev_c/output/assembly/bottom_markings.pdf

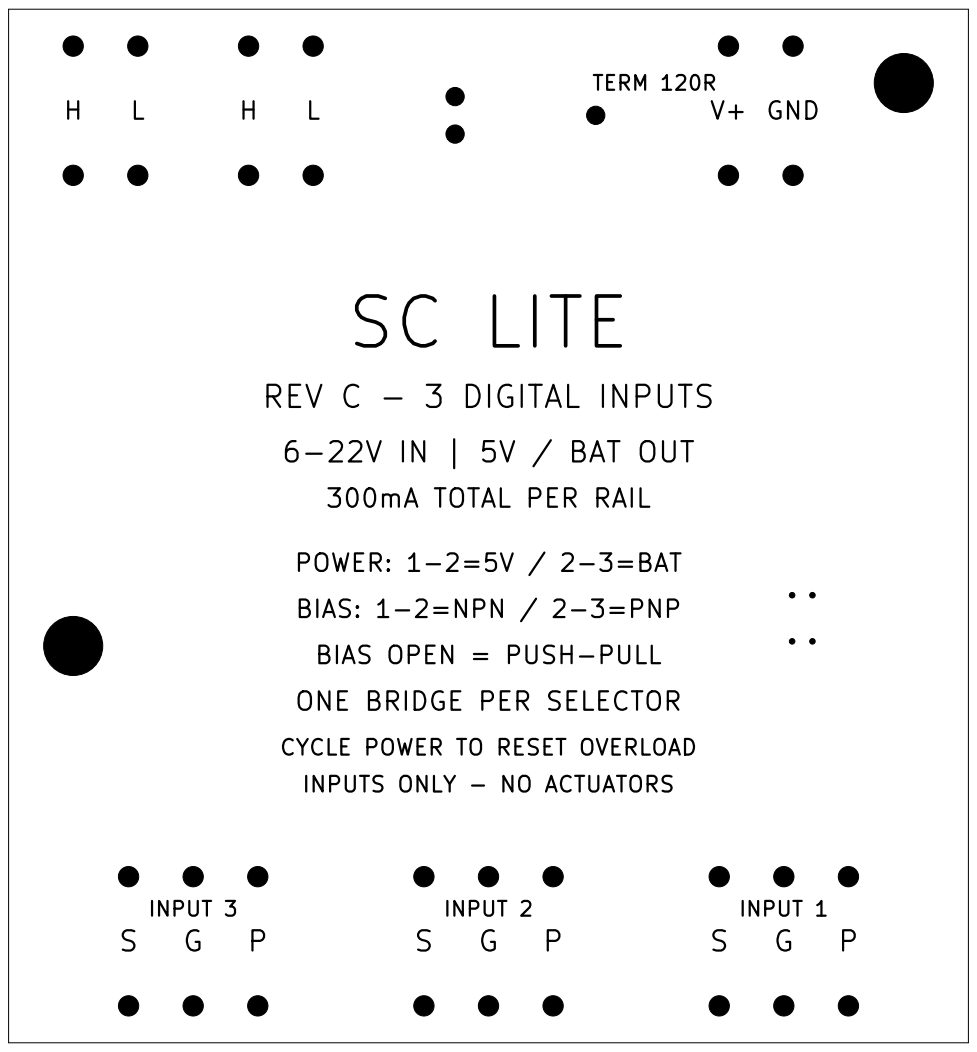
[picture p245: page 1]

POWER: 1-2=5V / 2-3=BAT
BIAS: 1-2=NPN / 2-3=PNP
BIAS OPEN = PUSH-PULL

ONE BRIDGE PER SELECTOR

CYCLE POWER TO RESET OVERLOAD
INPUTS ONLY - NO ACTUATORS
