barkinvar/sugerCANe/rev_c/output/assembly/schematic.pdf

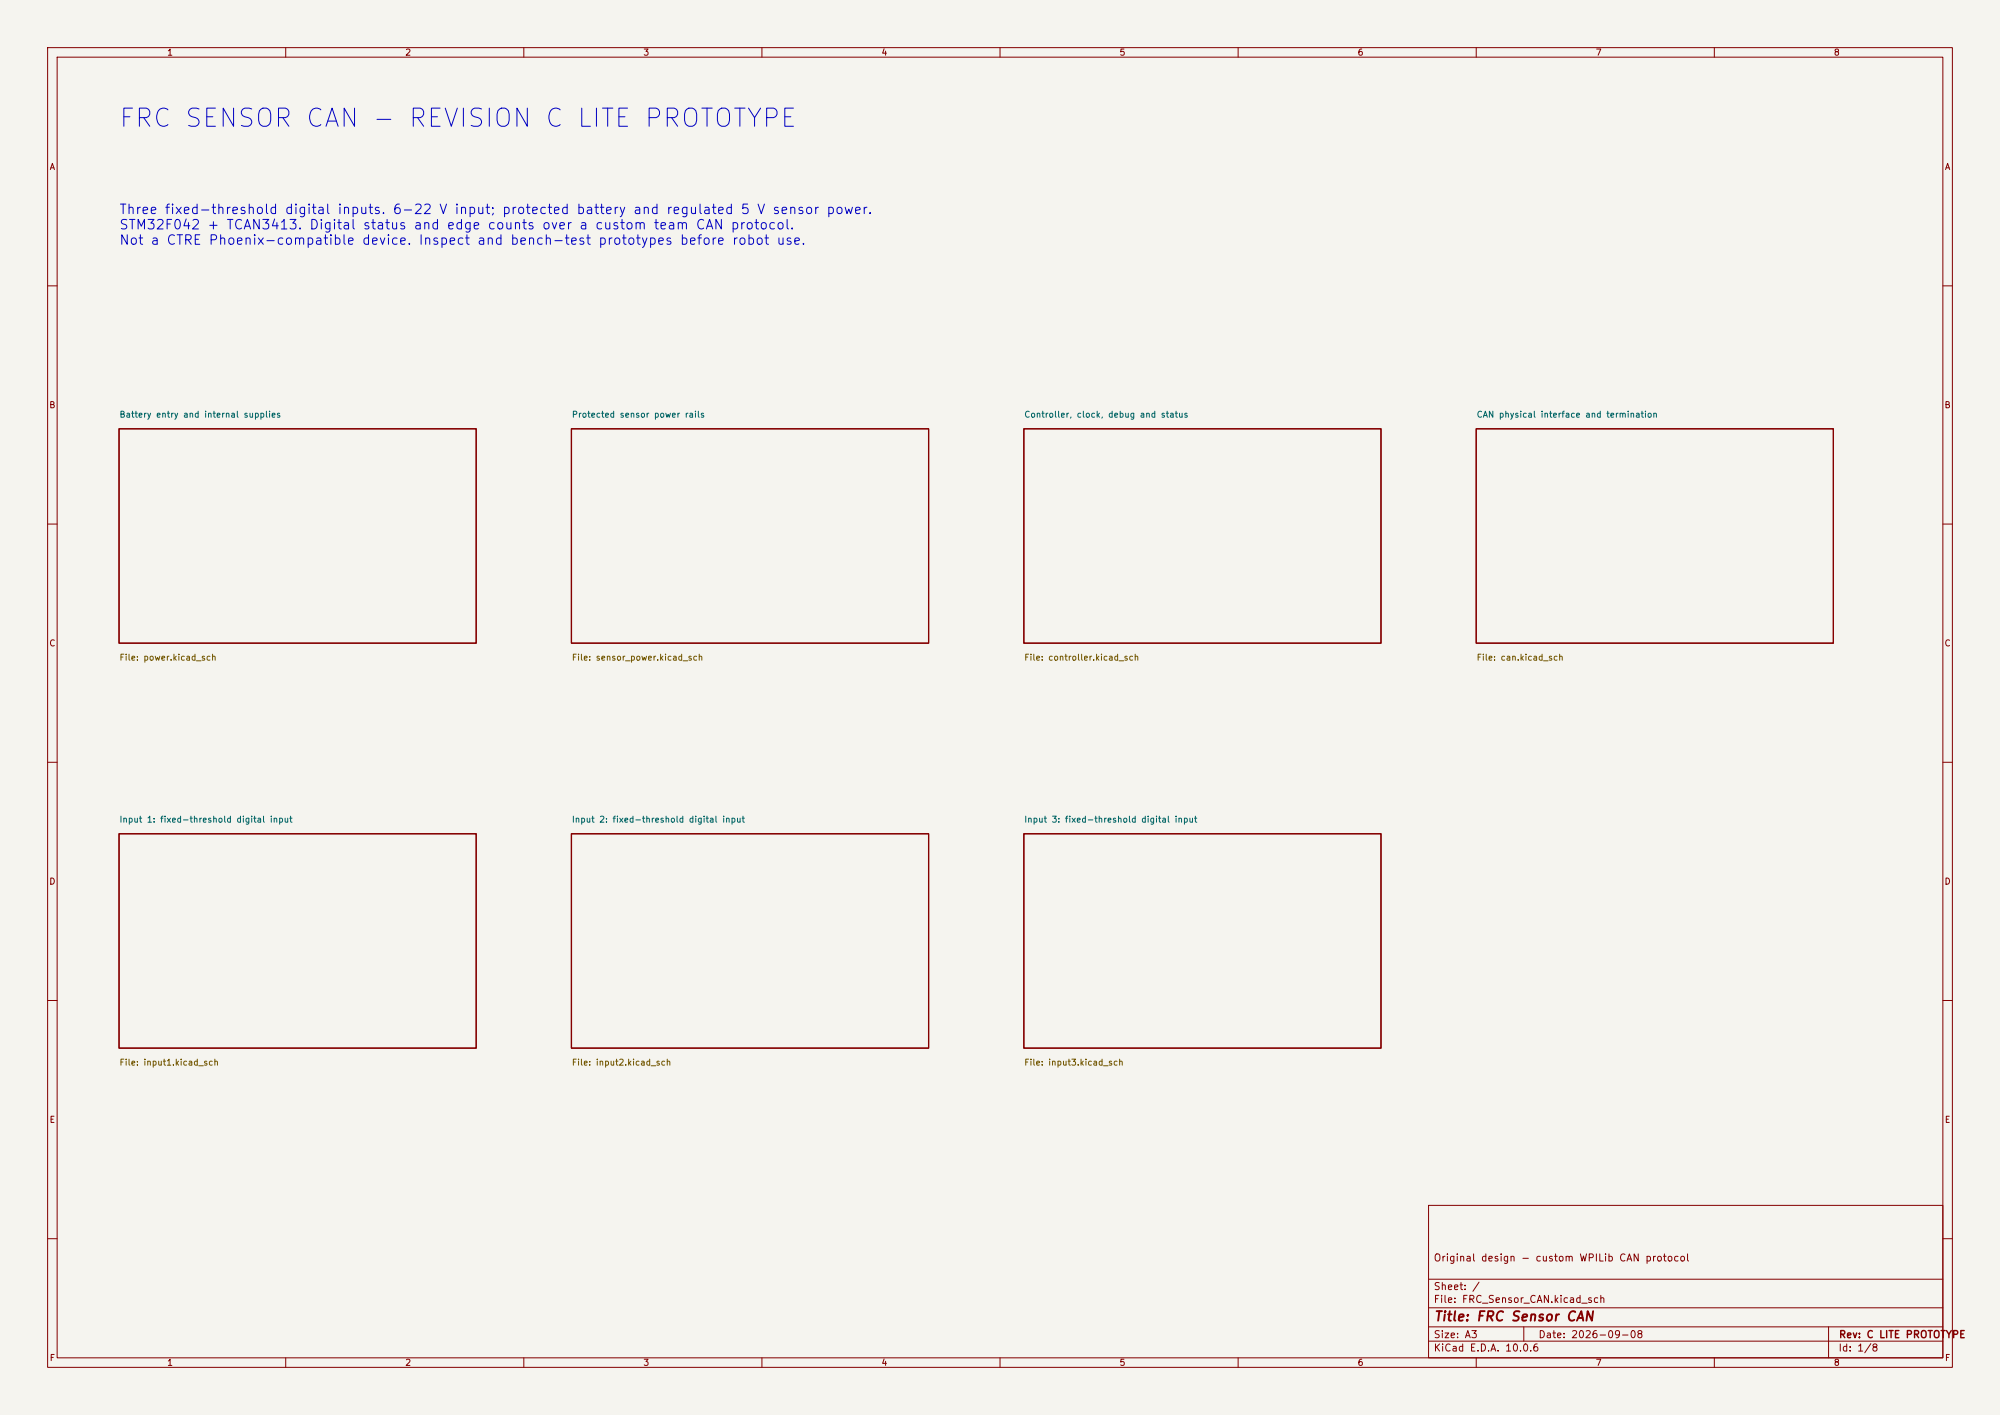
[picture p248: page 1]

FRC SENSOR CAN - REVISION C LITE PROTOTYPE

Three fixed-threshold digital inputs. 6-22 V input; protected battery and regulated 5 V sensor power.
STM32F042 + TCAN3413. Digital status and edge counts over a custom team CAN protocol.
Not a CTRE Phoenix-compatible device. Inspect and bench-test prototypes before robot use.

Battery entry and internal supplies File: power.kicad_sch

Protected sensor power rails File: sensor_power.kicad_sch

Input 1: fixed-threshold digital input File: input1.kicad_sch

Input 2: fixed-threshold digital input File: input2.kicad_sch

Input 3: fixed-threshold digital input File: input3.kicad_sch

Original design - custom WPILib CAN protocol

Sheet: /
File: FRC_Sensor_CAN.kicad_sch
Title: FRC Sensor CAN

F Date: 2026-09-08

KiCad E.D.A. 10.0.6 | Id: 1/8

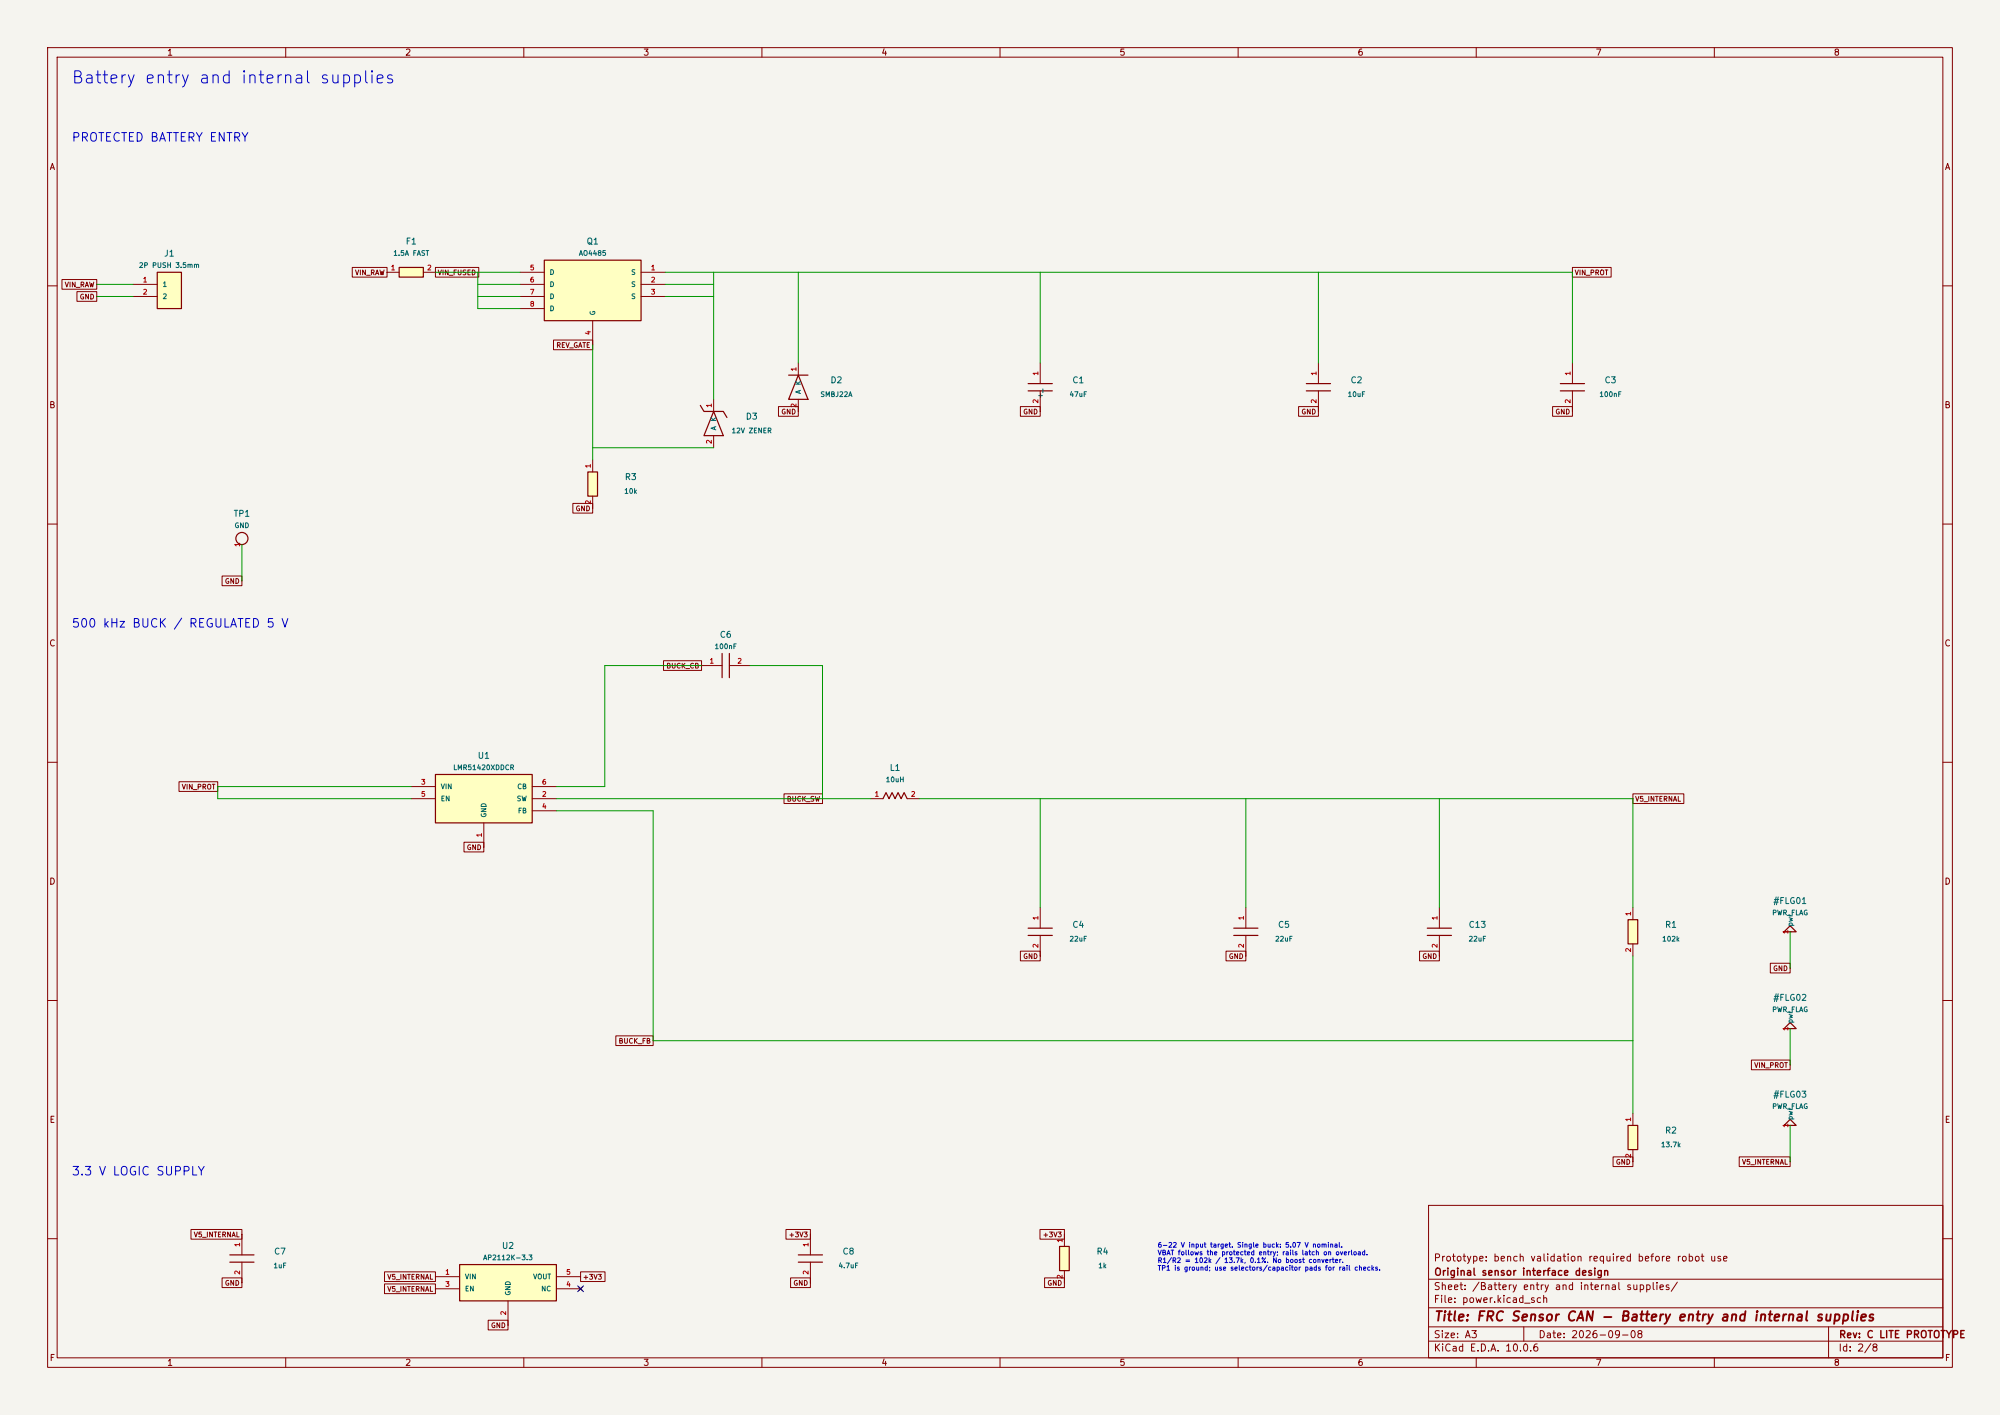
[picture p249: page 2]

Battery entry and internal supplies

6-22 V input target. Single buck: 5.07 V nominal. VBAT follows the protected entry; rails latch on overload. R1/R2 = 102k / 13.7k, 0.1%. No boost converter. TP1 is ground; use selectors/capacitor pads for rail checks.

Original sensor interface design
Sheet: /Battery entry and internal supplies/
File: power.kicad_sch
Title: FRC Sensor CAN - Battery entry and internal supplies

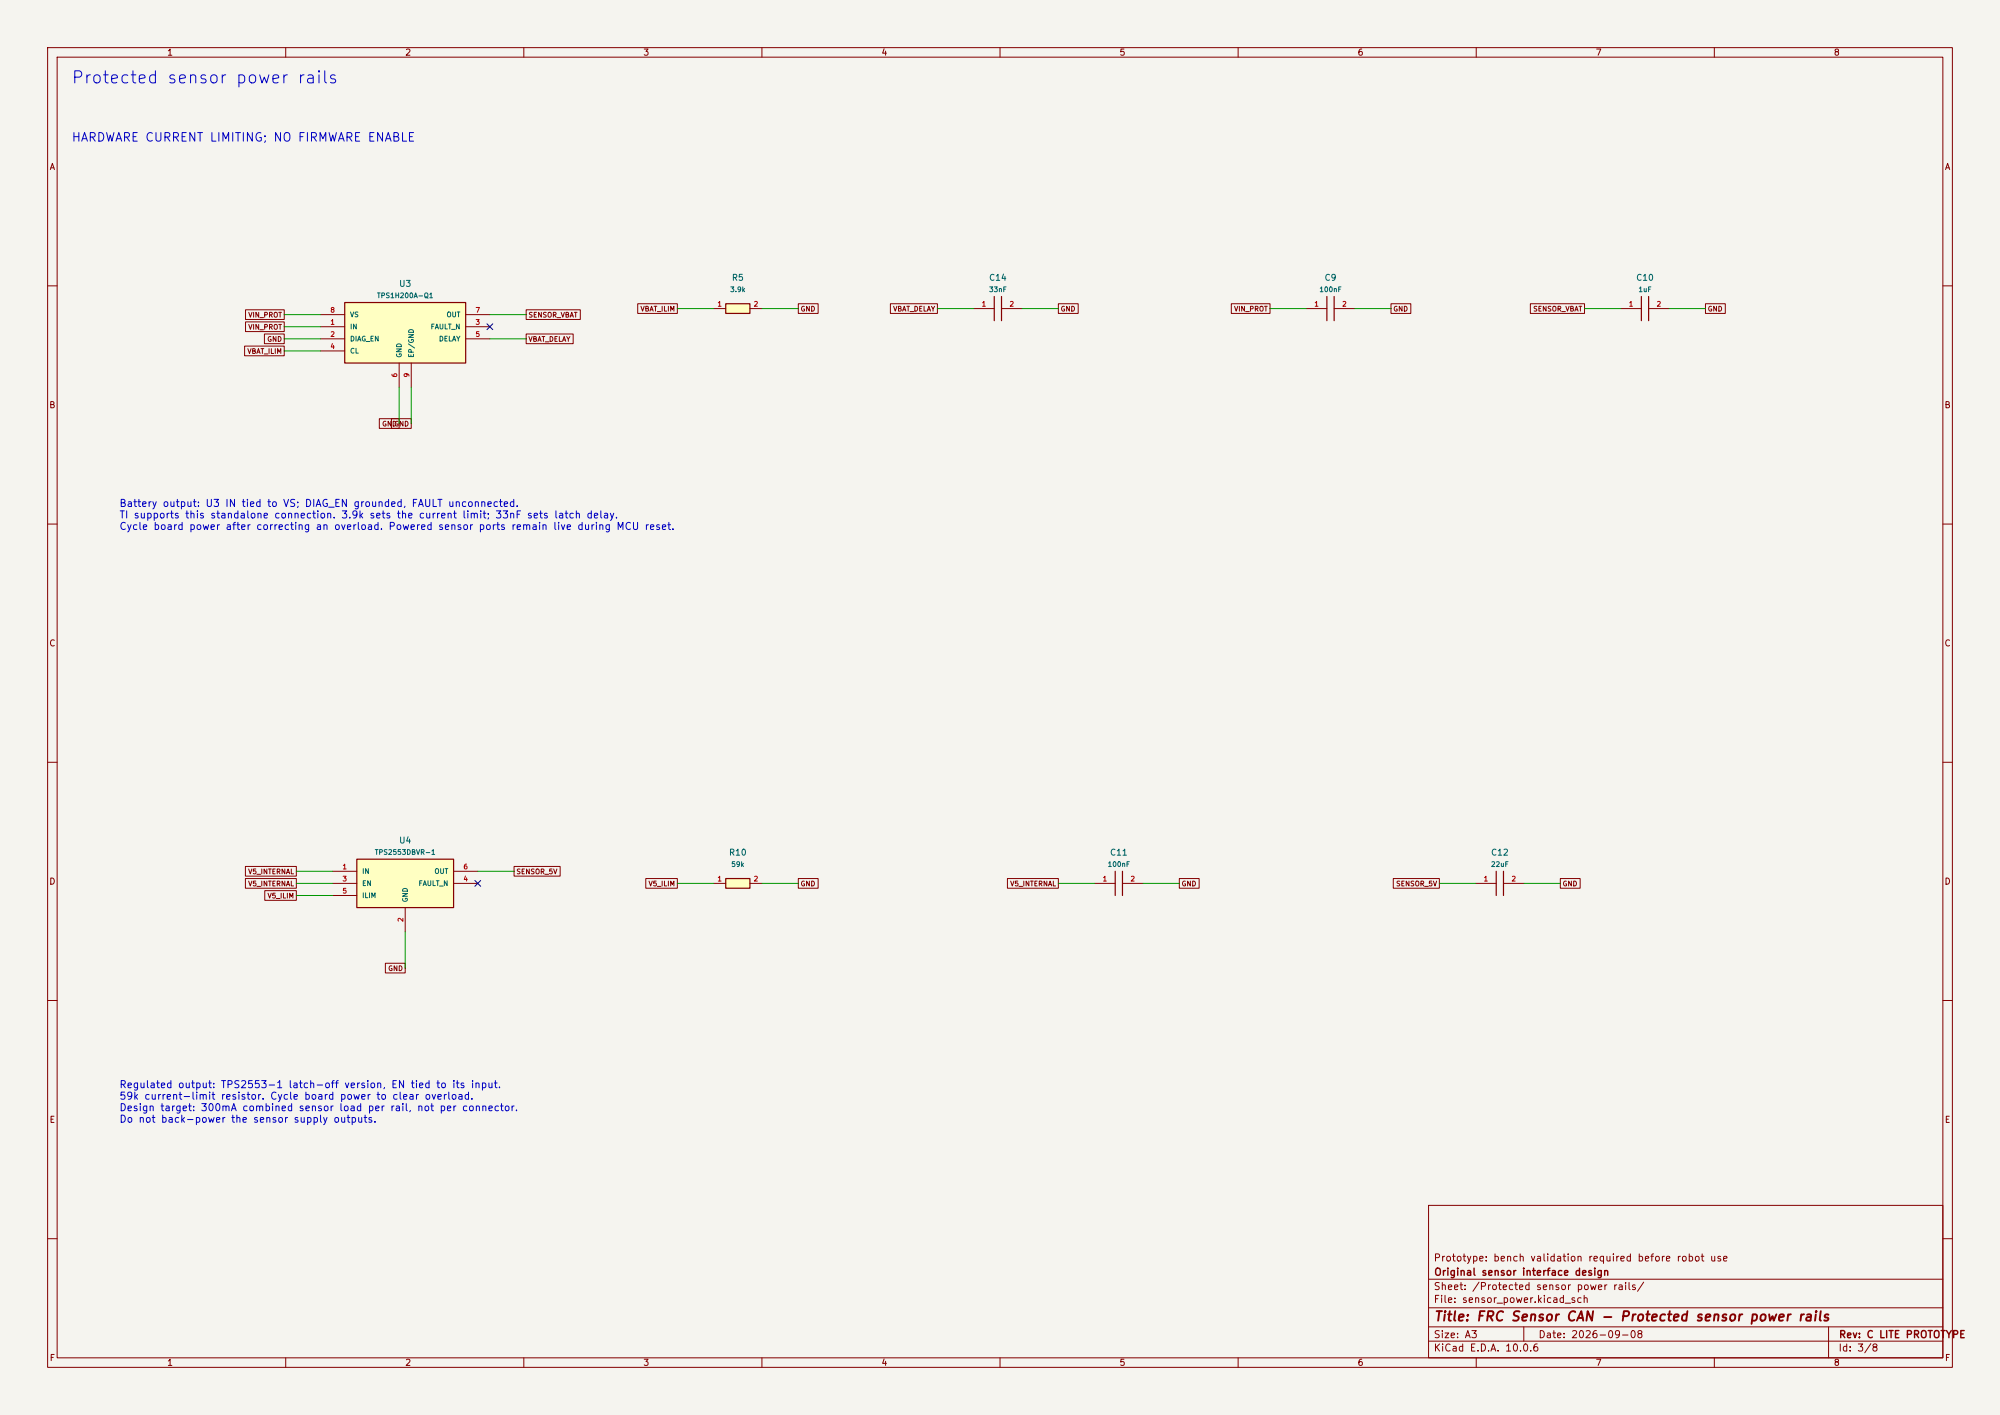
[picture p250: page 3]

Protected sensor power rails

HARDWARE CURRENT LIMITING; NO FIRMWARE ENABLE

SENSOR_5V Battery output: U3 IN tied to VS; DIAG_EN grounded, FAULT unconnected.
TI supports this standalone connection. 3.9k sets the current limit; 33nF sets latch delay.
Cycle board power after correcting an overload. Powered sensor ports remain live during MCU reset.

Regulated output: TPS2553-1 latch-off version, EN tied to its input.
59k current-limit resistor. Cycle board power to clear overload.
Design target: 300mA combined sensor load per rail, not per connector.
Do not back-power the sensor supply outputs.

Prototype: bench validation required before robot use
Original sensor interface design
Sheet: /Protected sensor power rails/
File: sensor_power.kicad_sch
Title: FRC Sensor CAN - Protected sensor power rails

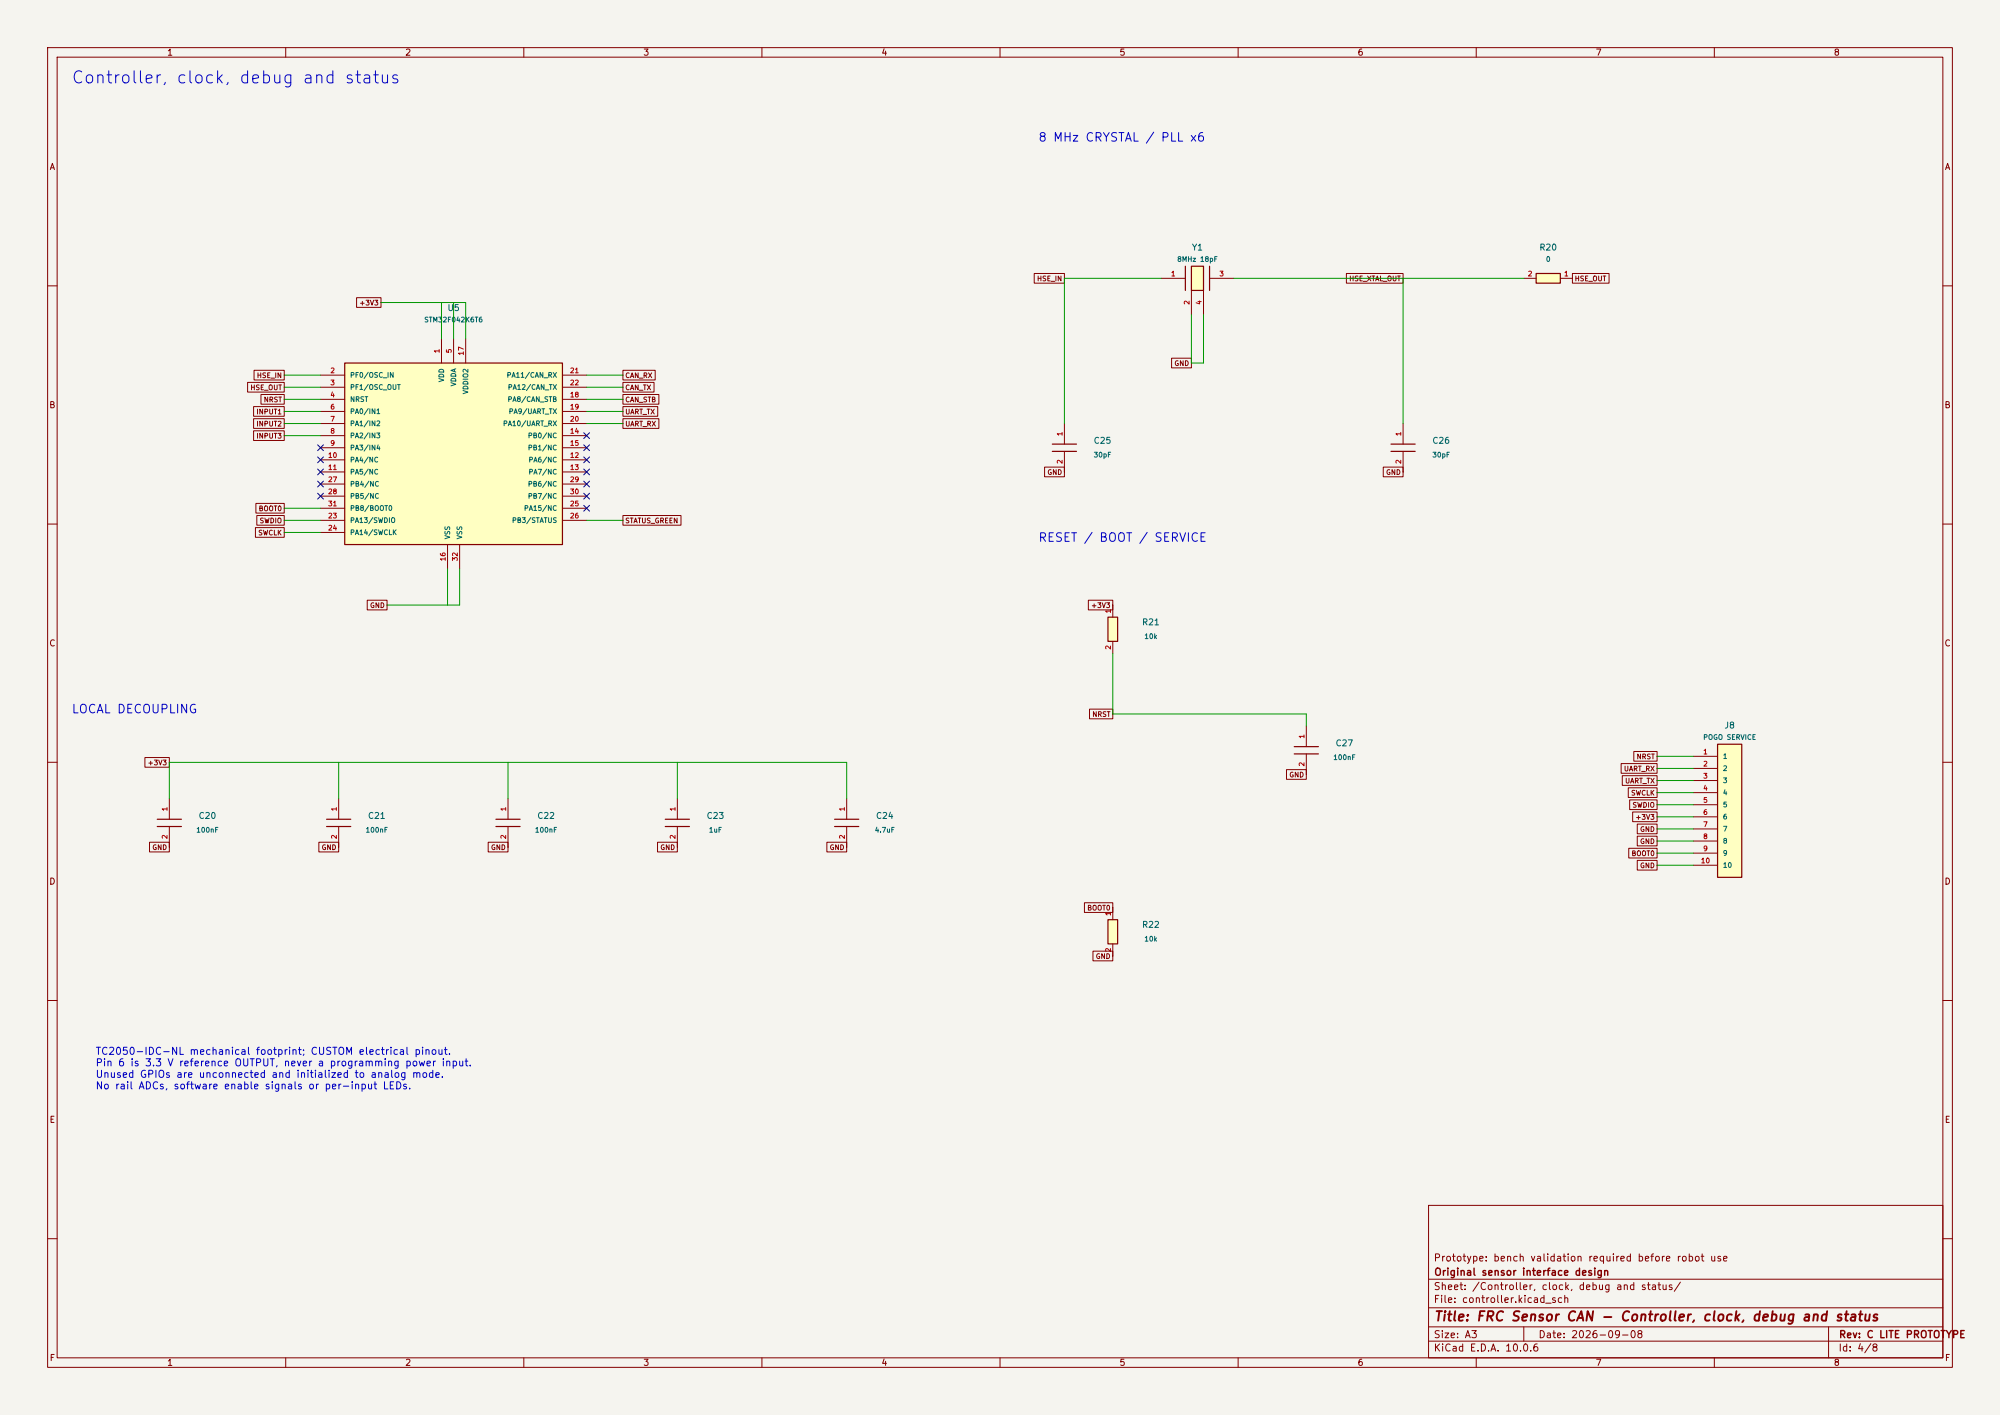
[picture p251: page 4]

Controller, clock, debug and status

1 PF0/OSC_IN 2 PF1/OSC_OUT 3 NRST 4 VDDA 5 PA0/IN1 6 PA1/IN2 7 PA2/IN3 8 PA3/IN4 9 PA4/NC 10 PA5/NC 11 PA6/NC 12 PA7/NC 13 PB0/NC 14 PB1/NC 15 VSS 16 VDDIO2 17 PA8/CAN_STB 18 PA9/UART_TX 19 PA10/UART_RX 20 PA11/CAN_RX 21 PA12/CAN_TX 22 PA13/SWDIO 23 PA14/SWCLK 24 PA15/NC 25 PB3/STATUS 26 PB4/NC 27 PB5/NC 28 PB6/NC 29 PB7/NC 30 PB8/BOOT0 31 VSS 32 U5

TC2050-IDC-NL mechanical footprint; CUSTOM electrical pinout.
Pin 6 is 3.3 V reference OUTPUT, never a programming power input.
Unused GPIOs are unconnected and initialized to analog mode.
No rail ADCs, software enable signals or per-input LEDs.

Prototype: bench validation required before robot use
Original sensor interface design
Sheet: /Controller, clock, debug and status/
File: controller.kicad_sch
Title: FRC Sensor CAN - Controller, clock, debug and status

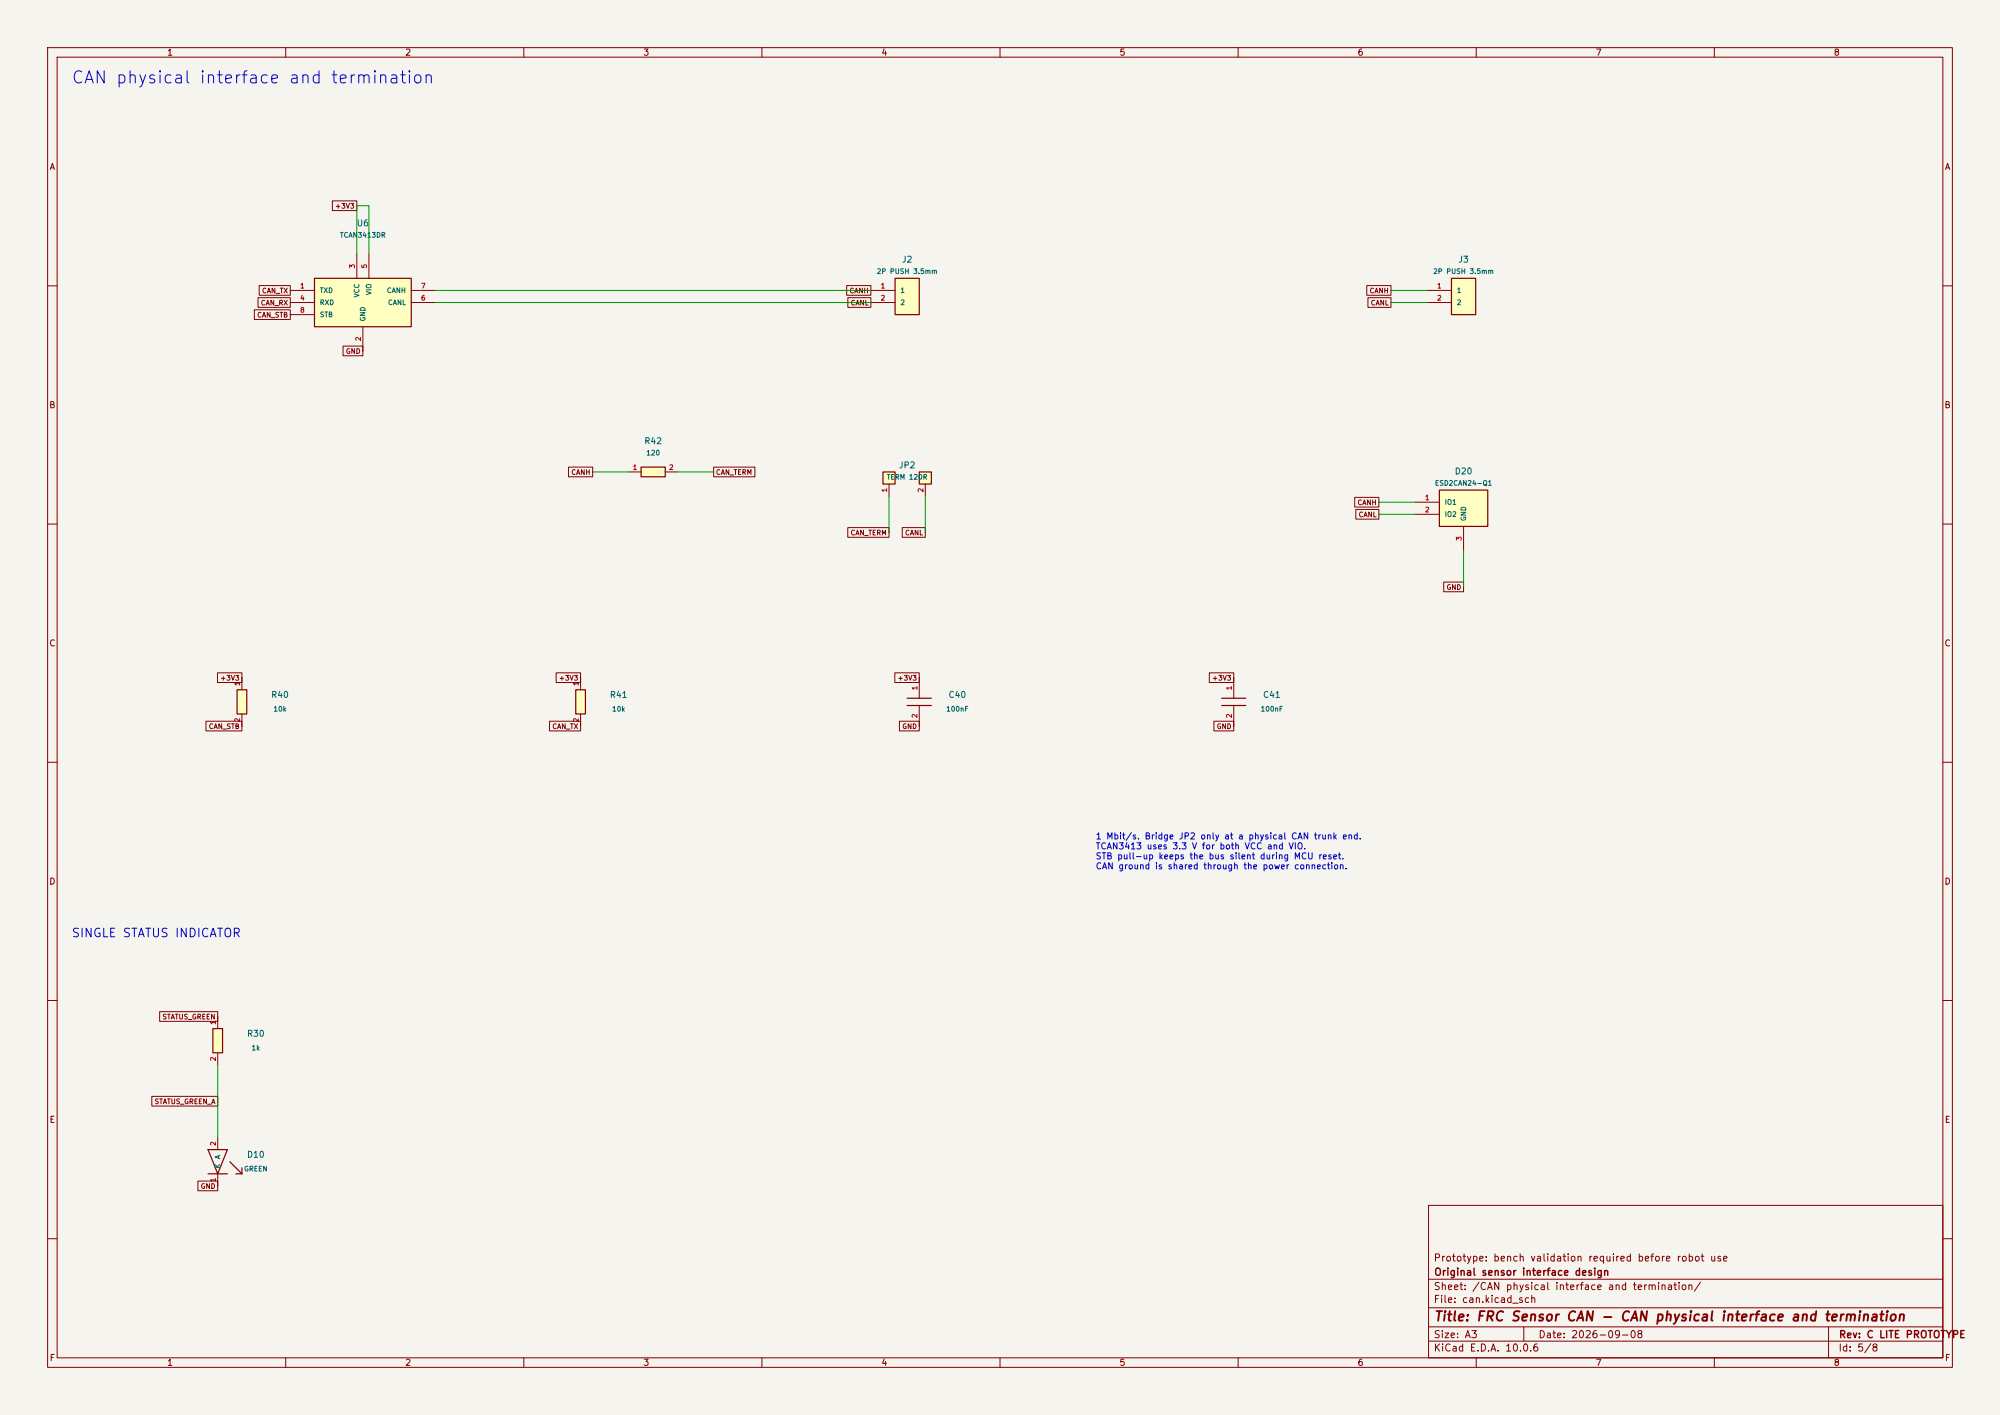
[picture p252: page 5]

Prototype: bench validation required before robot use
Original sensor interface design
Sheet: /CAN physical interface and termination/
File: can.kicad_sch
Title: FRC Sensor CAN - CAN physical interface and termination

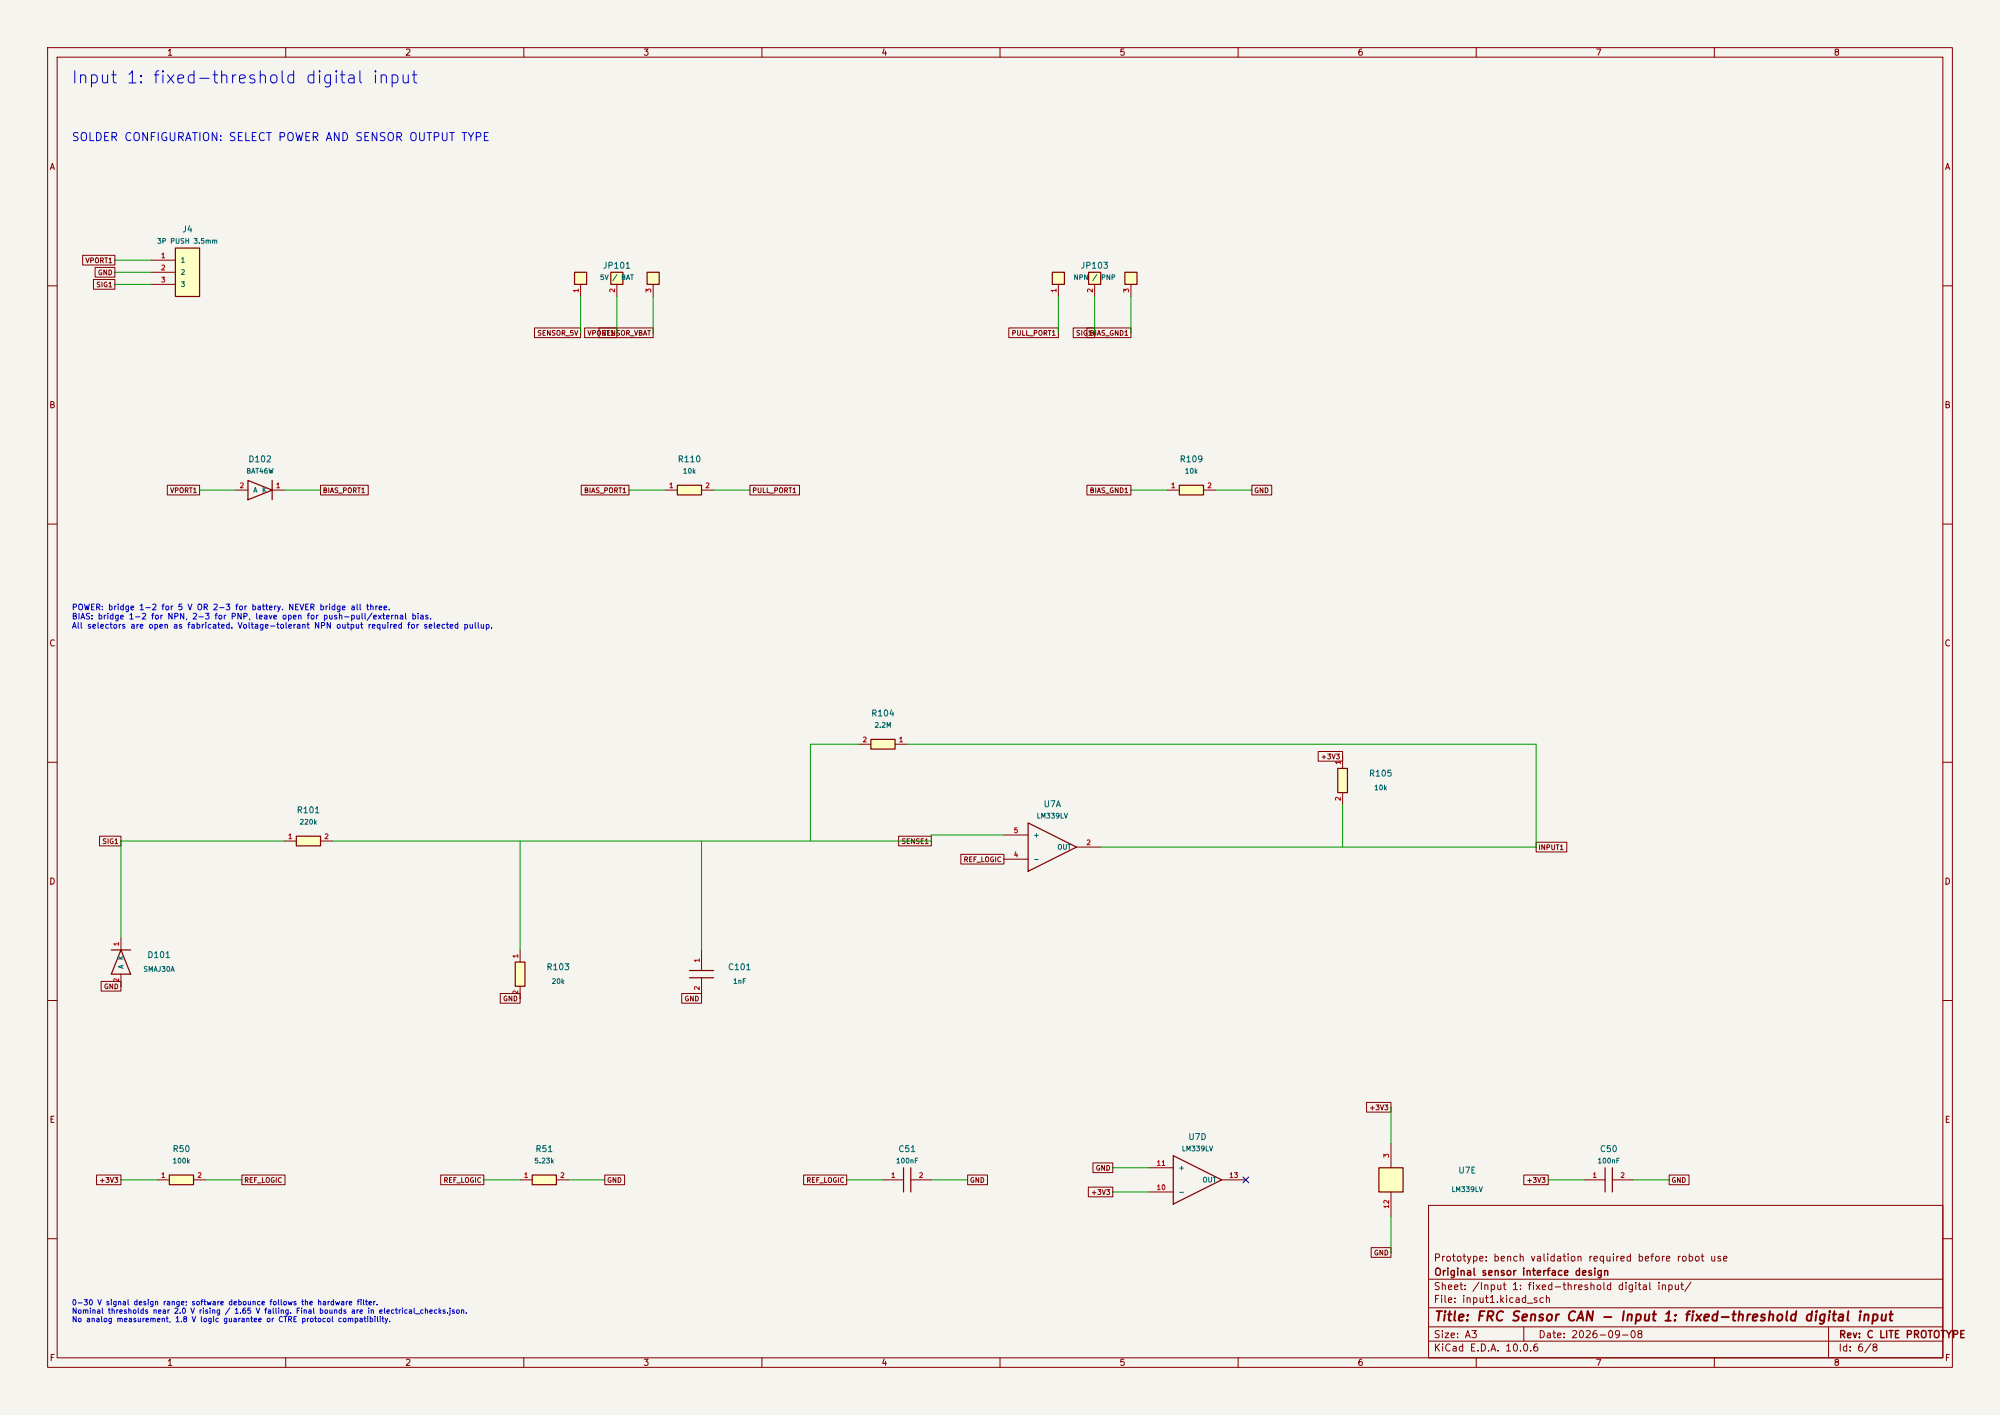
[picture p253: page 6]

Input 1: fixed-threshold digital input

SOLDER CONFIGURATION: SELECT POWER AND SENSOR OUTPUT TYPE

POWER: bridge 1-2 for 5 V OR 2-3 for battery. NEVER bridge all three. BIAS: bridge 1-2 for NPN, 2-3 for PNP, leave open for push-pull/external bias. All selectors are open as fabricated. Voltage-tolerant NPN output required for selected pullup.

Prototype: bench validation required before robot use
Original sensor interface design
Sheet: /Input 1: fixed-threshold digital input/
File: input1.kicad_sch
Title: FRC Sensor CAN - Input 1: fixed-threshold digital input

0-30 V signal design range; software debounce follows the hardware filter. Nominal thresholds near 2.0 V rising / 1.65 V falling. Final bounds are in electrical_checks.json. No analog measurement, 1.8 V logic guarantee or CTRE protocol compatibility.

AB

C

10k OUT; SMAJ30A; REF_LOGIC; SIG2; INPUT2 GND; +3V3 GND; GND; SENSE2

D

E

AB

C

D

E

# Title: FRC Sensor CAN - Input 2: fixed-threshold digital input

## File: input2.kicad_sch

## Sheet: /Input 2: fixed-threshold digital input/

## Original sensor interface design

## Prototype: bench validation required before robot use

1 | 2 R209
10k | 1 2 | R205
1 | 2 R210

10k 1

1

2

2

3

3 J5
3P PUSH 3.5mm

1

2

3 JP203
NPN | / | PNP

K

1

A 2 D202
BAT46W

1

2

3 JP201
5V / BAT

SENSOR_5V

VPORT2 GND

SIG2

VPORT2 | BIAS_PORT2 | BIAS_GND2

BIAS_PORT2

VPORT2 SENSOR_VBAT | GND
SIG2 PULL_PORT2 | BIAS_GND2 PULL_PORT2

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

The reference divider/filter and comparator power connections are on input1.
One fixed logic-compatible threshold for all three channels; no industrial threshold selector.

# Input 2: fixed-threshold digital input

## SOLDER CONFIGURATION: SELECT POWER AND SENSOR OUTPUT TYPE

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

AB

C

OUT; SMAJ30A; REF_LOGIC; SIG3; INPUT3 GND; +3V3 GND; GND; SENSE3

D

E

AB

C

D

E

# Title: FRC Sensor CAN - Input 3: fixed-threshold digital input

## File: input3.kicad_sch

## Sheet: /Input 3: fixed-threshold digital input/

## Original sensor interface design

## Prototype: bench validation required before robot use

1 | 2 R309
10k | 1 2 | R305
1 | 2 R310

10k 1

1

2

2

3

3 J6
3P PUSH 3.5mm

1

2

3 JP303
NPN | / | PNP

K

1

A 2 D302
BAT46W

1

2

3 JP301
5V / BAT

SENSOR_5V

VPORT3 GND

SIG3

VPORT3 | BIAS_PORT3 | BIAS_GND3

BIAS_PORT3

VPORT3 SENSOR_VBAT | GND
SIG3 PULL_PORT3 | BIAS_GND3 PULL_PORT3

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

# Input 3: fixed-threshold digital input

## SOLDER CONFIGURATION: SELECT POWER AND SENSOR OUTPUT TYPE

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
