barkinvar/sugerCANe/rev_b/output/assembly/bottom_markings.pdf

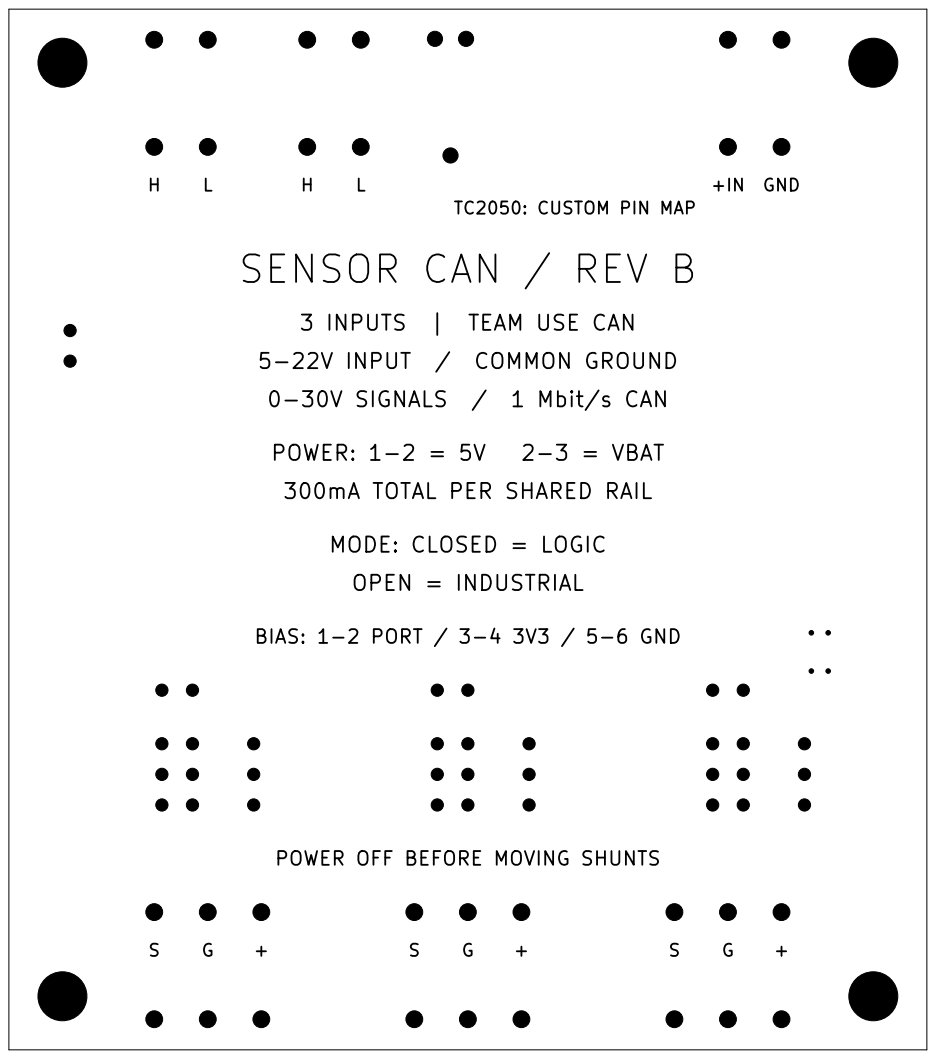
[picture p254: page 1]

3 INPUTS | TEAM USE CAN
5-22V INPUT / COMMON GROUND
0-30V SIGNALS / 1 Mbit/s CAN

300mA TOTAL PER SHARED RAIL

POWER OFF BEFORE MOVING SHUNTS
