barkinvar/sugerCANe/rev_b/output/assembly/gerber_copper_review.pdf

## FRC Sensor CAN · Rev B · TOP copper

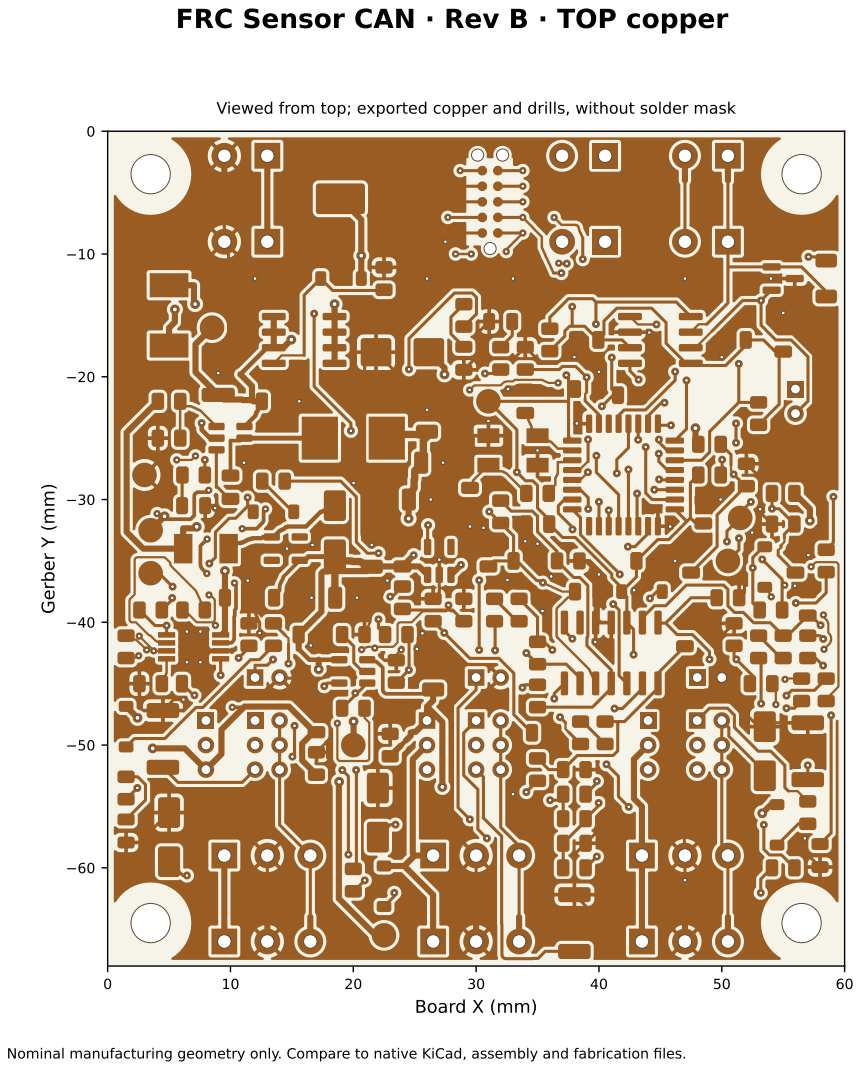
[picture p255: page 1]
Board X (mm); Gerber Y (mm)

Viewed from top; exported copper and drills, without solder mask

Nominal manufacturing geometry only. Compare to native KiCad, assembly and fabrication files.

## FRC Sensor CAN · Rev B · BOTTOM copper

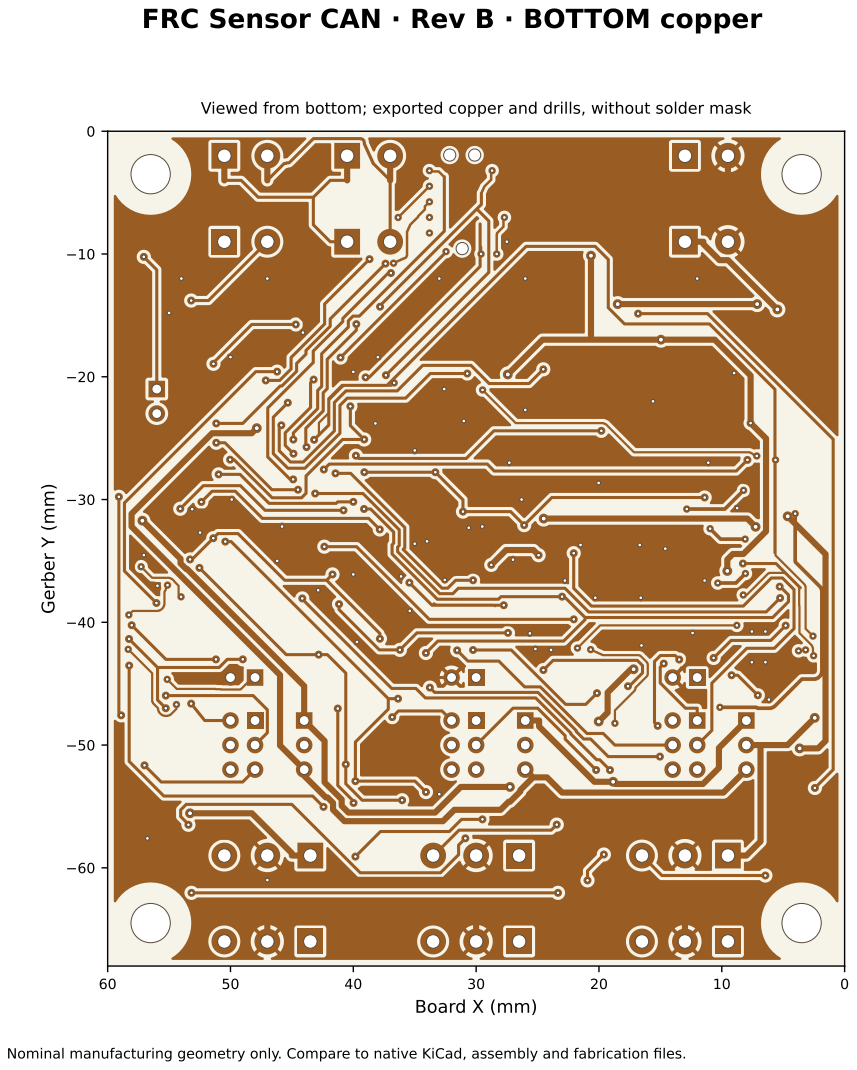
[picture p256: page 2]
Board X (mm); Gerber Y (mm)

Viewed from bottom; exported copper and drills, without solder mask

Nominal manufacturing geometry only. Compare to native KiCad, assembly and fabrication files.
