barkinvar/sugerCANe/rev_b2/output/assembly/gerber_copper_review.pdf

## FRC Sensor CAN · Rev B-2 · TOP copper

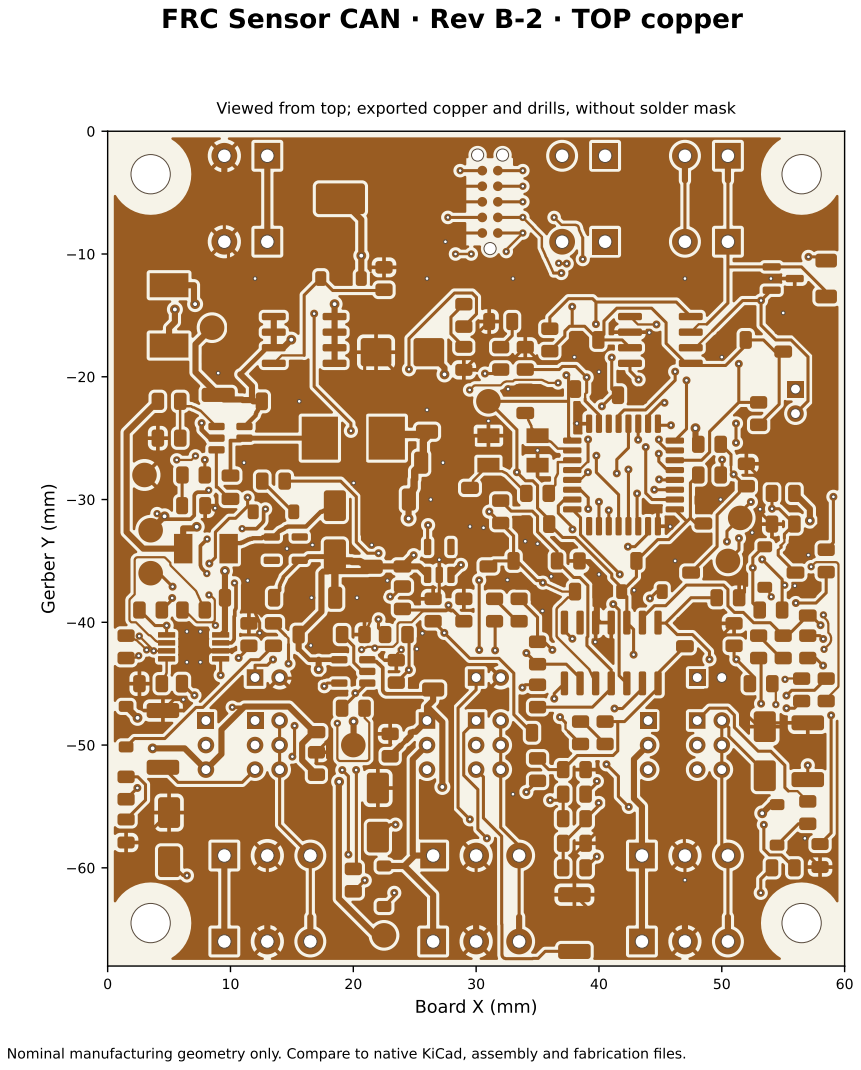
[picture p266: page 1]
Board X (mm); Gerber Y (mm)

Viewed from top; exported copper and drills, without solder mask

Nominal manufacturing geometry only. Compare to native KiCad, assembly and fabrication files.

## FRC Sensor CAN · Rev B-2 · BOTTOM copper

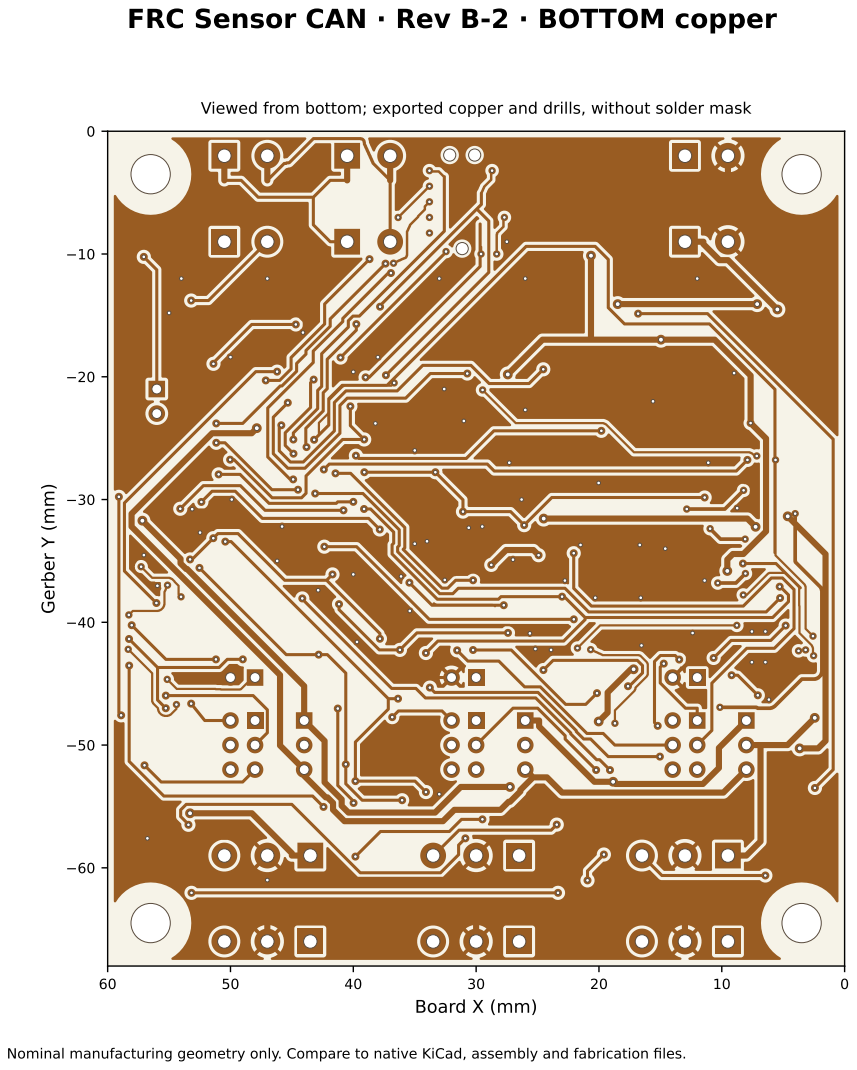
[picture p267: page 2]
Board X (mm); Gerber Y (mm)

Viewed from bottom; exported copper and drills, without solder mask

Nominal manufacturing geometry only. Compare to native KiCad, assembly and fabrication files.
