barkinvar/sugerCANe/rev_b/output/boost_simulation.pdf

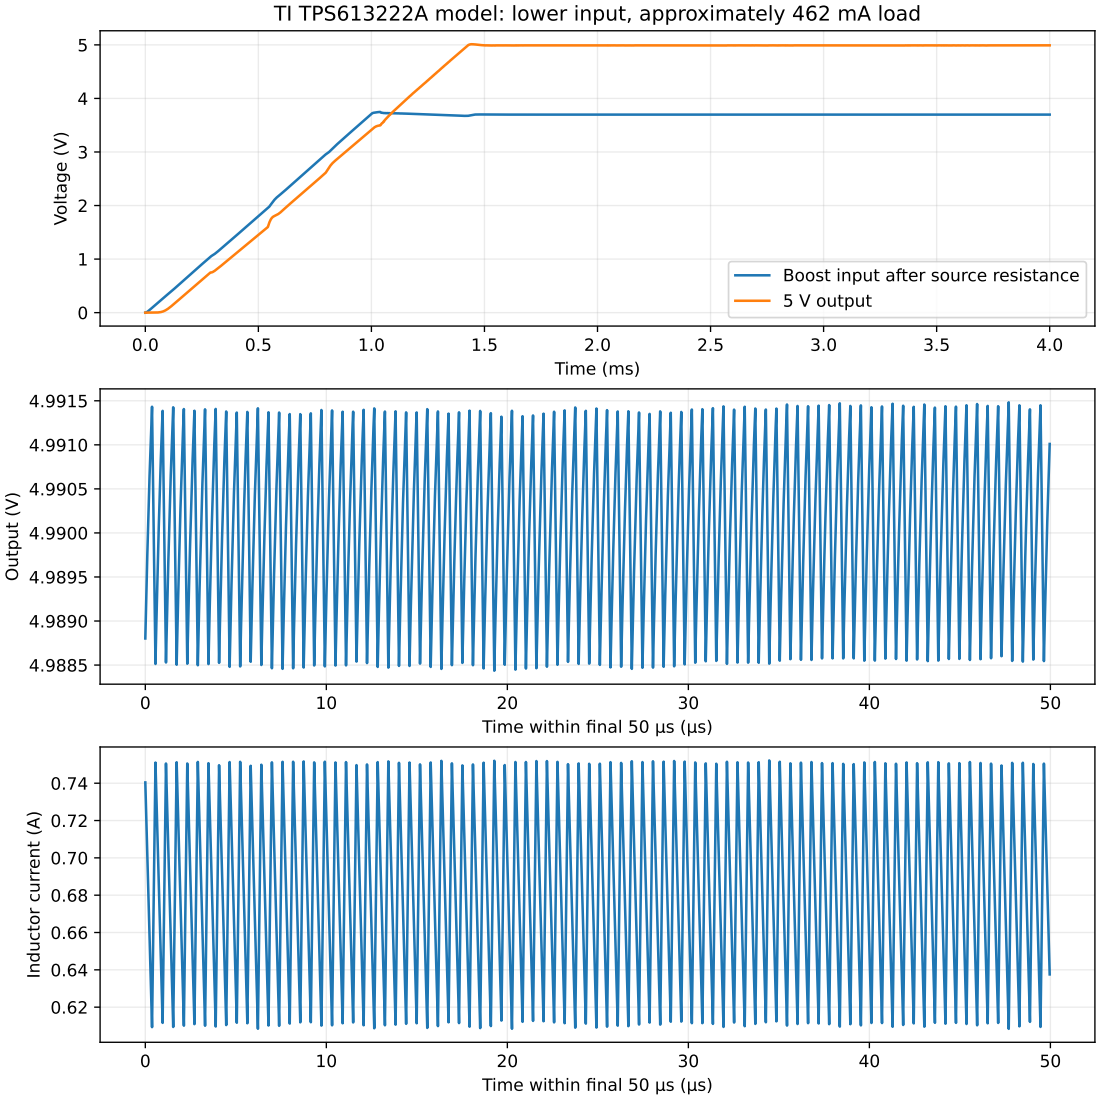
[picture p277: page 1]
Time (ms); Voltage (V); Output (V); Inductor current (A)

TI TPS613222A model: lower input, approximately 462 mA load

Boost input after source resistance
5 V output

Time within final 50 µs (µs)
