barkinvar/sugerCANe/output/assembly/top_assembly.pdf

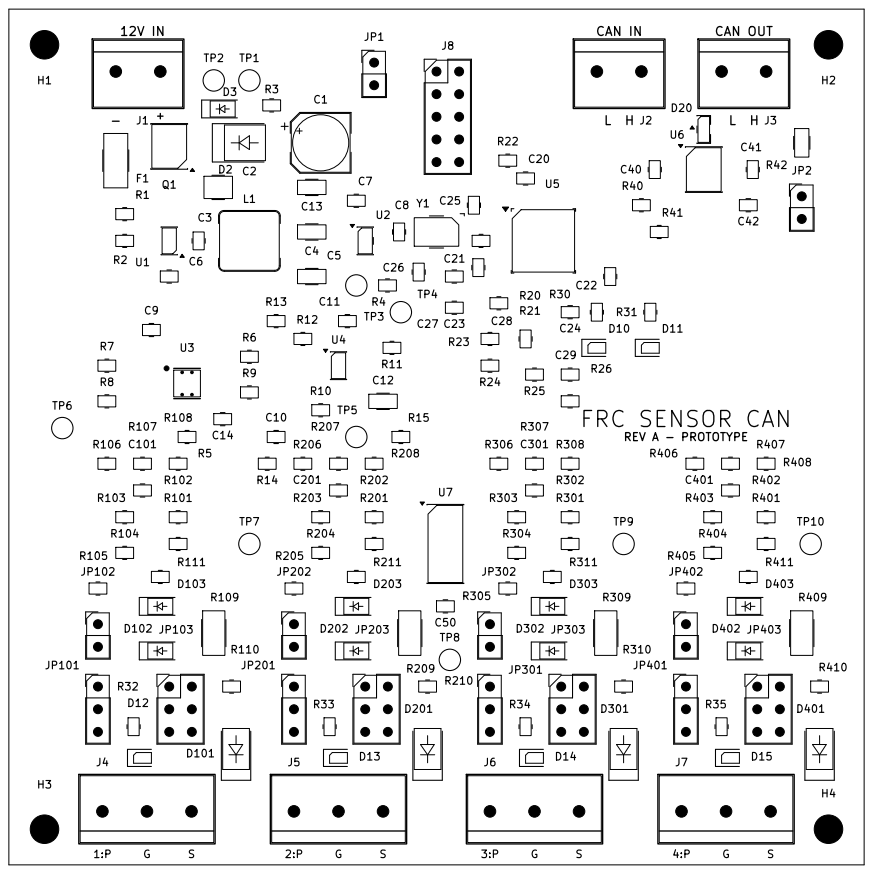
[picture p278: page 1]
