barkinvar/sugerCANe/rev_e/output/assembly/top_assembly.pdf

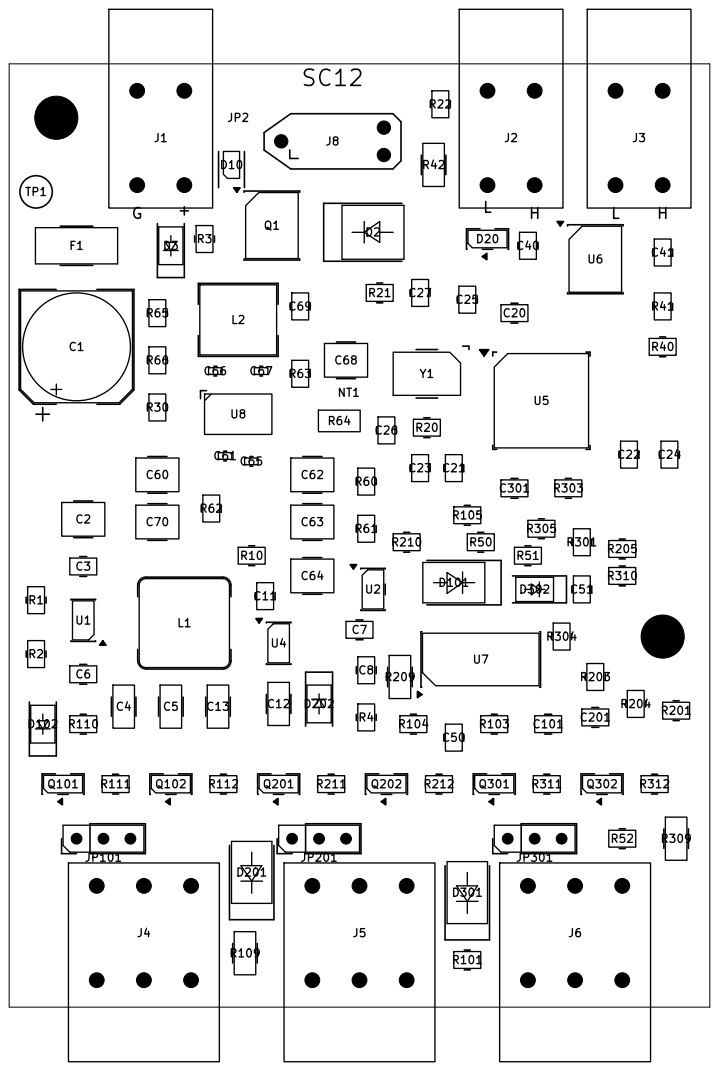
[picture p279: page 1]
