barkinvar/sugerCANe/rev_d2/output/assembly/top_assembly.pdf

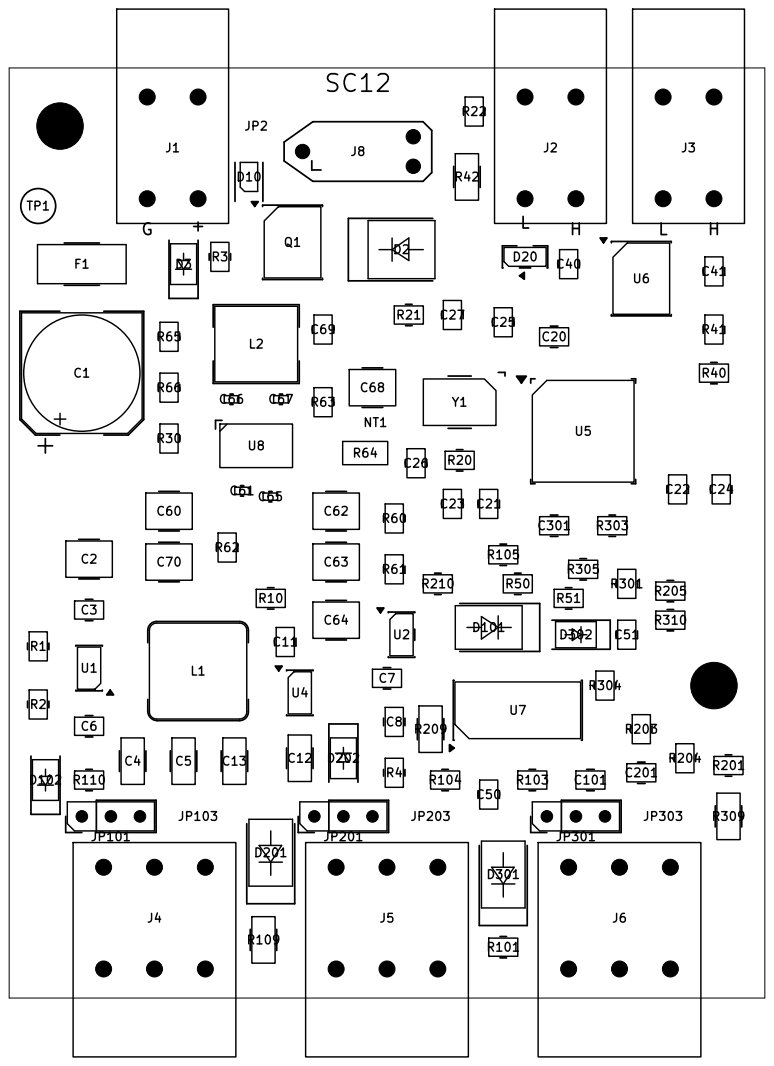
[picture p280: page 1]
