barkinvar/sugerCANe/rev_d/output/assembly/top_assembly.pdf

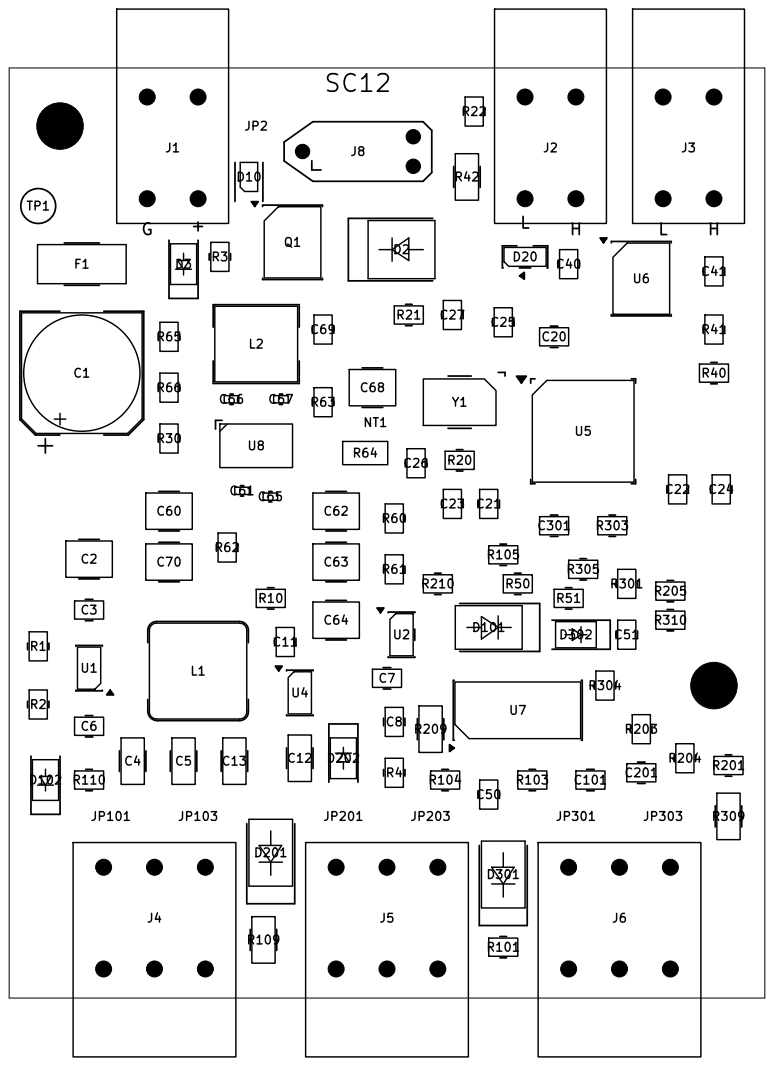
[picture p281: page 1]
