barkinvar/sugerCANe/rev_c/output/assembly/top_assembly.pdf

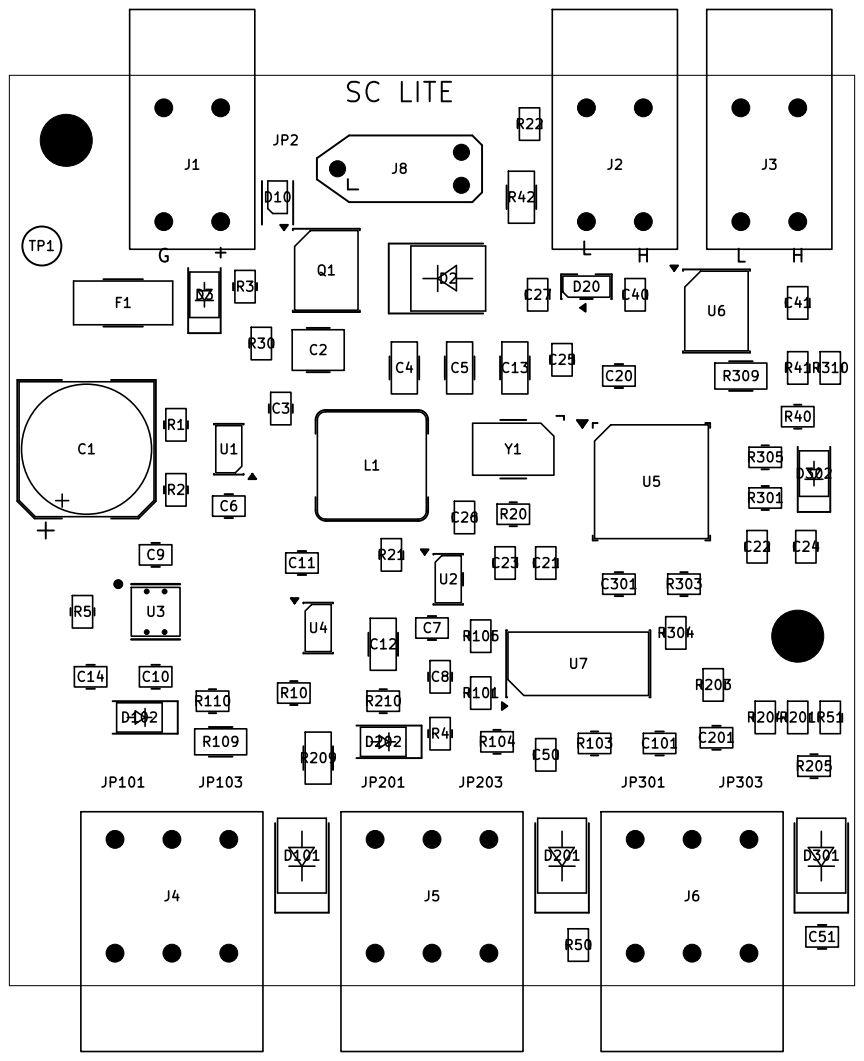
[picture p282: page 1]
