barkinvar/sugerCANe/rev_b/output/assembly/top_assembly.pdf

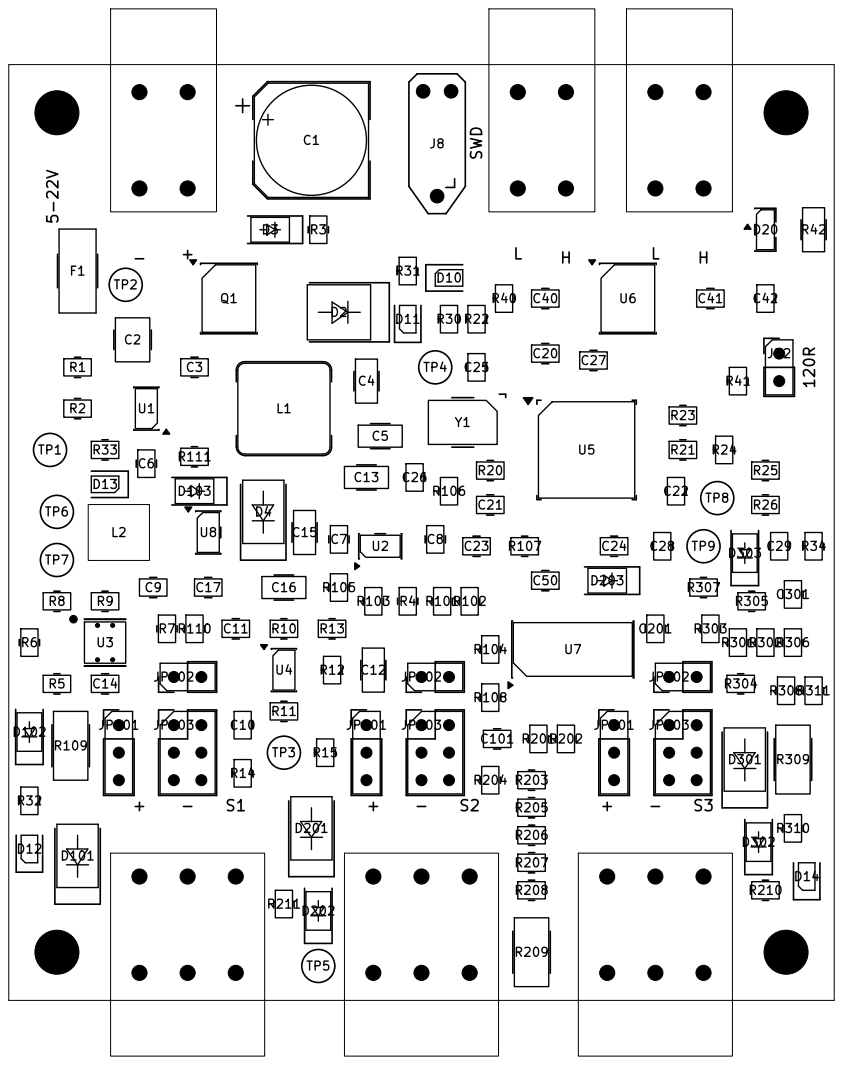
[picture p283: page 1]
