barkinvar/sugerCANe/calculations/spice/industrial_12v_low_pulses.cir

* industrial_12v: actual Rev A divider, hysteresis and filter; typical TI model
.include lm2901_ngspice.lib
.model sensor_switch SW(Ron=10 Roff=1e12 Vt=.5 Vh=0)
Vbat vbat 0 12
Vlogic vlogic 0 3.3
Vstim stim 0 PWL(0.00000000 1 0.02000000 1 0.02000100 0 0.02025000 0 0.02025100 1 0.05025000 1 0.05025100 0 0.05075000 0 0.05075100 1 0.08075000 1 0.08075100 0 0.08150000 0 0.08150100 1 0.11150000 1 0.11150100 0 0.11250000 0 0.11250100 1 0.14250000 1 0.14250100 0 0.14375000 0 0.14375100 1 0.17375000 1 0.17375100 0 0.17525000 0 0.17525100 1 0.20525000 1 0.20525100 0 0.20700000 0 0.20700100 1 0.23700000 1 0.23700100 0 0.23880000 0 0.23880100 1 0.26880000 1 0.26880100 0 0.27065000 0 0.27065100 1 0.30065000 1 0.30065100 0 0.30255000 0 0.30255100 1 0.33255000 1 0.33255100 0 0.33450000 0 0.33450100 1 0.36450000 1 0.36450100 0 0.36650000 0 0.36650100 1 0.39650000 1 0.39650100 0 0.39855000 0 0.39855100 1 0.42855000 1 0.42855100 0 0.43065000 0 0.43065100 1 0.46065000 1 0.46065100 0 0.46280000 0 0.46280100 1 0.49280000 1 0.49280100 0 0.49500000 0 0.49500100 1 0.52500000 1 0.52500100 0 0.52725000 0 0.52725100 1 0.55725000 1 0.55725100 0 0.55955000 0 0.55955100 1 0.58955000 1 0.58955100 0 0.59190000 0 0.59190100 1 0.62190000 1 0.62190100 0 0.62430000 0 0.62430100 1 0.65430000 1 0.65430100 0 0.65675000 0 0.65675100 1 0.68675000 1 0.68675100 0 0.68925000 0 0.68925100 1 0.71925000 1 0.71925100 0 0.72180000 0 0.72180100 1 0.75180000 1 0.75180100 0 0.75440000 0 0.75440100 1 0.78440000 1 0.78440100 0 0.78705000 0 0.78705100 1 0.81705000 1 0.81705100 0 0.81975000 0 0.81975100 1 0.84975000 1 0.84975100 0 0.85250000 0 0.85250100 1 0.88250000 1 0.88250100 0 0.88530000 0 0.88530100 1 0.91530000 1 0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
C101 sense 0 1n
R106 vlogic reference 100k
R107 reference 0 17.8k
* Industrial reference: threshold shunt open
Xcomp sense reference vbat 0 output LM2901
.control
set wr_singlescale
set wr_vecnames
tran 5u 3.07750000
wrdata ../../reports/spice/pulse_work.txt v(output)
quit
.endc
.end
