barkinvar/sugerCANe/calculations/spice/npn_10v_500uA_leak.cir

* npn_10v_500uA_leak: actual Rev A divider, hysteresis and filter; typical TI model
.include lm2901_ngspice.lib
.model sensor_switch SW(Ron=10 Roff=1e12 Vt=.5 Vh=0)
Vbat vbat 0 12
Vlogic vlogic 0 3.3
Vstim stim 0 PWL(0 0 1m 0 1.001m 1 1.05m 1 1.051m 0 3m 0 3.001m 1 8m 1 8.001m 0 12m 0)
Vport port 0 10
Vdiode port pull .45
Rpull pull signal 4.7k
Bleak signal 0 I=0.0005
Bcontrol control 0 V=1-v(stim)
Snpn signal 0 control 0 sensor_switch
R101 signal mid 110k
R102 mid sense 110k
R103 sense 0 20k
R104 sense output 910k
R105 output vlogic 10k
C101 sense 0 1n
R106 vlogic reference 100k
R107 reference 0 17.8k
* Industrial reference: threshold shunt open
Xcomp sense reference vbat 0 output LM2901
.control
set wr_singlescale
set wr_vecnames
tran .5u 12m
wrdata ../../reports/spice/npn_10v_500uA_leak.txt v(signal) v(sense) v(reference) v(output)
quit
.endc
.end
