barkinvar/sugerCANe/(list of files, drawings)

Other design files:
hardware/design/prerouted.dsn
hardware/design/stock_revision.dsn
rev_b2/sources/boost_model/SLVMCM9/TPS613222A_PSPICE_TRANS/TPS613222A.opj
rev_b/hardware/design/candidate.dsn
rev_b/hardware/design/finish.dsn
rev_b/hardware/design/prerouted.dsn
sources/models/lm2901_ti/lm2901.opj
sources/models/lmr51420x_ti/LMR51420X_PSPICE_TRANS/LMR51420DDC_TRANS.OLB
sources/models/lmr51420x_ti/LMR51420X_PSPICE_TRANS/LMR51420X_TRANS.DSN
sources/models/lmr51420x_ti/LMR51420X_PSPICE_TRANS/lmr51420x_trans.opj
