barkinvar/sugerCANe/current/hardware/FRC_Sensor_CAN.kicad_pcb

## KiCad design current/hardware/FRC_Sensor_CAN.kicad_pcb (2026-09-10)

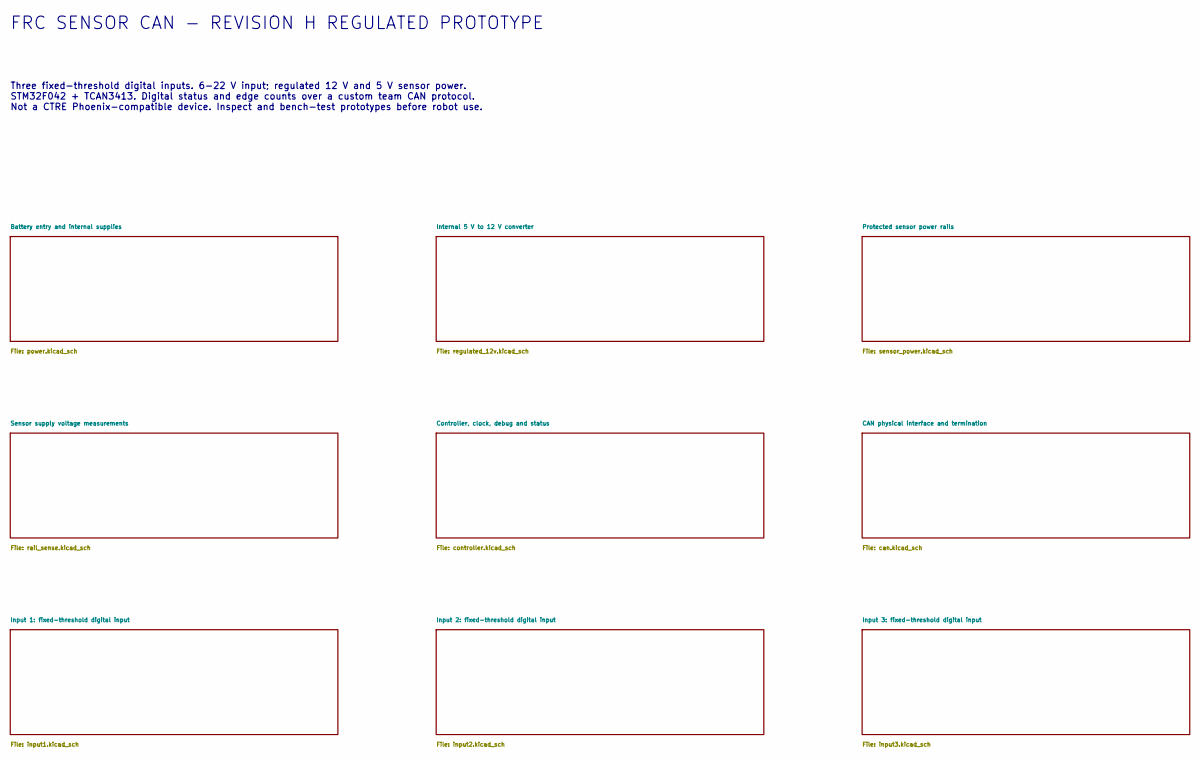
[picture p284: schematic FRC_Sensor_CAN.kicad_sch, FRC Sensor CAN]

Notes on the sheet:
FRC SENSOR CAN - REVISION H REGULATED PROTOTYPE
Three fixed-threshold digital inputs. 6-22 V input; regulated 12 V and 5 V sensor power. STM32F042 + TCAN3413. Digital status and edge counts over a custom team CAN protocol. Not a CTRE Phoenix-compatible device. Inspect and bench-test prototypes before robot use.

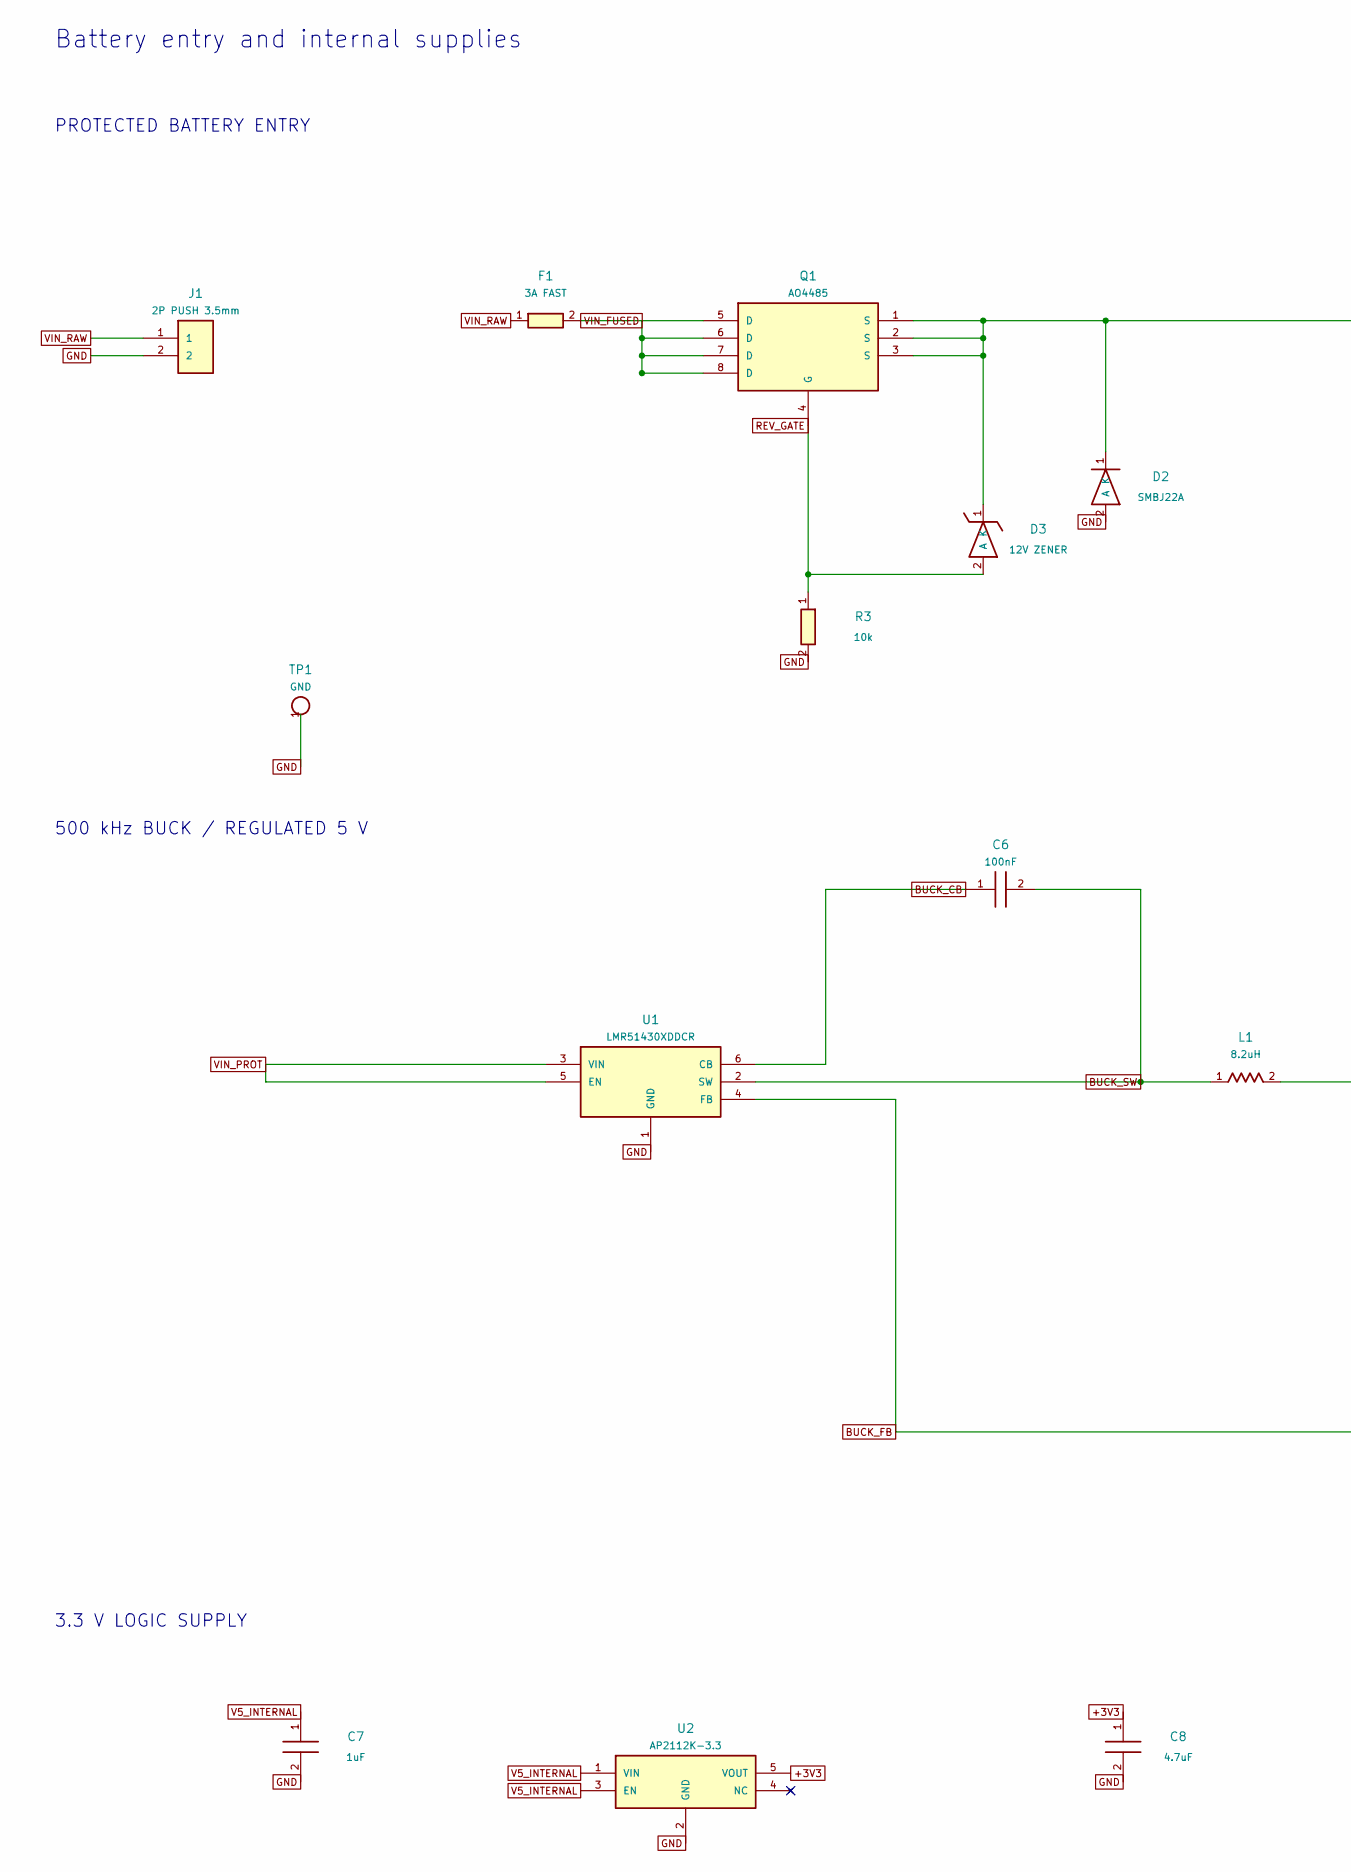
[picture p285: schematic power.kicad_sch, SC12 - Battery entry and internal supplies, part in row 1, column 1]

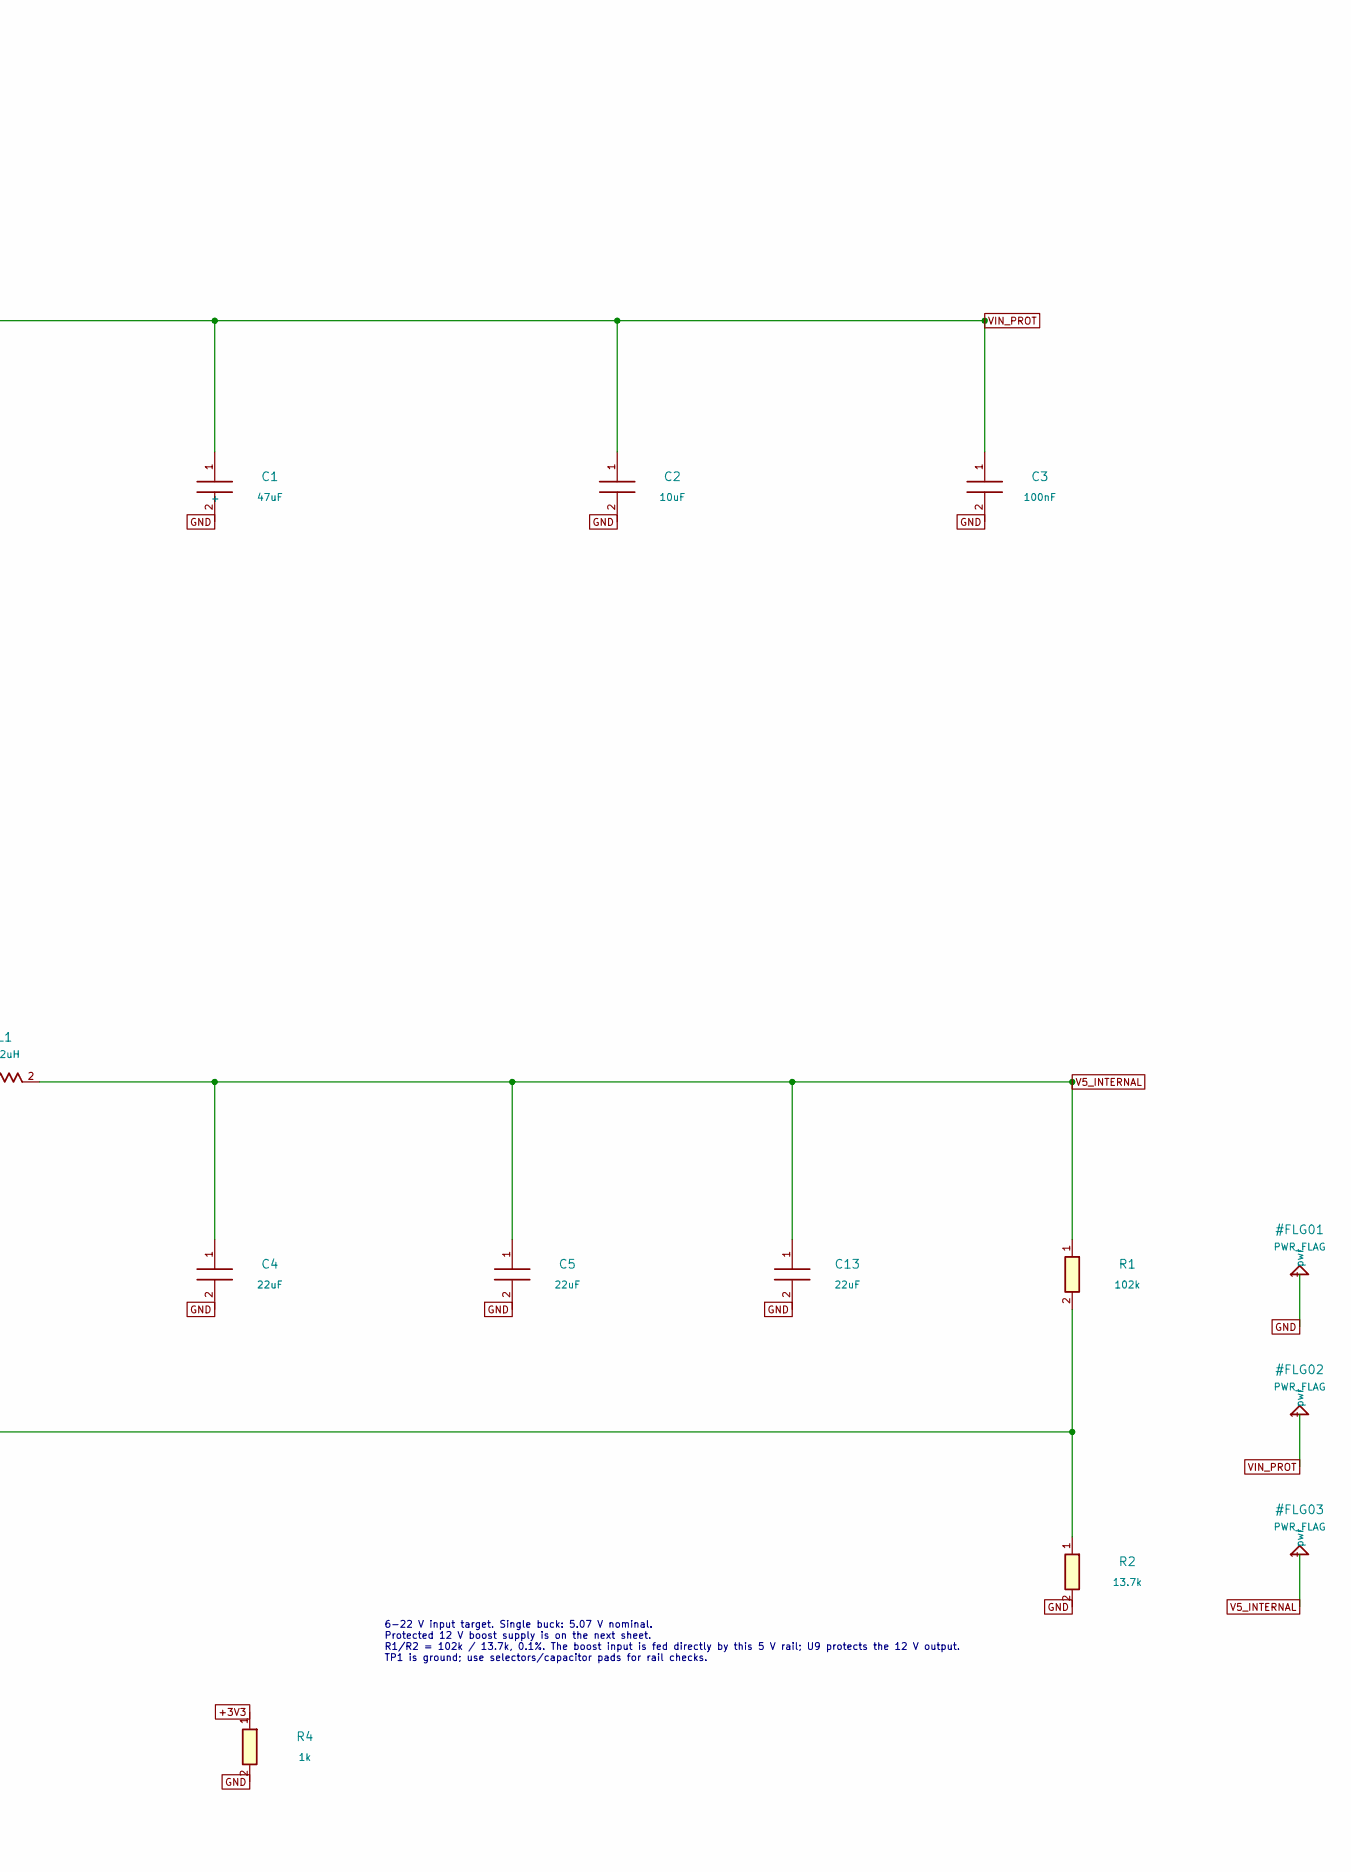
[picture p286: schematic power.kicad_sch, SC12 - Battery entry and internal supplies, part in row 1, column 2]

Parts:
C1: 47uF; CP_Panasonic_FT_6.3x5.8; MPN EEEFT1H470AP
C2: 10uF; C_1210_3225Metric; MPN CL32B106KBJNNWE
C3, C6: 100nF; C_0805_2012Metric; MPN CL21B104KCFNNNE
C4, C5, C13: 22uF; C_1206_3216Metric; MPN CL31A226KAHNNNE
C7: 1uF; C_0805_2012Metric; MPN CL21B105KBFNNNE
C8: 4.7uF; C_0805_2012Metric; MPN CL21B475KAFNNNE
D2: SMBJ22A; D_SMB; MPN SMBJ22A-E3/52
D3: 12V ZENER; D_SOD-123; MPN MMSZ12T1G
F1: 3A FAST; Fuse_Littelfuse-NANO2-451_453; MPN 0451003.MRL
J1: 2P PUSH 3.5mm; Weidmuller_LSF_90_2P; MPN 1824420000
L1: 8.2uH; L_Bourns_SRP7028A_7.3x6.6mm; MPN SRP7028A-8R2M
Q1: AO4485; SOIC-8_3.9x4.9mm_P1.27mm; MPN AO4485
R1: 102k; R_0805_2012Metric; MPN RT0805BRD07102KL
R2: 13.7k; R_0805_2012Metric; MPN RT0805BRD0713K7L
R3: 10k; R_0805_2012Metric; MPN 0805W8F1002T5E
R4: 1k; R_0805_2012Metric; MPN 0805W8F1001T5E
TP1: GND; TestPoint_Pad_D2.0mm
U1: LMR51430XDDCR; TSOT-23-6; MPN LMR51430XDDCR
U2: AP2112K-3.3; SOT-23-5; MPN AP2112K-3.3TRG1

Connections:
+3V3: C8.1, R4.1, U2.5 (VOUT); also elsewhere on the board
BUCK_CB: C6.1, U1.6 (CB)
BUCK_FB: R1.2, R2.1, U1.4 (FB)
BUCK_SW: C6.2, L1.1, U1.2 (SW)
GND: C1.2, C2.2, C3.2, C4.2, C5.2, C7.2, C8.2, C13.2, D2.2 (A), J1.2, R2.2, R3.2, R4.2, TP1.1, U1.1 (GND), U2.2 (GND); also elsewhere on the board
REV_GATE: D3.2 (A), Q1.4 (G), R3.1
V5_INTERNAL: C4.1, C5.1, C7.1, C13.1, L1.2, R1.1, U2.1 (VIN), U2.3 (EN); also elsewhere on the board
VIN_FUSED: F1.2, Q1.5 (D), Q1.6 (D), Q1.7 (D), Q1.8 (D)
VIN_PROT: C1.1 (+), C2.1, C3.1, D2.1 (K), D3.1 (K), Q1.1 (S), Q1.2 (S), Q1.3 (S), U1.3 (VIN), U1.5 (EN)
VIN_RAW: F1.1, J1.1

Notes on the sheet:
Battery entry and internal supplies
PROTECTED BATTERY ENTRY
500 kHz BUCK / REGULATED 5 V
3.3 V LOGIC SUPPLY
6-22 V input target. Single buck: 5.07 V nominal. Protected 12 V boost supply is on the next sheet. R1/R2 = 102k / 13.7k, 0.1%. The boost input is fed directly by this 5 V rail; U9 protects the 12 V output. TP1 is ground; use selectors/capacitor pads for rail checks.

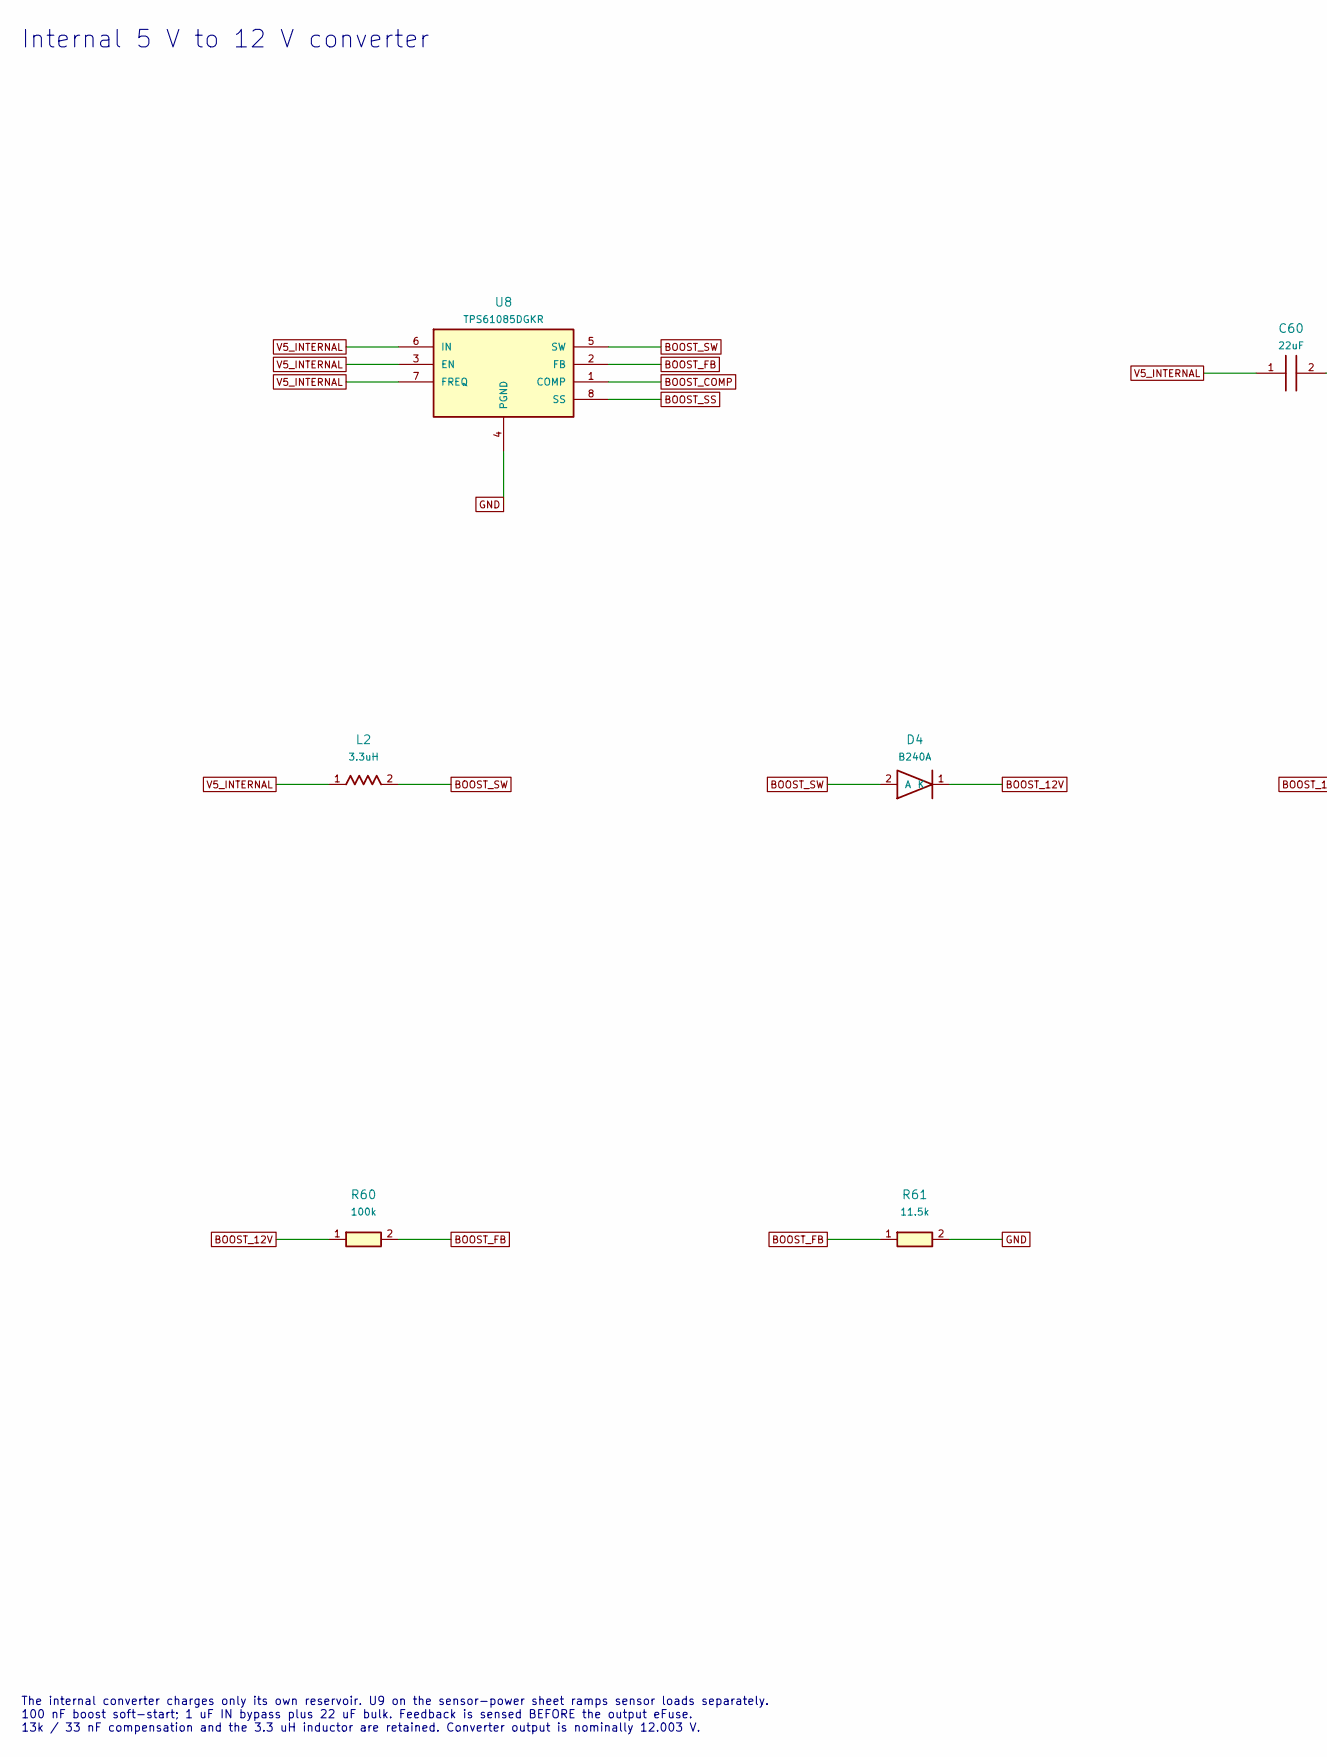
[picture p287: schematic regulated_12v.kicad_sch, SC12 - Internal 5 V to 12 V converter, part in row 1, column 1]

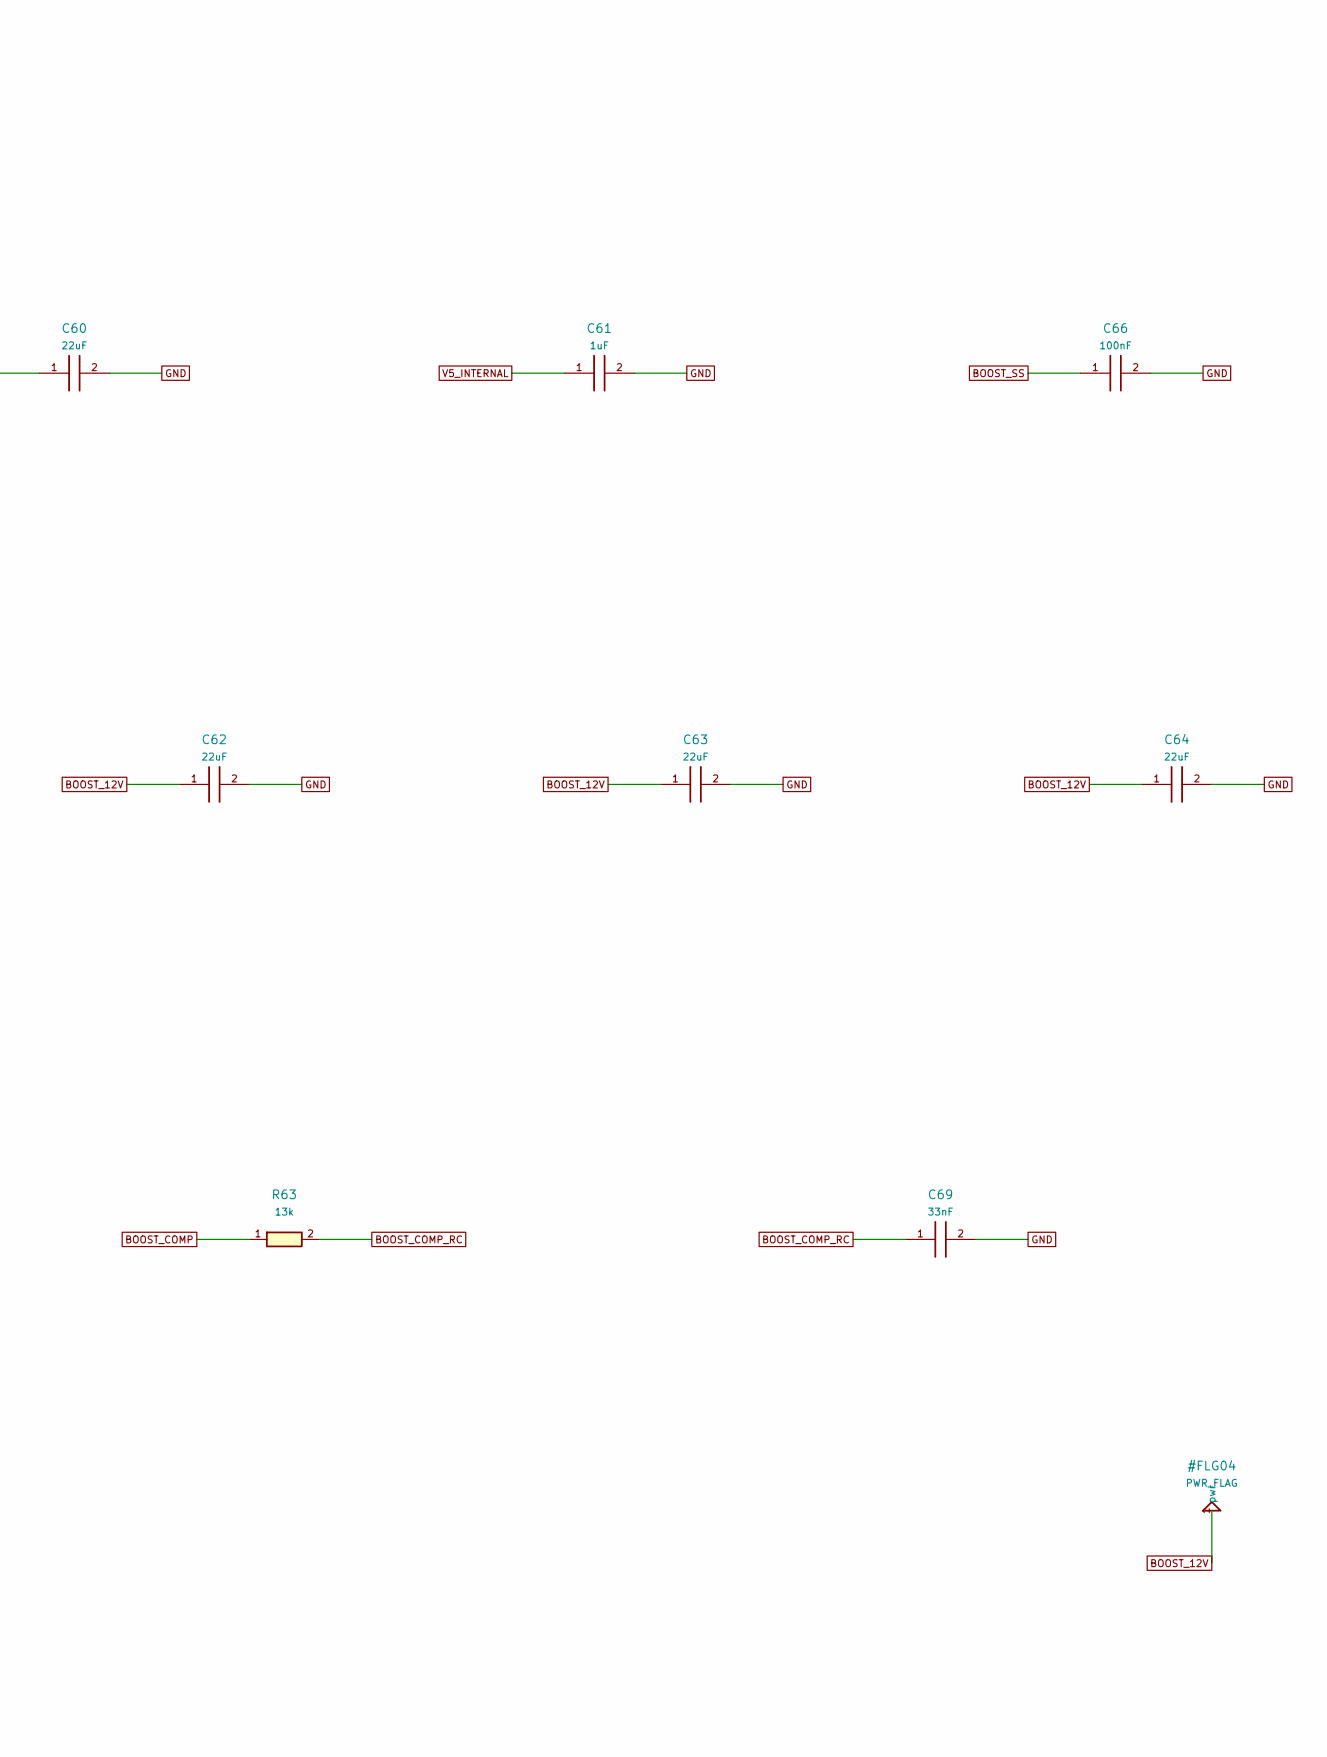
[picture p288: schematic regulated_12v.kicad_sch, SC12 - Internal 5 V to 12 V converter, part in row 1, column 2]

Parts:
C60, C62, C63, C64: 22uF; C_1206_3216Metric; MPN CL31A226KAHNNNE
C61: 1uF; C_0805_2012Metric; MPN CL21B105KBFNNNE
C66: 100nF; C_0805_2012Metric; MPN CL21B104KCFNNNE
C69: 33nF; C_0805_2012Metric; MPN CC0805KRX7R9BB333
D4: B240A; D_SMA; MPN B240A-13-F
L2: 3.3uH; L_Bourns_SRP5030T; MPN SRP5030TA-3R3M
R60: 100k; R_0805_2012Metric; MPN RT0805BRD07100KL
R61: 11.5k; R_0805_2012Metric; MPN 0805W8F1152T5E
R63: 13k; R_0805_2012Metric; MPN RC0805FR-0713KL
U8: TPS61085DGKR; VSSOP-8_3x3mm_P0.65mm; MPN TPS61085DGKR

Connections:
BOOST_12V: C62.1, C63.1, C64.1, D4.1 (K), R60.1; also elsewhere on the board
BOOST_COMP: R63.1, U8.1 (COMP)
BOOST_COMP_RC: C69.1, R63.2
BOOST_FB: R60.2, R61.1, U8.2 (FB)
BOOST_SS: C66.1, U8.8 (SS)
BOOST_SW: D4.2 (A), L2.2, U8.5 (SW)
GND: C60.2, C61.2, C62.2, C63.2, C64.2, C66.2, C69.2, R61.2, U8.4 (PGND); also elsewhere on the board
V5_INTERNAL: C60.1, C61.1, L2.1, U8.3 (EN), U8.6 (IN), U8.7 (FREQ); also elsewhere on the board

Notes on the sheet:
Internal 5 V to 12 V converter
The internal converter charges only its own reservoir. U9 on the sensor-power sheet ramps sensor loads separately. 100 nF boost soft-start; 1 uF IN bypass plus 22 uF bulk. Feedback is sensed BEFORE the output eFuse. 13k / 33 nF compensation and the 3.3 uH inductor are retained. Converter output is 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

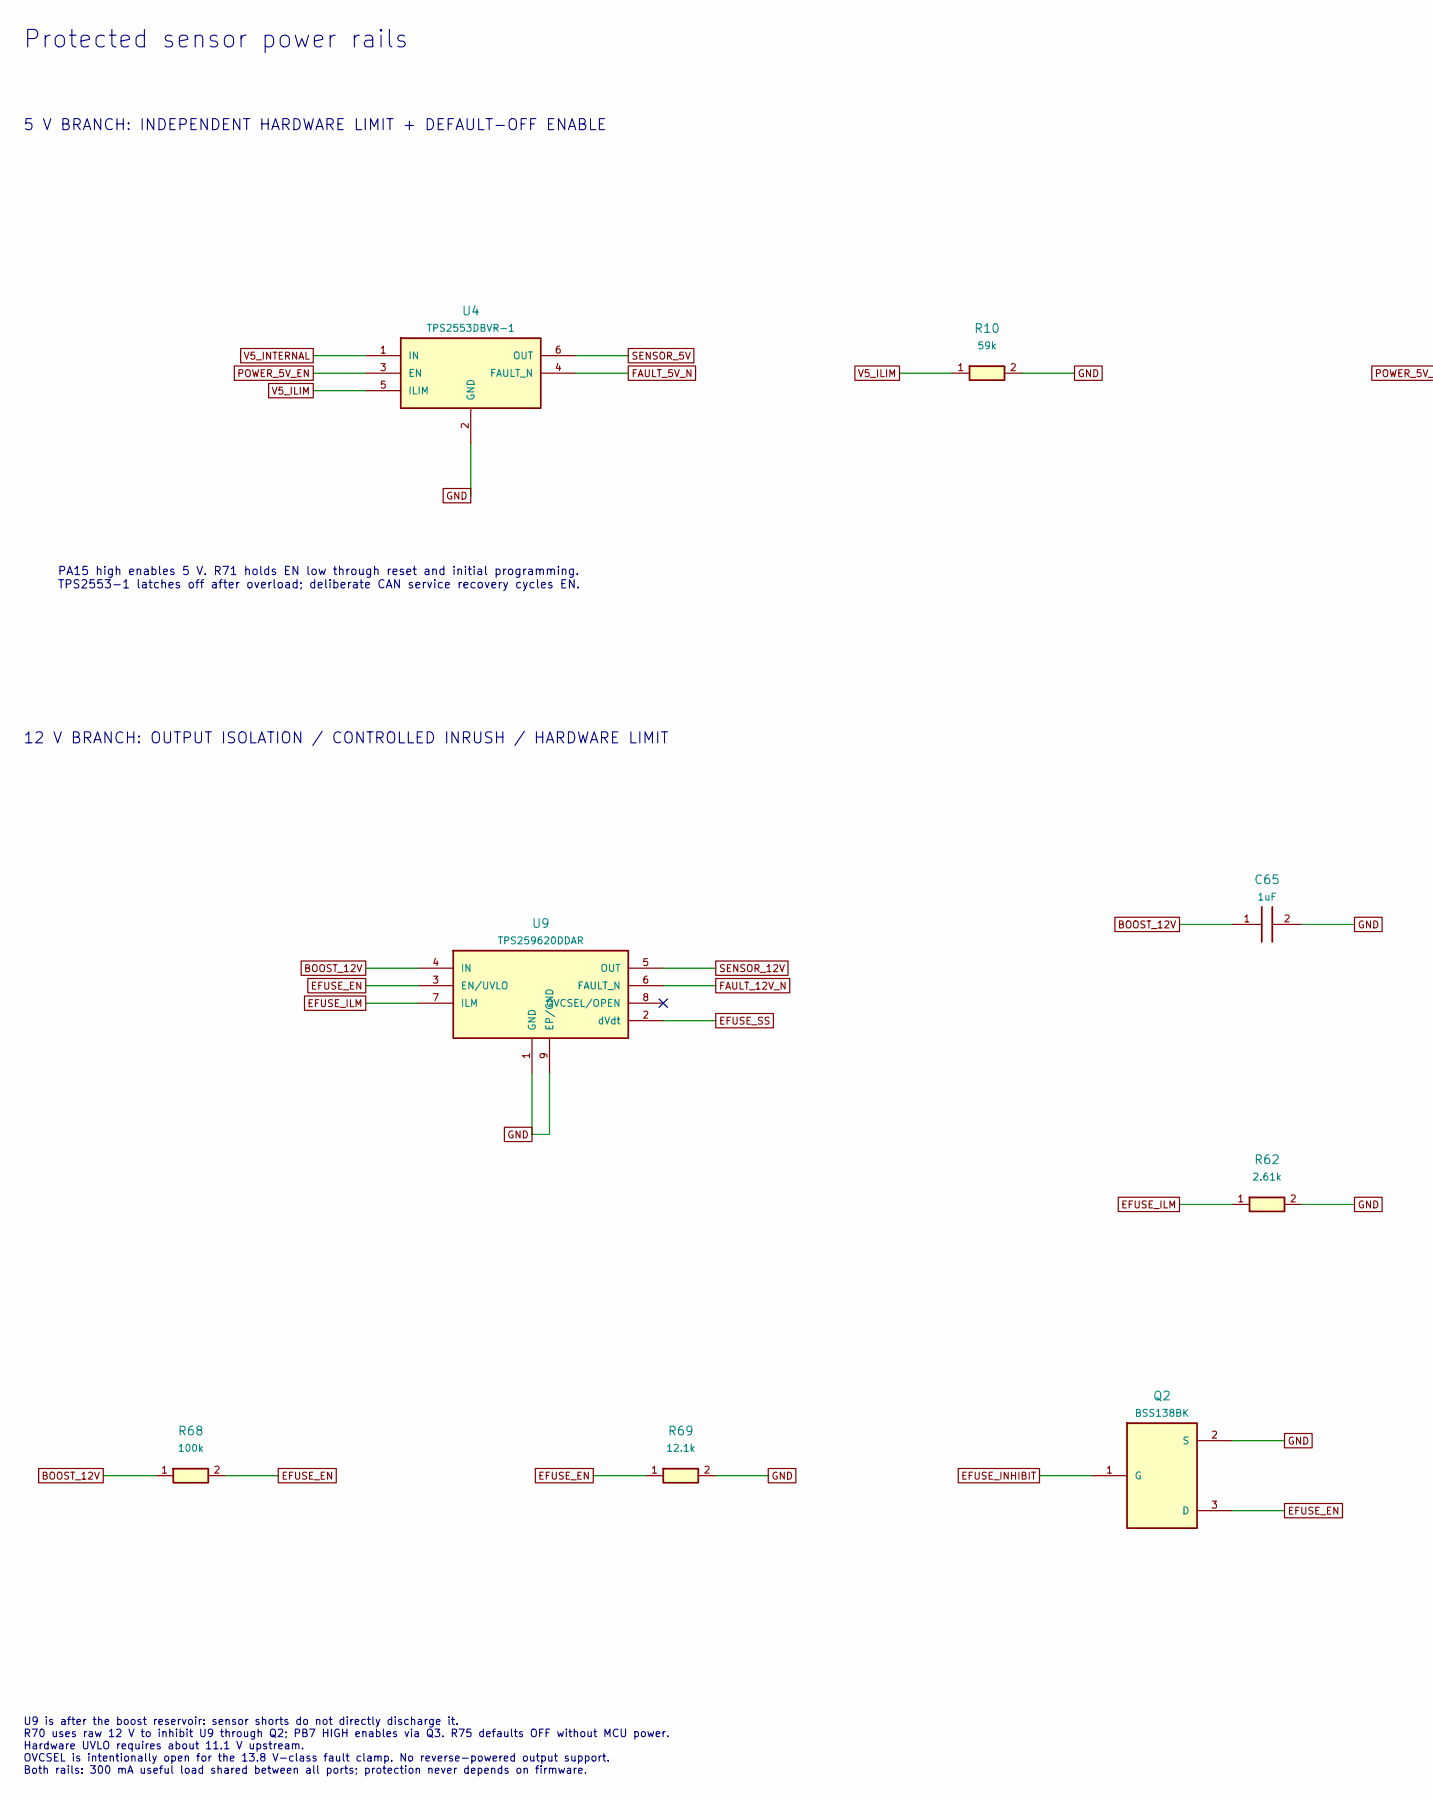
[picture p289: schematic sensor_power.kicad_sch, SC12 - Protected sensor power rails, part in row 1, column 1]

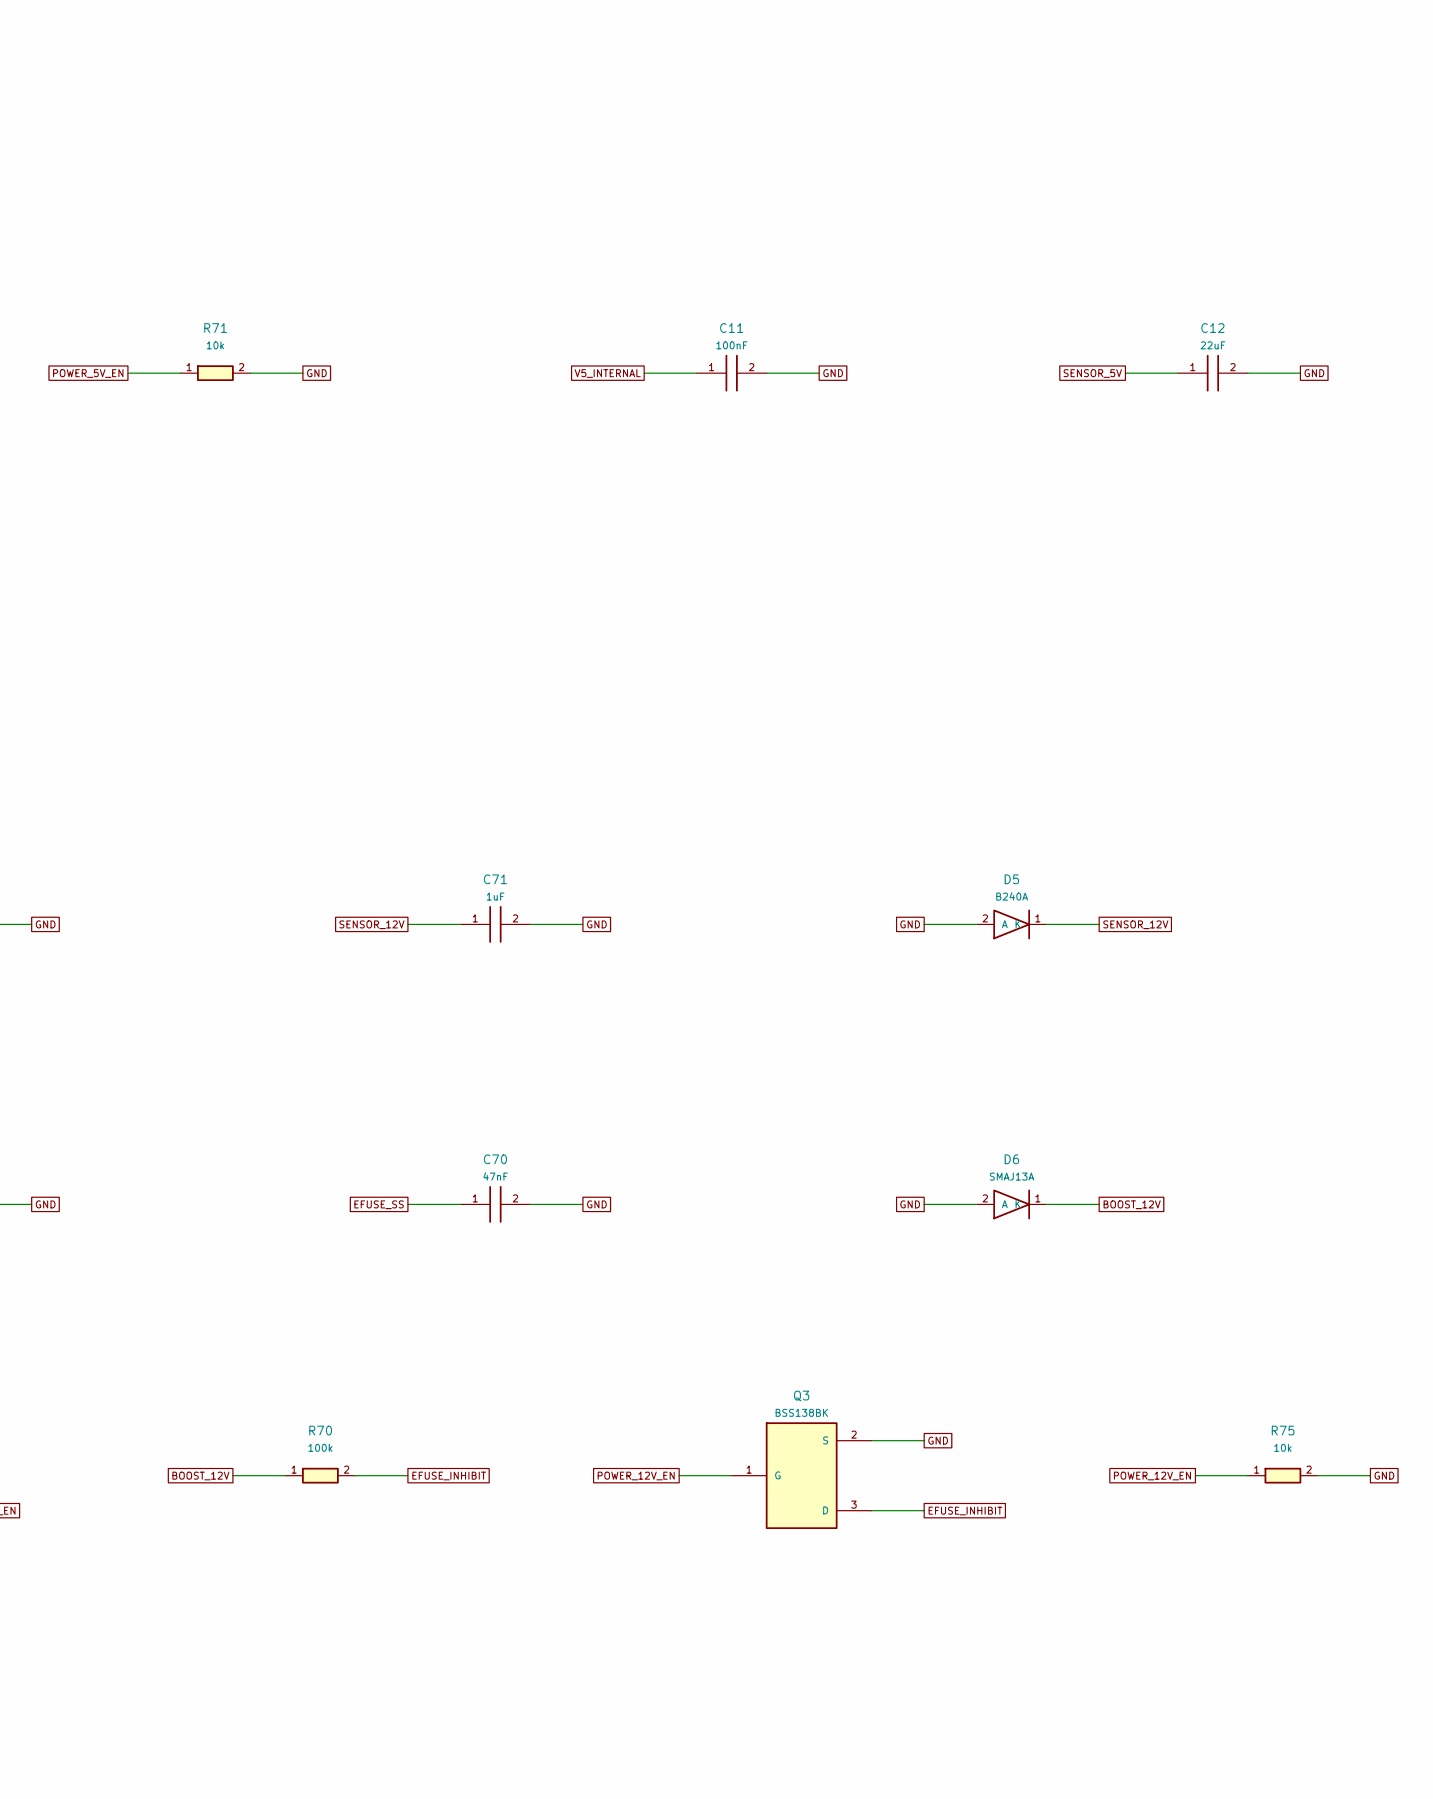
[picture p290: schematic sensor_power.kicad_sch, SC12 - Protected sensor power rails, part in row 1, column 2]

Parts:
C11: 100nF; C_0805_2012Metric; MPN CL21B104KCFNNNE
C12: 22uF; C_1206_3216Metric; MPN CL31A226KAHNNNE
C65, C71: 1uF; C_0805_2012Metric; MPN CL21B105KBFNNNE
C70: 47nF; C_0805_2012Metric; MPN CL21B473KBCNNNC
D5: B240A; D_SMA; MPN B240A-13-F
D6: SMAJ13A; D_SMA; MPN SMAJ13A-13-F
Q2, Q3: BSS138BK; SOT-23; MPN BSS138BK,215
R10: 59k; R_0805_2012Metric; MPN 0805W8F5902T5E
R62: 2.61k; R_0805_2012Metric; MPN RC0805FR-072K61L
R68: 100k; R_0805_2012Metric; MPN RT0805BRD07100KL
R69: 12.1k; R_0805_2012Metric; MPN RT0805BRD0712K1L
R70: 100k; R_0805_2012Metric; MPN 0805W8F1003T5E
R71, R75: 10k; R_0805_2012Metric; MPN 0805W8F1002T5E
U4: TPS2553DBVR-1; SOT-23-6; MPN TPS2553DBVR-1
U9: TPS259620DDAR; TPS2596_DDA8; MPN TPS259620DDAR

Connections:
BOOST_12V: C65.1, D6.1 (K), R68.1, R70.1, U9.4 (IN); also elsewhere on the board
EFUSE_EN: Q2.3 (D), R68.2, R69.1, U9.3 (EN/UVLO)
EFUSE_ILM: R62.1, U9.7 (ILM)
EFUSE_INHIBIT: Q2.1 (G), Q3.3 (D), R70.2
EFUSE_SS: C70.1, U9.2 (dVdt)
FAULT_5V_N: U4.4 (FAULT_N); also elsewhere on the board
FAULT_12V_N: U9.6 (FAULT_N); also elsewhere on the board
GND: C11.2, C12.2, C65.2, C70.2, C71.2, D5.2 (A), D6.2 (A), Q2.2 (S), Q3.2 (S), R10.2, R62.2, R69.2, R71.2, R75.2, U4.2 (GND), U9.1 (GND), U9.9 (EP/GND); also elsewhere on the board
POWER_5V_EN: R71.1, U4.3 (EN); also elsewhere on the board
POWER_12V_EN: Q3.1 (G), R75.1; also elsewhere on the board
SENSOR_5V: C12.1, U4.6 (OUT); also elsewhere on the board
SENSOR_12V: C71.1, D5.1 (K), U9.5 (OUT); also elsewhere on the board
V5_ILIM: R10.1, U4.5 (ILIM)
V5_INTERNAL: C11.1, U4.1 (IN); also elsewhere on the board

Notes on the sheet:
Protected sensor power rails
5 V BRANCH: INDEPENDENT HARDWARE LIMIT + DEFAULT-OFF ENABLE
PA15 high enables 5 V. R71 holds EN low through reset and initial programming. TPS2553-1 latches off after overload; deliberate CAN service recovery cycles EN.
12 V BRANCH: OUTPUT ISOLATION / CONTROLLED INRUSH / HARDWARE LIMIT
U9 is after the boost reservoir: sensor shorts do not directly discharge it. R70 uses raw 12 V to inhibit U9 through Q2; PB7 HIGH enables via Q3. R75 defaults OFF without MCU power. Hardware UVLO requires about 11.1 V upstream. OVCSEL is intentionally open for the 13.8 V-class fault clamp. No rever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
