barkinvar/sugerCANe/current/hardware/FRC_Sensor_CAN.kicad_pcb

## KiCad design current/hardware/FRC_Sensor_CAN.kicad_pcb (continued)

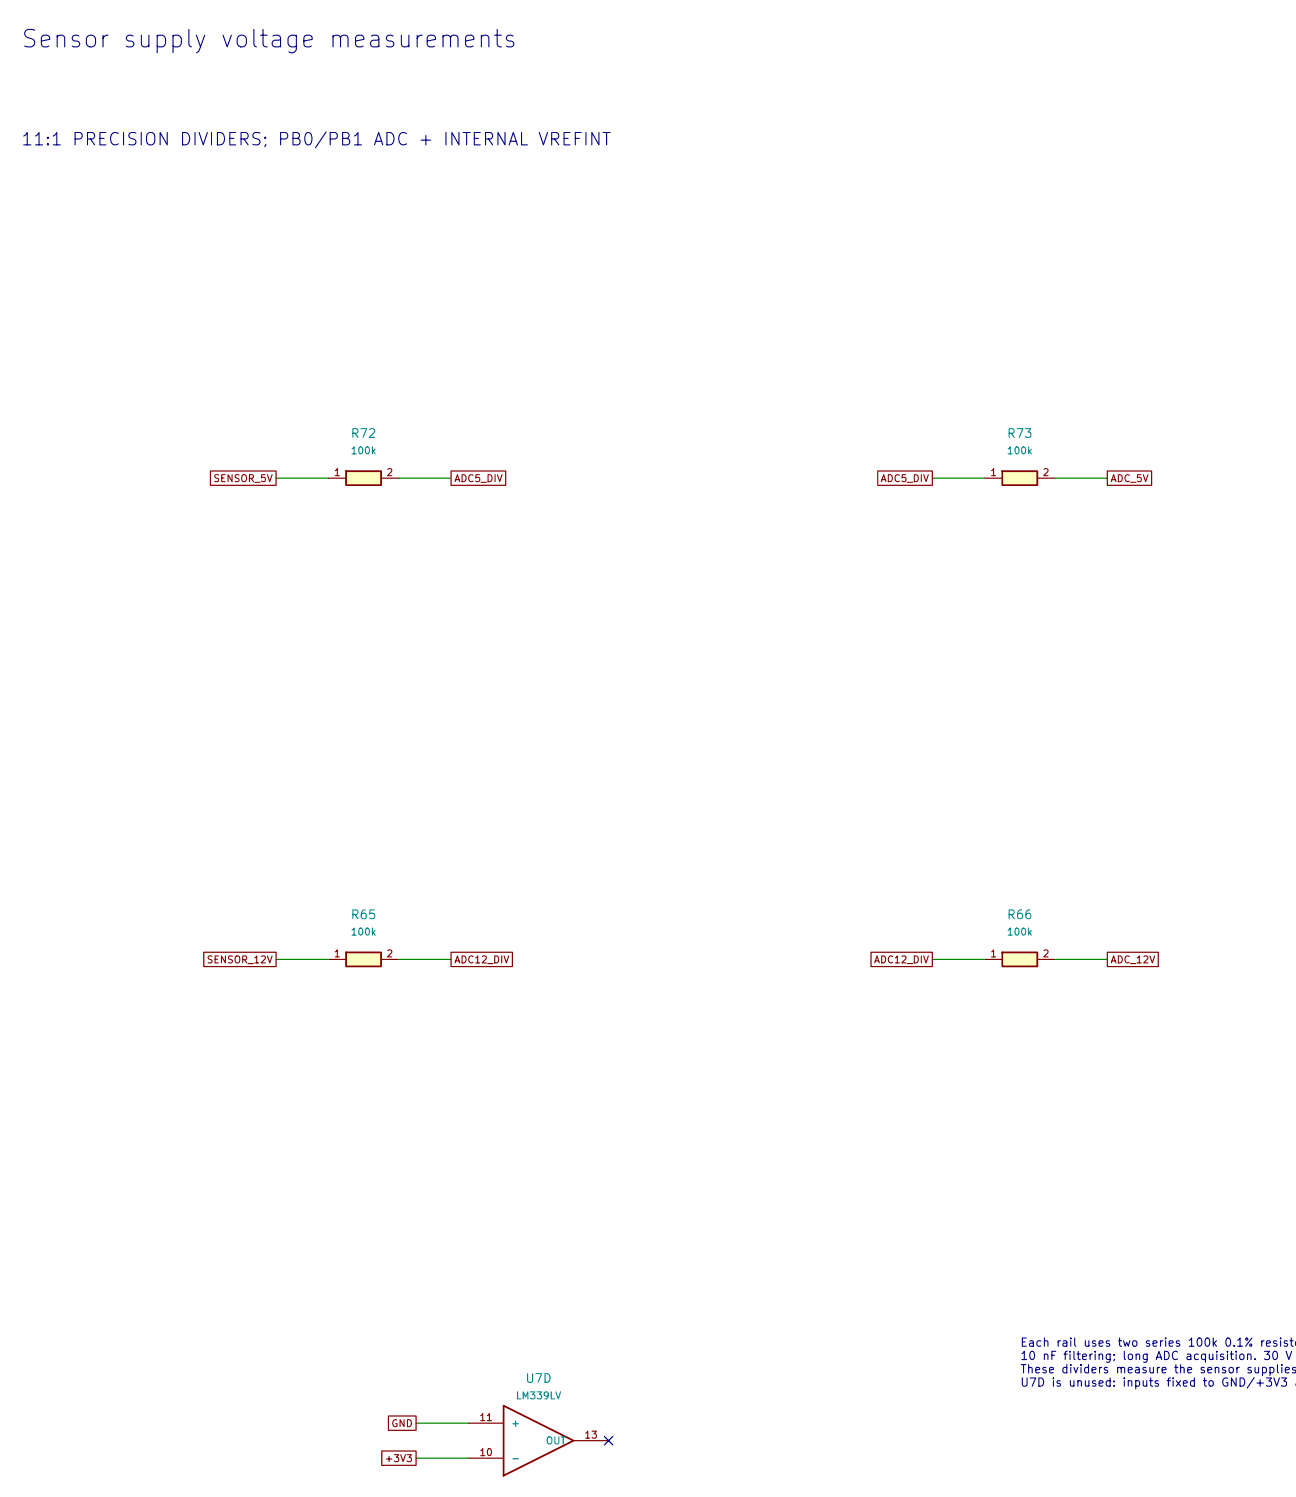
[picture p291: schematic rail_sense.kicad_sch, SC12 - Sensor supply voltage measurements, part in row 1, column 1]

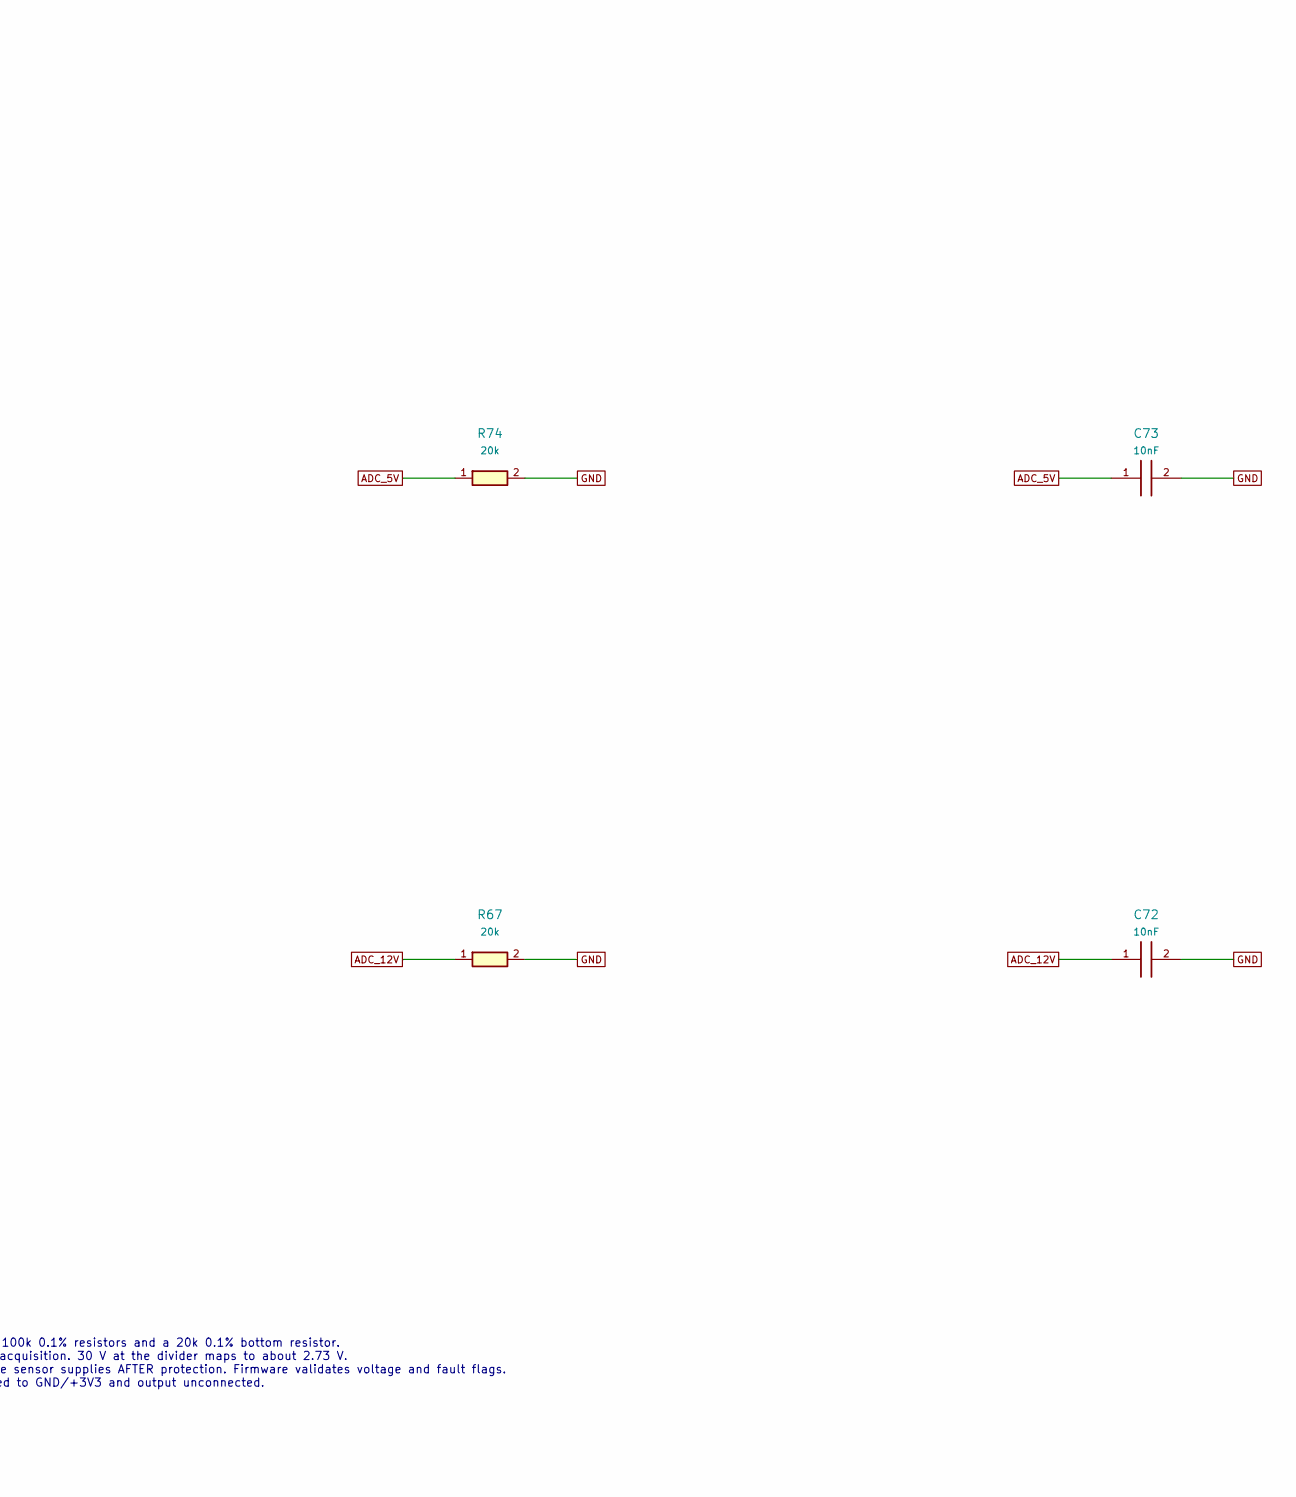
[picture p292: schematic rail_sense.kicad_sch, SC12 - Sensor supply voltage measurements, part in row 1, column 2]

Parts:
C72, C73: 10nF; C_0805_2012Metric; MPN CL21B103KBANNNC
R65, R66, R72, R73: 100k; R_0805_2012Metric; MPN RT0805BRD07100KL
R67, R74: 20k; R_0805_2012Metric; MPN RT0805BRD0720KL
U7: LM339LV; SOIC-14_3.9x8.7mm_P1.27mm; MPN LM339LVDR

Connections:
+3V3: U7.10 (-); also elsewhere on the board
ADC5_DIV: R72.2, R73.1
ADC12_DIV: R65.2, R66.1
ADC_5V: C73.1, R73.2, R74.1; also elsewhere on the board
ADC_12V: C72.1, R66.2, R67.1; also elsewhere on the board
GND: C72.2, C73.2, R67.2, R74.2, U7.11 (+); also elsewhere on the board
SENSOR_5V: R72.1; also elsewhere on the board
SENSOR_12V: R65.1; also elsewhere on the board

Notes on the sheet:
Sensor supply voltage measurements
11:1 PRECISION DIVIDERS; PB0/PB1 ADC + INTERNAL VREFINT
Each rail uses two series 100k 0.1% resistors and a 20k 0.1% bottom resistor. 10 nF filtering; long ADC acquisition. 30 V at the divider maps to about 2.73 V. These dividers measure the sensor supplies AFTER protection. Firmware validates voltage and fault flags. U7D is unused: inputs fixed to GND/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

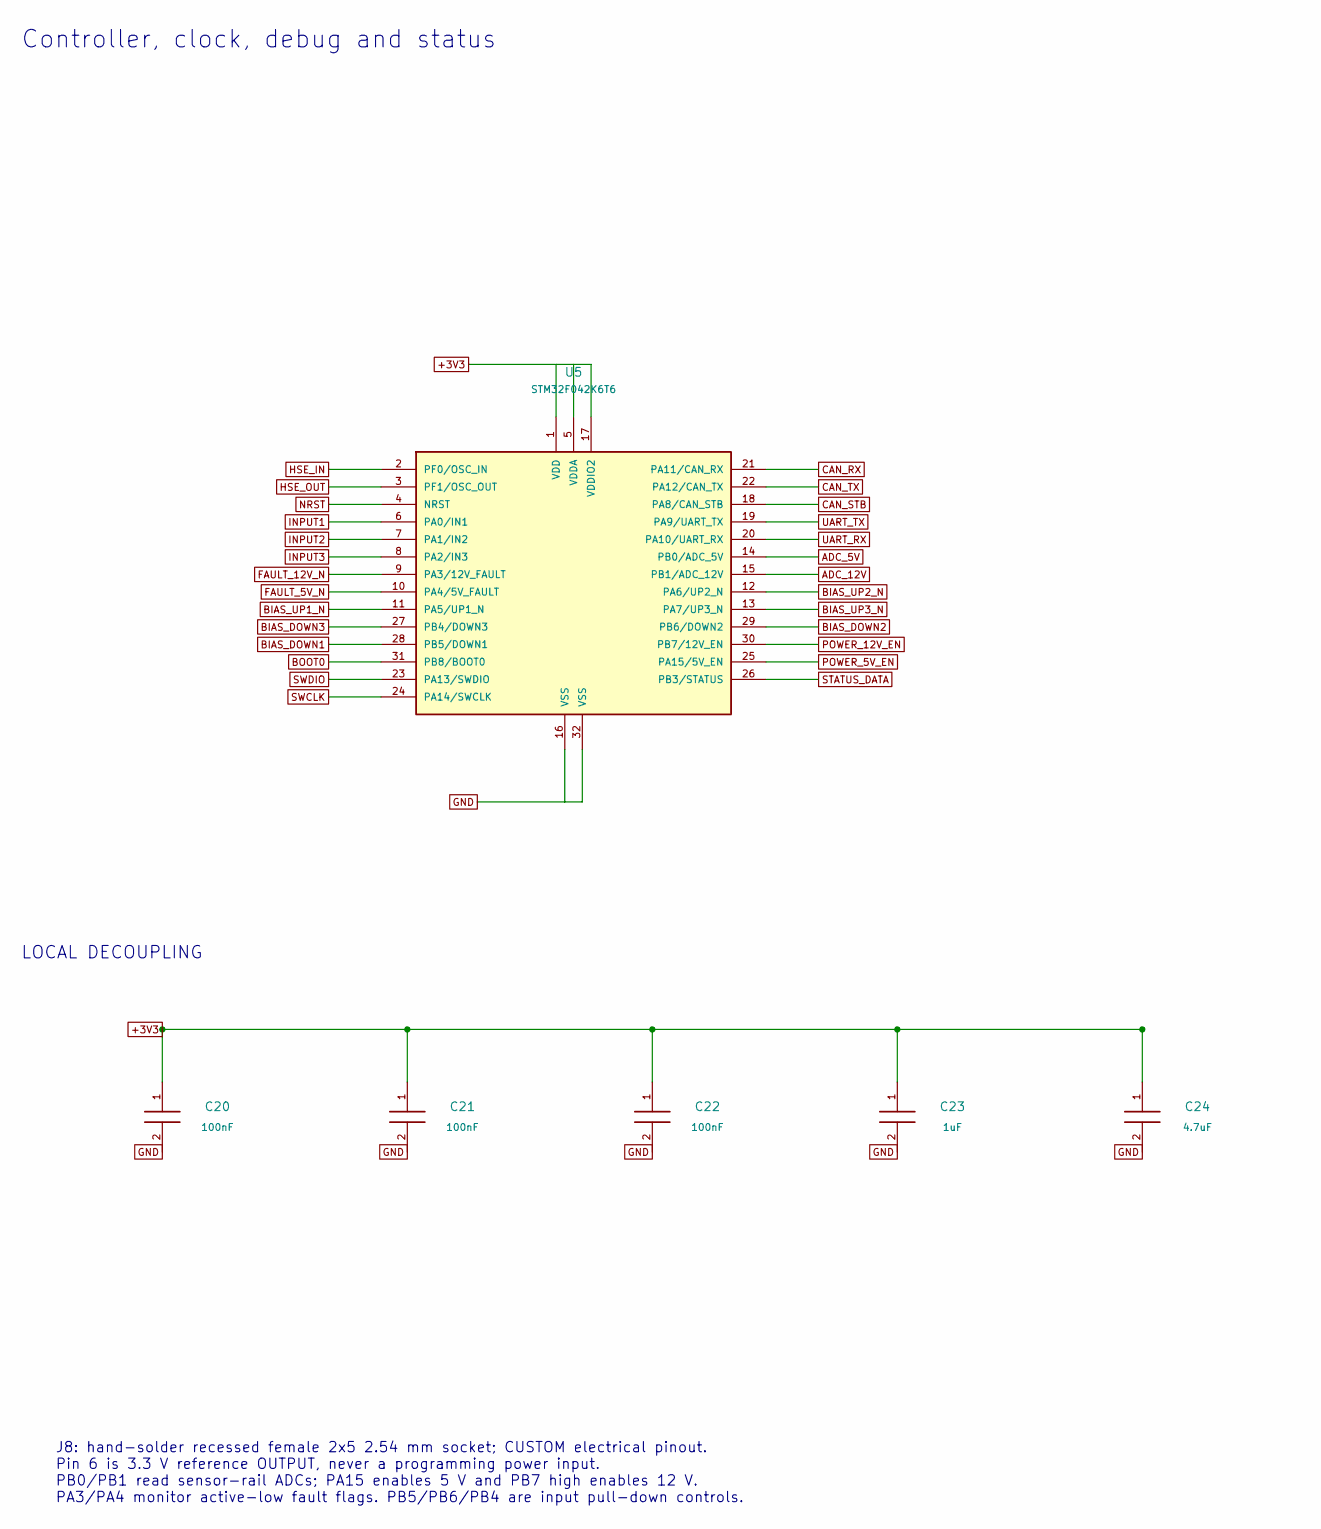
[picture p293: schematic controller.kicad_sch, SC12 - Controller, clock, debug and status, part in row 1, column 1]

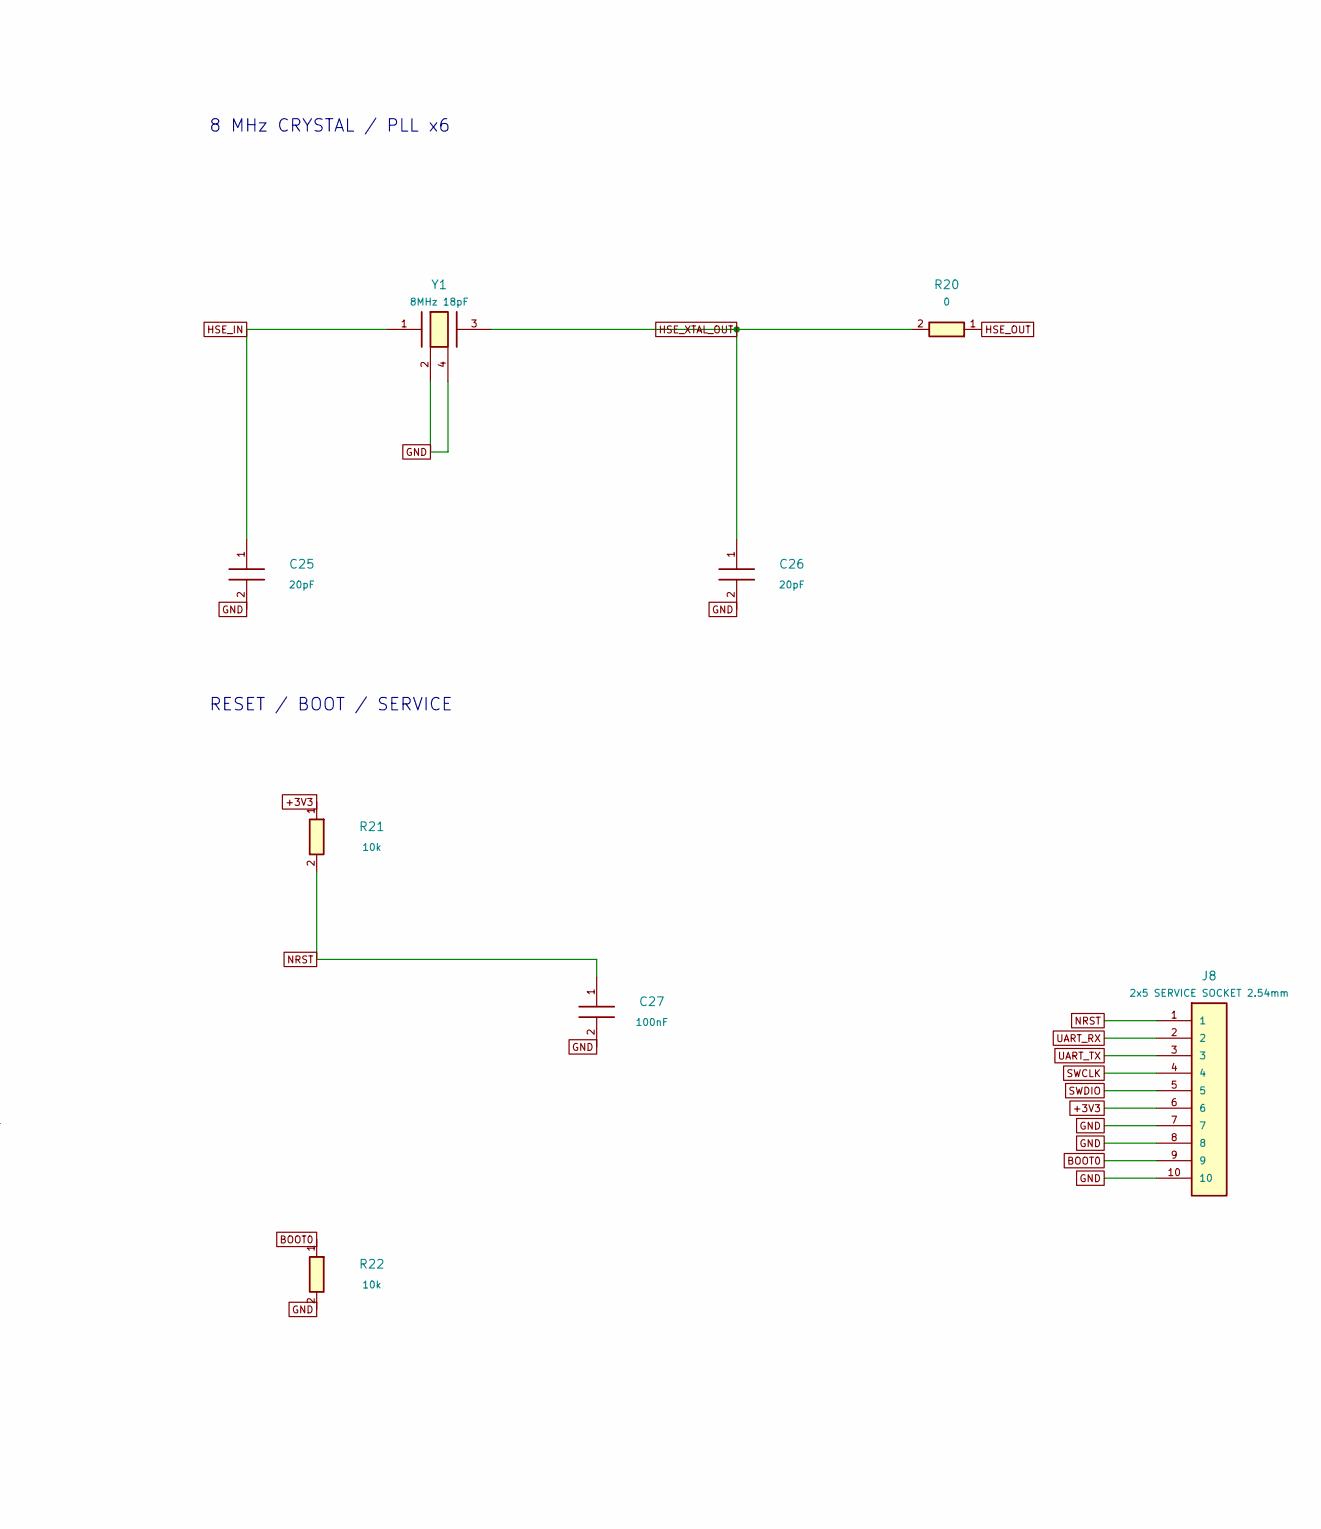
[picture p294: schematic controller.kicad_sch, SC12 - Controller, clock, debug and status, part in row 1, column 2]

Parts:
C20, C21, C22, C27: 100nF; C_0805_2012Metric; MPN CL21B104KCFNNNE
C23: 1uF; C_0805_2012Metric; MPN CL21B105KBFNNNE
C24: 4.7uF; C_0805_2012Metric; MPN CL21B475KAFNNNE
C25, C26: 20pF; C_0805_2012Metric; MPN CC0805JRNPO9BN200
J8: 2x5 SERVICE SOCKET 2.54mm; Service_2x05_P2.54mm; MPN PM254V-12-10P-H85
R20: 0; R_0805_2012Metric; MPN RC0805JR-070RL
R21, R22: 10k; R_0805_2012Metric; MPN 0805W8F1002T5E
U5: STM32F042K6T6; LQFP-32_7x7mm_P0.8mm; MPN STM32F042K6T6
Y1: 8MHz 18pF; Abracon_ABM3B_5.0x3.2mm; MPN ABM3B-8.000MHZ-B2-T

Connections:
+3V3: C20.1, C21.1, C22.1, C23.1, C24.1, J8.6, R21.1, U5.1 (VDD), U5.5 (VDDA), U5.17 (VDDIO2); also elsewhere on the board
ADC_5V: U5.14 (PB0/ADC_5V); also elsewhere on the board
ADC_12V: U5.15 (PB1/ADC_12V); also elsewhere on the board
BIAS_DOWN1: U5.28 (PB5/DOWN1); also elsewhere on the board
BIAS_DOWN2: U5.29 (PB6/DOWN2); also elsewhere on the board
BIAS_DOWN3: U5.27 (PB4/DOWN3); also elsewhere on the board
BIAS_UP1_N: U5.11 (PA5/UP1_N); also elsewhere on the board
BIAS_UP2_N: U5.12 (PA6/UP2_N); also elsewhere on the board
BIAS_UP3_N: U5.13 (PA7/UP3_N); also elsewhere on the board
BOOT0: J8.9, R22.1, U5.31 (PB8/BOOT0)
CAN_RX: U5.21 (PA11/CAN_RX); also elsewhere on the board
CAN_STB: U5.18 (PA8/CAN_STB); also elsewhere on the board
CAN_TX: U5.22 (PA12/CAN_TX); also elsewhere on the board
FAULT_5V_N: U5.10 (PA4/5V_FAULT); also elsewhere on the board
FAULT_12V_N: U5.9 (PA3/12V_FAULT); also elsewhere on the board
GND: C20.2, C21.2, C22.2, C23.2, C24.2, C25.2, C26.2, C27.2, J8.7, J8.8, J8.10, R22.2, U5.16 (VSS), U5.32 (VSS), Y1.2, Y1.4; also elsewhere on the board
HSE_IN: C25.1, U5.2 (PF0/OSC_IN), Y1.1
HSE_OUT: R20.1, U5.3 (PF1/OSC_OUT)
HSE_XTAL_OUT: C26.1, R20.2, Y1.3
INPUT1: U5.6 (PA0/IN1); also elsewhere on the board
INPUT2: U5.7 (PA1/IN2); also elsewhere on the board
INPUT3: U5.8 (PA2/IN3); also elsewhere on the board
NRST: C27.1, J8.1, R21.2, U5.4 (NRST)
POWER_5V_EN: U5.25 (PA15/5V_EN); also elsewhere on the board
POWER_12V_EN: U5.30 (PB7/12V_EN); also elsewhere on the board
STATUS_DATA: U5.26 (PB3/STATUS); also elsewhere on the board
SWCLK: J8.4, U5.24 (PA14/SWCLK)
SWDIO: J8.5, U5.23 (PA13/SWDIO)
UART_RX: J8.2, U5.20 (PA10/UART_RX)
UART_TX: J8.3, U5.19 (PA9/UART_TX)

Notes on the sheet:
Controller, clock, debug and status
8 MHz CRYSTAL / PLL x6
RESET / BOOT / SERVICE
LOCAL DECOUPLING
J8: hand-solder recessed female 2x5 2.54 mm socket; CUSTOM electrical pinout. Pin 6 is 3.3 V reference OUTPUT, never a programming power input. PB0/PB1 read sensor-rail ADCs; PA15 enables 5 V and PB7 high enables 12 V. PA3/PA4 monitor active-low fault flags. PB5/PB6/PB4 are input pull-down controls.

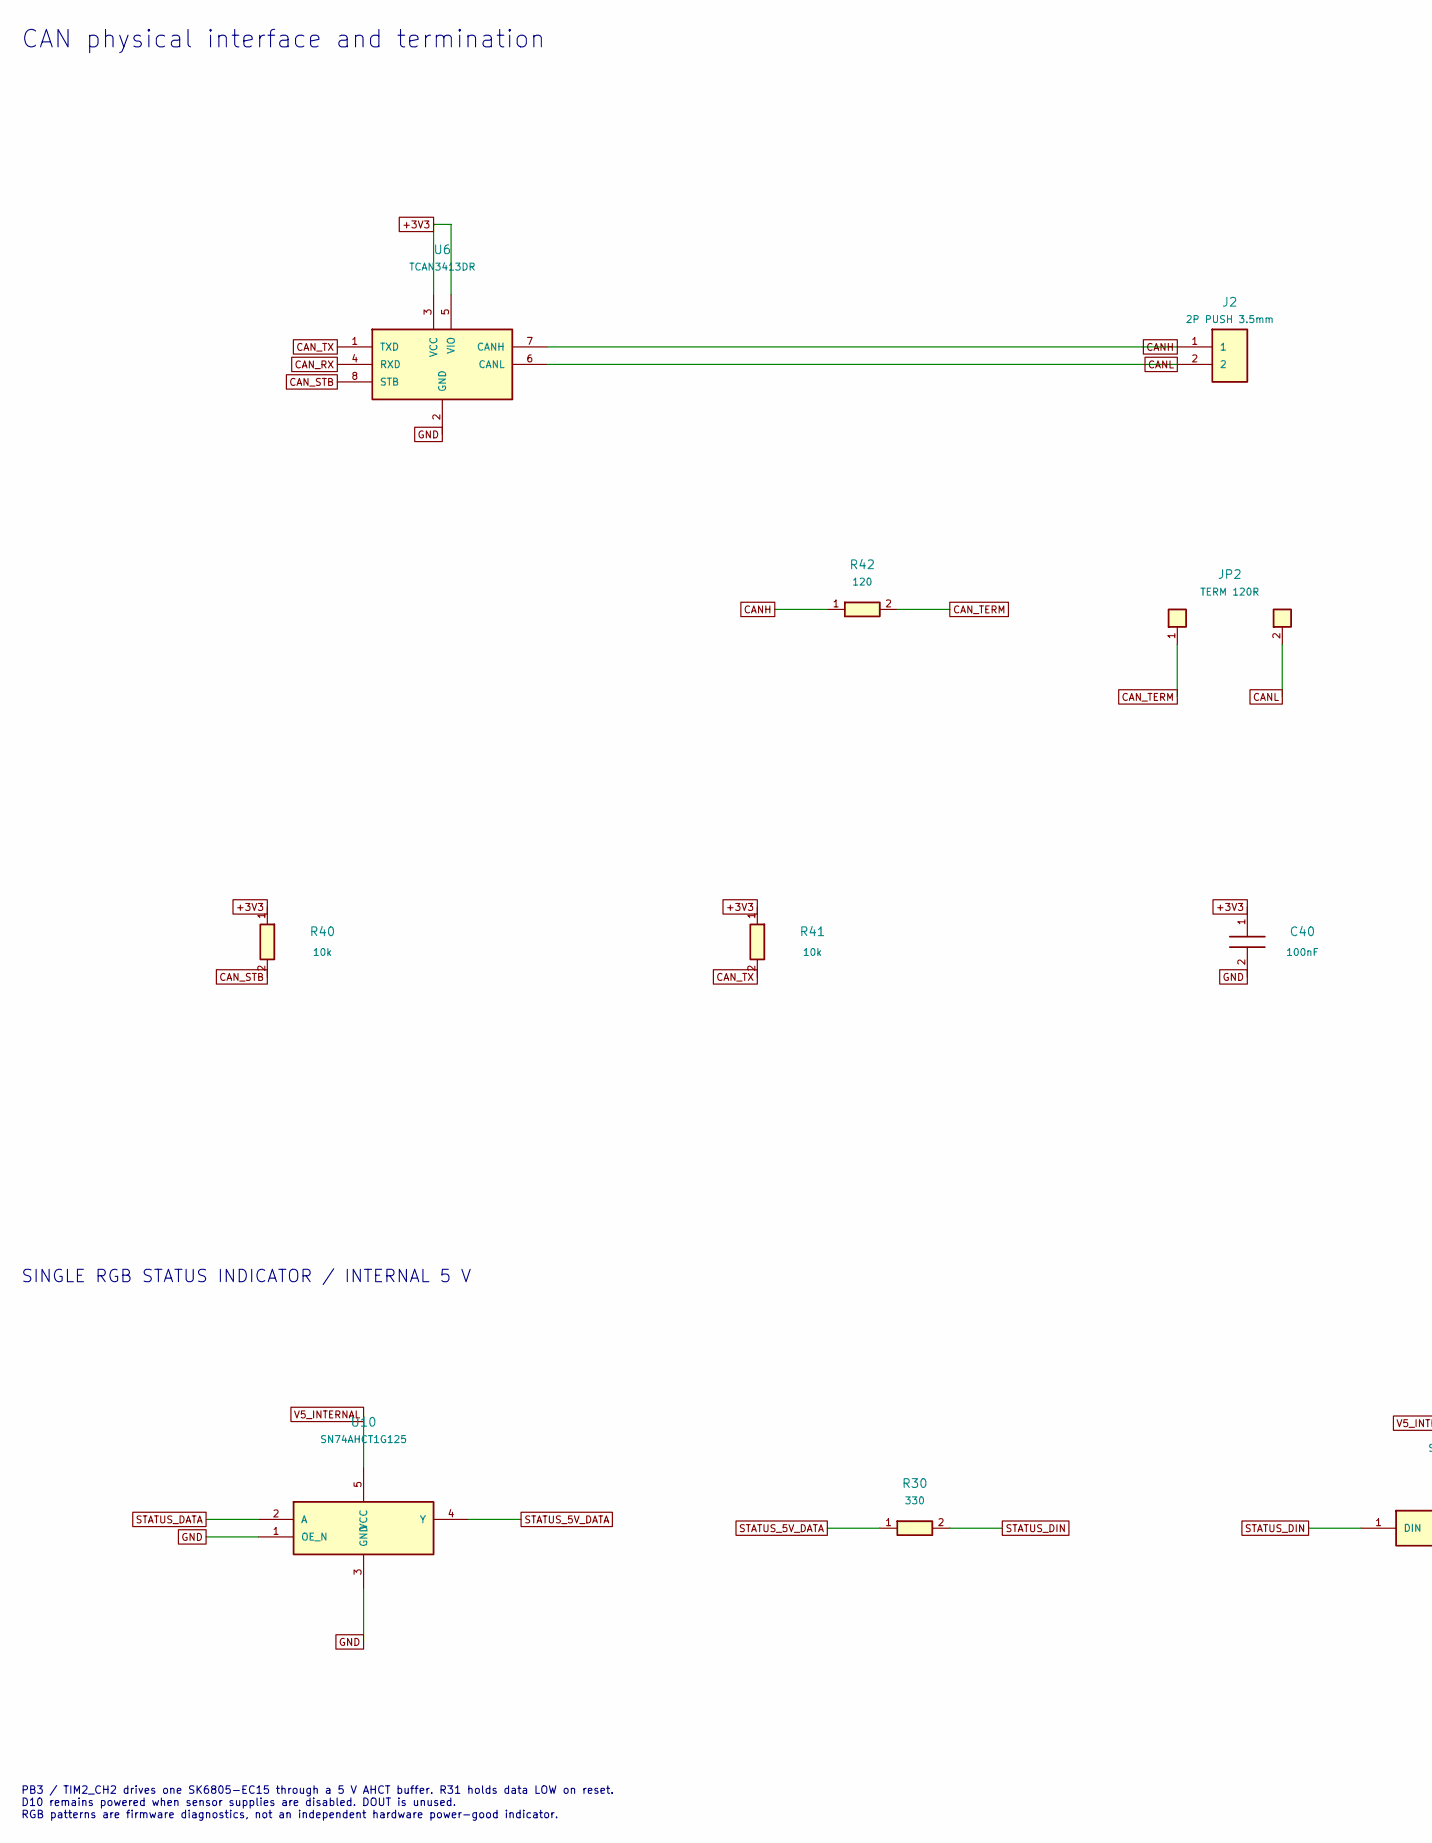
[picture p295: schematic can.kicad_sch, SC12 - CAN physical interface and termination, part in row 1, column 1]

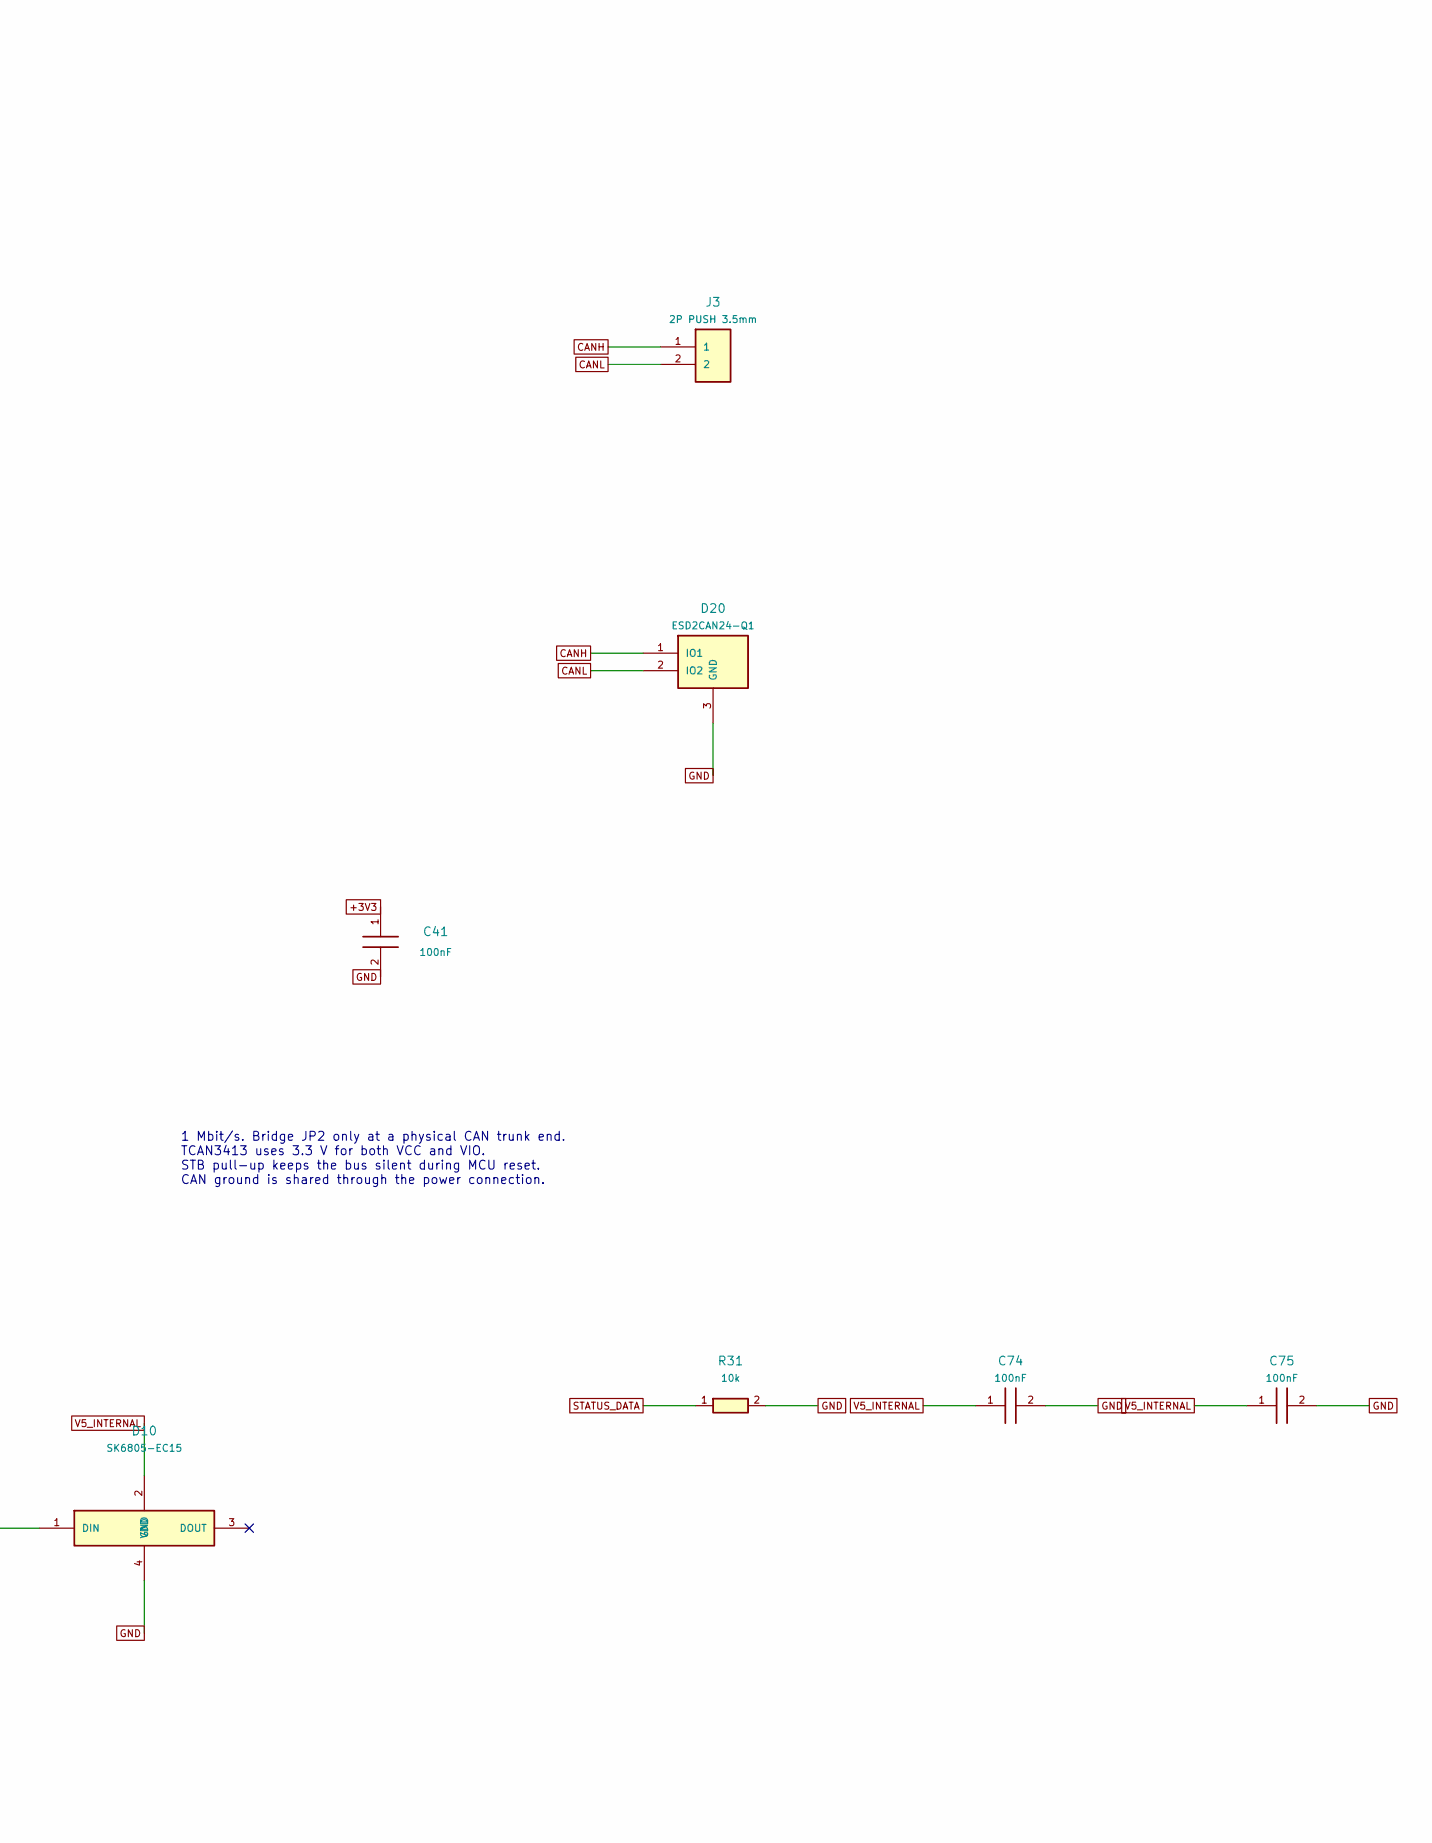
[picture p296: schematic can.kicad_sch, SC12 - CAN physical interface and termination, part in row 1, column 2]

Parts:
C40, C41, C74, C75: 100nF; C_0805_2012Metric; MPN CL21B104KCFNNNE
D10: SK6805-EC15; LED_SK6805_EC15; MPN SK6805-EC15
D20: ESD2CAN24-Q1; SOT-23; MPN ESD2CAN24DBZRQ1
J2, J3: 2P PUSH 3.5mm; Weidmuller_LSF_90_2P; MPN 1824420000
JP2: TERM 120R; SolderSelector_2
R30: 330; R_0805_2012Metric; MPN 0805W8F3300T5E
R31, R40, R41: 10k; R_0805_2012Metric; MPN 0805W8F1002T5E
R42: 120; R_1206_3216Metric; MPN 1206W4F1200T5E
U6: TCAN3413DR; SOIC-8_3.9x4.9mm_P1.27mm; MPN TCAN3413DR
U10: SN74AHCT1G125; SOT-23-5; MPN SN74AHCT1G125DBVR

Connections:
+3V3: C40.1, C41.1, R40.1, R41.1, U6.3 (VCC), U6.5 (VIO); also elsewhere on the board
CANH: D20.1 (IO1), J2.1, J3.1, R42.1, U6.7 (CANH)
CANL: D20.2 (IO2), J2.2, J3.2, JP2.2, U6.6 (CANL)
CAN_RX: U6.4 (RXD); also elsewhere on the board
CAN_STB: R40.2, U6.8 (STB); also elsewhere on the board
CAN_TERM: JP2.1, R42.2
CAN_TX: R41.2, U6.1 (TXD); also elsewhere on the board
GND: C40.2, C41.2, C74.2, C75.2, D10.4 (GND), D20.3 (GND), R31.2, U6.2 (GND), U10.1 (OE_N), U10.3 (GND); also elsewhere on the board
STATUS_5V_DATA: R30.1, U10.4 (Y)
STATUS_DATA: R31.1, U10.2 (A); also elsewhere on the board
STATUS_DIN: D10.1 (DIN), R30.2
V5_INTERNAL: C74.1, C75.1, D10.2 (VDD), U10.5 (VCC); also elsewhere on the board

Notes on the sheet:
CAN physical interface and termination
1 Mbit/s. Bridge JP2 only at a physical CAN trunk end. TCAN3413 uses 3.3 V for both VCC and VIO. STB pull-up keeps the bus silent during MCU reset. CAN ground is shared through the power connection.
SINGLE RGB STATUS INDICATOR / INTERNAL 5 V
PB3 / TIM2_CH2 drives one SK6805-EC15 through a 5 V AHCT buffer. R31 holds data LOW on reset. D10 remains powered when sensor supplies are disabled. DOUT is unused. RGB patterns are firmware diagnostics, not an independent hardware power-good indicator.

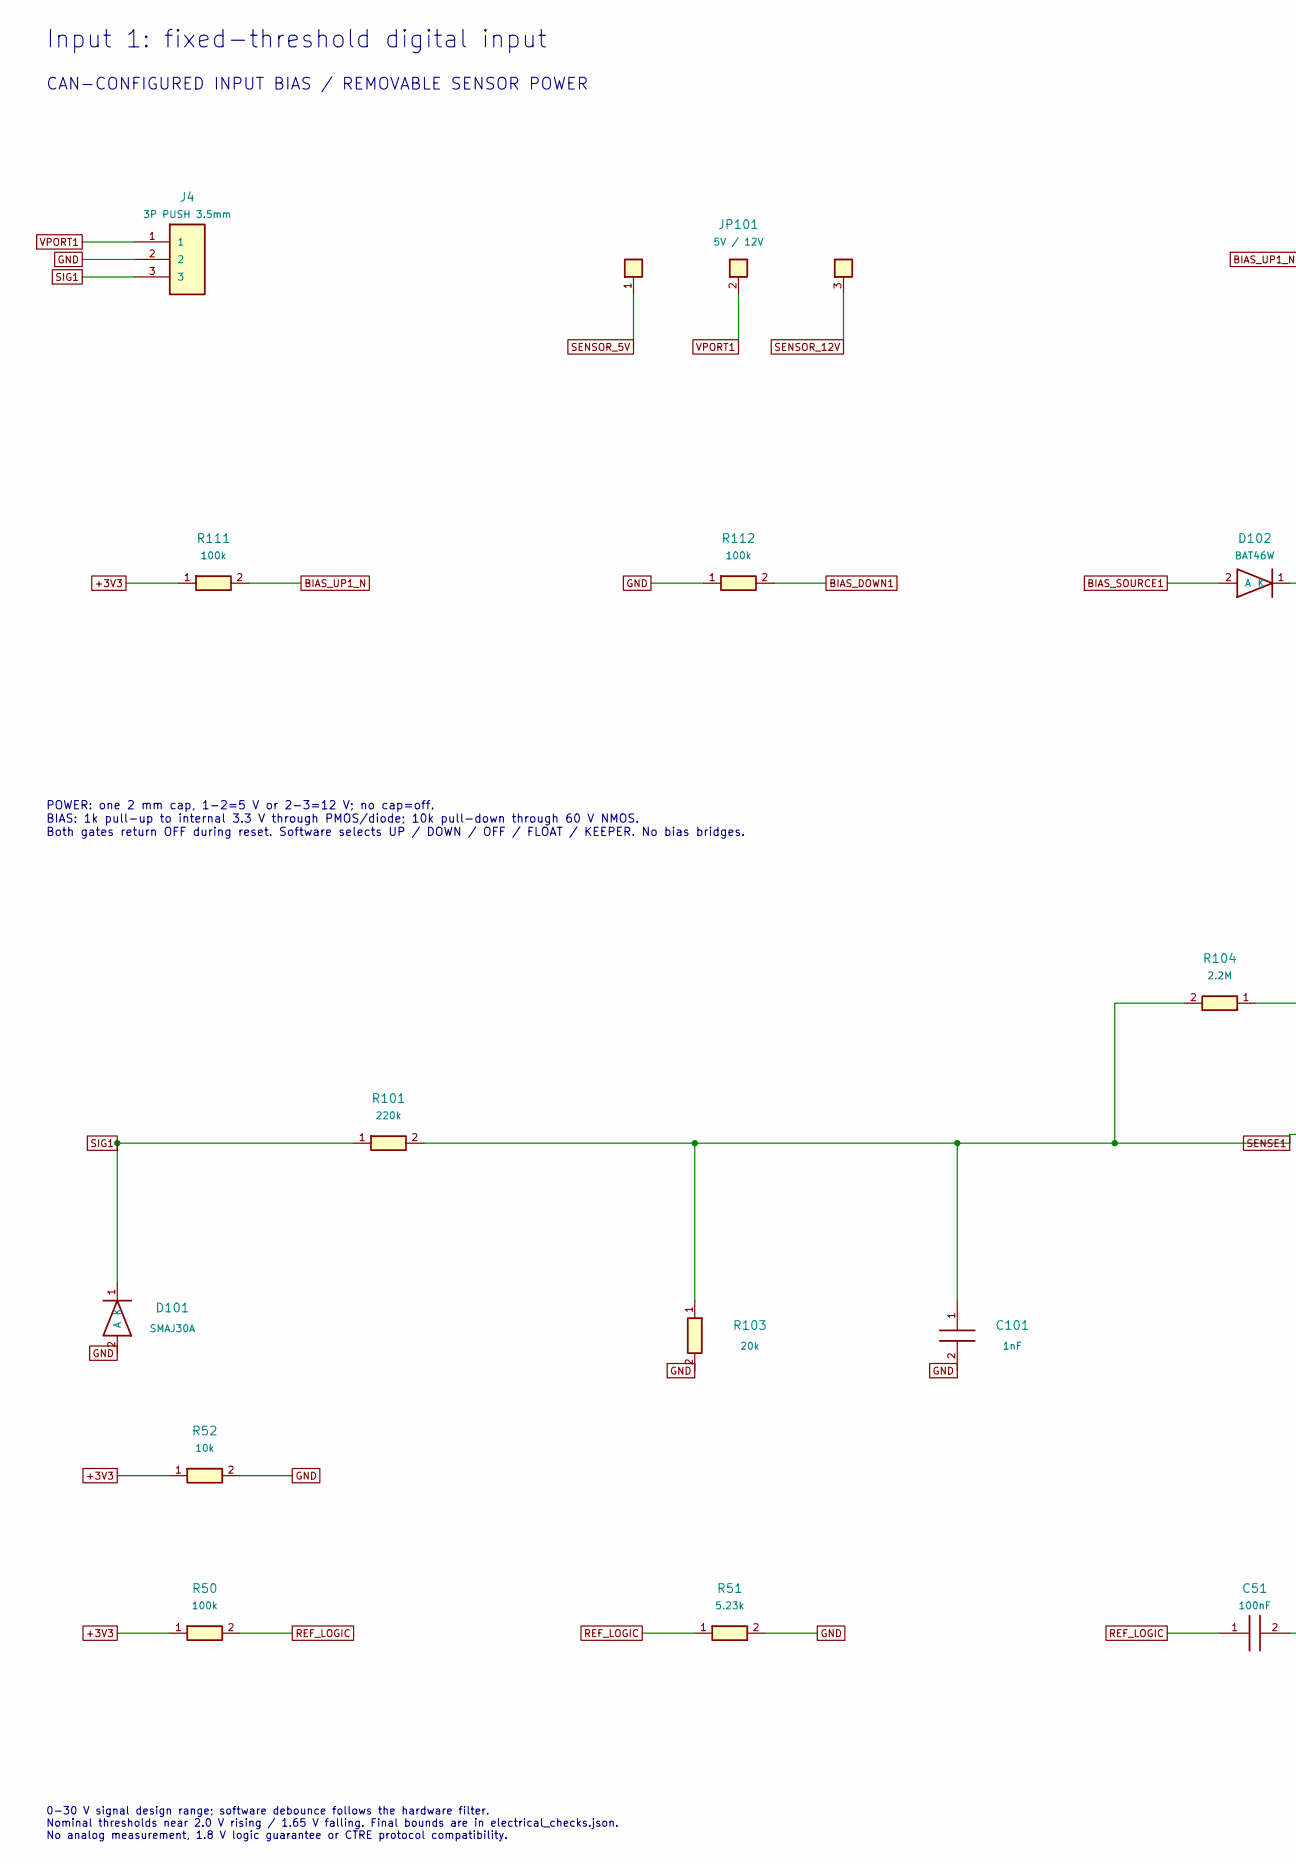
[picture p297: schematic input1.kicad_sch, SC12 - Input 1: fixed-threshold digital input, part in row 1, column 1]

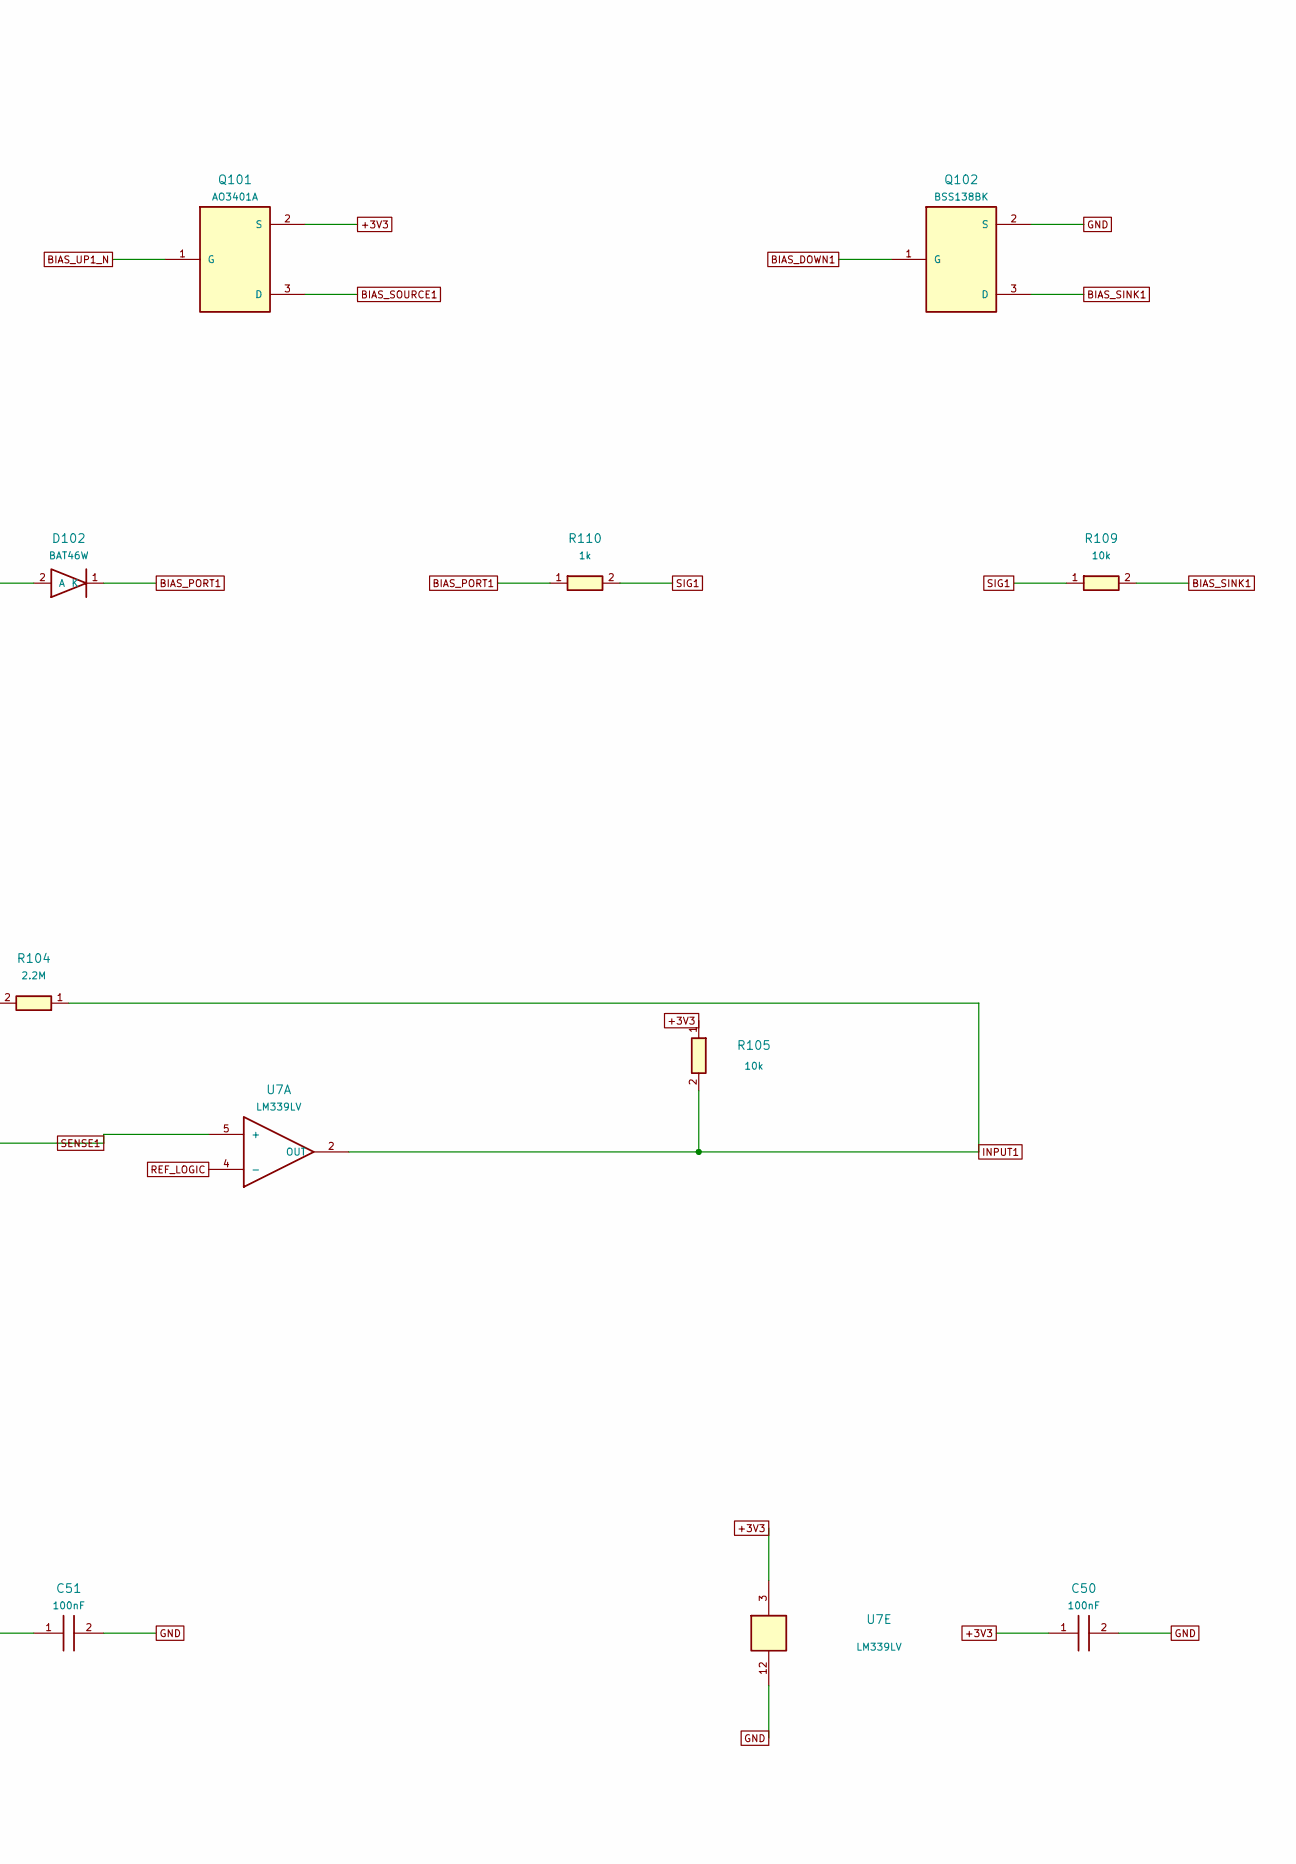
[picture p298: schematic input1.kicad_sch, SC12 - Input 1: fixed-threshold digital input, part in row 1, column 2]

Parts:
C50, C51: 100nF; C_0805_2012Metric; MPN CL21B104KCFNNNE
C101: 1nF; C_0805_2012Metric; MPN CC0805JRNPO9BN102
D101: SMAJ30A; D_SMA; MPN SMAJ30A
D102: BAT46W; D_SOD-123; MPN BAT46W-E3-18
J4: 3P PUSH 3.5mm; Weidmuller_LSF_90_3P; MPN 1824430000
JP101: 5V / 12V; PinHeader_1x03_P2.00mm_Vertical; MPN M22-2010305
Q101: AO3401A; SOT-23; MPN AO3401A
Q102: BSS138BK; SOT-23; MPN BSS138BK,215
R50, R111, R112: 100k; R_0805_2012Metric; MPN 0805W8F1003T5E
R51: 5.23k; R_0805_2012Metric; MPN 0805W8F5231T5E
R52, R105: 10k; R_0805_2012Metric; MPN 0805W8F1002T5E
R101: 220k; R_0805_2012Metric; MPN 0805W8F2203T5E
R103: 20k; R_0805_2012Metric; MPN RC0805FR-0720KL
R104: 2.2M; R_0805_2012Metric; MPN RC0805FR-072M2L
R109: 10k; R_1206_3216Metric; MPN RC1206FR-0710KL
R110: 1k; R_0805_2012Metric; MPN 0805W8F1001T5E
U7: LM339LV; SOIC-14_3.9x8.7mm_P1.27mm; MPN LM339LVDR

Connections:
+3V3: C50.1, Q101.2 (S), R50.1, R52.1, R105.1, R111.1, U7.3; also elsewhere on the board
BIAS_DOWN1: Q102.1 (G), R112.2; also elsewhere on the board
BIAS_PORT1: D102.1 (K), R110.1
BIAS_SINK1: Q102.3 (D), R109.2
BIAS_SOURCE1: D102.2 (A), Q101.3 (D)
BIAS_UP1_N: Q101.1 (G), R111.2; also elsewhere on the board
GND: C50.2, C51.2, C101.2, D101.2 (A), J4.2, Q102.2 (S), R51.2, R52.2, R103.2, R112.1, U7.12; also elsewhere on the board
INPUT1: R104.1, R105.2, U7.2 (OUT); also elsewhere on the board
REF_LOGIC: C51.1, R50.2, R51.1, U7.4 (-); also elsewhere on the board
SENSE1: C101.1, R101.2, R103.1, R104.2, U7.5 (+)
SENSOR_5V: JP101.1; also elsewhere on the board
SENSOR_12V: JP101.3; also elsewhere on the board
SIG1: D101.1 (K), J4.3, R101.1, R109.1, R110.2
VPORT1: J4.1, JP101.2

Notes on the sheet:
Input 1: fixed-threshold digital input
CAN-CONFIGURED INPUT BIAS / REMOVABLE SENSOR POWER
POWER: one 2 mm cap, 1-2=5 V or 2-3=12 V; no cap=off. BIAS: 1k pull-up to internal 3.3 V through PMOS/diode; 10k pull-down through 60 V NMOS. Both gates return OFF during reset. Software selects UP / DOWN / OFF / FLOAT / KEEPER. No bias bridges.
0-30 V signal design range; software debounce follows the hardware filter. Nominal thresholds near 2.0 V rising / 1.65 V falling. Final bounds are in electrical_checks.json. No analog measurement, 1.8 V logic guarantee or CTRE protocol compatibility.
