barkinvar/sugerCANe/current/hardware/FRC_Sensor_CAN.kicad_pcb

## KiCad design current/hardware/FRC_Sensor_CAN.kicad_pcb (continued)

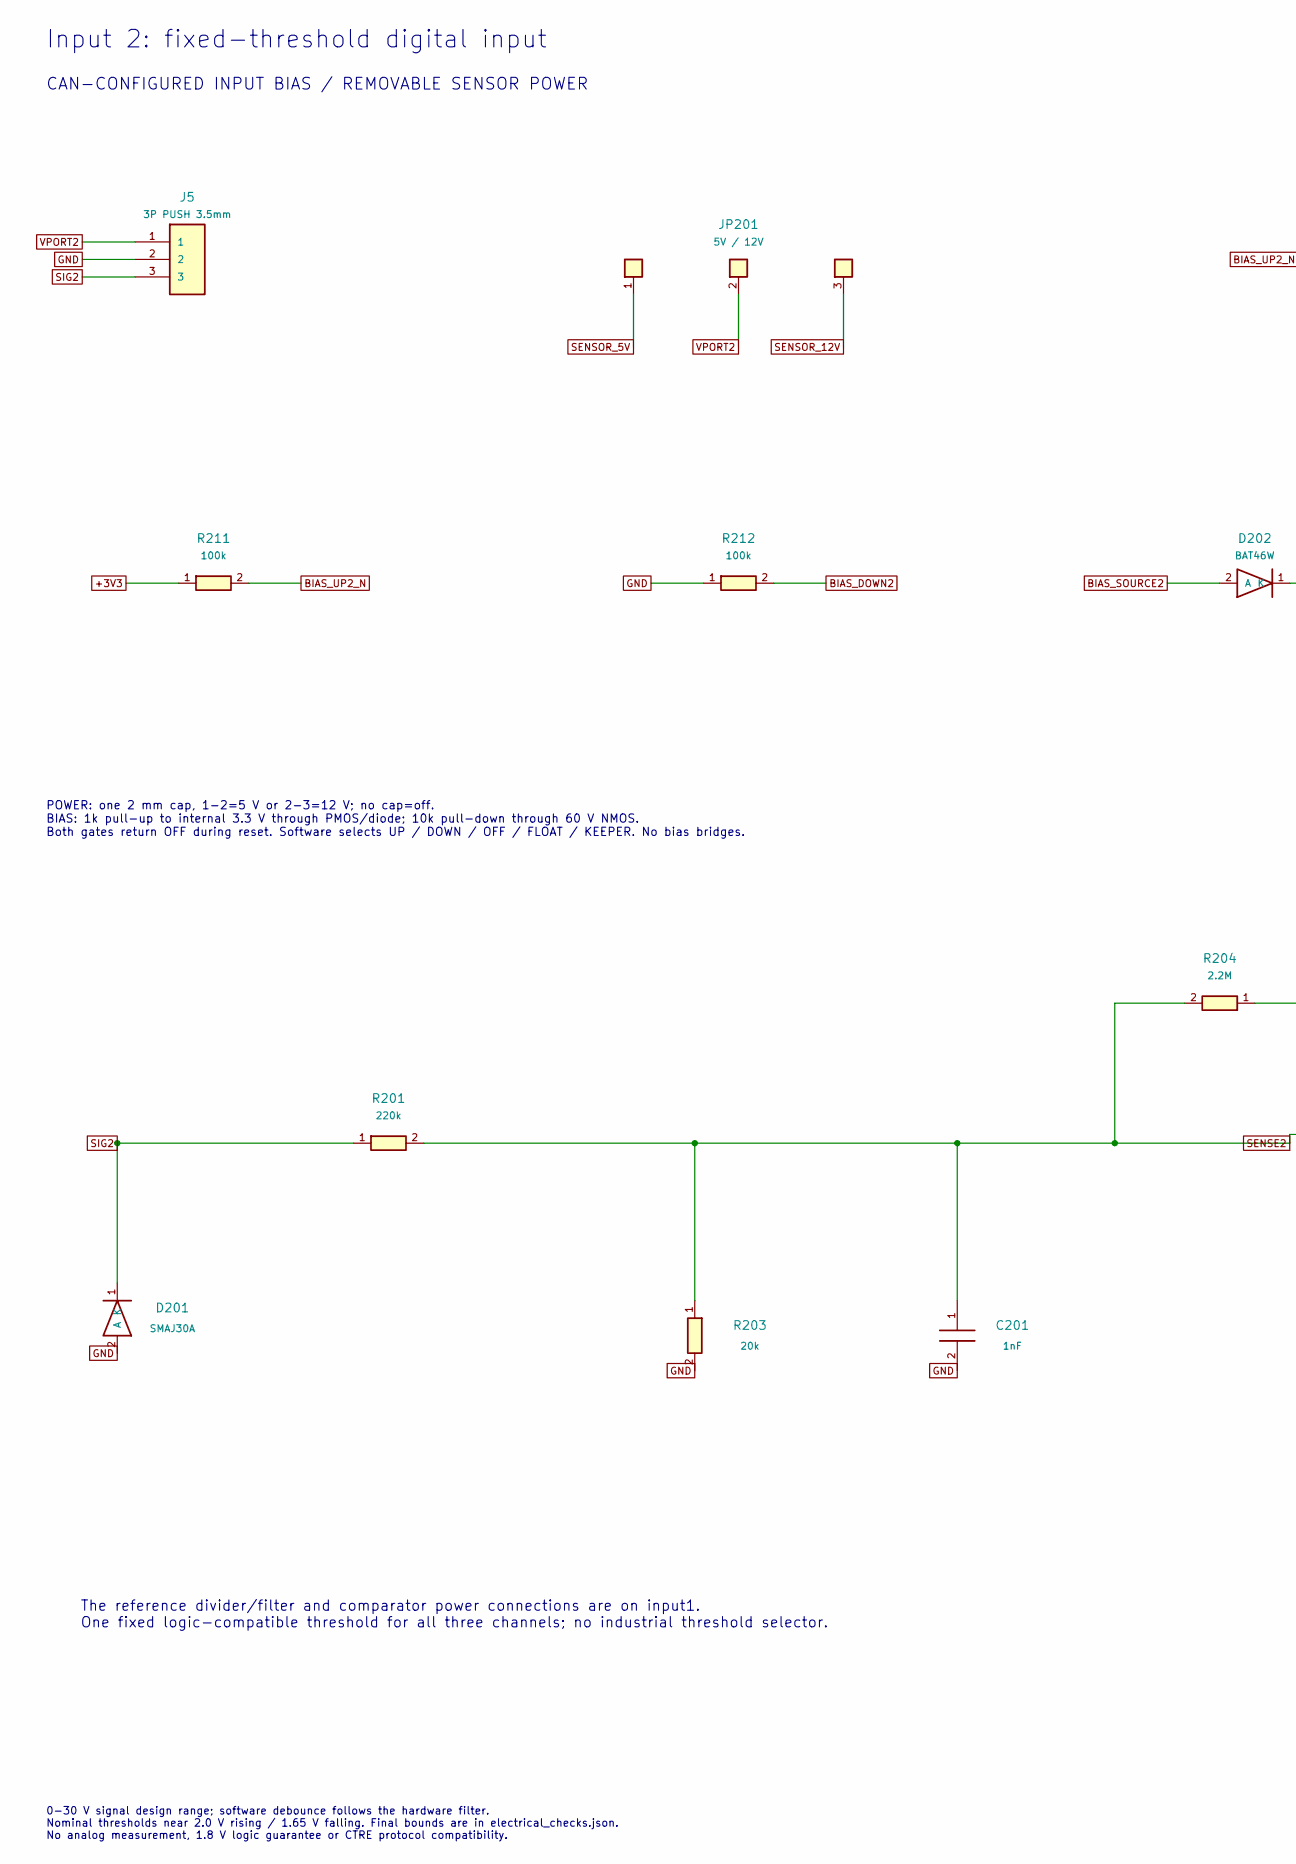
[picture p299: schematic input2.kicad_sch, SC12 - Input 2: fixed-threshold digital input, part in row 1, column 1]

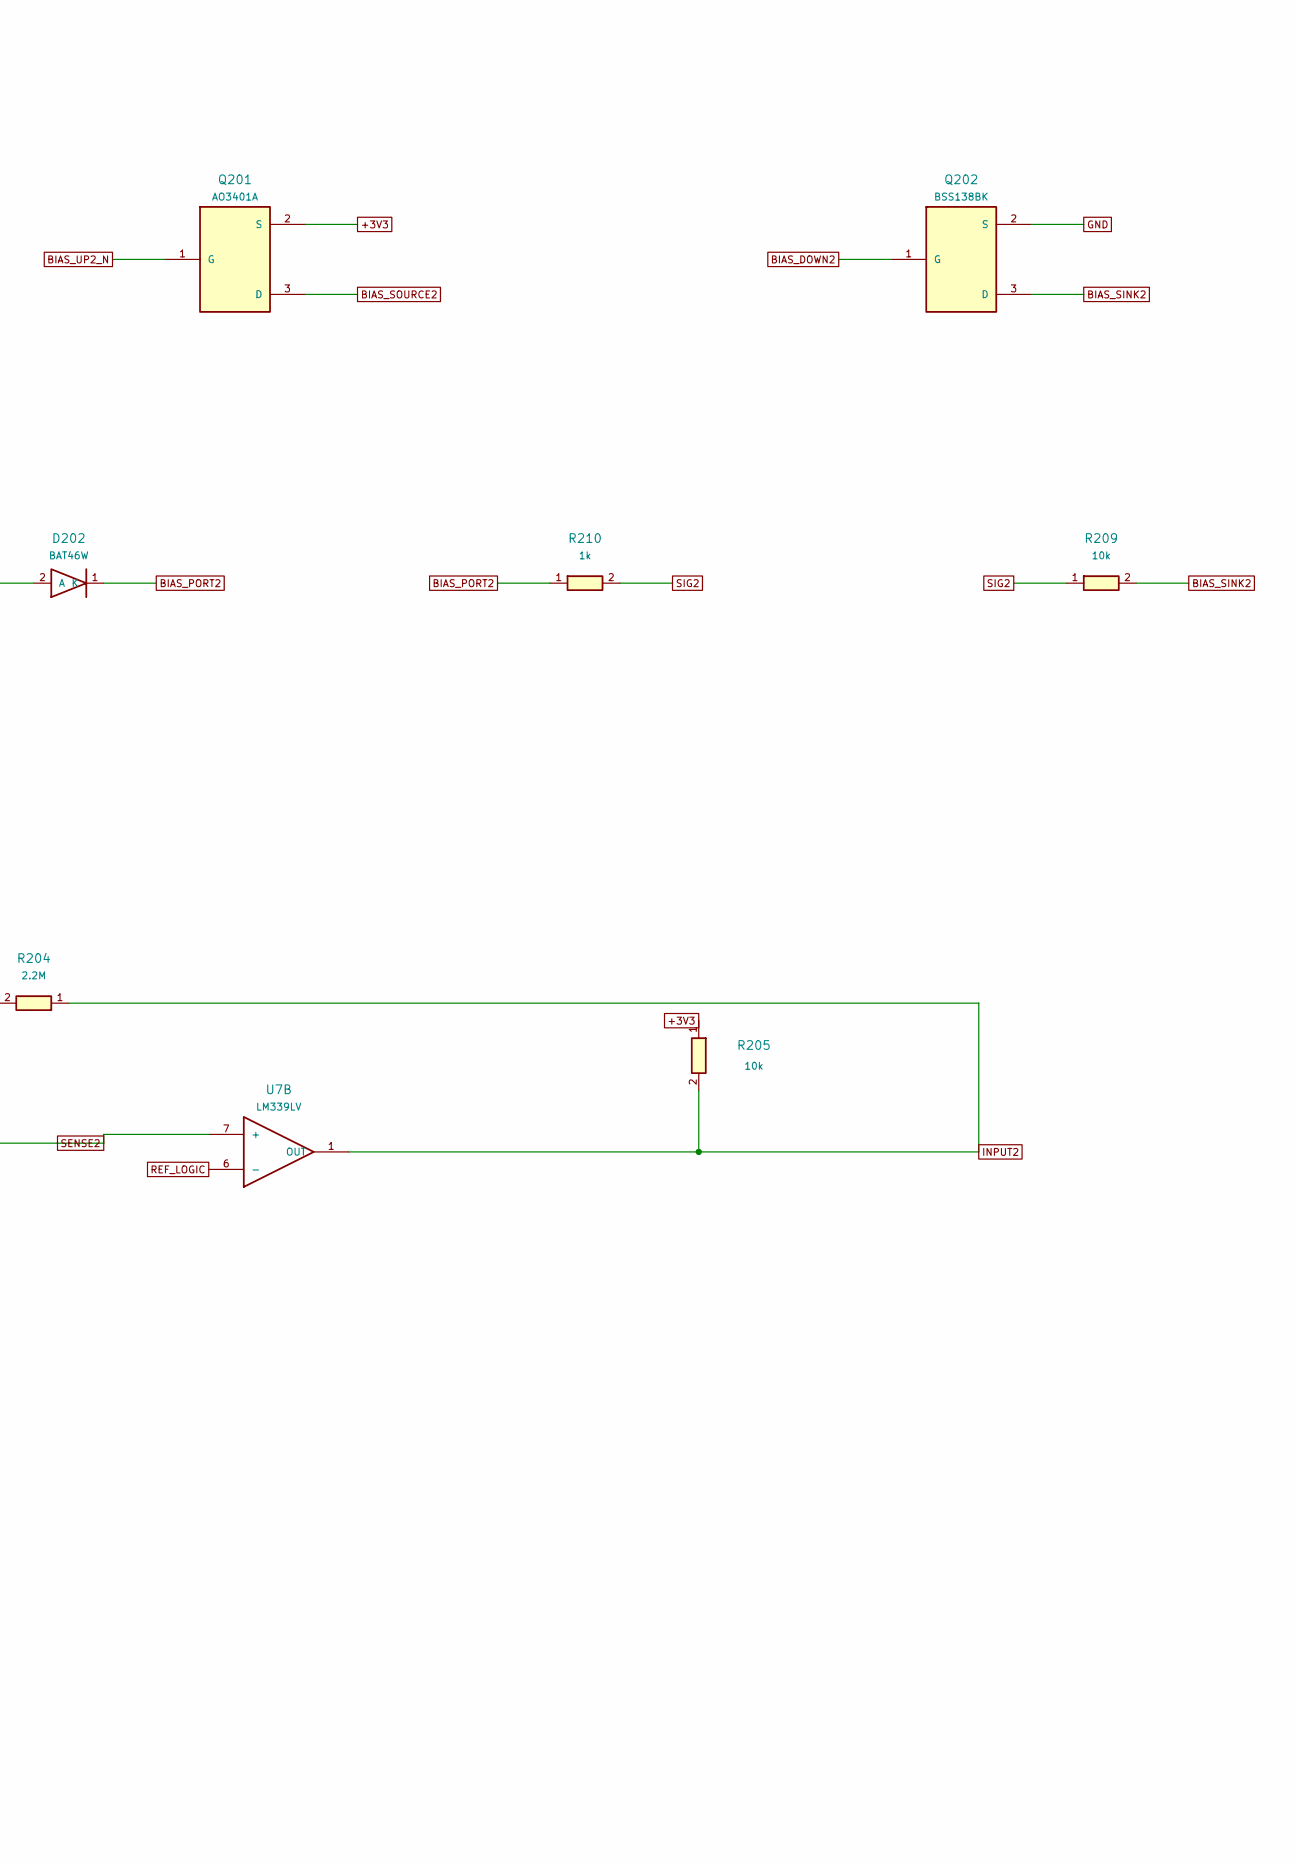
[picture p300: schematic input2.kicad_sch, SC12 - Input 2: fixed-threshold digital input, part in row 1, column 2]

Parts:
C201: 1nF; C_0805_2012Metric; MPN CC0805JRNPO9BN102
D201: SMAJ30A; D_SMA; MPN SMAJ30A
D202: BAT46W; D_SOD-123; MPN BAT46W-E3-18
J5: 3P PUSH 3.5mm; Weidmuller_LSF_90_3P; MPN 1824430000
JP201: 5V / 12V; PinHeader_1x03_P2.00mm_Vertical; MPN M22-2010305
Q201: AO3401A; SOT-23; MPN AO3401A
Q202: BSS138BK; SOT-23; MPN BSS138BK,215
R201: 220k; R_0805_2012Metric; MPN 0805W8F2203T5E
R203: 20k; R_0805_2012Metric; MPN RC0805FR-0720KL
R204: 2.2M; R_0805_2012Metric; MPN RC0805FR-072M2L
R205: 10k; R_0805_2012Metric; MPN 0805W8F1002T5E
R209: 10k; R_1206_3216Metric; MPN RC1206FR-0710KL
R210: 1k; R_0805_2012Metric; MPN 0805W8F1001T5E
R211, R212: 100k; R_0805_2012Metric; MPN 0805W8F1003T5E
U7: LM339LV; SOIC-14_3.9x8.7mm_P1.27mm; MPN LM339LVDR

Connections:
+3V3: Q201.2 (S), R205.1, R211.1; also elsewhere on the board
BIAS_DOWN2: Q202.1 (G), R212.2; also elsewhere on the board
BIAS_PORT2: D202.1 (K), R210.1
BIAS_SINK2: Q202.3 (D), R209.2
BIAS_SOURCE2: D202.2 (A), Q201.3 (D)
BIAS_UP2_N: Q201.1 (G), R211.2; also elsewhere on the board
GND: C201.2, D201.2 (A), J5.2, Q202.2 (S), R203.2, R212.1; also elsewhere on the board
INPUT2: R204.1, R205.2, U7.1 (OUT); also elsewhere on the board
REF_LOGIC: U7.6 (-); also elsewhere on the board
SENSE2: C201.1, R201.2, R203.1, R204.2, U7.7 (+)
SENSOR_5V: JP201.1; also elsewhere on the board
SENSOR_12V: JP201.3; also elsewhere on the board
SIG2: D201.1 (K), J5.3, R201.1, R209.1, R210.2
VPORT2: J5.1, JP201.2

Notes on the sheet:
Input 2: fixed-threshold digital input
CAN-CONFIGURED INPUT BIAS / REMOVABLE SENSOR POWER
POWER: one 2 mm cap, 1-2=5 V or 2-3=12 V; no cap=off. BIAS: 1k pull-up to internal 3.3 V through PMOS/diode; 10k pull-down through 60 V NMOS. Both gates return OFF during reset. Software selects UP / DOWN / OFF / FLOAT / KEEPER. No bias bridges.
The reference divider/filter and comparator power connections are on input1. One fixed logic-compatible threshold for all three channels; no industrial threshold selector.
0-30 V signal design range; software debounce follows the hardware filter. Nominal thresholds near 2.0 V rising / 1.65 V falling. Final bounds are in electrical_checks.json. No analog measurement, 1.8 V logic guarantee or CTRE protocol compatibility.

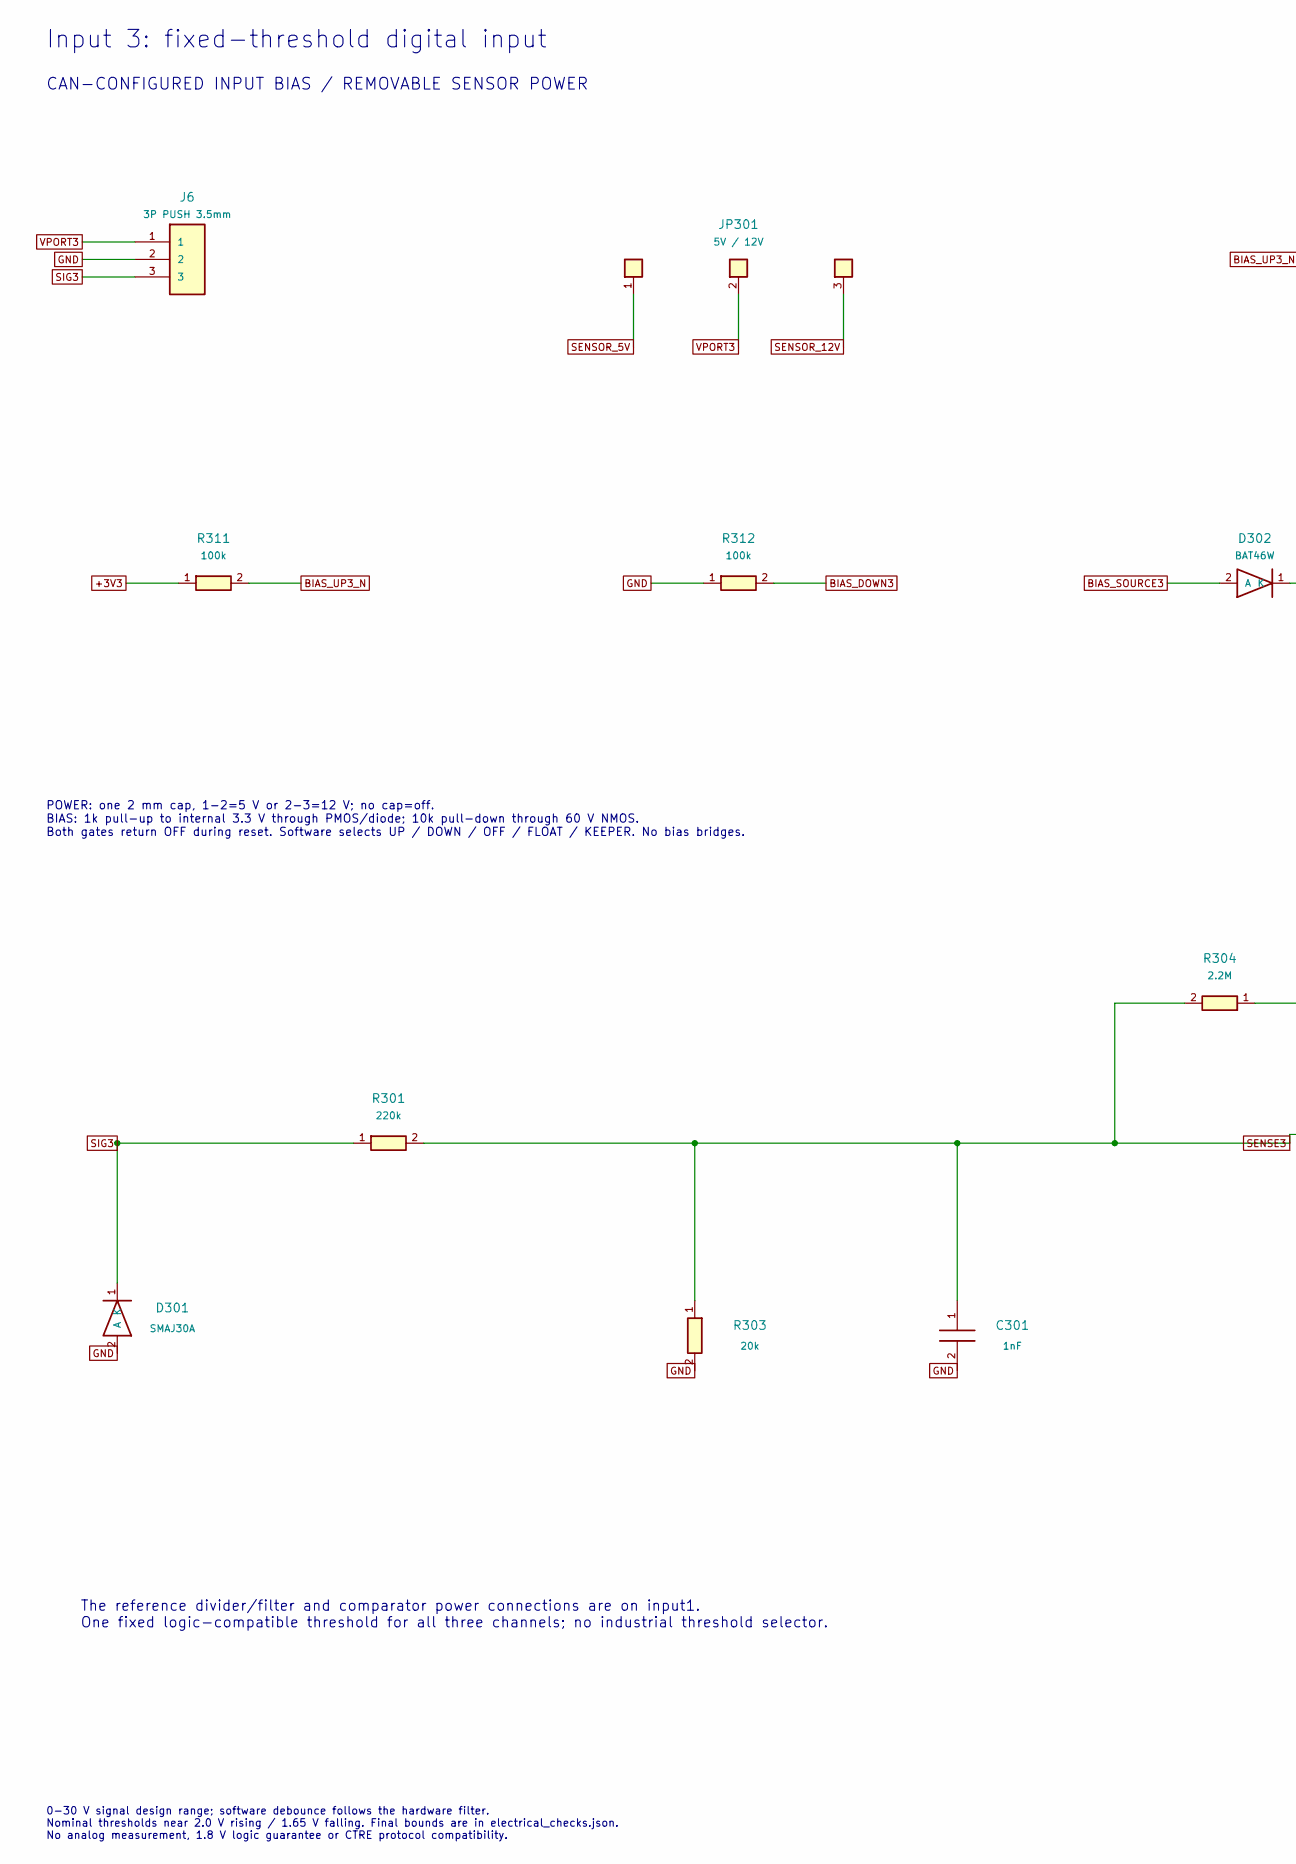
[picture p301: schematic input3.kicad_sch, SC12 - Input 3: fixed-threshold digital input, part in row 1, column 1]

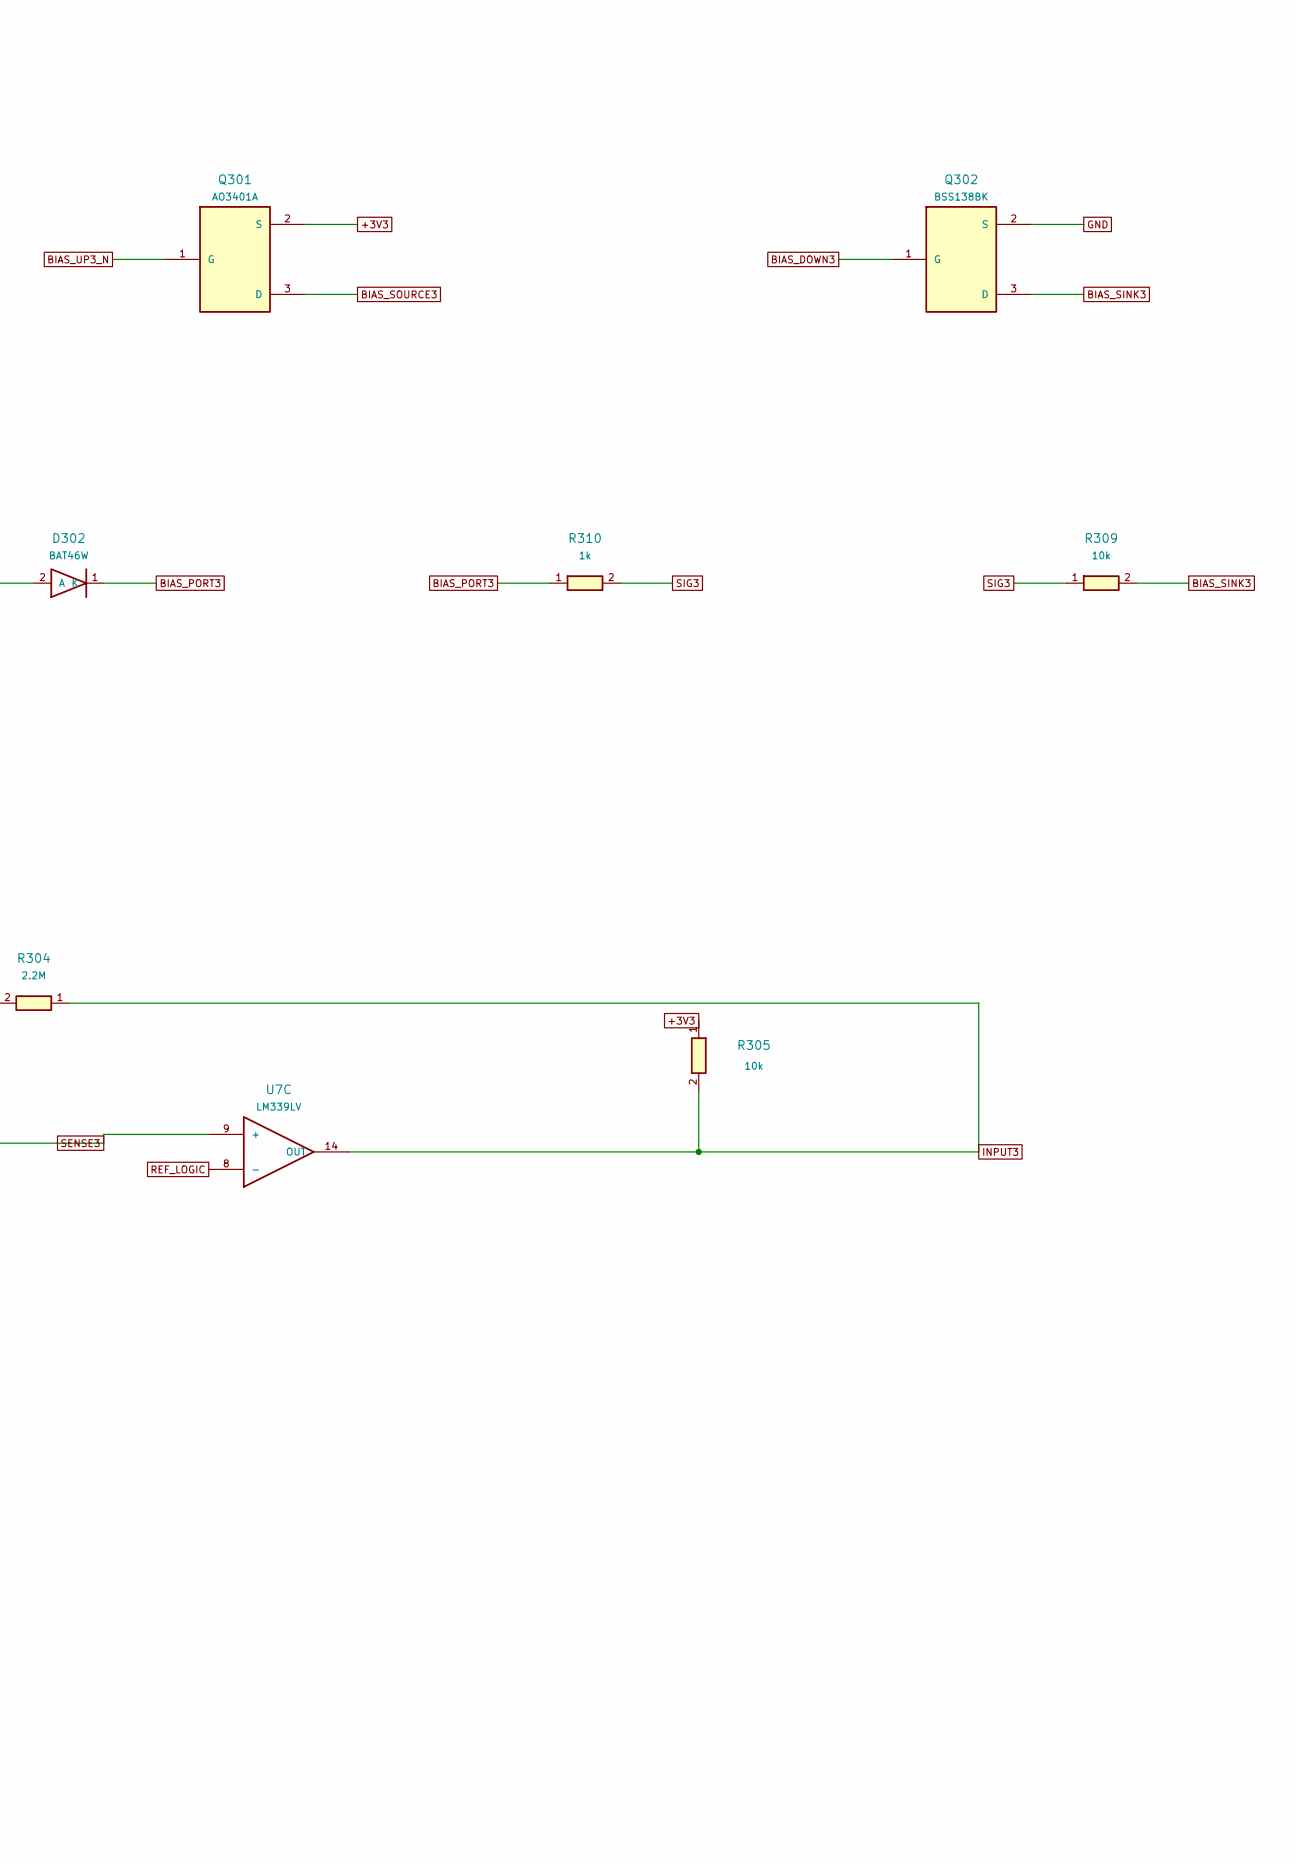
[picture p302: schematic input3.kicad_sch, SC12 - Input 3: fixed-threshold digital input, part in row 1, column 2]

Parts:
C301: 1nF; C_0805_2012Metric; MPN CC0805JRNPO9BN102
D301: SMAJ30A; D_SMA; MPN SMAJ30A
D302: BAT46W; D_SOD-123; MPN BAT46W-E3-18
J6: 3P PUSH 3.5mm; Weidmuller_LSF_90_3P; MPN 1824430000
JP301: 5V / 12V; PinHeader_1x03_P2.00mm_Vertical; MPN M22-2010305
Q301: AO3401A; SOT-23; MPN AO3401A
Q302: BSS138BK; SOT-23; MPN BSS138BK,215
R301: 220k; R_0805_2012Metric; MPN 0805W8F2203T5E
R303: 20k; R_0805_2012Metric; MPN RC0805FR-0720KL
R304: 2.2M; R_0805_2012Metric; MPN RC0805FR-072M2L
R305: 10k; R_0805_2012Metric; MPN 0805W8F1002T5E
R309: 10k; R_1206_3216Metric; MPN RC1206FR-0710KL
R310: 1k; R_0805_2012Metric; MPN 0805W8F1001T5E
R311, R312: 100k; R_0805_2012Metric; MPN 0805W8F1003T5E
U7: LM339LV; SOIC-14_3.9x8.7mm_P1.27mm; MPN LM339LVDR

Connections:
+3V3: Q301.2 (S), R305.1, R311.1; also elsewhere on the board
BIAS_DOWN3: Q302.1 (G), R312.2; also elsewhere on the board
BIAS_PORT3: D302.1 (K), R310.1
BIAS_SINK3: Q302.3 (D), R309.2
BIAS_SOURCE3: D302.2 (A), Q301.3 (D)
BIAS_UP3_N: Q301.1 (G), R311.2; also elsewhere on the board
GND: C301.2, D301.2 (A), J6.2, Q302.2 (S), R303.2, R312.1; also elsewhere on the board
INPUT3: R304.1, R305.2, U7.14 (OUT); also elsewhere on the board
REF_LOGIC: U7.8 (-); also elsewhere on the board
SENSE3: C301.1, R301.2, R303.1, R304.2, U7.9 (+)
SENSOR_5V: JP301.1; also elsewhere on the board
SENSOR_12V: JP301.3; also elsewhere on the board
SIG3: D301.1 (K), J6.3, R301.1, R309.1, R310.2
VPORT3: J6.1, JP301.2

Notes on the sheet:
Input 3: fixed-threshold digital input
CAN-CONFIGURED INPUT BIAS / REMOVABLE SENSOR POWER
POWER: one 2 mm cap, 1-2=5 V or 2-3=12 V; no cap=off. BIAS: 1k pull-up to internal 3.3 V through PMOS/diode; 10k pull-down through 60 V NMOS. Both gates return OFF during reset. Software selects UP / DOWN / OFF / FLOAT / KEEPER. No bias bridges.
The reference divider/filter and comparator power connections are on input1. One fixed logic-compatible threshold for all three channels; no industrial threshold selector.
0-30 V signal design range; software debounce follows the hardware filter. Nominal thresholds near 2.0 V rising / 1.65 V falling. Final bounds are in electrical_checks.json. No analog measurement, 1.8 V logic guarantee or CTRE protocol compatibility.

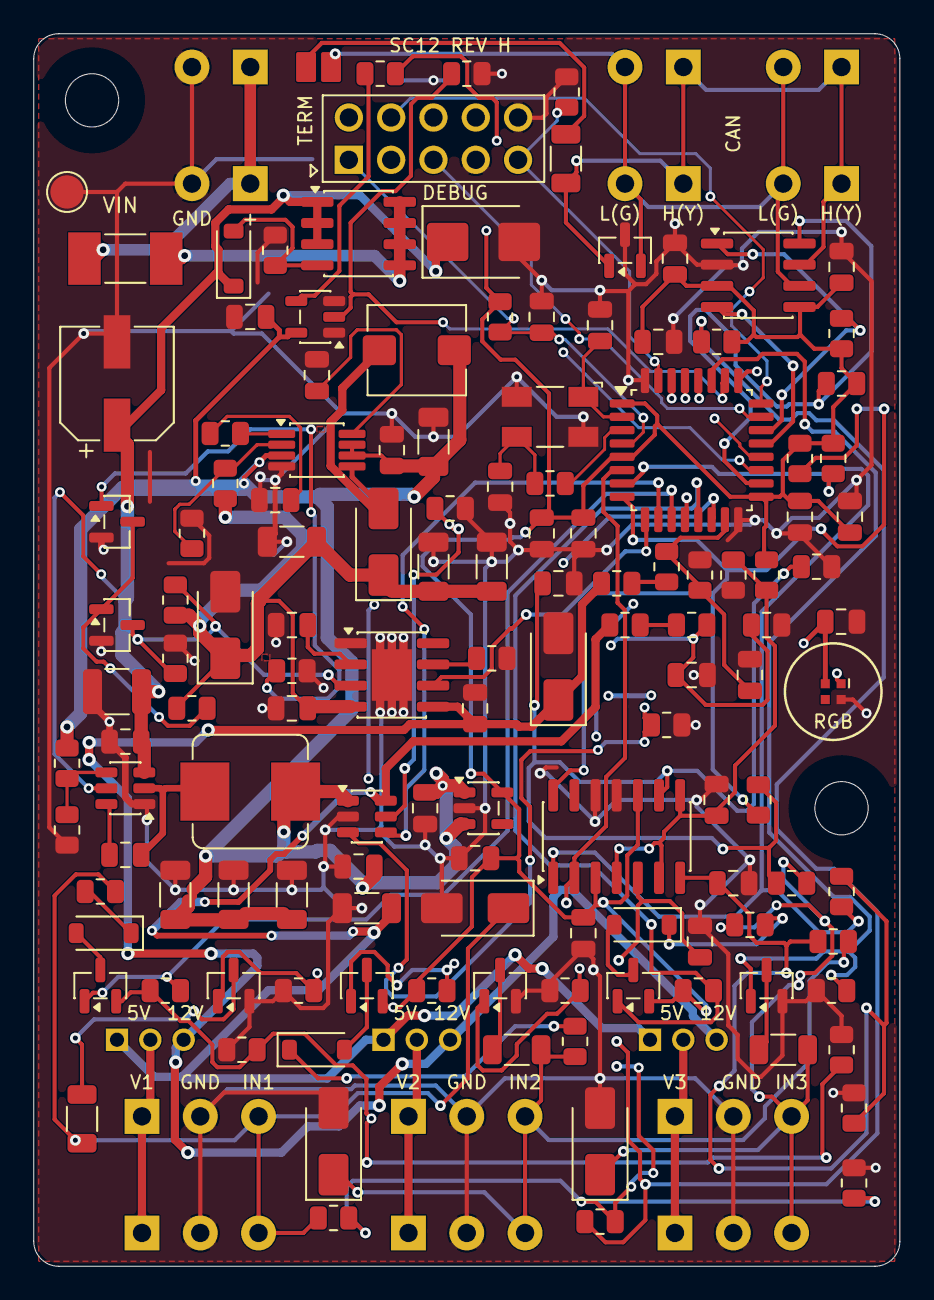
[picture p303: board current/hardware/FRC_Sensor_CAN.kicad_pcb from above]

Board: 4 copper layers, 52.0 x 74.0 mm, 144 parts (0 on the bottom side), 77 nets.

Other parts of the board:
H1, H2: M3 NPTH
