barkinvar/sugerCANe/rev_b2/hardware/FRC_Sensor_CAN.kicad_pcb

## KiCad design rev_b2/hardware/FRC_Sensor_CAN.kicad_pcb (2026-09-08, an earlier design)

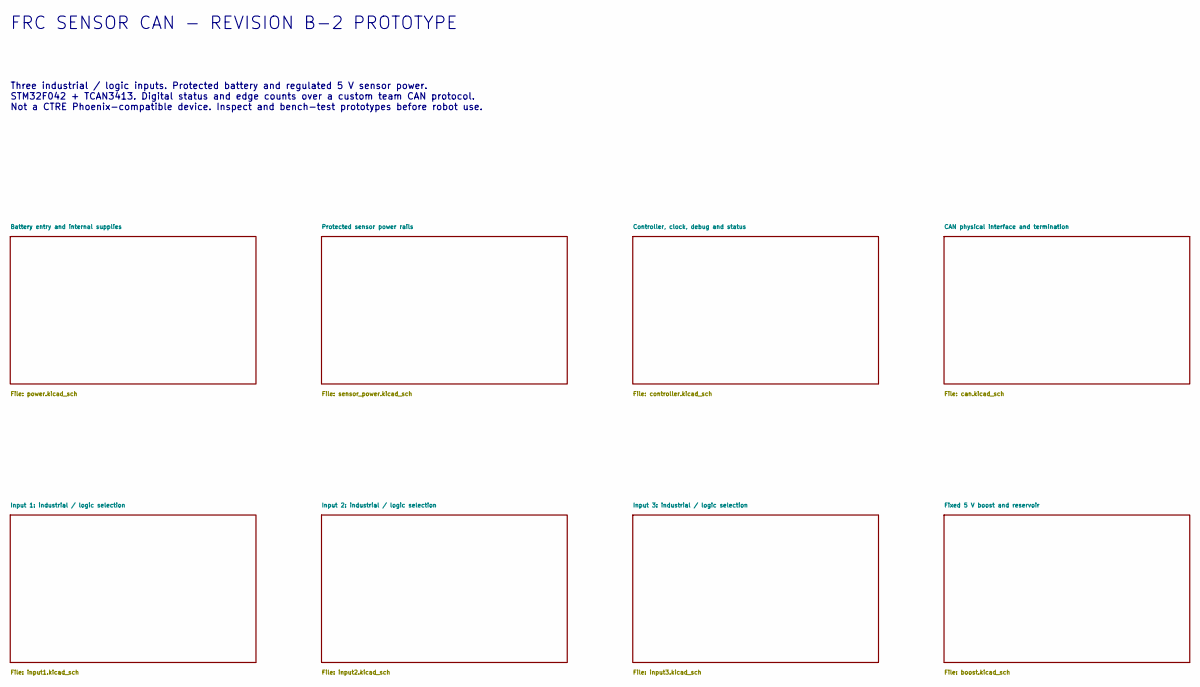
[picture p304: schematic FRC_Sensor_CAN.kicad_sch, FRC Sensor CAN]

Notes on the sheet:
FRC SENSOR CAN - REVISION B-2 PROTOTYPE
Three industrial / logic inputs. Protected battery and regulated 5 V sensor power. STM32F042 + TCAN3413. Digital status and edge counts over a custom team CAN protocol. Not a CTRE Phoenix-compatible device. Inspect and bench-test prototypes before robot use.

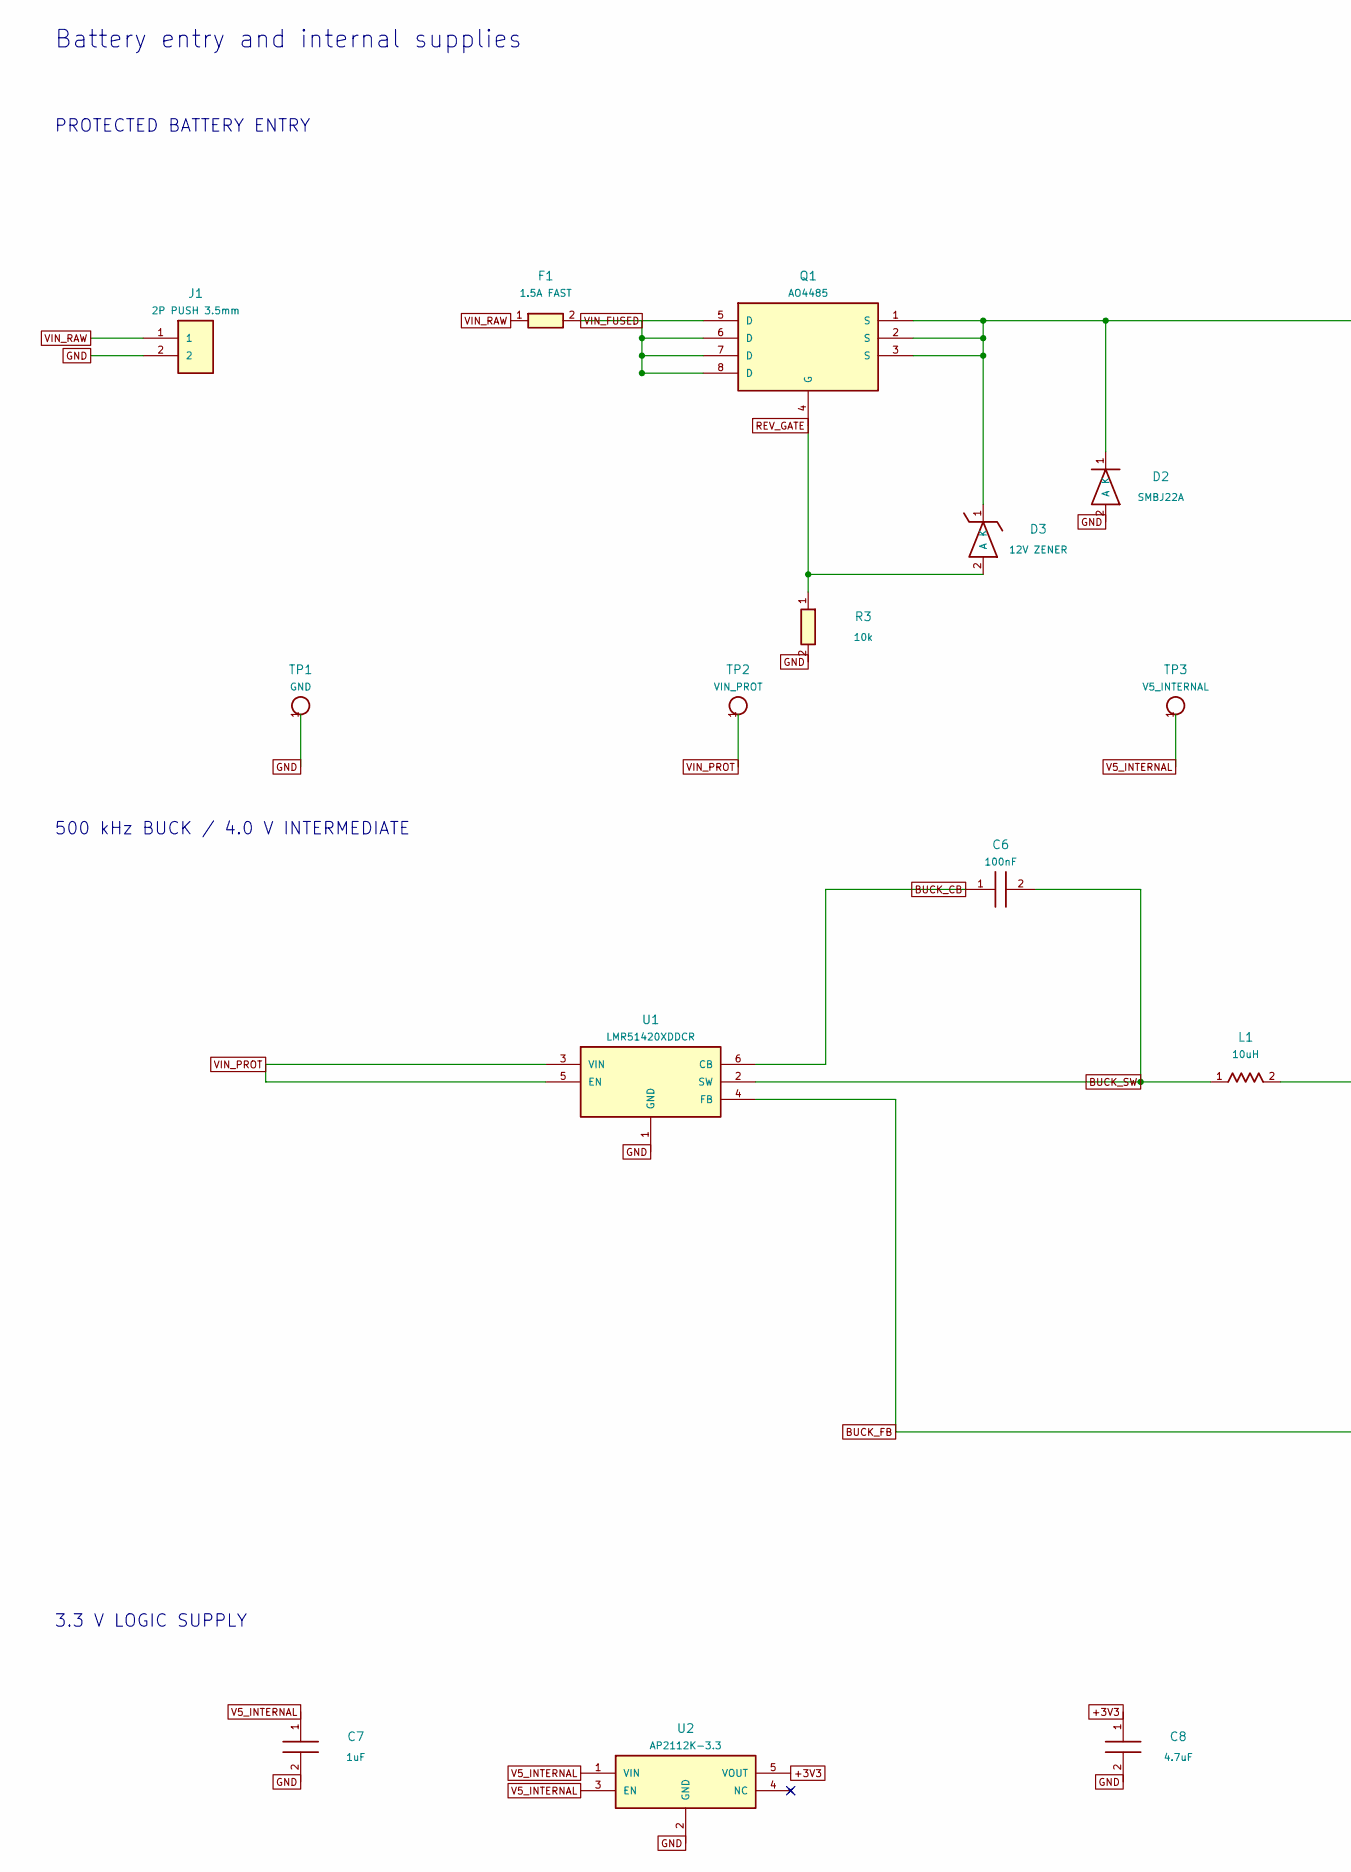
[picture p305: schematic power.kicad_sch, FRC Sensor CAN - Battery entry and internal supplies, part in row 1, column 1]

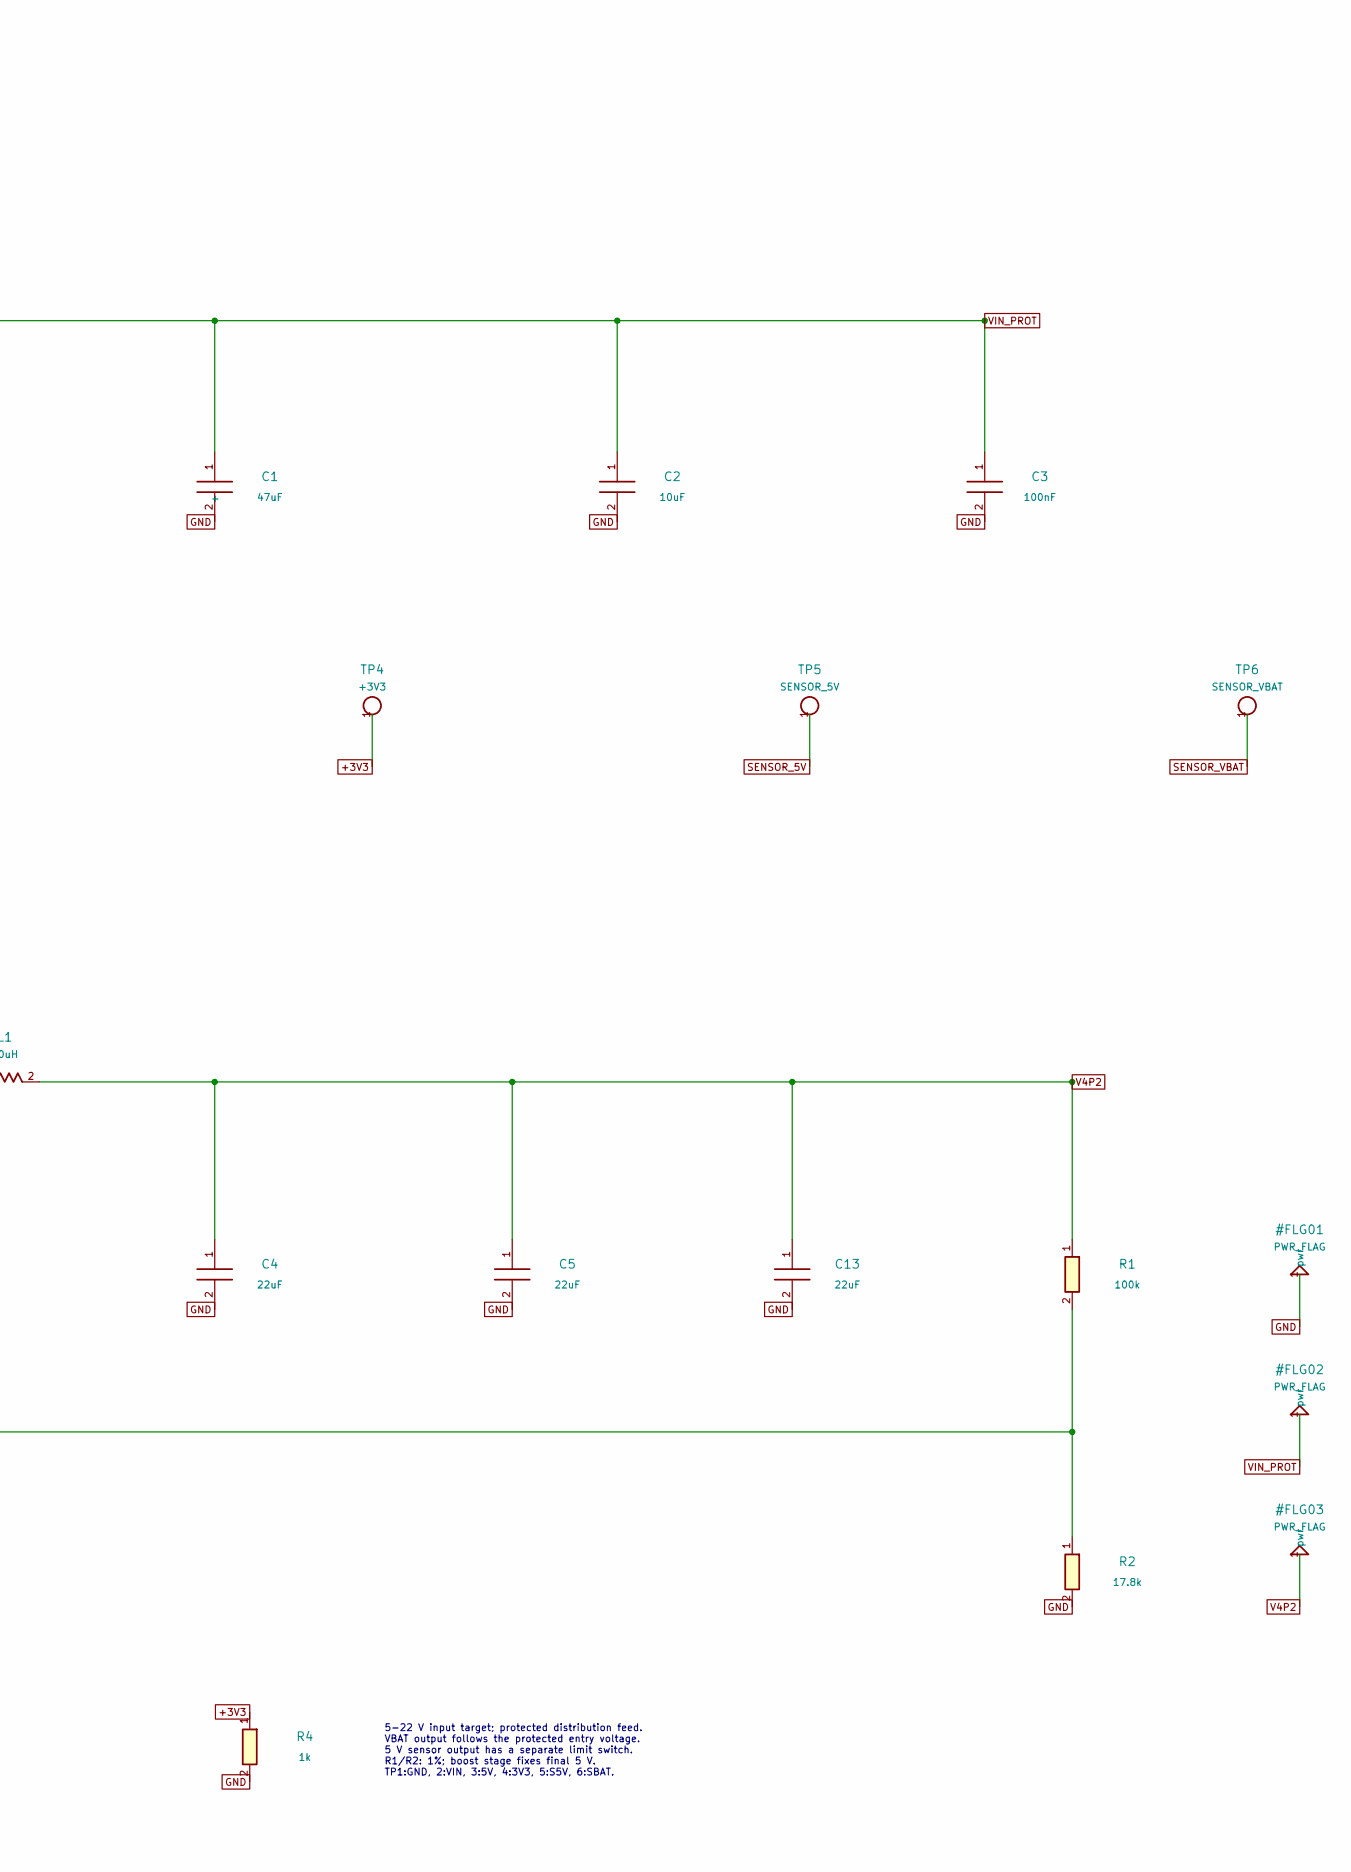
[picture p306: schematic power.kicad_sch, FRC Sensor CAN - Battery entry and internal supplies, part in row 1, column 2]

Parts:
C1: 47uF; CP_Elec_8x6.5; MPN EEE-FK1H470P
C2: 10uF; C_1210_3225Metric; MPN CL32B106KBJNNWE
C3, C6: 100nF; C_0805_2012Metric; MPN CL21B104KCFNNNE
C4, C5, C13: 22uF; C_1206_3216Metric; MPN CL31A226KAHNNNE
C7: 1uF; C_0805_2012Metric; MPN CC0805KKX7R9BB105
C8: 4.7uF; C_0805_2012Metric; MPN TMK212AB7475KG-T
D2: SMBJ22A; D_SMB; MPN SMBJ22A-E3/52
D3: 12V ZENER; D_SOD-123; MPN MMSZ12T1G
F1: 1.5A FAST; Fuse_Littelfuse-NANO2-451_453; MPN 045101.5MRL
J1: 2P PUSH 3.5mm; Weidmuller_LSF_90_2P; MPN 1824420000
L1: 10uH; L_Bourns_SRP7028A_7.3x6.6mm; MPN SRP7028A-100M
Q1: AO4485; SOIC-8_3.9x4.9mm_P1.27mm; MPN AO4485
R1: 100k; R_0805_2012Metric; MPN 0805W8F1003T5E
R2: 17.8k; R_0805_2012Metric; MPN ERJ-6ENF1782V
R3: 10k; R_0805_2012Metric; MPN 0805W8F1002T5E
R4: 1k; R_0805_2012Metric; MPN 0805W8F1001T5E
TP1: GND; TestPoint_Pad_D2.0mm
TP2: VIN_PROT; TestPoint_Pad_D2.0mm
TP3: V5_INTERNAL; TestPoint_Pad_D2.0mm
TP4: +3V3; TestPoint_Pad_D2.0mm
TP5: SENSOR_5V; TestPoint_Pad_D2.0mm
TP6: SENSOR_VBAT; TestPoint_Pad_D2.0mm
U1: LMR51420XDDCR; TSOT-23-6; MPN LMR51420XDDCR
U2: AP2112K-3.3; SOT-23-5; MPN AP2112K-3.3TRG1

Connections:
+3V3: C8.1, R4.1, TP4.1, U2.5 (VOUT); also elsewhere on the board
BUCK_CB: C6.1, U1.6 (CB)
BUCK_FB: R1.2, R2.1, U1.4 (FB)
BUCK_SW: C6.2, L1.1, U1.2 (SW)
GND: C1.2, C2.2, C3.2, C4.2, C5.2, C7.2, C8.2, C13.2, D2.2 (A), J1.2, R2.2, R3.2, R4.2, TP1.1, U1.1 (GND), U2.2 (GND); also elsewhere on the board
REV_GATE: D3.2 (A), Q1.4 (G), R3.1
SENSOR_5V: TP5.1; also elsewhere on the board
SENSOR_VBAT: TP6.1; also elsewhere on the board
V4P2: C4.1, C5.1, C13.1, L1.2, R1.1; also elsewhere on the board
V5_INTERNAL: C7.1, TP3.1, U2.1 (VIN), U2.3 (EN); also elsewhere on the board
VIN_FUSED: F1.2, Q1.5 (D), Q1.6 (D), Q1.7 (D), Q1.8 (D)
VIN_PROT: C1.1 (+), C2.1, C3.1, D2.1 (K), D3.1 (K), Q1.1 (S), Q1.2 (S), Q1.3 (S), TP2.1, U1.3 (VIN), U1.5 (EN); also elsewhere on the board
VIN_RAW: F1.1, J1.1

Notes on the sheet:
Battery entry and internal supplies
PROTECTED BATTERY ENTRY
500 kHz BUCK / 4.0 V INTERMEDIATE
3.3 V LOGIC SUPPLY
5-22 V input target; protected distribution feed. VBAT output follows the protected entry voltage. 5 V sensor output has a separate limit switch. R1/R2: 1%; boost stage fixes final 5 V. TP1:GND, 2:VIN, 3:5V, 4:3V3, 5:S5V, 6:SBAT.
