barkinvar/sugerCANe/rev_b2/hardware/FRC_Sensor_CAN.kicad_pcb

## KiCad design rev_b2/hardware/FRC_Sensor_CAN.kicad_pcb (continued)

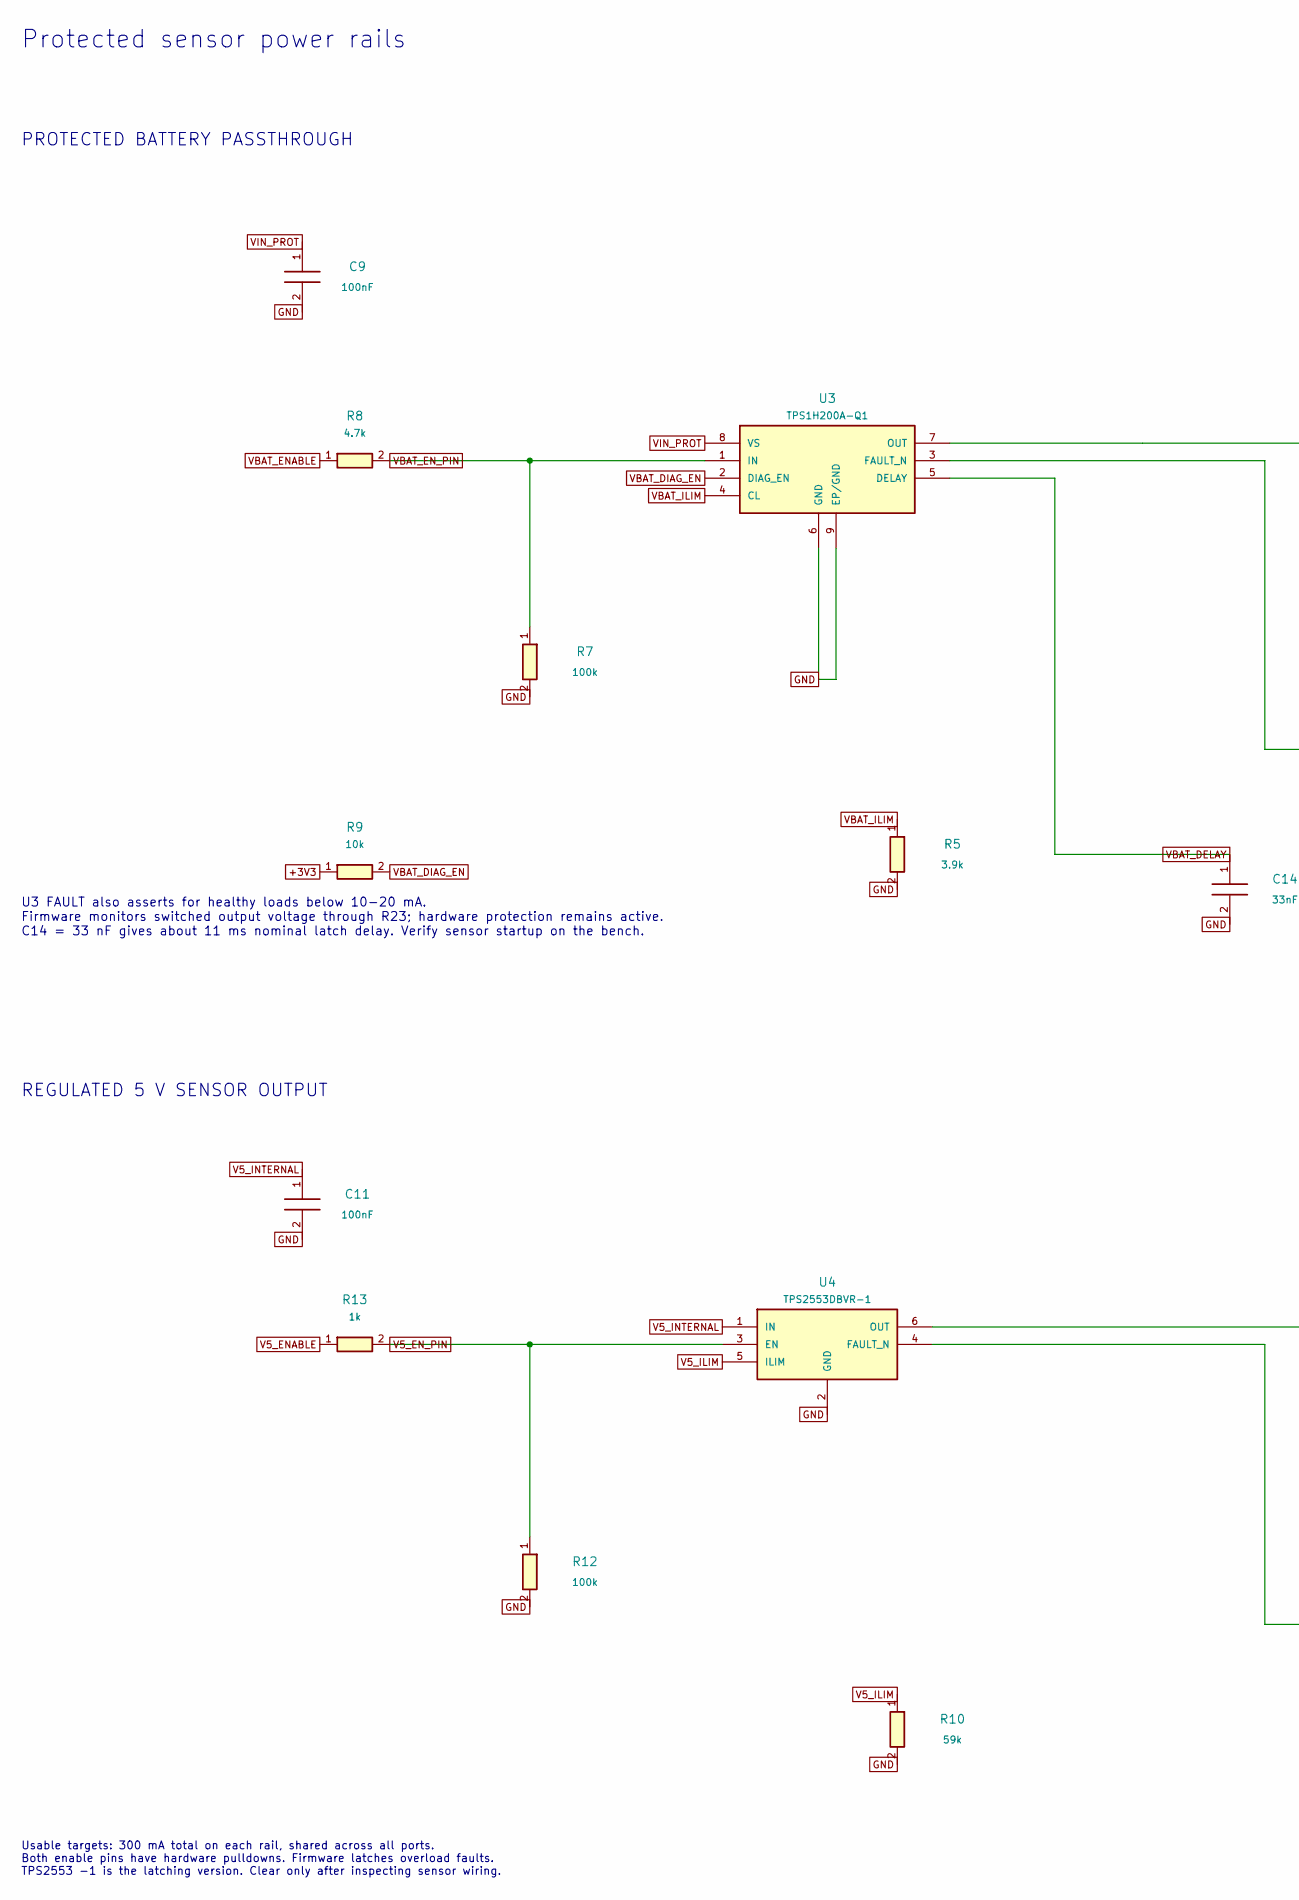
[picture p307: schematic sensor_power.kicad_sch, FRC Sensor CAN - Protected sensor power rails, part in row 1, column 1]

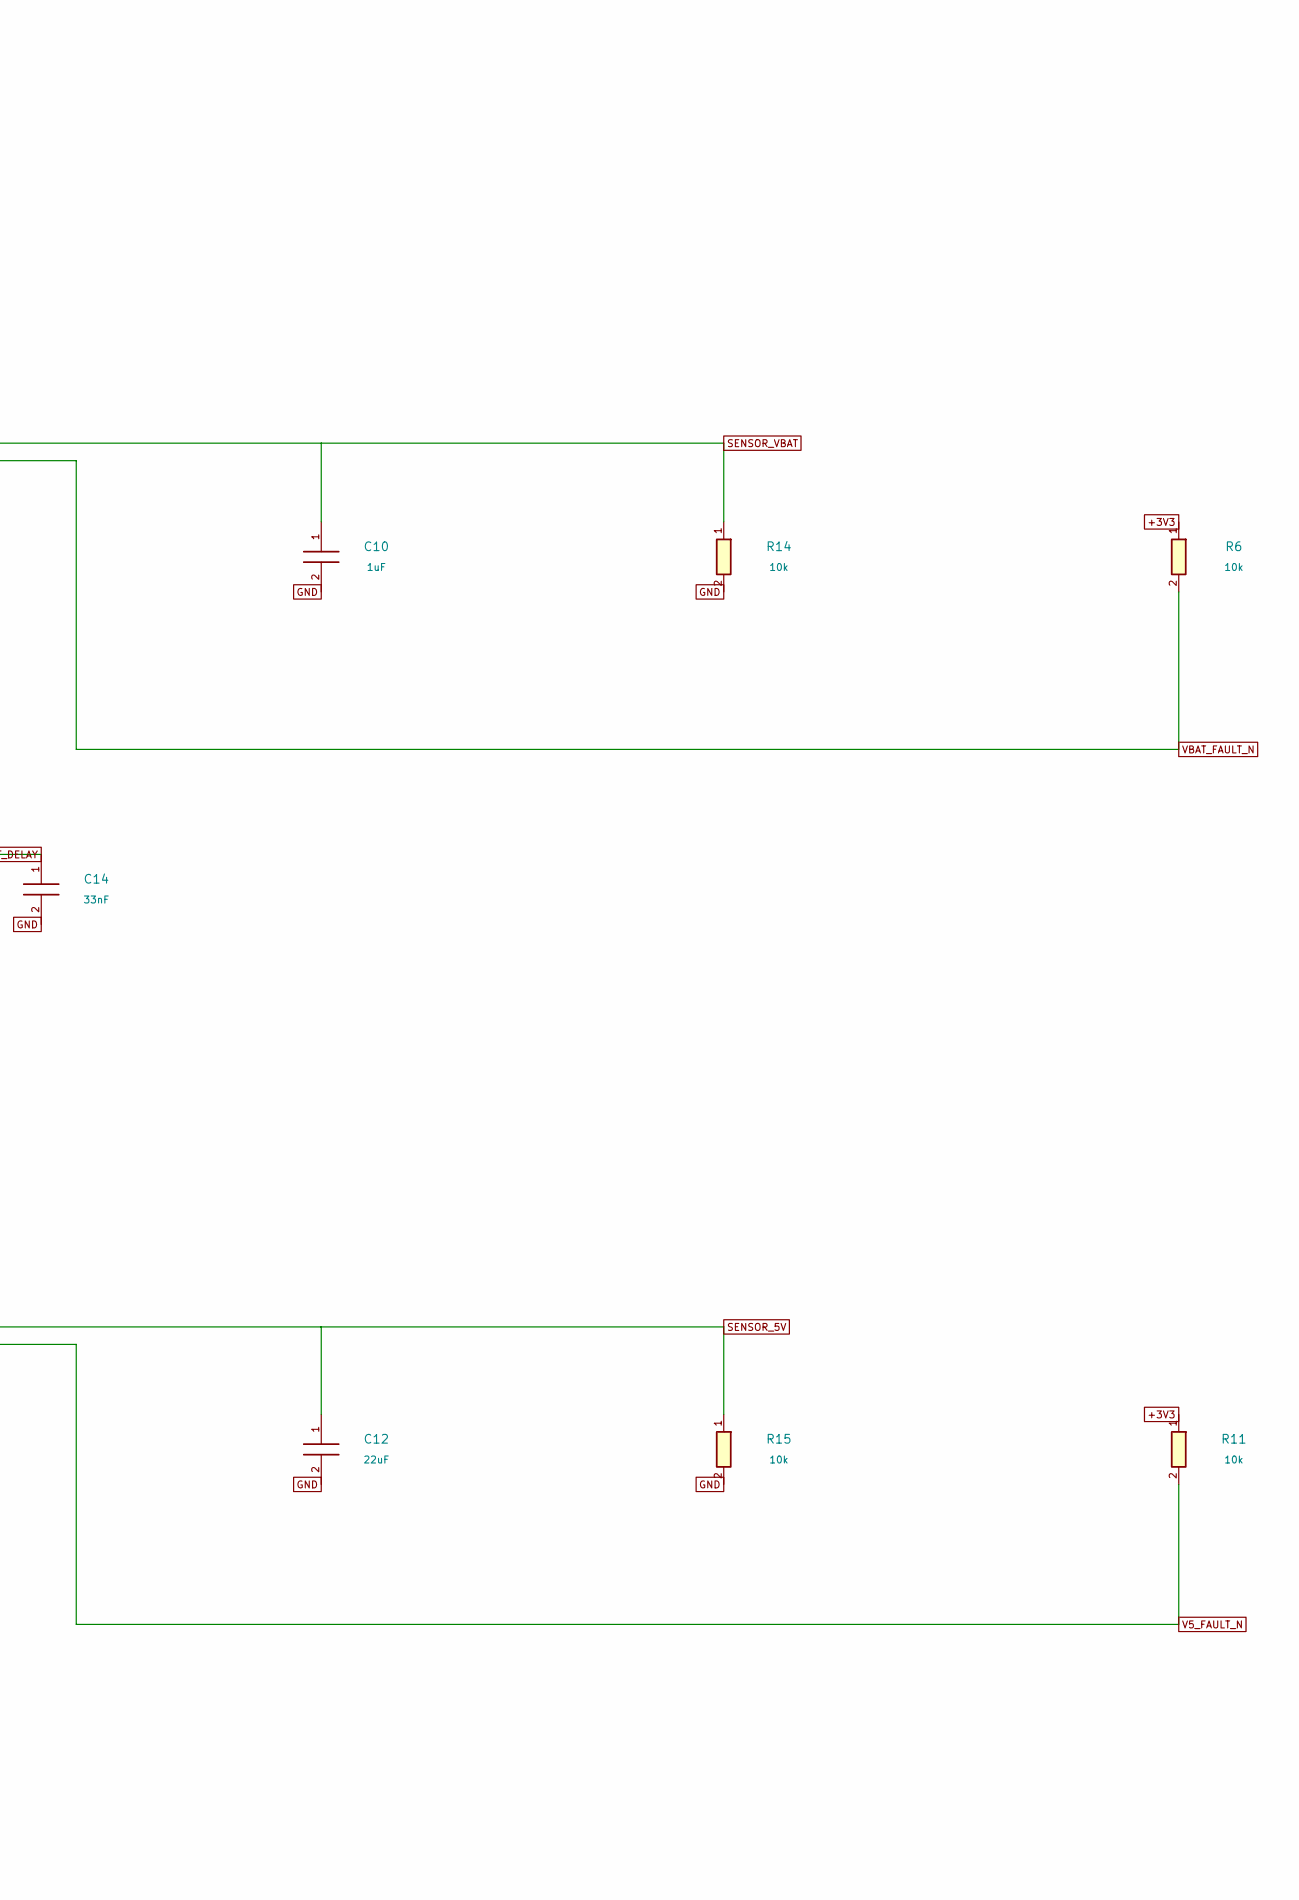
[picture p308: schematic sensor_power.kicad_sch, FRC Sensor CAN - Protected sensor power rails, part in row 1, column 2]

Parts:
C9, C11: 100nF; C_0805_2012Metric; MPN CL21B104KCFNNNE
C10: 1uF; C_0805_2012Metric; MPN CC0805KKX7R9BB105
C12: 22uF; C_1206_3216Metric; MPN CL31A226KAHNNNE
C14: 33nF; C_0805_2012Metric; MPN CC0805KRX7R9BB333
R5: 3.9k; R_0805_2012Metric; MPN RC0805FR-073K9L
R6, R9, R11, R14, R15: 10k; R_0805_2012Metric; MPN 0805W8F1002T5E
R7, R12: 100k; R_0805_2012Metric; MPN 0805W8F1003T5E
R8: 4.7k; R_0805_2012Metric; MPN 0805W8F4701T5E
R10: 59k; R_0805_2012Metric; MPN RC0805FR-0759KL
R13: 1k; R_0805_2012Metric; MPN 0805W8F1001T5E
U3: TPS1H200A-Q1; TI_DGN0008K_HVSSOP8_EP; MPN TPS1H200AQDGNRQ1
U4: TPS2553DBVR-1; SOT-23-6; MPN TPS2553DBVR-1

Connections:
+3V3: R6.1, R9.1, R11.1; also elsewhere on the board
GND: C9.2, C10.2, C11.2, C12.2, C14.2, R5.2, R7.2, R10.2, R12.2, R14.2, R15.2, U3.6 (GND), U3.9 (EP/GND), U4.2 (GND); also elsewhere on the board
SENSOR_5V: C12.1, R15.1, U4.6 (OUT); also elsewhere on the board
SENSOR_VBAT: C10.1, R14.1, U3.7 (OUT); also elsewhere on the board
V5_ENABLE: R13.1; also elsewhere on the board
V5_EN_PIN: R12.1, R13.2, U4.3 (EN)
V5_FAULT_N: R11.2, U4.4 (FAULT_N); also elsewhere on the board
V5_ILIM: R10.1, U4.5 (ILIM)
V5_INTERNAL: C11.1, U4.1 (IN); also elsewhere on the board
VBAT_DELAY: C14.1, U3.5 (DELAY)
VBAT_DIAG_EN: R9.2, U3.2 (DIAG_EN)
VBAT_ENABLE: R8.1; also elsewhere on the board
VBAT_EN_PIN: R7.1, R8.2, U3.1 (IN)
VBAT_FAULT_N: R6.2, U3.3 (FAULT_N); also elsewhere on the board
VBAT_ILIM: R5.1, U3.4 (CL)
VIN_PROT: C9.1, U3.8 (VS); also elsewhere on the board

Notes on the sheet:
Protected sensor power rails
PROTECTED BATTERY PASSTHROUGH
U3 FAULT also asserts for healthy loads below 10-20 mA. Firmware monitors switched output voltage through R23; hardware protection remains active. C14 = 33 nF gives about 11 ms nominal latch delay. Verify sensor startup on the bench.
REGULATED 5 V SENSOR OUTPUT
Usable targets: 300 mA total on each rail, shared across all ports. Both enable pins have hardware pulldowns. Firmware latches overload faults. TPS2553 -1 is the latching version. Clear only after inspecting sensor wiring.

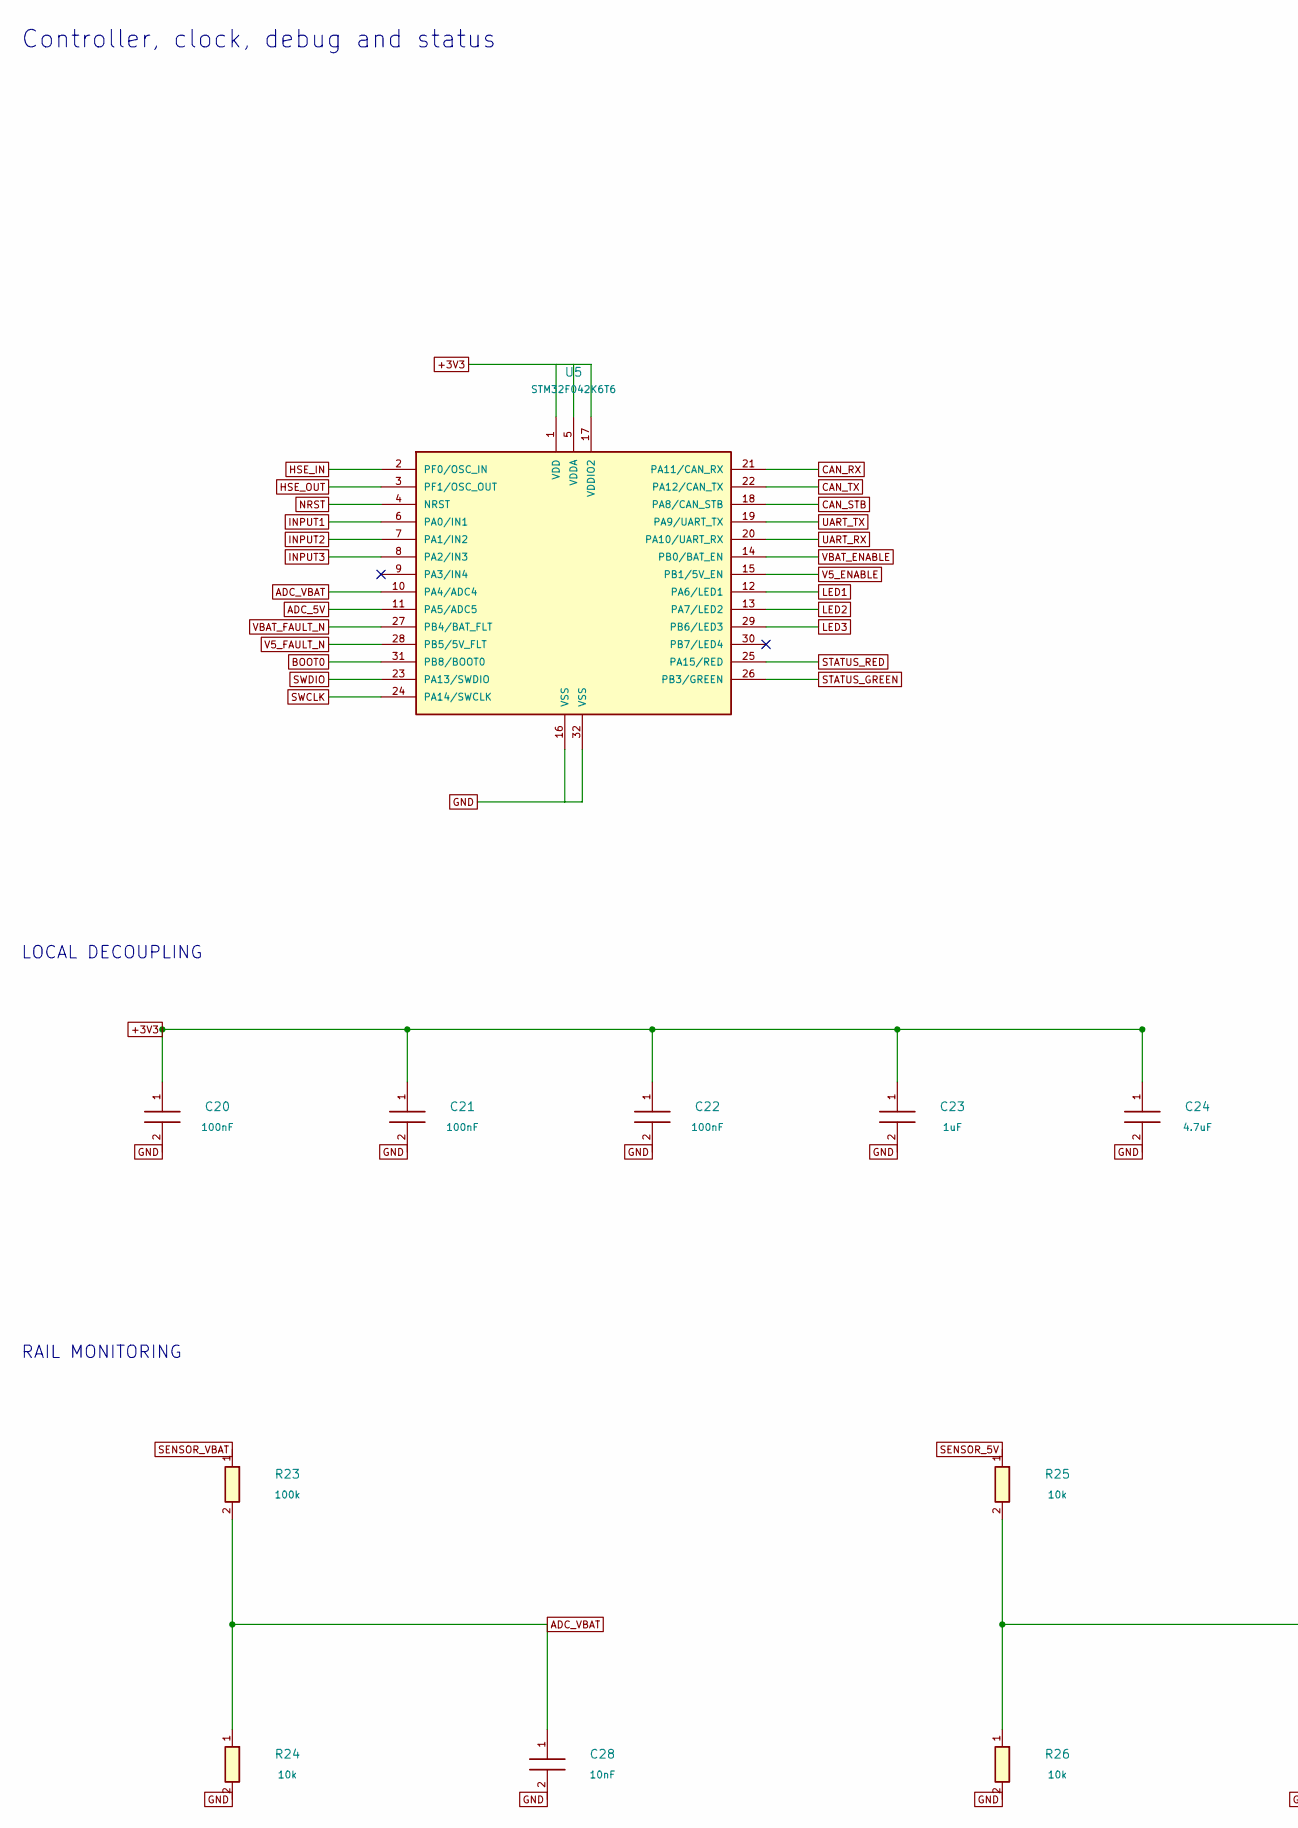
[picture p309: schematic controller.kicad_sch, FRC Sensor CAN - Controller, clock, debug and status, part in row 1, column 1]

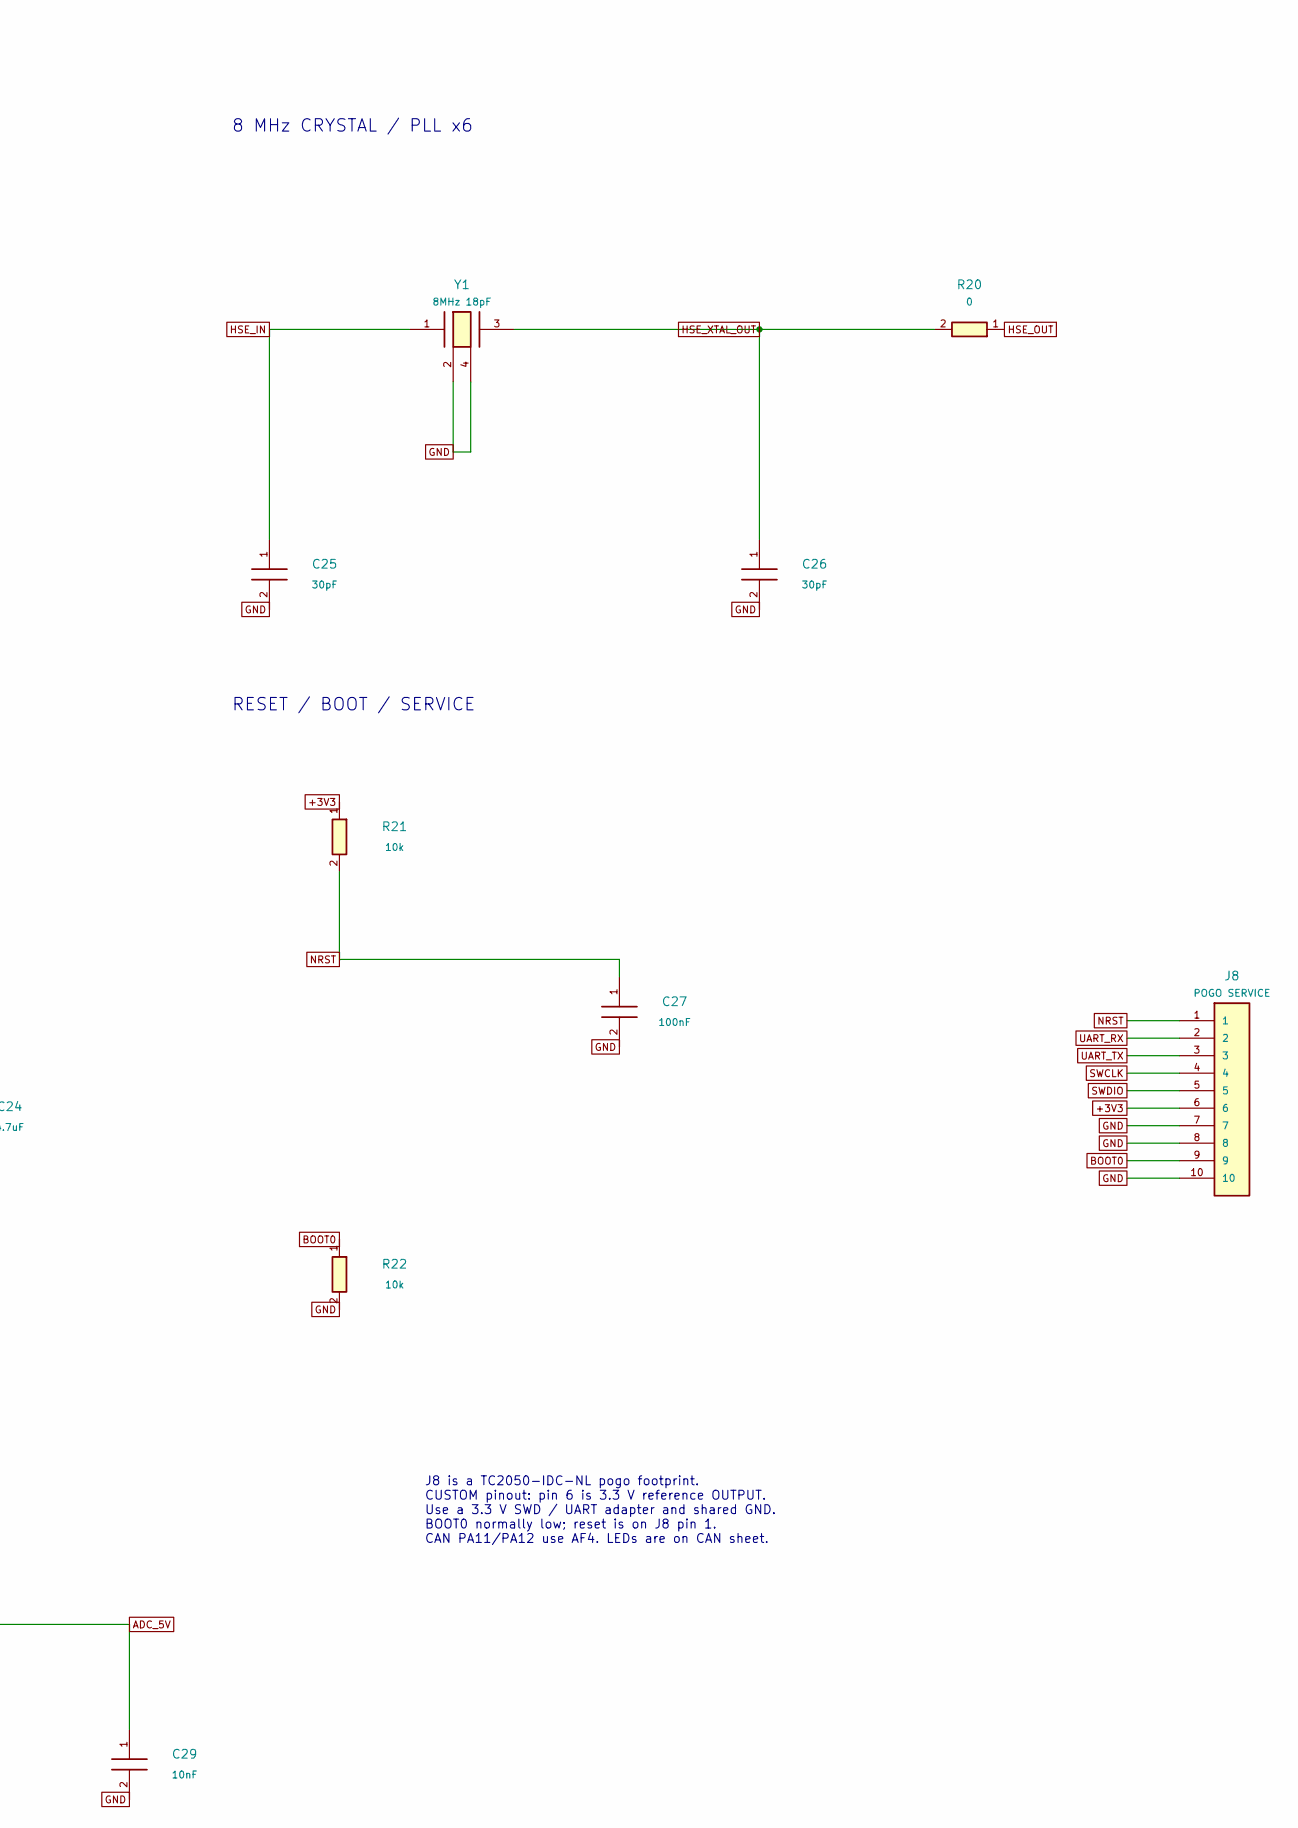
[picture p310: schematic controller.kicad_sch, FRC Sensor CAN - Controller, clock, debug and status, part in row 1, column 2]

Parts:
C20, C21, C22, C27: 100nF; C_0805_2012Metric; MPN CL21B104KCFNNNE
C23: 1uF; C_0805_2012Metric; MPN CC0805KKX7R9BB105
C24: 4.7uF; C_0805_2012Metric; MPN TMK212AB7475KG-T
C25, C26: 30pF; C_0805_2012Metric; MPN C0805C300J5GACTU
C28, C29: 10nF; C_0805_2012Metric; MPN CC0805KRX7R9BB103
J8: POGO SERVICE; Tag-Connect_TC2050-IDC-NL_2x05_P1.27mm_Vertical
R20: 0; R_0805_2012Metric; MPN RC0805JR-070RL
R21, R22, R24, R25, R26: 10k; R_0805_2012Metric; MPN 0805W8F1002T5E
R23: 100k; R_0805_2012Metric; MPN 0805W8F1003T5E
U5: STM32F042K6T6; LQFP-32_7x7mm_P0.8mm; MPN STM32F042K6T6
Y1: 8MHz 18pF; Abracon_ABM3B_5.0x3.2mm; MPN ABM3B-8.000MHZ-B2-T

Connections:
+3V3: C20.1, C21.1, C22.1, C23.1, C24.1, J8.6, R21.1, U5.1 (VDD), U5.5 (VDDA), U5.17 (VDDIO2); also elsewhere on the board
ADC_5V: C29.1, R25.2, R26.1, U5.11 (PA5/ADC5)
ADC_VBAT: C28.1, R23.2, R24.1, U5.10 (PA4/ADC4)
BOOT0: J8.9, R22.1, U5.31 (PB8/BOOT0)
CAN_RX: U5.21 (PA11/CAN_RX); also elsewhere on the board
CAN_STB: U5.18 (PA8/CAN_STB); also elsewhere on the board
CAN_TX: U5.22 (PA12/CAN_TX); also elsewhere on the board
GND: C20.2, C21.2, C22.2, C23.2, C24.2, C25.2, C26.2, C27.2, C28.2, C29.2, J8.7, J8.8, J8.10, R22.2, R24.2, R26.2, U5.16 (VSS), U5.32 (VSS), Y1.2, Y1.4; also elsewhere on the board
HSE_IN: C25.1, U5.2 (PF0/OSC_IN), Y1.1
HSE_OUT: R20.1, U5.3 (PF1/OSC_OUT)
HSE_XTAL_OUT: C26.1, R20.2, Y1.3
INPUT1: U5.6 (PA0/IN1); also elsewhere on the board
INPUT2: U5.7 (PA1/IN2); also elsewhere on the board
INPUT3: U5.8 (PA2/IN3); also elsewhere on the board
LED1: U5.12 (PA6/LED1); also elsewhere on the board
LED2: U5.13 (PA7/LED2); also elsewhere on the board
LED3: U5.29 (PB6/LED3); also elsewhere on the board
NRST: C27.1, J8.1, R21.2, U5.4 (NRST)
SENSOR_5V: R25.1; also elsewhere on the board
SENSOR_VBAT: R23.1; also elsewhere on the board
STATUS_GREEN: U5.26 (PB3/GREEN); also elsewhere on the board
STATUS_RED: U5.25 (PA15/RED); also elsewhere on the board
SWCLK: J8.4, U5.24 (PA14/SWCLK)
SWDIO: J8.5, U5.23 (PA13/SWDIO)
UART_RX: J8.2, U5.20 (PA10/UART_RX)
UART_TX: J8.3, U5.19 (PA9/UART_TX)
V5_ENABLE: U5.15 (PB1/5V_EN); also elsewhere on the board
V5_FAULT_N: U5.28 (PB5/5V_FLT); also elsewhere on the board
VBAT_ENABLE: U5.14 (PB0/BAT_EN); also elsewhere on the board
VBAT_FAULT_N: U5.27 (PB4/BAT_FLT); also elsewhere on the board

Notes on the sheet:
Controller, clock, debug and status
8 MHz CRYSTAL / PLL x6
RESET / BOOT / SERVICE
LOCAL DECOUPLING
RAIL MONITORING
J8 is a TC2050-IDC-NL pogo footprint. CUSTOM pinout: pin 6 is 3.3 V reference OUTPUT. Use a 3.3 V SWD / UART adapter and shared GND. BOOT0 normally low; reset is on J8 pin 1. CAN PA11/PA12 use AF4. LEDs are on CAN sheet.

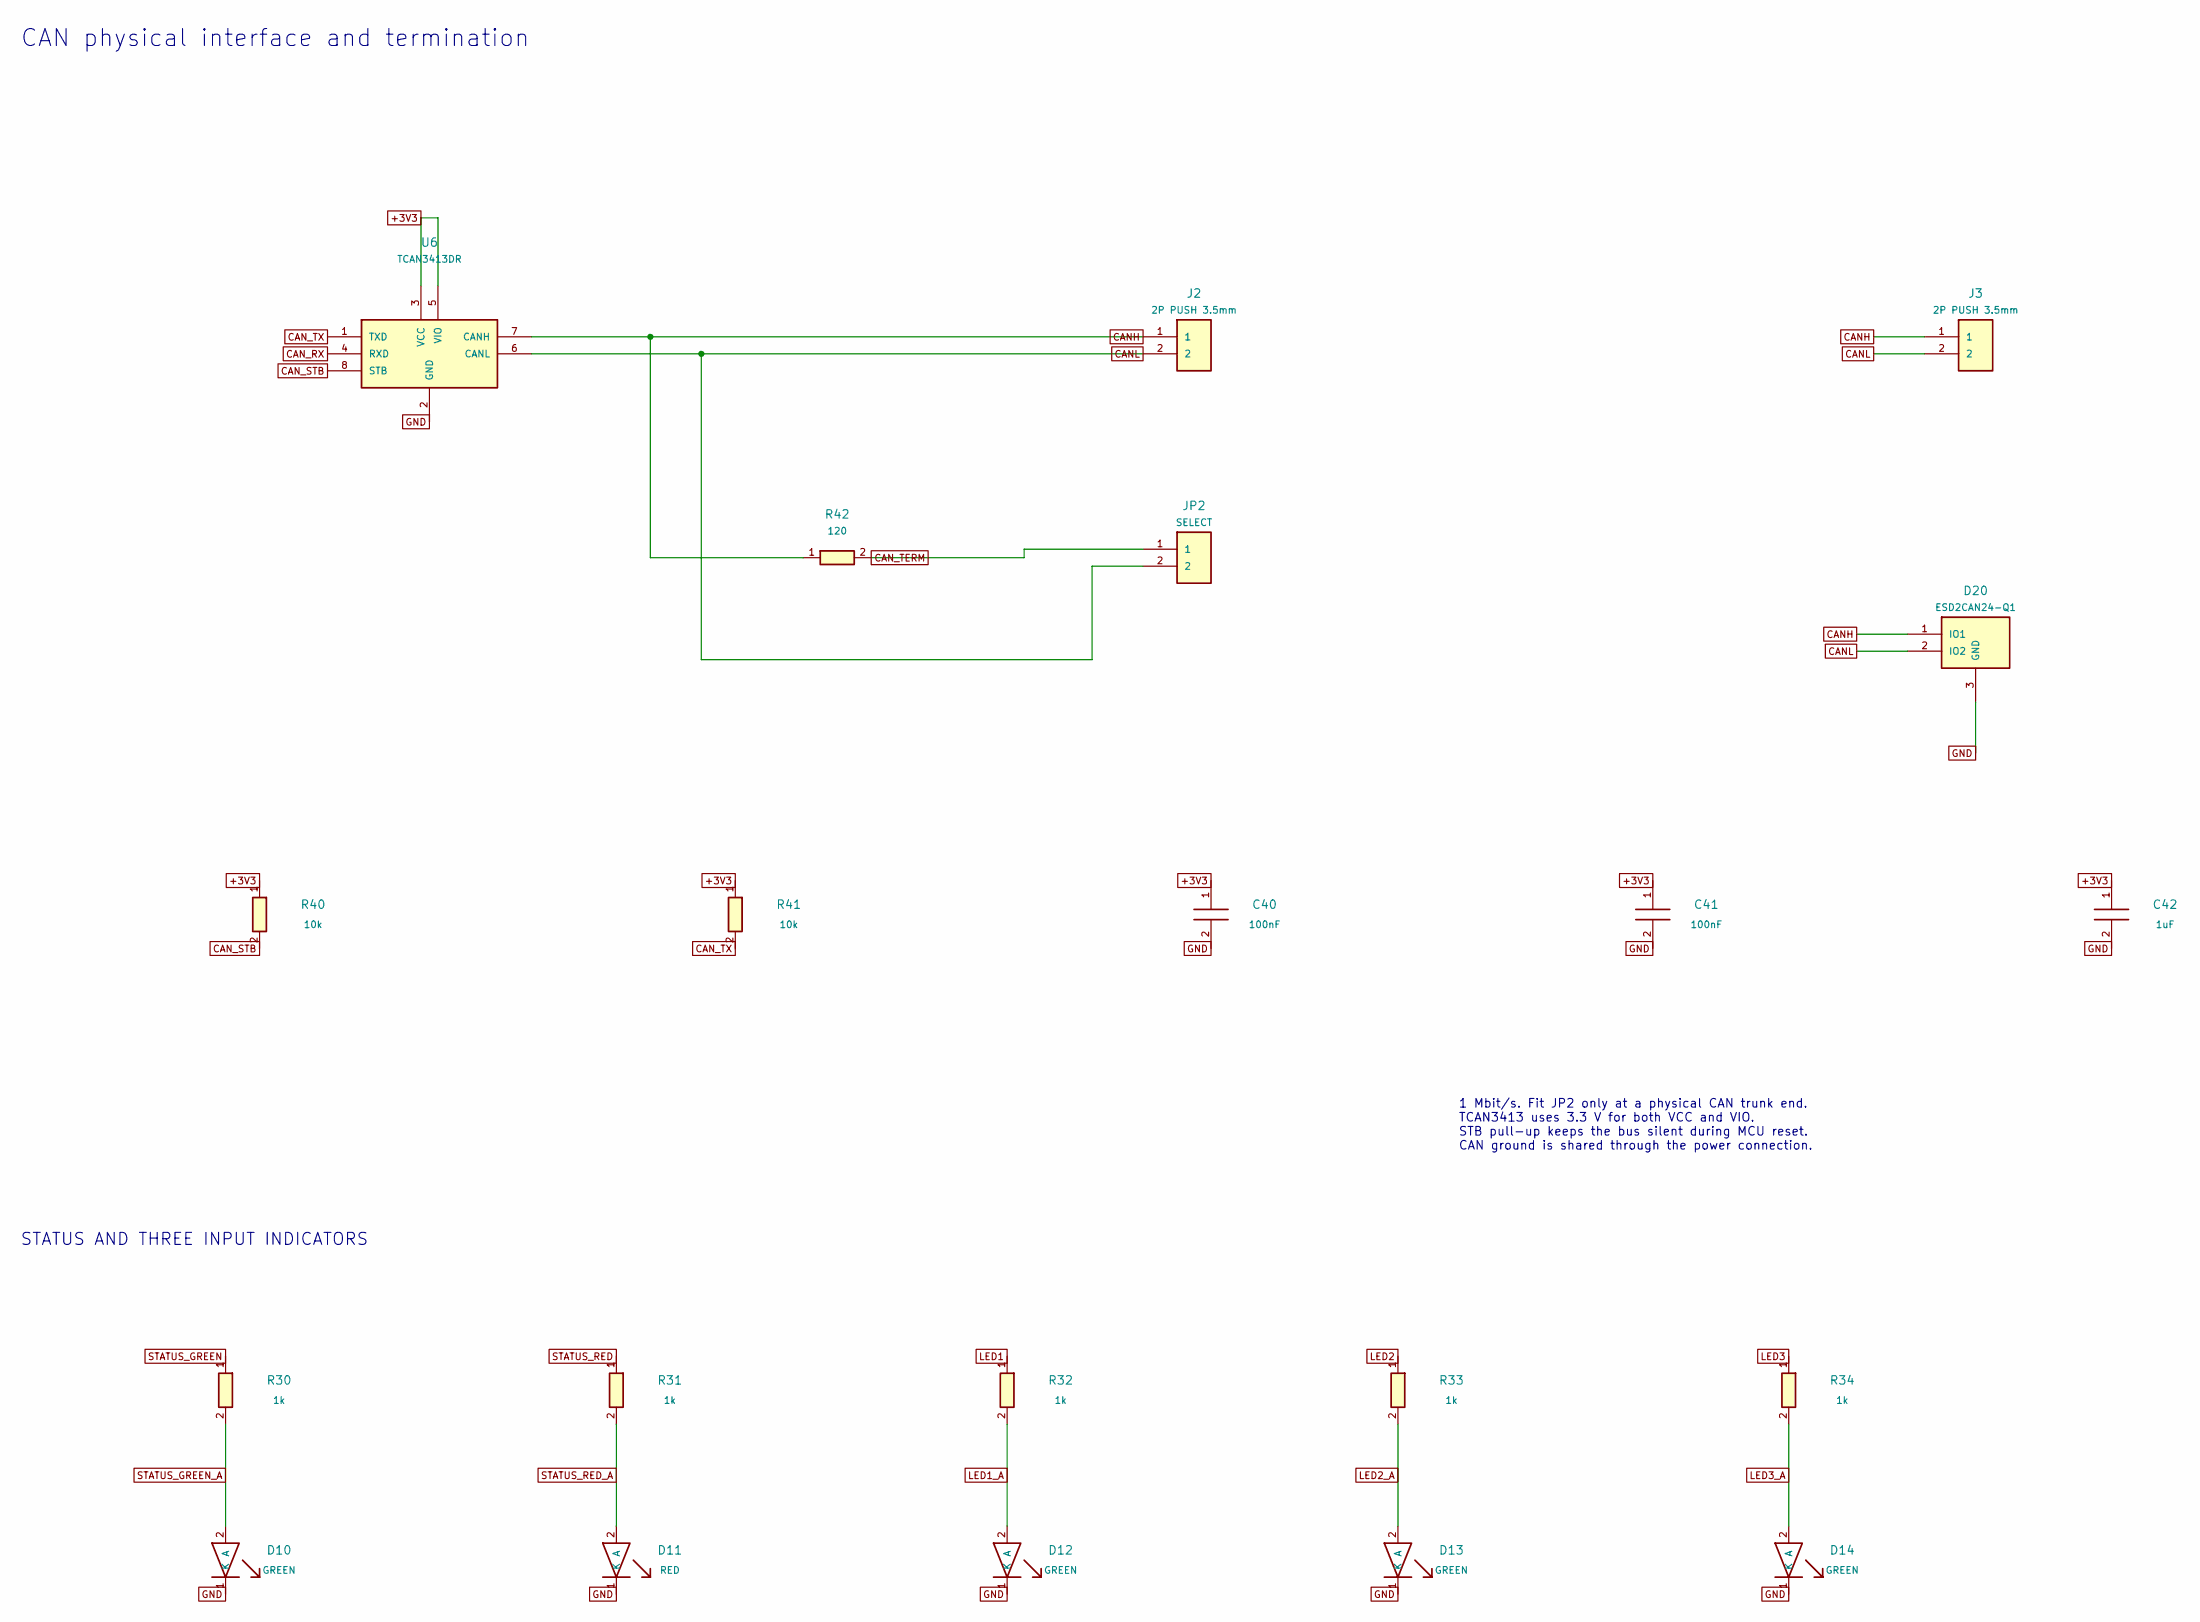
[picture p311: schematic can.kicad_sch, FRC Sensor CAN - CAN physical interface and termination]

Parts:
C40, C41: 100nF; C_0805_2012Metric; MPN CL21B104KCFNNNE
C42: 1uF; C_0805_2012Metric; MPN CC0805KKX7R9BB105
D10, D12, D13, D14: GREEN; LED_0805_2012Metric; MPN LTST-C170KGKT
D11: RED; LED_0805_2012Metric; MPN LTST-C170KRKT
D20: ESD2CAN24-Q1; SOT-23; MPN ESD2CAN24DBZRQ1
J2, J3: 2P PUSH 3.5mm; Weidmuller_LSF_90_2P; MPN 1824420000
JP2: SELECT; PinHeader_1x02_P2.00mm_Vertical; MPN M22-2010205
R30, R31, R32, R33, R34: 1k; R_0805_2012Metric; MPN 0805W8F1001T5E
R40, R41: 10k; R_0805_2012Metric; MPN 0805W8F1002T5E
R42: 120; R_1206_3216Metric; MPN RC1206FR-07120RL
U6: TCAN3413DR; SOIC-8_3.9x4.9mm_P1.27mm; MPN TCAN3413DR

Connections:
+3V3: C40.1, C41.1, C42.1, R40.1, R41.1, U6.3 (VCC), U6.5 (VIO); also elsewhere on the board
CANH: D20.1 (IO1), J2.1, J3.1, R42.1, U6.7 (CANH)
CANL: D20.2 (IO2), J2.2, J3.2, JP2.2, U6.6 (CANL)
CAN_RX: U6.4 (RXD); also elsewhere on the board
CAN_STB: R40.2, U6.8 (STB); also elsewhere on the board
CAN_TERM: JP2.1, R42.2
CAN_TX: R41.2, U6.1 (TXD); also elsewhere on the board
GND: C40.2, C41.2, C42.2, D10.1 (K), D11.1 (K), D12.1 (K), D13.1 (K), D14.1 (K), D20.3 (GND), U6.2 (GND); also elsewhere on the board
LED1: R32.1; also elsewhere on the board
LED1_A: D12.2 (A), R32.2
LED2: R33.1; also elsewhere on the board
LED2_A: D13.2 (A), R33.2
LED3: R34.1; also elsewhere on the board
LED3_A: D14.2 (A), R34.2
STATUS_GREEN: R30.1; also elsewhere on the board
STATUS_GREEN_A: D10.2 (A), R30.2
STATUS_RED: R31.1; also elsewhere on the board
STATUS_RED_A: D11.2 (A), R31.2

Notes on the sheet:
CAN physical interface and termination
1 Mbit/s. Fit JP2 only at a physical CAN trunk end. TCAN3413 uses 3.3 V for both VCC and VIO. STB pull-up keeps the bus silent during MCU reset. CAN ground is shared through the power connection.
STATUS AND THREE INPUT INDICATORS
