barkinvar/sugerCANe/rev_b2/hardware/FRC_Sensor_CAN.kicad_pcb

## KiCad design rev_b2/hardware/FRC_Sensor_CAN.kicad_pcb (continued)

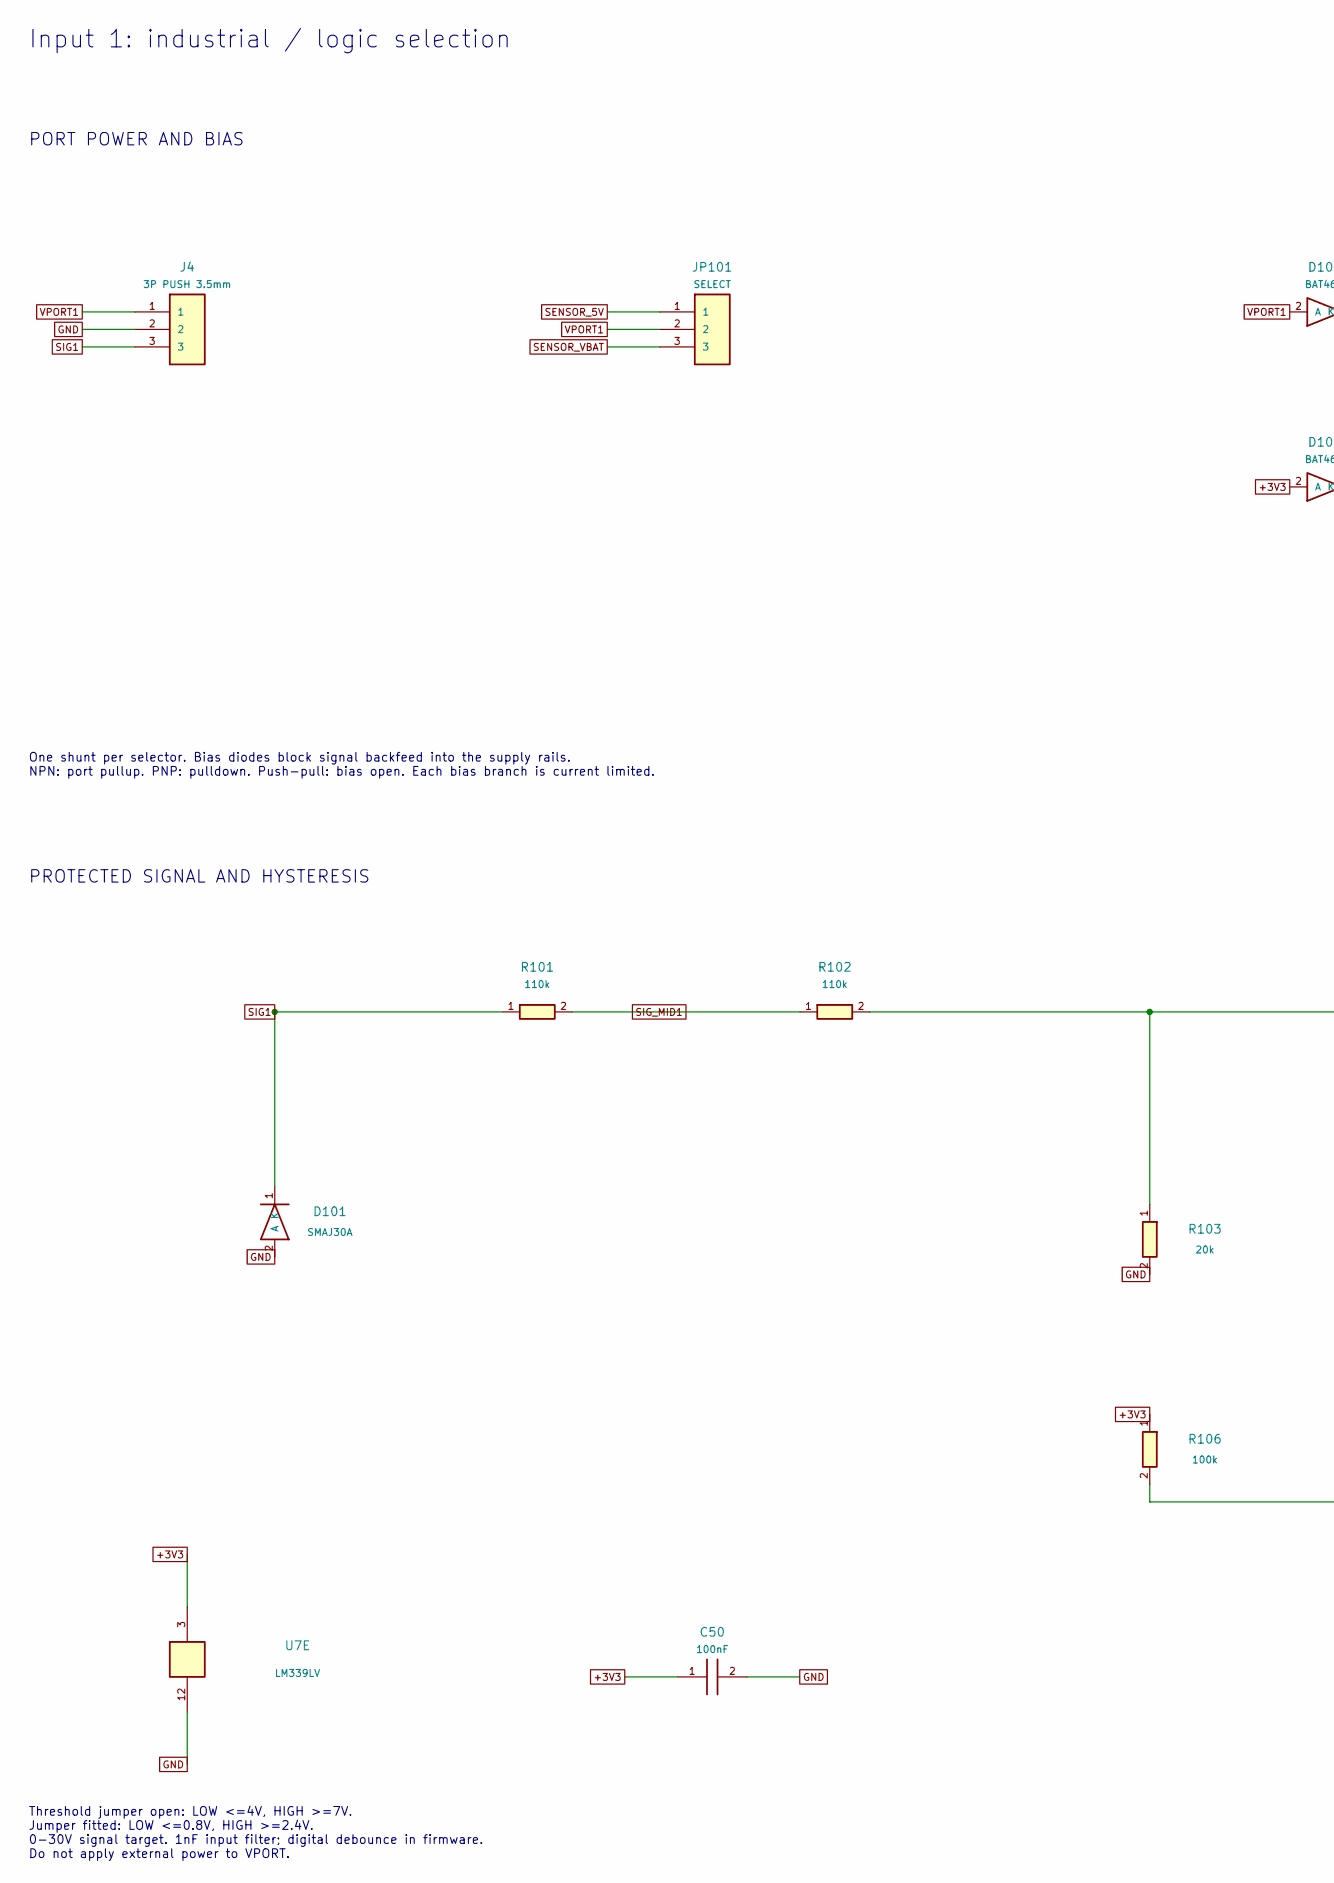
[picture p312: schematic input1.kicad_sch, FRC Sensor CAN - Input 1: industrial / logic selection, part in row 1, column 1]

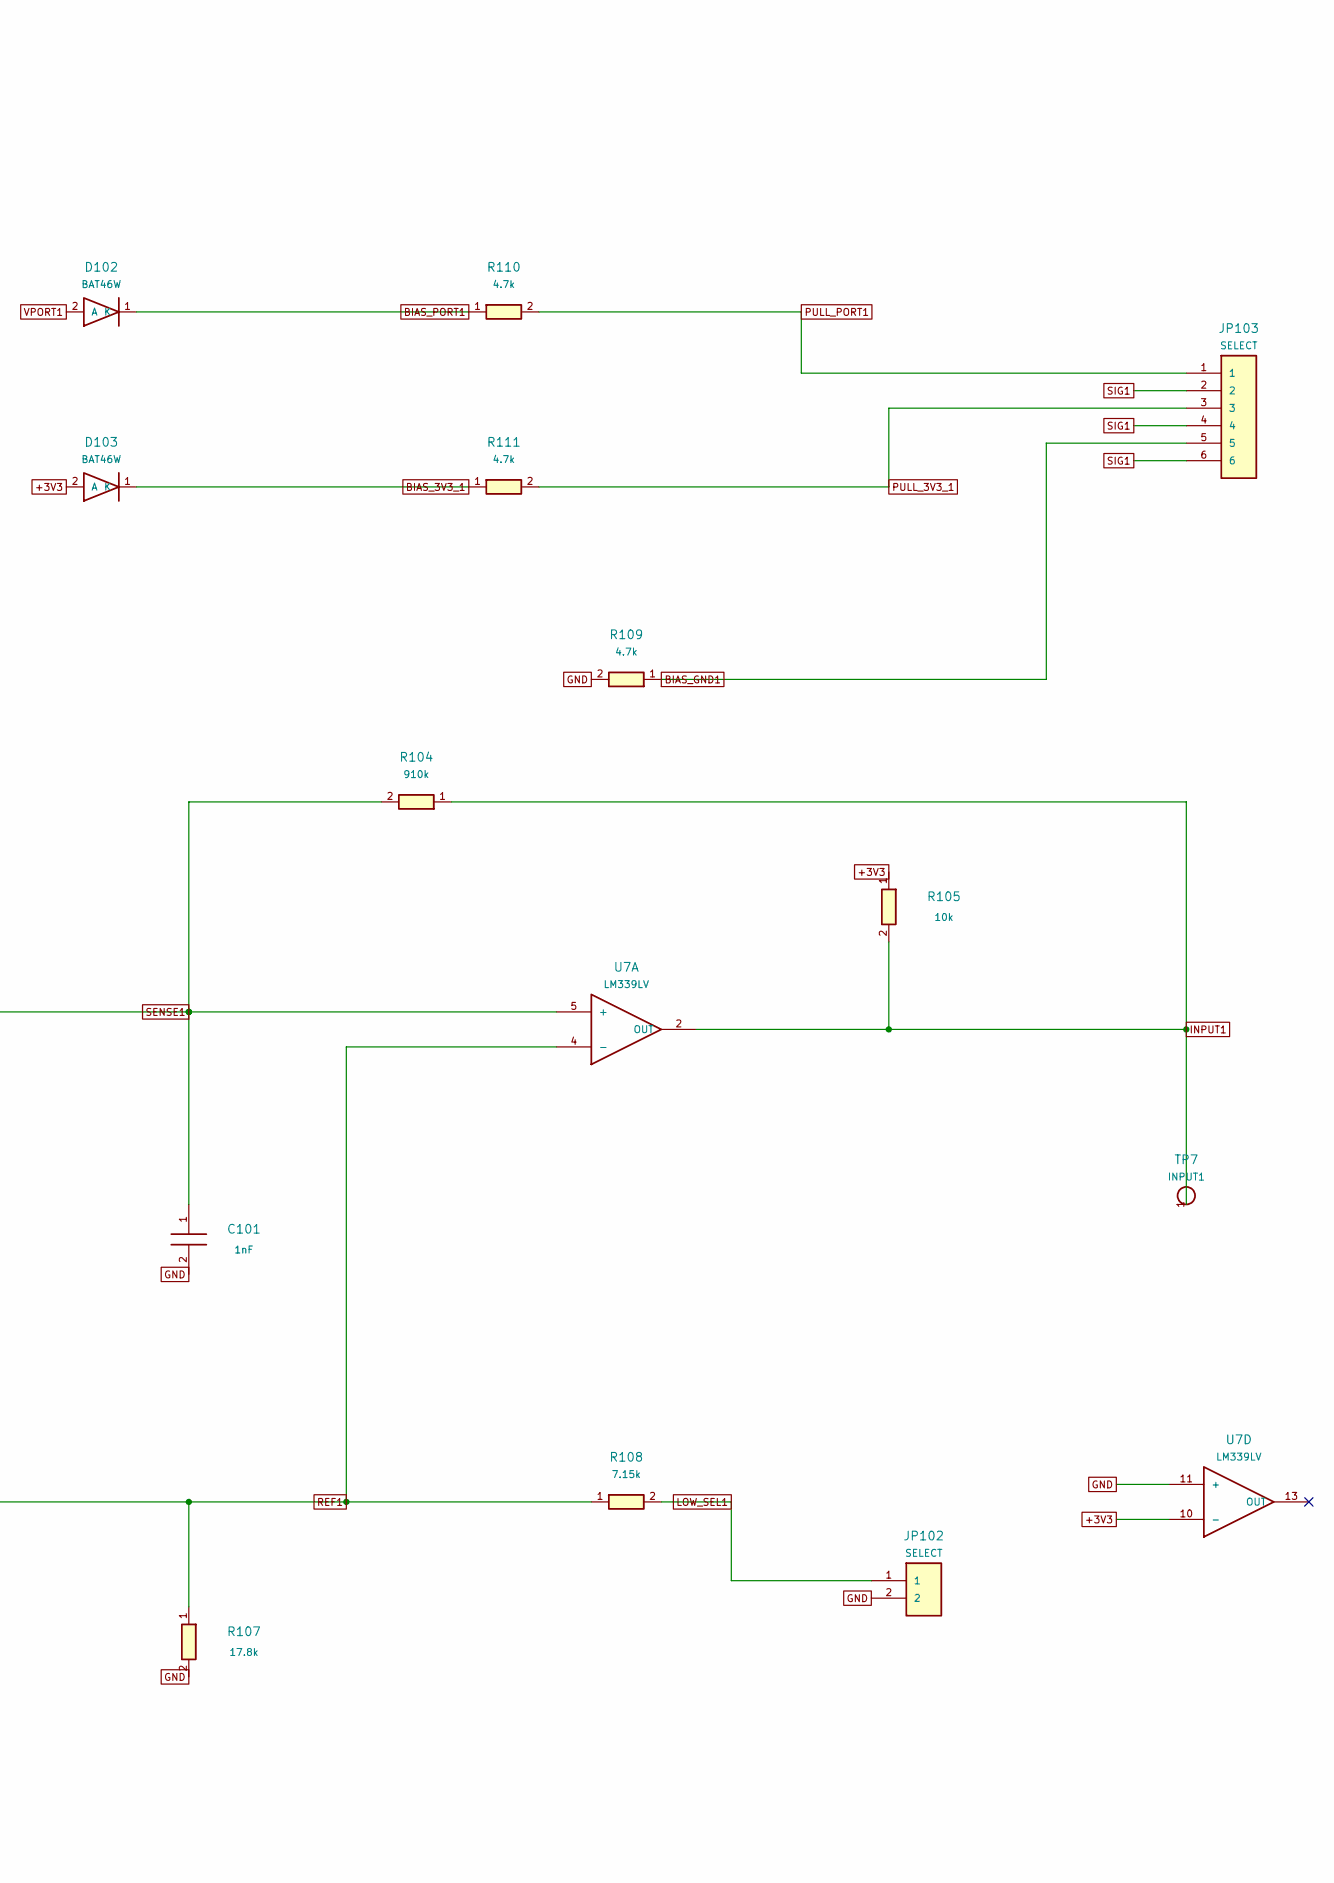
[picture p313: schematic input1.kicad_sch, FRC Sensor CAN - Input 1: industrial / logic selection, part in row 1, column 2]

Parts:
C50: 100nF; C_0805_2012Metric; MPN CL21B104KCFNNNE
C101: 1nF; C_0805_2012Metric; MPN CC0805JRNPO9BN102
D101: SMAJ30A; D_SMA; MPN SMAJ30A
D102, D103: BAT46W; D_SOD-123; MPN BAT46W-E3-18
J4: 3P PUSH 3.5mm; Weidmuller_LSF_90_3P; MPN 1824430000
JP101: SELECT; PinHeader_1x03_P2.00mm_Vertical; MPN M22-2010305
JP102: SELECT; PinHeader_1x02_P2.00mm_Vertical; MPN M22-2010205
JP103: SELECT; PinHeader_2x03_P2.00mm_Vertical; MPN M22-2020305
R101, R102: 110k; R_0805_2012Metric; MPN RC0805FR-07110KL
R103: 20k; R_0805_2012Metric; MPN RC0805FR-0720KL
R104: 910k; R_0805_2012Metric; MPN RC0805FR-07910KL
R105: 10k; R_0805_2012Metric; MPN 0805W8F1002T5E
R106: 100k; R_0805_2012Metric; MPN 0805W8F1003T5E
R107: 17.8k; R_0805_2012Metric; MPN ERJ-6ENF1782V
R108: 7.15k; R_0805_2012Metric; MPN RC0805FR-077K15L
R109: 4.7k; R_2010_5025Metric; MPN RC2010FK-074K7L
R110, R111: 4.7k; R_0805_2012Metric; MPN 0805W8F4701T5E
TP7: INPUT1; TestPoint_Pad_D2.0mm
U7: LM339LV; SOIC-14_3.9x8.7mm_P1.27mm; MPN LM339LVDR

Connections:
+3V3: C50.1, D103.2 (A), R105.1, R106.1, U7.3, U7.10 (-); also elsewhere on the board
BIAS_3V3_1: D103.1 (K), R111.1
BIAS_GND1: JP103.5, R109.1
BIAS_PORT1: D102.1 (K), R110.1
GND: C50.2, C101.2, D101.2 (A), J4.2, JP102.2, R103.2, R107.2, R109.2, U7.11 (+), U7.12; also elsewhere on the board
INPUT1: R104.1, R105.2, TP7.1, U7.2 (OUT); also elsewhere on the board
LOW_SEL1: JP102.1, R108.2
PULL_3V3_1: JP103.3, R111.2
PULL_PORT1: JP103.1, R110.2
REF1: R106.2, R107.1, R108.1, U7.4 (-)
SENSE1: C101.1, R102.2, R103.1, R104.2, U7.5 (+)
SENSOR_5V: JP101.1; also elsewhere on the board
SENSOR_VBAT: JP101.3; also elsewhere on the board
SIG1: D101.1 (K), J4.3, JP103.2, JP103.4, JP103.6, R101.1
SIG_MID1: R101.2, R102.1
VPORT1: D102.2 (A), J4.1, JP101.2

Notes on the sheet:
Input 1: industrial / logic selection
PORT POWER AND BIAS
One shunt per selector. Bias diodes block signal backfeed into the supply rails. NPN: port pullup. PNP: pulldown. Push-pull: bias open. Each bias branch is current limited.
PROTECTED SIGNAL AND HYSTERESIS
Threshold jumper open: LOW <=4V, HIGH >=7V. Jumper fitted: LOW <=0.8V, HIGH >=2.4V. 0-30V signal target. 1nF input filter; digital debounce in firmware. Do not apply external power to VPORT.

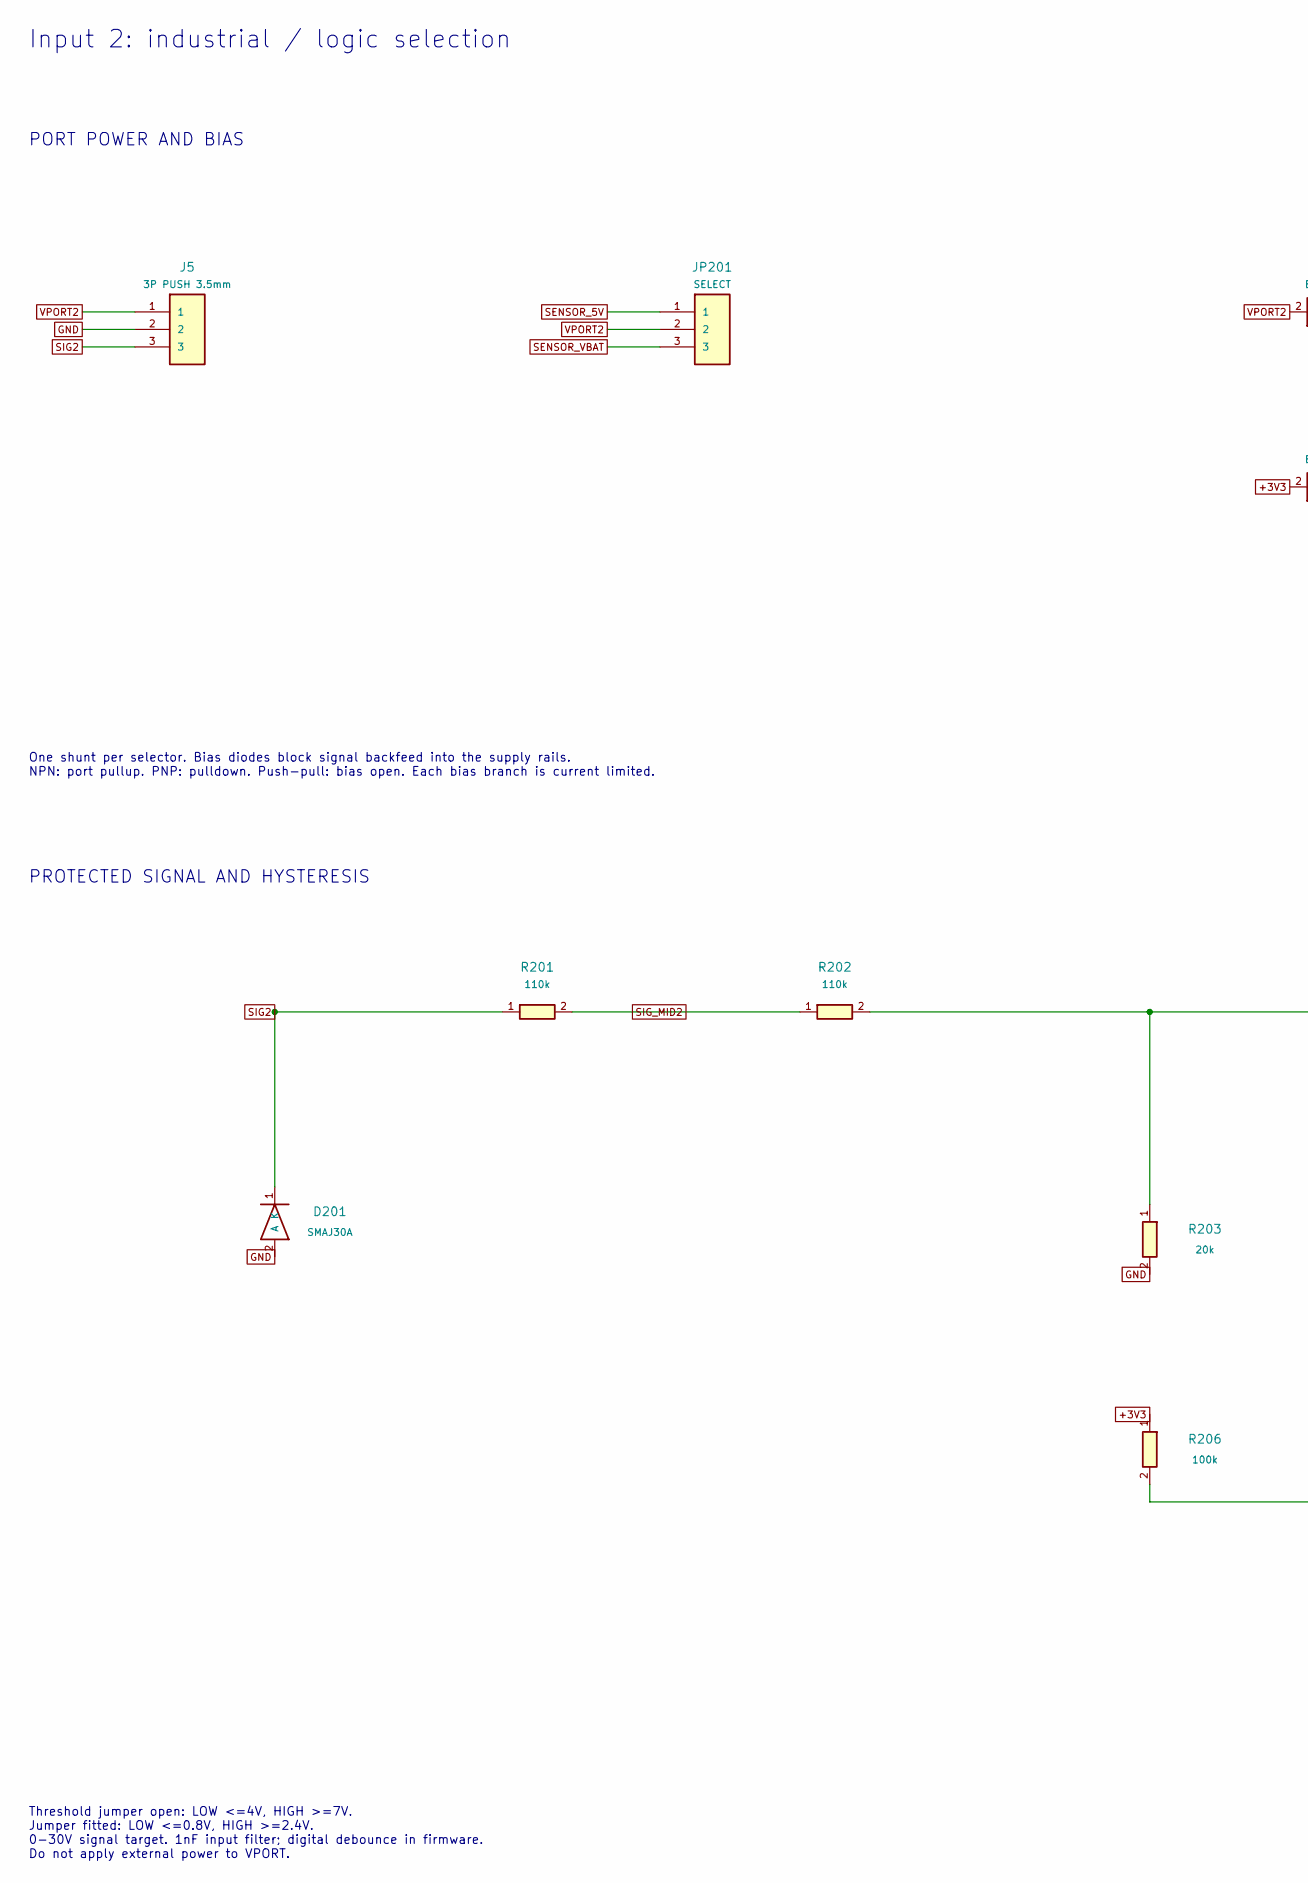
[picture p314: schematic input2.kicad_sch, FRC Sensor CAN - Input 2: industrial / logic selection, part in row 1, column 1]

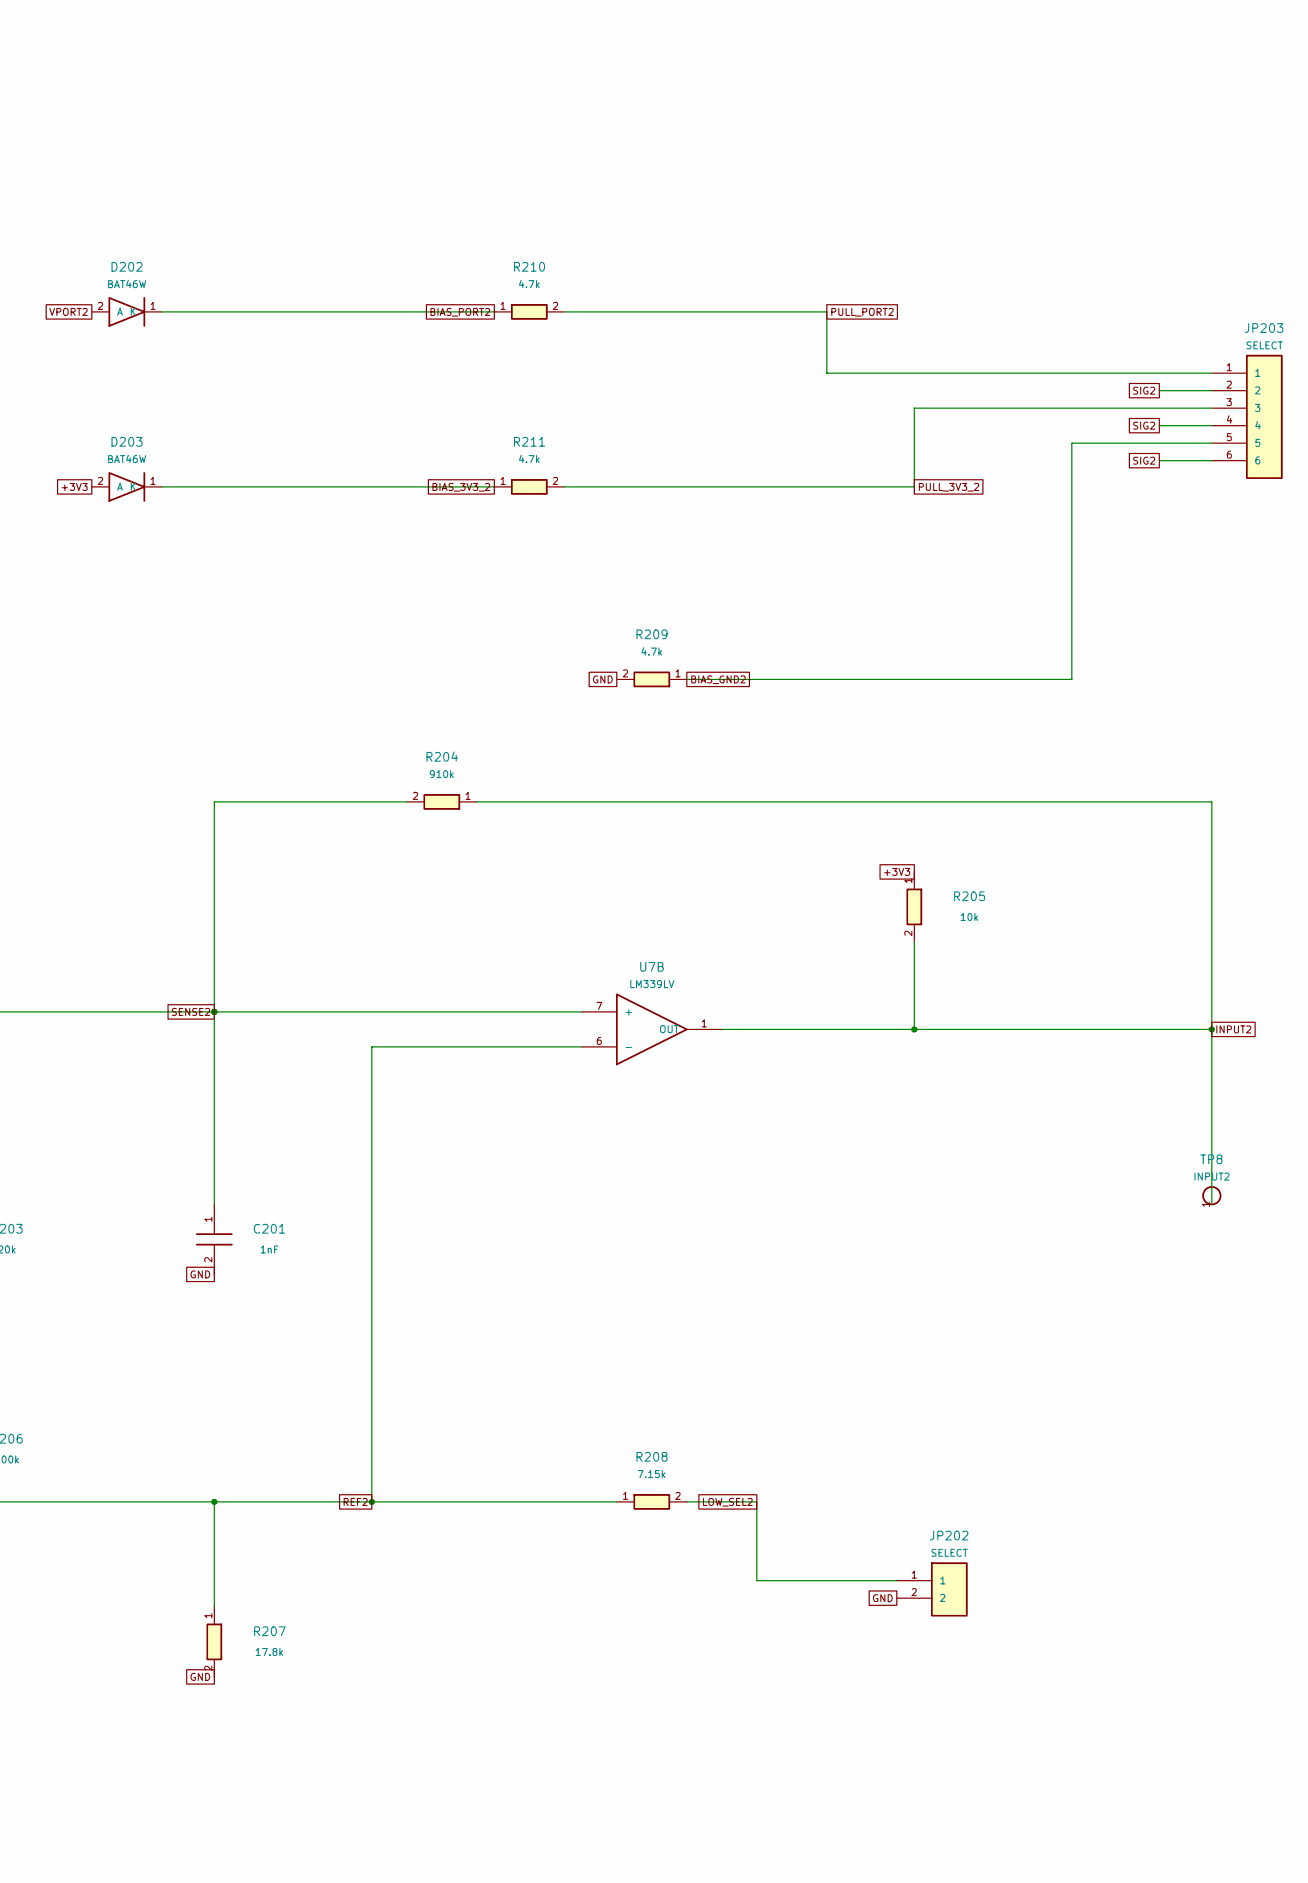
[picture p315: schematic input2.kicad_sch, FRC Sensor CAN - Input 2: industrial / logic selection, part in row 1, column 2]

Parts:
C201: 1nF; C_0805_2012Metric; MPN CC0805JRNPO9BN102
D201: SMAJ30A; D_SMA; MPN SMAJ30A
D202, D203: BAT46W; D_SOD-123; MPN BAT46W-E3-18
J5: 3P PUSH 3.5mm; Weidmuller_LSF_90_3P; MPN 1824430000
JP201: SELECT; PinHeader_1x03_P2.00mm_Vertical; MPN M22-2010305
JP202: SELECT; PinHeader_1x02_P2.00mm_Vertical; MPN M22-2010205
JP203: SELECT; PinHeader_2x03_P2.00mm_Vertical; MPN M22-2020305
R201, R202: 110k; R_0805_2012Metric; MPN RC0805FR-07110KL
R203: 20k; R_0805_2012Metric; MPN RC0805FR-0720KL
R204: 910k; R_0805_2012Metric; MPN RC0805FR-07910KL
R205: 10k; R_0805_2012Metric; MPN 0805W8F1002T5E
R206: 100k; R_0805_2012Metric; MPN 0805W8F1003T5E
R207: 17.8k; R_0805_2012Metric; MPN ERJ-6ENF1782V
R208: 7.15k; R_0805_2012Metric; MPN RC0805FR-077K15L
R209: 4.7k; R_2010_5025Metric; MPN RC2010FK-074K7L
R210, R211: 4.7k; R_0805_2012Metric; MPN 0805W8F4701T5E
TP8: INPUT2; TestPoint_Pad_D2.0mm
U7: LM339LV; SOIC-14_3.9x8.7mm_P1.27mm; MPN LM339LVDR

Connections:
+3V3: D203.2 (A), R205.1, R206.1; also elsewhere on the board
BIAS_3V3_2: D203.1 (K), R211.1
BIAS_GND2: JP203.5, R209.1
BIAS_PORT2: D202.1 (K), R210.1
GND: C201.2, D201.2 (A), J5.2, JP202.2, R203.2, R207.2, R209.2; also elsewhere on the board
INPUT2: R204.1, R205.2, TP8.1, U7.1 (OUT); also elsewhere on the board
LOW_SEL2: JP202.1, R208.2
PULL_3V3_2: JP203.3, R211.2
PULL_PORT2: JP203.1, R210.2
REF2: R206.2, R207.1, R208.1, U7.6 (-)
SENSE2: C201.1, R202.2, R203.1, R204.2, U7.7 (+)
SENSOR_5V: JP201.1; also elsewhere on the board
SENSOR_VBAT: JP201.3; also elsewhere on the board
SIG2: D201.1 (K), J5.3, JP203.2, JP203.4, JP203.6, R201.1
SIG_MID2: R201.2, R202.1
VPORT2: D202.2 (A), J5.1, JP201.2

Notes on the sheet:
Input 2: industrial / logic selection
PORT POWER AND BIAS
One shunt per selector. Bias diodes block signal backfeed into the supply rails. NPN: port pullup. PNP: pulldown. Push-pull: bias open. Each bias branch is current limited.
PROTECTED SIGNAL AND HYSTERESIS
Threshold jumper open: LOW <=4V, HIGH >=7V. Jumper fitted: LOW <=0.8V, HIGH >=2.4V. 0-30V signal target. 1nF input filter; digital debounce in firmware. Do not apply external power to VPORT.

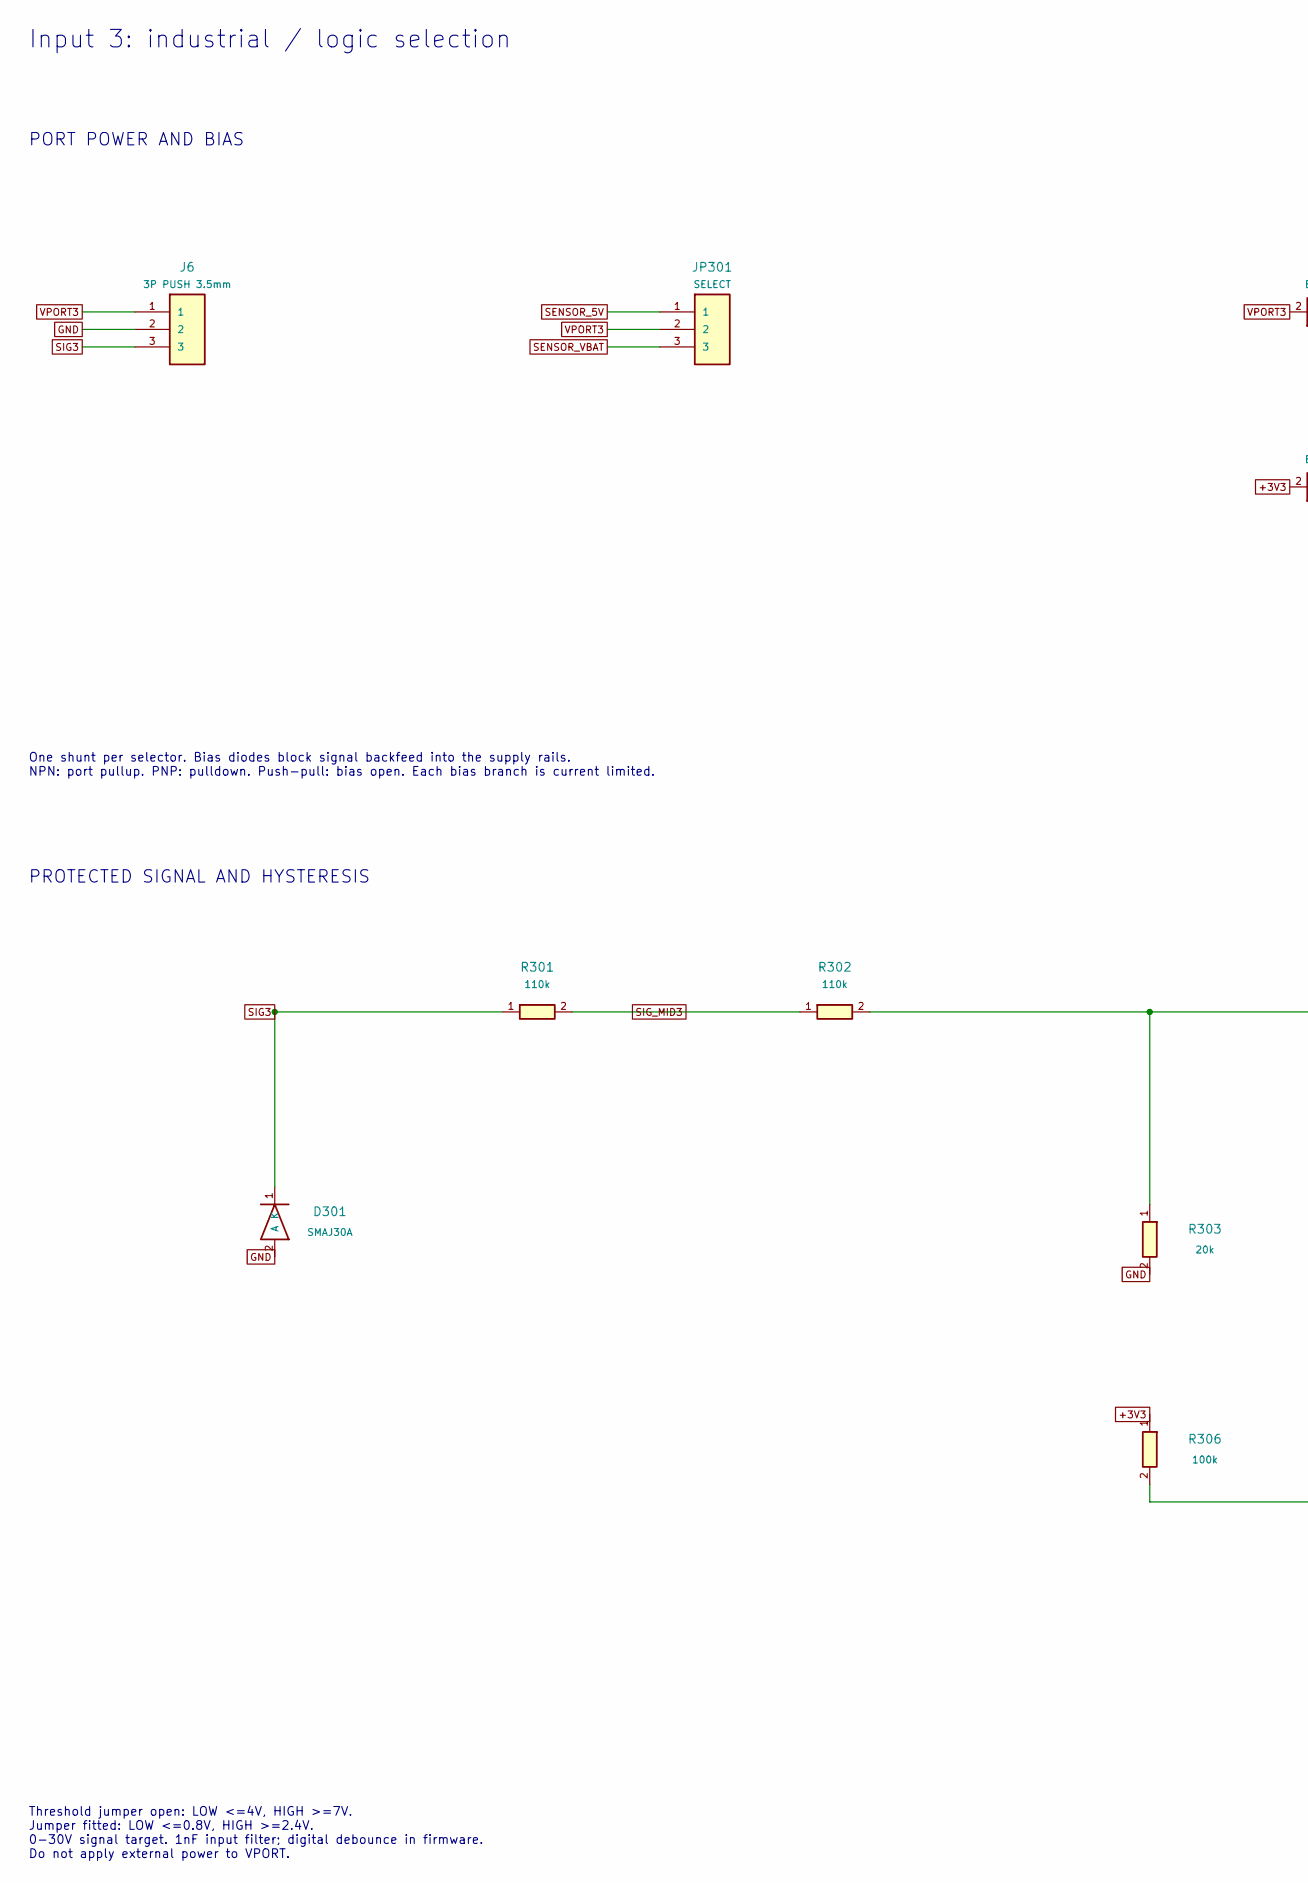
[picture p316: schematic input3.kicad_sch, FRC Sensor CAN - Input 3: industrial / logic selection, part in row 1, column 1]

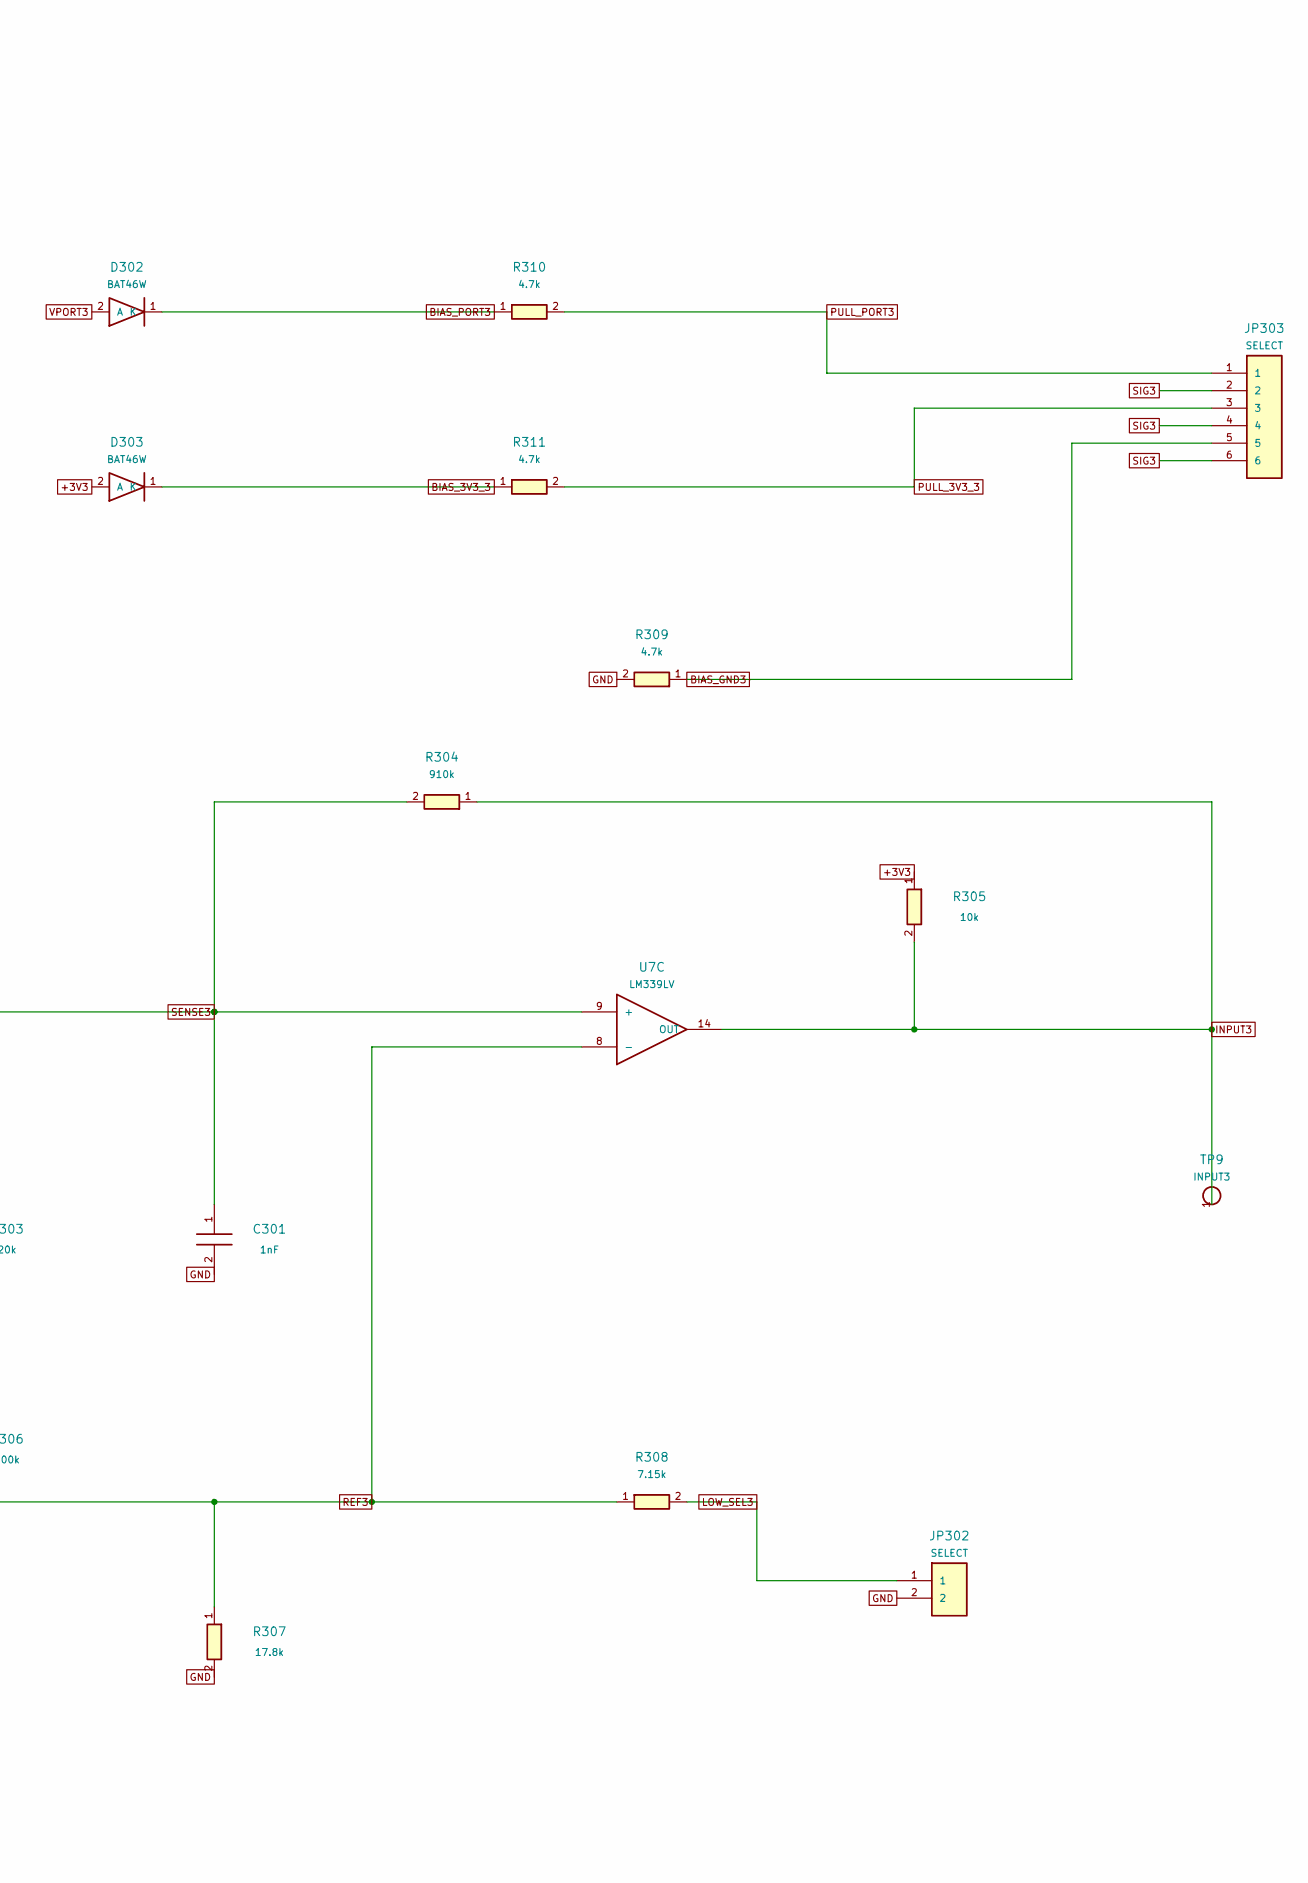
[picture p317: schematic input3.kicad_sch, FRC Sensor CAN - Input 3: industrial / logic selection, part in row 1, column 2]

Parts:
C301: 1nF; C_0805_2012Metric; MPN CC0805JRNPO9BN102
D301: SMAJ30A; D_SMA; MPN SMAJ30A
D302, D303: BAT46W; D_SOD-123; MPN BAT46W-E3-18
J6: 3P PUSH 3.5mm; Weidmuller_LSF_90_3P; MPN 1824430000
JP301: SELECT; PinHeader_1x03_P2.00mm_Vertical; MPN M22-2010305
JP302: SELECT; PinHeader_1x02_P2.00mm_Vertical; MPN M22-2010205
JP303: SELECT; PinHeader_2x03_P2.00mm_Vertical; MPN M22-2020305
R301, R302: 110k; R_0805_2012Metric; MPN RC0805FR-07110KL
R303: 20k; R_0805_2012Metric; MPN RC0805FR-0720KL
R304: 910k; R_0805_2012Metric; MPN RC0805FR-07910KL
R305: 10k; R_0805_2012Metric; MPN 0805W8F1002T5E
R306: 100k; R_0805_2012Metric; MPN 0805W8F1003T5E
R307: 17.8k; R_0805_2012Metric; MPN ERJ-6ENF1782V
R308: 7.15k; R_0805_2012Metric; MPN RC0805FR-077K15L
R309: 4.7k; R_2010_5025Metric; MPN RC2010FK-074K7L
R310, R311: 4.7k; R_0805_2012Metric; MPN 0805W8F4701T5E
TP9: INPUT3; TestPoint_Pad_D2.0mm
U7: LM339LV; SOIC-14_3.9x8.7mm_P1.27mm; MPN LM339LVDR

Connections:
+3V3: D303.2 (A), R305.1, R306.1; also elsewhere on the board
BIAS_3V3_3: D303.1 (K), R311.1
BIAS_GND3: JP303.5, R309.1
BIAS_PORT3: D302.1 (K), R310.1
GND: C301.2, D301.2 (A), J6.2, JP302.2, R303.2, R307.2, R309.2; also elsewhere on the board
INPUT3: R304.1, R305.2, TP9.1, U7.14 (OUT); also elsewhere on the board
LOW_SEL3: JP302.1, R308.2
PULL_3V3_3: JP303.3, R311.2
PULL_PORT3: JP303.1, R310.2
REF3: R306.2, R307.1, R308.1, U7.8 (-)
SENSE3: C301.1, R302.2, R303.1, R304.2, U7.9 (+)
SENSOR_5V: JP301.1; also elsewhere on the board
SENSOR_VBAT: JP301.3; also elsewhere on the board
SIG3: D301.1 (K), J6.3, JP303.2, JP303.4, JP303.6, R301.1
SIG_MID3: R301.2, R302.1
VPORT3: D302.2 (A), J6.1, JP301.2

Notes on the sheet:
Input 3: industrial / logic selection
PORT POWER AND BIAS
One shunt per selector. Bias diodes block signal backfeed into the supply rails. NPN: port pullup. PNP: pulldown. Push-pull: bias open. Each bias branch is current limited.
PROTECTED SIGNAL AND HYSTERESIS
Threshold jumper open: LOW <=4V, HIGH >=7V. Jumper fitted: LOW <=0.8V, HIGH >=2.4V. 0-30V signal target. 1nF input filter; digital debounce in firmware. Do not apply external power to VPORT.

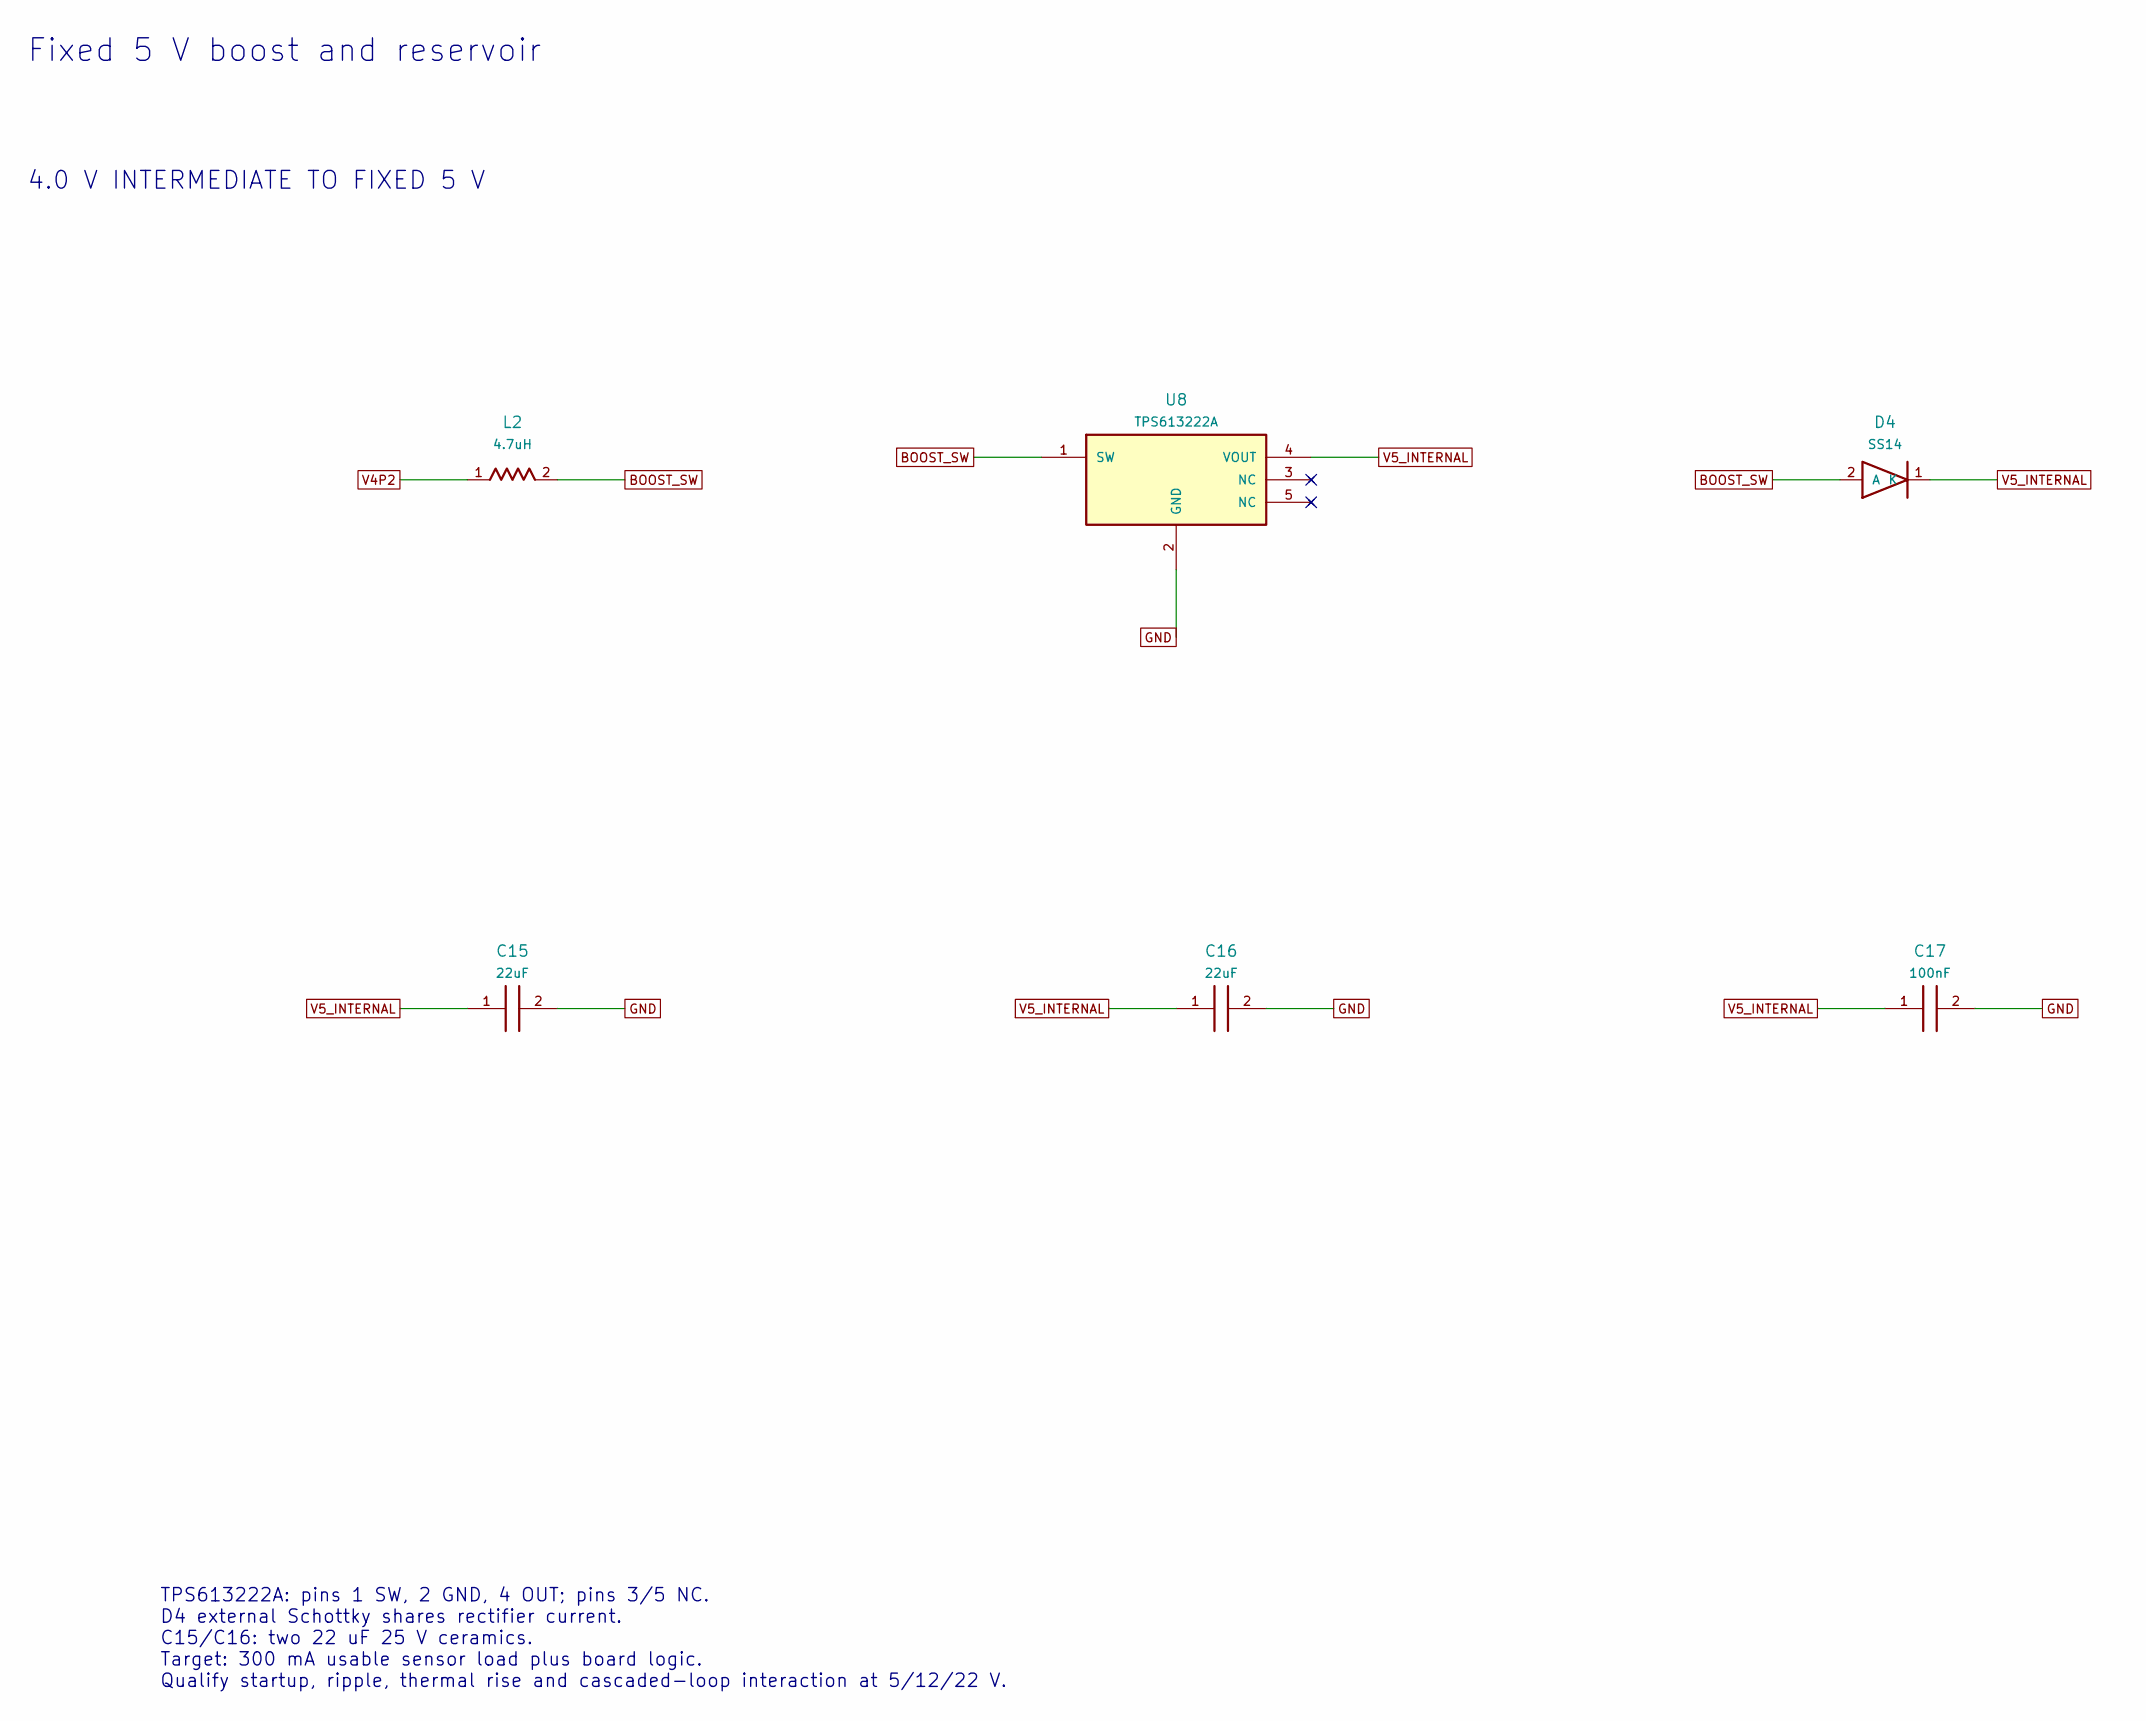
[picture p318: schematic boost.kicad_sch, FRC Sensor CAN - Fixed 5 V boost and reservoir]

Parts:
C15, C16: 22uF; C_1206_3216Metric; MPN CL31A226KAHNNNE
C17: 100nF; C_0805_2012Metric; MPN CL21B104KCFNNNE
D4: SS14; D_SMA; MPN SS14-E3/61T
L2: 4.7uH; Bourns_SRP4020TA; MPN SRP4020TA-4R7M
U8: TPS613222A; SOT-23-5; MPN TPS613222ADBVR

Connections:
BOOST_SW: D4.2 (A), L2.2, U8.1 (SW)
GND: C15.2, C16.2, C17.2, U8.2 (GND); also elsewhere on the board
V4P2: L2.1; also elsewhere on the board
V5_INTERNAL: C15.1, C16.1, C17.1, D4.1 (K), U8.4 (VOUT); also elsewhere on the board

Notes on the sheet:
Fixed 5 V boost and reservoir
4.0 V INTERMEDIATE TO FIXED 5 V
TPS613222A: pins 1 SW, 2 GND, 4 OUT; pins 3/5 NC. D4 external Schottky shares rectifier current. C15/C16: two 22 uF 25 V ceramics. Target: 300 mA usable sensor load plus board logic. Qualify startup, ripple, thermal rise and cascaded-loop interaction at 5/12/22 V.
