barkinvar/sugerCANe/rev_b2/hardware/FRC_Sensor_CAN.kicad_pcb

## KiCad design rev_b2/hardware/FRC_Sensor_CAN.kicad_pcb (continued)

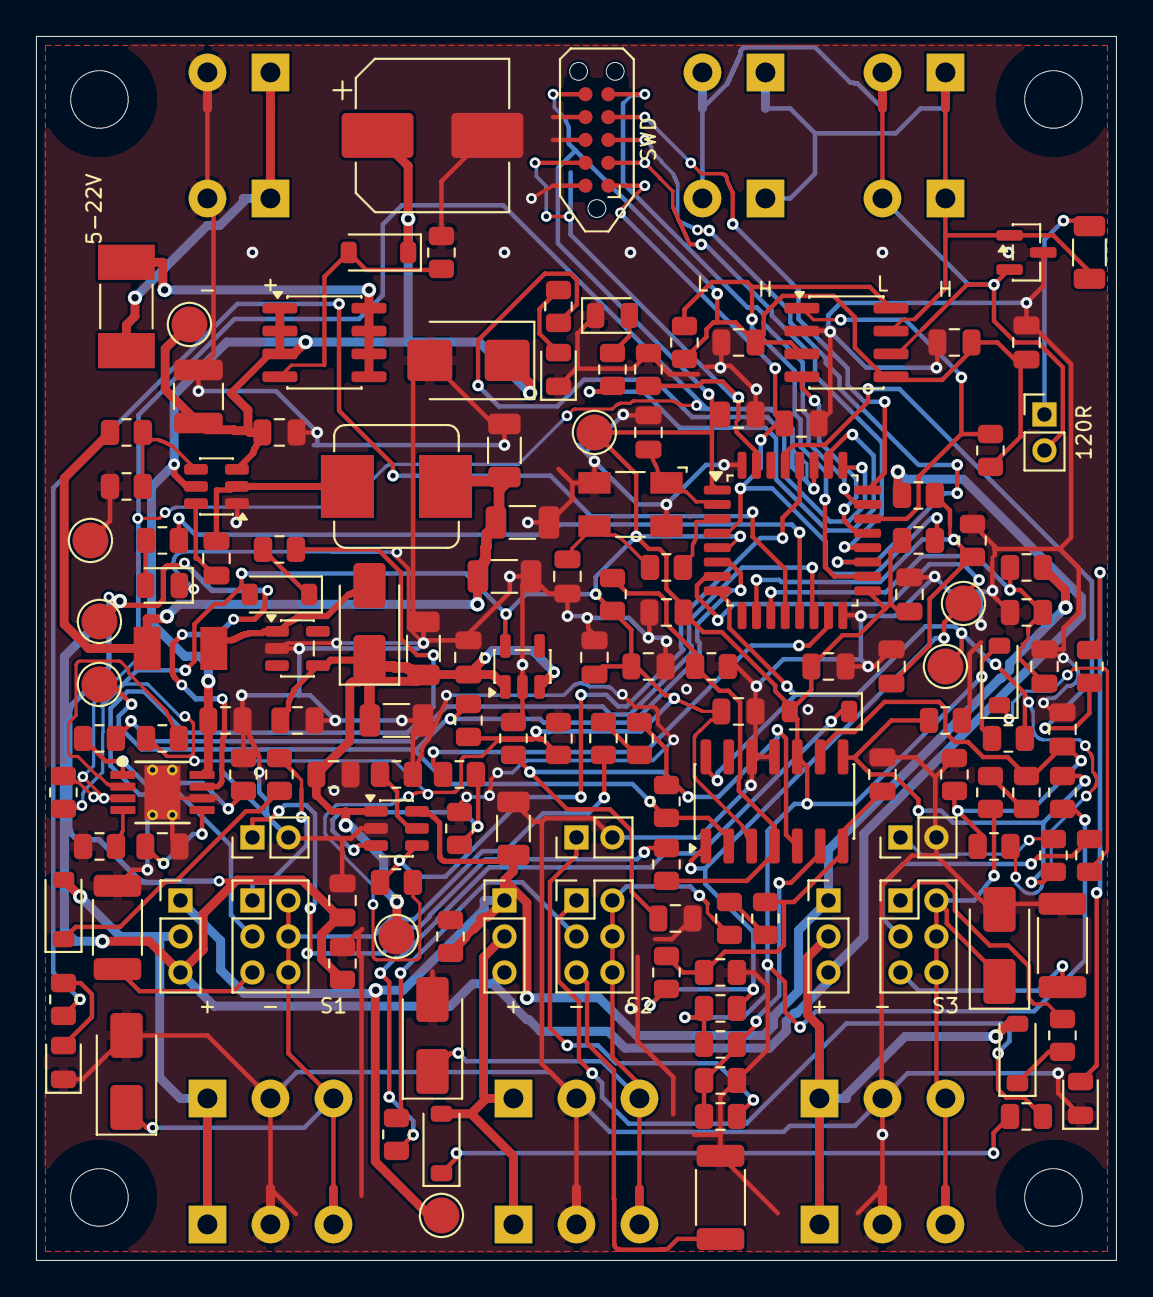
[picture p319: board rev_b2/hardware/FRC_Sensor_CAN.kicad_pcb from above]

Board: 2 copper layers, 60.0 x 68.0 mm, 158 parts (0 on the bottom side), 87 nets.

Other parts of the board:
H1, H2, H3, H4: M3 NPTH
