barkinvar/sugerCANe/current/firmware/src/board.c

#include "board.h"
#include <string.h>
uint32_t SystemCoreClock = 8000000u;
volatile uint32_t board_millis;
#define FLASH_A ((const sc_config_record *)0x08007800u)
#define FLASH_B ((const sc_config_record *)0x08007c00u)
void _init(void) {}
void _fini(void) {}
void SystemInit(void) {
#ifdef SC_APPLICATION
    /* Cortex-M0 has no VTOR. Reserve vectors at SRAM base in both linkers. */
    volatile uint32_t *ram=(volatile uint32_t *)0x20000000u;
    const uint32_t *flash=(const uint32_t *)0x08002000u;
    for(unsigned i=0;i<48;i++)ram[i]=flash[i];
    RCC->APB2ENR|=RCC_APB2ENR_SYSCFGEN;(void)RCC->APB2ENR;
    SYSCFG->CFGR1=(SYSCFG->CFGR1&~SYSCFG_CFGR1_MEM_MODE)|3u;
    __DSB();__ISB();__enable_irq();
#endif
}
void SysTick_Handler(void) {
    board_millis++;
}
static bool wait_bits(volatile uint32_t *reg, uint32_t mask, uint32_t value, uint32_t loops) {
    while (loops--)
        if ((*reg & mask) == value)
            return true;
    return false;
}
static void gpio_mode(GPIO_TypeDef *port, unsigned pin, unsigned mode) {
    port->MODER = (port->MODER & ~(3u << (pin * 2))) | (mode << (pin * 2));
}
static void gpio_af(GPIO_TypeDef *port, unsigned pin, unsigned af) {
    unsigned n = pin / 8, shift = (pin % 8) * 4;
    port->AFR[n] = (port->AFR[n] & ~(15u << shift)) | (af << shift);
    gpio_mode(port, pin, 2);
}
void board_gpio_init(void) {
    RCC->AHBENR |= RCC_AHBENR_GPIOAEN | RCC_AHBENR_GPIOBEN | RCC_AHBENR_GPIOFEN;
    (void)RCC->AHBENR;
    GPIOA->BSRR = (1u << 8) | (1u << (15+16)); /* Transceiver standby before GPIO output enable. */
    GPIOB->BSRR = (1u << (3+16)) | (1u << (7+16));
    for (unsigned i=0;i<5;i++) gpio_mode(GPIOA,i,0);
    /* PA3: TPS259620 fault; PA4: TPS2553 active-low fault. Both open drain. */
    GPIOA->PUPDR = (GPIOA->PUPDR & ~((3u<<6)|(3u<<8))) | (1u<<6) | (1u<<8);
    GPIOA->BSRR=7u<<5; /* PMOS gates HIGH = off before output enable. */
    for (unsigned i=5;i<=7;i++) gpio_mode(GPIOA,i,1);
    gpio_mode(GPIOA,8,1);
    gpio_mode(GPIOA,15,1); /* 5 V enable, default OFF. */
    for (unsigned i=0;i<=7;i++) gpio_mode(GPIOB,i,3);
    gpio_mode(GPIOB,3,1); /* Single status LED. */
    GPIOB->BSRR=((1u<<5)|(1u<<6)|(1u<<4))<<16;
    gpio_mode(GPIOB,5,1);gpio_mode(GPIOB,6,1);gpio_mode(GPIOB,4,1);
    gpio_mode(GPIOB,7,1); /* HIGH enables 12 V; PB0/PB1 remain analog. */
    /* PA13/14 retain SWD; HSE, UART and CAN are configured by their drivers. */
}
void board_voltage_guard_init(void) {
    RCC->APB1ENR |= RCC_APB1ENR_PWREN;
    (void)RCC->APB1ENR;
    /* Level7: nominal falling2.78V, min2.66V (STM32F042 DS Table24).
       A low logic rail must silence CAN before unreliable operation. */
    PWR->CR = (PWR->CR & ~PWR_CR_PLS) | PWR_CR_PLS_LEV7 | PWR_CR_PVDE;
    for (unsigned i = 0; i < 1000; i++)
        __NOP();
    EXTI->RTSR |= EXTI_RTSR_TR16;
    EXTI->FTSR &= ~EXTI_FTSR_TR16;
    EXTI->PR = EXTI_PR_PR16;
    EXTI->IMR |= EXTI_IMR_MR16;
    NVIC_SetPriority(PVD_VDDIO2_IRQn, 0);
    NVIC_EnableIRQ(PVD_VDDIO2_IRQn);
    if (PWR->CSR & PWR_CSR_PVDO) {
        board_safe_off();
        for (;;) {
        } /* Independent watchdog reset; sensor supplies have been disabled. */
    }
}
void PVD_VDDIO2_IRQHandler(void) {
    EXTI->PR = EXTI_PR_PR16;
    if (PWR->CSR & PWR_CSR_PVDO) {
        board_safe_off();
        for (;;) {
        }
    }
}
bool board_clock_init(void) {
    RCC->CR |= RCC_CR_HSEON;
    if (!wait_bits(&RCC->CR, RCC_CR_HSERDY, RCC_CR_HSERDY, 200000u))
        return false;
    FLASH->ACR = FLASH_ACR_PRFTBE | FLASH_ACR_LATENCY;
    RCC->CFGR2 = 0; /* HSE predivider /1 */
    RCC->CFGR = RCC_CFGR_PLLSRC_HSE_PREDIV | RCC_CFGR_PLLMUL6;
    RCC->CR |= RCC_CR_PLLON;
    if (!wait_bits(&RCC->CR, RCC_CR_PLLRDY, RCC_CR_PLLRDY, 200000u))
        return false;
    RCC->CFGR |= RCC_CFGR_SW_PLL;
    if (!wait_bits(&RCC->CFGR, RCC_CFGR_SWS, RCC_CFGR_SWS_PLL, 200000u))
        return false;
    SystemCoreClock = 48000000u;
    RCC->CR |= RCC_CR_CSSON;
    return true;
}
void board_can_abort(void) { CAN->TSR = CAN_TSR_ABRQ0 | CAN_TSR_ABRQ1 | CAN_TSR_ABRQ2; }
void board_can_standby(bool value) {
    GPIOA->BSRR = value ? (1u << 8) : (1u << (8 + 16));
}
void board_bias(uint8_t up,uint8_t down) {
    up&=7;down&=7;down&=(uint8_t)~up;
    uint32_t gates=((uint32_t)(down&3u)<<5)|((uint32_t)(down&4u)<<2);
    if(((GPIOA->ODR>>5)&7u)==(7u^up) && (GPIOB->ODR&0x70u)==gates)return;
    /* Disable both directions before enabling requested paths. */
    GPIOA->BSRR=7u<<5;
    GPIOB->BSRR=((1u<<5)|(1u<<6)|(1u<<4))<<16;
    GPIOA->BSRR=(uint32_t)up<<(5+16);
    GPIOB->BSRR=((uint32_t)(down&3u)<<5)|((uint32_t)(down&4u)<<2);
}
void board_safe_off(void) {
    board_power_set(0);
    board_bias(0,0);
    board_can_standby(true);
}
void NMI_Handler(void) {
    board_safe_off();
    for (;;) { /* Clock security failure: IWDG resets. */
    }
}
void HardFault_Handler(void) {
    board_safe_off();
    for (;;) {
    }
}
/* PB3 AF2 = TIM2_CH2. TIM2 update requests use DMA1 channel 2 (RM0091
 * table 29). PWM preload gives DMA a whole bit period to prepare the next
 * duty cycle. No interrupt masking, polling loop or ISR is needed. */
static uint16_t led_duty[26];
static uint32_t led_rgb=0xffffffffu, led_started;
static bool led_busy;
void board_status_stop(void) {
    RCC->APB1ENR |= RCC_APB1ENR_TIM2EN;
    RCC->AHBENR |= RCC_AHBENR_DMA1EN;
    (void)RCC->AHBENR;
    TIM2->DIER=0; TIM2->CR1=0; TIM2->CCER=0;
    DMA1_Channel2->CCR=0;
    GPIOB->BSRR=1u<<(3+16); gpio_mode(GPIOB,3,1);
    led_busy=false; led_rgb=0xffffffffu;
}
void board_status_init(void) {
    board_status_stop();
    RCC->APB1RSTR |= RCC_APB1RSTR_TIM2RST;
    RCC->APB1RSTR &= ~RCC_APB1RSTR_TIM2RST;
    GPIOB->OSPEEDR=(GPIOB->OSPEEDR&~(3u<<6))|(1u<<6);
    led_started=board_millis; /* At least one ms LOW before the first word. */
}
void board_status_led(uint32_t rgb) {
    uint32_t now=board_millis;
    /* One tick can straddle a boundary and represent almost no elapsed time.
     * Two ticks after the previous start guarantee at least one full ms. */
    if ((uint32_t)(now-led_started)<2u) return;
    if (led_busy && DMA1_Channel2->CNDTR && !(DMA1->ISR&DMA_ISR_TEIF2)) {
        if ((uint32_t)(now-led_started)<=2u) return;
        /* A stalled DMA must not stall sensor supervision or the watchdog. */
        board_status_stop(); led_started=board_millis; return;
    }
    if (led_busy && (DMA1->ISR&DMA_ISR_TEIF2)) {
        board_status_stop(); led_started=board_millis; return;
    }
    led_busy=false;
    if (rgb==led_rgb) return;
    TIM2->CR1=0; TIM2->DIER=0; DMA1_Channel2->CCR=0;
    DMA1->IFCR=DMA_IFCR_CGIF2;
    uint32_t ticks=SystemCoreClock/800000u; /* 60 at 48 MHz; 10 on HSI. */
    uint32_t grb=((rgb&0xff00u)<<8)|((rgb>>8)&0xff00u)|(rgb&255u);
    for (unsigned i=0;i<24;i++)
        led_duty[i]=(uint16_t)((grb&(1u<<(23u-i))) ? ticks*7u/10u : ticks/4u);
    led_duty[24]=0; led_duty[25]=0;
    TIM2->PSC=0; TIM2->ARR=ticks-1u; TIM2->CNT=0;
    TIM2->CCMR1=TIM_CCMR1_OC2PE|(6u<<TIM_CCMR1_OC2M_Pos);
    TIM2->CR1=TIM_CR1_ARPE;
    TIM2->CCR2=0; TIM2->EGR=TIM_EGR_UG; /* Active duty 0, preload bit 0. */
    TIM2->CCR2=led_duty[0]; TIM2->SR=0;
    DMA1_Channel2->CPAR=(uint32_t)&TIM2->CCR2;
    DMA1_Channel2->CMAR=(uint32_t)&led_duty[1];
    DMA1_Channel2->CNDTR=25;
    DMA1_Channel2->CCR=DMA_CCR_DIR|DMA_CCR_MINC|DMA_CCR_PSIZE_0|
        DMA_CCR_MSIZE_0|DMA_CCR_PL_1|DMA_CCR_EN;
    __DMB();
    TIM2->CCER=TIM_CCER_CC2E; gpio_af(GPIOB,3,2);
    TIM2->DIER=TIM_DIER_UDE; TIM2->CR1|=TIM_CR1_CEN;
    /* Two trailing zeros ensure the last bit has finished before DMA completes.
     * At least one ms between starts leaves >960 us LOW (LED needs >200 us). */
    led_rgb=rgb; led_started=board_millis; led_busy=true;
}
static uint8_t uart_tx[512], uart_rx[128];
static volatile uint16_t tx_head, tx_tail, rx_head, rx_tail;
static volatile bool rx_error;
void board_uart_init(void) {
    RCC->APB2ENR |= RCC_APB2ENR_USART1EN;
    gpio_af(GPIOA, 9, 1);
    gpio_af(GPIOA, 10, 1);
    USART1->BRR = (SystemCoreClock + 57600u) / 115200u;
    USART1->CR3 = USART_CR3_EIE;
    USART1->CR1 = USART_CR1_UE | USART_CR1_TE | USART_CR1_RE | USART_CR1_RXNEIE;
    NVIC_SetPriority(USART1_IRQn, 2);
    NVIC_EnableIRQ(USART1_IRQn);
}
void USART1_IRQHandler(void) {
    uint32_t isr = USART1->ISR;
    if (isr & (USART_ISR_ORE | USART_ISR_FE | USART_ISR_NE)) {
        USART1->ICR = USART_ICR_ORECF | USART_ICR_FECF | USART_ICR_NCF;
        rx_error = true;
    }
    if (isr & USART_ISR_RXNE) {
        uint8_t c = (uint8_t)USART1->RDR;
        uint16_t next = (uint16_t)((rx_head + 1u) & 127u);
        if (next == rx_tail)
            rx_error = true;
        else {
            uart_rx[rx_head] = c;
            __DMB();
            rx_head = next;
        }
    }
    if ((isr & USART_ISR_TXE) && (USART1->CR1 & USART_CR1_TXEIE)) {
        if (tx_head == tx_tail)
            USART1->CR1 &= ~USART_CR1_TXEIE;
        else {
            USART1->TDR = uart_tx[tx_tail];
            tx_tail = (uint16_t)((tx_tail + 1u) & 511u);
        }
    }
}
void board_uart_write(const char *s) {
    while (*s) {
        uint16_t next = (uint16_t)((tx_head + 1u) & 511u);
        if (next == tx_tail)
            break; /* Bound diagnostic output under command flooding. */
        uart_tx[tx_head] = (uint8_t)*s++;
        __DMB();
        tx_head = next;
    }
    USART1->CR1 |= USART_CR1_TXEIE;
}
void board_uart_flush(void) {
    uint32_t start = board_millis;
    while ((tx_head != tx_tail || !(USART1->ISR & USART_ISR_TC)) &&
           (uint32_t)(board_millis - start) < 100u)
        __WFI();
}
int board_uart_get(void) {
    /* Read-and-clear cannot lose an ISR error that arrives between the two operations. */
    uint32_t primask = __get_PRIMASK();
    __disable_irq();
    bool error = rx_error;
    rx_error = false;
    __set_PRIMASK(primask);
    if (error)
        return -2;
    if (rx_head == rx_tail)
        return -1;
    uint8_t c = uart_rx[rx_tail];
    rx_tail = (uint16_t)((rx_tail + 1u) & 127u);
    return c;
}
void board_watchdog_start(void) {
    IWDG->KR = 0xcccc;
    IWDG->KR = 0x5555;
    IWDG->PR = 4; /* LSI /64; ~1s nominal, 0.8..1.33s for 30..50kHz. */
    IWDG->RLR = 624;
    wait_bits(&IWDG->SR, 7, 0, 100000u);
    IWDG->KR = 0xaaaa;
}
void board_watchdog_feed(void) {
    IWDG->KR = 0xaaaa;
}
static uint32_t can_last_ack;
static bool can_seen_ack;
static void can_collect_tx(void) {
    uint32_t tsr=CAN->TSR;
    const uint32_t done=CAN_TSR_RQCP0|CAN_TSR_RQCP1|CAN_TSR_RQCP2;
    if (tsr&(CAN_TSR_TXOK0|CAN_TSR_TXOK1|CAN_TSR_TXOK2)) {
        can_last_ack=board_millis; can_seen_ack=true;
    }
    CAN->TSR=tsr&done; /* W1C completion bits also clear TXOK/error flags. */
}
bool board_can_link_ok(uint32_t now) {
    can_collect_tx();
    return can_seen_ack && (uint32_t)(now-can_last_ack)<500u &&
        !(CAN->ESR&(CAN_ESR_BOFF|CAN_ESR_EPVF));
}
bool board_can_init(uint8_t id) {
    can_seen_ack=false; can_last_ack=0;
    RCC->APB1ENR |= RCC_APB1ENR_CANEN;
    gpio_af(GPIOA, 11, 4);
    gpio_af(GPIOA, 12, 4);
    CAN->MCR = CAN_MCR_INRQ | CAN_MCR_ABOM | CAN_MCR_NART;
    if (!wait_bits(&CAN->MSR, CAN_MSR_INAK, CAN_MSR_INAK, 1000000u))
        return false;
    CAN->BTR = (2u << CAN_BTR_BRP_Pos) | (12u << CAN_BTR_TS1_Pos) | (1u << CAN_BTR_TS2_Pos);
    CAN->FMR |= CAN_FMR_FINIT;
    CAN->FA1R = 0;
    CAN->FM1R = 0;
    CAN->FS1R = 7;
    CAN->FFA1R = 2; /* Broadcast Disable has its own FIFO, ahead of normal commands. */
    CAN->sFilterRegister[0].FR1 = (sc_can_id(id, 0) << 3) | CAN_RI0R_IDE;
    CAN->sFilterRegister[0].FR2 = (0x1fff003fu << 3) | CAN_RI0R_IDE | CAN_RI0R_RTR;
    CAN->sFilterRegister[1].FR1 = CAN_RI0R_IDE; /* Extended data frame ID0. */
    CAN->sFilterRegister[1].FR2 = 0xfffffffeu;  /* Exact ID, IDE and RTR. */
    CAN->sFilterRegister[2].FR1 = (((10u<<24)|(8u<<16)|(0x300u<<6))<<3)|CAN_RI0R_IDE;
    CAN->sFilterRegister[2].FR2 = 0xfffffffeu;
    CAN->FA1R = 7;
    CAN->FMR &= ~CAN_FMR_FINIT;
    CAN->MCR &= ~CAN_MCR_INRQ;
    /* RXD is recessive in initial transceiver standby. Bound initialization. */
    return wait_bits(&CAN->MSR, CAN_MSR_INAK, 0, 100000u);
}
bool board_can_send(uint32_t id, const uint8_t data[8]) {
    can_collect_tx();
    if (CAN->ESR & CAN_ESR_BOFF)
        return false;
    uint32_t tsr = CAN->TSR;
    for (unsigned i = 0; i < 3; i++)
        if (tsr & (CAN_TSR_TME0 << i)) {
            uint32_t lo, hi;
            memcpy(&lo, data, 4);
            memcpy(&hi, data + 4, 4);
            CAN->sTxMailBox[i].TDTR = 8;
            CAN->sTxMailBox[i].TDLR = lo;
            CAN->sTxMailBox[i].TDHR = hi;
            CAN->sTxMailBox[i].TIR = (id << 3) | CAN_TI0R_IDE | CAN_TI0R_TXRQ;
            return true;
        }
    return false;
}
bool board_can_receive(uint32_t *id, uint8_t data[8], uint8_t *len) {
    unsigned fifo;
    if (CAN->RF1R & CAN_RF1R_FMP1)
        fifo = 1;
    else if (CAN->RF0R & CAN_RF0R_FMP0)
        fifo = 0;
    else
        return false;
    uint32_t rir = CAN->sFIFOMailBox[fifo].RIR;
    uint32_t lo = CAN->sFIFOMailBox[fifo].RDLR, hi = CAN->sFIFOMailBox[fifo].RDHR;
    *len = (uint8_t)(CAN->sFIFOMailBox[fifo].RDTR & 15);
    *id = rir >> 3;
    memcpy(data, &lo, 4);
    memcpy(data + 4, &hi, 4);
    if (fifo)
        CAN->RF1R = CAN_RF1R_RFOM1;
    else
        CAN->RF0R = CAN_RF0R_RFOM0;
    if (!(rir & CAN_RI0R_IDE) || (rir & CAN_RI0R_RTR) || *len > 8) {
        *len = 0;
        *id = UINT32_MAX;
    }
    return true;
}
const sc_config_record *board_config_load(void) {
    int n = sc_config_newest(FLASH_A, FLASH_B);
    return n < 0 ? 0 : (n == 0 ? FLASH_A : FLASH_B);
}
static bool flash_ready(void) {
    if (!wait_bits(&FLASH->SR, FLASH_SR_BSY, 0, 4000000u))
        return false;
    return !(FLASH->SR & (FLASH_SR_PGERR | FLASH_SR_WRPRTERR));
}
bool board_config_store(sc_config_record *record) {
    const sc_config_record *current = board_config_load();
    uint32_t address = current == FLASH_A ? (uint32_t)FLASH_B : (uint32_t)FLASH_A;
    record->magic = SC_CONFIG_MAGIC;
    record->version = SC_PROTOCOL_VERSION;
    record->sequence = current ? current->sequence + 1u : 1u;
    record->reserved_power = 0;
    record->reserved0 = 0;
    record->reserved2 = 0;
    record->commit = SC_CONFIG_COMMIT;
    record->crc = sc_crc32(record, 24);
    if (!sc_config_valid(record))
        return false;
    board_safe_off();
    __disable_irq();
    FLASH->KEYR = 0x45670123u;
    FLASH->KEYR = 0xcdef89abu;
    FLASH->SR = FLASH_SR_EOP | FLASH_SR_PGERR | FLASH_SR_WRPRTERR;
    bool ok = flash_ready();
    if (ok) {
        FLASH->CR = FLASH_CR_PER;
        FLASH->AR = address;
        FLASH->CR |= FLASH_CR_STRT;
        ok = flash_ready();
        FLASH->CR = 0;
    }
    for (unsigned i = 0; ok && i < 16; i++) {
        uint16_t word;
        memcpy(&word, (const uint8_t *)record + 2 * i, sizeof(word));
        FLASH->CR = FLASH_CR_PG;
        *(volatile uint16_t *)(address + 2 * i) = word;
        ok = flash_ready();
        FLASH->CR = 0;
    }
    FLASH->CR = FLASH_CR_LOCK;
    __enable_irq();
    return ok && sc_config_valid((const sc_config_record *)address);
}

/* Rev G: PA15 enables U4, PB7 drives the active-HIGH Q3 enable transistor. */
void board_power_set(uint8_t enabled) {
    GPIOA->BSRR=(enabled&2u)?(1u<<15):(1u<<(15+16));
    GPIOB->BSRR=(enabled&1u)?(1u<<7):(1u<<(7+16));
}
bool board_adc_init(void) {
    RCC->APB2ENR |= RCC_APB2ENR_ADC1EN;(void)RCC->APB2ENR;
    RCC->CR2 |= RCC_CR2_HSI14ON;
    if(!wait_bits(&RCC->CR2,RCC_CR2_HSI14RDY,RCC_CR2_HSI14RDY,10000u))return false;
    ADC1->CFGR1=0;ADC1->CFGR2=0;ADC1->SMPR=7u; /* HSI14; 239.5-cycle acquisition. */
    ADC1->CR=ADC_CR_ADCAL;
    if(!wait_bits(&ADC1->CR,ADC_CR_ADCAL,0,10000u))return false;
    ADC1_COMMON->CCR |= ADC_CCR_VREFEN;
    /* >10 us VREFINT startup, and >4 ADC clocks after calibration. */
    for(unsigned n=0;n<1000;n++)__NOP();
    ADC1->ISR=ADC_ISR_ADRDY;ADC1->CR=ADC_CR_ADEN;
    return wait_bits(&ADC1->ISR,ADC_ISR_ADRDY,ADC_ISR_ADRDY,10000u);
}
static bool adc_channel(unsigned channel,uint16_t *value) {
    if(ADC1->CR&ADC_CR_ADSTART)return false;
    ADC1->CHSELR=1u<<channel;
    ADC1->ISR=ADC_ISR_EOC|ADC_ISR_EOS|ADC_ISR_OVR;
    ADC1->CR |= ADC_CR_ADSTART;
    if(!wait_bits(&ADC1->ISR,ADC_ISR_EOC,ADC_ISR_EOC,2000u))return false;
    *value=(uint16_t)ADC1->DR;
    return !(ADC1->ISR&ADC_ISR_OVR);
}
bool board_rail_read(uint16_t *mv12,uint16_t *mv5) {
    uint16_t a,b,reference;
    if(!adc_channel(8,&a) || !adc_channel(9,&b) || !adc_channel(17,&reference))return false;
    const uint16_t calibration=*(const uint16_t *)0x1ffff7bau;
    if(calibration<1000u || calibration>2000u || reference<1000u || reference>2200u)return false;
    uint32_t vdda=(3300u*calibration+reference/2u)/reference;
    if(vdda<2900u || vdda>3600u)return false;
    *mv5=(uint16_t)(((uint32_t)a*vdda*11u+2047u)/4095u);
    *mv12=(uint16_t)(((uint32_t)b*vdda*11u+2047u)/4095u);
    return true;
}
