barkinvar/sugerCANe/current/scripts/build_documents.py

"""Printable BOM, mechanical/service maps and prototype factory packet."""
from pathlib import Path
import csv,json,zipfile,hashlib,argparse
ap=argparse.ArgumentParser(description=__doc__)
ap.add_argument("--drawings-only",action="store_true",help="Render PDFs without creating or updating factory ZIPs")
args=ap.parse_args()
from html import escape
from reportlab.pdfgen import canvas
from reportlab.lib.pagesizes import A4,landscape
from reportlab.lib import colors
from reportlab.lib.styles import getSampleStyleSheet
from reportlab.platypus import SimpleDocTemplate,Paragraph,Table,TableStyle,Spacer
from reportlab.lib.units import mm
R=Path(__file__).resolve().parents[1]
for d in ('output/documentation','output/mechanical','order'):(R/d).mkdir(parents=True,exist_ok=True)
styles=getSampleStyleSheet();styles['Normal'].fontSize=8;styles['Normal'].leading=11
P=lambda s:Paragraph(escape(str(s)),styles['Normal'])
rows=list(csv.DictReader((R/'bom/BOM_grouped.csv').open()))
estimate=next(r for r in csv.DictReader((R/'bom/cost_estimate.csv').open()) if r['boards']=='10')
candidate=json.loads((R/'reports/release_checks.json').read_text()).get('simulation_deferred_by_user',False)
status='JLC Standard PCBA candidate: U5 purchased from DigiKey and hand soldered by user; final simulations and factory quote pending. See docs/FACTORY_ORDER.md.' if candidate else 'Unbuilt prototype; check current sourcing and release status before ordering.'
story=[Paragraph('SC12 - Revision H purchasing BOM',styles['Title']),P(f"140 fitted parts: 129 factory SMT + one user-soldered MCU + 10 user-fitted through-hole parts. Three loose caps extra. Parts estimate: ${estimate['all_parts_cash_per_board_usd']}/board at 10 boards before SMT attrition and spare MCUs; PCB, assembly, freight and tax extra. {status}"),Spacer(1,12)]
data=[[P(t) for t in ['Qty','MPN / supplier part','References','Value / package','Extended USD first tier']]]
for row in rows:data.append([P(row['Quantity']),P(row['MPN']+' / '+row['Supplier_part']),P(row['References']+' ('+row['Assembly']+')'),P(row['Value']+' / '+row['Footprint'].split(':')[-1]),P(row['Extended_USD_first_tier'])])
t=Table(data,colWidths=[28,145,175,165,52],repeatRows=1)
t.setStyle(TableStyle([('BACKGROUND',(0,0),(-1,0),colors.HexColor('#dcebf0')),('ROWBACKGROUNDS',(0,1),(-1,-1),[colors.white,colors.HexColor('#f4f6f7')]),('VALIGN',(0,0),(-1,-1),'TOP'),('BOTTOMPADDING',(0,0),(-1,-1),6)]));story.append(t)
SimpleDocTemplate(str(R/'output/documentation/BOM_RevH_SC12.pdf'),pagesize=A4,leftMargin=15,rightMargin=15).build(story)

manifest=json.loads((R/'reports/manufacturing/board_manifest.json').read_text());fps={c['reference']:c for c in manifest['components']}
c=canvas.Canvas(str(R/'output/mechanical/mechanical_drawing.pdf'),pagesize=A4)
def heading(title,sub):
 c.setFont('Helvetica-Bold',17);c.drawString(40,795,title);c.setFont('Helvetica',9);c.drawString(40,777,sub)
heading('SC12 - nominal mechanical drawing','Rev H / component-side view / 1:1 at 100% print / dimensions in mm')
ox,oy=180,660
def xy(x,y):return ox+x*mm,oy-y*mm
c.setLineWidth(.6);c.roundRect(*xy(0,74),52*mm,74*mm,1.5*mm)
for ref in ['J1','J2','J3','J4','J5','J6']:
 f=fps[ref];n=2 if ref in ['J1','J2','J3'] else 3
 xs=[p['x_mm'] for p in f['pads']];ys=[-p['y_mm'] for p in f['pads']]
 left=min(xs)-2.1;top=min(ys)-6.05 if n==2 else min(ys)-1.7
 c.setStrokeColor(colors.grey);c.rect(*xy(left,top+14.75),((n-1)*3.5+4.2)*mm,14.75*mm)
 c.setStrokeColor(colors.black);c.setFont('Helvetica',7);c.drawCentredString(*xy((min(xs)+max(xs))/2,top+5),ref)
 for p in f['pads']:c.circle(*xy(p['x_mm'],-p['y_mm']),.55*mm)
led_x,led_y=fps['D10']['x_mm'],-fps['D10']['y_mm']
c.setStrokeColor(colors.HexColor('#116c8a'));c.circle(*xy(led_x,led_y),3*mm)
c.circle(*xy(led_x,led_y),2*mm)
c.rect(*xy(led_x-.75,led_y+.75),1.5*mm,1.5*mm)
c.line(*xy(led_x-8,led_y),*xy(led_x-3.2,led_y))
c.setFont('Helvetica',7);c.drawRightString(*xy(led_x-8.5,led_y-.5),'D10 RGB')
c.setStrokeColor(colors.black);c.rect(*xy(17.45,8.8),13.1*mm,5*mm)
c.setFont('Helvetica',7);c.drawCentredString(*xy(24,7),'J8')
for ref in ('H1','H2'):
 f=fps[ref];x,y=f['x_mm'],-f['y_mm'];c.circle(*xy(x,y),1.6*mm);c.setFont('Helvetica',7);c.drawString(*xy(1.5,9) if ref=='H1' else xy(x+4,y),ref)
for x in (0,52):
 c.line(*xy(x,0),*xy(x,-9))
c.line(*xy(0,-7),*xy(52,-7));c.setFont('Helvetica',9);c.drawCentredString(*xy(26,-9),'52.00')
c.line(*xy(52,0),*xy(61,0));c.line(*xy(52,74),*xy(61,74));c.line(*xy(59,0),*xy(59,74));c.drawString(*xy(61,29),'74.00')
lines=['PCB: 52 x 74 x 1.6 mm; corner radius 1.5 mm. Four layers, 1 oz copper.',
 'Mounts: H1 (3.5, 4.0), H2 (48.5, 46.5); diameter 3.2 NPTH.',
 'Keep hardware contact diameter <=6.4 mm; use insulating supports as needed.',
 'Conservative terminal envelope: 52 x 82.1 mm, before wires/button clearance.',
 'Terminal height: 8.5 above mounting face; pin tips 3.5 below that face.',
 'On a 1.6 mm PCB, pin tips project nominally 1.9 mm beyond the bottom.',
 f'D10: center ({led_x:g}, {led_y:g}), height 0.65; 6 mm circular area reserved.',
 'Printed duct starting size: outside diameter <=6; inside diameter 4.',
 'Duct lower face: 0.85-1.15 above PCB; no contact with LED or screw boss.',
 'J8 female socket: 8.5 above PCB; tails about 1.6 below bottom; allow cable access.',
 'Housing geometry is nominal CAD. Physical and optical fit untested.',
 'Origin: top-left PCB corner. X right; Y down in this drawing.']
for i,s in enumerate(lines):c.setFont('Helvetica',9);c.drawString(40,400-i*17,s)
c.showPage();heading('Service header and voltage jumpers','Component-side view / enlarged, not 1:1 / no stencil paste on these contacts')
ox,oy=95,640;scale=18
f=fps['J8'];c.setFont('Helvetica-Bold',11);c.drawString(40,730,'J8: recessed 2x5 / 2.54 mm socket; custom mapping')
for p in f['pads']:
 if not p['number']:continue
 x=65+(p['x_mm']-18.92)*scale;y=665-(-p['y_mm']-5.03)*scale
 c.setFillColor(colors.HexColor('#dbad34'))
 if p['number']=='1':c.rect(x-.85*scale,y-.85*scale,1.7*scale,1.7*scale,stroke=1,fill=1)
 else:c.circle(x,y,.85*scale,stroke=1,fill=1)
 c.setFillColor(colors.white);c.circle(x,y,.55*scale,stroke=1,fill=1)
 c.setFillColor(colors.black);c.setFont('Helvetica',7);c.drawCentredString(x,y-2,p['number'])
mapping=['1 NRST','2 UART RX','3 UART TX','4 SWCLK','5 SWDIO','6 +3V3 VTref sense only','7 GND','8 GND','9 BOOT0','10 GND']
for i,s in enumerate(mapping):c.setFont('Helvetica',10);c.drawString(310,692-i*17,s)
c.setFont('Helvetica',9);c.drawString(40,495,'Power through J1; adapter/probe power disconnected. Lower row 1/3/5/7/9; upper 2/4/6/8/10.')
for ch in range(1,4):
 y=435-(ch-1)*75
 for x,ref in [(110,f'JP{ch}01')]:
  c.setFont('Helvetica-Bold',11);c.drawCentredString(x+24,y+24,ref+(' POWER' if ref.endswith('01') else ' BIAS'))
  for n in (1,2,3):
   c.setFillColor(colors.HexColor('#dbad34'));c.rect(x+(n-1)*24-8,y-10,16,20,fill=1);c.setFillColor(colors.black);c.drawCentredString(x+(n-1)*24,y-3,str(n))
 c.setFont('Helvetica',8);c.drawString(35,y-26,'2 mm cap: 1-2 = 5V; 2-3 = 12V; no cap = off');c.drawString(290,y-26,'Input mode: select NPN / PNP / push-pull in software')
c.setFont('Helvetica-Bold',10);c.drawString(40,160,'ONE CAP PER POWER HEADER. Joining all three pins shorts the rails.')
c.setFont('Helvetica',9);c.drawString(40,140,'JP2: bridge for 120 ohm CAN end termination; open at intermediate nodes.')
c.drawString(40,120,'User fits J8 and power headers/caps. Input bias is electronic. Change power caps with power off.')
c.save()

if args.drawings_only:
 print('Rendered documentation PDFs only; no factory packet created.');raise SystemExit(0)

dest=R/'order/RevH_SC12_Factory_Upload.zip'
# Do not label an order packet Rev H while retaining failed or stale evidence.
checks=json.loads((R/'reports/release_checks.json').read_text())
assert checks['revision']=='H SC12' and checks['status']=='PASS engineering checks; physical qualification pending'
for path,digest in checks['input_hashes'].items():
 assert hashlib.sha256((R/path).read_bytes()).hexdigest()==digest,('Stale release evidence',path)
readiness=json.loads((R/'reports/electrical/order_readiness.json').read_text())
assert readiness['revision']=='H' and readiness['order_decision']=='PASS pre-fabrication engineering screens; unbuilt prototype'
for path,digest in readiness['input_hashes'].items():
 assert hashlib.sha256((R/path).read_bytes()).hexdigest()==digest,('Stale power review',path)
files=[]
stencil=json.loads((R/'reports/manufacturing/factory_stencil.json').read_text())
assert stencil['result']=='PASS' and stencil['removed_u5_apertures']==32
for path,digest in stencil['input_hashes'].items():
 assert hashlib.sha256((R/path).read_bytes()).hexdigest()==digest,('Stale stencil evidence',path)
assert hashlib.sha256((R/stencil['output']).read_bytes()).hexdigest()==stencil['output_sha256']
files.extend(R/p for p in ['bom/assembly_plan.json','bom/DigiKey_5_boards.csv','bom/DigiKey_10_boards.csv','reports/manufacturing/factory_stencil.json'])
files.extend(R / p for p in ['docs/STATUS_AND_PROGRAMMING.md', 'docs/ORDER_READINESS.md', 'reports/electrical/order_readiness.json', 'reports/electrical/solver_diagnostics.json'])
files.extend(p for p in (R/'reports/electrical').glob('boost_spice*.json') if '_partial' not in p.name)
files.extend(p for p in (R/'reports/electrical').glob('boost_spice*.png') if '_partial' not in p.name)
for pat in ['output/fabrication/*','output/assembly/*','output/mechanical/*','output/documentation/BOM_RevH_SC12.pdf','bom/Factory_BOM.csv','bom/BOM_JLCPCB.csv','bom/BOM_per_reference.csv','bom/Hand_solder_BOM.csv','bom/ACCESSORIES.csv','bom/cost_estimate.csv','docs/COST_REDUCTION.md','docs/FACTORY_ORDER.md','docs/ASSEMBLY.md','docs/WIRING.md','docs/VALIDATION.md','firmware/build/factory.hex','firmware/build/application.sc12','host/input_settings.py','host/service_gui.py','docs/INPUT_MODES.md','host/can_service.py','host/firmware_image.py','host/fixture_record.py','tools/program_factory.tcl','tools/fixture_measurements.template.json','docs/CAN_SERVICE.md','docs/FIXTURE.md']:
 files.extend(p for p in R.glob(pat) if p.is_file())
with zipfile.ZipFile(dest,'w',zipfile.ZIP_DEFLATED) as z:
 for p in sorted(set(files)):
  z.write(R/stencil['output'] if p.relative_to(R).as_posix()==stencil['source'] else p,p.relative_to(R))
(dest.with_suffix('.zip.sha256')).write_text(hashlib.sha256(dest.read_bytes()).hexdigest()+'  '+dest.name+'\n')
gerbers=R/'order/RevH_SC12_Gerbers.zip'
with zipfile.ZipFile(gerbers,'w',zipfile.ZIP_DEFLATED) as z:
 for p in sorted((R/'output/fabrication').iterdir()):
  if p.is_file() and p.suffix not in ('.pdf','.txt'):
   z.write(R/stencil['output'] if p.relative_to(R).as_posix()==stencil['source'] else p,p.name)
gerbers.with_suffix('.zip.sha256').write_text(hashlib.sha256(gerbers.read_bytes()).hexdigest()+'  '+gerbers.name+'\n')
print('Built BOM PDF, mechanical/service drawing, fabrication-only ZIP and complete factory packet.')
