barkinvar/sugerCANe/current/scripts/export_assembly_drawing.py

"""Plot an uncluttered assembly drawing without changing the native board.

KiCad footprints can contain both a movable reference field and an internal
${REFERENCE} graphic on F.Fab. Hide only the redundant internal label in a
throwaway copy. Keep actual silkscreen, body outlines and pin-one indicators.
"""
from pathlib import Path
import subprocess,tempfile
import sexpdata as sx
ROOT=Path(__file__).resolve().parents[1]
b=sx.loads((ROOT/'hardware/FRC_Sensor_CAN.kicad_pcb').read_text())
removed=0
for fp in b:
    if not isinstance(fp,list) or not fp or str(fp[0])!='footprint':continue
    for field in fp:
        if isinstance(field,list) and len(field)>2 and str(field[0])=='property' and field[1]=='Reference':
            field[:]=[e for e in field if not (isinstance(e,list) and e and str(e[0]) in ('hide','at','layer','effects'))]
            at='(at 0 0 0)'
            if field[2] in ('J1','J2','J3'):at='(at 1.75 3.5 0)'
            elif field[2] in ('J4','J5','J6'):at='(at 3.5 3.5 0)'
            elif field[2] in ('JP101','JP201','JP301'):at='(at -1.4 2 0)'
            field.extend([sx.loads(at),sx.loads('(layer "F.Fab")'),sx.loads('(effects (font (size 0.6 0.6) (thickness 0.1)))')])
    kept=[]
    for item in fp:
        redundant=(isinstance(item,list) and len(item)>2 and str(item[0])=='fp_text'
                   and str(item[1])=='user' and item[2] in ('${REFERENCE}','%R')
                   and any(isinstance(c,list) and len(c)>1 and str(c[0])=='layer' and c[1]=='F.Fab' for c in item))
        if redundant:removed+=1
        else:kept.append(item)
    fp[:]=kept
with tempfile.TemporaryDirectory(prefix='sensor_can_assembly_') as folder:
    path=Path(folder)/'assembly.kicad_pcb';path.write_text(sx.dumps(b))
    subprocess.run(['kicad-cli','pcb','export','pdf','--mode-single','--layers','F.Fab,F.Silkscreen,Edge.Cuts',
                    '--exclude-value','--scale','2','--black-and-white','-o',str(ROOT/'output/assembly/top_assembly.pdf'),str(path)],check=True)
print('Assembly-only redundant labels removed:',removed)
