barkinvar/sugerCANe/(commit log)

2026-09-08 Initial commit: FRC Sensor CAN Rev A prototype
    Open-hardware CAN sensor interface board (96 x 96 mm, 2-layer, 175
    footprints) with firmware, host tooling and full fabrication outputs.
    - hardware/ KiCad schematic, PCB, symbol/footprint/3D libraries
    - firmware/ MCU firmware sources and tests
    - host/, software/, examples/ host tooling and Java/C++ examples
    - output/ gerbers, drill, assembly, STEP, renders, documentation
    - reports/ DRC/ERC, SPICE, electrical and manufacturing reports
    - sources/ vendor datasheets and SPICE models
    - release/ packaged Rev A prototype release
2026-09-08 Add horizontal Rev B and China assembly Rev B-2 packages
2026-09-08 Document all revisions and replace connector envelopes with vendor CAD
2026-09-08 Add smaller Rev C Lite sensor-to-CAN board with 89 parts
2026-09-08 Add compact Rev D regulated 12 V sensor-to-CAN design
2026-09-08 Add Rev D-2 cost-reduced SMT and hand-solder variant
2026-09-08 Plan SC12 CAN servicing and cost optimization from LaserCAN
2026-09-08 Add Rev E software-selectable sensor bias and CAN configuration
2026-09-09 Reduce SC12 cost with protected boost and consolidate the repository
    Implement Rev F with a TPS61085 boost fed by the existing 5 V regulator,
    a latching TPS2553-1 input disconnect, and the spare comparator as a
    coarse 12 V rail monitor. Keep removable voltage jumpers, electronic
    input modes, existing connectors, and top-only component assembly.
    Resource equivalent passives and reduce the PCB from 52x70 to 52x64 mm.
    Ten-board parts purchasing falls from $35.14 to $27.17 per board;
    fabrication, assembly, freight and taxes remain outside that estimate.
    Refresh hardware-6 firmware, native CAD, fabrication/assembly packages,
    checks and guides. Consolidate the maintained design under current/,
    p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
2026-09-09 Validate boost with SPICE and flag power-stage limits
2026-09-09 Audit final-order readiness and correct PCB voltage-drop budget
2026-09-09 Rev G: protect sensor power and verify startup and fault recovery
2026-09-09 Document software voltage selection safety requirements
2026-09-09 Add Rev H RGB status and low-cost programming header
    Keep sensor power and inputs unchanged. Add buffered ARGB status, nonblocking timer/DMA firmware, ordinary hand-fitted SWD header, and updated CAD/BOM/docs. Native and focused firmware checks pass. Explicitly record the canceled full power rerun as incomplete; retain full-release gates and preserve all historical packages.
2026-09-09 Move RGB LED into reserved right-side light duct area
2026-09-09 Improve edge clearances, recess debug contacts and label wiring
2026-09-09 Refine rounded board outline and align input-stage layout
2026-09-09 Align CAN color labels and document capacitor protection
2026-09-09 Place voltage legends above jumper pins and explain bare pads
2026-09-09 Record Rev H simulation evidence and unresolved startup checks
    Add the TI comparator input screen and replay completed rail waveforms through
    actual firmware power-monitor code at ADC-error corners. Refresh native-route
    voltage-drop and fitted-part checks, firmware/driver evidence, and documentation.
    Retain fresh standalone power cases and numerical diagnostics separately from
    the incomplete coupled startup runs. Keep full-release gates on HOLD and make
    the 5 V/12 V cross-connection protection limit explicit. No circuit or BOM change.
2026-09-09 Refine sugarCANe silk with smooth lettering and flowing cane art
2026-09-09 Give sugarCANe a soft serif wordmark and convex ground
2026-09-09 Enforce straight routing and remove redundant PCB traces
2026-09-10 Audit JLC service eligibility and flag capacitor reflow constraint
2026-09-10 Normalize trace widths and enforce reviewed routing transitions
2026-09-10 Strengthen ground pours and enforce same-net copper gaps
2026-09-10 Widen input power routes and publish all four copper layers
2026-09-10 Prepare factory SMT assembly with high-reflow C1 and exact MCU sourcing
2026-09-10 Prepare Rev H orders for a user-soldered DigiKey MCU
2026-09-10 Complete pre-order simulation review and improve buck current margin
